EOSCogniton/STUF2019/SU - Suspension/05 - Essais/Excels essais Optimus/Temoins et tests triangles/Photos/54356044_1194590287362701_8250491047285620736_n.jpg

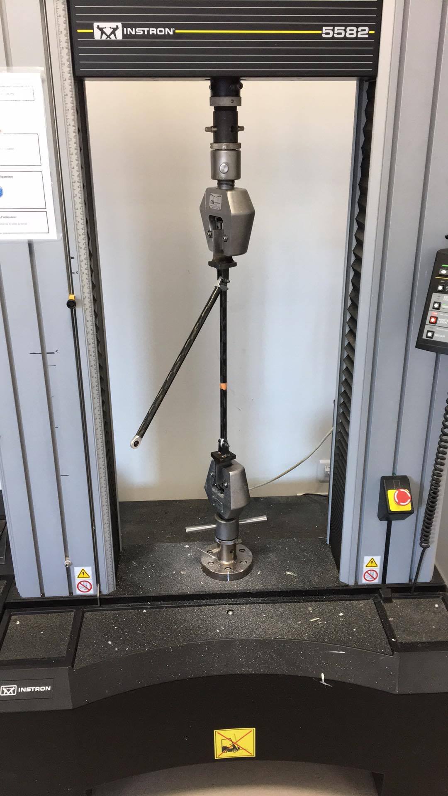
SU - Suspension/05 - Essais/Excels essais Optimus/Temoins et tests triangles/Photos/54356044_1194590287362701_8250491047285620736_n.jpg
