EOSCogniton/STUF2019/SU - Suspension/05 - Essais/Excels essais Optimus/Temoins et tests triangles/Photos/54388198_367390647322238_1608821511299268608_n.jpg

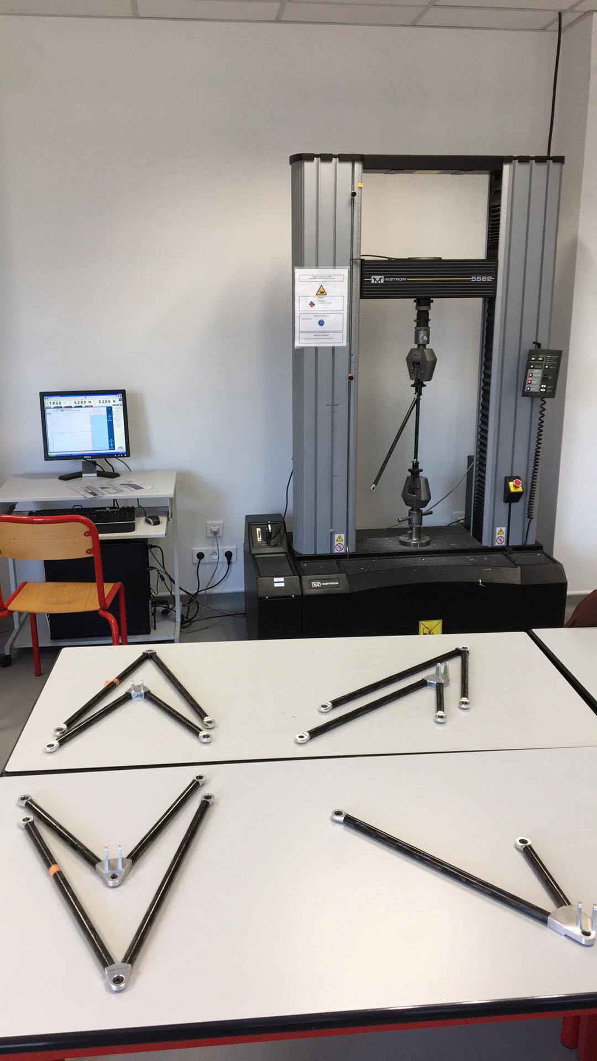
SU - Suspension/05 - Essais/Excels essais Optimus/Temoins et tests triangles/Photos/54388198_367390647322238_1608821511299268608_n.jpg
