EOSCogniton/STUF2019/WT - Wheels, Wheel Bearing & Tires/WT_A0300 (Rear Hub)/ZZ_doc/readMe.txt

	BEARING PRELOAD 
	- preload on the rear hub (x configuration)
	- does preload depens on the load ?

	SOURCES (skf.com)
	- https://www.skf.com/group/products/bearings-units-housings/super-precision-bearings/angular-contact-ball-bearings/bearing-preload/index.html
	- technical doc in this folder: bearing-preload_skf.pdf

	SOURCES (shaeffler.com)
	- on the bearing  specsheet there is a preload value in N --> how to calculate the preload in Nm ??
	- technical doc in this forlde: bearing-preload_fag.pdf (search for keyword: axial preload)
	-
