EOSCogniton/STUF2019/WT - Wheels, Wheel Bearing & Tires/WT_A0200 (Front Hub)/Bearings/readMe.txt

data du devis (tableau des chronos Optimus)
https://epsabox.kad-office.com/w/images/9/9f/19D49_DKS_Bearing.pdf

bearing model:  B71910-E-2RSDT-P4S

data retrieved from shaeffler website:
https://medias.schaeffler.com/medias/en!hp.ec.br.pr/B719..-E-2RSD*B71910-E-2RSD-T-P4S
