EOSCogniton/STUF2019/EL - Electrical/Autre/Carte avant/Arduino/Prgm Carte Avant/Arthur/Read Me.txt

A= Carte Avant

R= Recieve
T= Transmit
L= Led
G= Gear
B= Button
