EOSCogniton/STUF2019/DS_Design Report/Design_Meeting_2.pptx

## DESIGN EVENT

FSN & FS ATA

## Rules & Deadlines

- FSG Rules 2019
- FSN : May 31 2019 & FS ATA : June 6 2019
- White FS June 7 & 8 (Static Events → June 7)
- Design Spec Sheets (DSS)
- Design Report (DR) : 8 pages (5 text + 3 views)
- Design Supports (DS)

## Design Report (DR)

- Each Department write a short text
- Uniform, standards
- Choose one figure to illustrate

## Design Supports (DS)

- More time but we must be ready for the White FS (June 7)
- One Roll Up for each department
- Aerodynamic studies ?

## Frame

- Frame Evolution (RCS)
- Ergonomic studies (CMI)
- Frame Stiffness (from FEA/Simulation to testing) (RCS)

## Electrical

- Data acquisition (BAT)

## Suspension

- Tires studies (MSO/GTE)

## Engine & Powertrain

- Data acquisitions

## TIPS

- Always ask « Why ? »
- Engineer way means simulations and analysis
- Clean stand

## Thanks you
