EOSCogniton/STUF2019/FR - Frame & Body/FR_A0100 (Frame)/Règlement justification/Question Rule chassis.docx

Question Rule chassis

Chassis en général :

Hello,

I join you the side view of our chassis this year. We filled up last year's SES (this year's isn't available yet) and didn't see any problem. However, could you tell us if there is anything shocking concerning the observance of the rules ?

Thank you for your answer

CLAMENS Robin
EPSA

SES :

Hello,

I have a question concerning the SES (SES2018 version because SES2019 is'nt available yet), especially the Anti-intrusion plate section.
We plan on using a 1.5mm solid steel plate. However, in the SES, what do those lines refer to ?

-Thickness of core (mm)
-Thickness of innerskin (mm)
-Thickness of outer skin (mm)

Thanks for your answer

CLAMENS Robin
EPSA
