EOSCogniton/STUF2019/FR - Frame & Body/FR_A0100 (Frame)/Design report/Design Support/Design_Support_Chassis (1).docx

Design Support documents

Frame

Objectives

The objective of this document is to illustrate the different tools and approaches we used in order to design the frame of OPTIMUS. Our goal was to enhance the position of the driver, as well as the dynamic behavior. All of this while reducing the weight and reduce over-dimensioning, persisting in this department.

Conception steps

To begin with, we set objectives, summated constraints imposed by the rules and located improvements opportunities, in order to structure and define our work. Then, a preconception phase instituted the basics of the development that was brought in detailed conception. This consisted of an iterative process between CAD and simulations and interface management with other systems.

Assumptions

We realised simulations under the following assumptions.

- Elastic behaviour
- Small displacement
- No dynamic phenomenon
- Welding beams infinitely stiff
- Beam model

Important values

| Target | Simulation | Measure
Stiffness (Nm/deg) | 1100-1300 | 1212 | 1169
Weight (with paint and equipment) (kg) | 35-38 | 36 | 37

- Steel: 25CrMo4 (AISI4130)
- Yield strength: 789 MPa

Loads table

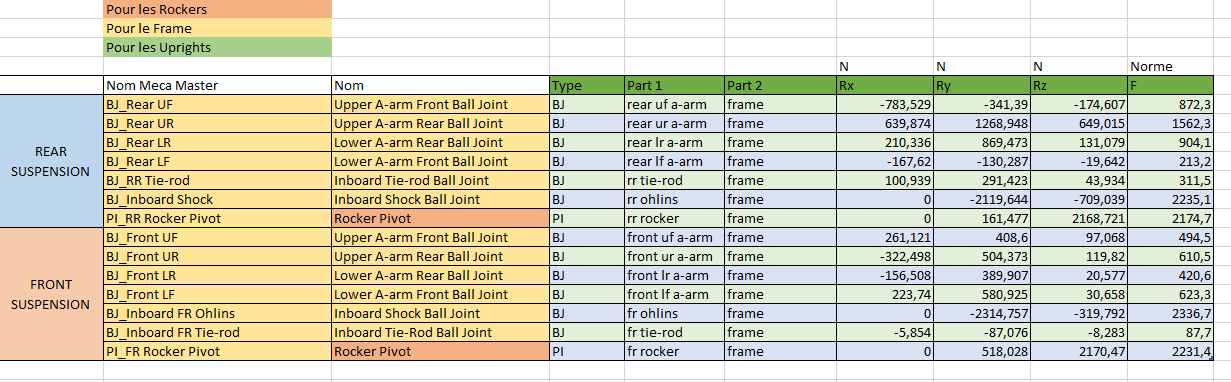
[picture p17: figure]

Example of load table for Bumping 3G

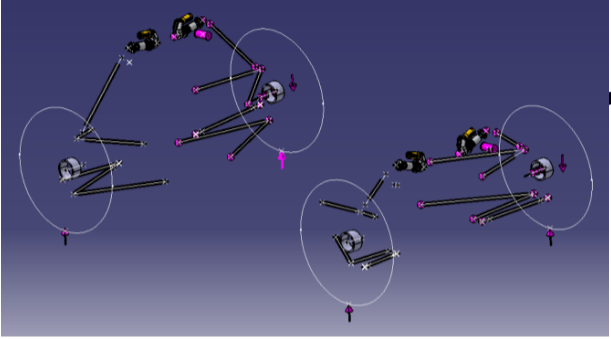
[picture p18: figure]

Mecamaster model of OPTIMUS

Simulation tests results

NB: Except for torsion, all load cases come from MécaMaster

Figure 1: Torsion

Figure 2a: Acceleration 0.77g

Figure 2b: Acceleration 0.77g

Figure 3a: Braking 2g

Figure 3b: Braking 2g

Figure 4a: Bump 3g

Figure 4b: Bump 3g

Figure 5a: Left turn 2g

Figure 5b: Left turn 2g

Figure 6a: Left turn 1g + braking 1g

Figure 6b: Left turn 1g + braking 1g

The following table summarizes the main results of the different simulations

Simulation type | Maximum stress | Location | Maximum displacement
Torsion
Acceleration 0.77g
Braking 2g
Bump 3g
Left turn 2g
Left turn 1g + braking 1g

Stiffness measure experiment

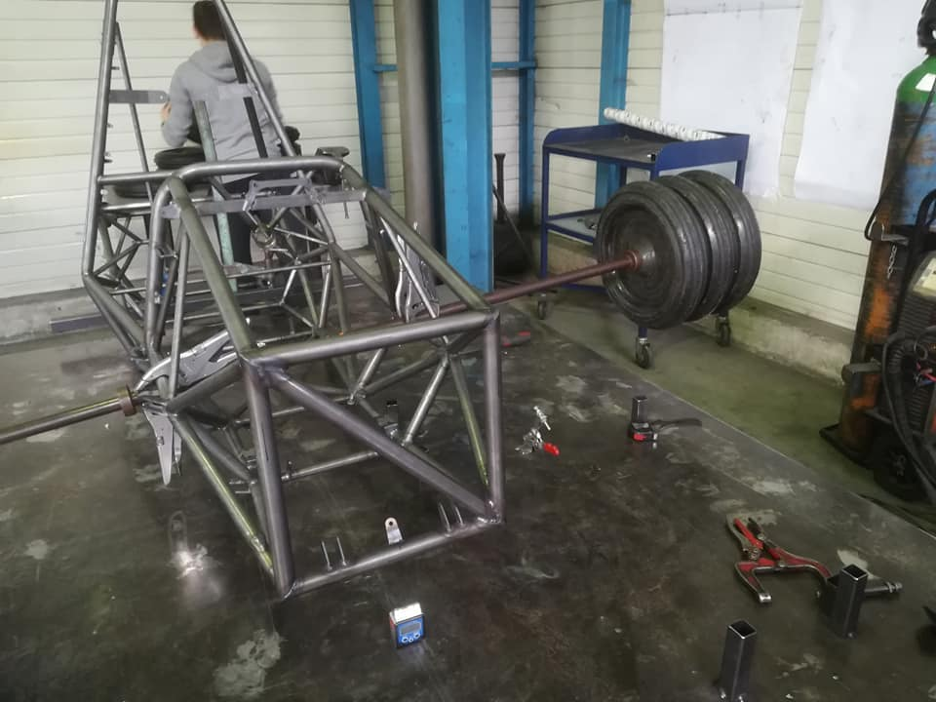
[picture p19: figure]
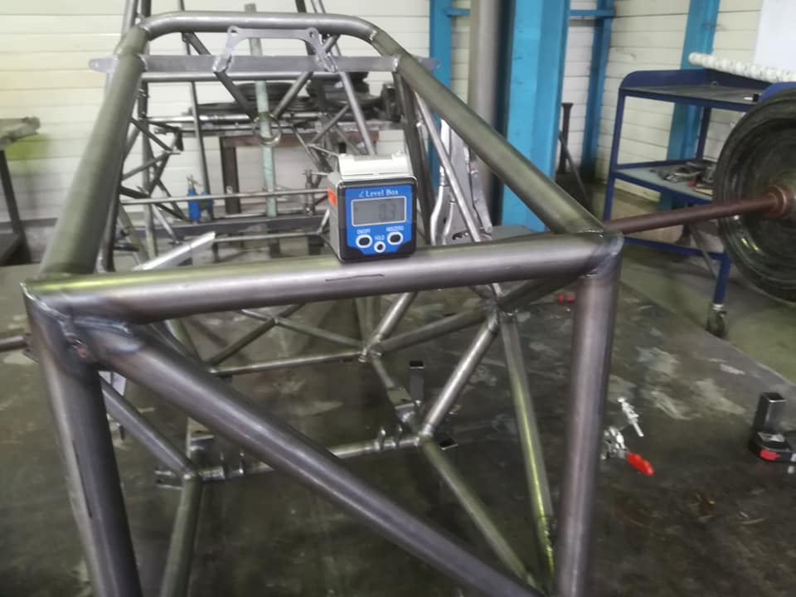
[picture p20: figure]

Figure 7: Stiffness measurement on the frame

Measure performed in two times (distance to longitudinal axis approx. 1m):

- Apply a torque to the front and the cockpit of the frame, blocking the back
- Apply a torque at the back, blocking the front

Stiffness measurements results:

Weights used: 65kg

Angles of torsion measured: 0.7 degrees

Results: 1191Nm/deg

1147Nm/deg

Hence our torsional stiffness of 1169Nm/deg

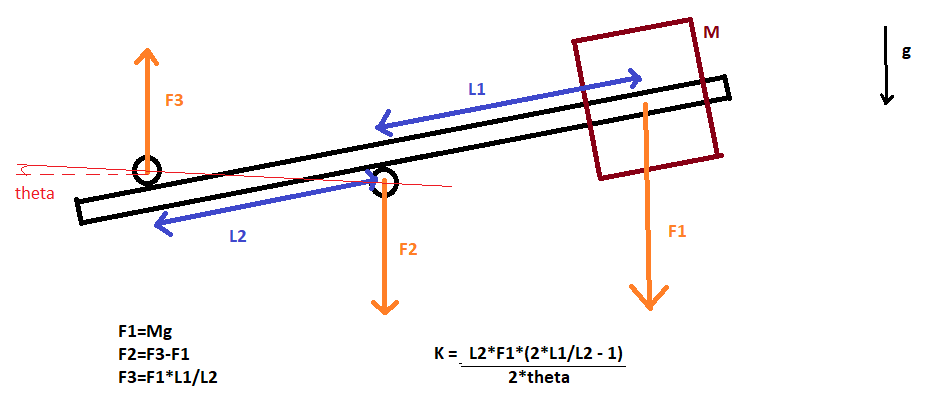
[picture p21: figure]

Stiffness calculations explanation

Equipment positioning

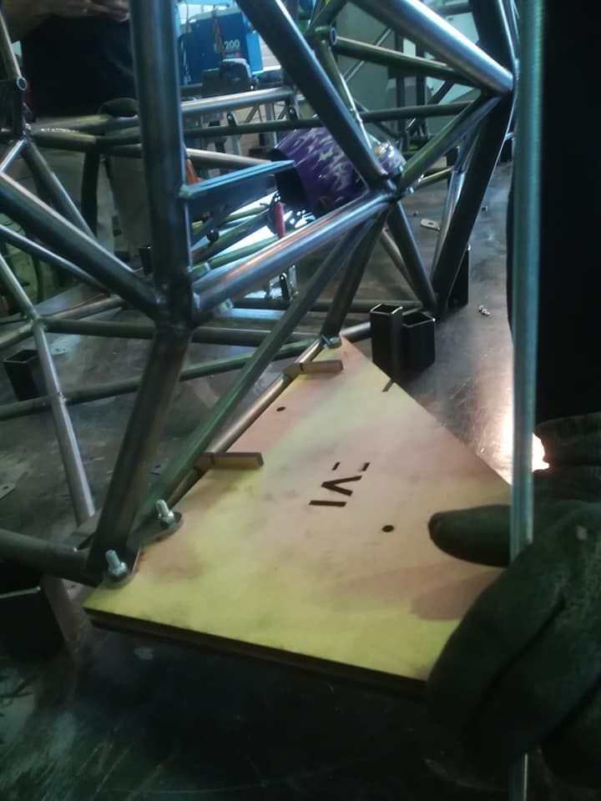
[picture p22: figure]
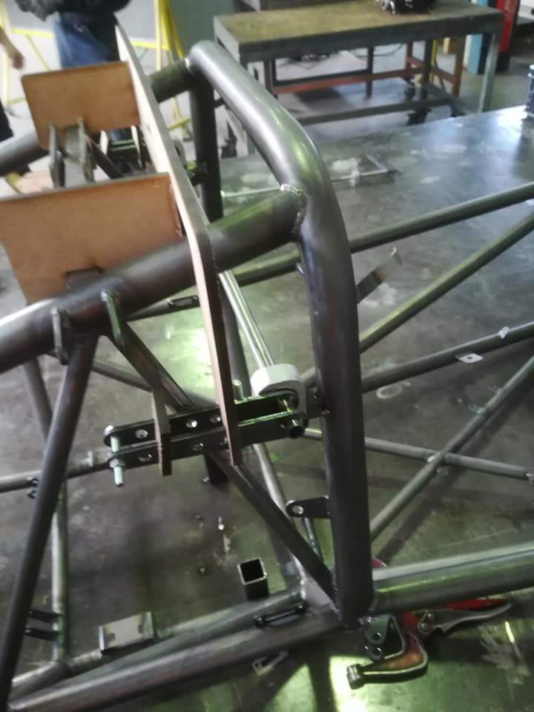
[picture p23: figure]
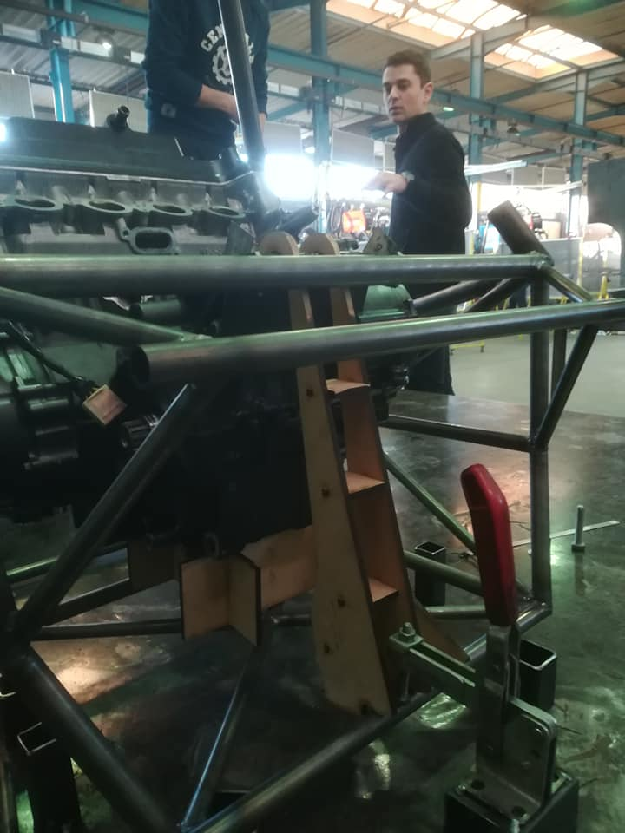
[picture p24: figure]
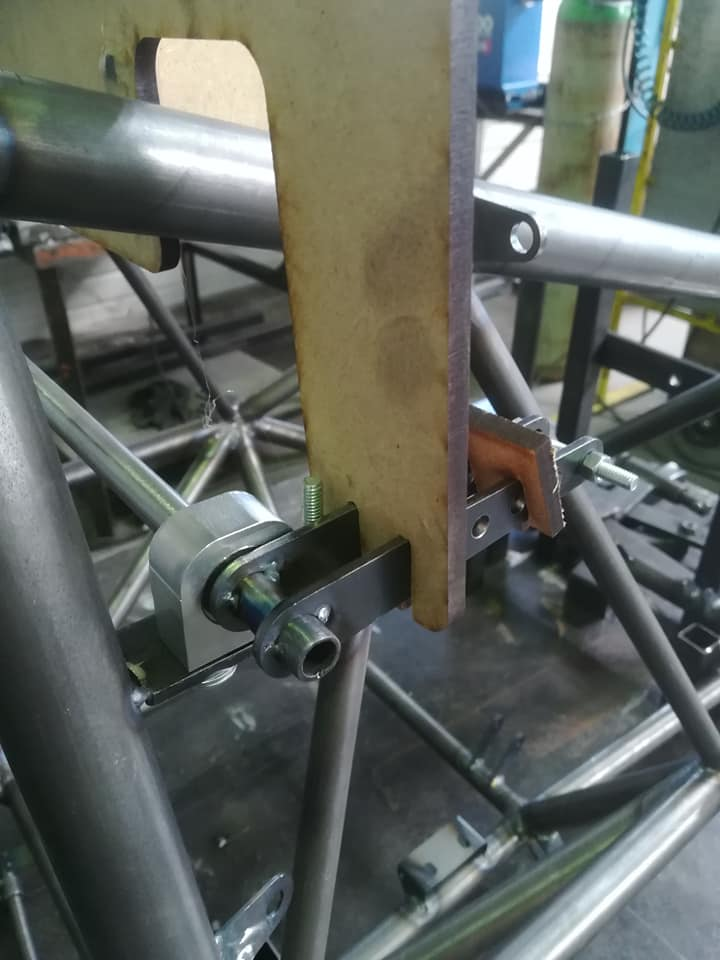
[picture p25: figure]

Figure 8: Use of templates to precisely position equipments during welding

Driver positioning

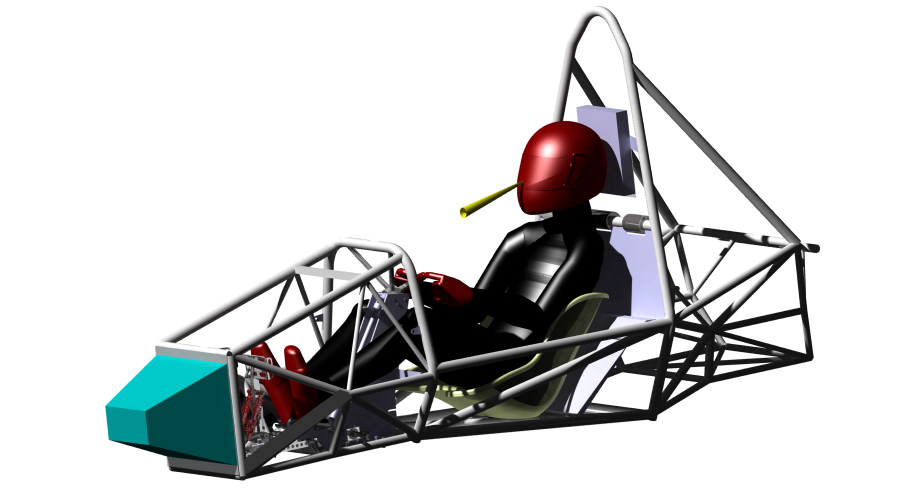
[picture p26: figure]

Figure 10: Human model in CAD model to help designing the chassis

Tensile strength test results

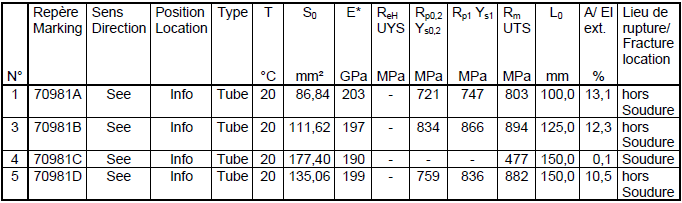
[picture p27: figure]

Mechanical data in welded and non-welded condition

Appendix

Stiffness model (coefficient α)

Frame: three series torsion springs

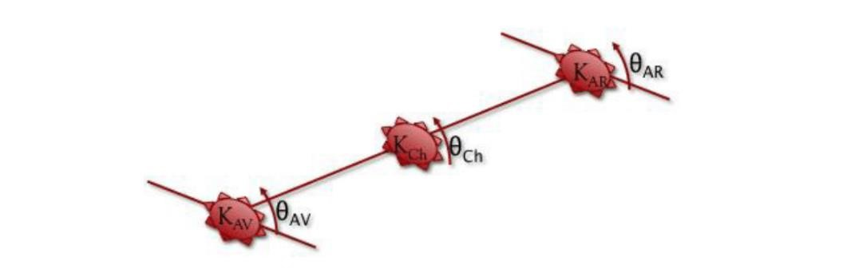
[picture p28: figure]

Figure 9: Definition of the model

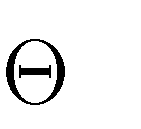
[picture p29: figure]

Where K=stiffness and θ =angle. We also define KT and θT respectively the stiffness and the angle of the car.

In order to simplify the equations, we suppose KAV = KAR; α. KAV = KCh and θAV = θAR. It gives us the following equations:

Finally,

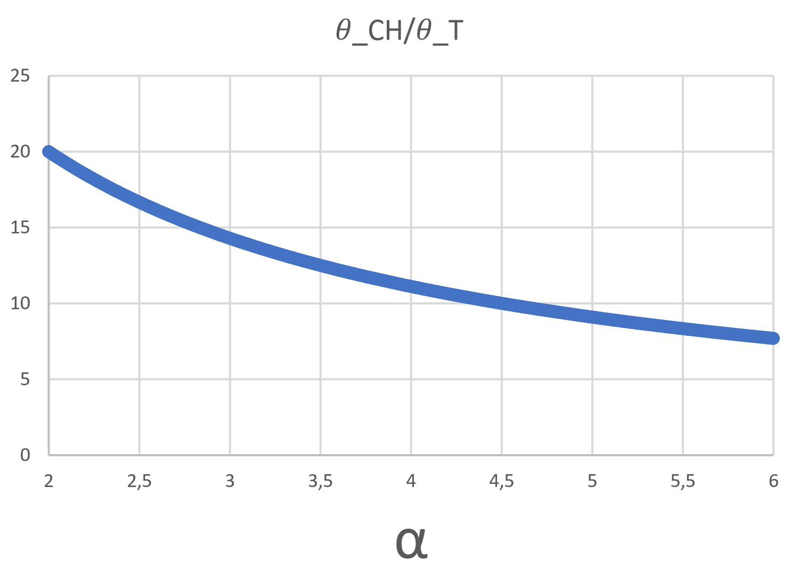
[picture p30: figure]

Coefficient of relative stiffness regarding suspension

If we want to keep θCH/θT between 10% and 15%, we have to take α between 3 and 5.

Fast prototyping

Driver positioning, check for incoherencies in positioning

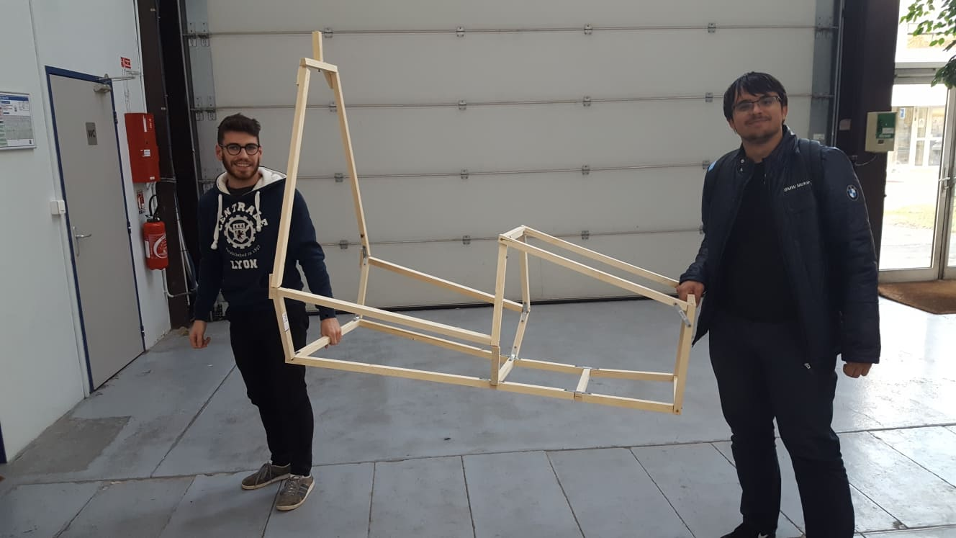
[picture p31: figure]
