EOSCogniton/STUF2019/DS_Design Report/03_Ressources/2015_Design_Dynamix/Document à afficher/Frame_Body_Ergo/ErgonomicStudy.docx

# Ergonomic Study

# Measurements for the cockpit design

Heel length | Steering wheel length | Steering wheel height | Seat-back inclination
940mm | 600mm | 493mm | 52°
