EOSCogniton/STUF2019/DS_Design Report/03_Ressources/2015_Design_Dynamix/Document à afficher/Frame_Body_Ergo/FrameEvolution.docx

# CHASSIS EVOLUTION

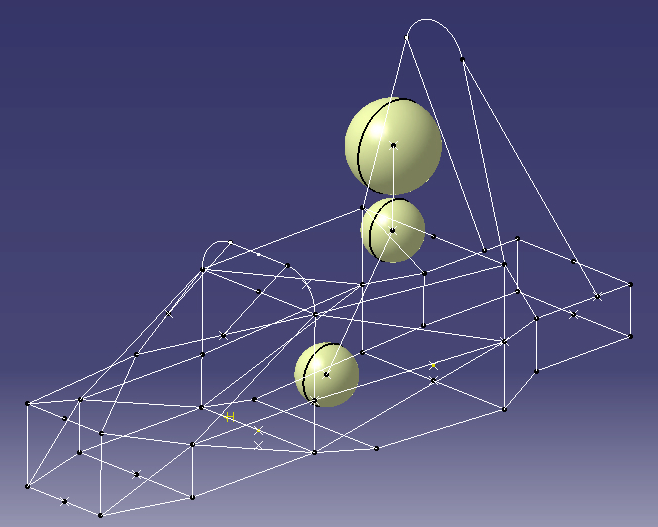
[picture p33: figure]
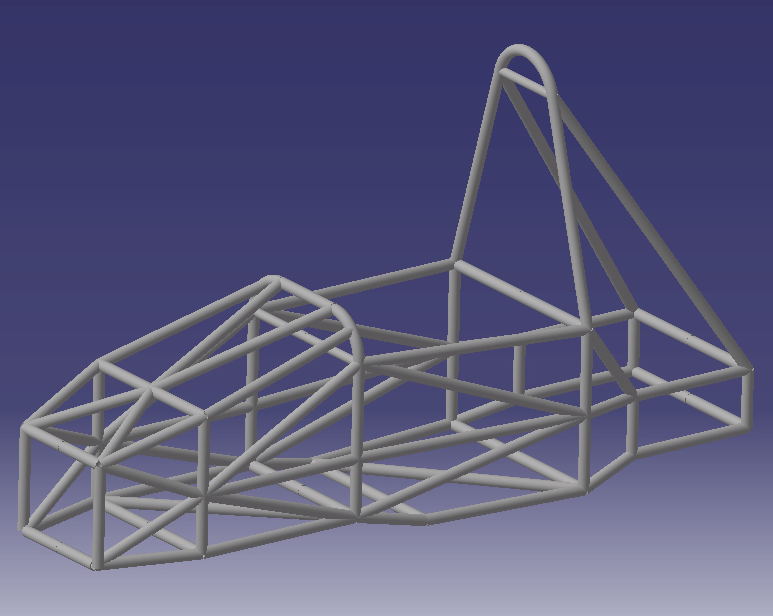
[picture p34: figure]

First wireframe design | First 3D Volume design

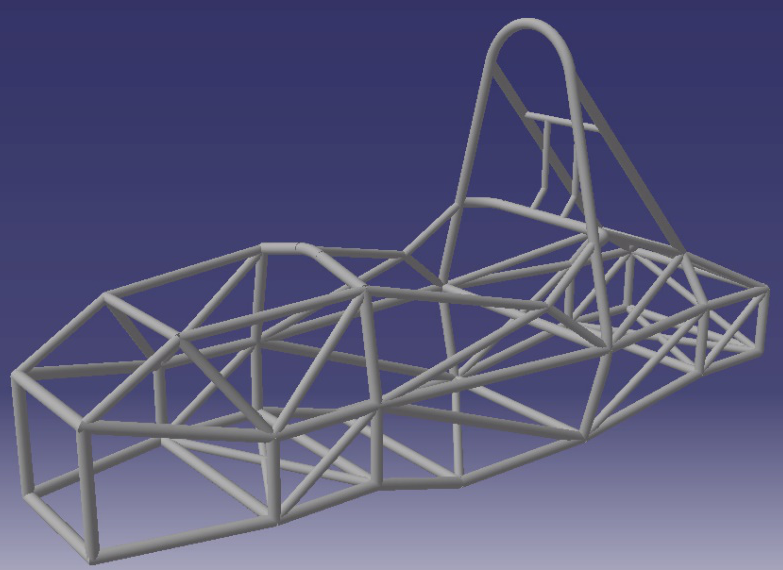
[picture p35: figure]
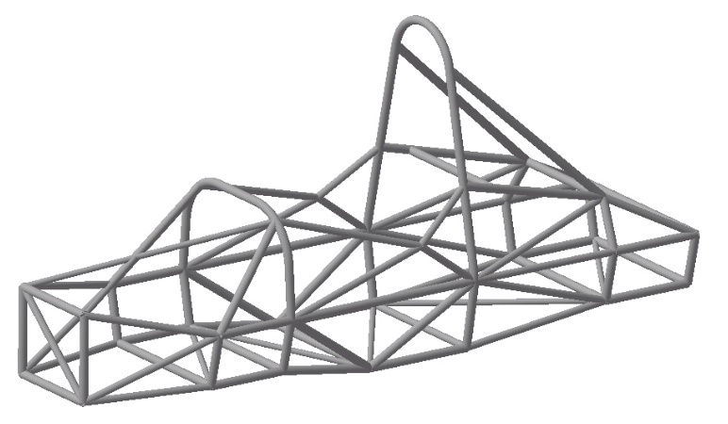
[picture p36: figure]

Intermediate design | Before FEA

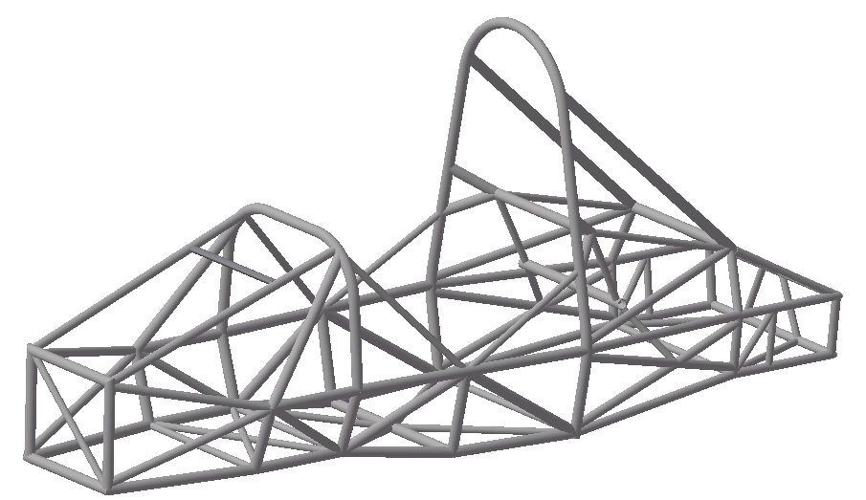
[picture p37: figure]
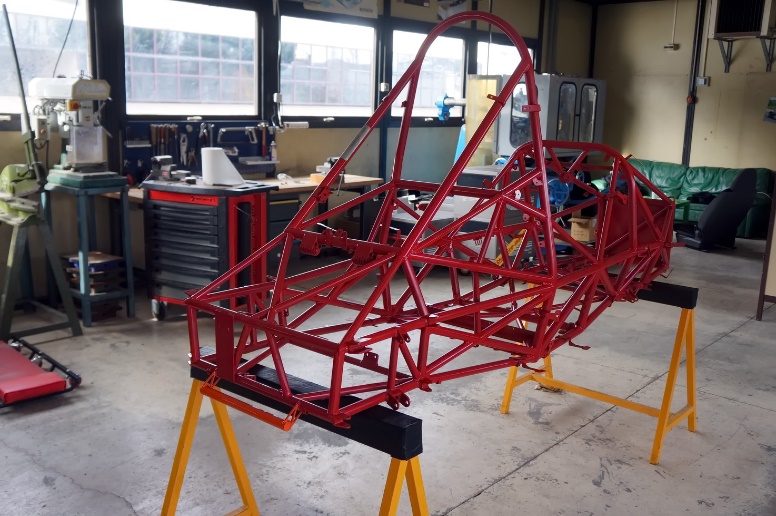
[picture p38: figure]

Final design | Real chassis
