EOSCogniton/STUF2019/DS_Design Report/03_Ressources/2015_Design_Dynamix/Document à afficher/Frame_Body_Ergo/Stiffness.docx

# Stiffness testing

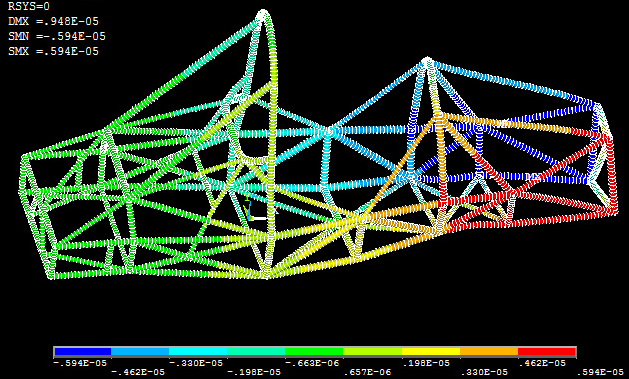
[picture p39: figure]

| FEA 1623 N.m/deg

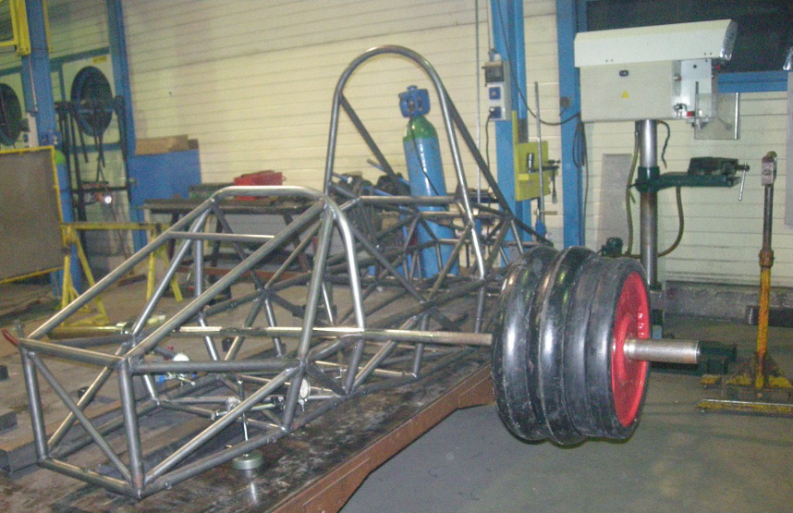
[picture p40: figure]

| Physical Testing 1059N.m/deg

# Measuring protocol

- Chassis fixed at the rear bottom tubes with clamps.
- Front cell rotation about Y-axis allowed.
- 90kg of sport weights at the end of an Olympic bar inserted through the chassis at the suspension attachment point.
- Distortion measured with a needle tip dial indicator at the bottom tubes.
