EOSCogniton/STUF2019/EL - Electrical/Autre/CAN Network/Analog to CAN.pptx

CAN Module
V1.1
13/01/2019
ARZ

5V

10K

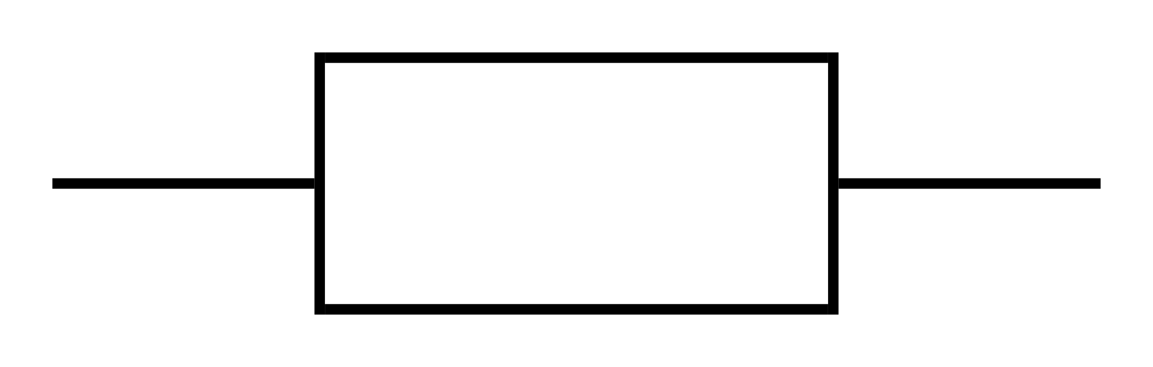
[picture p43: figure]

1 18
2 17
3 16
4 15
5 MCP2515 14
6 13
7 12
8 11
9 10

CS
MISO
MOSI
SCK

27pF

27pF

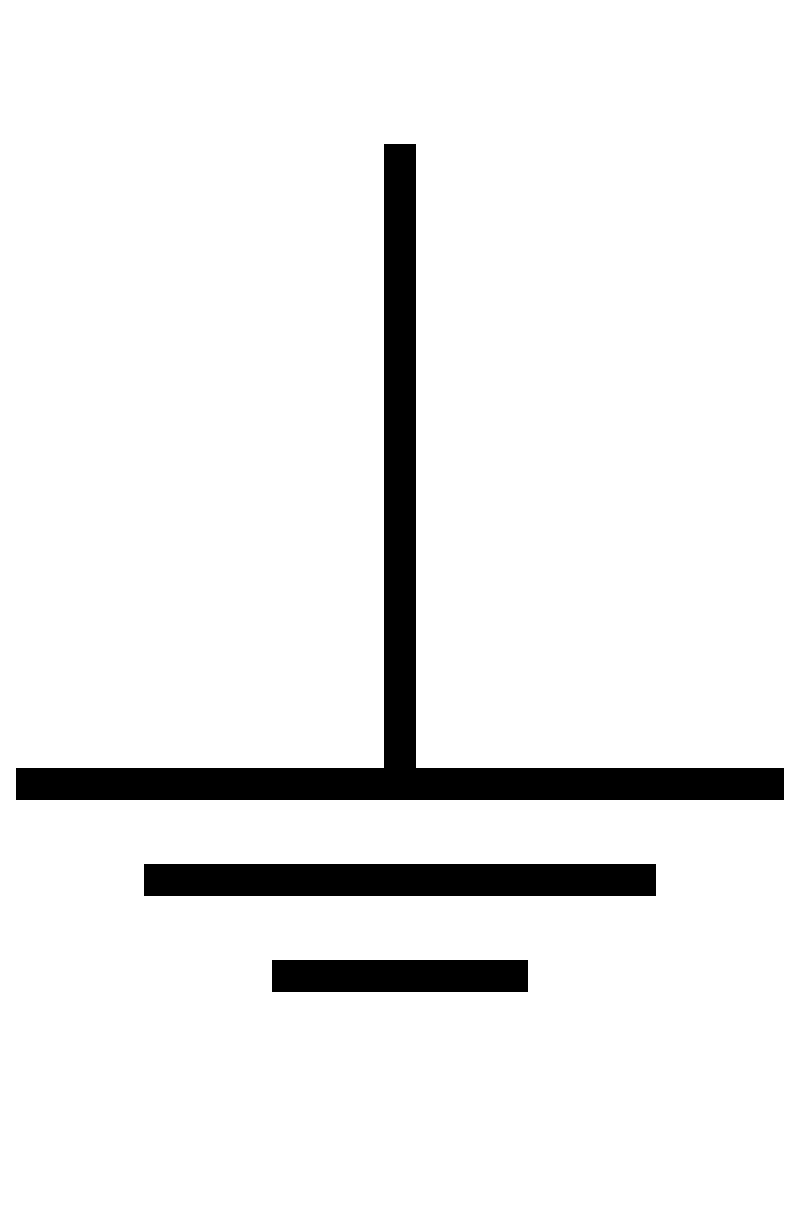
[picture p44: figure]
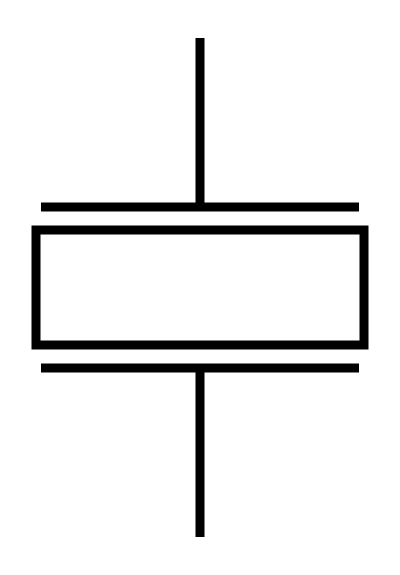
[picture p45: figure]

8MHz

1 8
2 7
3 MCP2551 6
4 5

10K

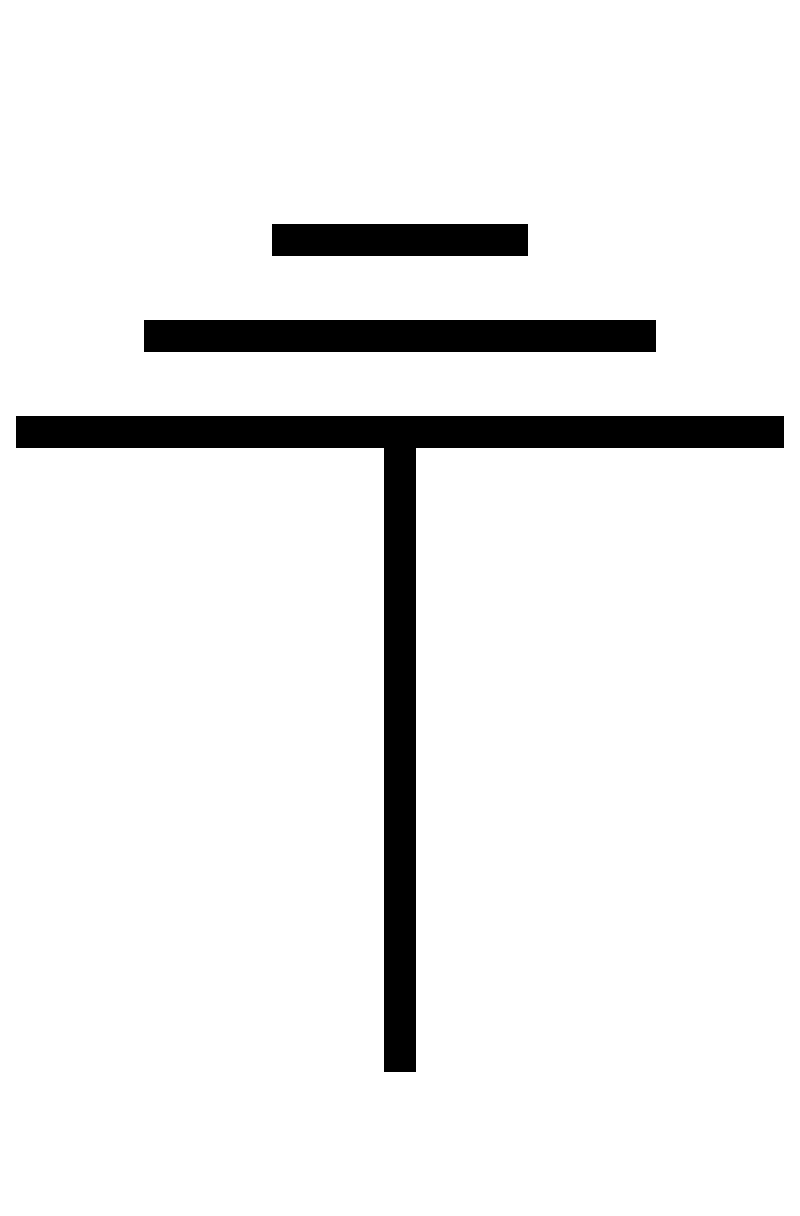
[picture p46: figure]

CAN High
CAN Low

5V

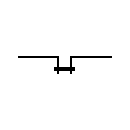
[picture p47: figure]

Jumper de terminaison du CAN

120K

Vers Arduino Nano

## Slide 2

Arduino Nano Module
V1.0
ARZ
