EOSCogniton/STUF2019/FR - Frame & Body/FR_A0500 (Clutch activation system)/Gabarits/Tuto gabarit.pptx

## But final (oui ca se croise…)

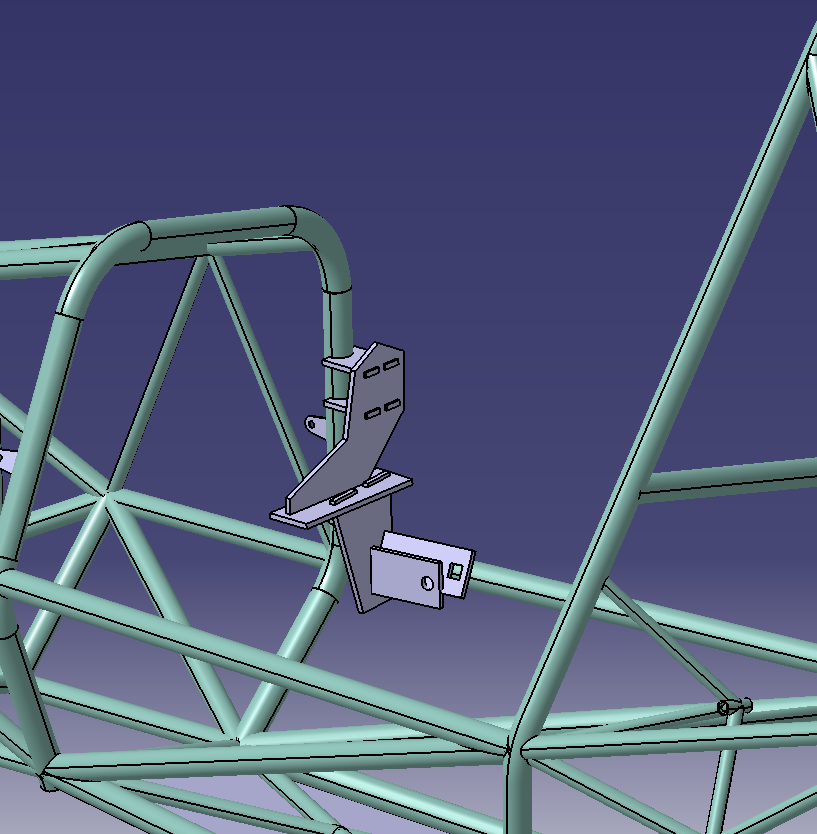
[picture p48: figure]

## Etape 1

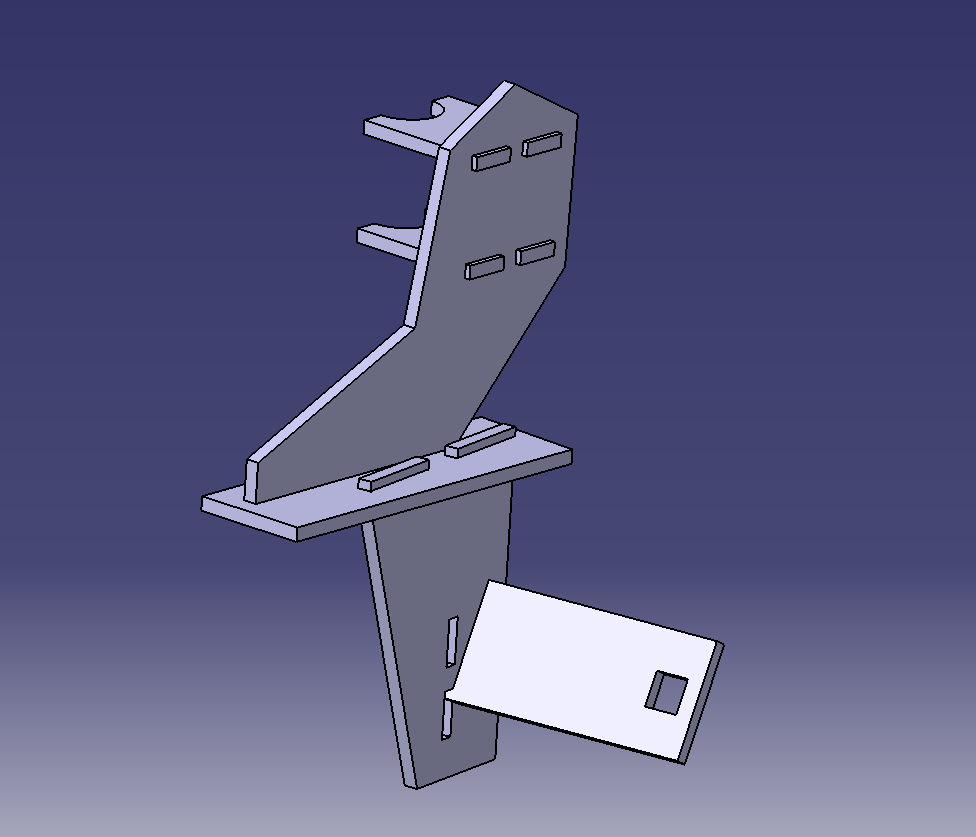
[picture p49: figure]

- En premier, il faudra souder la chape carré. Il faut donc s’assurer que le bon gabarit est placé (et au bon endroit)

## Etape 2

- Plaquer les deux zigouigouis sur le tube droit du front hoop

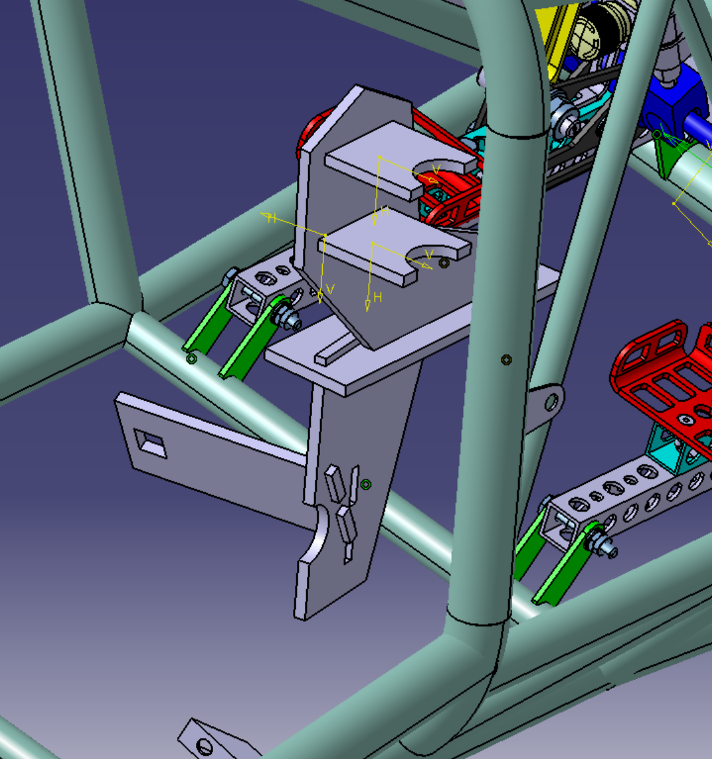
[picture p50: figure]

## Etape 3

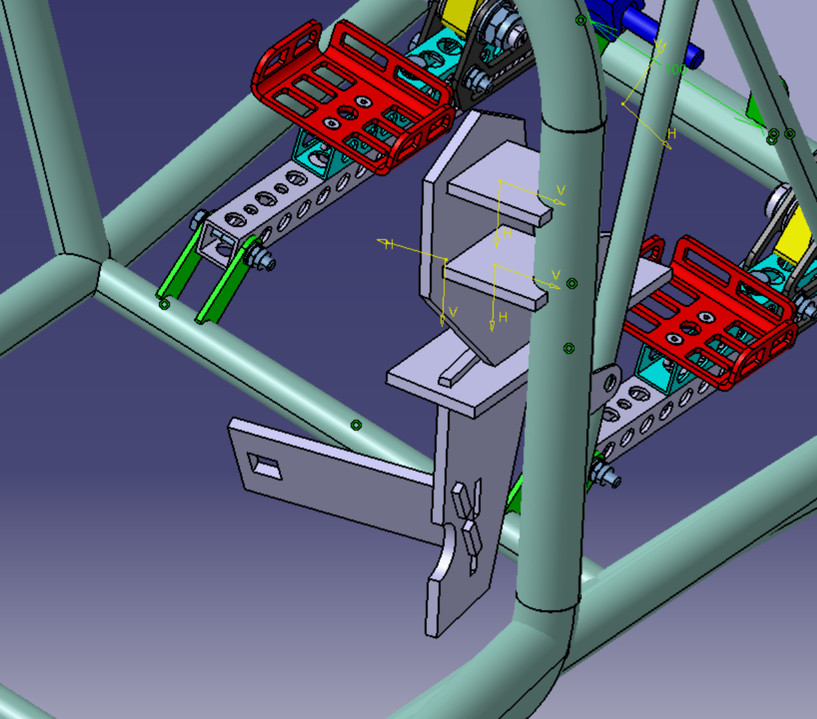
[picture p51: figure]

- Plaquer le zigouigoui du bas contre le tube du côté droit

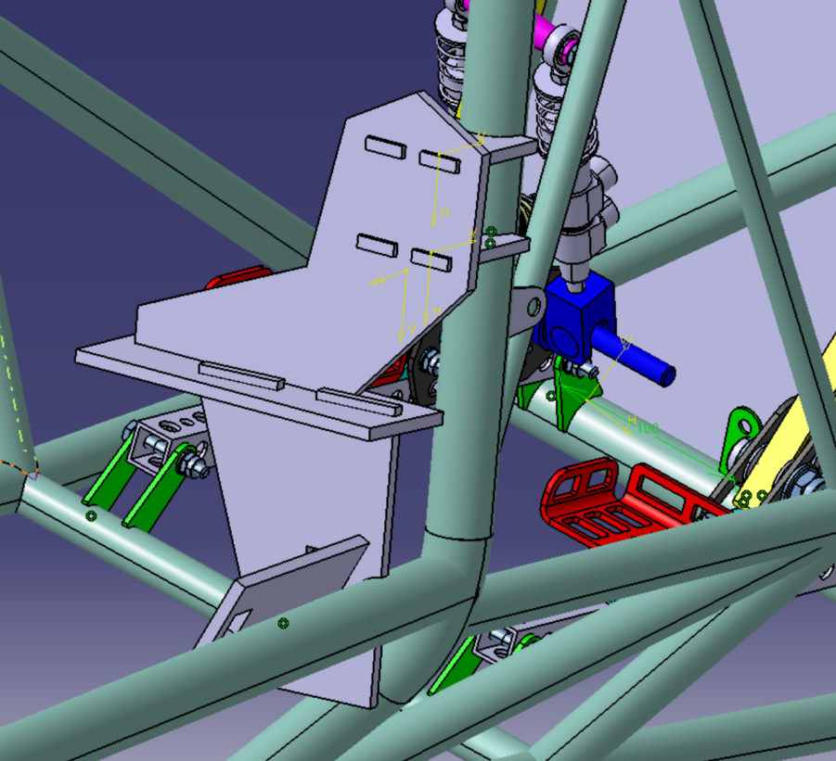
[picture p52: figure]

## Etape 4

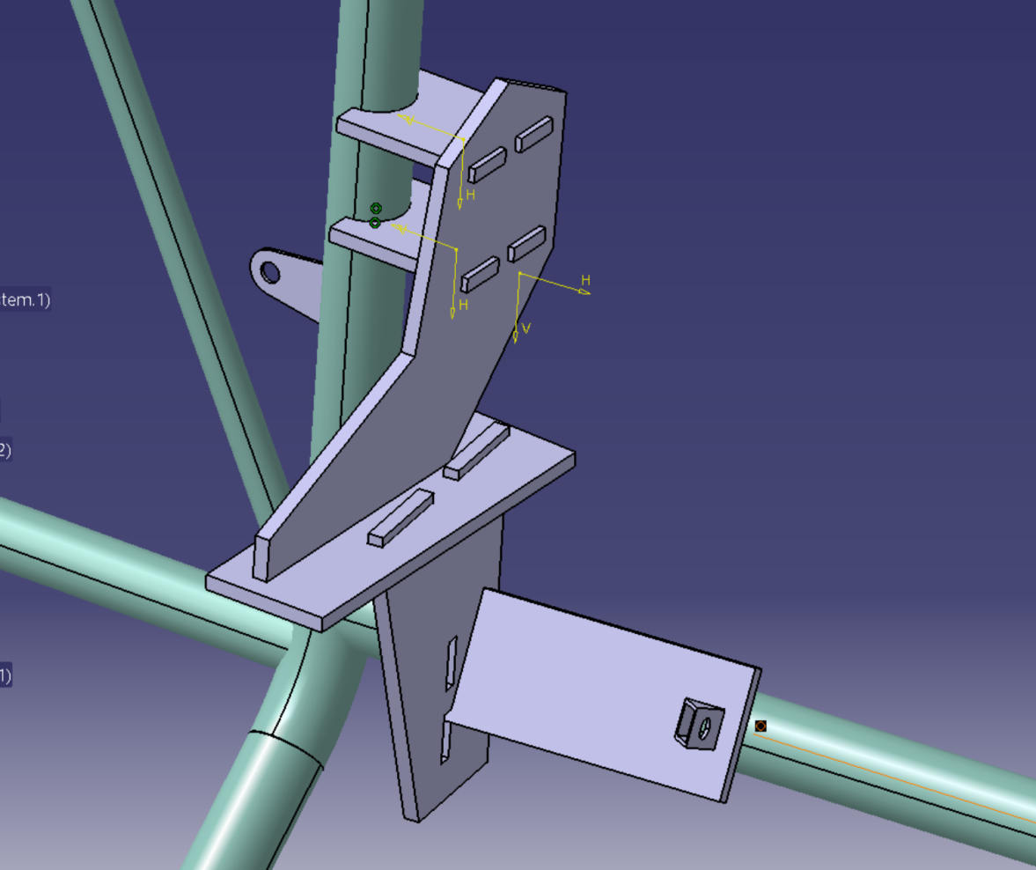
[picture p53: figure]

- Placer la chape carrée dans le trou en la plaquant bien sur le tube, et souder…

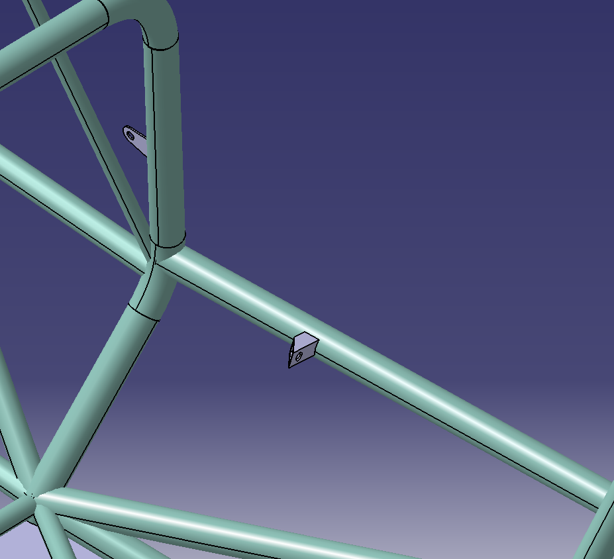
[picture p54: figure]

## Etape 5

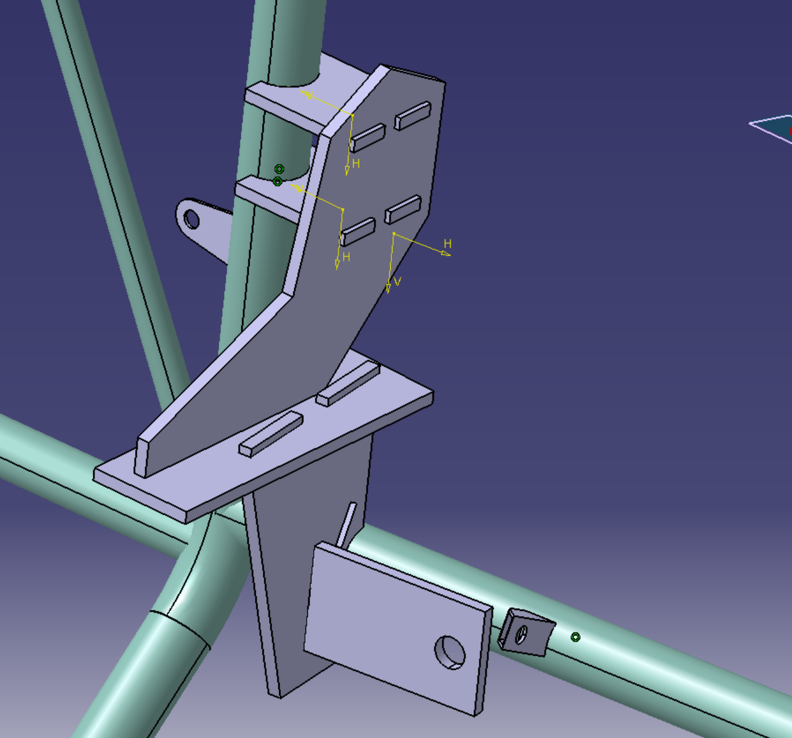
[picture p55: figure]

- Il faut maintenant changer l’embout du gabarit pour mettre celui adapté à la chape ronde, au bon endroit (c’est-à-dire l’autre endroit). Replacer le gabarit, de la même manière que pour l’embout précédent.

## Etape 6

- Placer la chape Ronde dans le trou en la plaquant bien sur le tube, et souder…

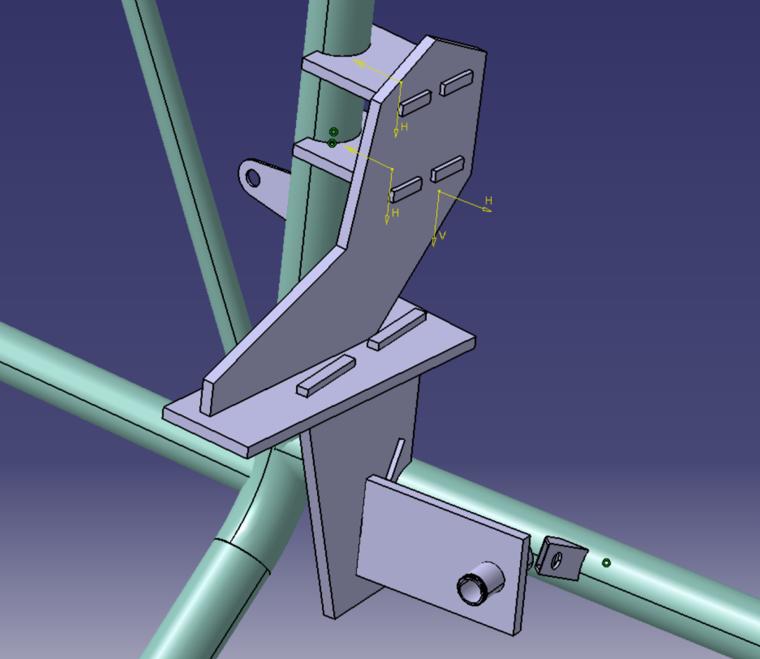
[picture p56: figure]

## Slide 8

FIN
