EOSCogniton/STUF2019/EL - Electrical/Autre/Carte avant/CANDIY shield/Uno et Shield.docx

Arduino Uno 65139 ATMega328 : https://www.conrad.fr/ce/fr/product/191789/Carte-Arduino-UNO-65139-ATMega328?queryFromSuggest=true

Clock Speed 16MHz

Conrad : 32,21€

Arduino Uno Rev 3 : https://fr.rs-online.com/web/p/kits-de-developpement-pour-processeurs-et-microcontroleurs/7154081/

Clock Speed 16MHz

RS Component : 21,63€

Arduino CAN-BUS Shield V2 : https://fr.rs-online.com/web/p/kits-de-developpement-pour-interfaces/1743227/

RS Component : 24,69€
