EOSCogniton/STUF2019/EL - Electrical/Autre/Tableau de bord/Tableau Optimus/listes_commande_v1.docx

# Liste des Composants du Tableau de Bord

Non inclus : les afficheurs 7 segments, les vis, les écrous, les cartes électroniques ainsi que leurs composants

Note : la liste contient le stricte nécessaire, sans prendre en compte les stocks de l’EPSA.

Nom | Nbr | Constructeur | Référence constructeur | Prix TTC (unité) | Marchant | Référence marchant
Ruban RGB neopixel | 1 | ADAFRUIT INDUSTRIES | 1506 | 60€
Interrupteur bistables standard | 4 | Arcolectric | C1700HOAAG | 4.27€ | rs-components | 350-204
Bouton tri stable off-on-on option 1 | 1 | Carling Technologies | 2GG51-73 | 5.64€ | Mouser electronics | 691-2GG5173
Bouton poussoir simple | 1 | TE Connectivity | AV1910000Q04 | 12.90€ | rs-components | 123-6063
Bouton poussoir avec LED bleu | 2 | TE Connectivity | AV1910E712Q04 | 11.69€ | rs-components | 123-6110
Bouton poussoir avec LED rouge | 1 | TE Connectivity | AV1910E312Q04 | 14.05€ | rs-components | 123-6108
Bouton d’arrêt d’urgence | 1 | Apem | A01ES-DM | 9.99€ | mouser | 642-A01ES-DM
Elément de contact APEM A0150B-D | 1 | Apem | A0150B-D | 6.97€ | mouser | 642-A0150B-D
Total | | | | 150.01€
