EOSCogniton/STUF2019/EL - Electrical/Autre/Tableau de bord/Tableau vulcanix/première esquisse dashboard.odt

# Première esquisse du tableau de bord

Problème de sous-pression d’huile

Arrêt

d’urgence

Wet

Dry

On

Off

Traction control

On

Off

Log switch

On

Off

Ventilateur

95 < T

85 < T < 95

T < 85

Température d’eau

Démarrage

Off

On

Contact

X1000 RPM

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
Neutre 1 2 3 4 5

Neutre

Launch control

RaZ motoréducteur

# Légende

: interrupteur bistable : LED bicolore vert si rapport engagé clignote rouge si le rapport doit être passé : bouton poussoir entouré du voyant de contact

; : Bouton poussoir

# Notes

-La LED bleu au-dessus du switch ventilo est allumé lorsque le switch est sur On.

-La LED qui signale un problème d’huile et la LED rouge de température d’eau clignotent.

-Le nombre de LED du compte tour est à vérifier par rapport au nombre de PIN restant sur la carte de commande

-Les boutons sur le volant peuvent aussi se placer juste à côté selon leur importance qui est encore à définir

-Pour utiliser le système de LED bicolore il va falloir relier l’info du shift light à la carte de commande

-Cette esquisse n’est pas à l’échelle, il va falloir vérifier que tous les composant rentre bien

-La forme du support n’est pas définit

## Après revue

-D’après SCU et laurent on à pas besoin des boutons sur le volant

-le volant sera bien plus haut et prendra plus de place

-On monte bien plus haut que 10 000 RPM

### Vue du pilote

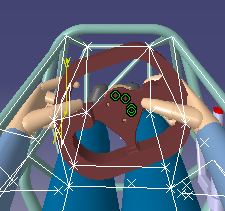
[picture p76: figure]
