EOSCogniton/STUF2019/DS_Design Report/03_Ressources/2015_Design_Dynamix/Design_Support_V2/Ergonomic_study.pdf

# ERGONOMIC STUDY

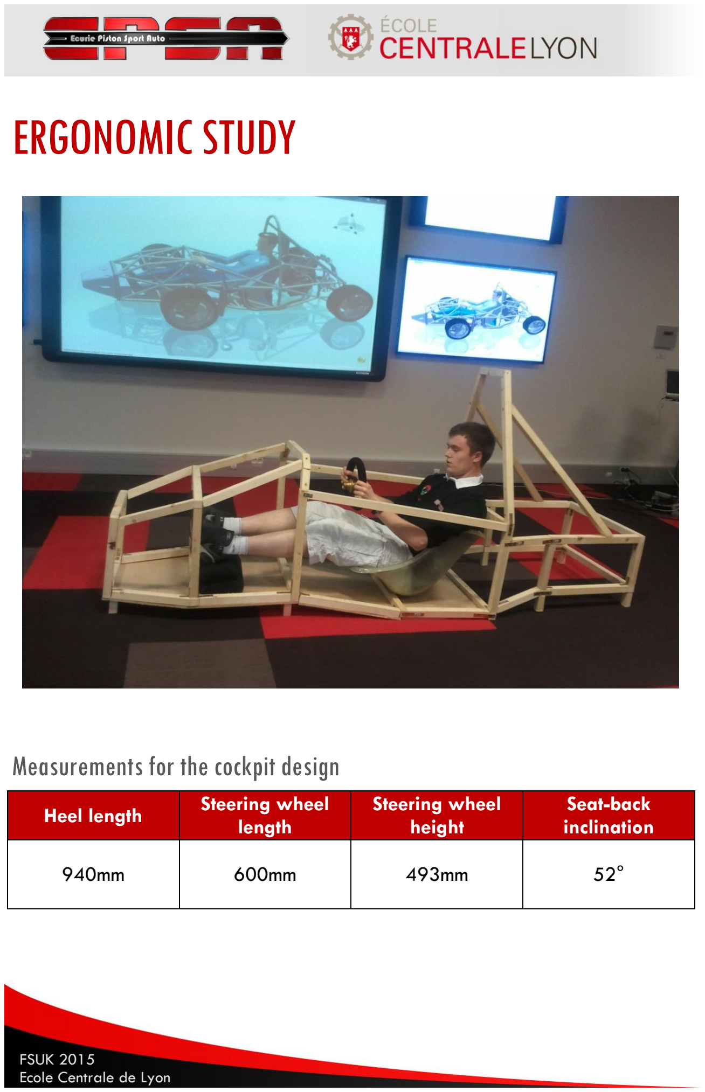
[picture p86: page 1]

FSUK 2015
Ecole Centrale de Lyon

## Measurements for the cockpit design

Heel length | Steering wheel length | Steering wheel height | Seat-back inclination
940mm | 600mm | 493mm | 52°
