EOSCogniton/STUF2019/DS_Design Report/03_Ressources/2015_Design_Dynamix/Design_Support_V2/Frame_design.pdf

# FRAME DESIGN

## Construction choice

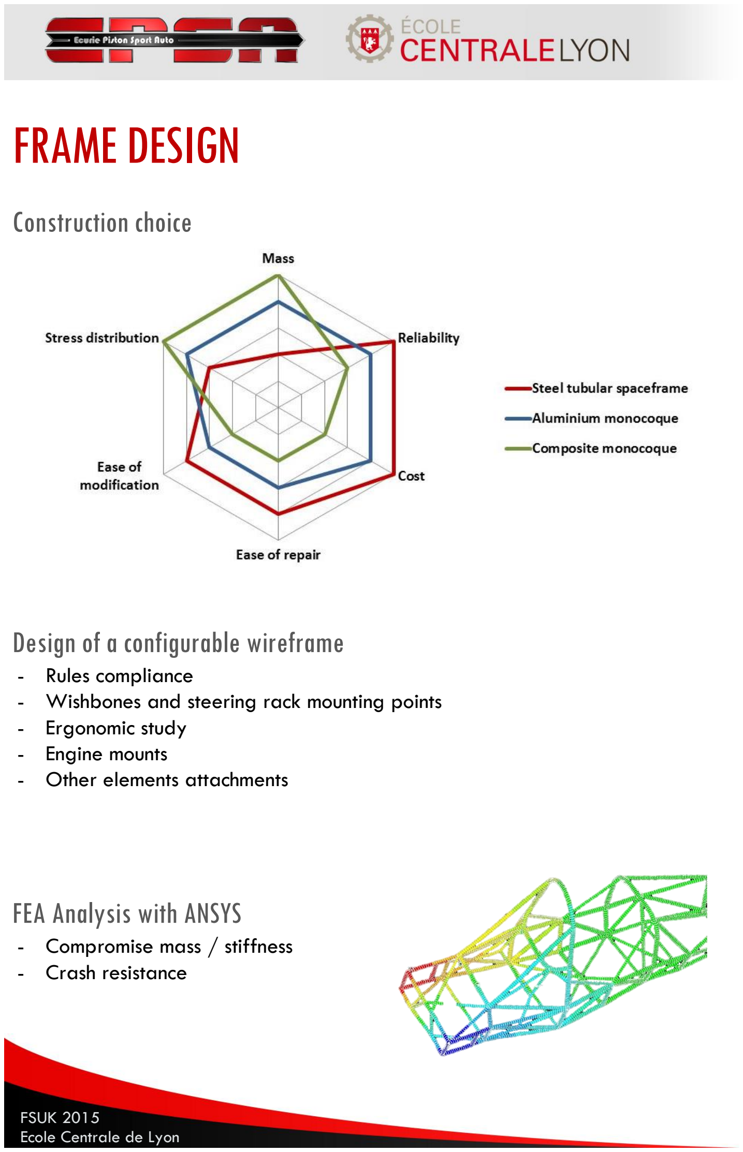
[picture p87: page 1]

FSUK 2015
Ecole Centrale de Lyon

## Design of a configurable wireframe

- Rules compliance
- Wishbones and steering rack mounting points
- Ergonomic study
- Engine mounts
- Other elements attachments

## FEA Analysis with ANSYS

- Compromise mass / stiffness
- Crash resistance
