EOSCogniton/STUF2019/DS_Design Report/03_Ressources/2015_Design_Dynamix/Design_Support_V2/Frame_evolution.pdf

# CHASSIS EVOLUTION

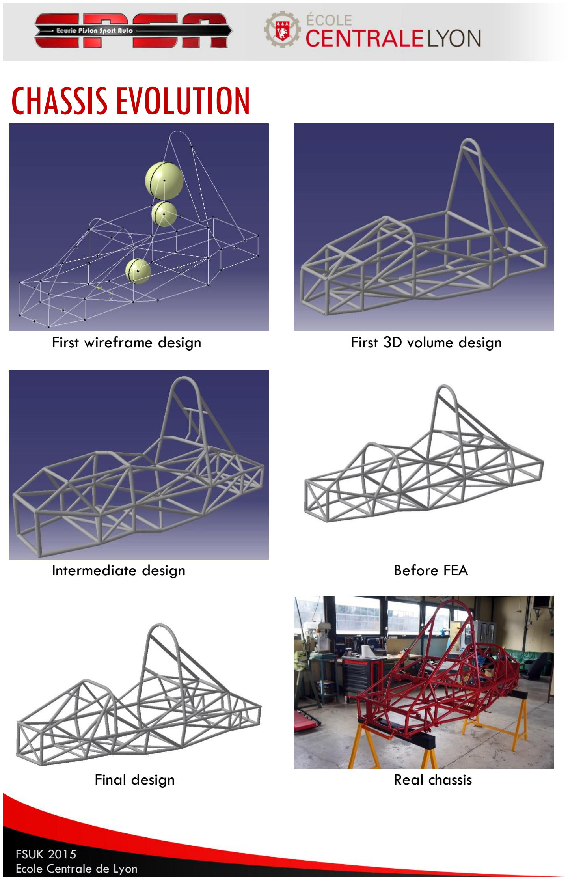
[picture p88: page 1]

FSUK 2015
Ecole Centrale de Lyon
First wireframe design | First 3D volume design
Intermediate design | Before FEA
Final design | Real chassis
