EOSCogniton/STUF2019/DS_Design Report/comparaisons_a-arms.xlsx

Sheet: Bilan
Solutions | Acier | Alu | Alu-carbone
Couts | 600.00 € | 2010.00 € | 3350.00 €
Masse | 5974.515942 | 3069.137601 | 1837.898156
Ratio euros /g % acier |  | 0.49 € | 0.66 €
Ratio euros /g % alu |  |  | 1.09 €

Sheet: Masse
Solution acier |  |  |  | Solution alu |  |  |  | Solution alu-carbone
 | masse (g) | nombre | masse total (g) |  | masse (g) | nombre | masse total (g) | Estimation | masse (g) | nombre | masse total (g)
Inserts chassis | 31 | 16 | 496 | Inserts chassis | 25 | 16 | 400 | Inserts chassis | 18 | 16 | 288
Inserts biellettes | 18 | 16 | 288 | Inserts biellettes | 10 | 16 | 160 | Inserts biellettes | 11 | 16 | 176
Insert PM avant sup | 330 | 2 | 660 | Insert PM avant sup | 60 | 2 | 120 | Insert PM avant sup | 60 | 2 | 120
Insert PM arrière sup | 410 | 2 | 820 | Insert PM arrière sup | 90 | 2 | 180 | Insert PM arrière sup | 90 | 2 | 180
Insert PM avant inf | 170 | 2 | 340 | Insert PM avant inf | 30 | 2 | 60 | Insert PM avant inf | 40 | 2 | 80
Insert PM arrière inf | 150 | 2 | 300 | Insert PM arrière inf | 30 | 2 | 60 | Insert PM arrière inf | 40 | 2 | 80
Tubes | 0.464 | 6620.8 | 3070.515942 | Tubes |  | 6620.8 | 2089.137601 | Tubes |  | 6620.8 | 913.8981555
 |  | TOTAL | 5974.515942 |  |  | TOTAL | 3069.137601 |  |  | TOTAL | 1837.898156
 |  |  |  | Poids / mm tubes alu (g) | 0.3155415661 |  |  | Poids / mm tubes carbones (g) | 0.1380344
 |  |  |  | Diam ext 20 * 2
Solution alu-carbone
Masse réelle | masse (g) | nombre | masse total
Biellettes | 215.766021 | 2 | 431.532042
Triangles avant sup | 218 | 2 | 436
Triangles arrière sup | 185 | 2 | 370
Triangles avant inf | 172 | 2 | 344
Triangles arrière inf | 178 | 2 | 356
(sans rotules/porte rotule) |  | TOTAL | 1937.532042

Sheet: Couts
Solutions | Usinages | Tubes | Soudure | Divers | Total
Acier | 200.00 € | 100.00 € | 300.00 € | 0.00 € | 600.00 €
Alu | 1500.00 € | 110.00 € | 400.00 € | 0.00 € | 2010.00 €
Alu-carbone | 2500.00 € | 800.00 € | 0.00 € | 50.00 € | 3350.00 €
