EOSCogniton/STUF2019/EN - Engine & Powertrain/EN_A0900 (Secondary drivetrain)/EN_A0905 (Jacking Bar)/Classeur1.xlsx

Jacking barre
Diamètre des trous | Masse | diff
5mm | 430 | -3.153153153%
7mm | 409 | -7.882882883%
10mm | 372 | -16.21621622%
masse vulcanix | 444
 |  |  |  | -0.2117117117
nombre de trou : | 8 | 9 | 10 | 11 | 12 | 13 | 14 | 15
longueur totale : | 320 | 320 | 320 | 320 | 320 | 320 | 320 | 320
espacement entre trous : | 32 | 29.09090909 | 26.66666667 | 24.61538462 | 22.85714286 | 21.33333333 | 20 | 18.82352941
Dimensionnement de la vis :
Poids véhicule | 230
Poids pilote | 70 |  | g = | 9.81
Poids total | 300 |  | e = | 1575
Poids (Force) | 2943 |  | l = | 800
theta | 25 |  | f = | 0.28 | coef frottement alu-acier
Poids vu par la jacking bar | 754.0621985
Fn | 2693.07928
