EOSCogniton/STUF2019/EL - Electrical/Autre/Tableau de bord/Tableau vulcanix/Carte avant/electronique_vulcanix-master/README.md

# elctronique_vulcanix
ce dépôt sert à déposer tous les documents concernant l'électronique, le faisceau  électrique et le reste.
