EOSCogniton/STUF2019/DS_Design Report/Design_Report_2019.docx

DESIGN REPORT

SAISON 2019

Ecole Centrale de Lyon – Car 19

Design Report

Instructions :

Les responsables d’une partie du design, vos noms sont ecrit entre parenthese à coté du titre de la partie. Quand vous avez rédigé votre partie surlignée en gris chefs de département quand vous avez relu surlignez le texte en jaune et quand le responsable design a relu (c’est-à-dire moi) je surligne en vert.

Ex :

Etiam diam velit, convallis ut dui et, porttitor consectetur nulla. Quisque ultricies tempus lacus nec ornare. Maecenas dignissim augue a dui consectetur lacinia. Ut ut mi vehicula, aliquet erat at, bibendum magna.

Etiam diam velit, convallis ut dui et, porttitor consectetur nulla. Quisque ultricies tempus lacus nec ornare. Maecenas dignissim augue a dui consectetur lacinia. Ut ut mi vehicula, aliquet erat at, bibendum magna.

Etiam diam velit, convallis ut dui et, porttitor consectetur nulla. Quisque ultricies tempus lacus nec ornare. Maecenas dignissim augue a dui consectetur lacinia. Ut ut mi vehicula, aliquet erat at, bibendum magna.

Design overview (NGO)

Optimus is the name of the 2019 car of our FS team called Ecurie Piston Sport Auto (EPSA) from Ecole Centrale de Lyon (France). We are composed of 4 departments: Vehicle dynamic, Powertrain, Frame & Electrical.

Our design guideline is the following:

1. Losing weight
2. The cornering behaviour have been privileged during conception
3. Adding data acquisition for a more compliant set up
4. All these qualities contained in a reasonable price

The resultant vehicle weight is 204 kg. The car is based on a tubular steel space-frame chassis, powered by a four-cylinder internal combustion engine combined with 13” tyres.

We structured the whole conception of our vehicle using the V-model. Starting from general specification, according to FSG rules and time expectation for dynamic events, each team member developed his own specification for his subsystem. An iteration process has been done, in order to have viable designs that reach the specification. After, the mechanical design of each part was made using Catia. Then, following that phase of conception, the production of the parts started in compliance with the feature we set. Unit validation of each part has been done, to proceed to the integration and validation of the subsystems and finally the car was realised in order to confront its performances to the objectives announced.

Vehicle dynamic & suspensions (PCT)

Tyre choice (GTE & MSO)

Etiam diam velit, convallis ut dui et, porttitor consectetur nulla. Quisque ultricies tempus lacus nec ornare. Maecenas dignissim augue a dui consectetur lacinia. Ut ut mi vehicula, aliquet erat at, bibendum magna. Quisque dapibus fringilla dolor at dignissim. Fusce semper quis arcu eget mattis. Vivamus consequat congue tellus at pharetra. Vivamus tincidunt ultrices dui, eget lobortis quam convallis eget. Fusce aliquet a mi id tincidunt. Aliquam mi nisi, accumsan ac metus nec, tincidunt faucibus massa.

Suspension (PCT)

Etiam diam velit, convallis ut dui et, porttitor consectetur nulla. Quisque ultricies tempus lacus nec ornare. Maecenas dignissim augue a dui consectetur lacinia. Ut ut mi vehicula, aliquet erat at, bibendum magna. Quisque dapibus fringilla dolor at dignissim. Fusce semper quis arcu eget mattis. Vivamus consequat congue tellus at pharetra. Vivamus tincidunt ultrices dui, eget lobortis quam convallis eget. Fusce aliquet a mi id tincidunt. Aliquam mi nisi, accumsan ac metus nec, tincidunt faucibus massa.

Steering system (GTE)

Etiam diam velit, convallis ut dui et, porttitor consectetur nulla. Quisque ultricies tempus lacus nec ornare. Maecenas dignissim augue a dui consectetur lacinia. Ut ut mi vehicula, aliquet erat at, bibendum magna. Quisque dapibus fringilla dolor at dignissim. Fusce semper quis arcu eget mattis. Vivamus consequat congue tellus at pharetra. Vivamus tincidunt ultrices dui, eget lobortis quam convallis eget. Fusce aliquet a mi id tincidunt. Aliquam mi nisi, accumsan ac metus nec, tincidunt faucibus massa.

Frame & body (RCS)

Frame (RCS)

Etiam diam velit, convallis ut dui et, porttitor consectetur nulla. Quisque ultricies tempus lacus nec ornare. Maecenas dignissim augue a dui consectetur lacinia. Ut ut mi vehicula, aliquet erat at, bibendum magna. Quisque dapibus fringilla dolor at dignissim. Fusce semper quis arcu eget mattis. Vivamus consequat congue tellus at pharetra. Vivamus tincidunt ultrices dui, eget lobortis quam convallis eget. Fusce aliquet a mi id tincidunt. Aliquam mi nisi, accumsan ac metus nec, tincidunt faucibus massa. quam convallis eget. Fusce aliquet a mi id tincidunt. Aliquam mi nisi, accumsan ac metus nec, tincidunt faucibus massa. quam convallis eget. Fusce aliquet a mi id tincidunt. Aliquam mi nisi, accumsan ac metus nec, tincidunt faucibus massa. quam convallis eget. Fusce aliquet a mi id tincidunt. Aliquam mi nisi, accumsan ac metus nec, tincidunt faucibus massa. tincidunt. Aliquam mi nisi, accumsan ac metus nec, tincidunt faucibus massa. quam convallis eget. Fusce aliquet a mi id tincidunt.

Body (JKL)

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

Ergonomie (MCI)

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

Engine & powertrain (CEE)

Engine choice (CEE)

Etiam diam velit, convallis ut dui et, porttitor consectetur nulla. Quisque ultricies tempus lacus nec ornare. Maecenas dignissim augue a dui consectetur lacinia. Ut ut mi vehicula, aliquet erat at, bibendum magna. Quisque dapibus fringilla dolor at dignissim. Fusce semper quis arcu eget mattis. Vivamus consequat congue tellus at pharetra. Vivamus tincidunt ultrices dui, eget lobortis quam convallis eget. Fusce aliquet a mi id tincidunt. Aliquam mi nisi, accumsan ac metus nec, tincidunt faucibus massa. quam convallis eget. Fusce aliquet a mi id tincidunt. Aliquam mi nisi, accumsan ac metus nec, tincidunt faucibus massa. quam convallis eget. Fusce aliquet a mi id tincidunt. Aliquam mi nisi, accumsan ac metus nec, tincidunt faucibus massa. quam convallis eget. Fusce aliquet a mi id tincidunt. Aliquam mi nisi, accumsan ac metus nec, tincidunt faucibus massa. tincidunt. Aliquam mi nisi, accumsan ac metus nec, tincidunt faucibus massa. quam convallis eget. Fusce aliquet a mi id tincidunt.

Exhaust & air intake systems (CEE & TLS)

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

Fuel system (BVL)

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

Secondary drivetrain (MPY)

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

Electrical (BAT)

Electronic (BAT)

Etiam diam velit, convallis ut dui et, porttitor consectetur nulla. Quisque ultricies tempus lacus nec ornare. Maecenas dignissim augue a dui consectetur lacinia. Ut ut mi vehicula, aliquet erat at, bibendum magna. Quisque dapibus fringilla dolor at dignissim. Fusce semper quis arcu eget mattis. Vivamus consequat congue tellus at pharetra. Vivamus tincidunt ultrices dui, eget lobortis quam convallis eget. Fusce aliquet a mi id tincidunt. Aliquam mi nisi, accumsan ac metus nec, tincidunt faucibus massa. quam convallis eget. Fusce aliquet a mi id tincidunt. Aliquam mi nisi, accumsan ac metus nec, tincidunt faucibus massa. quam convallis eget. Fusce aliquet a mi id tincidunt. Aliquam mi nisi, accumsan ac metus nec, tincidunt faucibus massa. quam convallis eget. Fusce aliquet a mi id tincidunt. Aliquam mi nisi, accumsan ac metus nec, tincidunt faucibus massa. tincidunt. Aliquam mi nisi, accumsan ac metus nec, tincidunt faucibus massa. quam convallis eget. Fusce aliquet a mi id tincidunt.

Data acquisition (ARZ)

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

Figures…

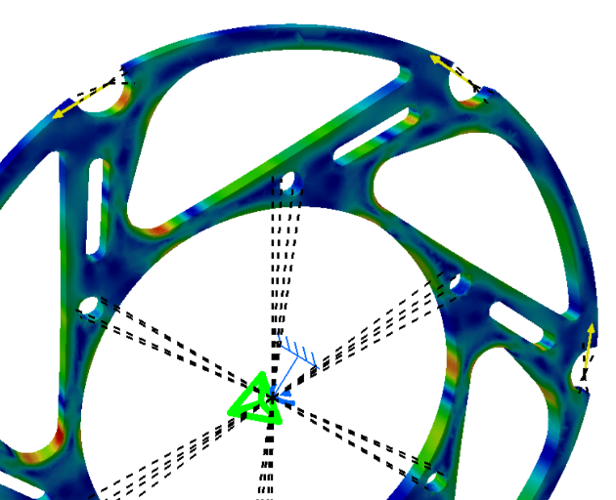
[picture p89: figure]

Fig 1. Legend
