EOSCogniton/STUF2019/DS_Design Report/03_Ressources/2015_Design_Dynamix/Document à afficher/Electrical/Schéma élec.docx

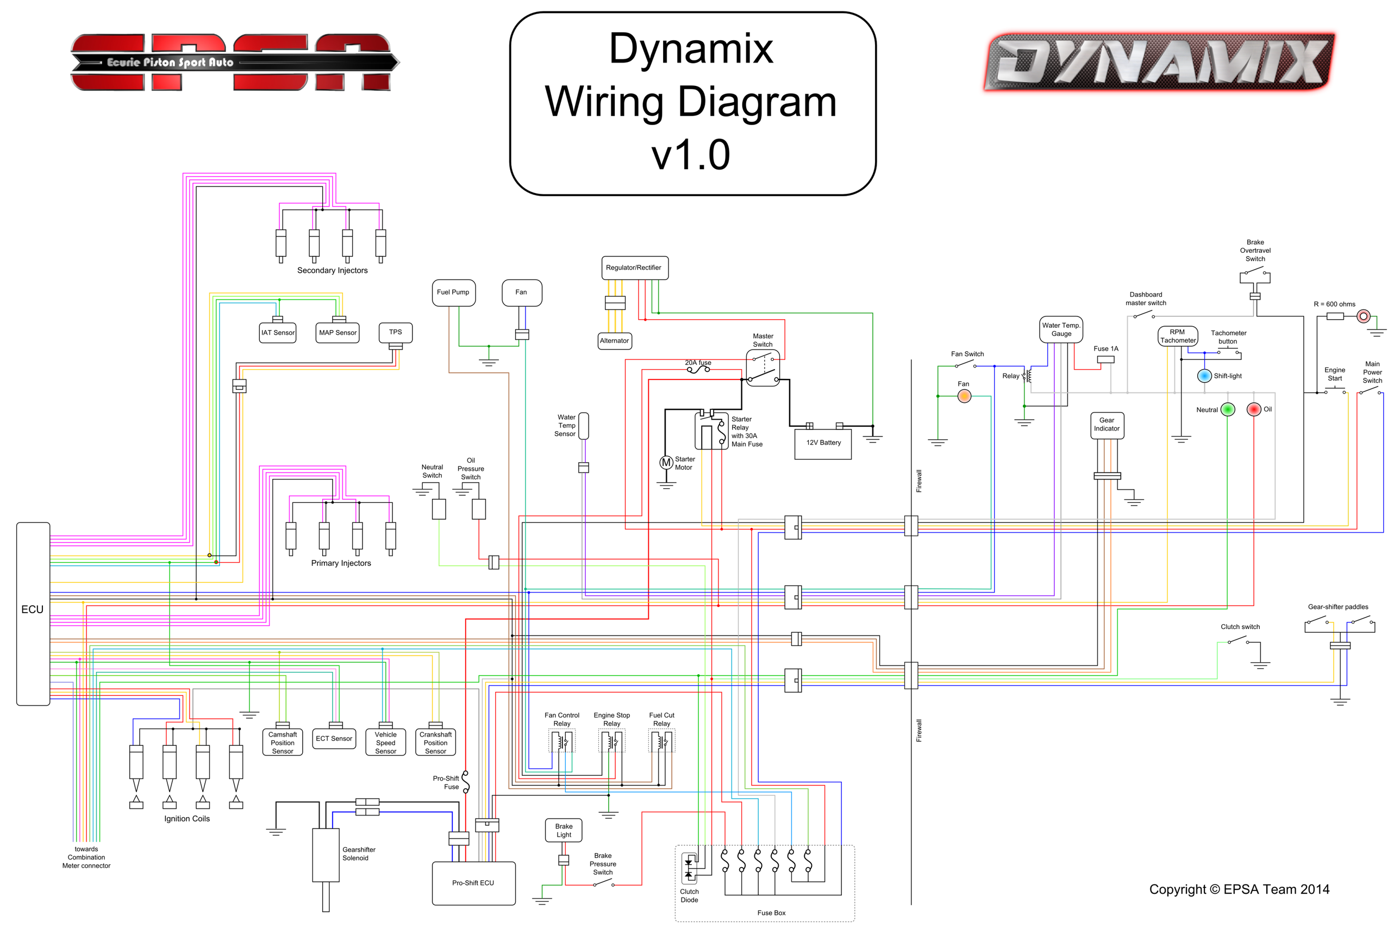
[picture p90: figure]
