EOSCogniton/STUF2019/EN - Engine & Powertrain/EN_A0100 (Engine)/Carter d'huile - fonderie/Cahier des charges carter d'huile.docx

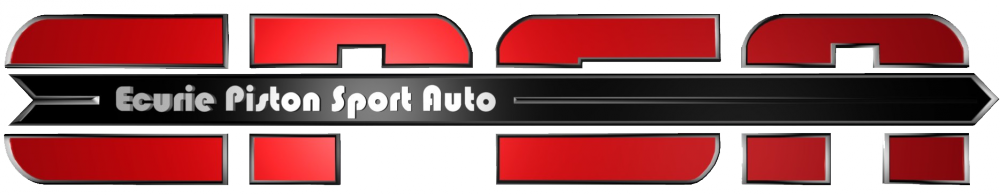
[picture p112: figure]

# Cahier des charges pour la conception d’un carter d’huile

# Contact

Brice Roblot :

06 84 54 58 74

brice.roblot@ecl16.ec-lyon.fr

# Présentation du système

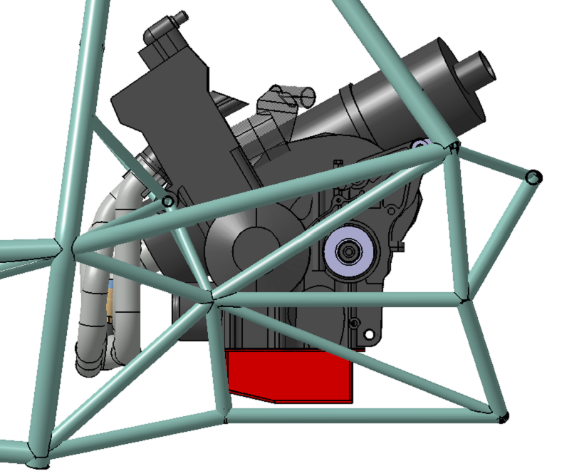
[picture p113: figure]
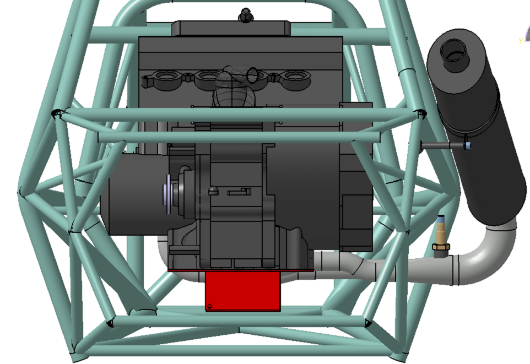
[picture p114: figure]

Le carter d’huile se situe en dessous du moteur, en rouge sur les illustrations ci-dessous :

Figure 2 : vue de coté

Figure 1 : Vue de derrière

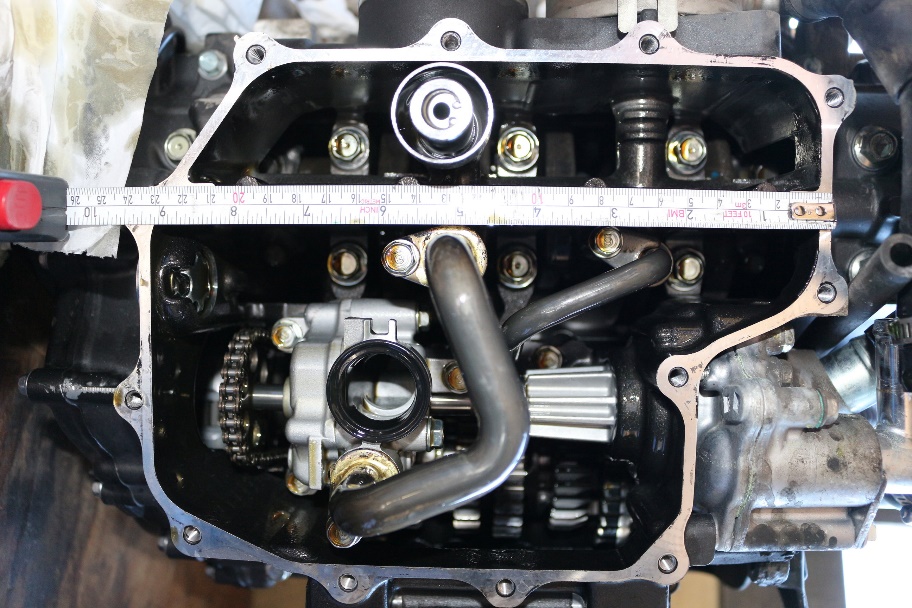
[picture p115: figure]

La zone du moteur au-dessus du carter est :
