EOSCogniton/STUF2019/FR - Frame & Body/FR_A0100 (Frame)/Production/Répartition tâches gueules de loup.docx

Répartition des tubes à effectuer

Tanguy :

Shape_704

Shape_705

Shape_707

Shape_708

Shape_715

Shape_716

Shape_719

Shape_721 ok

Shape_723

Shape_725 ok

Shape_727

Côme :

Shape_728

Shape_731

Shape_734 ok

Shape_737

Shape_739

Shape_740

Shape_741

Shape_742

Shape_743

Shape_744

Shape_745

Shape_746

Shape_747

Camille :

Shape_748

Shape_753

Shape_755

Shape_756

Shape_761

Shape_762

Shape_763

Shape_765

Shape_766

Shape_767

Shape_768

Pierre Guillaume :

Shape_770 ok relimité par rapport à 739-755 dans nœud étoile / relimité 761-762 autre côté

Shape_773

Shape_774

Shape_775

Shape_776 ok relimité par rapport 716+sa symétrie

Shape_779

Shape_780

Shape_781 ok relimité 710/727 bulkhead – 721/725 front hoop

Shape_783

Shape_784 ok

Shape_785 ok

Calixthe :

Shape_786 ok

Shape_787 ok

Shape_788 ok

Shape_789 ok

Shape_790 ok
