EOSCogniton/STUF2019/EL - Electrical/Autre/Tableau de bord/Tableau Optimus/compte rendus.odt

L’organisation des livrables à l’EPSA :

L’EPSA utilise deux nomenclature : une en interne et la seconde pour la compétition.

Première Nomenclature utilisée par Epsabox et PSO :

La Nomenclature est d’abords décomposées systèmes:

SO -Optimus

S1 Motorisation

S2

…

S51 sous système

S534 sous sous système

En allant dans la boite de connaissance du véhicule : Optimus

En ouvrant un département, on trouve les sous systèmes listées avec leur code.

La nomenclature peut aussi partir du niveau le plus bas : en partant d’un systèmes d’ordre z vers y ect

La nomenclature utilisée pour le formula student sert au COST (épreuve traçage historique de l’ensemble des pièces du véhicule). Toutes les pièces doivent être listées, même la plus petite. Le document finale fait environ 600pages, mise en page et fusionné par un responsable : le responsable du COST. Pour garder une certaine homogénéité sur ces 2000 à 2500 pièces : on utilise des noms anglais.

Pour un assemblage : XX AYYYY

XX : code sous-système :

BR : brake system

EN : Engine Drivetrain

FR : Frame Body

EL electrical

MS Misc assembly

ST

SU

WT

A : indique assemblage

YY : le numéros de l’assemblage

YY : numéros de sous assemblage

Pour la pièce : XX YYYY ZZZ VV

ZZZ nom de la pièce numéro

VV : version de la pièce lettre

Version principale version secondaire

Le classeur Google sheets montré donne les informations sur l’ensemble des pièces : leur État : design, masse théorique ect. Il y a beaucoup de points à gagner si le poids réel de la voiture est en accord avec son poids théorique.

Nicolas :

Nicolas présente les outils utilisés comme les sheet google : avantage gratuit.*Peut être assez complet. Un lien à été envoyé par mail : EPSA fin des parrainages : qui donne un lien sur Slack.

Sur l’adresse mail, vous pouvez créer des dossier en glissant déposant pour organiser vos mails. Vous pouvez aussi filtrer vos mails.

Slack est un messenger amélioré : En arrivant sur Slack, vous n’avez pas toutes les chaînes. En cliquant sur le lien chaîne, choisissez les chaîne qui vous concerne : votre département, évents, github, sponsoring.

La méthode : on écrit le titre d’un fil et on répond à notre propre message pour être plus propose.

Facebook : c’est pour du déplacement rapide et du « conchiage ».

Utilisez Slack pour poser des questions (dimensionnement, géométrie ect), trouver certaines informations.

Le deuxième outil utilisé est GitHub. C ‘est un drive avec un système de versionnement et de savoir qui à modifié de quoi.

La structure de base était git, puis il a eu github. Des interfaces se sont rajoutées comme gitkraken.

Pendant le travail sur les pièces, pensez à l’envoyer sur le serveur pour prévoir des perte de PC portable et que pour les personne dont le travail dépend de vos pièce soit à jour.

La branche principale s’appelle MASTER.

Sur votre ordi, vous recopiez le serveur, les modifications sont faites en local. L’utilisateur l’envoie,

Vous pouvez créer votre branche, que d’autre peuvent utiliser, si OK, vous pouvez les fusionner ou sinon la supprimer.

A droite, le logicielle détecte les fichiers modifiés en local par rapport au serveur : en orange modifié, en rouge supprimé. On met d’abord à jour les données en local en faisant un pull. On stage les modifications, on ajoute un commentaire et on le commite. En faisant un push, le serveur se synchronise avec la version locale.

Si on prend la Git de Stuff 2019 vous pouvez voir les actions de chacun et les commentaires.

Nicolas avais fait une erreur en supprimant des fichier. Grace au versionnement, on peut revenir en arrière.

En cas de problème demandez à PACO ou auto-formez vous.

Maxim devait faire la présentation

Je vous présente les ganttes : je vous présente un carnet presque terminé disponible sur Intergène (non disponible encore).

Ces carnets regroupent un certain nombre de règles : comme les pièces catia doivent être contraintes.

Paco : Par exemple, on utilise certaines épaisseurs de plaques d’acier : 1,5 3 5mm

Grace à un acier de meilleur

Avant de dessiner un pièce : vérifiez si elle n’est pas standard.

Le carnet esr écrit par un 3A.

Demandez à Maxim pour les info de standardisation.

Exemple : table de serrage de vis.

Pour une taille de vis, il faut prendre un troue legèrement plus grand. Ect

Le gAntt : c’est un planing : avec les différentes taches.

Elle prenne la forment de Dolist sur EPSABox. L’idée : ne pas rester bloquée : le directeur technique, le parrain, le directeur de département, les académiciens sont là pour ça.

PACO : Vous allez vous réunir par département : et réaliser les Do-list sur EpsaBox.
