EOSCogniton/STUF2019/DS_Design Report/03_Ressources/2015_Design_Dynamix/TOP_Dynamix_v2.pdf

# Le TOP du top

# Dynamix v2.0

Présentation Dynamix v2.0 | 28/01/2015

FS Italy 2014 | Objectifs 2015 | Dynamix v2.0 | Essais | Conclusion

# Sommaire

# - Retour sur la compétition

# - Objectifs pour 2015

# - Améliorations pour Dynamix v2.0

# - Essais à venir

2

# Retour sur la compétition

# Cost event

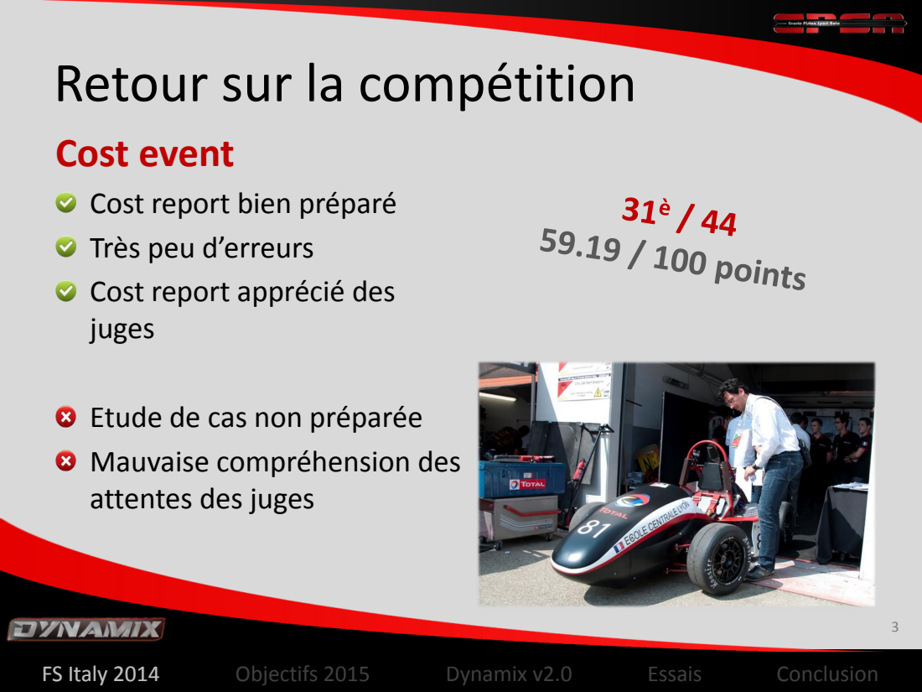
[picture p119: page 3]
FS Italy 2014

Cost report bien préparé
Très peu d’erreurs
Cost report apprécié des
juges

Etude de cas non préparée
Mauvaise compréhension des
attentes des juges

# Retour sur la compétition

# Design event

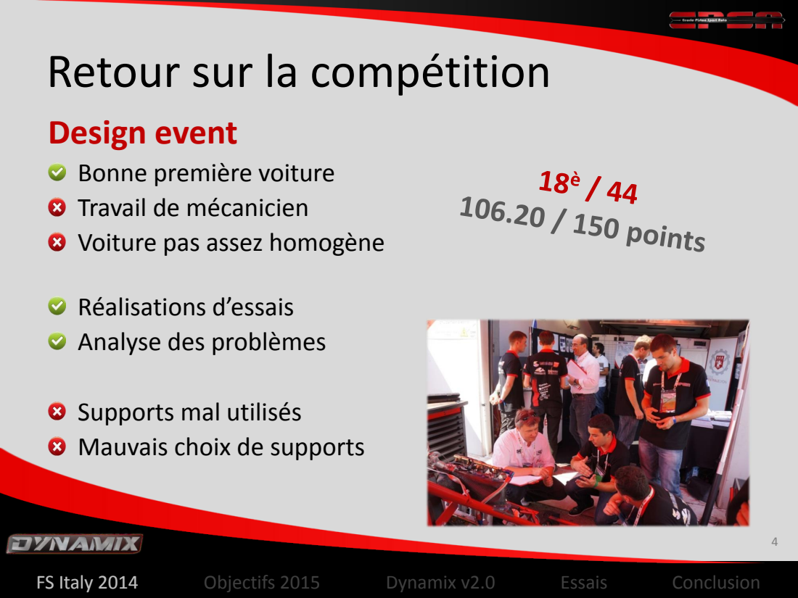
[picture p120: page 4]
FS Italy 2014

Bonne première voiture
Travail de mécanicien
Voiture pas assez homogène

Réalisations d’essais
Analyse des problèmes

Supports mal utilisés
Mauvais choix de supports

# Retour sur la compétition

# Business event

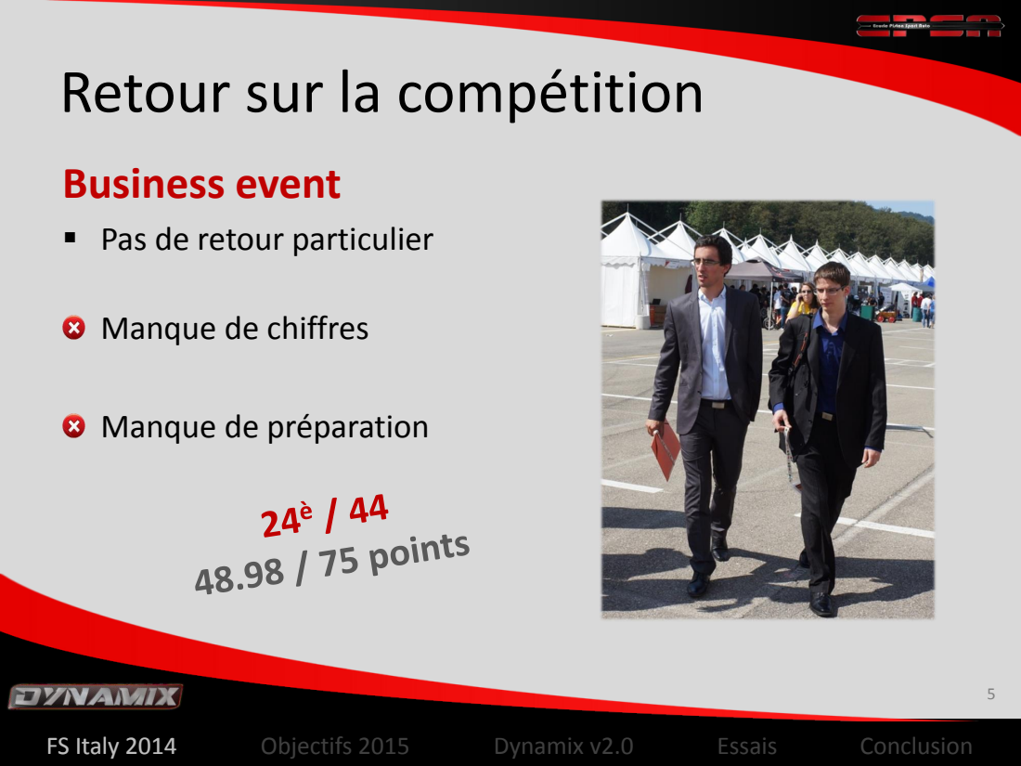
[picture p121: page 5]
FS Italy 2014

▪ Pas de retour particulier

Manque de chiffres

Manque de préparation

# Retour sur la compétition

# Vérifications techniques

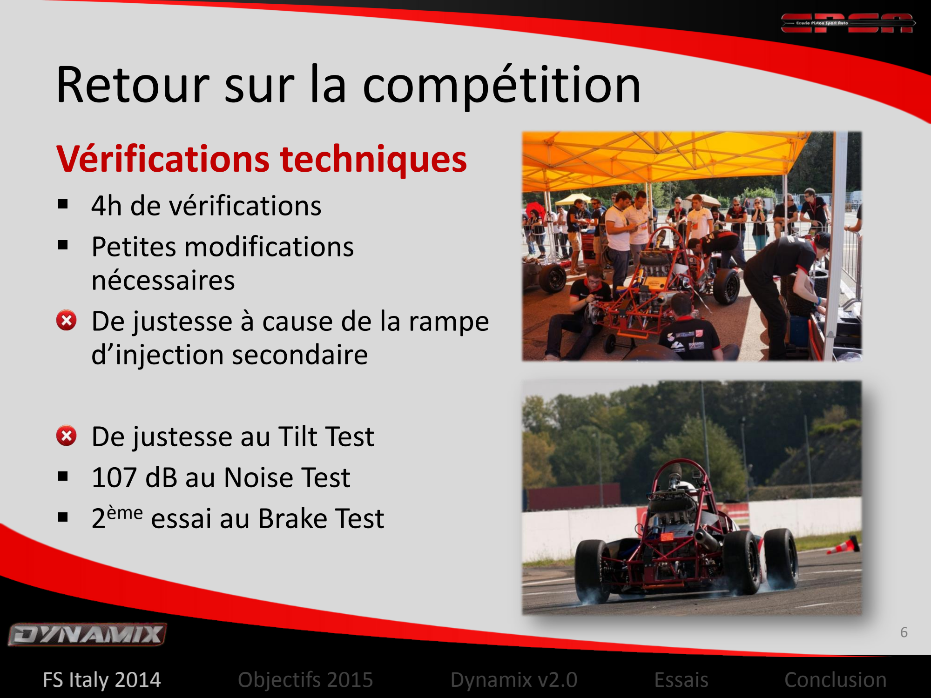
[picture p122: page 6]

## - 4h de vérifications - Petites modifications nécessaires De justesse à cause de la rampe d’injection secondaire

## De justesse au Tilt Test - 107 dB au Noise Test

- 2

## ème essai au Brake Test

6

FS Italy 2014

# Retour sur la compétition

# Practice

## - Casse d’une chape de direction sur le porte-moyeu - Tentative de réparation au poste à souder - Fabrication d’une nouvelle pièce fonctionnelle

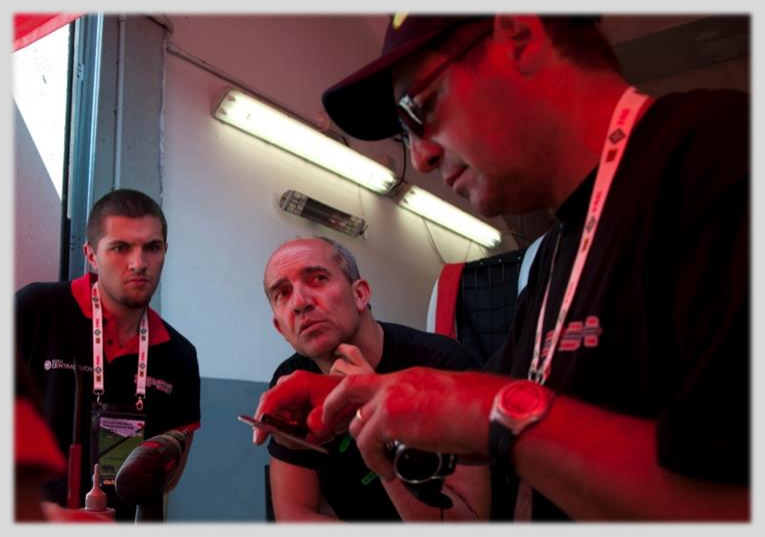
[picture p123: figure]

## - Renfort de la pièce symétrique - Validation par les juges

7

FS Italy 2014

# Retour sur la compétition

# Skid-Pad

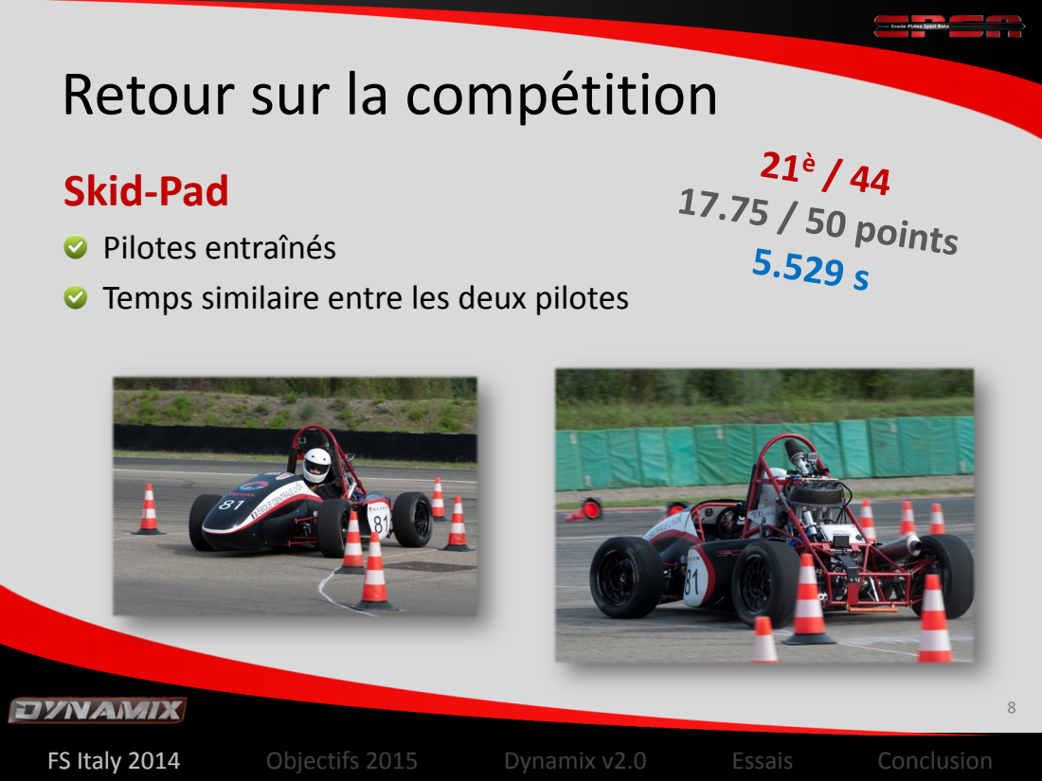
[picture p124: page 8]
FS Italy 2014

Pilotes entraînés
Temps similaire entre les deux pilotes

# Retour sur la compétition

# Accélération

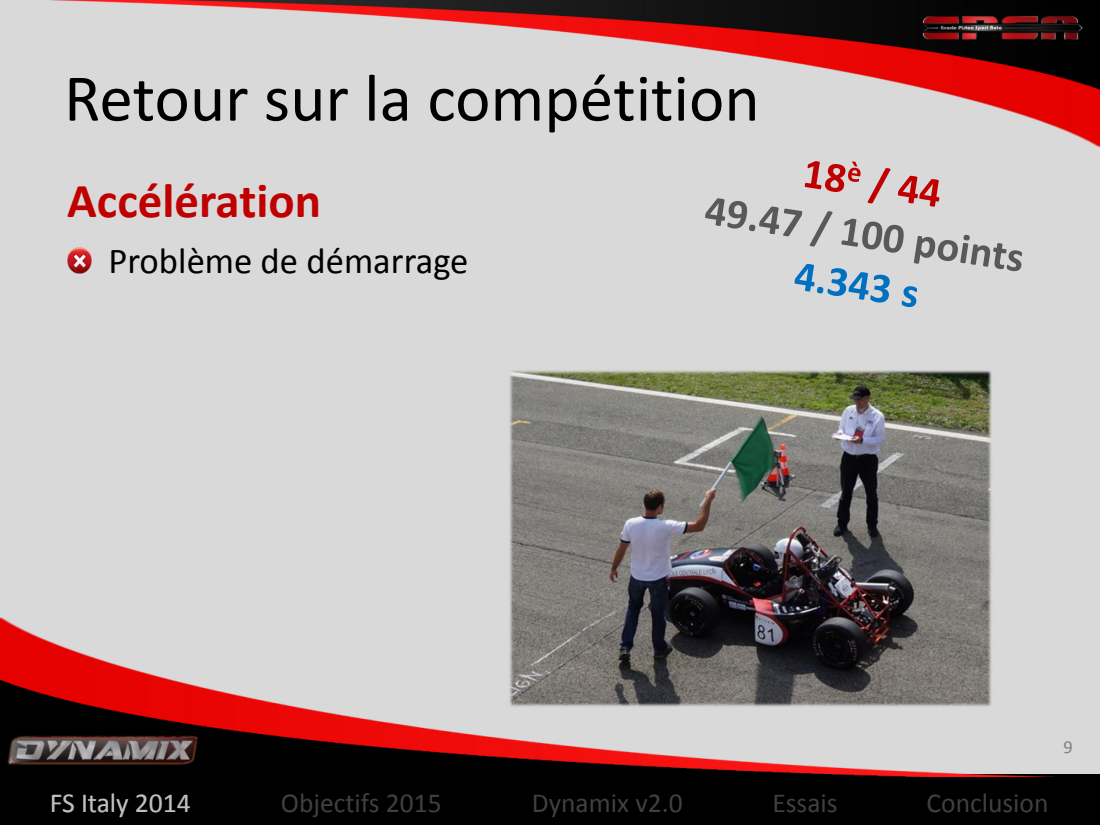
[picture p125: page 9]
FS Italy 2014

Problème de démarrage

# Retour sur la compétition

# Autocross

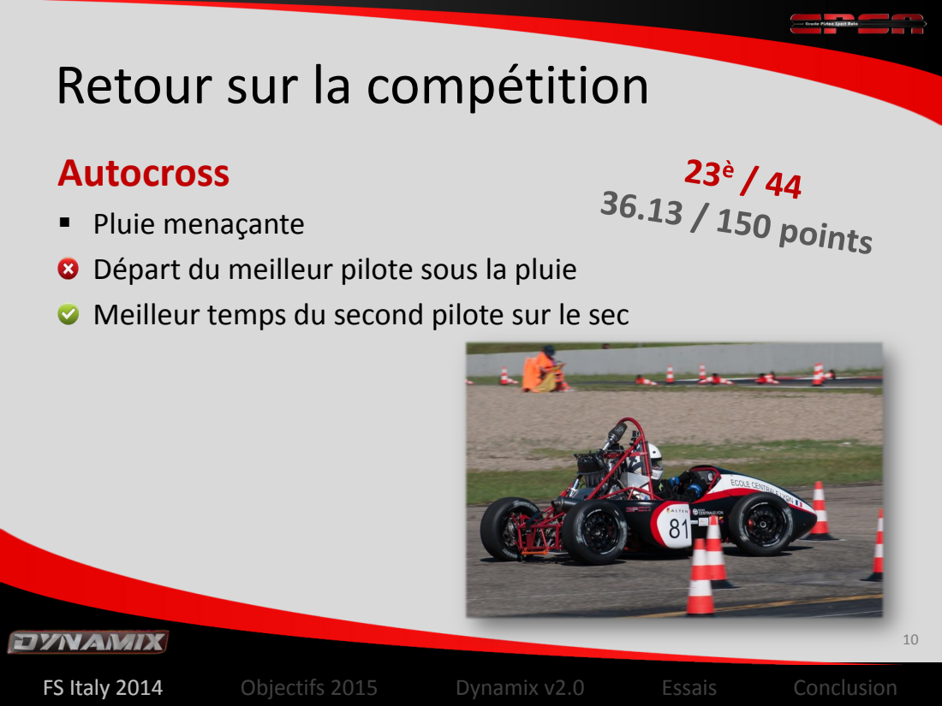
[picture p126: page 10]
FS Italy 2014

▪ Pluie menaçante
Départ du meilleur pilote sous la pluie
Meilleur temps du second pilote sur le sec

# Retour sur la compétition

# Endurance

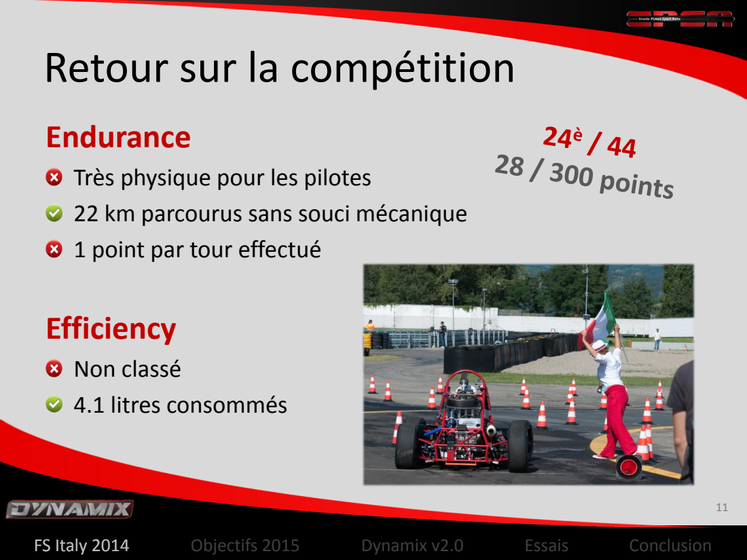
[picture p127: page 11]
Efficiency; Non classé 4.1 litres consommés; FS Italy 2014

Très physique pour les pilotes
22 km parcourus sans souci mécanique
1 point par tour effectué

# Retour sur la compétition

# Classement général :

12

24è / 44

# 345.72 / 1000 points

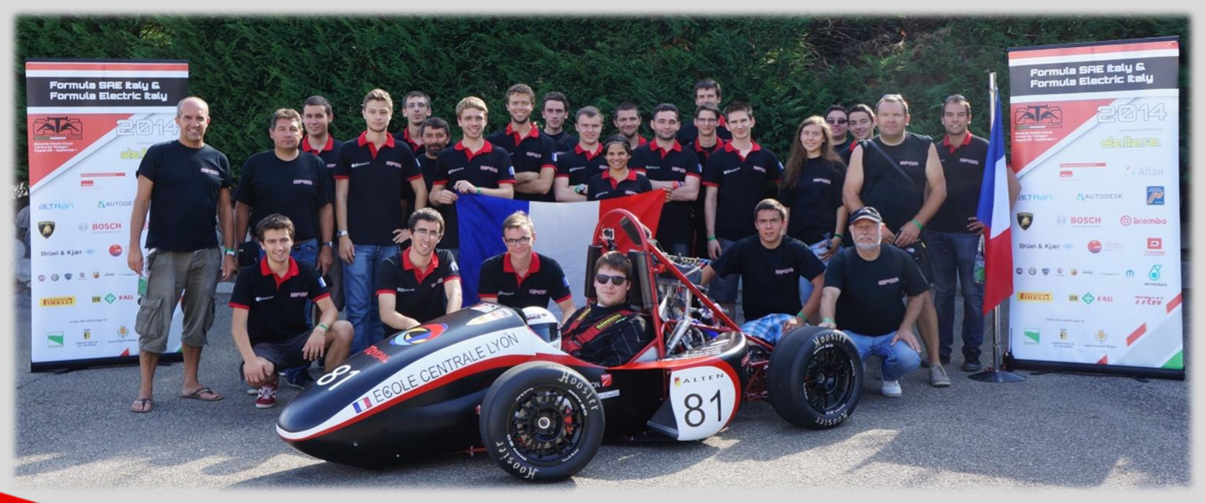
[picture p128: figure]

FS Italy 2014

# Objectifs pour 2015

# FSUK - Silverstone 2015 → 9 au 12 juillet

# (Inscription validée)

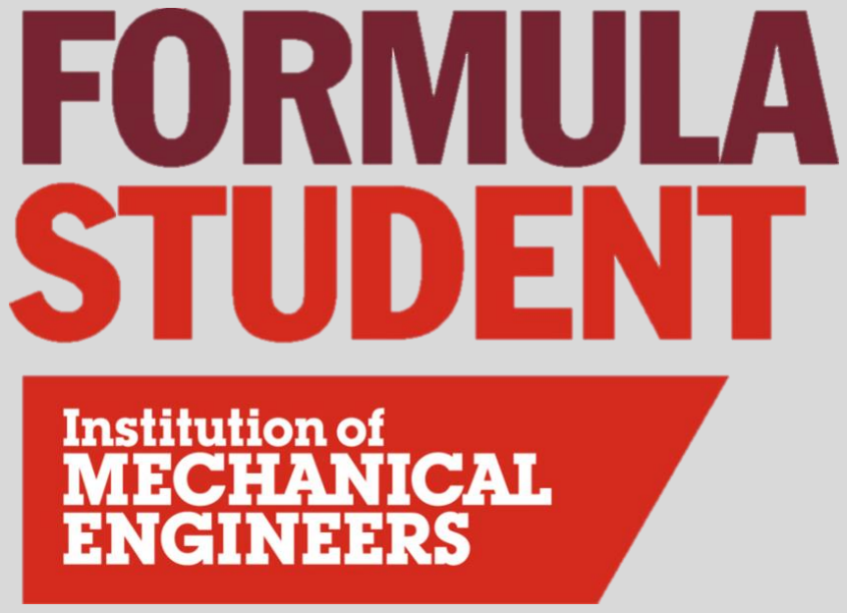
[picture p129: figure]

# Objectif : Best Newcomer (si éligible) Top 20

13

Objectifs 2015

# Objectifs pour 2015

14

Objectifs 2015

Skid-Pad | Accélération | Sprint | Endurance | Efficiency
Top 25 | Top 15 | Top 30 | Top 20 | Top 25
20 / 50 pts | 40 / 75 pts | 40 / 150 pts | 75 / 300 pts | 35 / 100 pts
Cost | Design | Business
Top 25 | Top 50 | Top 40
60 / 100 pts | 80 / 150 pts | 50 / 75 pts

## Général

## Top 20

## 400 / 1000 pts

(5.4 s) | (4.2 s)

# Améliorations

# - Suspensions

# - Direction

## – Chasse et angle de chasse – Cinématique de colonne

# - Embrayage

# - Calculateur DTA

15

Dynamix v2.0

# Les contraintes

# - Aucun changement apporté sur le châssis

# - Limiter les usinages

# - Eviter d’immobiliser la voiture

16

# Suspensions : le problème

## - Plongée importante au freinage

## - Prise de roulis importante

## - Manque de réactivité de la voiture

## - Impossibilité de rabaisser la voiture

## → Raideurs des suspensions trop faibles

17

# Suspensions : l’analyse

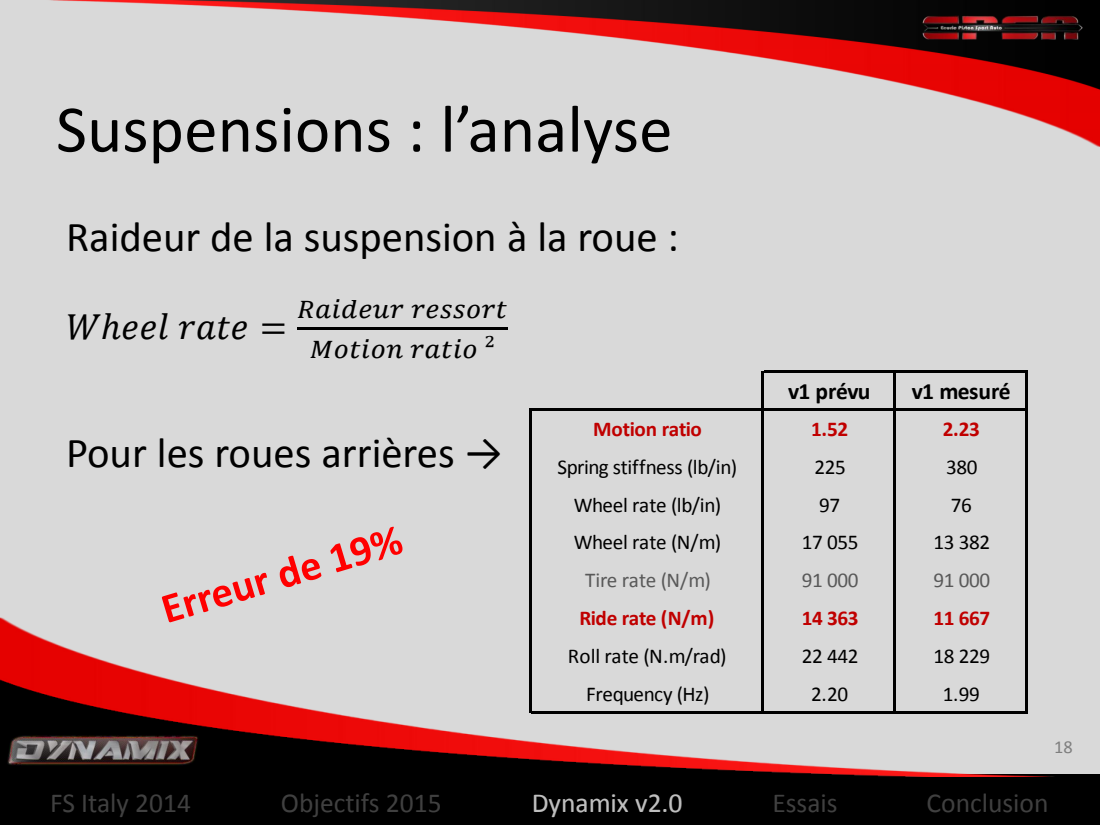
[picture p130: page 18]
Wℎeel rate =; Raideur ressort Motion ratio ²; v1 prévu; v1 mesuré; Motion ratio; Spring stiffness (lb/in); Wheel rate (lb/in); Wheel rate (N/m); Tire rate (N/m); Ride rate (N/m); Roll rate (N.m/rad); Frequency (Hz)

Raideur de la suspension à la roue :

Pour les roues arrières →

# Suspensions : la solution choisie

## - Nouvelle cinématique de suspension

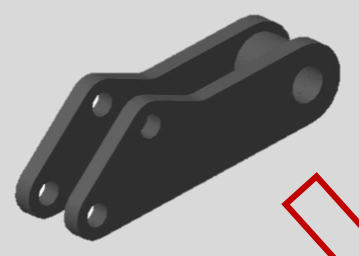
[picture p131: figure]
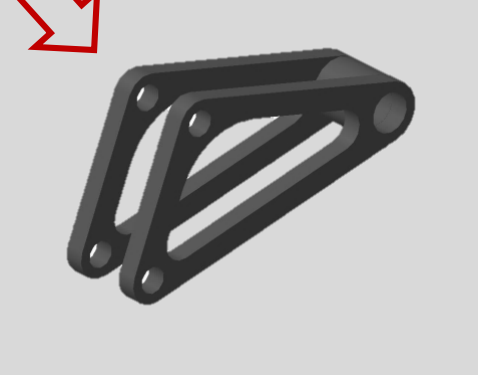
[picture p132: figure]

## - Nouveaux ressorts si besoin

| v1 prévu | v1 mesuré | v2
Motion ratio | 1.52 | 2.23 | 1.90
Spring stiffness (lb/in) | 225 | 380 | 380
Wheel rate (lb/in) | 97 | 76 | 105
Wheel rate (N/m) | 17 055 | 13 382 | 18 434
Tire rate (N/m) | 91 000 | 91 000 | 91 000
Ride rate (N/m) | 14 363 | 11 667 | 15 329
Roll rate (N.m/rad) | 22 442 | 18 229 | 23 952
Frequency (Hz) | 2.20 | 1.99 | 2.28

19

# Suspensions : la solution choisie

# - Trous de réglages sur les basculeurs avant

# - Choix de la raideur déterminée en essai

## – Réactivité – Prise de roulis – Equilibre avant/arrière en stationnaire (skid-pad)

20

# Direction : le problème

# - Direction très dure - Fatigue rapide des pilotes

21

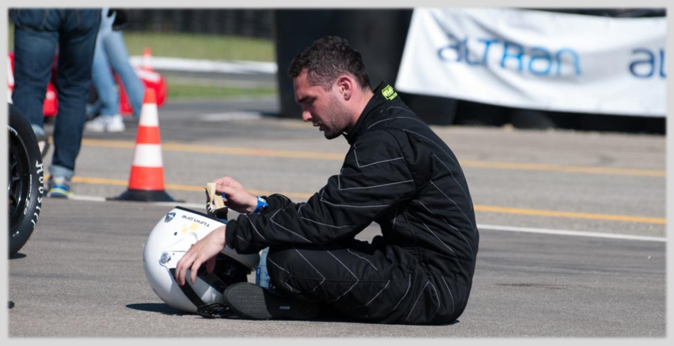
[picture p133: figure]

# Direction : l’analyse

## - Chasse et angle de chasse trop grand → Génération d’un effort important

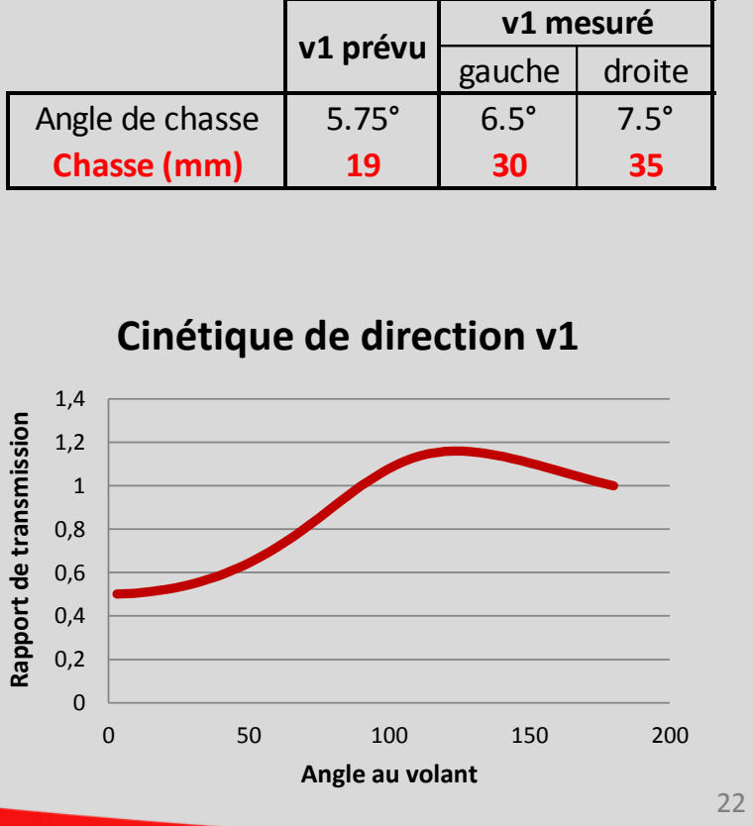
[picture p134: figure]
22 gauche; droite; Angle de chasse; Chasse (mm); v1 mesuré; v1 prévu; Rapport de transmission; Angle au volant; Cinétique de direction v1

## - Cinématique de colonne non homo-cinétique → Amplification de l’effort non constante

# Direction : la solution choisie

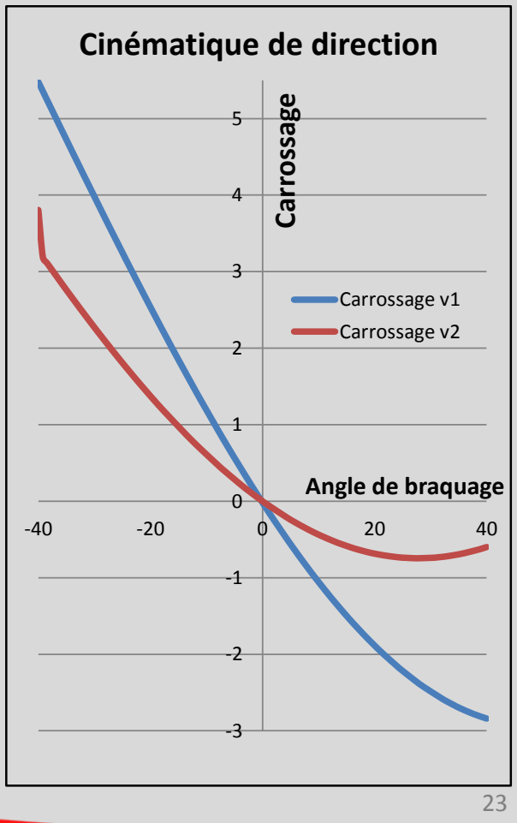
[picture p135: figure]
40 Carrossage; Angle de braquage; Cinématique de direction; Carrossage v1 Carrossage v2

## - Nouveaux triangles inférieurs

v1 prévu | v1 mesuré | v2
gauche | droite
Angle de chasse Chasse (mm) | 5.75° 19 | 6.5° 30 | 7.5° 35 | 3.1° 14

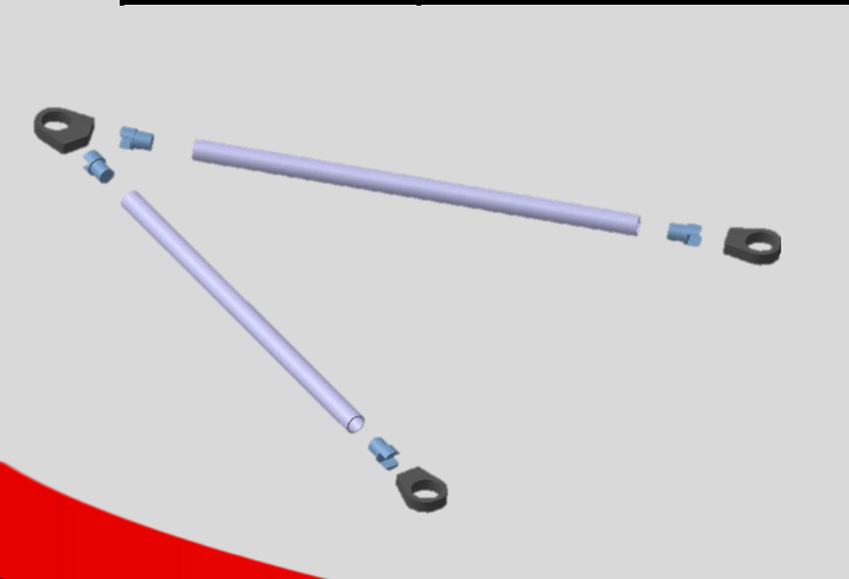
[picture p136: figure]
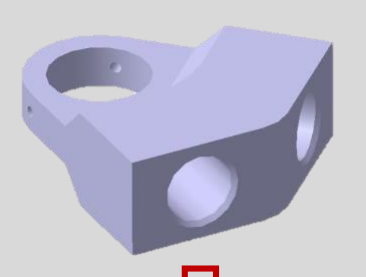
[picture p137: figure]
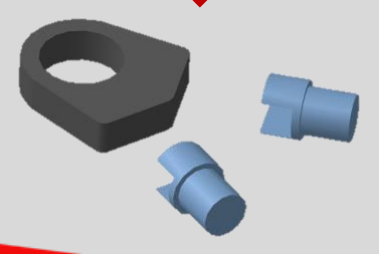
[picture p138: figure]

# Direction : la solution choisie

## - Nouvelle cinématique de colonne de direction

## → Nouveaux cardans plus petits → Cinématique homocinétique

24

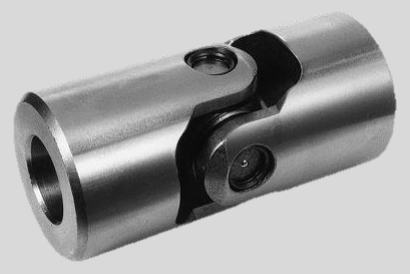
[picture p139: figure]

# Embrayage : le problème

## - Articulations du manche d’embrayage trop faibles

## → Desserrages + ballottement

## - Pas de réglage

## → Moins d’ergonomie

25

# Embrayage : l’analyse

# Vis pointeaux non adaptées à des efforts importants :

## - Appui du genou lors du Skid Pad - Hâte du pilote qui veut débrayer

26

# Embrayage : la solution choisie

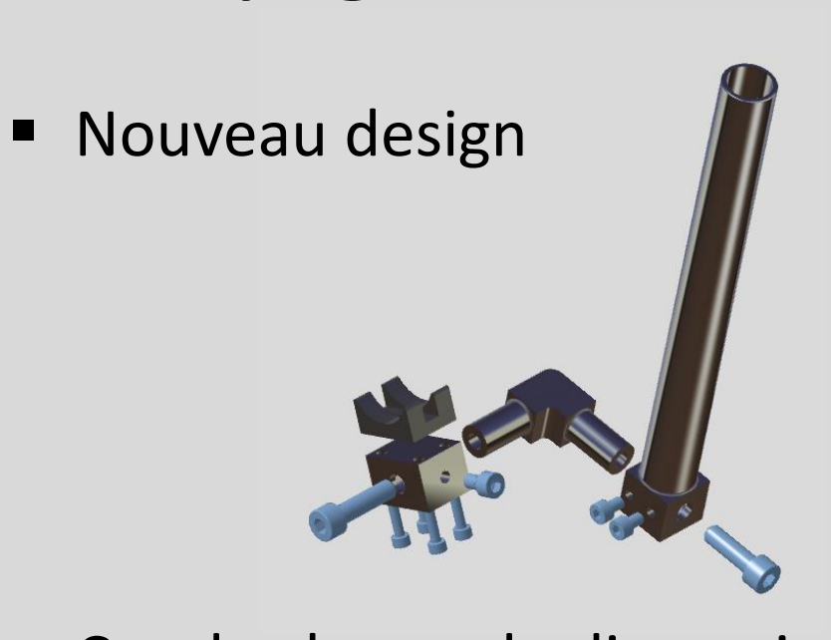
[picture p140: figure]
▪ Nouveau design
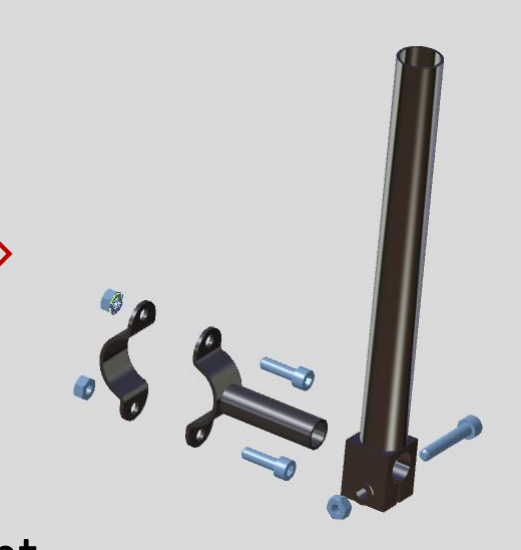
[picture p141: figure]

## - Cas de charge de dimensionnement

- Collier selon x dimensionné pour 250 N
- Collier selon y dimensionné pour 150 N

27

# Embrayage : la solution choisie

## - Démarche de dimensionnement

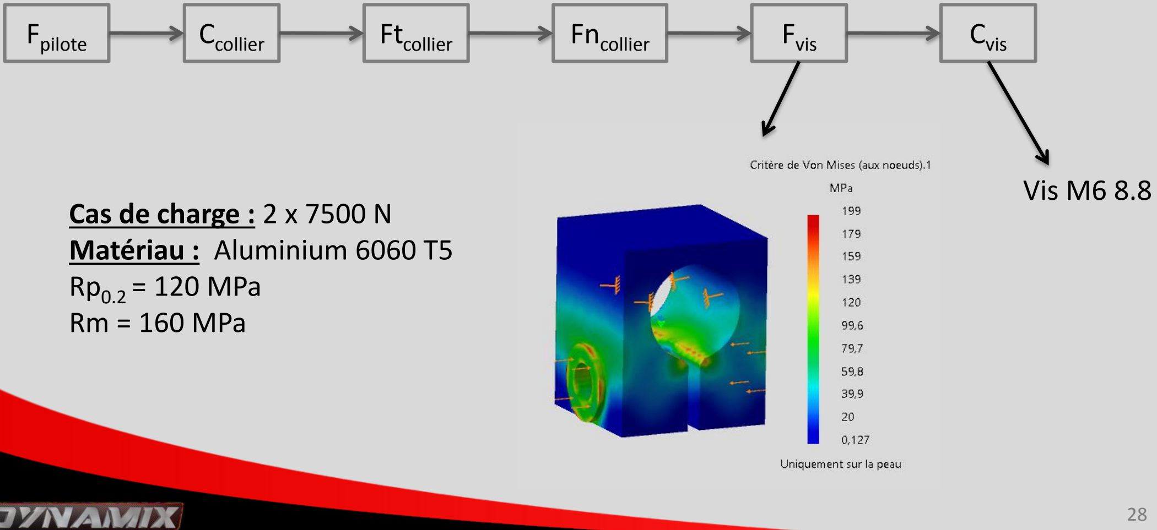
[picture p142: figure]
Fpilote; Ccollier; Ftcollier; Fncollier; Fvis; Cvis; Cas de charge : 2 x 7500 N Matériau : Aluminium 6060 T5 Rp0.2 = 120 MPa Rm = 160 MPa; Vis M6 8.8

# Calculateur DTA : les objectifs

## - Gain de performances : cartographie optimisée

## - Suppression de la seconde rampe d’injection

## - Optimisation du temps de changement de rapport

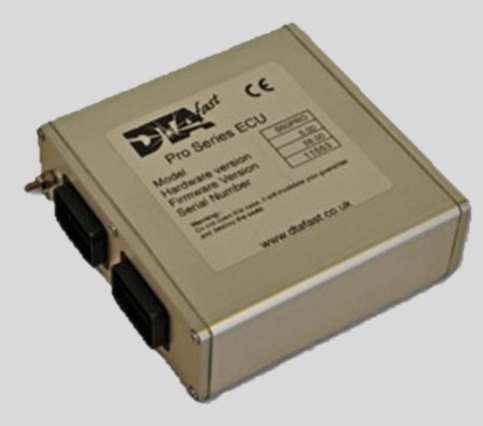
[picture p143: figure]

## - Acquisition de données moteur

29

# Calculateur DTA : état d’avancement

## - Calculateur câblé en parallèle

## - Pas de sonde lambda : travail en boucle ouverte

## - Gestion externe des coupures moteurs

## - Premiers essais avec la map CBR600 FSAE DTA

30

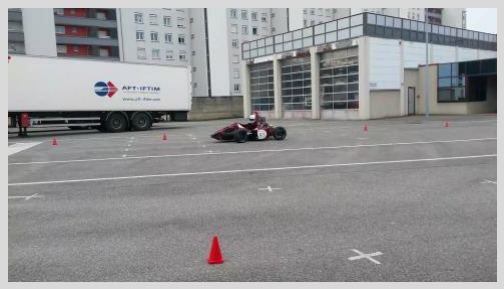
[picture p144: figure]

# Schéma électrique

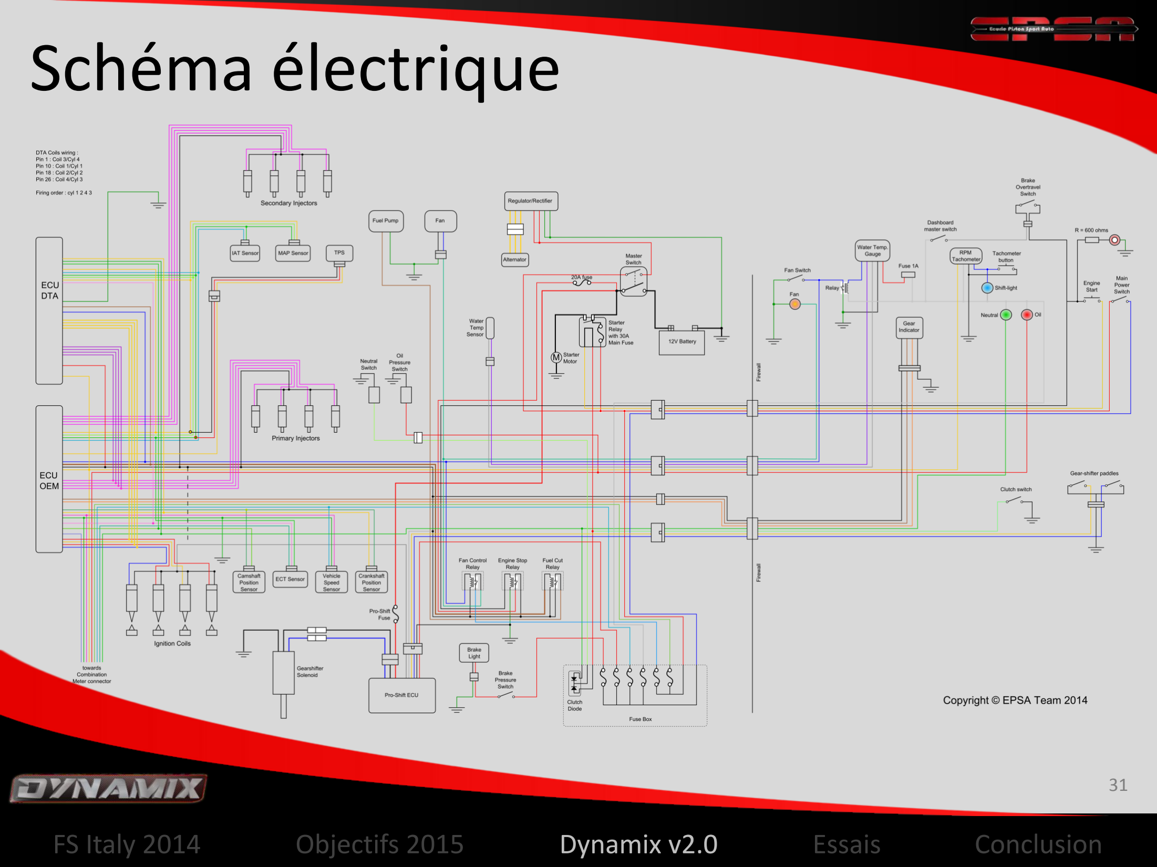
[picture p145: page 31]

31

# Calculateur DTA : travail restant

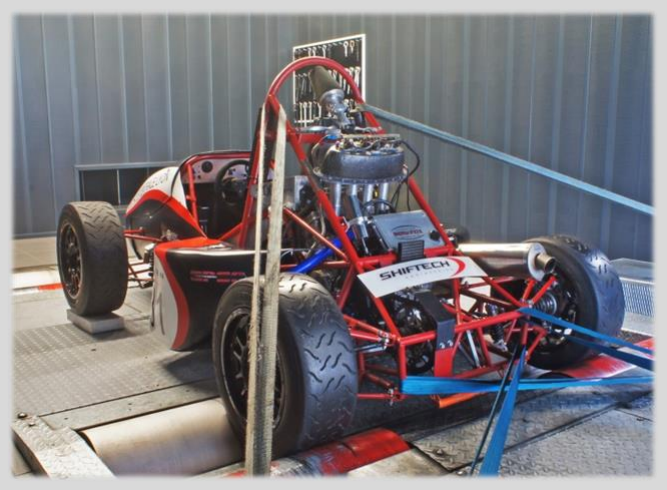
[picture p146: figure]

## - Installation d’une sonde lambda

– Faciliter la mise au point

## - Mise au point sur banc de puissance

## - Gestion des coupures d’allumage

– Coupures moins brutales
– Minimiser le temps de passage

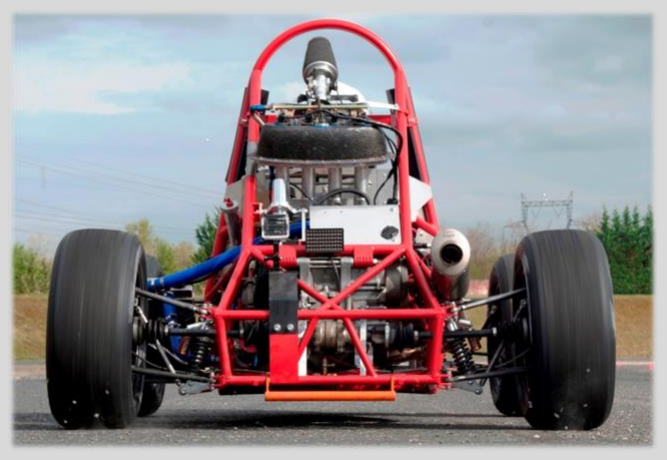
[picture p147: figure]

## - Installation d’un capteur vitesse

– Launch control
– Traction control

32

# Autres modifications

## - Retirer la bande thermique sur l’échappement

## - Protéger la batterie

## - Augmenter la course de pédale de frein

## - Remplacer les chapes de direction

## - Supprimer la rampe d’injection secondaire

## - Passer le kit chaine en 520

33

# Autres modifications

## - Coller et caler du porte-couronne sur le différentiel

## - Changer les disques d’embrayage si nécessaire

## - Changer le ressort d’embrayage

## - Remplacer la plaque pare-chaîne

## - Combler l’espace entre la carrosserie et le fond plat

## - Protéger le réservoir de la chaleur

## - Ajuster le bump-steer

34

# Les essais

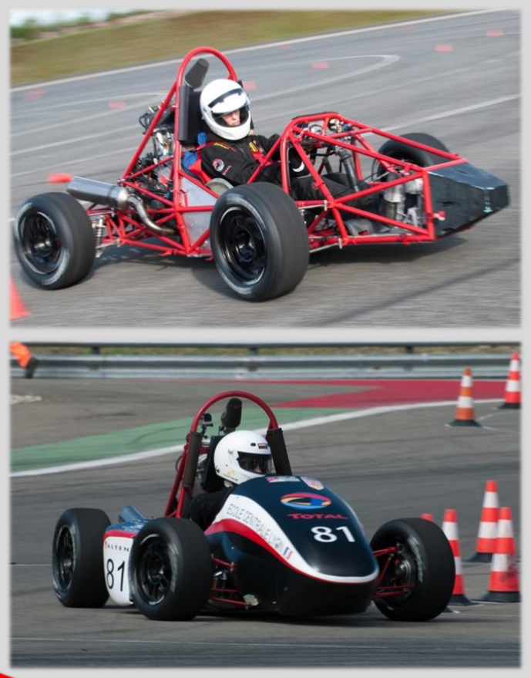
[picture p148: figure]

## - Choix des pilotes

## - Autocross/endurance

– Répartition de freinage
– Suspensions (ressorts)
– Pressions, géométrie et amortissement – Traction control

## - Skid-pad

– Géométrie et pressions

## - Accélération

– Launch control

35

Essais

# Conclusion

36

Conclusion
