EOSCogniton/STUF2019/DS_Design Report/gluing_process_summary.xlsx

Test | Carbon-alu | alu-alu
1 | 22 | 15.79 | 15
2 | 17.8 | 16.11 | 15
3 | 21 | 16.16 | 15
4 | 20.9 | 15.55 | 15
5 | 16.9 | 16.28 | 15
6 | 21.2 | 15.76 | 15
7 | 19.6 | 16.50 | 15
8 | 18.7 | 15.50 | 15
9 | 21.8 | 16.21 | 15
10 | 20.3 | 15.83 | 15
 | Carbon-alu | Alu-alu
Standard deviation | 1.73 | 0.33
Mean | 20.02 | 15.97
Min | 16.9 | 15.50
Max | 22 | 16.50
Confidence interval (99%) | 4.45 | 0.85
Min of confidence interval | 15.57 | 15.12
