EOSCogniton/STUF2019/BR - Brake System/Architecture disques test/Disque_architecture2_parametres.xls

Rayon_exterieur (mm) | Rayon_interieur (mm) | epaisseur (mm) | rayon_trous1 (mm) | distance_trous1_a_l_axe (mm) | nombre_trous | angle_entre_trous (deg) | distance_trous2_a_l_axe (mm) | rayon_trous2 (mm) | `angle_trou2/1` (deg)
95 | 70 | 5 | 2.5 | 77 | 40 | 18 | 88 | 3.5 | 0
