EOSCogniton/STUF2019/BR - Brake System/Architecture disques test/Disque_architecture3_parametres.xls

rayon_int (mm) | rayon_ext (mm) | epaisseur (mm) | nombre_trous | angle_entre_trous (deg) | longueur_rectangle (mm) | largeur_rectangle (mm) | distance_point_interieur (mm) | distance_point_exterieur (mm)
70 | 95 | 5 | 18 | 20 | 20 | 6 | 76 | 85
