EOSCogniton/STUF2019/SU - Suspension/05 - Essais/Excels essais Optimus/collage alu carbone 05_02_19/collage1.is_tens_RawData/Specimen_RawData_1.csv

Temps | Déplacement | Charge
(sec) | (mm) | (N)
0,00000 | 0,01279 | 42,60442
0,02000 | 0,01279 | 42,41308
0,04000 | 0,01315 | 42,68252
0,06000 | 0,01381 | 43,64529
0,08000 | 0,01489 | 46,68908
0,10000 | 0,01638 | 52,07396
0,12000 | 0,01812 | 58,73318
0,14000 | 0,01991 | 66,33854
0,16000 | 0,02182 | 73,84695
0,18000 | 0,02374 | 81,32894
0,20000 | 0,02559 | 89,41145
0,22000 | 0,02756 | 97,23461
0,24000 | 0,02948 | 105,66189
0,26000 | 0,03145 | 113,61573
0,28000 | 0,03336 | 121,79145
0,30000 | 0,03528 | 130,21516
0,32000 | 0,03707 | 137,93336
0,34000 | 0,03892 | 145,65680
0,36000 | 0,04078 | 153,51651
0,38000 | 0,04251 | 161,33265
0,40000 | 0,04436 | 168,67896
0,42000 | 0,04604 | 176,13373
0,44000 | 0,04777 | 182,78648
0,46000 | 0,04957 | 190,00072
0,48000 | 0,05124 | 197,35247
0,50000 | 0,05297 | 204,24118
0,52000 | 0,05477 | 210,43171
0,54000 | 0,05638 | 216,90794
0,56000 | 0,05812 | 222,69115
0,58000 | 0,05985 | 228,53082
0,60000 | 0,06152 | 234,09757
0,62000 | 0,06326 | 239,97426
0,64000 | 0,06493 | 246,15489
0,66000 | 0,06655 | 251,98432
0,68000 | 0,06822 | 257,54650
0,70000 | 0,06989 | 263,06037
0,72000 | 0,07157 | 269,24999
0,74000 | 0,07324 | 275,16715
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
