EOSCogniton/STUF2019/SU - Suspension/05 - Essais/Excels essais Optimus/collage alu carbone 05_02_19/collage10.is_tens_RawData/Specimen_RawData_1.csv

Temps | Déplacement | Charge
(sec) | (mm) | (N)
0,00000 | -0,00717 | 19,68247
0,02000 | -0,00717 | 19,60386
0,04000 | -0,00688 | 19,38537
0,06000 | -0,00646 | 19,13569
0,08000 | -0,00556 | 20,23985
0,10000 | -0,00430 | 21,74727
0,12000 | -0,00281 | 23,89332
0,14000 | -0,00120 | 26,77146
0,16000 | 0,00060 | 29,52988
0,18000 | 0,00233 | 32,28089
0,20000 | 0,00413 | 35,22966
0,22000 | 0,00598 | 37,67348
0,24000 | 0,00783 | 40,30515
0,26000 | 0,00969 | 42,63715
0,28000 | 0,01154 | 45,33454
0,30000 | 0,01327 | 48,39356
0,32000 | 0,01519 | 51,07789
0,34000 | 0,01698 | 54,24175
0,36000 | 0,01871 | 57,06919
0,38000 | 0,02051 | 58,84573
0,40000 | 0,02230 | 61,65705
0,42000 | 0,02404 | 64,64799
0,44000 | 0,02583 | 67,29994
0,46000 | 0,02762 | 69,86333
0,48000 | 0,02936 | 71,85048
0,50000 | 0,03109 | 73,37673
0,52000 | 0,03276 | 74,35982
0,54000 | 0,03438 | 75,29134
0,56000 | 0,03611 | 76,48041
0,58000 | 0,03779 | 77,98087
0,60000 | 0,03946 | 78,73955
0,62000 | 0,04119 | 79,83475
0,64000 | 0,04287 | 80,54502
0,66000 | 0,04448 | 80,86746
0,68000 | 0,04610 | 81,65069
0,70000 | 0,04783 | 84,15048
0,72000 | 0,04951 | 88,72637
0,74000 | 0,05124 | 94,79533
0,76000 | 0,05291 | 101,60885
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
