EOSCogniton/STUF2019/SU - Suspension/05 - Essais/Excels essais Optimus/collage alu carbone 05_02_19/collage2.is_tens_RawData/Specimen_RawData_1.csv

Temps | Déplacement | Charge
(sec) | (mm) | (N)
0,00000 | -0,12640 | 43,49116
0,02000 | -0,12634 | 43,72182
0,04000 | -0,12592 | 43,86879
0,06000 | -0,12508 | 44,43121
0,08000 | -0,12382 | 47,72495
0,10000 | -0,12233 | 53,99386
0,12000 | -0,12072 | 60,61695
0,14000 | -0,11904 | 67,77174
0,16000 | -0,11713 | 75,85587
0,18000 | -0,11515 | 84,82349
0,20000 | -0,11318 | 94,36582
0,22000 | -0,11127 | 104,91140
0,24000 | -0,10935 | 113,91668
0,26000 | -0,10750 | 122,45924
0,28000 | -0,10565 | 131,09948
0,30000 | -0,10379 | 139,45826
0,32000 | -0,10194 | 148,30474
0,34000 | -0,10009 | 157,07834
0,36000 | -0,09841 | 164,75880
0,38000 | -0,09662 | 172,45277
0,40000 | -0,09489 | 180,81286
0,42000 | -0,09315 | 188,43793
0,44000 | -0,09136 | 196,70685
0,46000 | -0,08968 | 204,87818
0,48000 | -0,08795 | 212,35601
0,50000 | -0,08622 | 220,16151
0,52000 | -0,08448 | 228,42770
0,54000 | -0,08281 | 236,44690
0,56000 | -0,08107 | 243,60879
0,58000 | -0,07934 | 251,51283
0,60000 | -0,07773 | 259,65380
0,62000 | -0,07605 | 267,41954
0,64000 | -0,07438 | 275,27206
0,66000 | -0,07270 | 283,60386
0,68000 | -0,07103 | 291,78618
0,70000 | -0,06936 | 299,98762
0,72000 | -0,06774 | 308,12067
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
