EOSCogniton/STUF2019/SU - Suspension/05 - Essais/Excels essais Optimus/collage alu carbone 05_02_19/collage3.is_tens_RawData/Specimen_RawData_1.csv

Temps | Déplacement | Charge
(sec) | (mm) | (N)
0,00000 | 0,01453 | 51,66971
0,02000 | 0,01465 | 51,70690
0,04000 | 0,01519 | 51,61333
0,06000 | 0,01620 | 53,56293
0,08000 | 0,01758 | 58,41163
0,10000 | 0,01907 | 65,44904
0,12000 | 0,02075 | 74,21646
0,14000 | 0,02260 | 82,84981
0,16000 | 0,02451 | 92,30099
0,18000 | 0,02643 | 102,10930
0,20000 | 0,02828 | 112,04740
0,22000 | 0,03013 | 121,87891
0,24000 | 0,03205 | 131,87041
0,26000 | 0,03402 | 141,91333
0,28000 | 0,03587 | 150,55165
0,30000 | 0,03773 | 140,92651
0,32000 | 0,03952 | 106,33526
0,34000 | 0,04131 | 80,61260
0,36000 | 0,04317 | 69,82387
0,38000 | 0,04490 | 78,93133
0,40000 | 0,04676 | 92,98602
0,42000 | 0,04849 | 98,07067
0,44000 | 0,05016 | 109,11715
0,46000 | 0,05184 | 117,02921
0,48000 | 0,05357 | 126,20393
0,50000 | 0,05531 | 136,06836
0,52000 | 0,05704 | 145,21881
0,54000 | 0,05877 | 153,89513
0,56000 | 0,06045 | 163,08750
0,58000 | 0,06212 | 170,97258
0,60000 | 0,06386 | 179,40315
0,62000 | 0,06547 | 188,06555
0,64000 | 0,06720 | 196,53323
0,66000 | 0,06888 | 204,28223
0,68000 | 0,07055 | 212,61300
0,70000 | 0,07217 | 220,46100
0,72000 | 0,07384 | 227,94320
0,74000 | 0,07545 | 235,82294
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
