EOSCogniton/STUF2019/SU - Suspension/05 - Essais/Excels essais Optimus/collage alu carbone 05_02_19/collage4.is_tens_RawData/Specimen_RawData_1.csv

Temps | Déplacement | Charge
(sec) | (mm) | (N)
0,00000 | 0,01632 | 53,86533
0,02000 | 0,01638 | 53,31782
0,04000 | 0,01686 | 53,53980
0,06000 | 0,01782 | 55,51504
0,08000 | 0,01907 | 59,78565
0,10000 | 0,02063 | 66,35866
0,12000 | 0,02224 | 73,69378
0,14000 | 0,02410 | 80,37780
0,16000 | 0,02595 | 87,60730
0,18000 | 0,02780 | 95,65377
0,20000 | 0,02972 | 103,39271
0,22000 | 0,03163 | 110,12711
0,24000 | 0,03348 | 117,06789
0,26000 | 0,03540 | 124,03355
0,28000 | 0,03731 | 131,69026
0,30000 | 0,03910 | 138,70100
0,32000 | 0,04096 | 145,93067
0,34000 | 0,04269 | 152,91155
0,36000 | 0,04448 | 159,75056
0,38000 | 0,04622 | 167,27393
0,40000 | 0,04807 | 174,27396
0,42000 | 0,04980 | 164,46413
0,44000 | 0,05148 | 111,99798
0,46000 | 0,05315 | 84,82033
0,48000 | 0,05489 | 91,74685
0,50000 | 0,05662 | 94,34657
0,52000 | 0,05829 | 99,44361
0,54000 | 0,06003 | 110,79282
0,56000 | 0,06176 | 116,95308
0,58000 | 0,06338 | 122,82380
0,60000 | 0,06505 | 133,25516
0,62000 | 0,06678 | 138,28772
0,64000 | 0,06846 | 143,42200
0,66000 | 0,07013 | 153,40174
0,68000 | 0,07181 | 158,79093
0,70000 | 0,07348 | 164,37961
0,72000 | 0,07510 | 173,29366
0,74000 | 0,07677 | 178,75963
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
