EOSCogniton/STUF2019/SU - Suspension/05 - Essais/Excels essais Optimus/collage alu carbone 05_02_19/collage5.is_tens_RawData/Specimen_RawData_1.csv

Temps | Déplacement | Charge
(sec) | (mm) | (N)
0,00000 | 0,06912 | 22,57089
0,02000 | 0,06906 | 22,31019
0,04000 | 0,06942 | 21,62834
0,06000 | 0,06983 | 21,51854
0,08000 | 0,07067 | 22,48912
0,10000 | 0,07199 | 24,80395
0,12000 | 0,07348 | 27,90793
0,14000 | 0,07516 | 32,01223
0,16000 | 0,07689 | 36,41793
0,18000 | 0,07868 | 40,45934
0,20000 | 0,08048 | 43,78694
0,22000 | 0,08233 | 46,50540
0,24000 | 0,08418 | 49,58399
0,26000 | 0,08604 | 52,90471
0,28000 | 0,08789 | 55,73222
0,30000 | 0,08974 | 57,99810
0,32000 | 0,09154 | 60,29592
0,34000 | 0,09339 | 63,48524
0,36000 | 0,09513 | 65,65641
0,38000 | 0,09692 | 68,36660
0,40000 | 0,09871 | 71,24247
0,42000 | 0,10045 | 74,51745
0,44000 | 0,10212 | 78,10474
0,46000 | 0,10385 | 80,90445
0,48000 | 0,10559 | 83,64232
0,50000 | 0,10732 | 86,62636
0,52000 | 0,10900 | 89,27869
0,54000 | 0,11073 | 92,90508
0,56000 | 0,11234 | 96,90063
0,58000 | 0,11402 | 100,37782
0,60000 | 0,11575 | 103,83513
0,62000 | 0,11749 | 105,93374
0,64000 | 0,11916 | 109,26437
0,66000 | 0,12083 | 113,71812
0,68000 | 0,12251 | 117,63958
0,70000 | 0,12412 | 121,60897
0,72000 | 0,12580 | 124,54547
0,74000 | 0,12747 | 128,16361
0,76000 | 0,12915 | 132,46184
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
