EOSCogniton/STUF2019/SU - Suspension/05 - Essais/Excels essais Optimus/collage alu carbone 05_02_19/collage6.is_tens_RawData/Specimen_RawData_1.csv

Temps | Déplacement | Charge
(sec) | (mm) | (N)
0,00000 | 0,12257 | 22,21945
0,02000 | 0,12251 | 22,23994
0,04000 | 0,12287 | 21,04852
0,06000 | 0,12323 | 20,93147
0,08000 | 0,12400 | 22,20292
0,10000 | 0,12520 | 24,52704
0,12000 | 0,12669 | 27,63483
0,14000 | 0,12831 | 31,50123
0,16000 | 0,13010 | 34,54120
0,18000 | 0,13190 | 38,01996
0,20000 | 0,13375 | 42,77783
0,22000 | 0,13560 | 47,97415
0,24000 | 0,13752 | 52,55836
0,26000 | 0,13937 | 57,64775
0,28000 | 0,14116 | 63,14702
0,30000 | 0,14302 | 68,53358
0,32000 | 0,14487 | 74,03846
0,34000 | 0,14666 | 80,08533
0,36000 | 0,14846 | 85,71649
0,38000 | 0,15019 | 91,29532
0,40000 | 0,15198 | 96,99963
0,42000 | 0,15372 | 103,19491
0,44000 | 0,15545 | 109,01549
0,46000 | 0,15713 | 115,17565
0,48000 | 0,15886 | 120,92980
0,50000 | 0,16053 | 127,00356
0,52000 | 0,16227 | 133,22267
0,54000 | 0,16394 | 139,41412
0,56000 | 0,16568 | 145,20228
0,58000 | 0,16735 | 151,38267
0,60000 | 0,16902 | 157,46878
0,62000 | 0,17070 | 163,24652
0,64000 | 0,17237 | 169,22260
0,66000 | 0,17411 | 175,53197
0,68000 | 0,17584 | 181,68727
0,70000 | 0,17746 | 188,25395
0,72000 | 0,17907 | 194,96232
0,74000 | 0,18068 | 201,01569
0,76000 | 0,18248 | 207,17315
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
