EOSCogniton/STUF2019/DE - Devis/Générale/Devis, Bons C et L EPSA/55692804_1184239155090930_4121867649976107008_n(1).jpg

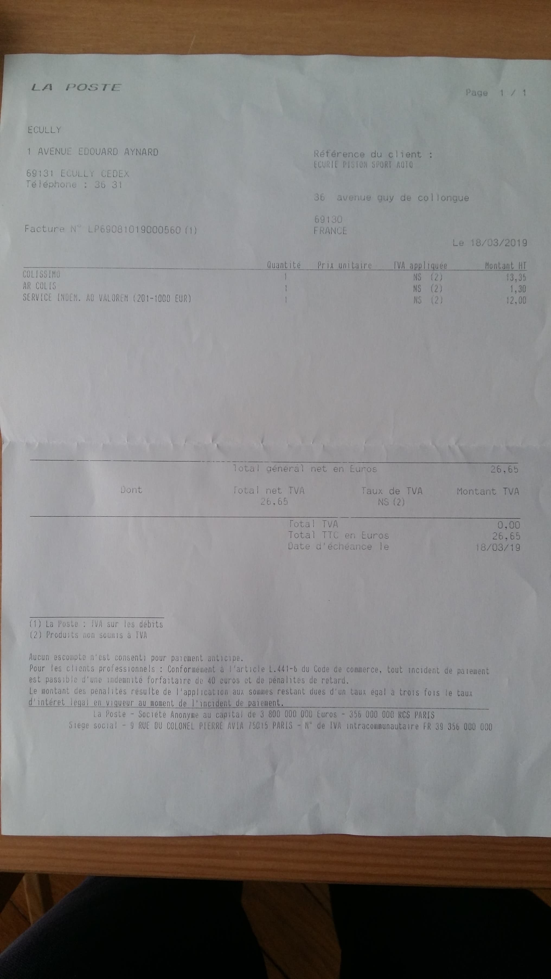
DE - Devis/Générale/Devis, Bons C et L EPSA/55692804_1184239155090930_4121867649976107008_n(1).jpg
