EOSCogniton/STUF2019/DE - Devis/Générale/Devis, Bons C et L EPSA/commande Maxime Ebay.jpg

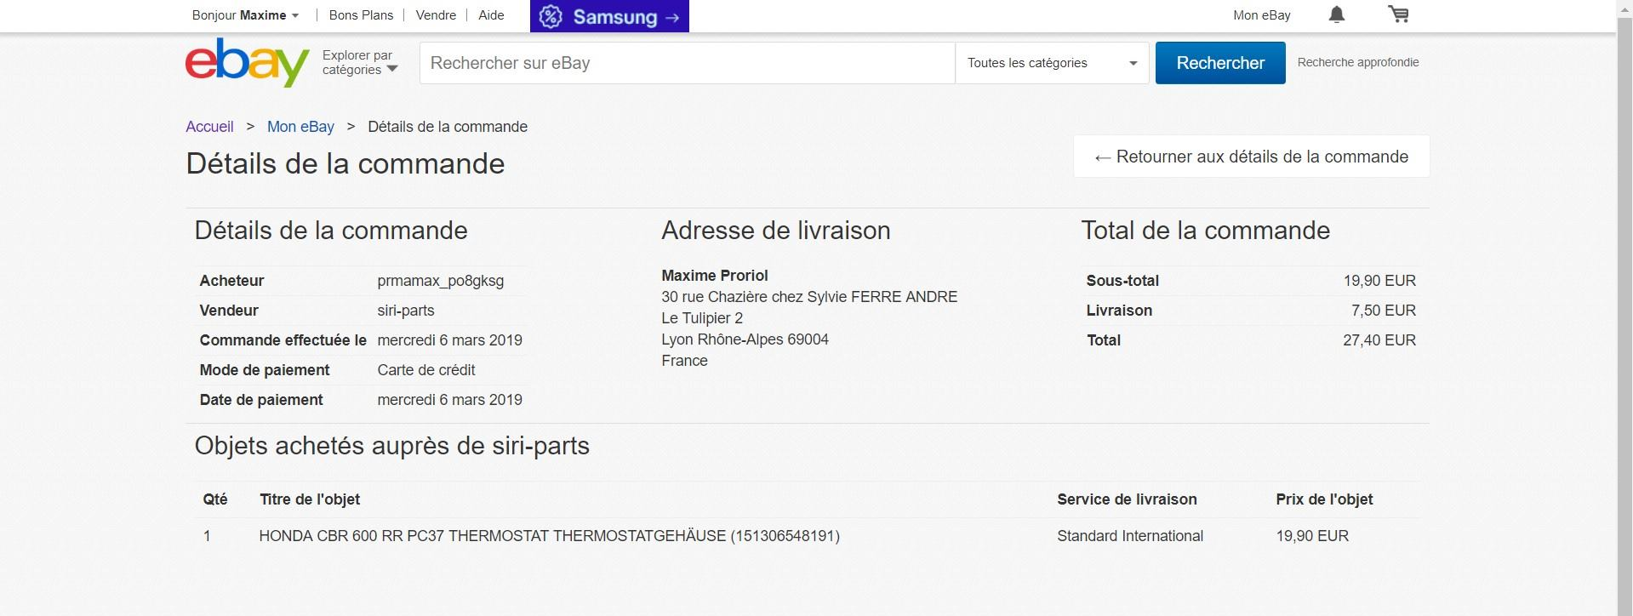
DE - Devis/Générale/Devis, Bons C et L EPSA/commande Maxime Ebay.jpg
