EOSCogniton/STUF2019/DE - Devis/Générale/Devis, Bons C et L EPSA/IMG_20190407_154733.jpg

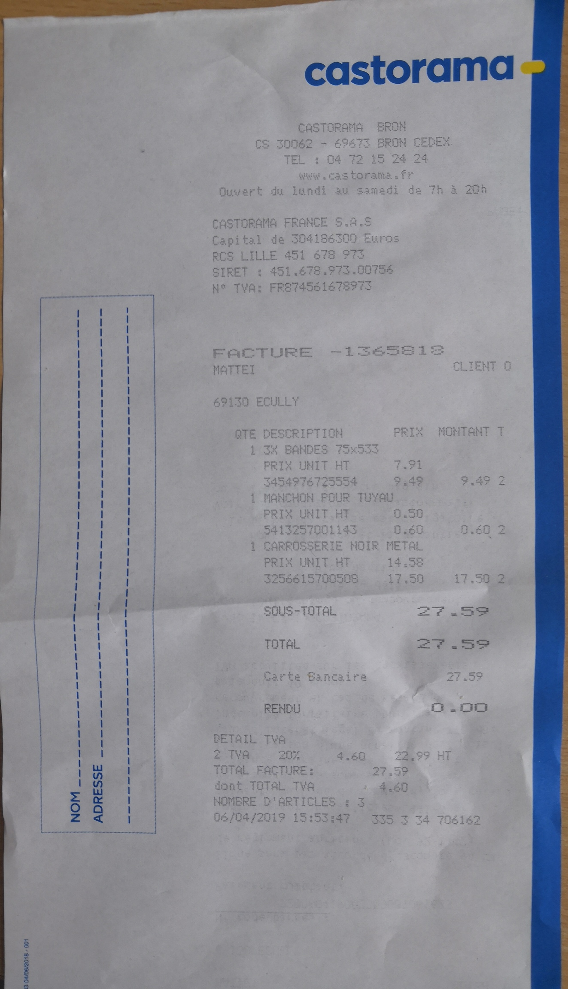
DE - Devis/Générale/Devis, Bons C et L EPSA/IMG_20190407_154733.jpg
