EOSCogniton/STUF2019/DS_Design Report/03_Ressources/2015_Design_Dynamix/Documents disponibles/pedalier_ergonomie.jpg

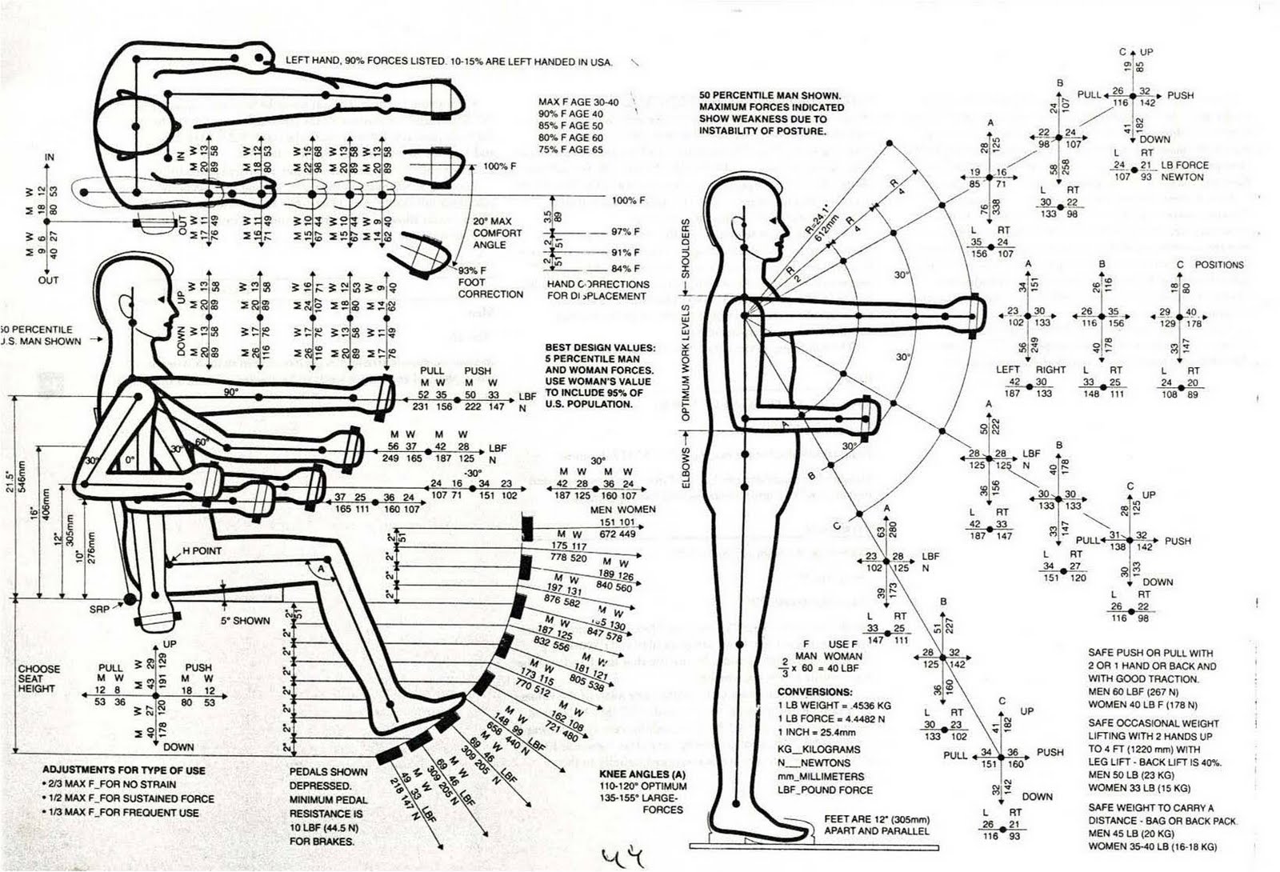
DS_Design Report/03_Ressources/2015_Design_Dynamix/Documents disponibles/pedalier_ergonomie.jpg
