EOSCogniton/STUF2019/DS_Design Report/03_Ressources/2015_Design_Dynamix/Documents disponibles/pedalier_geogebra.jpg

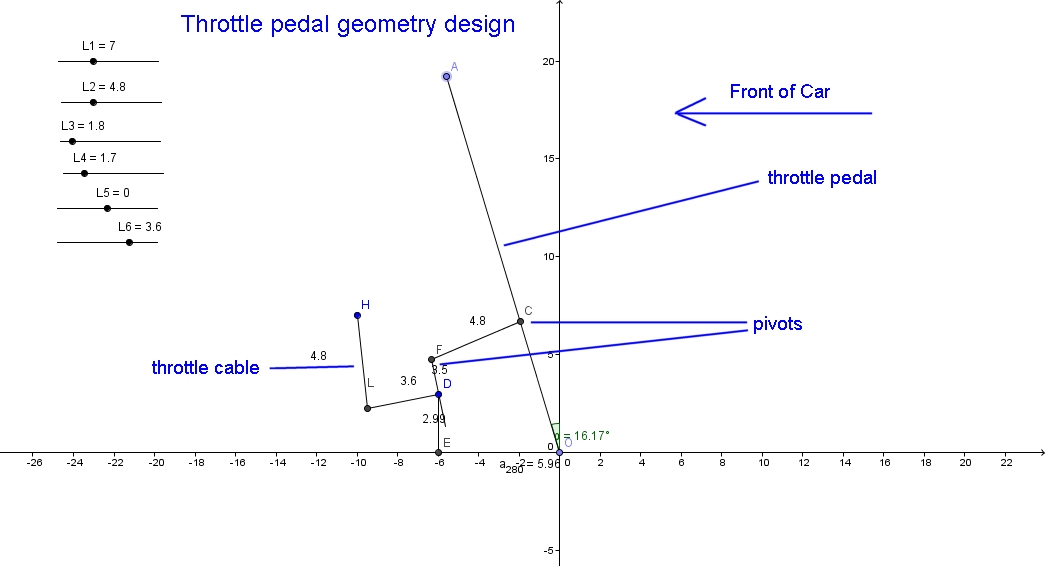
DS_Design Report/03_Ressources/2015_Design_Dynamix/Documents disponibles/pedalier_geogebra.jpg
