EOSCogniton/STUF2019/EL - Electrical/Autre/Carte avant/CANDIY shield/canvas.png

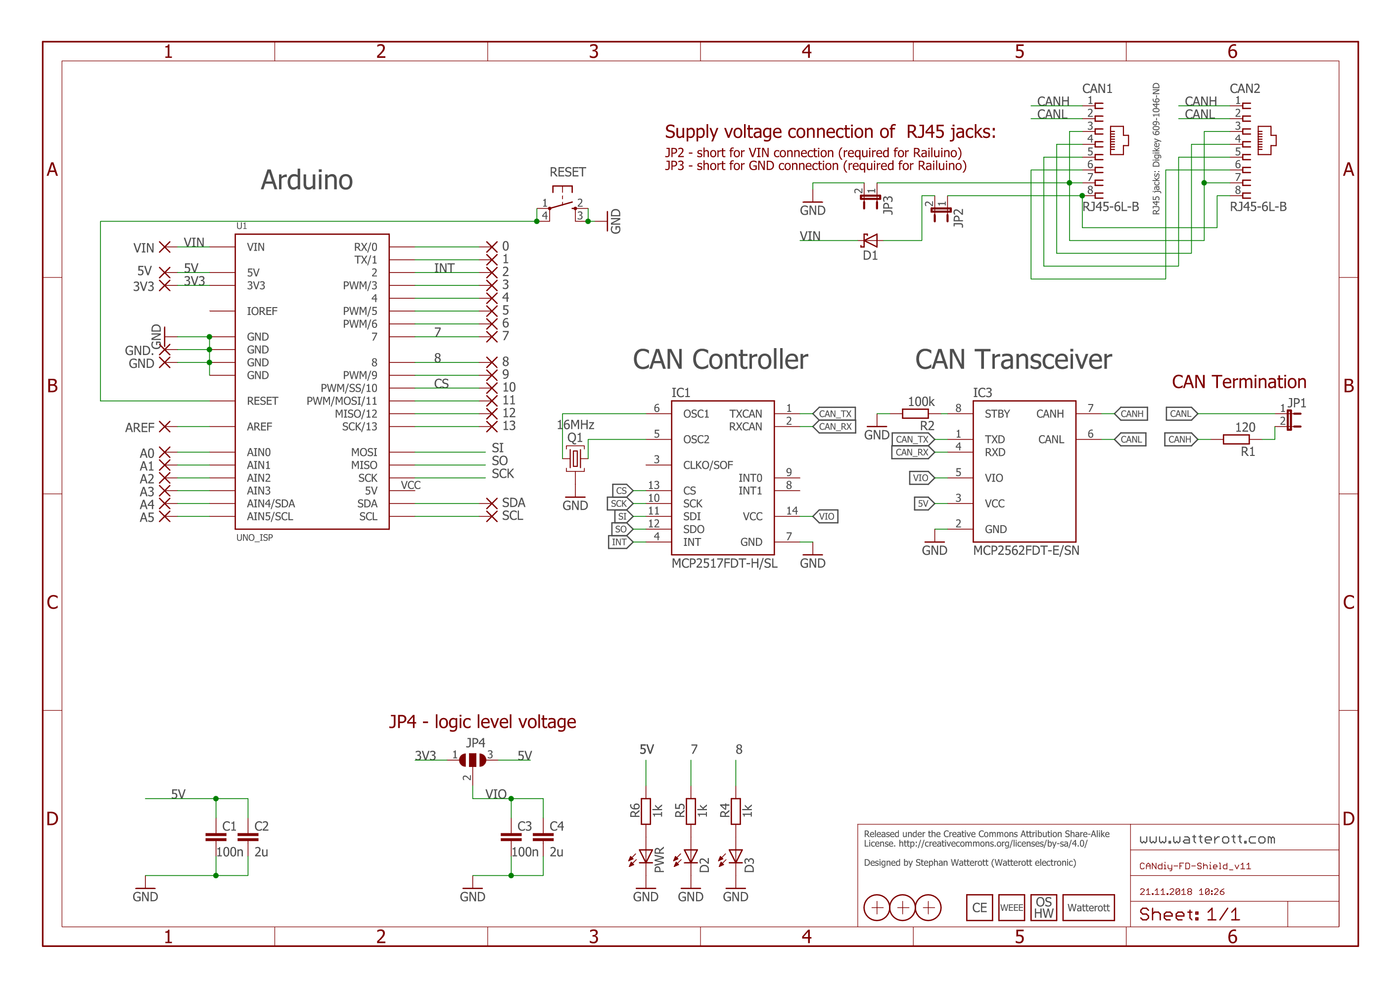
EL - Electrical/Autre/Carte avant/CANDIY shield/canvas.png
