EOSCogniton/STUF2019/EL - Electrical/Autre/Faisceau/Architecture faisceau.png

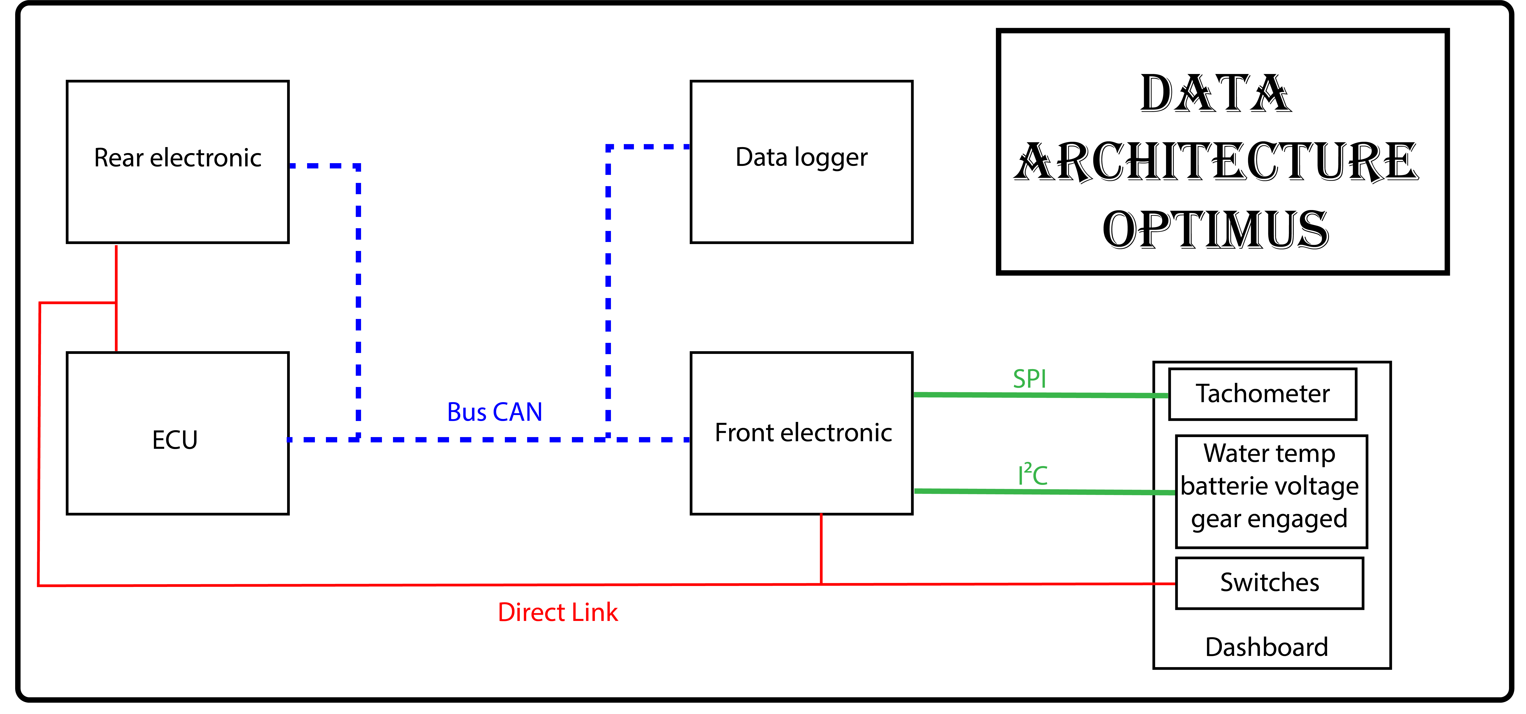
EL - Electrical/Autre/Faisceau/Architecture faisceau.png
