EOSCogniton/STUF2019/EL - Electrical/Autre/Faisceau/Justif_cable.JPG

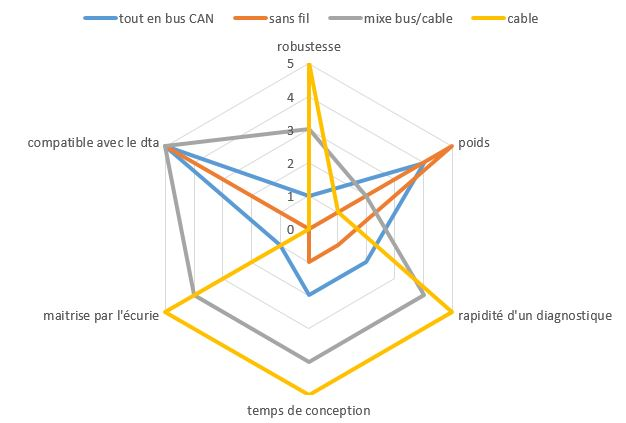
EL - Electrical/Autre/Faisceau/Justif_cable.JPG
