EOSCogniton/STUF2019/EL - Electrical/Autre/Faisceau/Rapid harness/images/8STA0435.JPG

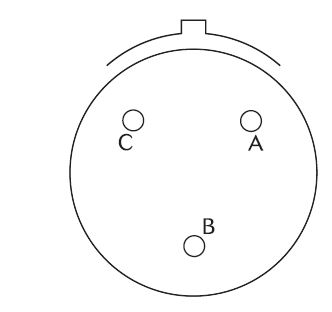
EL - Electrical/Autre/Faisceau/Rapid harness/images/8STA0435.JPG
