EOSCogniton/STUF2019/EL - Electrical/Autre/Faisceau/Rapid harness/images/8STA0635.JPG

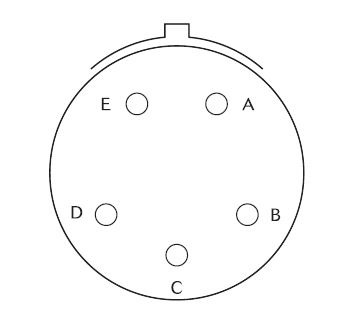
EL - Electrical/Autre/Faisceau/Rapid harness/images/8STA0635.JPG
