EOSCogniton/STUF2019/EL - Electrical/Autre/Faisceau/Rapid harness/images/8STA1497.JPG

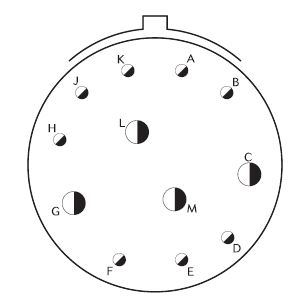
EL - Electrical/Autre/Faisceau/Rapid harness/images/8STA1497.JPG
