EOSCogniton/STUF2019/EL - Electrical/Autre/Faisceau/Rapid harness/images/Connecteur MK3.jpg

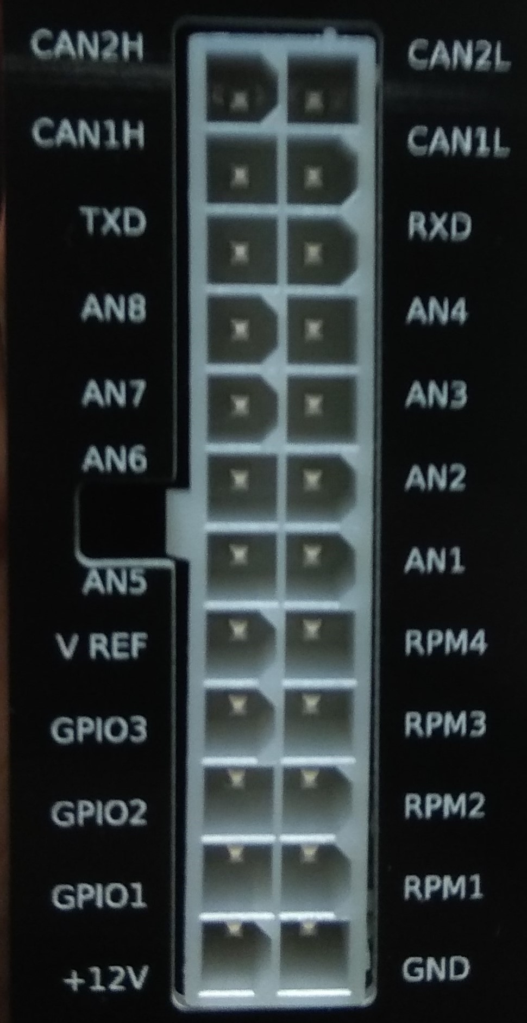
EL - Electrical/Autre/Faisceau/Rapid harness/images/Connecteur MK3.jpg
