EOSCogniton/STUF2019/EL - Electrical/Autre/Faisceau/Top View.png

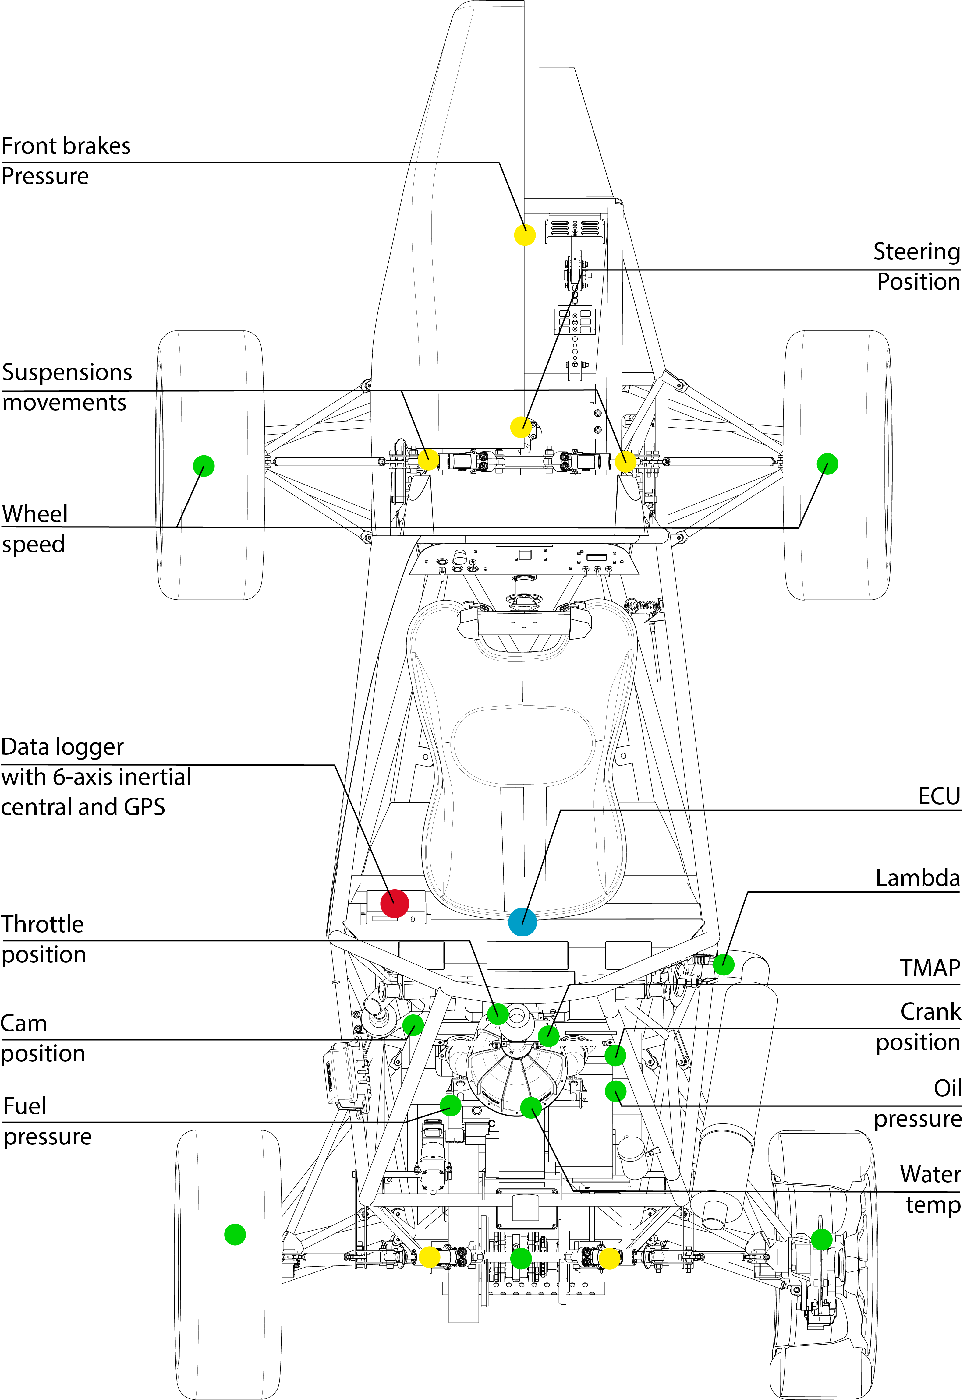
EL - Electrical/Autre/Faisceau/Top View.png
