EOSCogniton/STUF2019/EL - Electrical/Autre/Masterswitch/Annotation 2019-03-13 222522.png

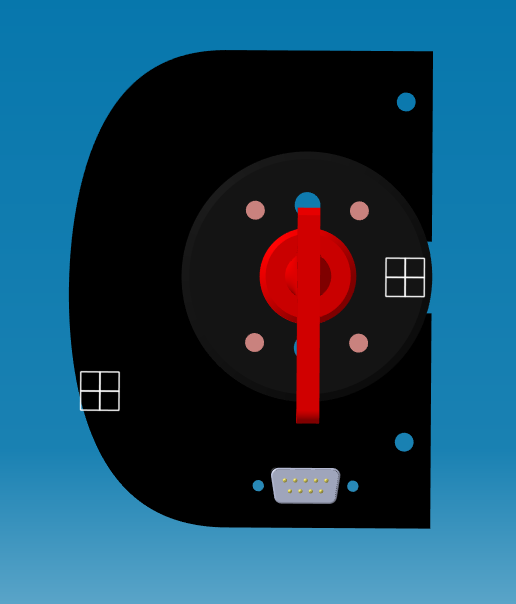
EL - Electrical/Autre/Masterswitch/Annotation 2019-03-13 222522.png
