EOSCogniton/STUF2019/EL - Electrical/Autre/Tableau de bord/Tableau Optimus/graphisme/graphisme.png

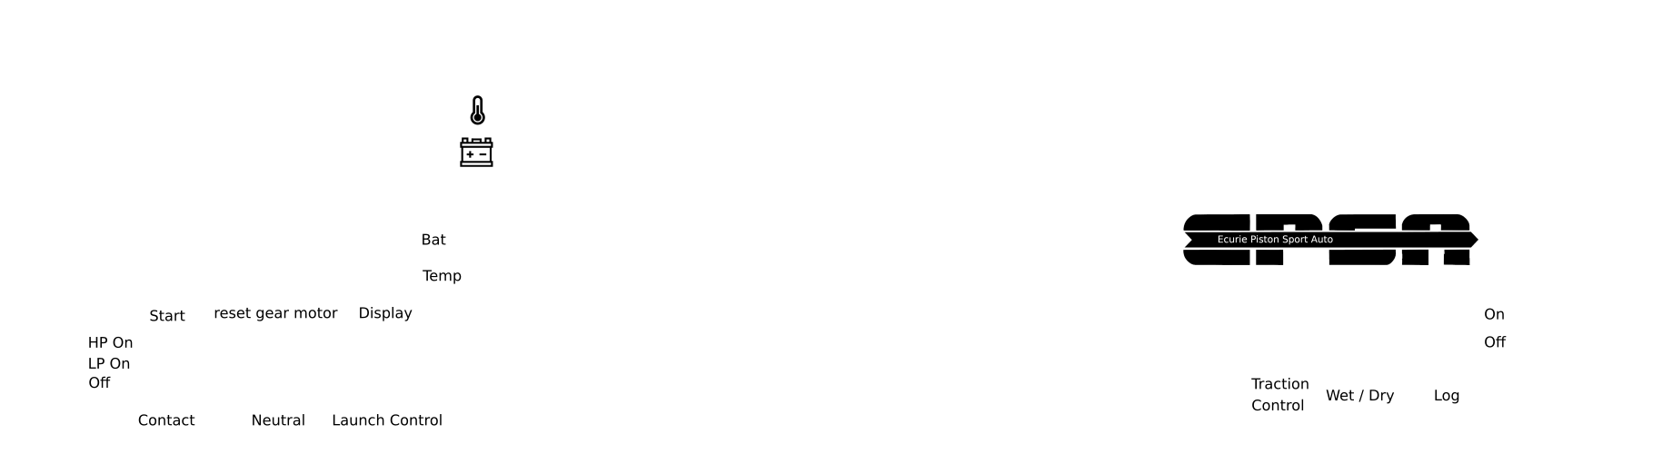
EL - Electrical/Autre/Tableau de bord/Tableau Optimus/graphisme/graphisme.png
