EOSCogniton/STUF2019/EL - Electrical/Autre/Tableau de bord/Tableau Optimus/graphisme/Ressources/battery.png

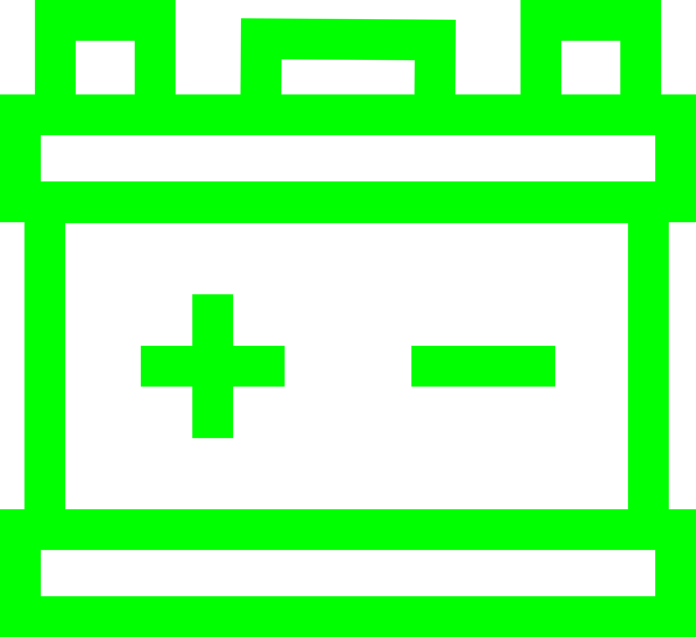
EL - Electrical/Autre/Tableau de bord/Tableau Optimus/graphisme/Ressources/battery.png
