EOSCogniton/STUF2019/EL - Electrical/Autre/Tableau de bord/Tableau Optimus/graphisme/serigraphie seule.png

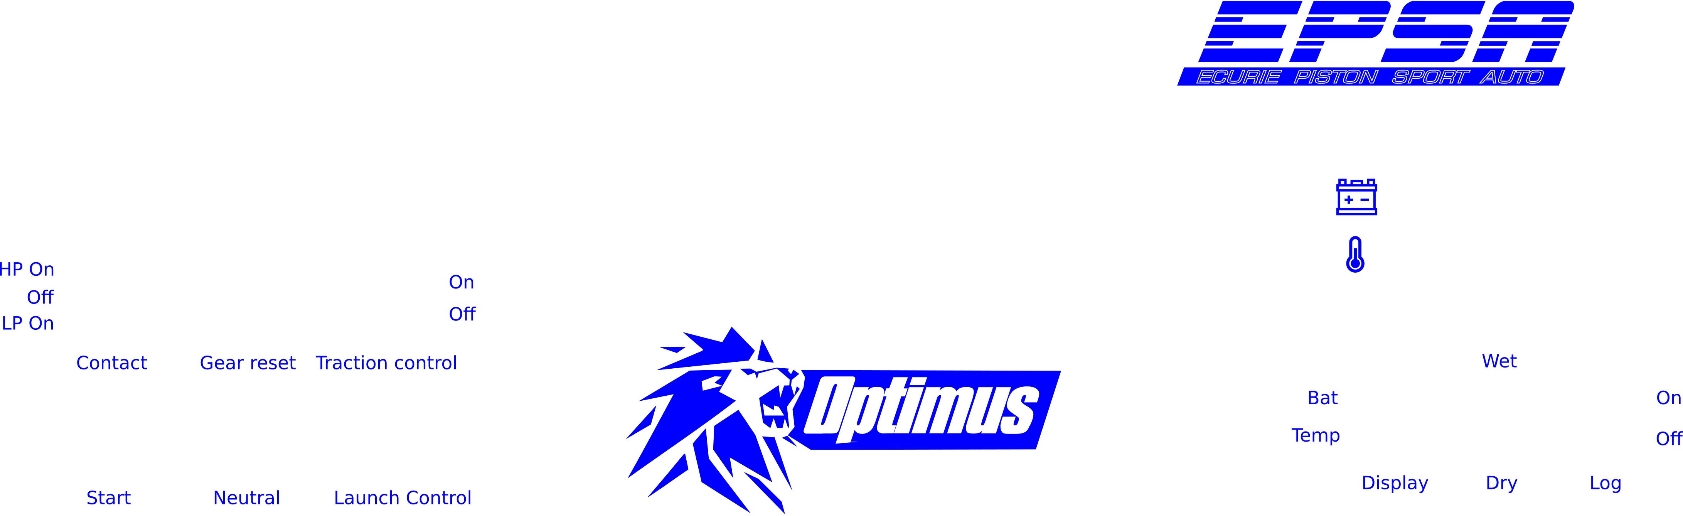
EL - Electrical/Autre/Tableau de bord/Tableau Optimus/graphisme/serigraphie seule.png
