EOSCogniton/STUF2019/EL - Electrical/Autre/Tableau de bord/Tableau Optimus/graphisme/Sérigraphies kiCAD/diapov1.png

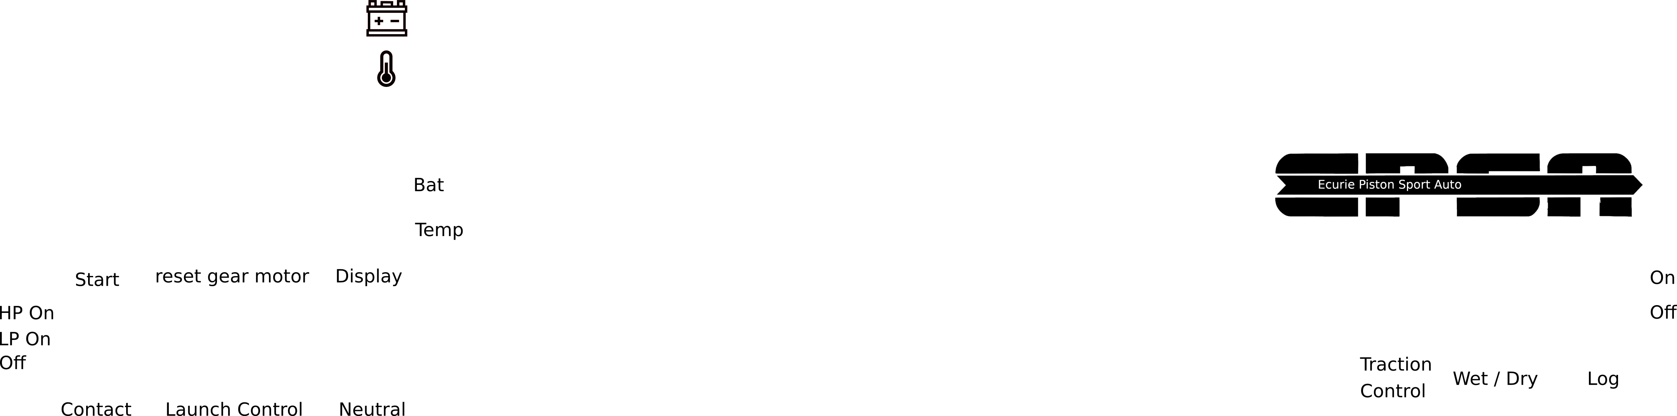
EL - Electrical/Autre/Tableau de bord/Tableau Optimus/graphisme/Sérigraphies kiCAD/diapov1.png
