EOSCogniton/STUF2019/EL - Electrical/Autre/Tableau de bord/Tableau Optimus/graphisme/Sérigraphies kiCAD/imagegraphismeechellecorrigee.png

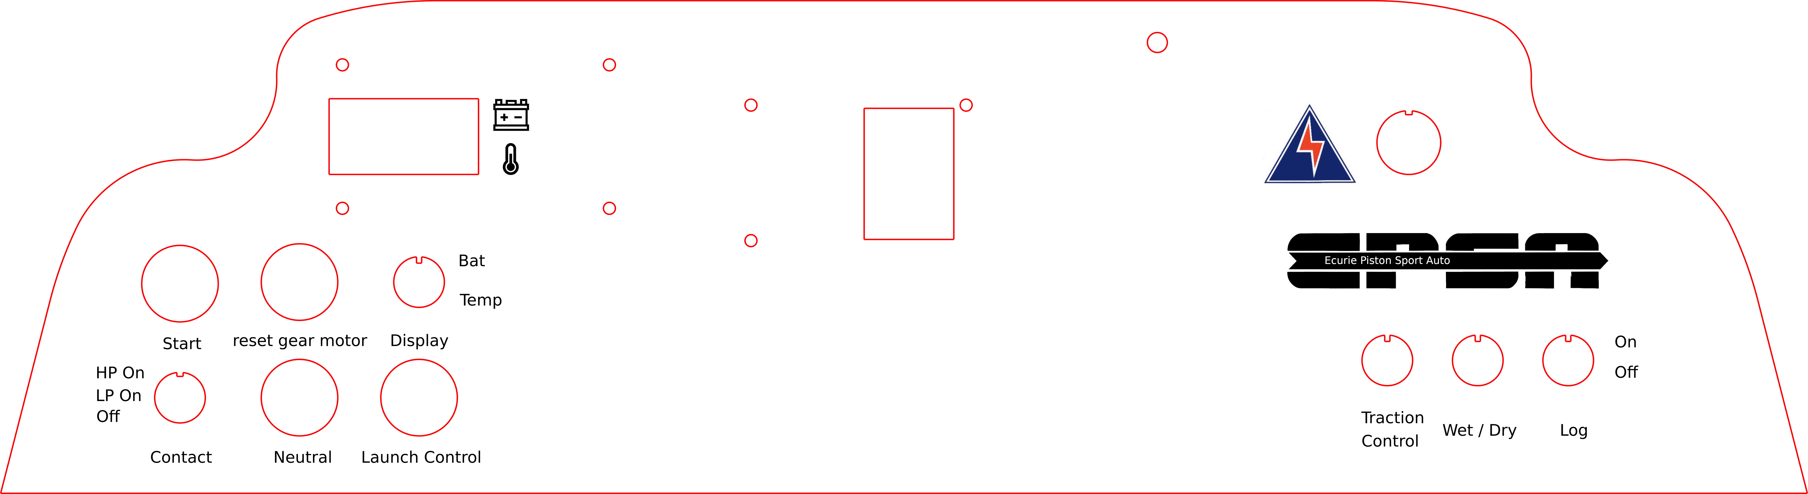
EL - Electrical/Autre/Tableau de bord/Tableau Optimus/graphisme/Sérigraphies kiCAD/imagegraphismeechellecorrigee.png
