EOSCogniton/STUF2019/EL - Electrical/Autre/Tableau de bord/Tableau Optimus/graphisme/Sérigraphies kiCAD/rendu TdB.jpg

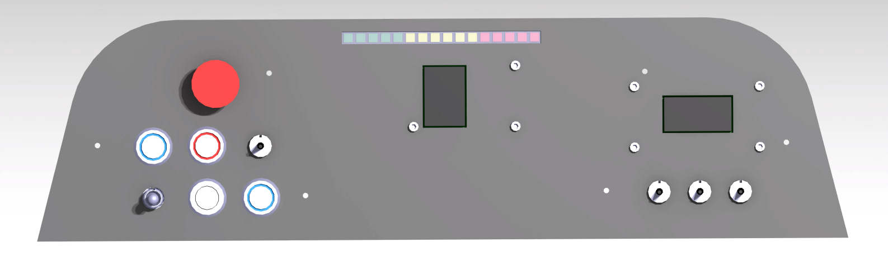
EL - Electrical/Autre/Tableau de bord/Tableau Optimus/graphisme/Sérigraphies kiCAD/rendu TdB.jpg
