EOSCogniton/STUF2019/EL - Electrical/Autre/Tableau de bord/Tableau Optimus/graphisme/Sérigraphies kiCAD/rendutdbv2.jpg

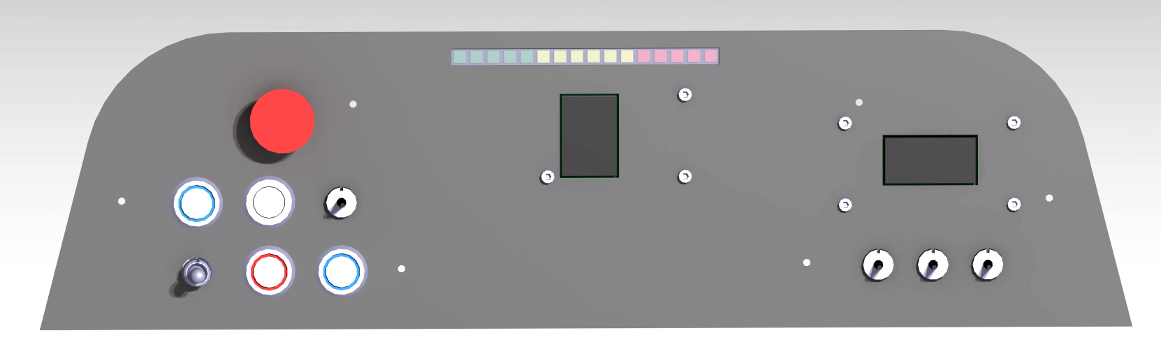
EL - Electrical/Autre/Tableau de bord/Tableau Optimus/graphisme/Sérigraphies kiCAD/rendutdbv2.jpg
