EOSCogniton/STUF2019/EL - Electrical/Autre/Tableau de bord/Tableau Optimus/Rendus TdB/rendu TdBnovembre.jpg

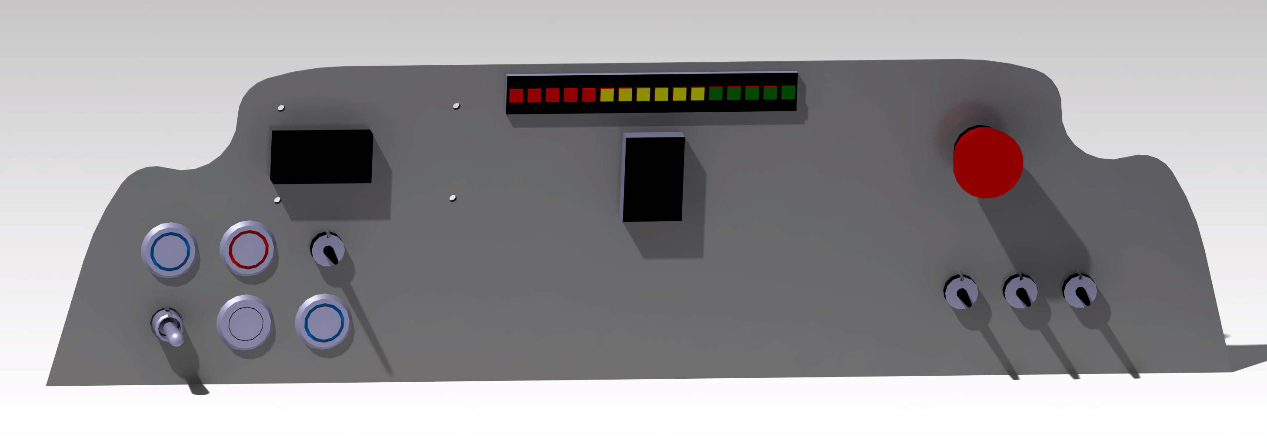
EL - Electrical/Autre/Tableau de bord/Tableau Optimus/Rendus TdB/rendu TdBnovembre.jpg
