EOSCogniton/STUF2019/EL - Electrical/Autre/Tableau de bord/Tableau Optimus/Rendus TdB/Rendu_TdB_arriere_v1.jpg

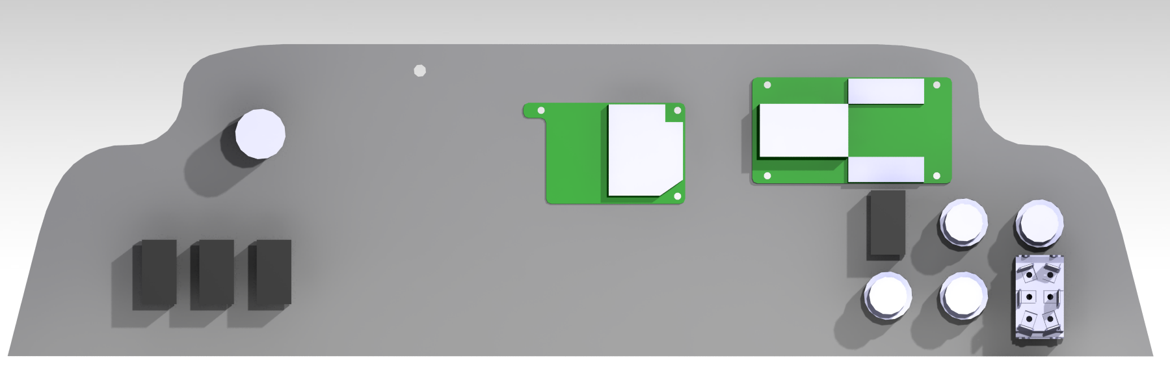
EL - Electrical/Autre/Tableau de bord/Tableau Optimus/Rendus TdB/Rendu_TdB_arriere_v1.jpg
