EOSCogniton/STUF2019/EL - Electrical/Autre/Tableau de bord/Tableau Optimus/Rendus TdB/Rendu_TdB_v5.png

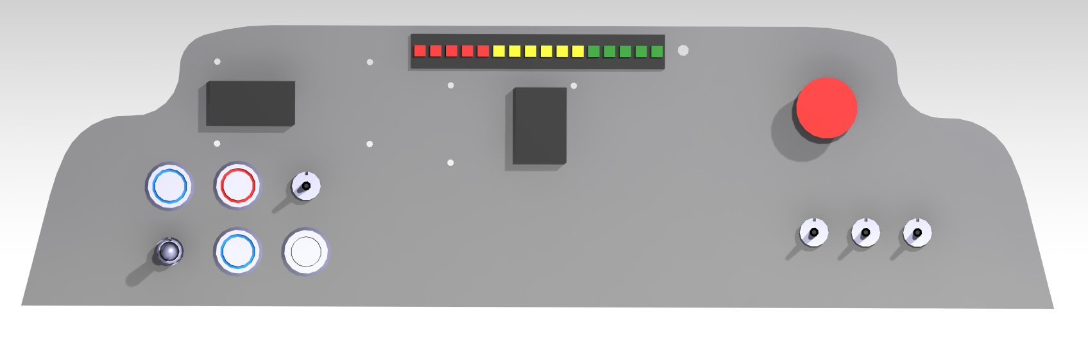
EL - Electrical/Autre/Tableau de bord/Tableau Optimus/Rendus TdB/Rendu_TdB_v5.png
