EOSCogniton/STUF2019/EL - Electrical/Autre/Tableau de bord/Tableau Optimus/Rendus TdB/tdbrendu2v6.jpg

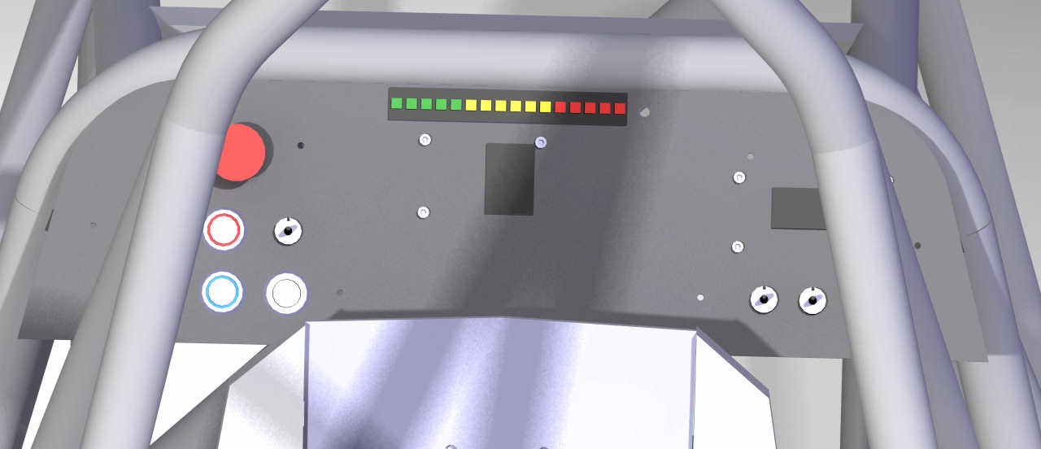
EL - Electrical/Autre/Tableau de bord/Tableau Optimus/Rendus TdB/tdbrendu2v6.jpg
