EOSCogniton/STUF2019/EL - Electrical/Autre/Tableau de bord/Tableau Optimus/Rendus TdB/tdbrendu3v6.jpg

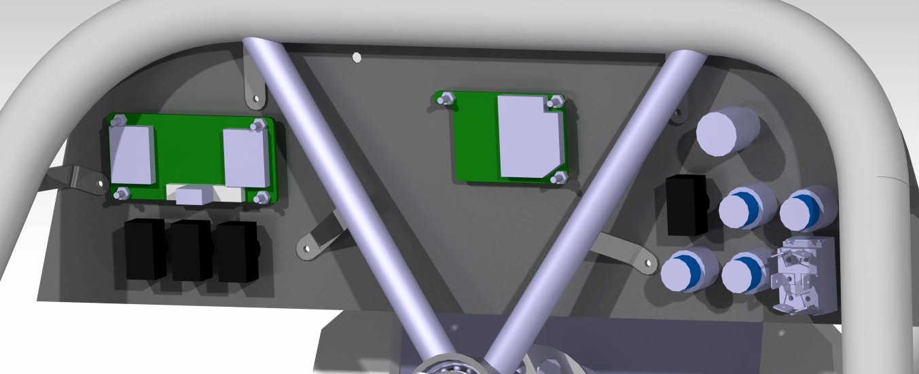
EL - Electrical/Autre/Tableau de bord/Tableau Optimus/Rendus TdB/tdbrendu3v6.jpg
