EOSCogniton/STUF2019/EL - Electrical/Autre/Tableau de bord/Tableau vulcanix/Découpe laser/écriture.jpg

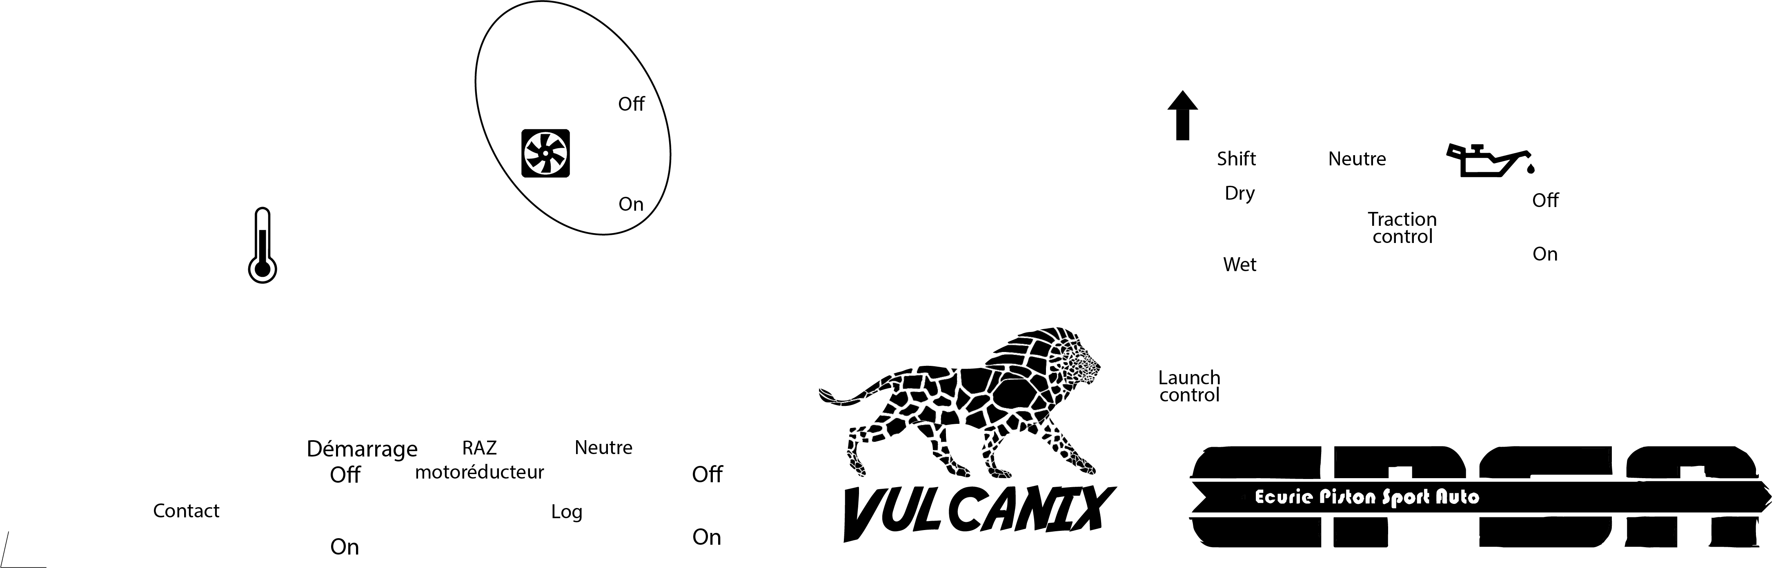
EL - Electrical/Autre/Tableau de bord/Tableau vulcanix/Découpe laser/écriture.jpg
