EOSCogniton/STUF2019/EL - Electrical/Autre/Tableau de bord/Tableau vulcanix/tdb final.PNG

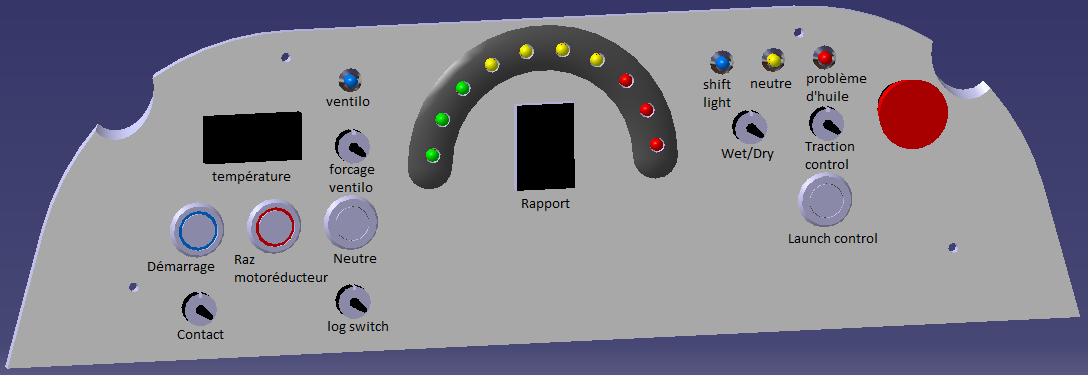
EL - Electrical/Autre/Tableau de bord/Tableau vulcanix/tdb final.PNG
