EOSCogniton/STUF2019/EL - Electrical/Autre/Télémétrie/Justif_logger.JPG

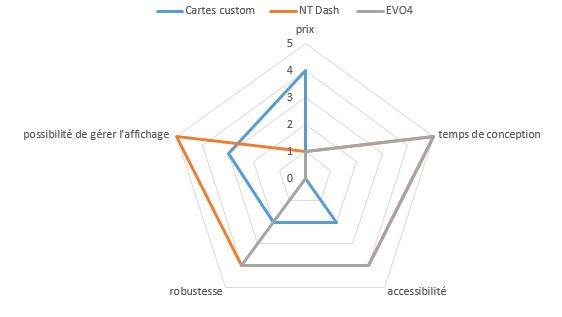
EL - Electrical/Autre/Télémétrie/Justif_logger.JPG
