EOSCogniton/STUF2019/EL - Electrical/Autre/Télémétrie/Justif_trasmission.JPG

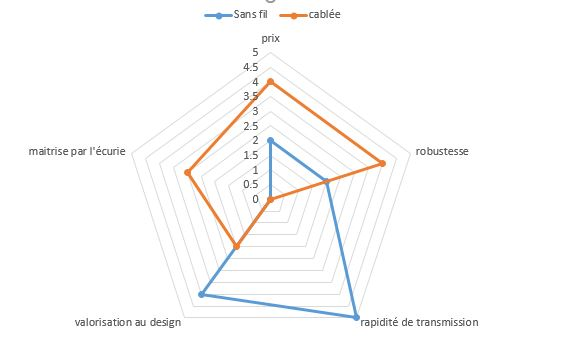
EL - Electrical/Autre/Télémétrie/Justif_trasmission.JPG
