EOSCogniton/STUF2019/EL - Electrical/Catia/Support Tyre Temp/PM Optimus/SU_A1100 (Rear Upright Assy)/FEA/081218 - Right Turn 2G Custom Vulcanix V2 - Displacement.PNG

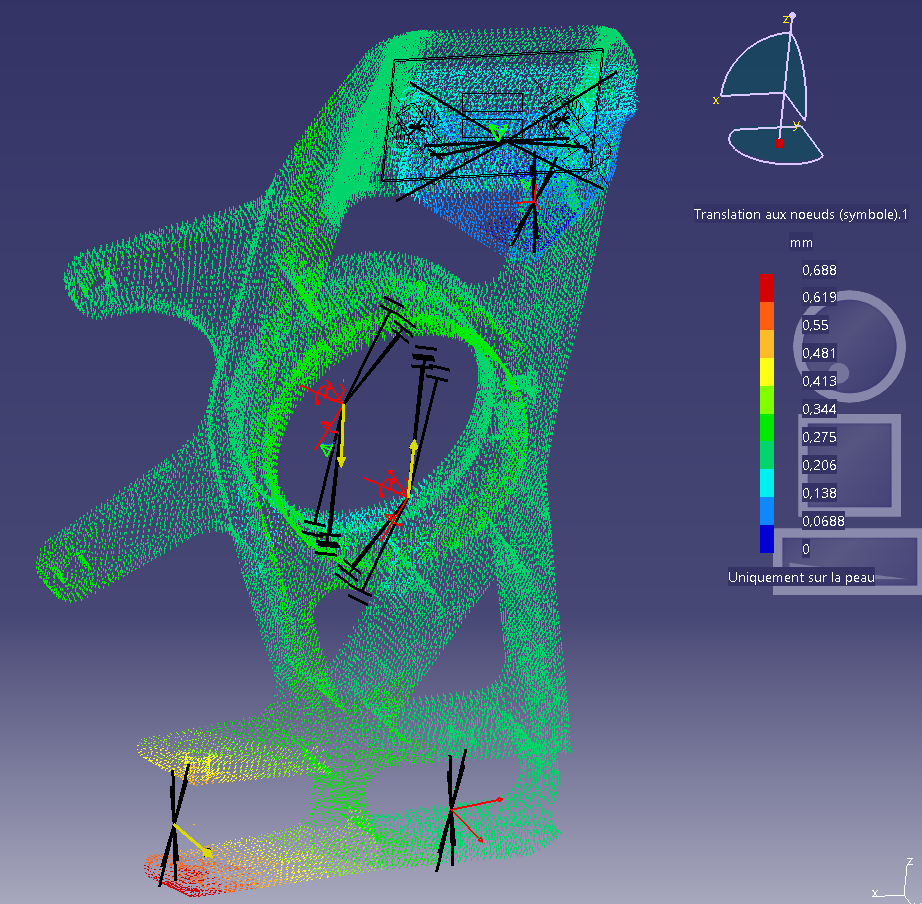
EL - Electrical/Catia/Support Tyre Temp/PM Optimus/SU_A1100 (Rear Upright Assy)/FEA/081218 - Right Turn 2G Custom Vulcanix V2 - Displacement.PNG
