EOSCogniton/STUF2019/EL - Electrical/Catia/Support Tyre Temp/PM Optimus/SU_A1100 (Rear Upright Assy)/FEA/271118 - Right Turn 1G + Brake 1G Vulcanix - Stress.PNG

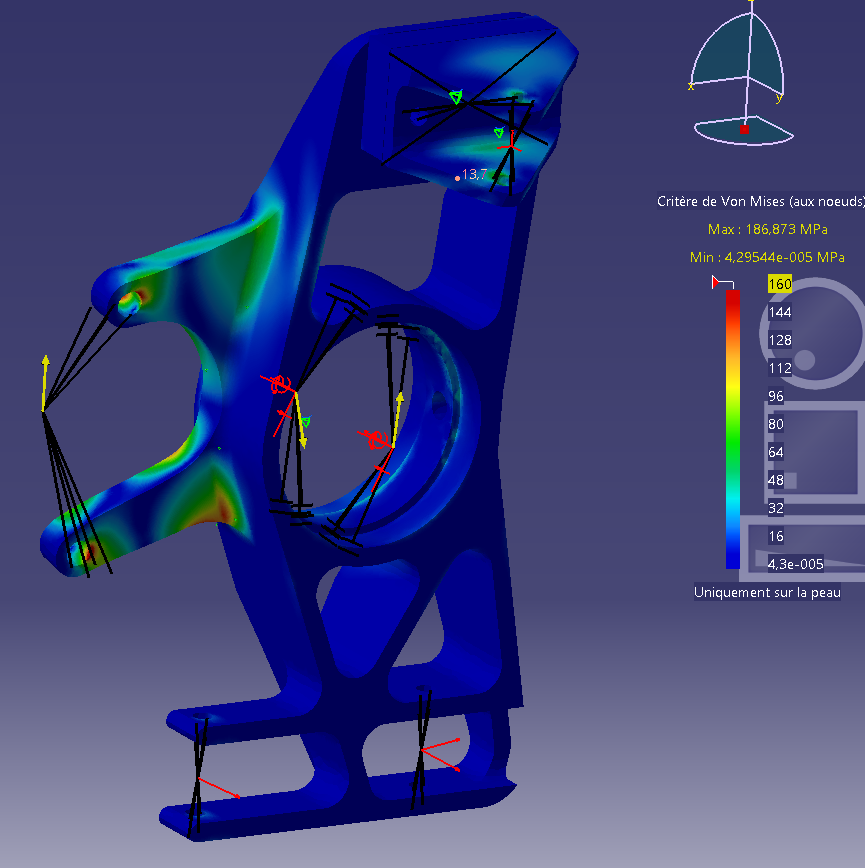
EL - Electrical/Catia/Support Tyre Temp/PM Optimus/SU_A1100 (Rear Upright Assy)/FEA/271118 - Right Turn 1G + Brake 1G Vulcanix - Stress.PNG
