EOSCogniton/STUF2019/EN - Engine & Powertrain/EN_A0100 (Engine)/Carter d'huile - fonderie/Exemple d'une autre équipe/rendu/CBR 600RR top.PNG

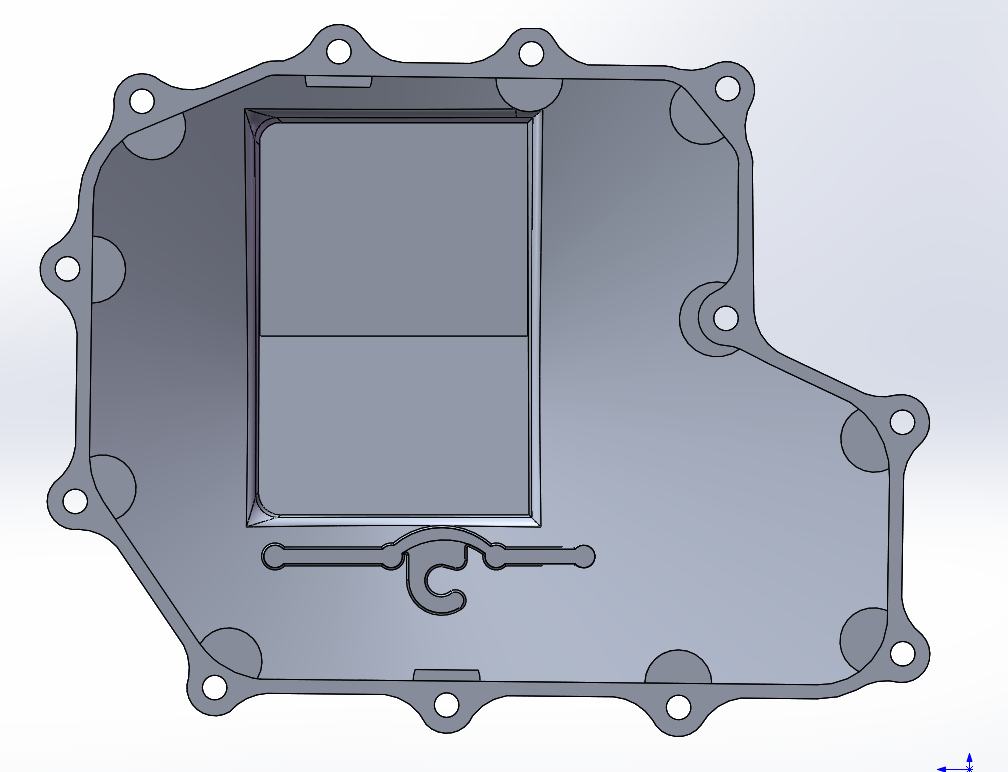
EN - Engine & Powertrain/EN_A0100 (Engine)/Carter d'huile - fonderie/Exemple d'une autre équipe/rendu/CBR 600RR top.PNG
