EOSCogniton/STUF2019/EN - Engine & Powertrain/EN_A0200 (Exhaust system)/Screen pour Bery inox/Vue arriere.PNG

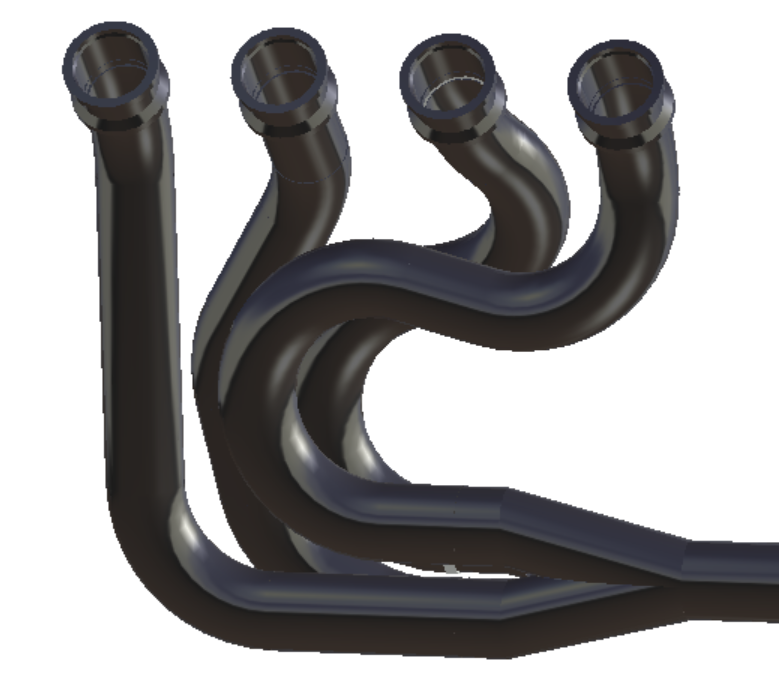
EN - Engine & Powertrain/EN_A0200 (Exhaust system)/Screen pour Bery inox/Vue arriere.PNG
