EOSCogniton/STUF2019/EN - Engine & Powertrain/EN_A0200 (Exhaust system)/Screen pour Bery inox/Vue châssis.PNG

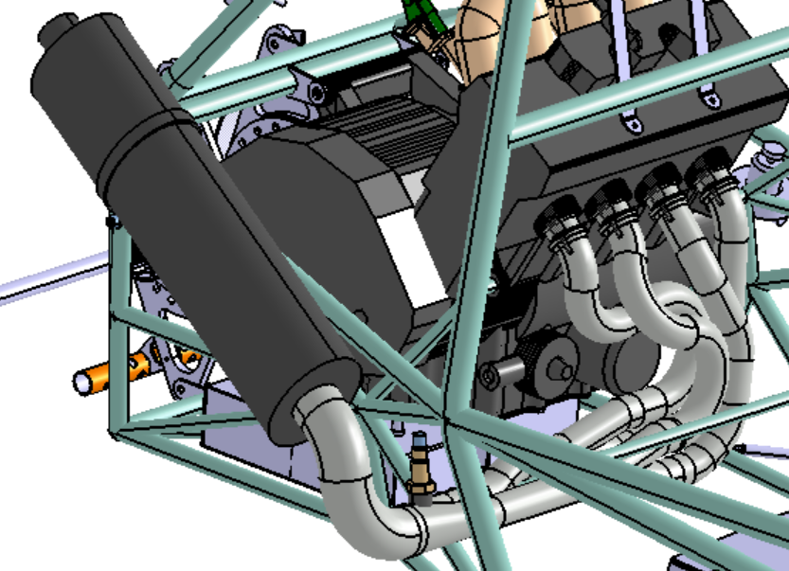
EN - Engine & Powertrain/EN_A0200 (Exhaust system)/Screen pour Bery inox/Vue châssis.PNG
