EOSCogniton/STUF2019/EN - Engine & Powertrain/EN_A0200 (Exhaust system)/Screen pour Bery inox/Vue droite.PNG

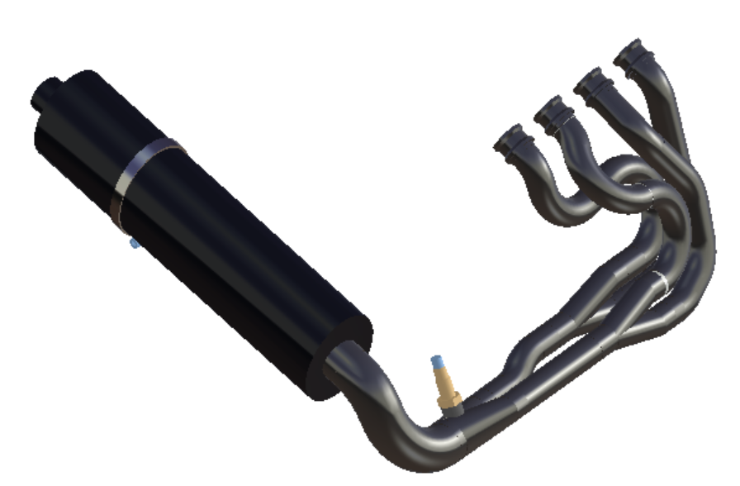
EN - Engine & Powertrain/EN_A0200 (Exhaust system)/Screen pour Bery inox/Vue droite.PNG
