EOSCogniton/STUF2019/FR - Frame & Body/Aero EPSA Invictus/Aile ant/Screens/Vue côté gauche.png

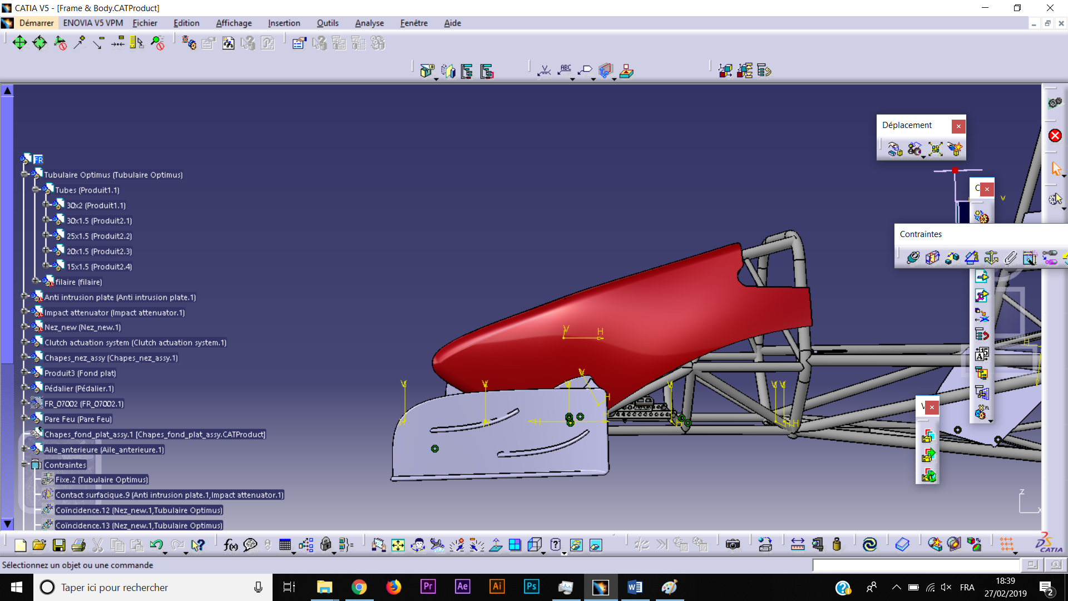
FR - Frame & Body/Aero EPSA Invictus/Aile ant/Screens/Vue côté gauche.png
