EOSCogniton/STUF2019/FR - Frame & Body/Aero EPSA Invictus/Aile ant/Screens/Vue du dessous.png

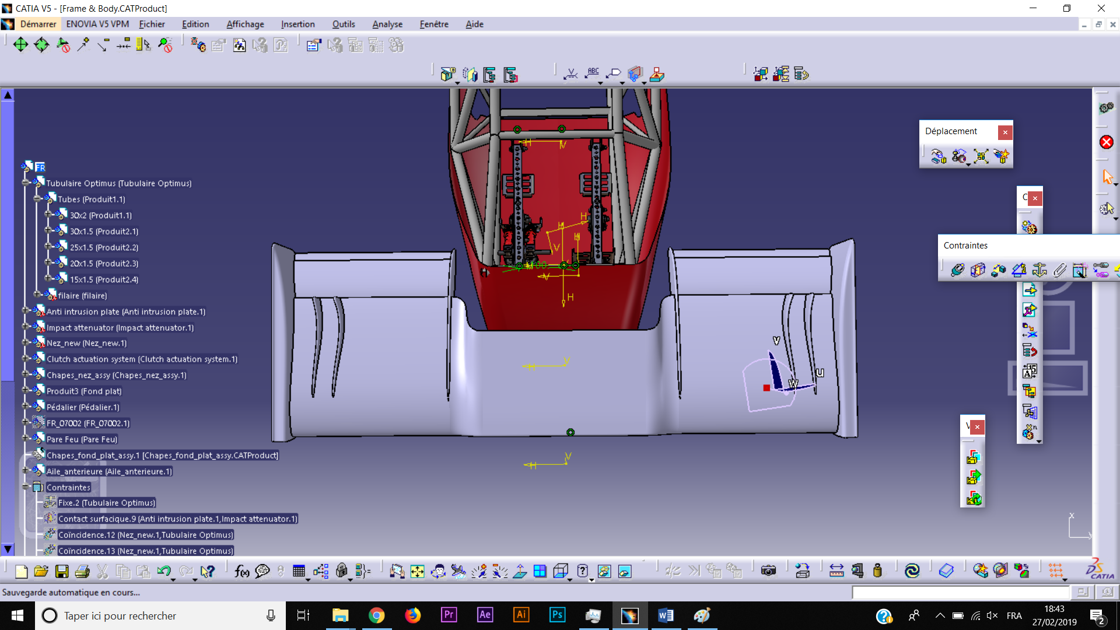
FR - Frame & Body/Aero EPSA Invictus/Aile ant/Screens/Vue du dessous.png
