EOSCogniton/STUF2019/FR - Frame & Body/FR_A0100 (Frame)/Design report/ANALYSES SImulations poutre/Captures v2/Left Turn 2G/Av/Déplacement.PNG

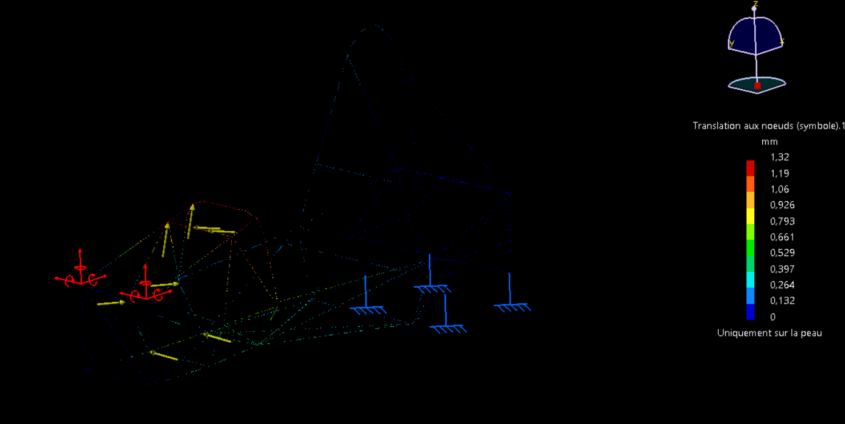
FR - Frame & Body/FR_A0100 (Frame)/Design report/ANALYSES SImulations poutre/Captures v2/Left Turn 2G/Av/Déplacement.PNG
