EOSCogniton/STUF2019/FR - Frame & Body/FR_A0100 (Frame)/Design report/bump 3g.PNG

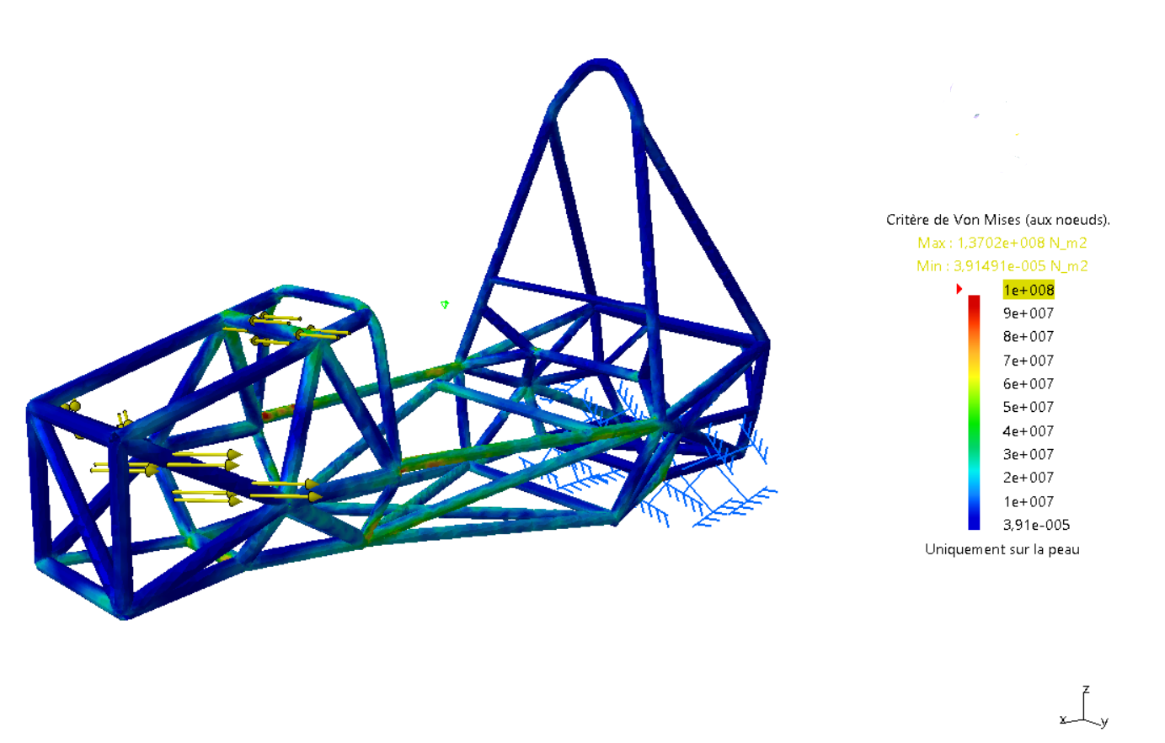
FR - Frame & Body/FR_A0100 (Frame)/Design report/bump 3g.PNG
