EOSCogniton/STUF2019/FR - Frame & Body/FR_A0100 (Frame)/Design report/Design Support/64625881_2750030341734004_1903404496269082624_n.png

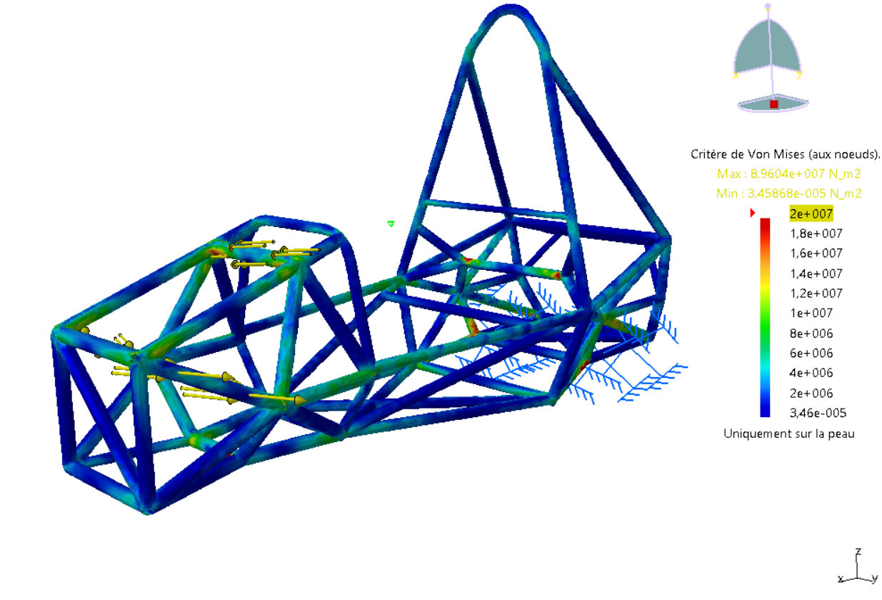
FR - Frame & Body/FR_A0100 (Frame)/Design report/Design Support/64625881_2750030341734004_1903404496269082624_n.png
