EOSCogniton/STUF2019/FR - Frame & Body/FR_A0100 (Frame)/Design report/Design Support/64730380_2345686785757676_6778838031072755712_n.png

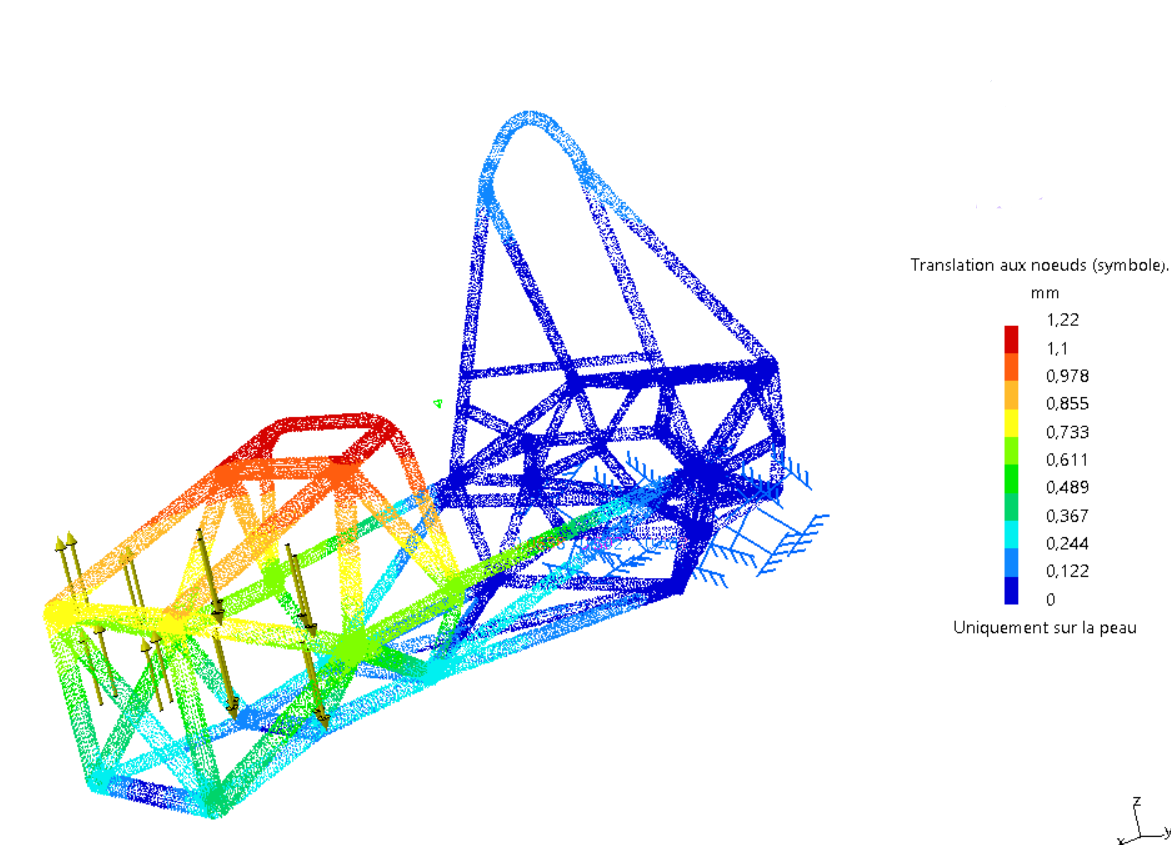
FR - Frame & Body/FR_A0100 (Frame)/Design report/Design Support/64730380_2345686785757676_6778838031072755712_n.png
