EOSCogniton/STUF2019/FR - Frame & Body/FR_A0100 (Frame)/Design report/Design Support/65115408_2469419546443301_8199985139577520128_n.png

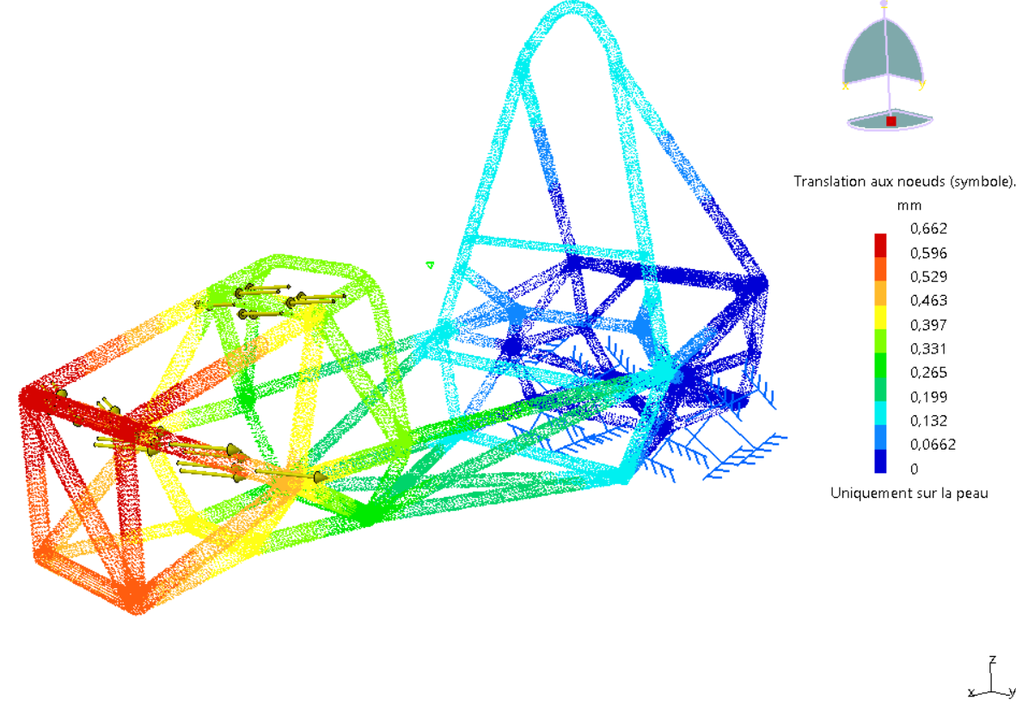
FR - Frame & Body/FR_A0100 (Frame)/Design report/Design Support/65115408_2469419546443301_8199985139577520128_n.png
