EOSCogniton/STUF2019/FR - Frame & Body/FR_A0100 (Frame)/Design report/Design Support/65297783_381968932446005_932886151029587968_n.png

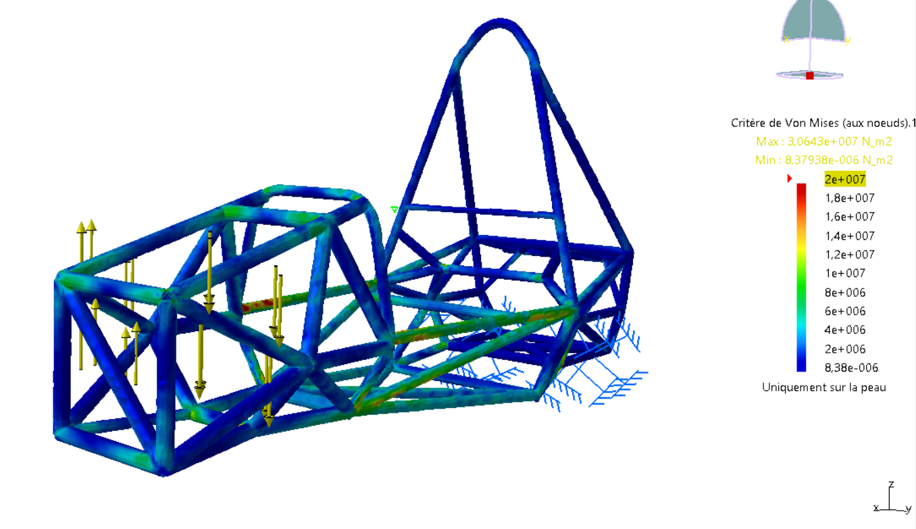
FR - Frame & Body/FR_A0100 (Frame)/Design report/Design Support/65297783_381968932446005_932886151029587968_n.png
