EOSCogniton/STUF2019/FR - Frame & Body/FR_A0100 (Frame)/Design report/Design Support/Carrosserie picture/61942277_2266009073475225_5584283462845595648_n.png

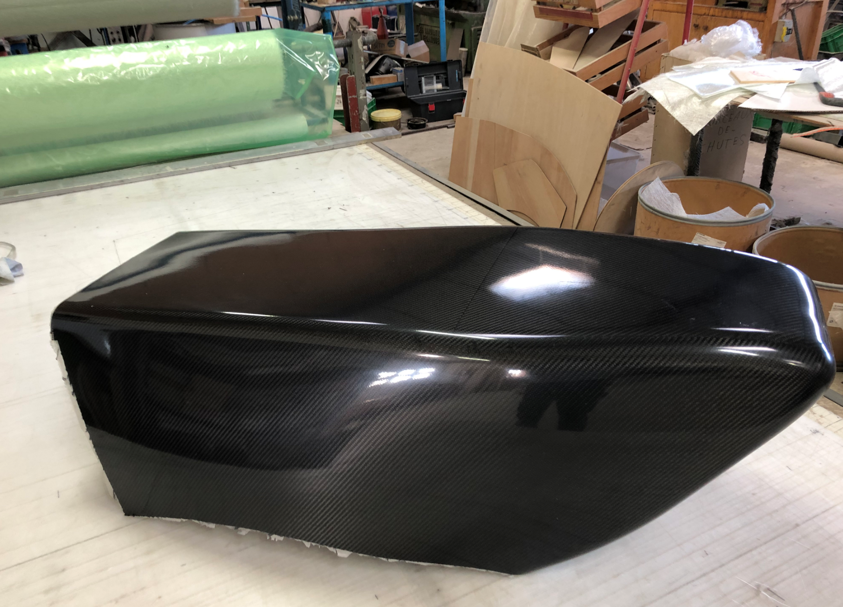
FR - Frame & Body/FR_A0100 (Frame)/Design report/Design Support/Carrosserie picture/61942277_2266009073475225_5584283462845595648_n.png
