EOSCogniton/STUF2019/FR - Frame & Body/FR_A0100 (Frame)/Design report/Design Support/Carrosserie picture/61944732_377977949508533_7568727871661801472_n.jpg

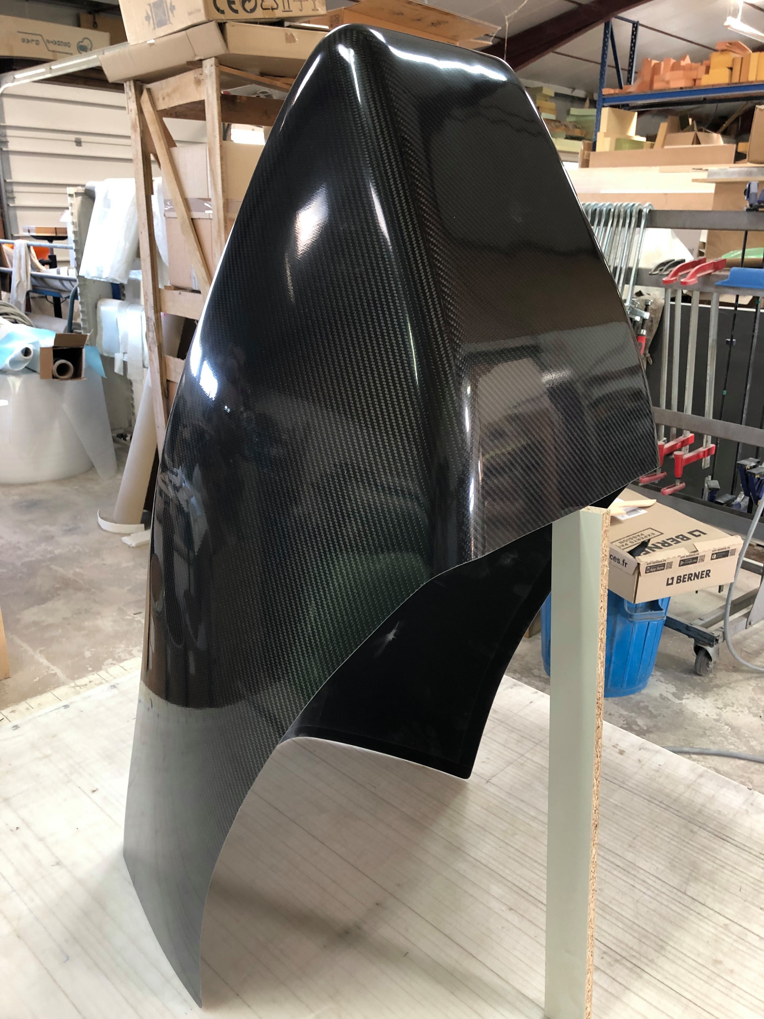
FR - Frame & Body/FR_A0100 (Frame)/Design report/Design Support/Carrosserie picture/61944732_377977949508533_7568727871661801472_n.jpg
