EOSCogniton/STUF2019/FR - Frame & Body/FR_A0100 (Frame)/Design report/Design Support/Carrosserie picture/62072770_1293959100758341_2119509490914033664_n.jpg

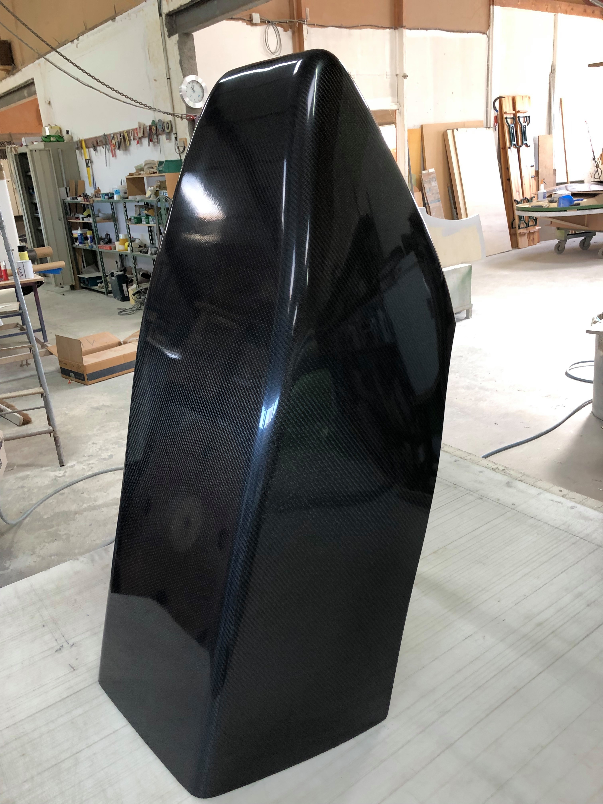
FR - Frame & Body/FR_A0100 (Frame)/Design report/Design Support/Carrosserie picture/62072770_1293959100758341_2119509490914033664_n.jpg
