EOSCogniton/STUF2019/FR - Frame & Body/FR_A0100 (Frame)/Design report/Design Support/Carrosserie picture/62129045_848746212175705_4201320688071475200_n.jpg

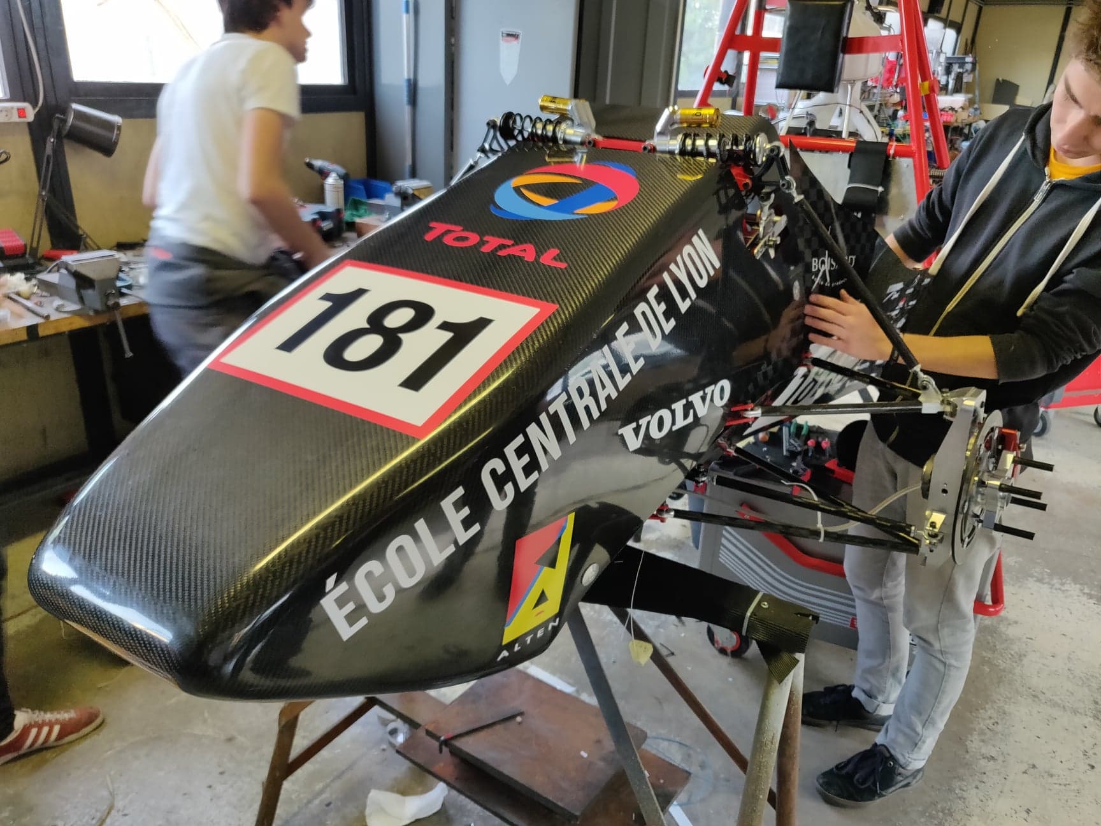
FR - Frame & Body/FR_A0100 (Frame)/Design report/Design Support/Carrosserie picture/62129045_848746212175705_4201320688071475200_n.jpg
