EOSCogniton/STUF2019/FR - Frame & Body/FR_A0100 (Frame)/Design report/Design Support/Carrosserie picture/62200907_339495370072441_9214832422099615744_n.jpg

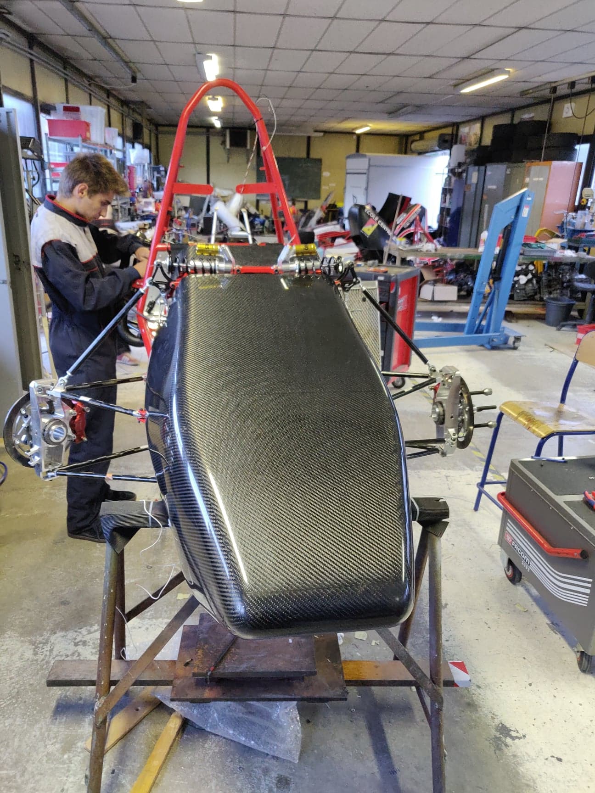
FR - Frame & Body/FR_A0100 (Frame)/Design report/Design Support/Carrosserie picture/62200907_339495370072441_9214832422099615744_n.jpg
