EOSCogniton/STUF2019/FR - Frame & Body/FR_A0100 (Frame)/Design report/Design Support/Mecamaster view zoom.PNG

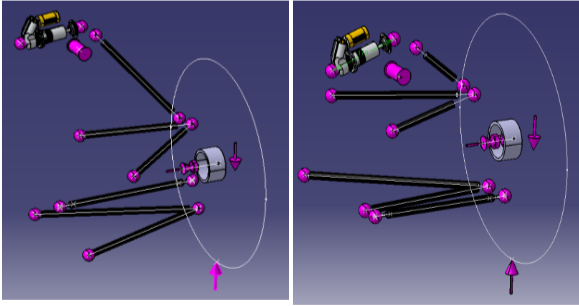
FR - Frame & Body/FR_A0100 (Frame)/Design report/Design Support/Mecamaster view zoom.PNG
