EOSCogniton/STUF2019/FR - Frame & Body/FR_A0100 (Frame)/Design report/Design Support/Simulations/Right Turn 1G + Freinage 1G/Von Mises.PNG

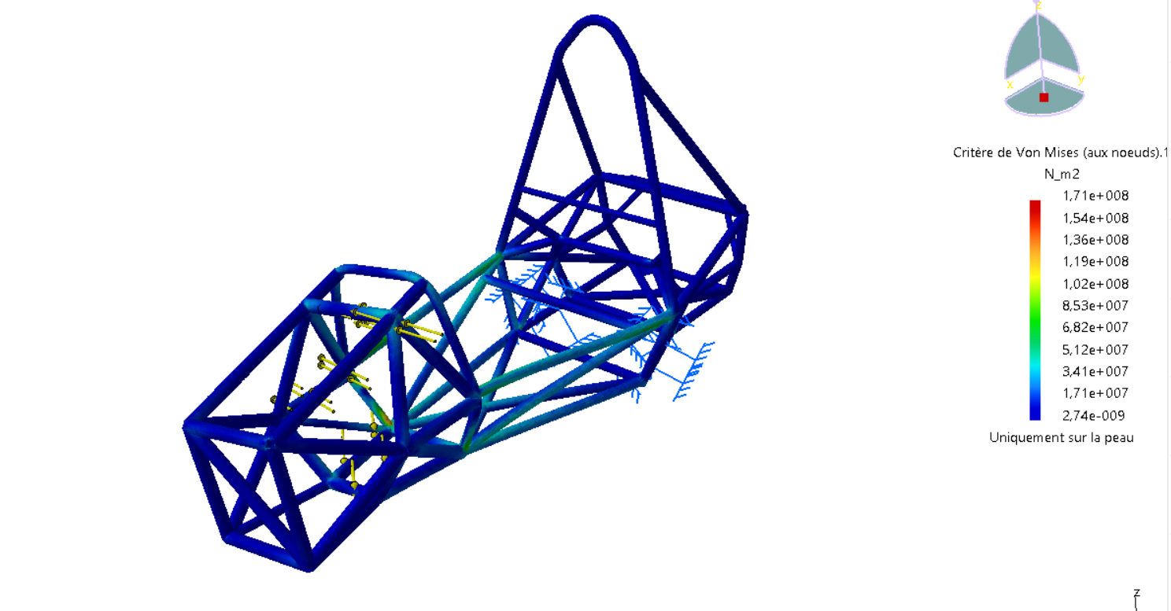
FR - Frame & Body/FR_A0100 (Frame)/Design report/Design Support/Simulations/Right Turn 1G + Freinage 1G/Von Mises.PNG
