EOSCogniton/STUF2019/FR - Frame & Body/FR_A0100 (Frame)/Design report/Design Support/Simulations/Right Turn 2G/Avant/Von Mises.PNG

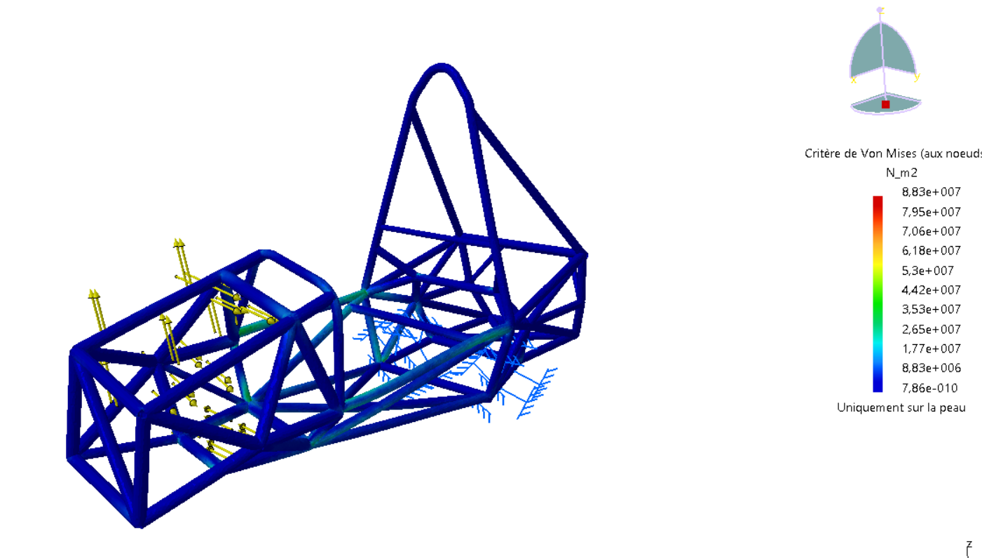
FR - Frame & Body/FR_A0100 (Frame)/Design report/Design Support/Simulations/Right Turn 2G/Avant/Von Mises.PNG
