EOSCogniton/STUF2019/FR - Frame & Body/FR_A0100 (Frame)/Design report/Design Support/Stiffness explanation.jpg

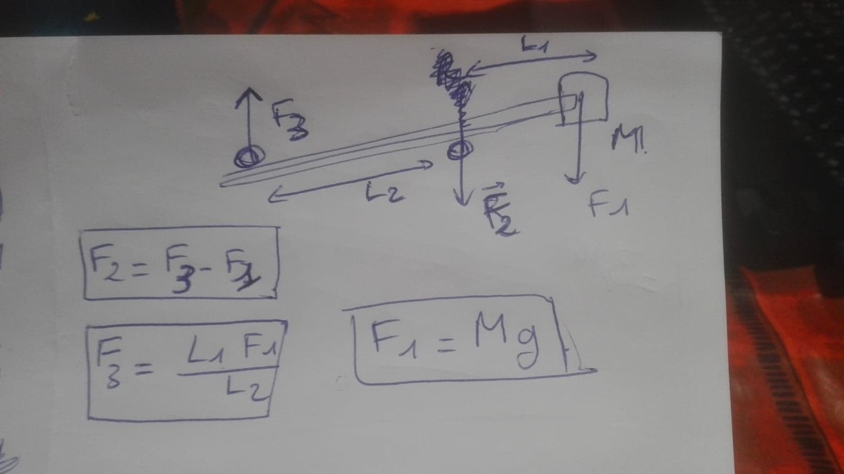
FR - Frame & Body/FR_A0100 (Frame)/Design report/Design Support/Stiffness explanation.jpg
