EOSCogniton/STUF2019/FR - Frame & Body/FR_A0100 (Frame)/Design report/Repère Tubes.png

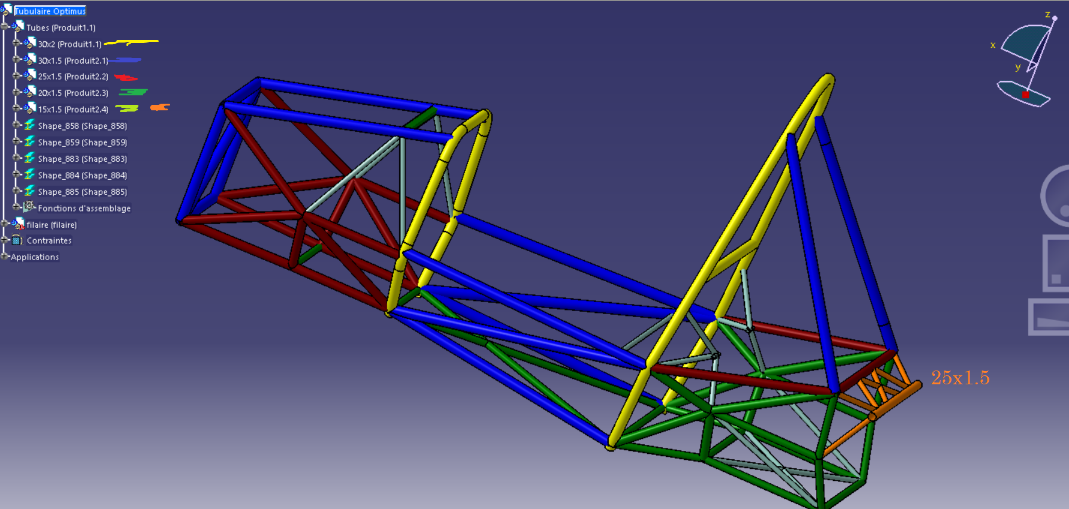
FR - Frame & Body/FR_A0100 (Frame)/Design report/Repère Tubes.png
