EOSCogniton/STUF2019/FR - Frame & Body/FR_A0100 (Frame)/Design report/Simulation_torsion_500kg_vg_v2.PNG

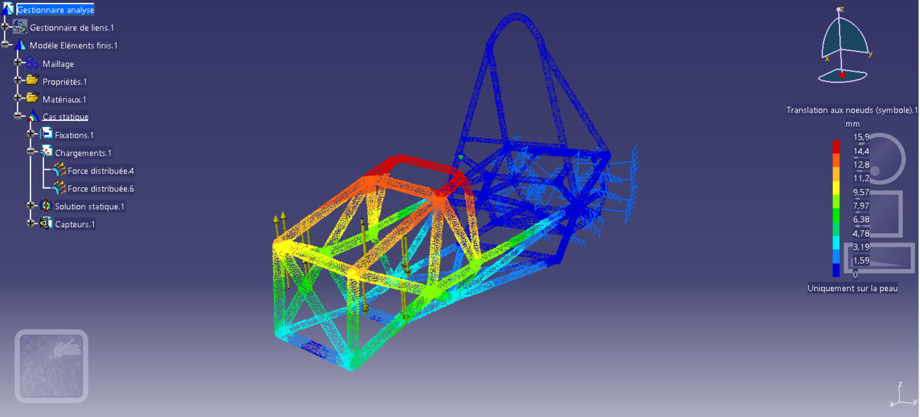
FR - Frame & Body/FR_A0100 (Frame)/Design report/Simulation_torsion_500kg_vg_v2.PNG
