EOSCogniton/STUF2019/FR - Frame & Body/FR_A0100 (Frame)/Règlement justification/answer question rule SES AIP.PNG

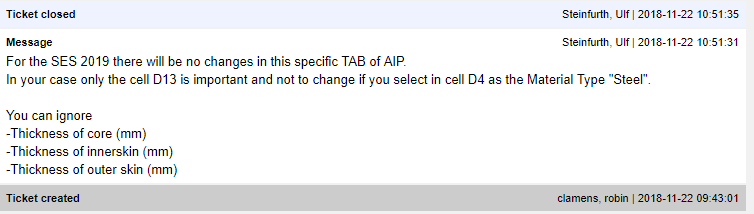
FR - Frame & Body/FR_A0100 (Frame)/Règlement justification/answer question rule SES AIP.PNG
