EOSCogniton/STUF2019/FR - Frame & Body/FR_A0100 (Frame)/Règlement justification/Answer question rule Side impact_1.jpg

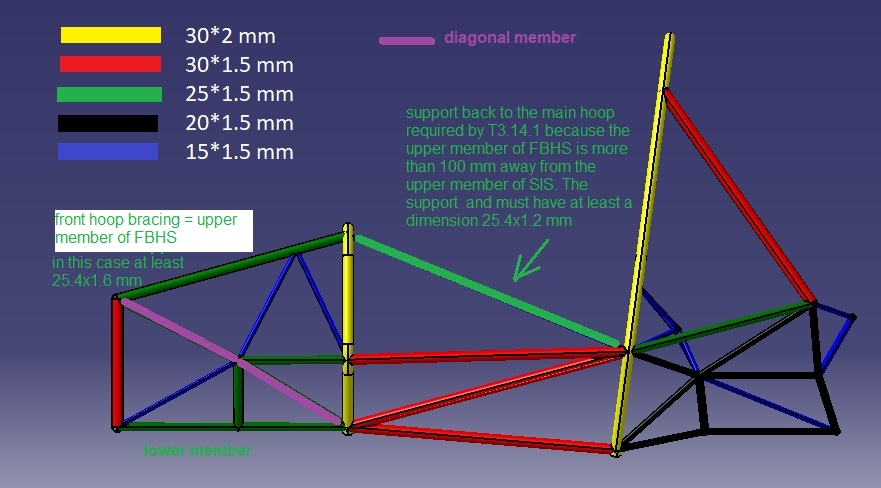
FR - Frame & Body/FR_A0100 (Frame)/Règlement justification/Answer question rule Side impact_1.jpg
