EOSCogniton/STUF2019/FR - Frame & Body/FR_A0100 (Frame)/Règlement justification/chassis pic colour code.png

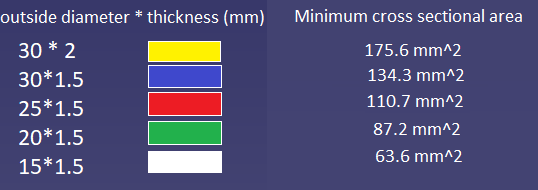
FR - Frame & Body/FR_A0100 (Frame)/Règlement justification/chassis pic colour code.png
