EOSCogniton/STUF2019/FR - Frame & Body/FR_A0100 (Frame)/Règlement justification/Chassis pic side view tube change.png

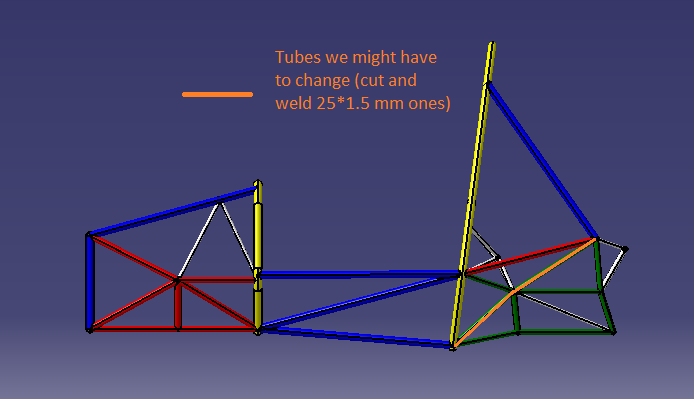
FR - Frame & Body/FR_A0100 (Frame)/Règlement justification/Chassis pic side view tube change.png
