EOSCogniton/STUF2019/FR - Frame & Body/FR_A0100 (Frame)/Règlement justification/chassis sideview + colour code + tube change.png

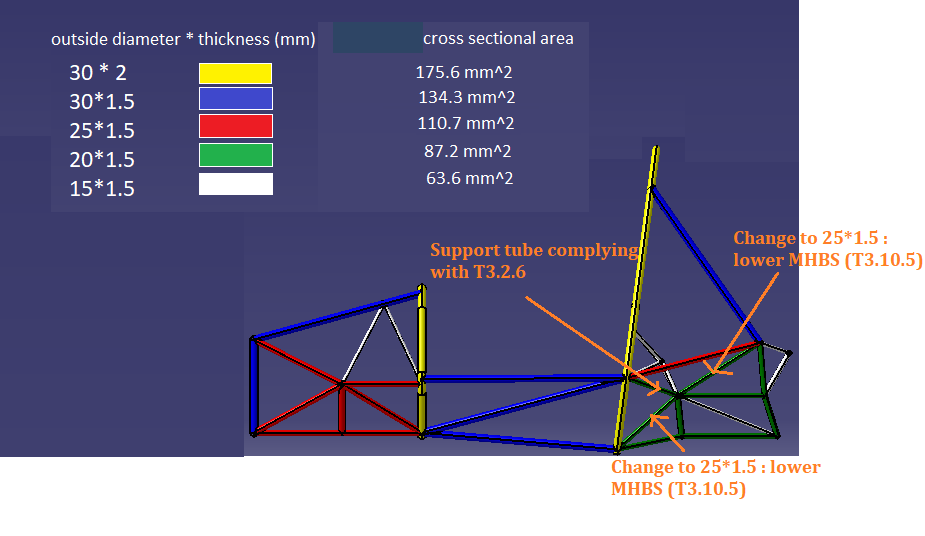
FR - Frame & Body/FR_A0100 (Frame)/Règlement justification/chassis sideview + colour code + tube change.png
