EOSCogniton/STUF2019/FR - Frame & Body/FR_A0100 (Frame)/Règlement justification/reinforcement on side view.png

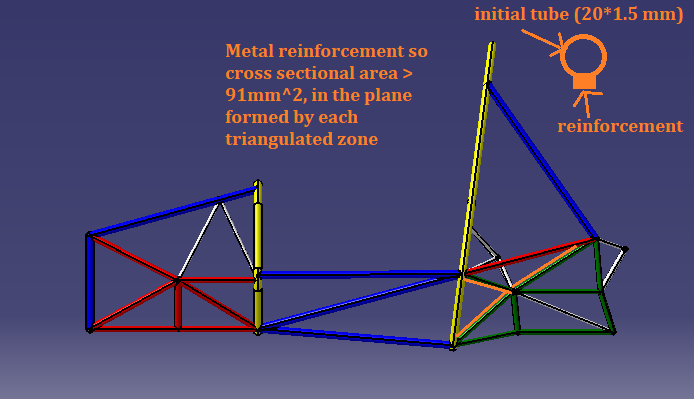
FR - Frame & Body/FR_A0100 (Frame)/Règlement justification/reinforcement on side view.png
