EOSCogniton/STUF2019/FR - Frame & Body/FR_A0100 (Frame)/Règlement justification/Rule question 25cd4s.png

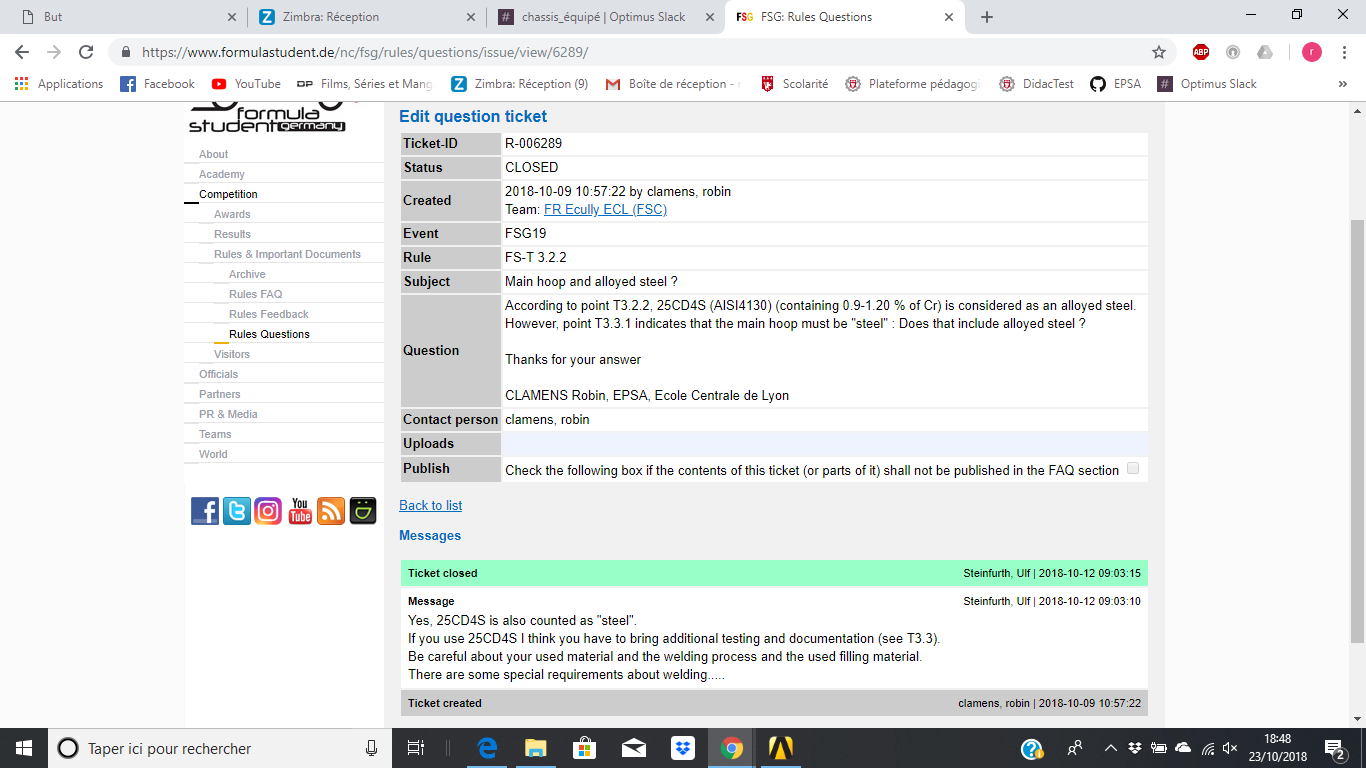
FR - Frame & Body/FR_A0100 (Frame)/Règlement justification/Rule question 25cd4s.png
