EOSCogniton/STUF2019/FR - Frame & Body/FR_A0100 (Frame)/Règlement justification/sideview_chassis_colorcode.png

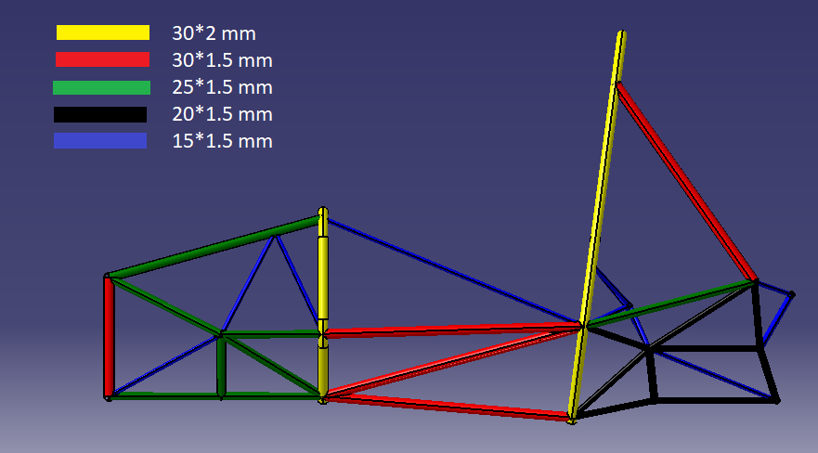
FR - Frame & Body/FR_A0100 (Frame)/Règlement justification/sideview_chassis_colorcode.png
