EOSCogniton/STUF2019/FR - Frame & Body/FR_A0100 (Frame)/SES/A envoyer FSN complement/SES_Correction_EPSA/certificats matière/img008.jpg

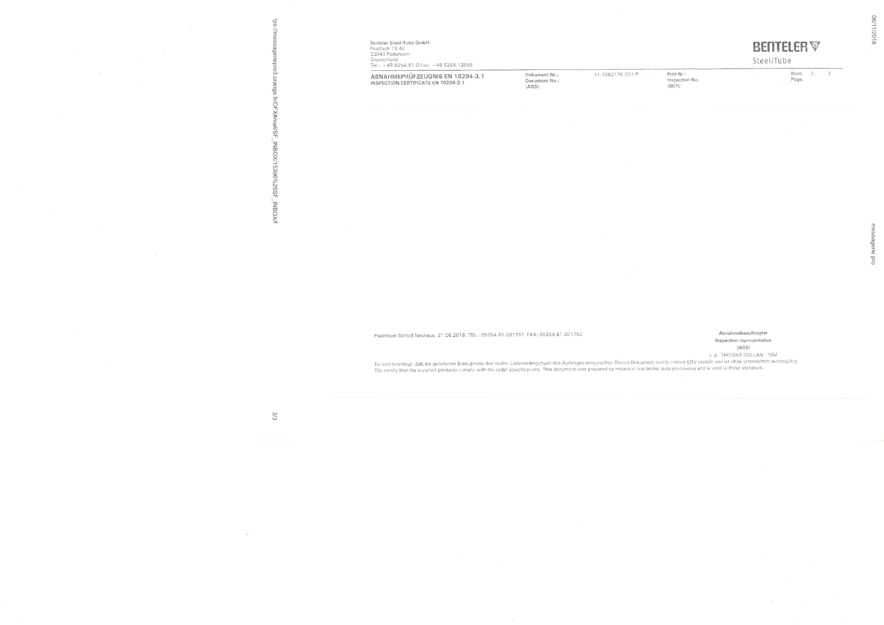
FR - Frame & Body/FR_A0100 (Frame)/SES/A envoyer FSN complement/SES_Correction_EPSA/certificats matière/img008.jpg
