EOSCogniton/STUF2019/FR - Frame & Body/FR_A0100 (Frame)/SES/AI and AIP bis.PNG

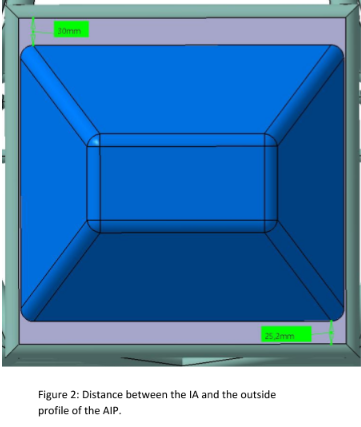
FR - Frame & Body/FR_A0100 (Frame)/SES/AI and AIP bis.PNG
