EOSCogniton/STUF2019/FR - Frame & Body/FR_A0100 (Frame)/SES/AIP.PNG

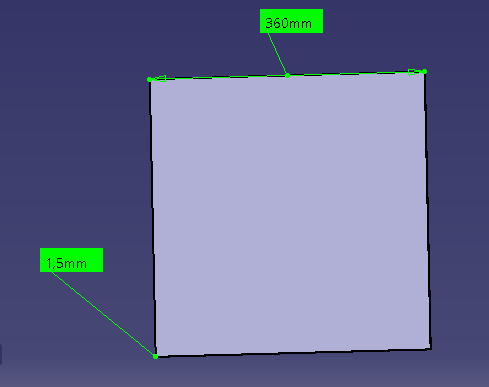
FR - Frame & Body/FR_A0100 (Frame)/SES/AIP.PNG
