EOSCogniton/STUF2019/FR - Frame & Body/FR_A0100 (Frame)/SES/chassis pic dimensions.PNG

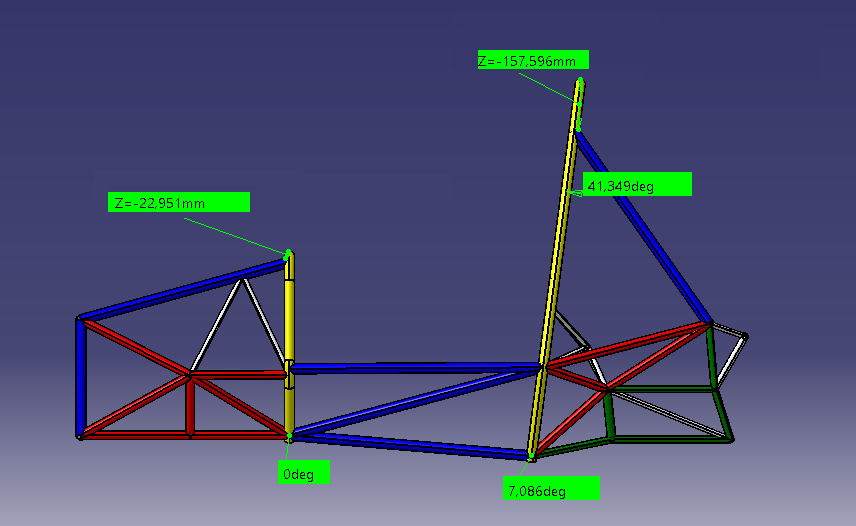
FR - Frame & Body/FR_A0100 (Frame)/SES/chassis pic dimensions.PNG
