EOSCogniton/STUF2019/FR - Frame & Body/FR_A0100 (Frame)/SES/Chassis pic side view.PNG

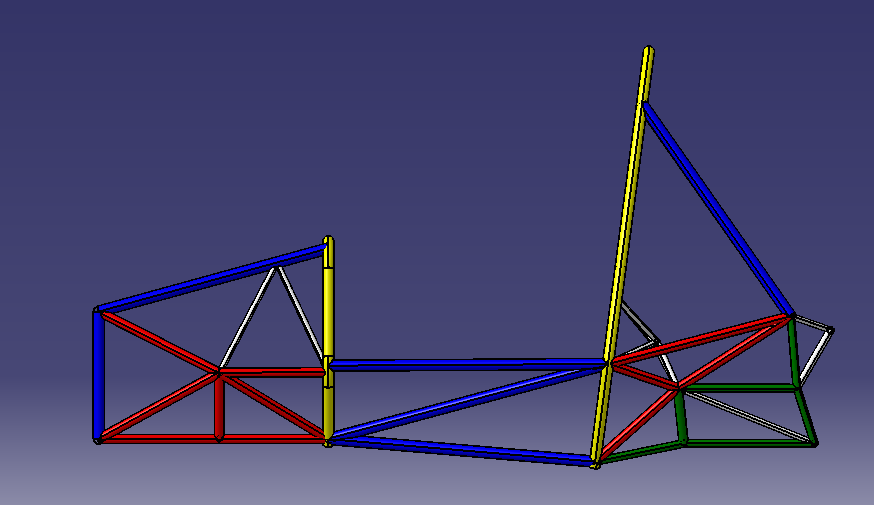
FR - Frame & Body/FR_A0100 (Frame)/SES/Chassis pic side view.PNG
