EOSCogniton/STUF2019/FR - Frame & Body/FR_A0100 (Frame)/SES/FHB.PNG

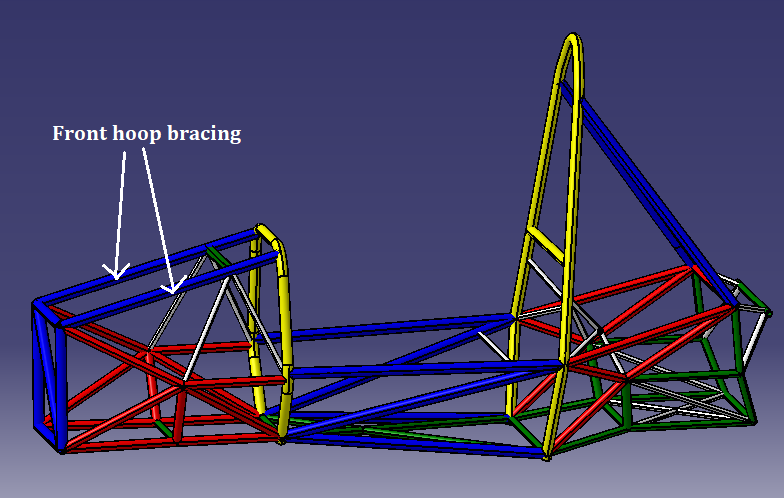
FR - Frame & Body/FR_A0100 (Frame)/SES/FHB.PNG
