EOSCogniton/STUF2019/FR - Frame & Body/FR_A0100 (Frame)/SES/firewall description.png

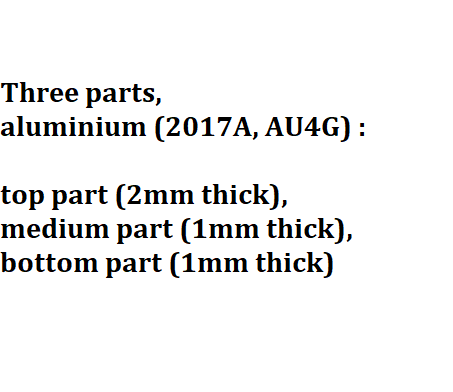
FR - Frame & Body/FR_A0100 (Frame)/SES/firewall description.png
