EOSCogniton/STUF2019/FR - Frame & Body/FR_A0100 (Frame)/SES/Firewall.jpg

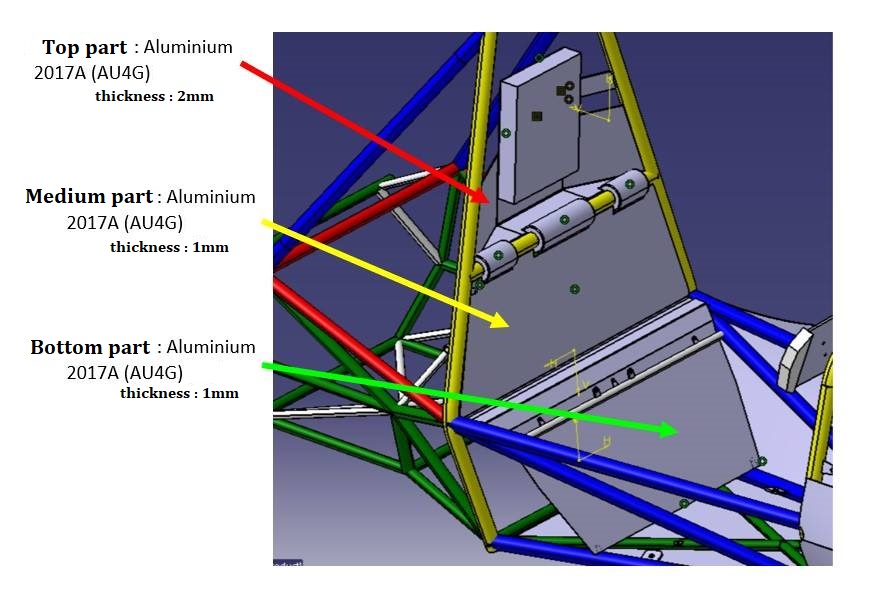
FR - Frame & Body/FR_A0100 (Frame)/SES/Firewall.jpg
