EOSCogniton/STUF2019/FR - Frame & Body/FR_A0100 (Frame)/SES/isometric view fuel tank.PNG

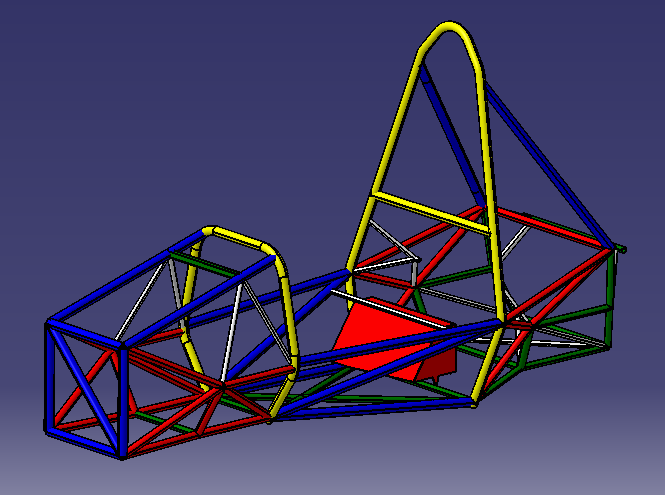
FR - Frame & Body/FR_A0100 (Frame)/SES/isometric view fuel tank.PNG
