EOSCogniton/STUF2019/FR - Frame & Body/FR_A0100 (Frame)/SES/MHBS.PNG

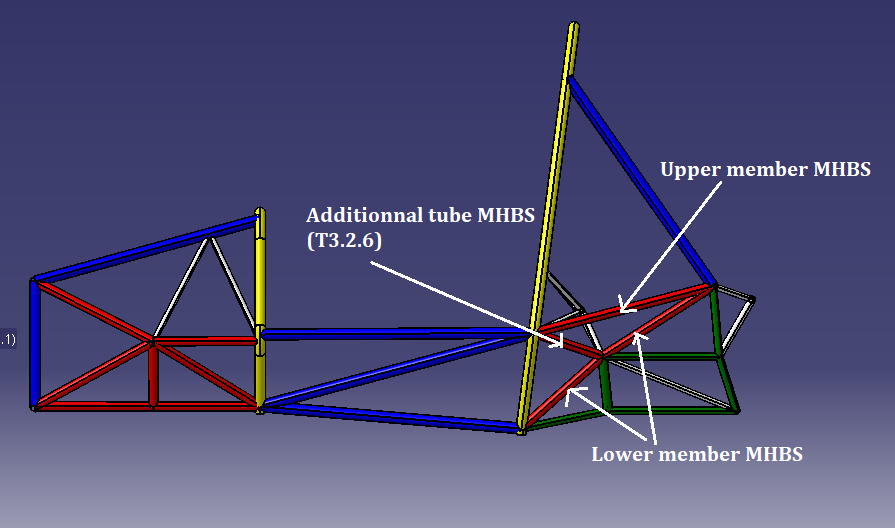
FR - Frame & Body/FR_A0100 (Frame)/SES/MHBS.PNG
