EOSCogniton/STUF2019/FR - Frame & Body/FR_A0100 (Frame)/SES/side view fuel tank.PNG

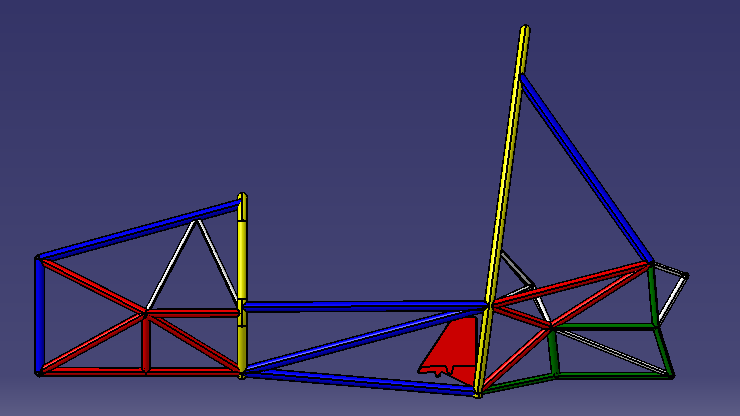
FR - Frame & Body/FR_A0100 (Frame)/SES/side view fuel tank.PNG
