EOSCogniton/STUF2019/FR - Frame & Body/FR_A0100 (Frame)/SES/Vickers hardness.PNG

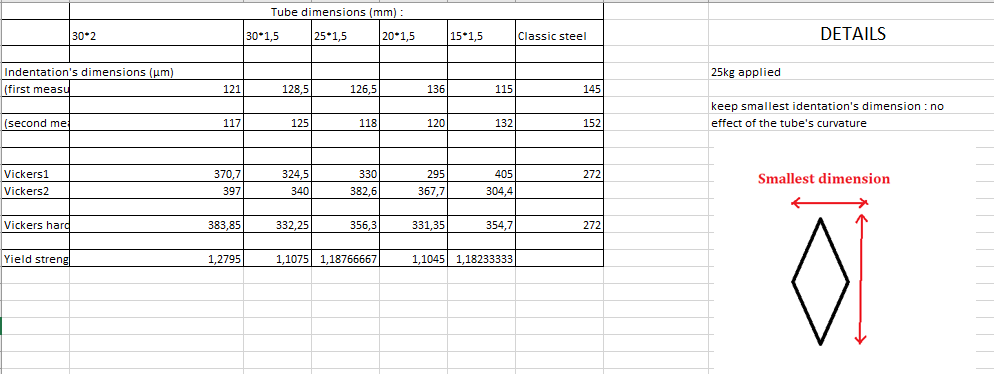
FR - Frame & Body/FR_A0100 (Frame)/SES/Vickers hardness.PNG
