EOSCogniton/STUF2019/FR - Frame & Body/FR_A0300 (Pedal Assy)/Dimensionnement/Images/Branche pedal accélérateur.JPG

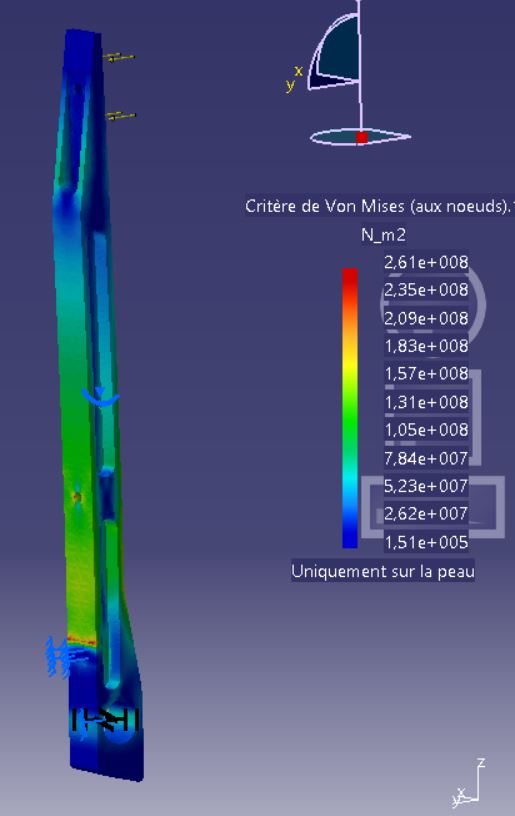
FR - Frame & Body/FR_A0300 (Pedal Assy)/Dimensionnement/Images/Branche pedal accélérateur.JPG
