EOSCogniton/STUF2019/FR - Frame & Body/FR_A0300 (Pedal Assy)/Dimensionnement/Images/branche pedale frein.JPG

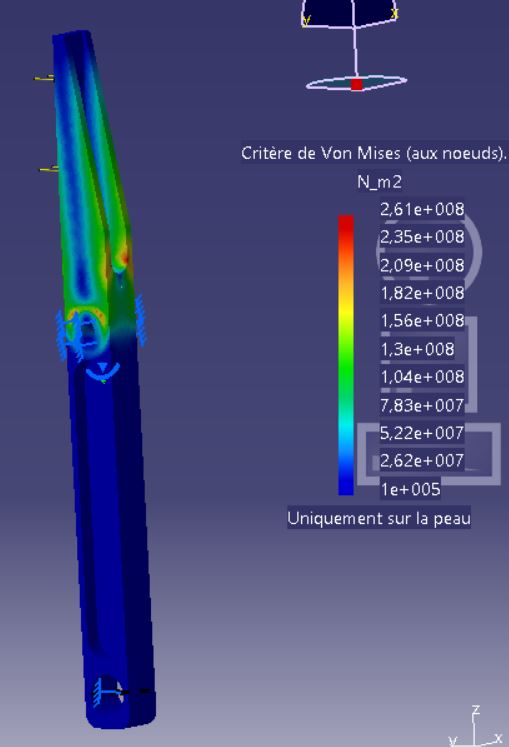
FR - Frame & Body/FR_A0300 (Pedal Assy)/Dimensionnement/Images/branche pedale frein.JPG
