EOSCogniton/STUF2019/FR - Frame & Body/FR_A0300 (Pedal Assy)/Dimensionnement/Images/cale bout de pied effort décentré.JPG

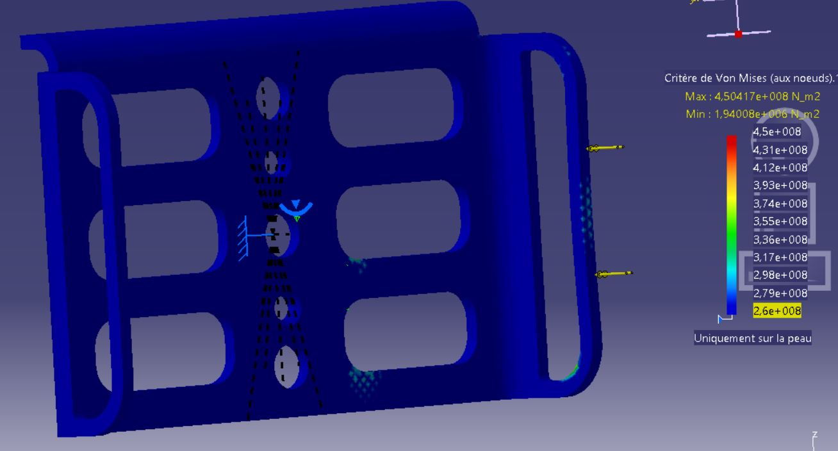
FR - Frame & Body/FR_A0300 (Pedal Assy)/Dimensionnement/Images/cale bout de pied effort décentré.JPG
