EOSCogniton/STUF2019/FR - Frame & Body/FR_A0300 (Pedal Assy)/Dimensionnement/Images/cale bout de pied.JPG

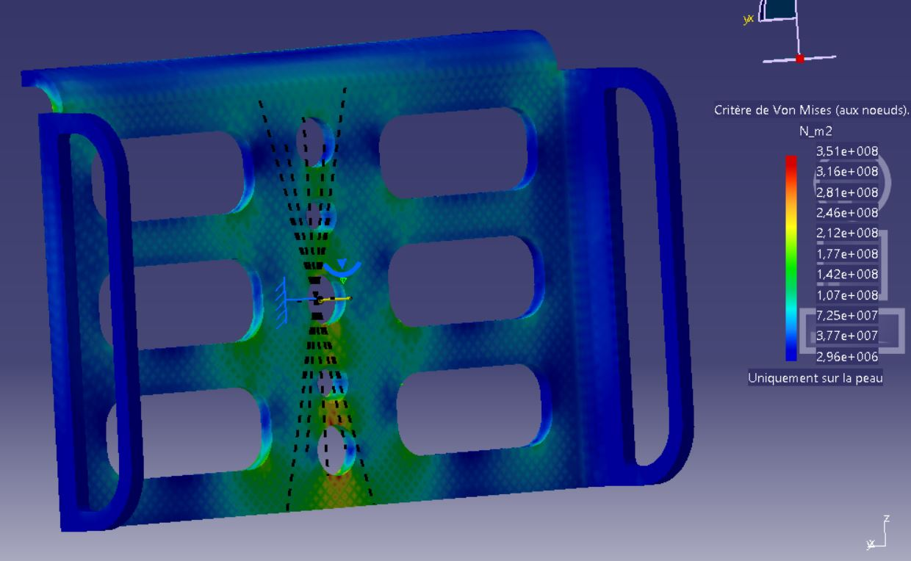
FR - Frame & Body/FR_A0300 (Pedal Assy)/Dimensionnement/Images/cale bout de pied.JPG
