EOSCogniton/STUF2019/FR - Frame & Body/FR_A0300 (Pedal Assy)/Dimensionnement/Images/Chape avant effort latéral.JPG

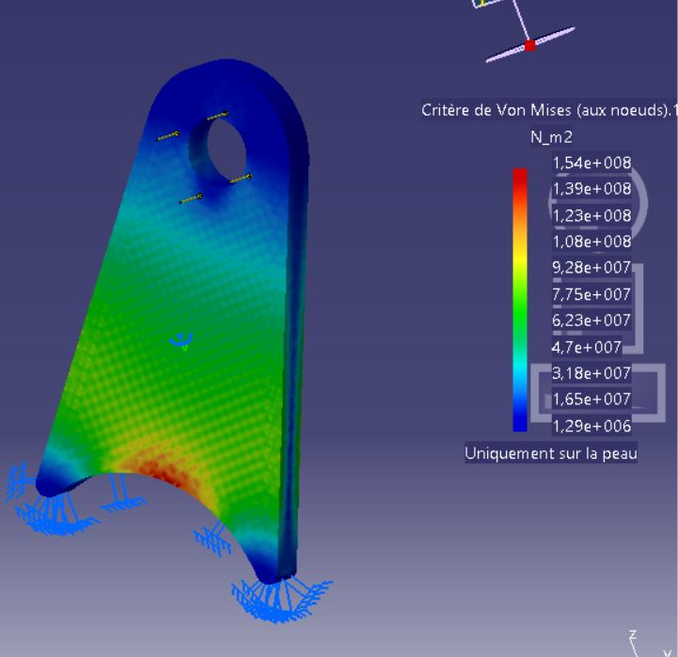
FR - Frame & Body/FR_A0300 (Pedal Assy)/Dimensionnement/Images/Chape avant effort latéral.JPG
