EOSCogniton/STUF2019/FR - Frame & Body/FR_A0300 (Pedal Assy)/Dimensionnement/Images/Entretoise MC extérieur.JPG

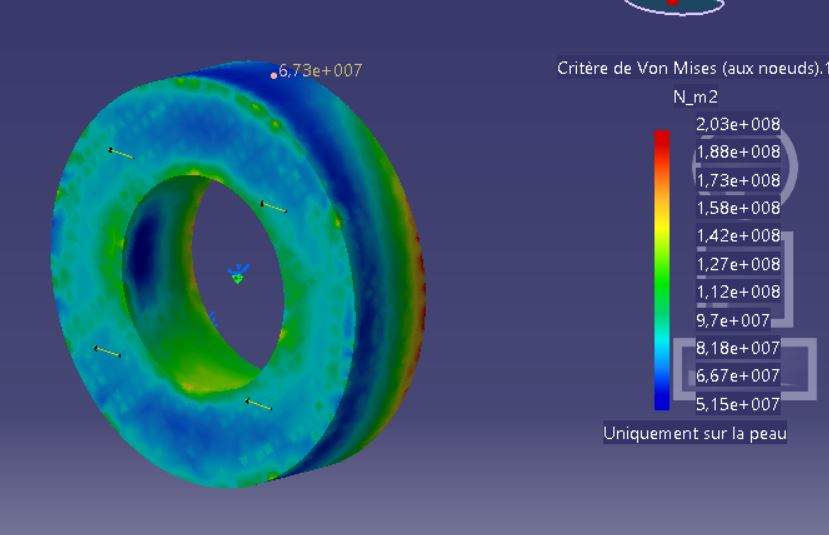
FR - Frame & Body/FR_A0300 (Pedal Assy)/Dimensionnement/Images/Entretoise MC extérieur.JPG
