EOSCogniton/STUF2019/FR - Frame & Body/FR_A0500 (Clutch activation system)/Gabarits/Capture3.PNG

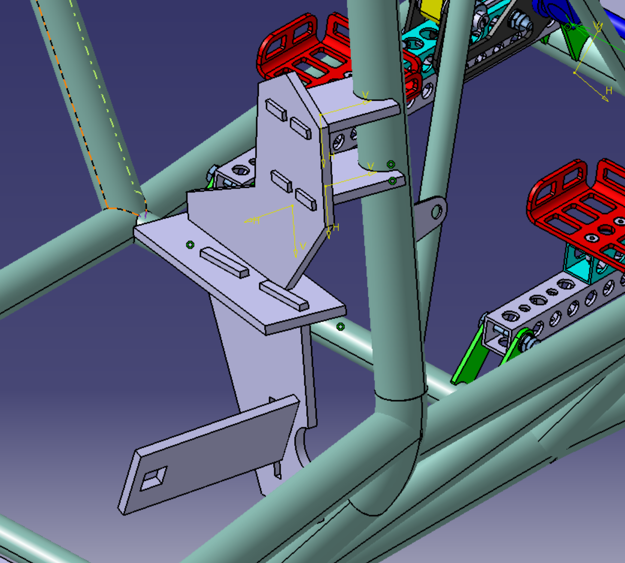
FR - Frame & Body/FR_A0500 (Clutch activation system)/Gabarits/Capture3.PNG
