EOSCogniton/STUF2019/FR - Frame & Body/FR_A0500 (Clutch activation system)/Screen epsabox/fig8.PNG

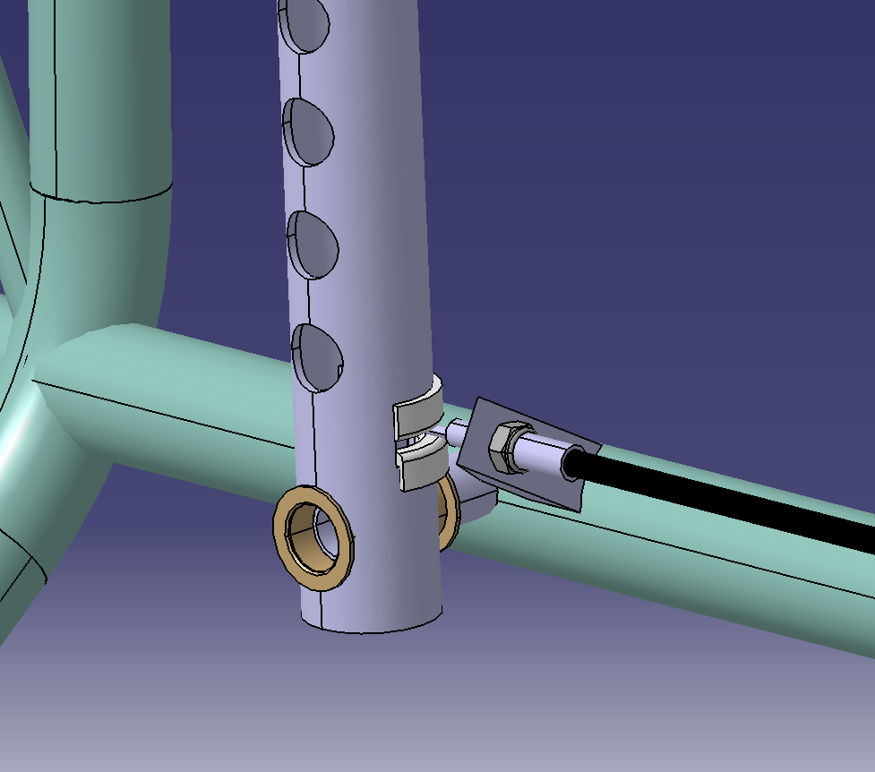
FR - Frame & Body/FR_A0500 (Clutch activation system)/Screen epsabox/fig8.PNG
