EOSCogniton/STUF2019/SU - Suspension/05 - Essais/Excels essais Optimus/collage alu carbone 05_02_19/received_300290354019059.jpeg

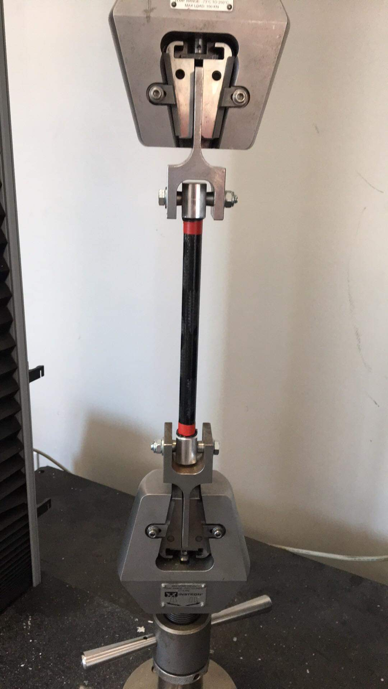
SU - Suspension/05 - Essais/Excels essais Optimus/collage alu carbone 05_02_19/received_300290354019059.jpeg
