EOSCogniton/STUF2019/SU - Suspension/05 - Essais/Excels essais Optimus/Collage_alu_alu_31_01_19/received_213312306213186.jpeg

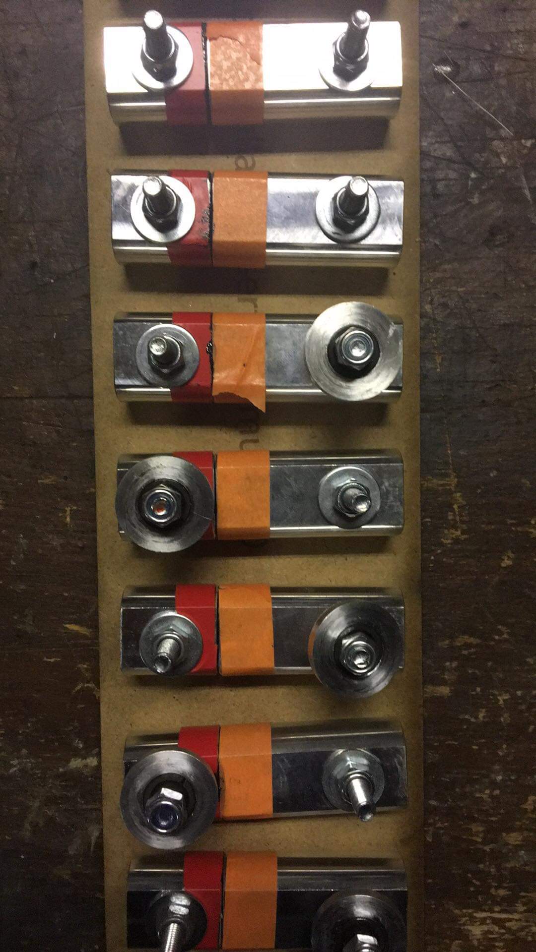
SU - Suspension/05 - Essais/Excels essais Optimus/Collage_alu_alu_31_01_19/received_213312306213186.jpeg
