EOSCogniton/STUF2019/SU - Suspension/SU_A0100 (Upper Front A-Arms)/circlips_gorge.png

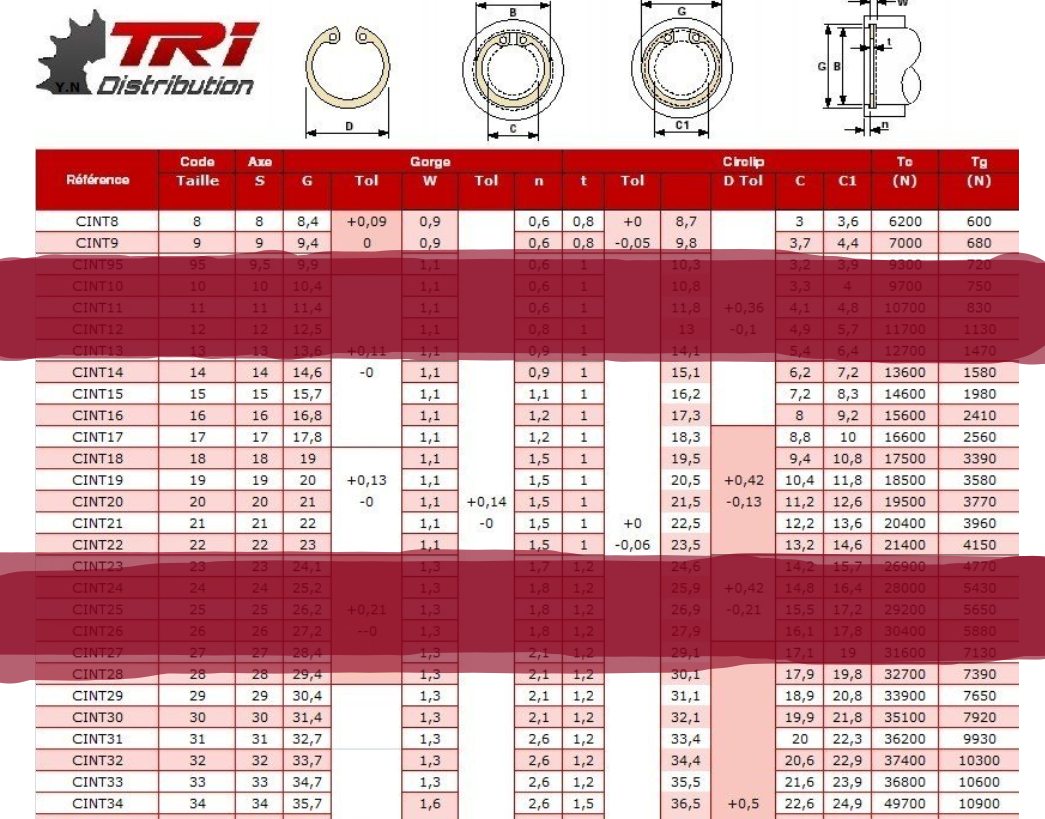
SU - Suspension/SU_A0100 (Upper Front A-Arms)/circlips_gorge.png
