EOSCogniton/STUF2019/SU - Suspension/SU_A0100 (Upper Front A-Arms)/Dimensionnement_triangles/chape/chape_1_contrainte_1.PNG

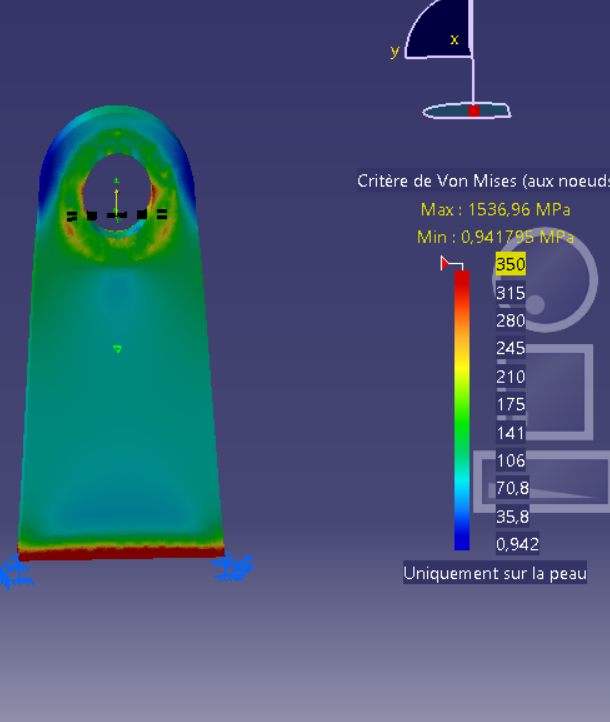
SU - Suspension/SU_A0100 (Upper Front A-Arms)/Dimensionnement_triangles/chape/chape_1_contrainte_1.PNG
