EOSCogniton/STUF2019/SU - Suspension/SU_A0100 (Upper Front A-Arms)/Dimensionnement_triangles/Insert_PM_arriere_bas_gauche/accel_0_77G_Vulcanix_contrainte_1.PNG

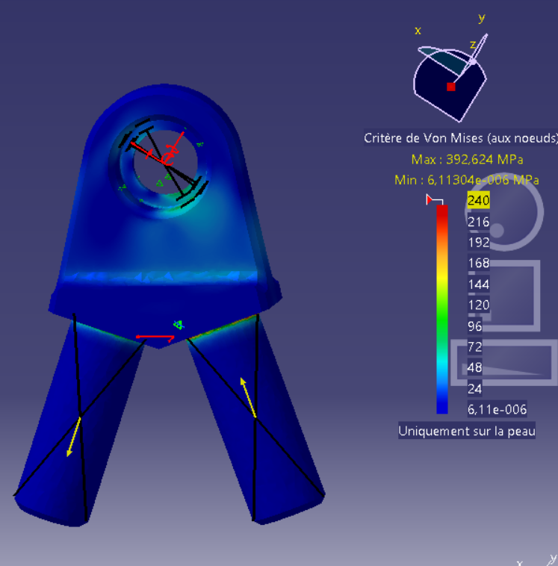
SU - Suspension/SU_A0100 (Upper Front A-Arms)/Dimensionnement_triangles/Insert_PM_arriere_bas_gauche/accel_0_77G_Vulcanix_contrainte_1.PNG
