EOSCogniton/STUF2019/SU - Suspension/SU_A1000 (Front Upright Assy)/DS_wheel&tire.jpg

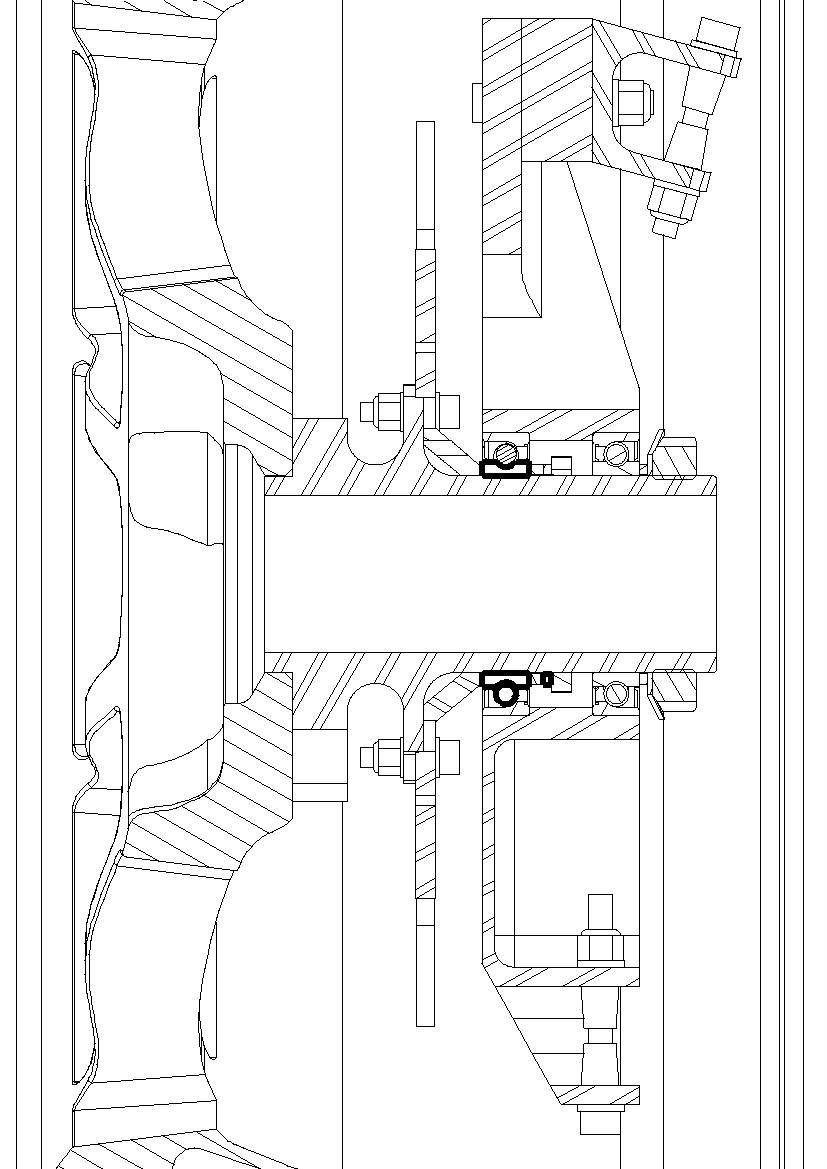
SU - Suspension/SU_A1000 (Front Upright Assy)/DS_wheel&tire.jpg
