EOSCogniton/STUF2019/SU - Suspension/SU_A1000 (Front Upright Assy)/FEA/81118 - Brake 2G Optimus - Stress.PNG

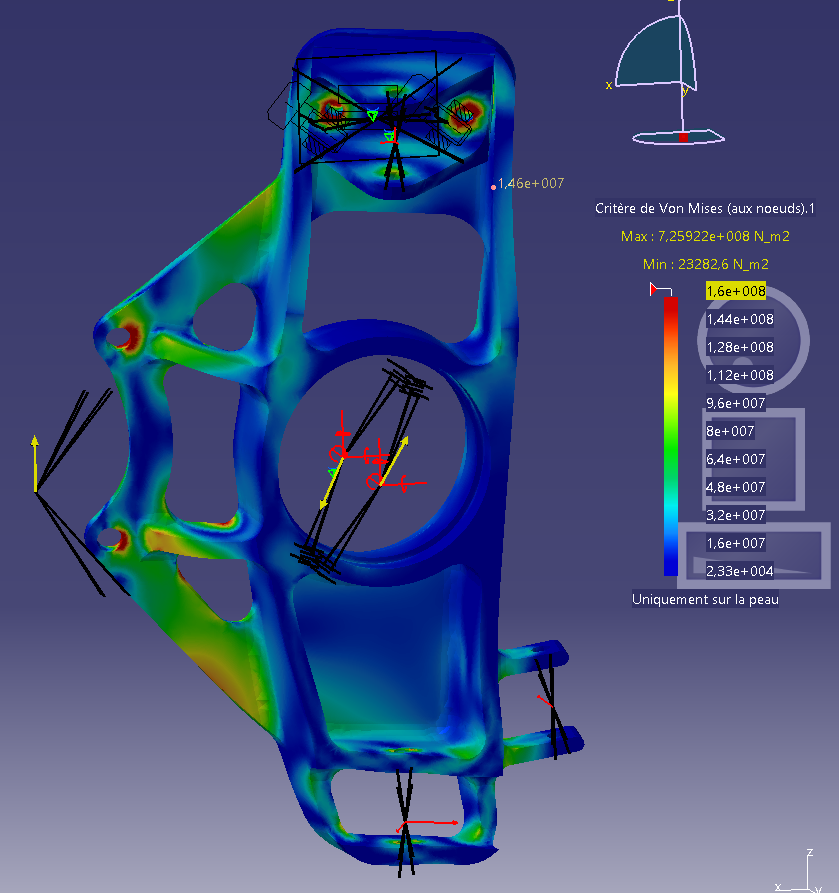
SU - Suspension/SU_A1000 (Front Upright Assy)/FEA/81118 - Brake 2G Optimus - Stress.PNG
