EOSCogniton/STUF2019/SU - Suspension/SU_A1000 (Front Upright Assy)/FEA/91118 - Bump 3G Optimus - Displacement.PNG

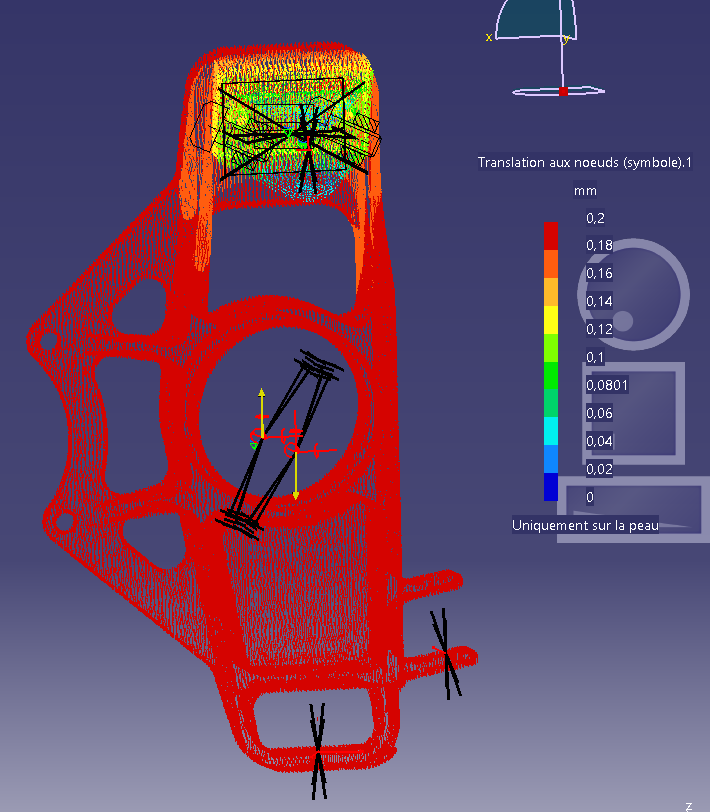
SU - Suspension/SU_A1000 (Front Upright Assy)/FEA/91118 - Bump 3G Optimus - Displacement.PNG
