EOSCogniton/STUF2019/SU - Suspension/SU_A1000 (Front Upright Assy)/FEA/101118 - Brake 2G Optimus - Stress - Hub.PNG

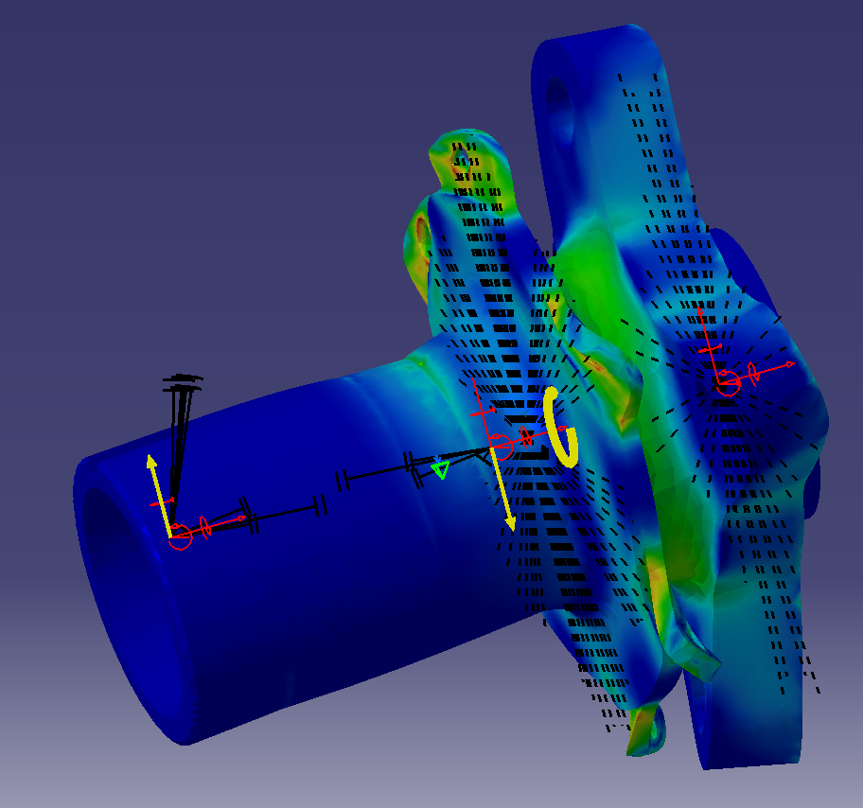
SU - Suspension/SU_A1000 (Front Upright Assy)/FEA/101118 - Brake 2G Optimus - Stress - Hub.PNG
