EOSCogniton/STUF2019/SU - Suspension/SU_A1000 (Front Upright Assy)/FEA/211118 - Left Turn 2G Custom Optimus - Stress.PNG

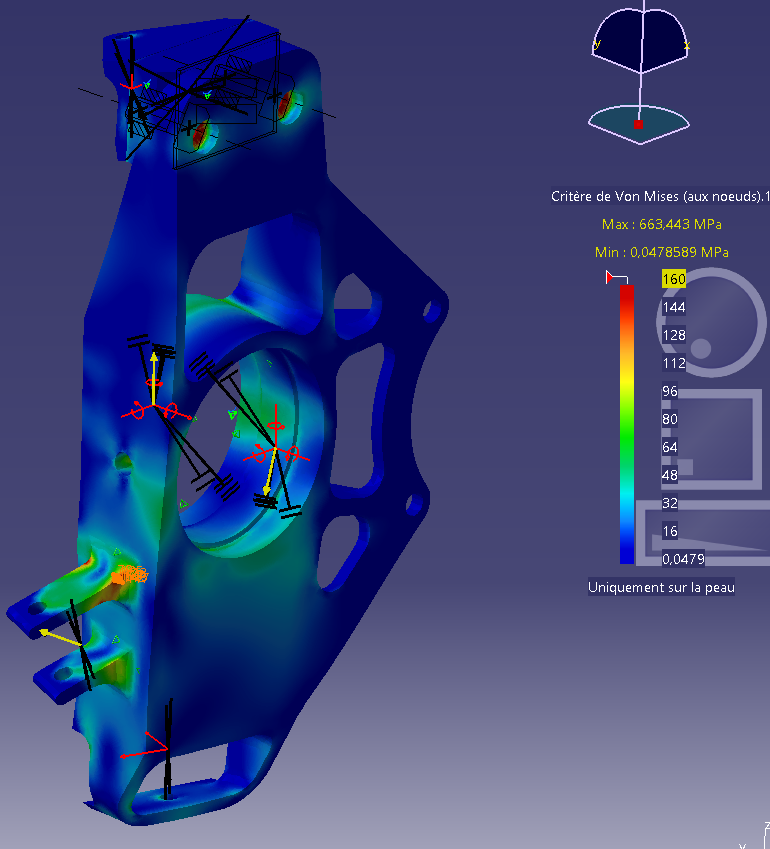
SU - Suspension/SU_A1000 (Front Upright Assy)/FEA/211118 - Left Turn 2G Custom Optimus - Stress.PNG
