EOSCogniton/STUF2019/SU - Suspension/SU_A1000 (Front Upright Assy)/FEA/221118 - Brake 2G Optimus - Stress.PNG

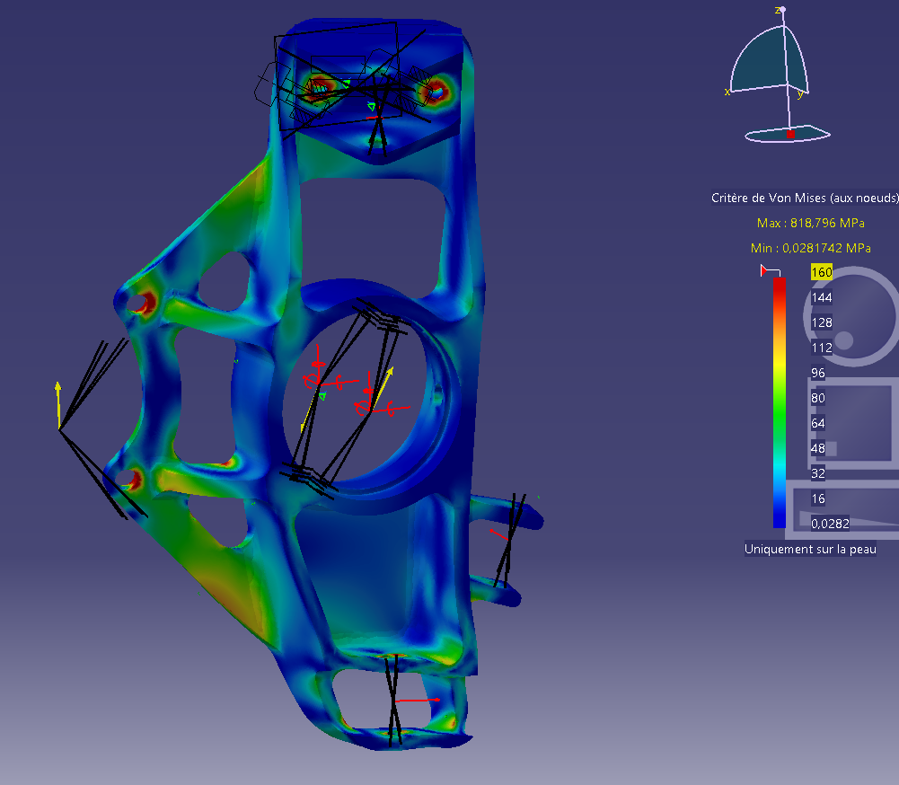
SU - Suspension/SU_A1000 (Front Upright Assy)/FEA/221118 - Brake 2G Optimus - Stress.PNG
