EOSCogniton/STUF2019/SU - Suspension/SU_A1000 (Front Upright Assy)/FEA/231018 - Brake 2G Vulcanix - Displacement- 2 nervures.PNG

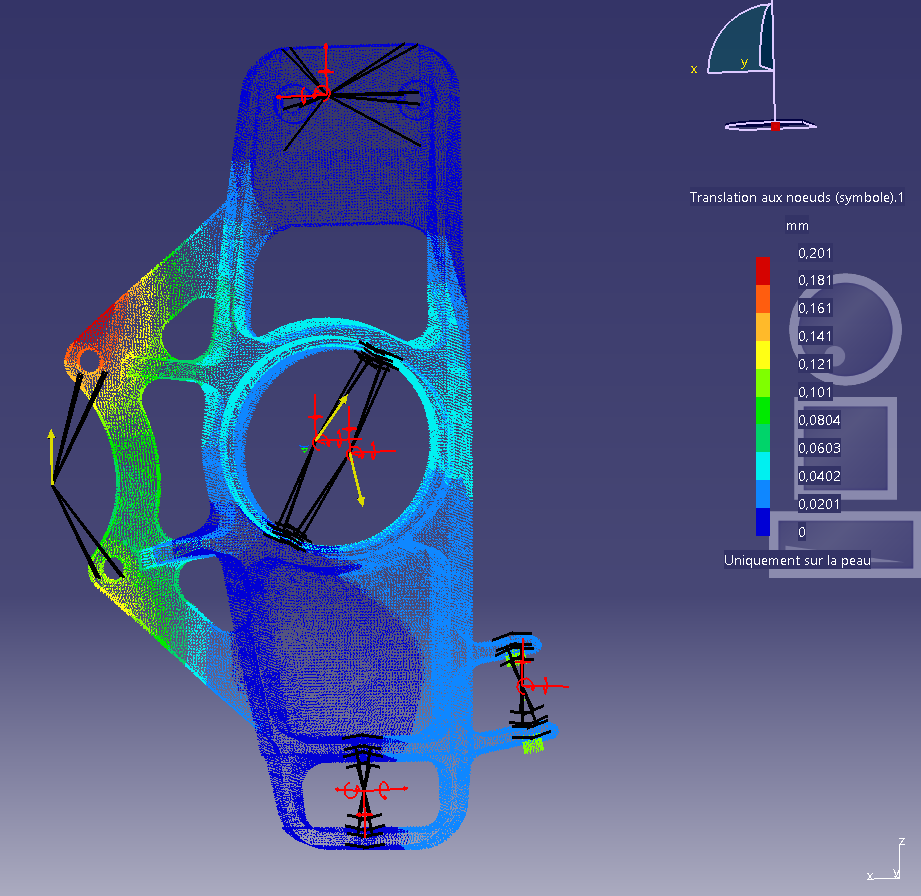
SU - Suspension/SU_A1000 (Front Upright Assy)/FEA/231018 - Brake 2G Vulcanix - Displacement- 2 nervures.PNG
