EOSCogniton/STUF2019/SU - Suspension/SU_A1000 (Front Upright Assy)/MEP/Brut moyeu.PNG

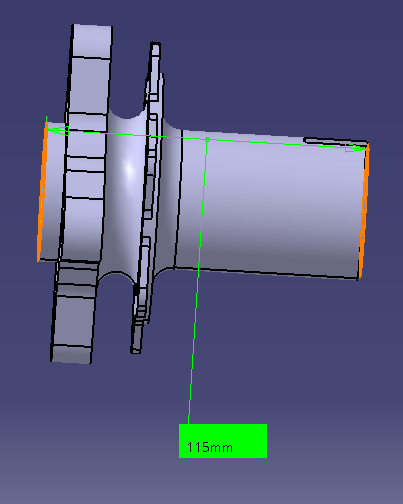
SU - Suspension/SU_A1000 (Front Upright Assy)/MEP/Brut moyeu.PNG
