EOSCogniton/STUF2019/SU - Suspension/SU_A1000 (Front Upright Assy)/MEP/SU_10001 (Front Left Upright).jpg

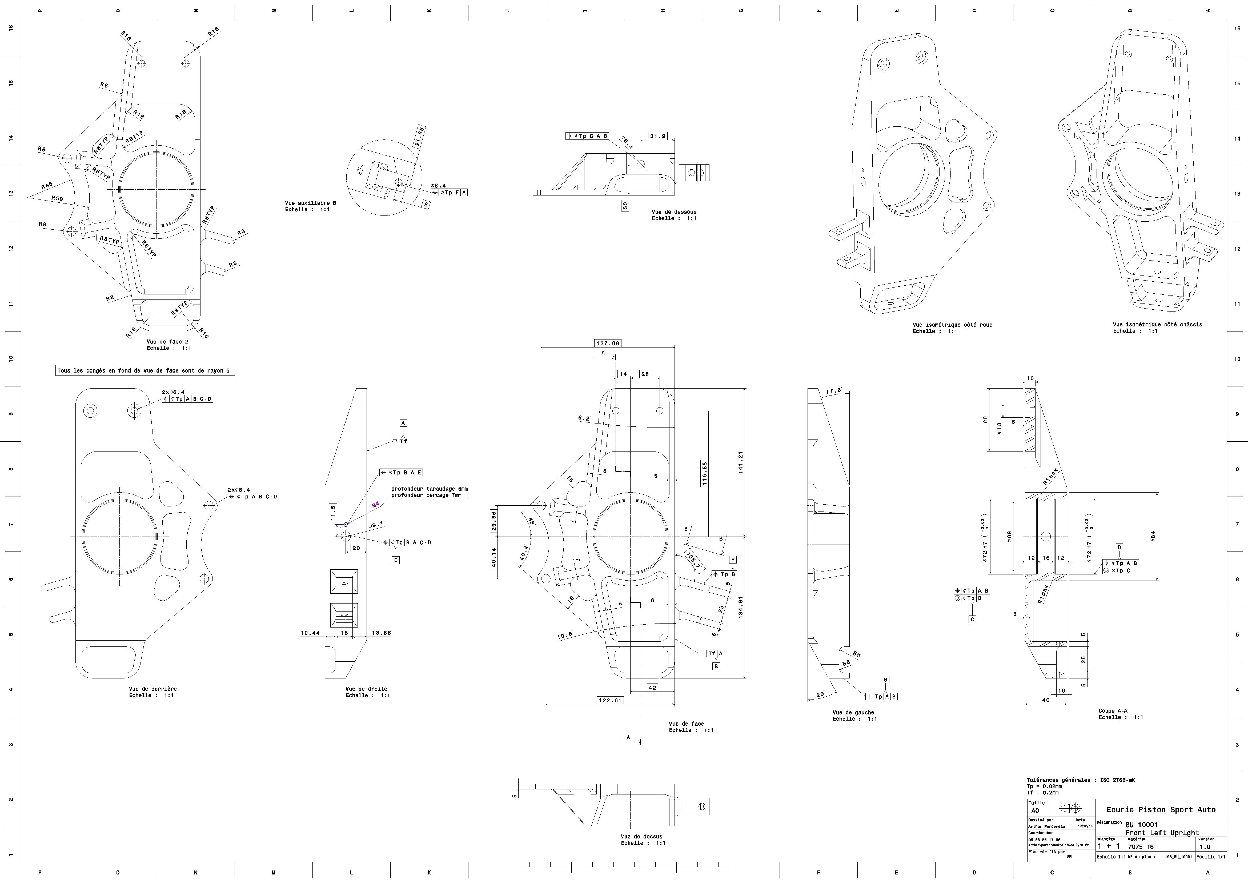
SU - Suspension/SU_A1000 (Front Upright Assy)/MEP/SU_10001 (Front Left Upright).jpg
