EOSCogniton/STUF2019/SU - Suspension/SU_A1100 (Rear Upright Assy)/MEP/SU_11001 (Rear Left Upright).jpg

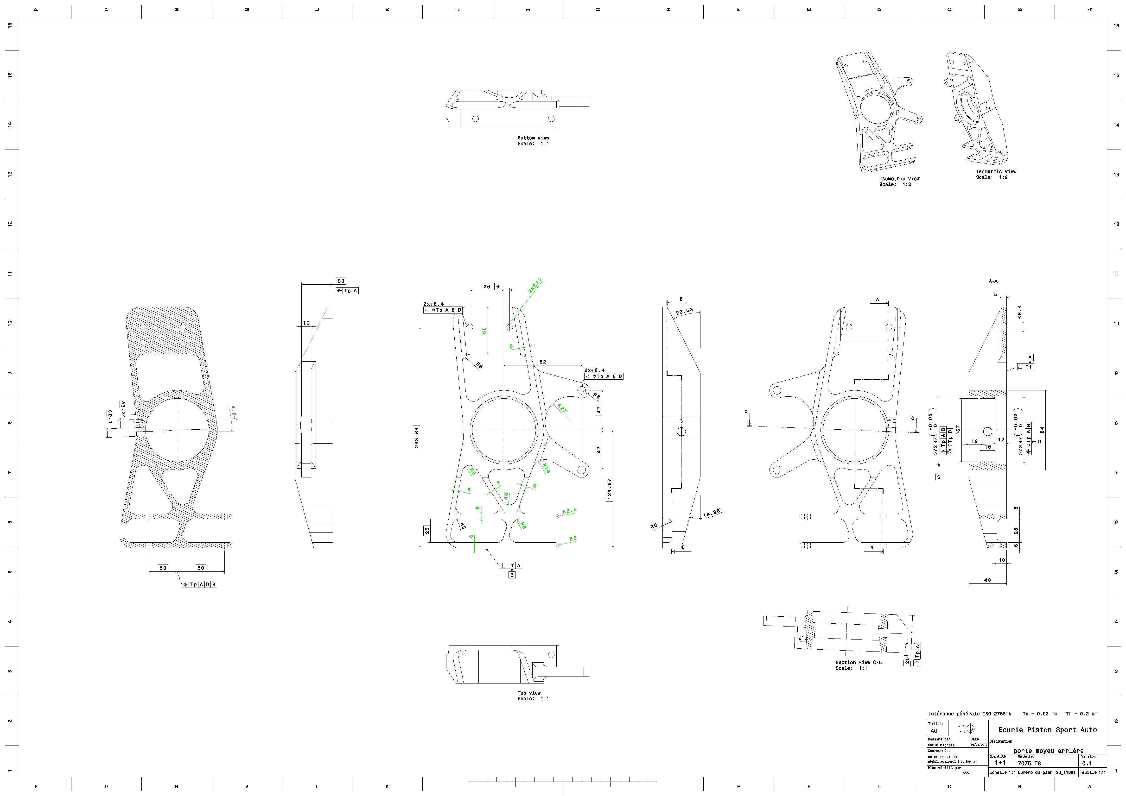
SU - Suspension/SU_A1100 (Rear Upright Assy)/MEP/SU_11001 (Rear Left Upright).jpg
