EOSCogniton/STUF2019/WT - Wheels, Wheel Bearing & Tires/WT_A0200 (Front Hub)/MEP/WT_02001 (Front Hub).jpg

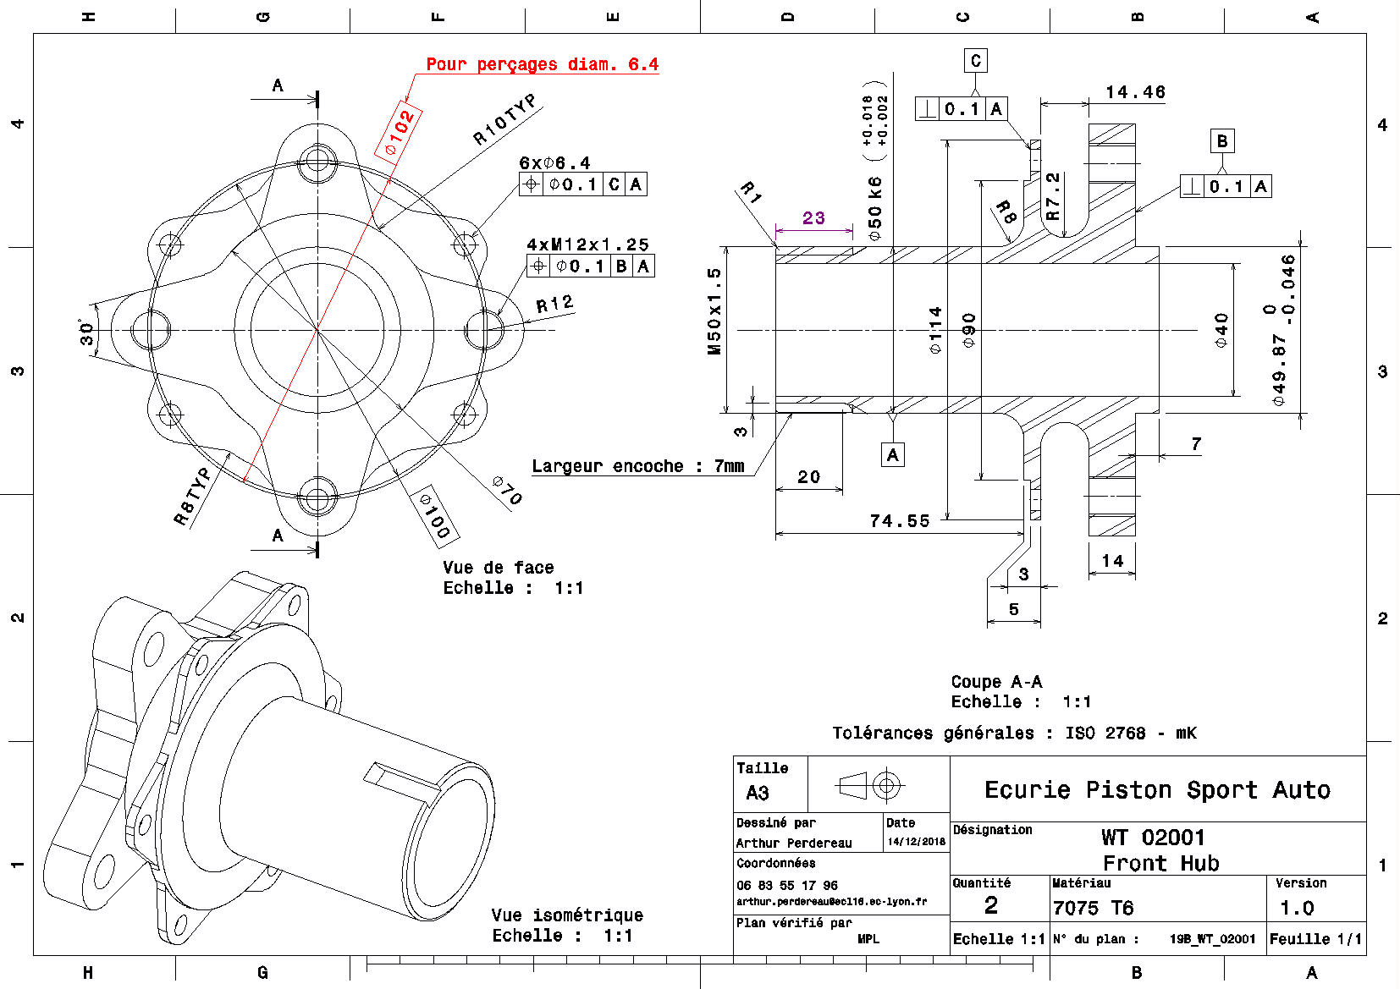
WT - Wheels, Wheel Bearing & Tires/WT_A0200 (Front Hub)/MEP/WT_02001 (Front Hub).jpg
