EOSCogniton/STUF2019/WT - Wheels, Wheel Bearing & Tires/WT_A0200 (Front Hub)/MEP/WT_02006 (Speed Sensor Disc Spacer 3mm).jpg

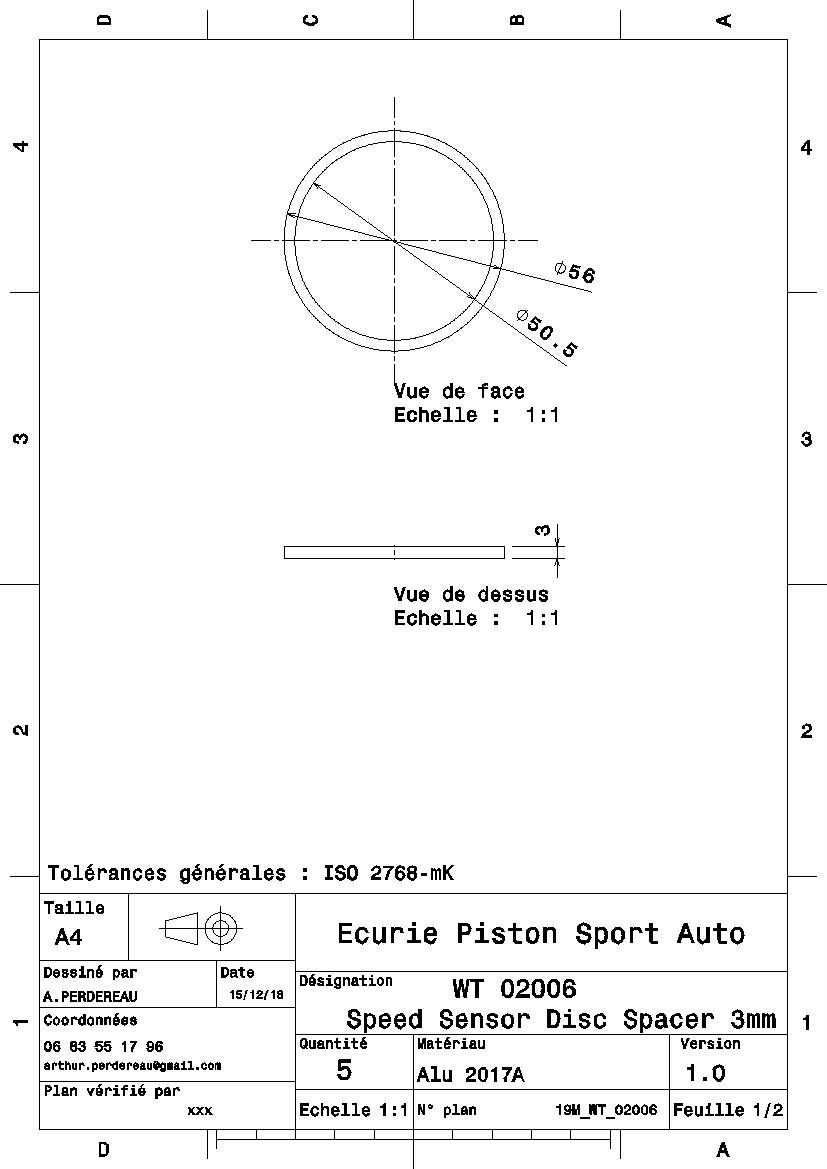
WT - Wheels, Wheel Bearing & Tires/WT_A0200 (Front Hub)/MEP/WT_02006 (Speed Sensor Disc Spacer 3mm).jpg
