EOSCogniton/STUF2019/WT - Wheels, Wheel Bearing & Tires/WT_A0300 (Rear Hub)/D4483.jpg

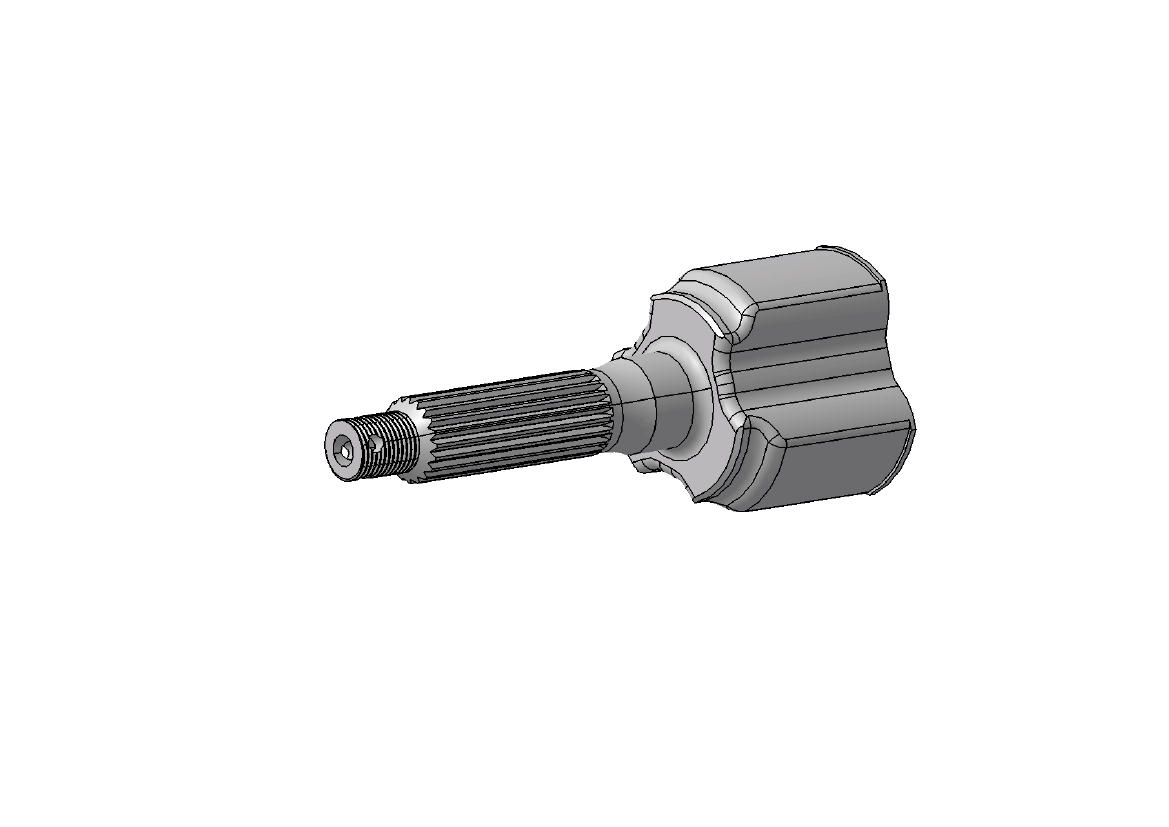
WT - Wheels, Wheel Bearing & Tires/WT_A0300 (Rear Hub)/D4483.jpg
