EOSCogniton/STUF2019/CR - Cost Report/Compléments et réglements/Présentation Cost.pptx

## Présentation Cost

06.03.2019

## Agenda

1. la présentation rapide 3 documents (BOM, DBOM et CBOM)
2. Essayer de nous expliquer comment ça se passe la mise en place des calculs de coûts pour le CBOM
3. la présentation des 3 postes dont tu m'as parlé (a priori directement relié au 3 documents ) et comment se repartit le travail entre les 3 personnes
4. comment les autres membres de l'équipe vont pouvoir nous aider et sur quelles parties
5. comment se passe le fait de remplir tout en ligne et qui est ce que ça concerne
6. des exemples des 3 documents si possible

## Remarques préliminaires

- Couts correspondant à la voiture présentée (pas pour 1000 véhicules)
- DBOM nouveau pour moi (tout était détaillé pour moi)
- Pas d’image directement dans la BOM
- Export du pdf depuis le site

## 1. Présentation des 3 documents

- BOM
  - Liste de l’ensemble des pièces
  - Pas de détail (i.e. pas de subdivision en material, fasteners, tooling, processes)
  - Passe les fasteners dans la BOM ?
- DBOM
  - BOM détaillée → avec subdivisions material, processes, fasteners, tooling
  - Document tel que l’EPSA faisait toujours

## 1. Présentation des 3 documents

- CBOM
  - DBOM mais avec un prix à côté de chaque pièce
  - Pas de tableau pour les prix → doit faire son modèle tout seul

## 2. Calcul des couts

- Développer un modèle de cout → Similaire au chiffrage que fait une entreprise
  - Analyser le process complet (liste des tâches + durée + nombre de personne)
  - Trouver des couts horraires
  - Penser aux couts annexes (nettoyage, chauffage, …)
  - Possibilité de complexifier → Apprentis ou personne expérimentée ?

## 2. Calcul des couts

- Piste pour un début
  - Analyser les process
  - Demander aux partenaires comment ils calculent les devis
  - Trouver des prix à l’heure
  - Faire un excel pour un calcul plus rapide
  - Trouver le prix des matériaux au kg
→ A la fin le prix doit paraitre plausible et le modèle strict et bien fait. Impossible de vérifier à la virgule près ;)

## 3. Présentation des postes

- Responsable des couts
  - Créer les modèles de couts
  - Préparer le real case
- Responsable homogénéité (DBOM)
  - Fait en sorte que le cost est homogène
  - Décide de templates, comment doit être inséré une pièce fraisée, tournée, …
  - Décide des documents additionnels
- Responsable BOM
  - Insert en ligne les pièces
  - (Prépare des documents additionnels)

## 4. Interface avec l’équipe

- Préparer le travail de celui qui entre les pièces (tableaux par ex)
- Préparation des documents additionnels
  - Plans
  - Vues éclatées
  - Photos / screenshot CATIA
- Vérification

## 5. Remplissage en ligne

- Tout le monde peut insérer des pièces
  - Assurer l’homogénéité
- Long, pas de copier-coller !
- Plus de temps → Jusqu’à ~15 jours avant la compétition
- Limite en caractères ?

## 6. Examples

## Real case

- Thèmes proposés
  - Kohle: 2-3 questions, 30s pour réfléchir
  - Discussion plus libre
    - Pour moi juste des questions vagues
    - Préparation d’un exemple de pièce fabriquée de 2-3 façon différente + impact sur les différents points chiffrés

## Documents additionels

- Vues éclatées
- Plans
- Vue des pièces
- Pas trop de documents

## Présentation

- 2 personnes pour présenter les BOM
- Responsable couts pour la CBOM
- 1-2 personnes prêtes à raconter des choses sur la voiture
- Préparer quelque chose pour le Realcase
- Quelqu’un qui cherche dans les documents additionnels

## Conseils

- Soyez rigoureux et minutieux
→ Epreuve pas compliquée et rapportant gros si on se donne les moyens de réussir
