EOSCogniton/STUF2019/CR - Cost Report/Oral/FS_ATA/Prototype_and_mass_production.pptx

## Prototype and mass production

Examples of manufacturing processes for mass production

Different manufacturing processes

Manufacturing processes (for prototyping and mass production):
- Milling
- Turning
- Laser and waterjet cut
- 3D printing
- Weldments
Manufacturing processes (for mass production):
- Stamping
- Foundry
- Broaching
- Injection molding

Exhaust system

Prototype: Complex geometry to realise acoustic waves.

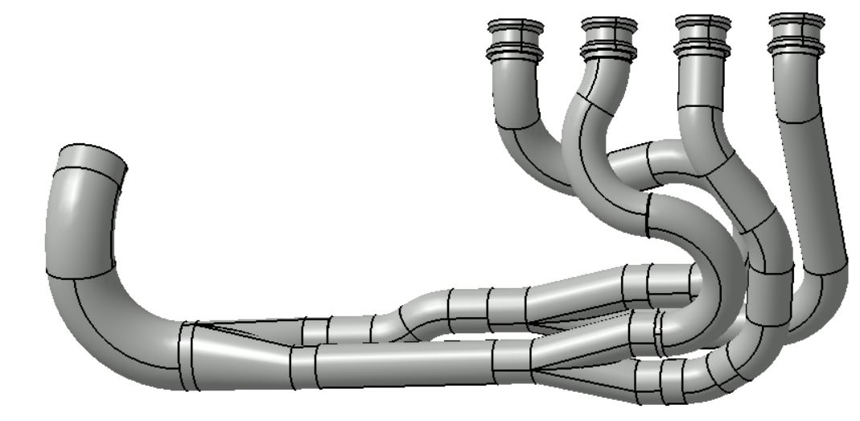
[picture p456: figure]

Intake system

Prototype: 3D printed part + aluminium laser cutted part.

Mass production:
Left: Changement of manufacturing process. Thermoforming from extruded pipes + injection molding.
Right: Injection molding.

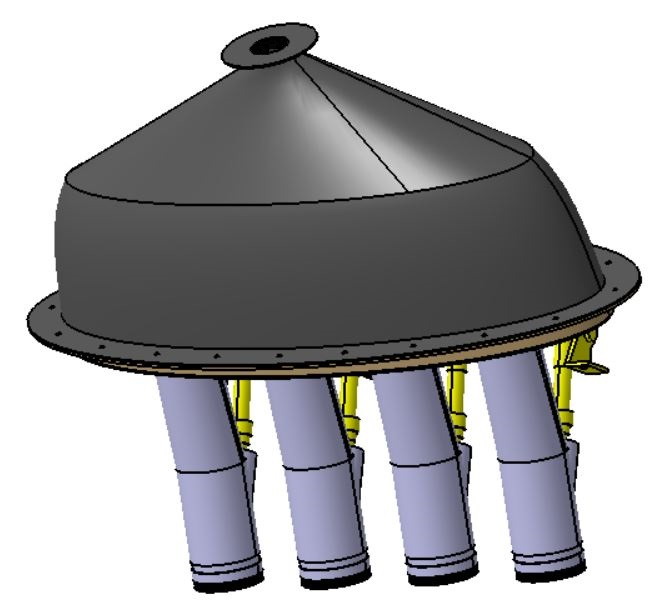
[picture p457: figure]
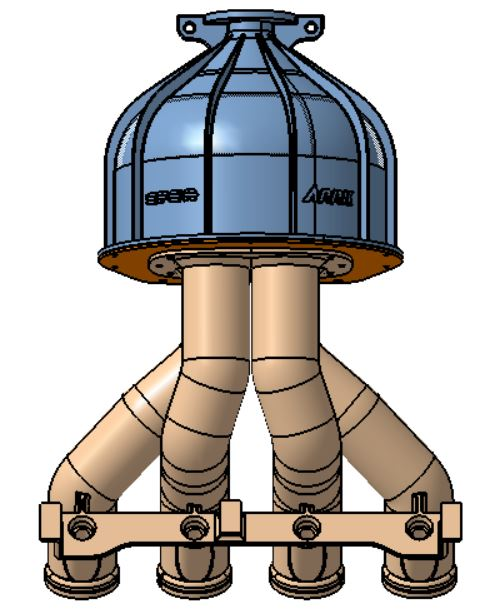
[picture p458: figure]

Mass production: Reduce complexity to reduce cost.

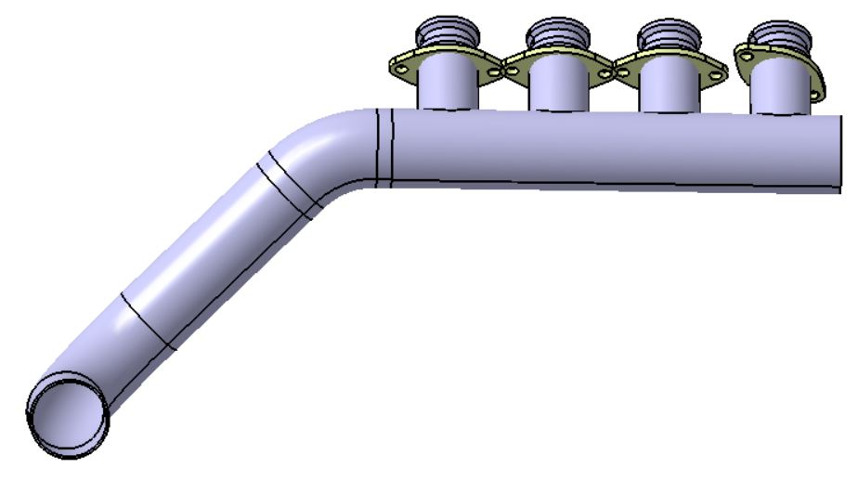
[picture p459: figure]

Oil pan

Example of cost evolution

See below an example of cost evolution versus complexity and size of the series for 3D printing and conventionnal production.

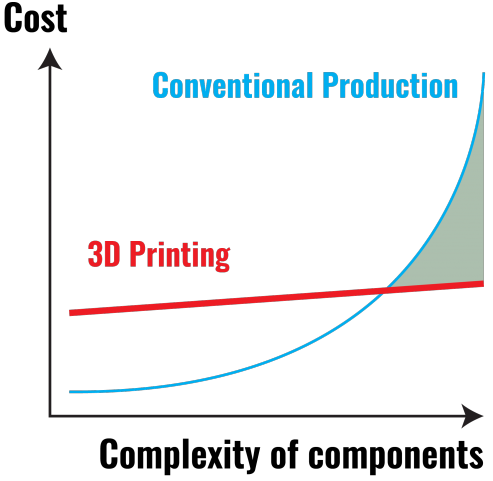
[picture p460: figure]
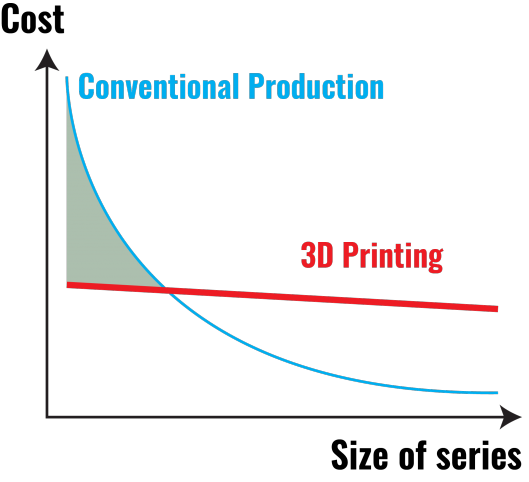
[picture p461: figure]

Prototype: Aluminiun laser and waterjet cutted part + welding.

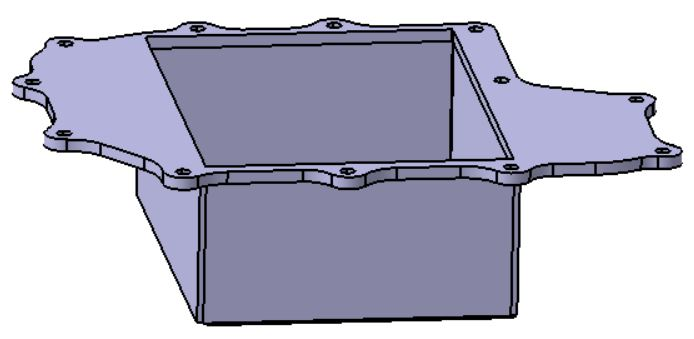
[picture p462: figure]

A-arms

Prototype: CFRP tubes with aluminium machined parts.

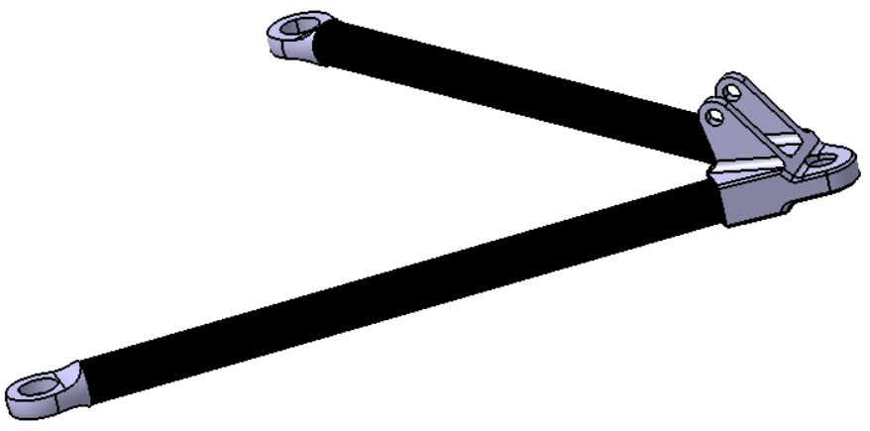
[picture p463: figure]

Mass production: Changement of manufacturing process.
Stamping process.

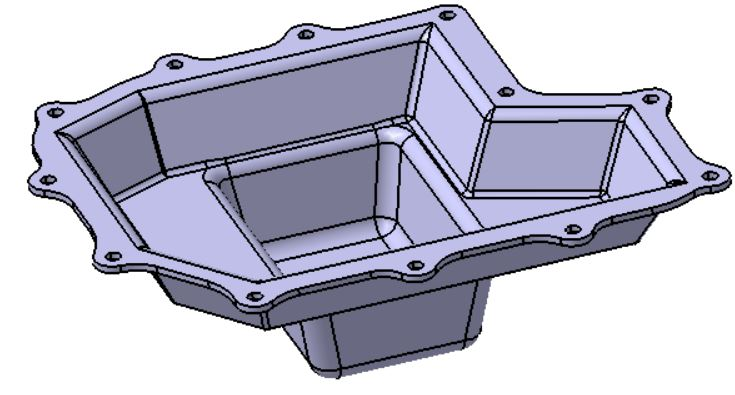
[picture p464: figure]

Prototype: Changement of materials, manufacturing and assembly processes.
Weldments, steel with tubes and laser cutted part.

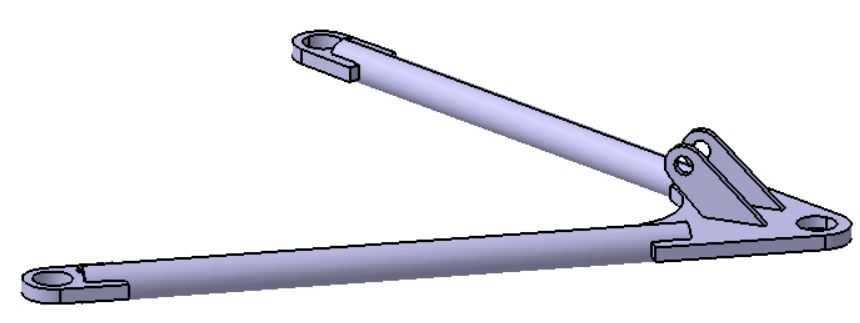
[picture p465: figure]
