EOSCogniton/STUF2019/CR - Cost Report/Oral/FS_ATA/Diagrammes.pptx

Crush
Material/ Thermal recycling:
Raw material or fuel for Cement and Blast furnace
Thermal recycling:
Combustion
Separation
Fiber
Resin
Thermal/Chemical Recyling:
Decomposed oil (fuel)
Material recycling:
CFRP raw material
CFRP waste
Material recycling:
Raw material of CFRP

## Slide 2

Rubber powder
Grinding1
Steel wires
Pyrolise
Magnetic separation
Grinding 2
…
Fiber separation
Material recycling
Material recycling:
Raw material
Material recycling
Fibers
Recycling
Crushing
Retreated tires
Material recycling

## Slide 3
