EOSCogniton/STUF2019/CR - Cost Report/Oral/FS_ATA/Cost_discussion_with_judges.docx

Cost understanding

Support document

I. Differences between prototype and mass production

Different types of manufacturing processes: Machining (Milling, Turning), Laser and waterjet cut, 3D printing, Stamping, Foundry, Forging, Broaching, Weldments, Injection molding, …


Comparison of 3D printing versus conventional production: cost versus complexity


Comparison of 3D printing versus conventional production: cost versus size of series

Pour le support oral :

- Mettre courbes précédentes + liste usinage
- Exemple de pieces réalisés en série ou grosse production
  - Triangles carbones et acier (mécano soudé)
  - Pour admission, truc en injection plastique ? (admission Dynamix ?)
    - Admission Optimus en deformation plastique
    - Admission Dynamix en injection plastique
  - Pour échappement, passage d’un 4 en 2 en 1 à un rateau ?
  - Carter d’huile en punching/stamping
II. Resource and cost planning

Global resource planning

See V cycle drawing.

End of… | Previsionnal date | Real date | Delay (in days)
High level design | 6 sept. 2018 | 13 sept. 2018 | 7 days
Detailed design | 13 nov. 2018 | 20 nov. 2018 | 7 days
Fabrication & unit testing | 15 feb. 2019 | 8 mar. 2019 | 21 days
System testing & integration | 16 mar. 2019 | 5 apr. 2019 | 20 days
Roll out | 10 apr. 2019 | 10 apr. 2019 | 0 days
First testing | 20 apr. 2019 | 27 apr. 2019 | 7 days

Detailed resource planning

Utilisation of Gantts to plan and monitor the work.

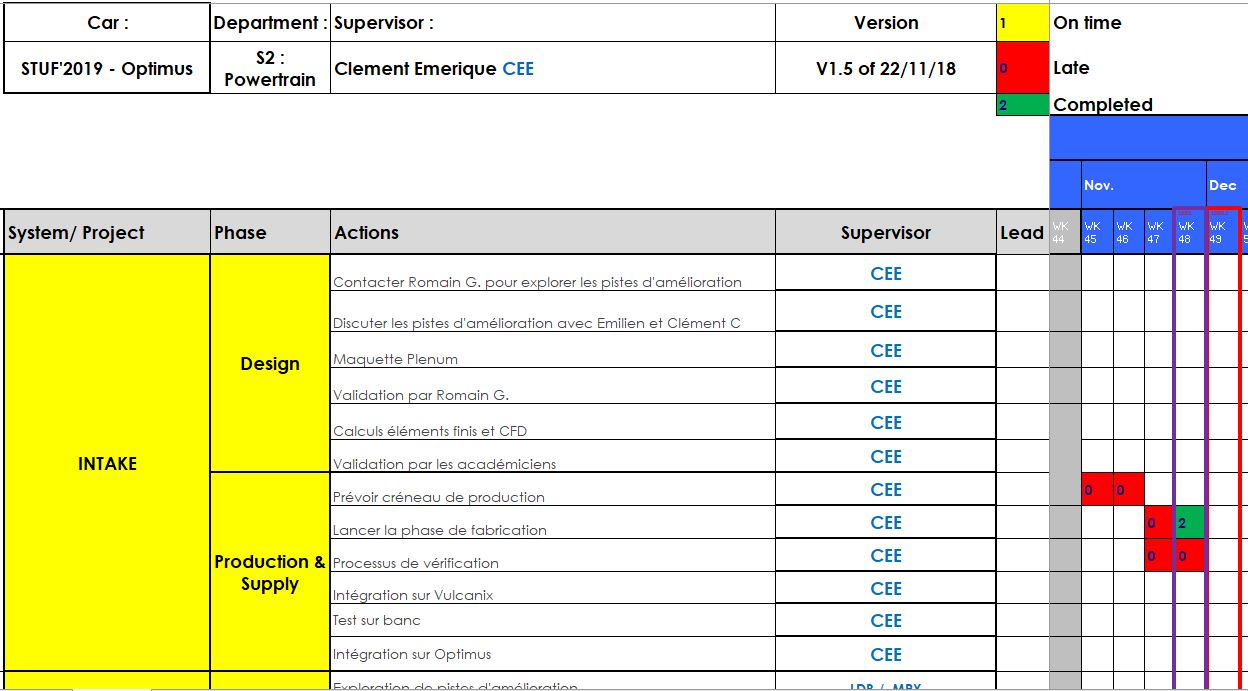
[picture p466: figure]

Example of Gantt layout

Manufacturing planning

- Gantt of the production phase (Manufacturing_Gantt)
- Excel of the repartition of the production between our partners, sponsors and suppliers (Manufacturing_framework)

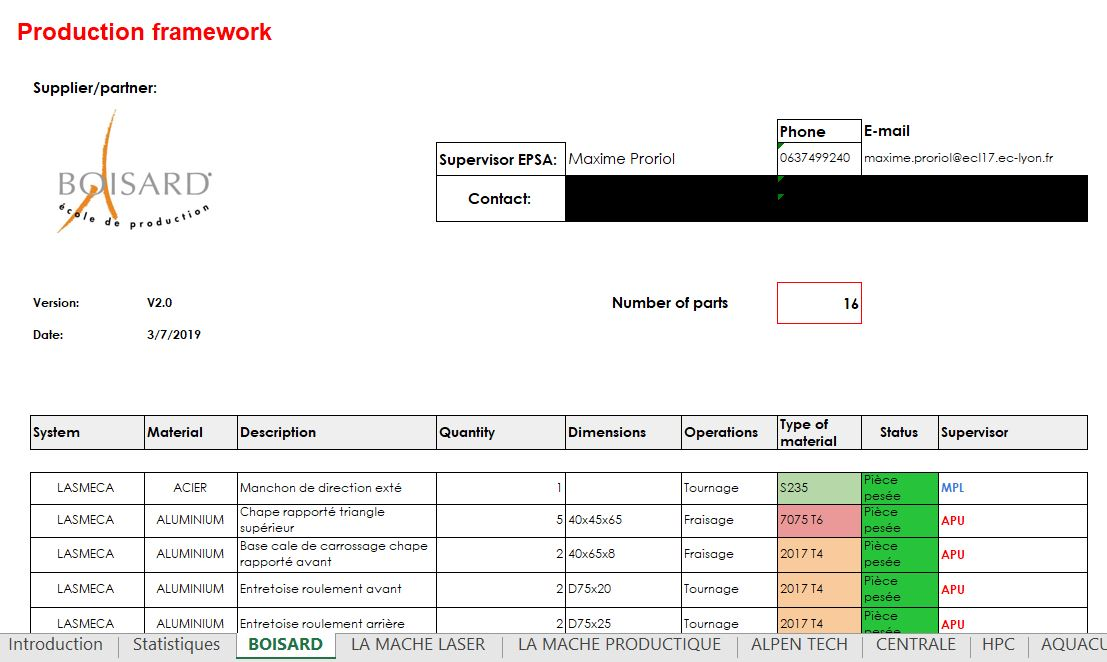
[picture p467: figure]

Production framework layout

Cost planning

See Previsionnal Expenses drawing.

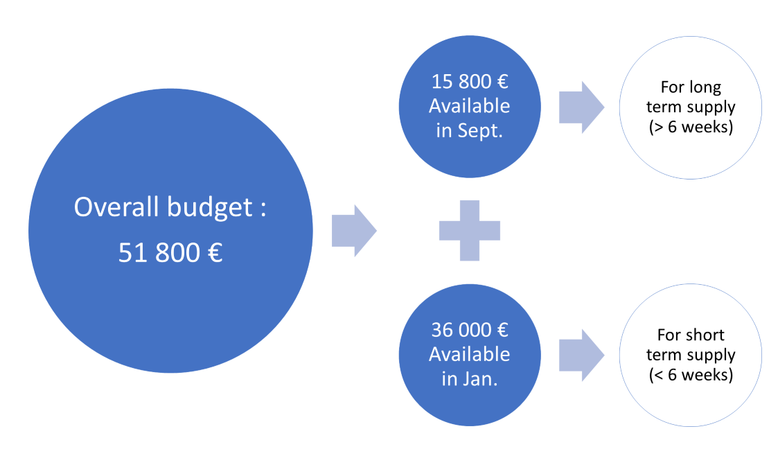
[picture p468: figure]

Example of Gantt layout

System | Previsionnal | Real | Differences (€) | Differences (%)
Suspension | 12 630,00 € | 19 480,00 € | 6 850,00 € | 35%
Powertrain | 14 680,00 € | 14 046,00 € | -634,00 € | -5%
Electrical | 6 810,00 € | 6 893,00 € | 83,00 € | 1%
Frame & body | 880,00 € | 2 005,00 € | 1 125,00 € | 56%
Miscellaneous | 11 400,00 € | 9 994,00 € | -1 406,00 € | -14%
Total | 46 400,00 € | 52 418,00 € | 6 018,00 € | 11%
Budget | 51 800,00 € | 52 600,00 €
Financial provisions | 5 400,00 € | 182,00 €

Summary of previsionnal and real expenses

III. Financial and production risk management

An example of a financial risk

Supply of wheels’ bearings:

- Delay of delivery due to absence of stock
  - Initially planned on March
  - Delivery delayed to the beginning of June
- To respect the roll-out deadline, wheels bearings supplied with the budget
  - Diminution of the financial provision

An example of a production risk

A fire destroyed the workshops of our partner during the manufacturing of the uprights and hubs. The team reacted quickly to move the production to another partner and to the university workshop.

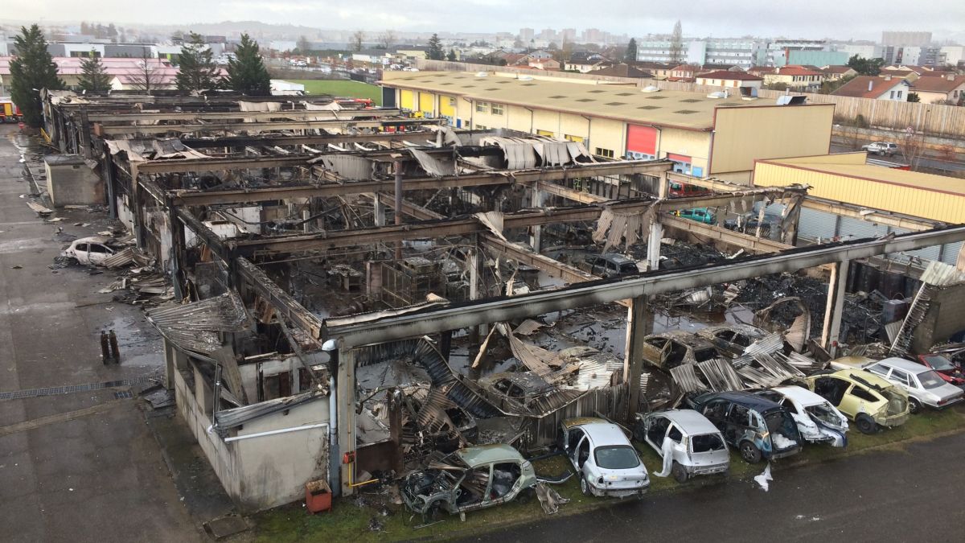
[picture p469: figure]

Fire in the workshops of our partner Boisard

IV. Make or buy decisions

See ratio of price versus weight saved.

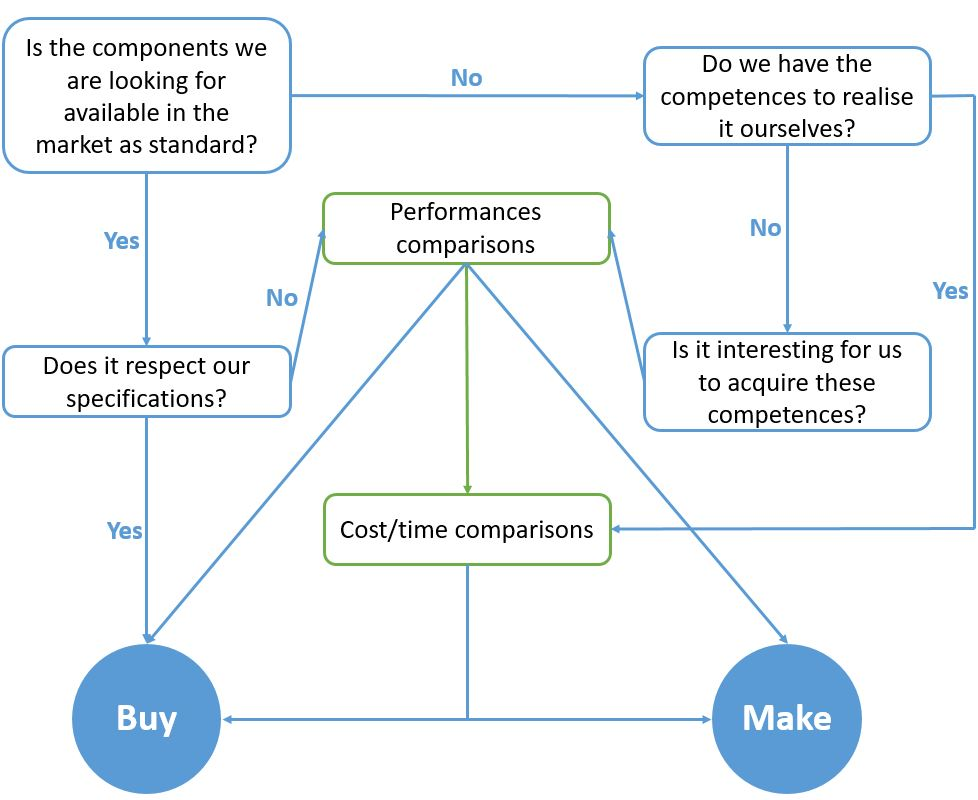
[picture p470: figure]

Diagram to illustrate buy and made decisions

Rajouter Chemins de decisions pour certains composants du véhicule ?

V. Environmental influence of the vehicle production

Emulsion huile de coupe

Recyclage copeaux + parts

Recyclage huiles

Réutilisation composant acheté dans le commerce ou années précédentes

Réflexion autour E95

Réutilisation de motos accidentées

Prise en compte environnement dans perfo (mais poids faible car véhicule compétition)

Supports :

- Recycling of CFRP and other materials, oil s, …
  - Mettre en avant difficulté à recycler CFRP par rapport matériau métallique
- Second life for standard part
- During production (limit raw materials used, oil lubrification, traitement des copeaux, limiter nombre rebuts, favoriser production local, norme iso 14001…)
- Recycling of tires : https://www.youtube.com/watch?v=QLYQssSvnzk
  - https://www.youtube.com/watch?v=UczKhE6Cbhg
- For gasoline : Thinking about E85
VI. Effectiveness of financial planning

Général : Terme de paiement, quand acheter matos, … (cashflow)

Support oral :

- Mettre 2 graphiques résumant budget prévisionnel et reel
- Tableau résumant les différences
- Expliquer les différences
VII. Methods for software development cost calculation

Etudes des besoins -> spécifications des différentes fonctions ->

Couts = programmation mais aussi discussion avec client (inexistant en usinage avec normes mises en plan ou plutôt sur faisabilité), vérifications des codes, mutualisation des fonctions, backend et front end, débeugage (unitaire et global), éventuellement installation

Vente logiciel générique -> Temps de dvlp, volume de vente, ajouts de fonctionnalités, vente en packaging/modules annexes, rajout modules dans le temps -> vient du business plan

Pour support oral :

- Image cycle en V pour info
- Couts indexés sur nombre de fonctions, échelonné selon le niveau de complexité (3 niveaux par exemples)
- Possibilité de rajouter des options supp (front end, installation, maintenance…)
- Prix fixé au début mais qui peut évoluer sous les conditions suivantes :
  - Dépassement temps de réalisation fixé initialement (pénalités si entreprise, sinon payé d’avantage si cause = client (rajouts de fonctions, …))
- Détailler les couts fixes (salaires, ordi, bureaux, R&D, …)
- Exemple fonction Matlab (cahier des charges, déclinaison sous forme de fonctions, pas de front end, …)

Questions récurrentes :

- The part the most expensive on the car and its price?
- How many parts on the car?
- Price of the vehicle?
- If you had money issue, what would you do to resolve it?
- If you wanted to reduce environmental influence of the vehicle, what part would you change?
- Examples of part you would change from prototype to mass production?
