EOSCogniton/STUF2019/CR - Cost Report/Oral/FSN/Affiches.pptx

## TEMPLATE AFFICHE

Police : Raleway

## Workshop organisation

Haas VF-3SSYT
- 3 Axis CNC vertical milling machine
- Power: 22.4kW
- 12 000 rpm inline direct drive
- 1016 x 660 x 718 mm max capacity
- Tool changer capacity: 30+1
- Additional 4th axis
- Probe system for easier tool setup

Manpower
- 4 operator full-time and 1 operator part-time
  - Machine supervision
  - Assemblies (except welding)
  - Maintenance
  - Simple CAM/metrology
- 1 technician
  - Complex CAM/metrology
- 1 welder
- 1 engineer
  - General organisation
  - Sales
  - Complex CAM/metrology
- 1 administrative
  - Sales, supplies, invoices,…

Haas ST-35Y
- CNC lathe with Y axis
- Power: 29,8kW
- 3200 rpm spindle
- 457 x 584 mm max capacity
- 305 mm hydraulic chuck
- 24 station turret with 4000 rpm live tooling
- Probe system for easier tool setup
- Parts catcher

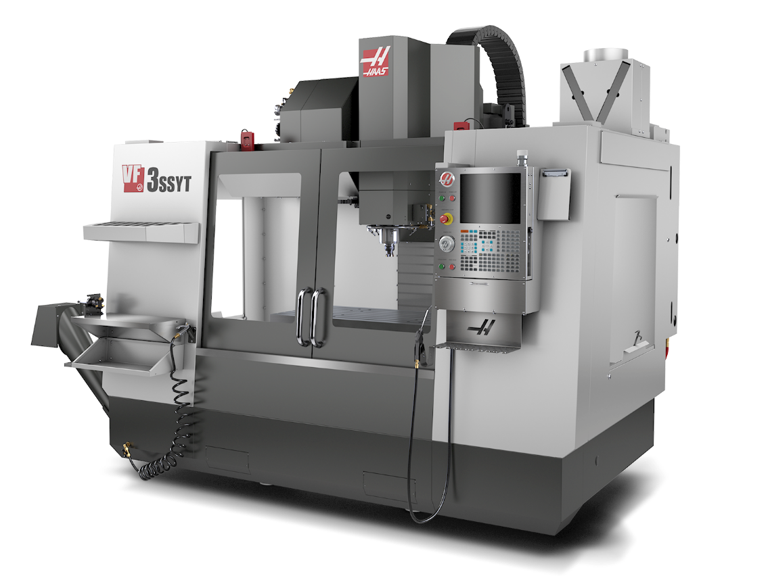
[picture p471: figure]

Office :
- Administrative
- Sales
- Development

Conventional mill and lathe

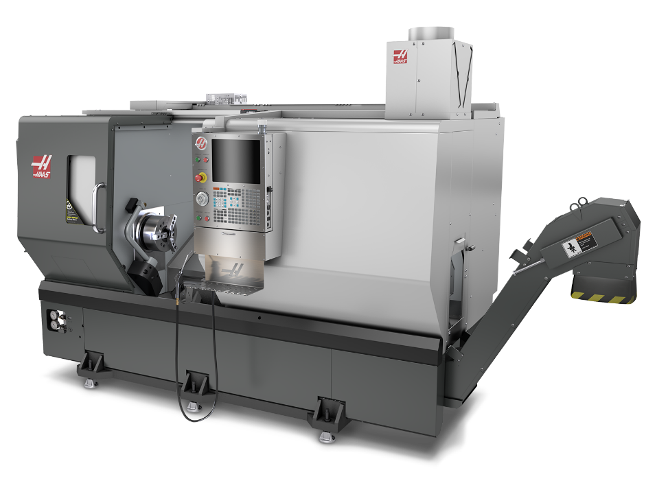
[picture p472: figure]
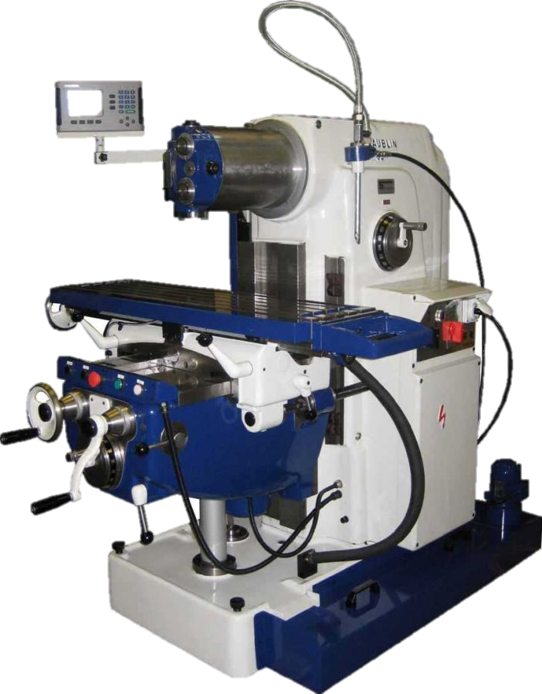
[picture p473: figure]
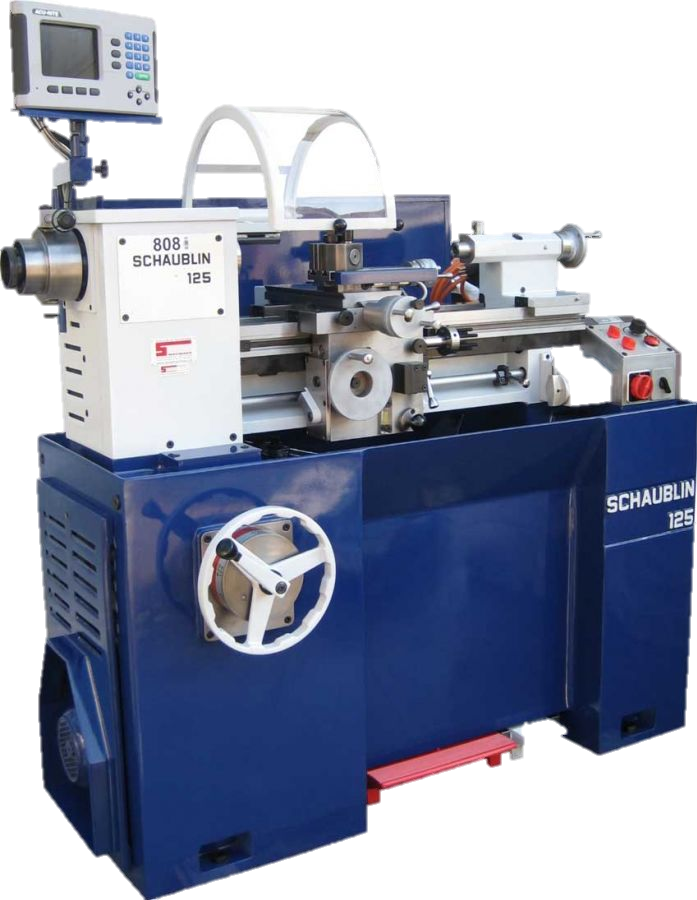
[picture p474: figure]

Storage Area :
- Materials stock
- Consumables
- Parts to assemble
- Tooling
- Critical spare parts
- …

Welding area:
- TIG welder
- Chiller
- Fume extractor
- Welding table
- Clamps/fixtures

Staff room

Metrology lab :
- Reference surfaces
- Profile projector
- Measurement column
- Micrometres

Baileigh FL-510HD-1000
- CNC laser table
- 1000 watt fiber laser
- 1500 x 3000 mm max capacity
- Thickness cutting capacity:
  - Steel: 9.5mm
  - Aluminium: 2.5mm

Assembly area:
- Manual sheet bender
- Hydraulic press
- Drill press
- Belt grinder
- Band saw
- …

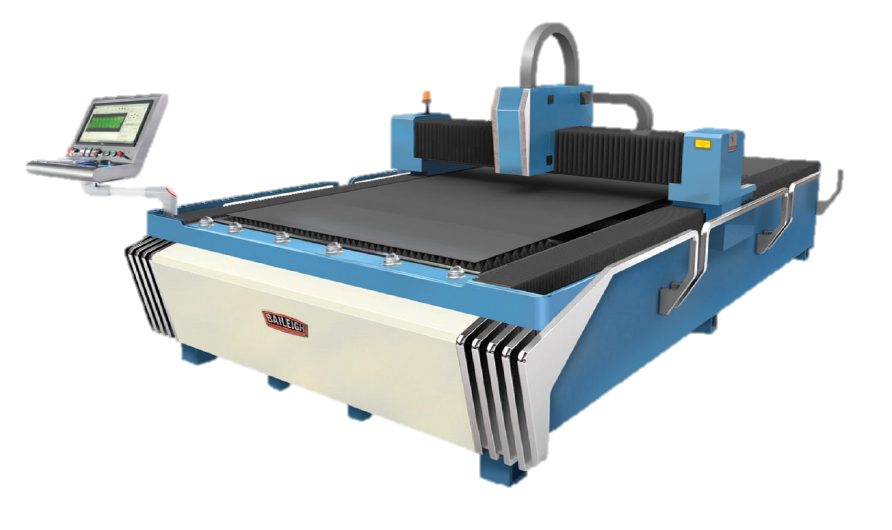
[picture p475: figure]

## Slide 3

15 800 €
Available in Sept. till Dec.
36 000 €
Available in Jan.
Overall budget :
51 800 €

For long term supply (> 6 weeks)

For short term supply (< 6 weeks)

## Slide 4

Buy

Made

## Slide 5
