EOSCogniton/STUF2019/CR - Cost Report/Oral/FS_ATA/Cost_Support_Ressources_Cost_Planning.pdf

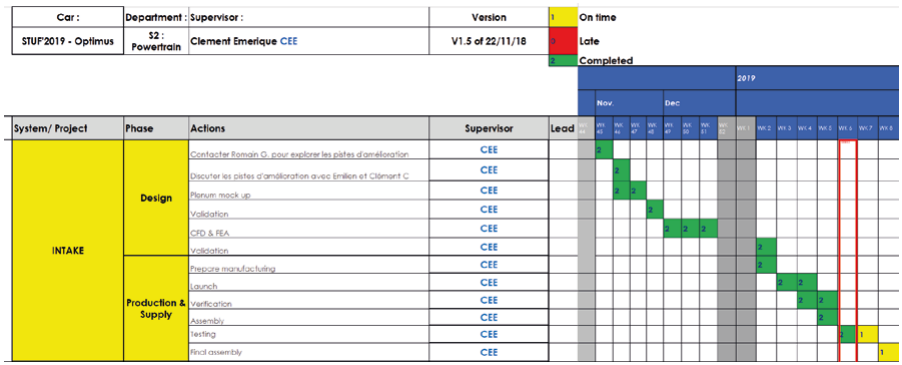
[picture p497: figure]
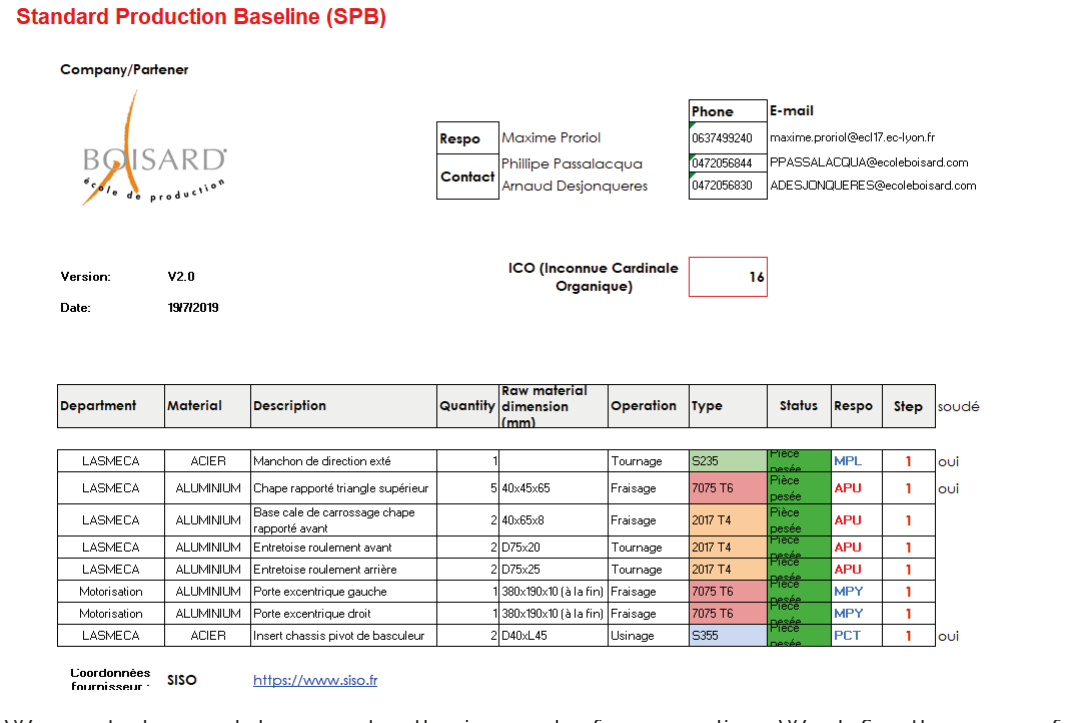
[picture p498: figure]

We created a excel document gathering each of our suppliers. We define the name of the parts, the department related, the dimension of the raw material, the thickness and the time for manufacturing.
It helps us to manage the manufacturing phase and to gather part with the same material and thickness to decrease the manufacturing cost.

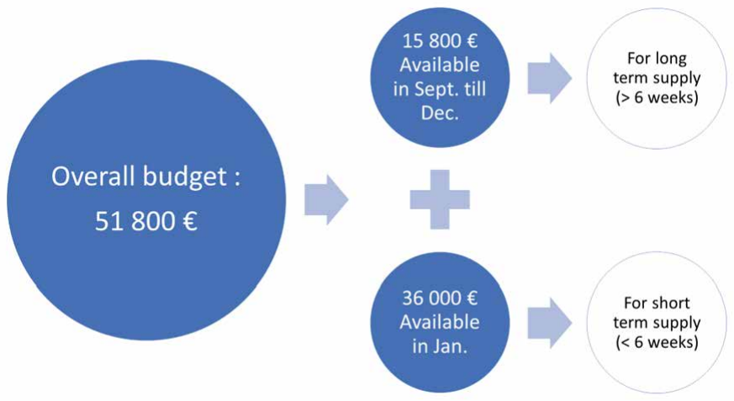
[picture p499: figure]

At the beginning of the project, we define a cost budget for each departement (Suspension, Chassis, Powertrain & Electrical).
Our budget is accessible in two time so we take into account delay and priority for first order choices.
Global planning | Ressources planning

## Cost planning

## Manufacturing planning

We define a global planning for the conception phase. Each tasks is assigned to a ressource from a department and has a due date.

## September 13 2018

# High Level Design

## November 20 2018

# Detailed Design

## March 8 2019

# Fabrication & unit testing

## April 5 2019

# System testing & integration

## April 10 2019

# Roll Out

## April 27 2019

# First vehicle test

## Delay from previsional : 7 days

## 7 days

## 21 days

## 20 days

## 0 days

## 7 days
