EOSCogniton/STUF2019/CR - Cost Report/Oral/6_Effectiveness of financial planning/Budget Optimus 2018_19 - Budget saison 2019 Update.pdf

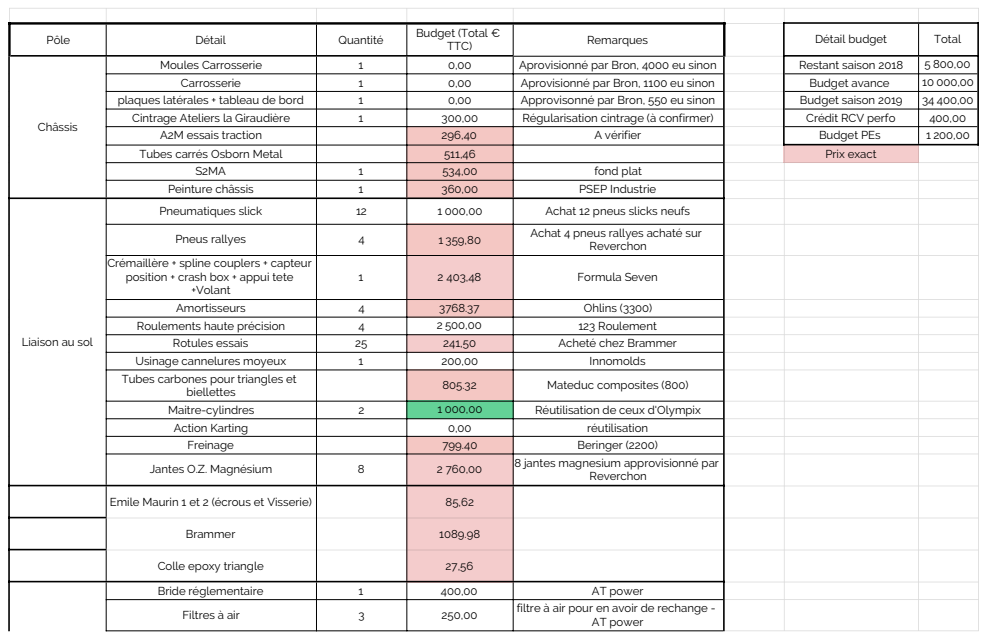
[picture p503: page 1]
Pôle; Détail; Quantité; Budget (Total €; TTC); Remarques; Détail budget; Total; Châssis; Moules Carrosserie; Aprovisionné par Bron, 4000 eu sinon; Restant saison 2018; Carrosserie; Aprovisionné par Bron, 1100 eu sinon; Budget avance; plaques latérales + tableau de bord; Approvisonné par Bron, 550 eu sinon; Budget saison 2019; Cintrage Ateliers la Giraudière; Régularisation cintrage (à confirmer); Crédit RCV perfo; A2M essais traction; A vérifier; Budget PEs; Tubes carrés Osborn Metal; Prix exact

S2MA | 1 | 534,00 | fond plat
Peinture châssis | 1 | 360,00 | PSEP Industrie
Pneumatiques slick | 12 | 1 000,00 | Achat 12 pneus slicks neufs
Pneus rallyes | 4 | 1 359,80 | Achat 4 pneus rallyes achaté sur Reverchon

Crémaillère + spline couplers + capteur position + crash box + appui tete +Volant | 1 | 2 403,48 | Formula Seven

Amortisseurs | 4 | 3768.37 | Ohlins (3300)
Roulements haute précision | 4 | 2 500,00 | 123 Roulement
Rotules essais | 25 | 241,50 | Acheté chez Brammer
Usinage cannelures moyeux | 1 | 200,00 | Innomolds
Tubes carbones pour triangles et biellettes | | 805.32 | Mateduc composites (800)

Liaison au sol

Maitre-cylindres | 2 | 1 000,00 | Réutilisation de ceux d'Olympix
Action Karting | | 0,00 | réutilisation
Freinage | | 799.40 | Beringer (2200)
Jantes O.Z. Magnésium | 8 | 2 760,00 | 8 jantes magnesium approvisionné par Reverchon

Emile Maurin 1 et 2 (écrous et Visserie) Brammer Colle epoxy triangle | | 85,62 1089.98 27,56

Bride réglementaire | 1 | 400,00 | AT power
Filtres à air | 3 | 250,00 | filtre à air pour en avoir de rechange -AT power

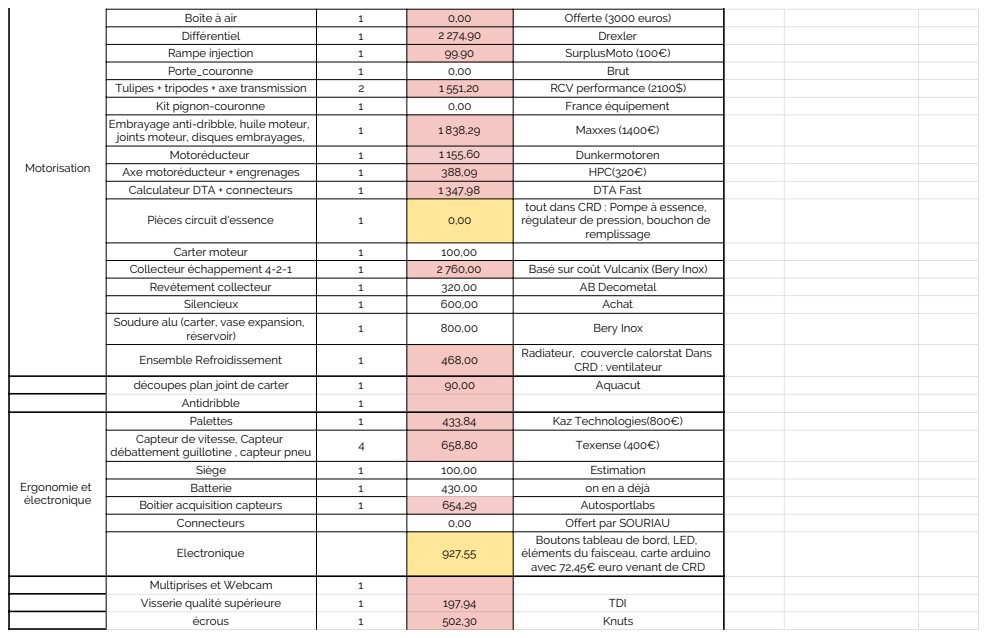
[picture p504: page 2]
Motorisation; Multiprises et Webcam; Visserie qualité supérieure; TDI; écrous; Knuts

Boîte à air | 1 | 0,00 | Offerte (3000 euros)
Différentiel | 1 | 2 274,90 | Drexler
Rampe injection | 1 | 99.90 | SurplusMoto (100€)
Porte_couronne | 1 | 0,00 | Brut

Tulipes + tripodes + axe transmission | 2 | 1 551,20 | RCV performance (2100$)

Kit pignon-couronne | 1 | 0,00 | France équipement

Embrayage anti-dribble, huile moteur, joints moteur, disques embrayages, | 1 | 1 838,29 | Maxxes (1400€)

Motoréducteur | 1 | 1 155,60 | Dunkermotoren

Axe motoréducteur + engrenages | 1 | 388,09 | HPC(320€)
Calculateur DTA + connecteurs | 1 | 1 347,98 | DTA Fast
Pièces circuit d'essence | 1 | 0,00 | tout dans CRD : Pompe à essence, régulateur de pression, bouchon de remplissage

Carter moteur | 1 | 100,00

Collecteur échappement 4-2-1 | 1 | 2 760,00 | Basé sur coût Vulcanix (Bery Inox)
Revétement collecteur | 1 | 320,00 | AB Decometal
Silencieux | 1 | 600,00 | Achat

Soudure alu (carter, vase expansion, réservoir) | 1 | 800,00 | Bery Inox

Ensemble Refroidissement | 1 | 468,00 | Radiateur, couvercle calorstat Dans CRD : ventilateur

découpes plan joint de carter Antidribble | 1 1 | 90,00 | Aquacut

Ergonomie et électronique | Palettes | 1 | 433,84 | Kaz Technologies(800€)

Capteur de vitesse, Capteur débattement guillotine , capteur pneu | 4 | 658,80 | Texense (400€)

Siège | 1 | 100,00 | Estimation

Batterie | 1 | 430,00 654,29 | on en a déjà
Boitier acquisition capteurs | 1 | | Autosportlabs
Connecteurs | | 0,00 | Offert par SOURIAU
Electronique | | 927,55 | Boutons tableau de bord, LED, éléments du faisceau, carte arduino avec 72,45€ euro venant de CRD

Pompe à essence, pièces circuit essence, bouchons de remplissage, régulateur pression, bouchon radiateurs, ventilateur, Coupes circuits, plaque carbon, cables, cosse, écrou de roue, harnais, prise demarrage ect | 1 | 1 694,05 | Commande Reverchon Divers: CRD
Divers | Manyspace | | 700,00
| Communication | | 1 000,00 | Vêtements, supports de présentation
| Camping FS | | 2 600,00 | A payer en mars, 2 compétitions
| Inscription compétition | | 3 200,00 | 2 compétitions
| Nourriture FS | | 1 000,00 | Carrefour, paiement à terme
| Soudures diverses la Giraudière | | 0,00 | A voir
| Commandes supplémentaires Boisard | | 0,00 | Usinage chez Alpentech diminue dépenses boisard
Prévisions pour impondérables | Moteur | | 2 700,00 | Budget de Bron si jamais rachat 3ème moteur
| Consommables | | 1 500,00
| Reverchon | | 1 260,00
| Total | | 38 359,17 €
| Budget | | 51 800,00 €
| Economies sur fonds propres | | 13 440,83 €
