EOSCogniton/STUF2019/SU - Suspension/BOM_suspension.xls

mercoledì 9 gennaio 2019 15.35.42
Bill of Material: SU
Quantity | Part Number | Type | Nomenclature | Revision
1 | Tubulaire Optimus | Assembly
1 | Suspension_Wireframe | Assembly
1 | Front Left Wheel | Assembly
1 | Front lower A-Arms | Assembly
1 | Front upper A-Arms | Assembly
1 | Lower Rear A-Arms | Assembly
1 | SU_A1100 (Rear Left Wheel Assy) | Assembly
1 | SA 6 E-SA 6 E | Part
1 | SU_A1400 | Assembly
1 | SU_A1500 | Assembly
1 | Chapes_assy | Assembly
1 | Symmetry of Front lower A-Arms | Assembly
1 | Symmetry of Lower Rear A-Arms | Assembly
1 | upper_rear_bearing_support | Assembly
1 | Symmetry of upper_rear_bearing_support | Assembly
1 | Insert SA 6E | Assembly
1 | Symmetry of Front upper A-Arms | Assembly
1 | Symmetry of Front Left Wheel | Assembly
2 | SU_A0600 | Assembly
2 | SU_A0800 | Assembly
2 | Vis pour ohlins | Assembly
2 | Symmetry of Vis pour ohlins | Assembly
1 | Symmetry of SU_A1100 (Rear Left Wheel Assy) | Assembly
1 | Rear ARB Rod | Assembly
1 | Symmetry of SU_A1500 | Assembly
1 | Symmetry of Rear ARB Rod | Assembly
1 | SU_1400_005 (biellette) | Assembly
1 | Symmetry of SU_A1400_1 | Assembly
1 | Symmetry of SU_1400_005 (biellette) | Assembly
Bill of Material: Tubulaire Optimus
Quantity | Part Number | Type | Nomenclature | Revision
1 | Tubes | Assembly
1 | filaire | Part
Bill of Material: Tubes
Quantity | Part Number | Type | Nomenclature | Revision
1 | 30x2 | Assembly
1 | 30x1.5 | Assembly
1 | 25x1.5 | Assembly
1 | 20x1.5 | Assembly
1 | 15x1.5 | Assembly
Bill of Material: 30x2
Quantity | Part Number | Type | Nomenclature | Revision
1 | Shape_642 | STRMember
1 | Shape_645 | STRMember
1 | Shape_646 | STRMember
1 | Shape_647 | STRMember
1 | Shape_648 | STRMember
1 | Shape_649 | STRMember
1 | Shape_650 | STRMember
1 | Shape_651 | STRMember
1 | Shape_652 | STRMember
1 | Shape_653 | STRMember
1 | Shape_662 | STRMember
1 | Shape_669 | STRMember
1 | Shape_670 | STRMember
1 | Shape_671 | STRMember
1 | Shape_672 | STRMember
Bill of Material: 30x1.5
Quantity | Part Number | Type | Nomenclature | Revision
1 | Shape_429 | STRMember
1 | Shape_430 | STRMember
1 | Shape_431 | STRMember
1 | Shape_432 | STRMember
1 | Shape_433 | STRMember
1 | Shape_437 | STRMember
1 | Shape_440 | STRMember
1 | Shape_439 | STRMember
1 | Shape_441 | STRMember
1 | Shape_438 | STRMember
1 | Shape_436 | STRMember
1 | Shape_562 | STRMember
1 | Shape_678 | STRMember
1 | Shape_679 | STRMember
1 | Shape_818 | STRMember
1 | Shape_819 | STRMember
1 | Shape_820 | STRMember
Bill of Material: 25x1.5
Quantity | Part Number | Type | Nomenclature | Revision
1 | Shape_469 | STRMember
1 | Shape_471 | STRMember
1 | Shape_472 | STRMember
1 | Shape_473 | STRMember
1 | Shape_475 | STRMember
1 | Shape_477 | STRMember
1 | Shape_478 | STRMember
1 | Shape_479 | STRMember
1 | Shape_480 | STRMember
1 | Shape_488 | STRMember
1 | Shape_582 | STRMember
1 | Shape_583 | STRMember
1 | Shape_614 | STRMember
1 | Shape_664 | STRMember
1 | Shape_665 | STRMember
1 | Shape_585 | STRMember
1 | Shape_584 | STRMember
Bill of Material: 20x1.5
Quantity | Part Number | Type | Nomenclature | Revision
1 | Shape_463 | STRMember
1 | Shape_464 | STRMember
1 | Shape_465 | STRMember
1 | Shape_467 | STRMember
1 | Shape_468 | STRMember
1 | Shape_558 | STRMember
1 | Shape_559 | STRMember
1 | Shape_576 | STRMember
1 | Shape_591 | STRMember
1 | Shape_592 | STRMember
1 | Shape_593 | STRMember
1 | Shape_594 | STRMember
1 | Shape_603 | STRMember
1 | Shape_604 | STRMember
1 | Shape_605 | STRMember
1 | Shape_606 | STRMember
1 | Shape_607 | STRMember
1 | Shape_608 | STRMember
1 | Shape_609 | STRMember
1 | Shape_610 | STRMember
1 | Shape_623 | STRMember
1 | Shape_624 | STRMember
1 | Shape_625 | STRMember
1 | Shape_630 | STRMember
1 | Shape_632 | STRMember
1 | Shape_633 | STRMember
1 | Shape_639 | STRMember
1 | Shape_640 | STRMember
Bill of Material: 15x1.5
Quantity | Part Number | Type | Nomenclature | Revision
1 | Shape_445 | STRMember
1 | Shape_448 | STRMember
1 | Shape_449 | STRMember
1 | Shape_452 | STRMember
1 | Shape_453 | STRMember
1 | Shape_454 | STRMember
1 | Shape_455 | STRMember
1 | Shape_456 | STRMember
1 | Shape_457 | STRMember
1 | Shape_459 | STRMember
1 | Shape_460 | STRMember
1 | Shape_461 | STRMember
1 | Shape_573 | STRMember
1 | Shape_574 | STRMember
1 | Shape_586 | STRMember
1 | Shape_587 | STRMember
1 | Shape_588 | STRMember
1 | Shape_589 | STRMember
1 | Shape_600 | STRMember
1 | Shape_601 | STRMember
1 | Shape_634 | STRMember
1 | Shape_635 | STRMember
1 | Shape_636 | STRMember
Bill of Material: Suspension_Wireframe
Quantity | Part Number | Type | Nomenclature | Revision
1 | Suspension_Frame_points | Part
1 | Wireframe_Front_Upright | Part
1 | Wireframe_Rear_Upright | Part
1 | Wireframe_Front_Wheel | Part
1 | Wireframe_Rear_Wheel | Part
1 | Front_Upper_A_Arm | Assembly
1 | Front Lower A Arm | Assembly
1 | Rear Lower A Arm | Assembly
1 | Rear Upper A Arm | Assembly
4 | Piston | Part | TTX20 - Base Assembly - 200 - Extended | ANY
4 | Corps | Part | TTX20 - Base Assembly - 200 - Extended | ANY
2 | Front_Push_Rod | Part
2 | Front Rocker | Assembly
2 | Rear_Rockers | Assembly
2 | Rear_Push_Rod | Part
2 | Steering_Link_Assy | Assembly
2 | Toe_link_Assy | Assembly
1 | Steering_box | Part | Scatola MY2013 REV80 L450 | TUTTO
1 | Steering_spline | Part | Scatola MY2013 REV80 L450 | TUTTO
1 | Steering_column | Part
1 | Steering_Shaft_pivot | Part
1 | Steering_Wheel | Part
1 | Left_Front_lower_A-Arm | Assembly
1 | Left_Front_Upper_A-Arm | Assembly
1 | Left_Wireframe_Front_Wheel | Part
1 | Left_Wireframe_Front_Upright | Part
1 | Left_Rear_lower_A-Arm | Assembly
1 | Left_Rear_Upper_A-Arm | Assembly
1 | Left_Wireframe_Rear_Wheel | Part
1 | Left_Wireframe_Rear_Upright | Part
2 | Steering_Rack | Part
1 | MECAmaster - [Suspension_Wireframe] | Assembly
Bill of Material: Front_Upper_A_Arm
Quantity | Part Number | Type | Nomenclature | Revision
1 | Wireframe_Front_Upper_Arm | Part
1 | Front_Upper_A_Arm_Rear_Rod | Part
1 | Front_Upper_A_Arm_Front_Rod | Part
2 | GE_8C | Assembly
Bill of Material: GE_8C
Quantity | Part Number | Type | Nomenclature | Revision
1 | Insert Frame Side | Part
1 | GE 6 E-GE 6 E | Assembly
Bill of Material: GE 6 E-GE 6 E
Quantity | Part Number | Type | Nomenclature | Revision
1 | GE 6 E_dummy-GE 6 E_dummy | Part
1 | GE 6 E_or-GE 6 E_or | Part
1 | GE 6 E_ir-GE 6 E_ir | Part
Bill of Material: Front Lower A Arm
Quantity | Part Number | Type | Nomenclature | Revision
1 | Front_Lower_A_Arm_Rear_Rod | Part
1 | Front_Lower_A_Arm_Front_Rod | Part
1 | Wireframe_Front_Lower_Arm | Part
2 | GE_8C | Assembly
Bill of Material: Rear Lower A Arm
Quantity | Part Number | Type | Nomenclature | Revision
1 | Rear_Lower_A_Arm_Rear_Rod | Part
1 | Rear_Lower_A_Arm_Front_Rod | Part
1 | Wireframe_Rear_Lower_Arm | Part
2 | GE_8C | Assembly
Bill of Material: Rear Upper A Arm
Quantity | Part Number | Type | Nomenclature | Revision
1 | Rear_Upper_A_Arm_Front_Rod | Part
1 | Rear_Upper_A_Arm_Rear_Rod | Part
1 | Wireframe_Rear_Upper_Arm | Part
2 | GE_8C | Assembly
Bill of Material: Front Rocker
Quantity | Part Number | Type | Nomenclature | Revision
2 | Front_Rocker | Part
Bill of Material: Rear_Rockers
Quantity | Part Number | Type | Nomenclature | Revision
2 | Rear_Rocker | Part
Bill of Material: Steering_Link_Assy
Quantity | Part Number | Type | Nomenclature | Revision
1 | Steering_Link | Part
2 | Insert_tie_rod_SA-8E | Assembly
Bill of Material: Insert_tie_rod_SA-8E
Quantity | Part Number | Type | Nomenclature | Revision
1 | SU_0900_002 | Part
1 | SA 6 E-SA 6 E.1 | Part
1 | emile_maurin_125016 | Part
Bill of Material: Toe_link_Assy
Quantity | Part Number | Type | Nomenclature | Revision
1 | Toe_Link | Part
2 | Insert_tie_rod_SA-8E | Assembly
Bill of Material: Left_Front_lower_A-Arm
Quantity | Part Number | Type | Nomenclature | Revision
1 | Front_Lower_A_Arm_Rear_Rod | Part
1 | Front_Lower_A_Arm_Front_Rod | Part
1 | Left_Wireframe_Front_Lower_Arm | Part
2 | GE_8C | Assembly
Bill of Material: Left_Front_Upper_A-Arm
Quantity | Part Number | Type | Nomenclature | Revision
1 | Left_Wireframe_Front_Upper_Arm | Part
1 | Front_Upper_A_Arm_Front_Rod | Part
1 | Front_Upper_A_Arm_Rear_Rod | Part
2 | GE_8C | Assembly
Bill of Material: Left_Rear_lower_A-Arm
Quantity | Part Number | Type | Nomenclature | Revision
1 | Left_Wireframe_Rear_Lower_Arm | Part
1 | Rear_Lower_A_Arm_Rear_Rod | Part
1 | Rear_Lower_A_Arm_Front_Rod | Part
2 | GE_8C | Assembly
Bill of Material: Left_Rear_Upper_A-Arm
Quantity | Part Number | Type | Nomenclature | Revision
1 | Rear_Upper_A_Arm_Rear_Rod | Part
1 | Left_Wireframe_Rear_Upper_Arm | Part
1 | Rear_Upper_A_Arm_Front_Rod | Part
2 | GE_8C | Assembly
Bill of Material: MECAmaster - [Suspension_Wireframe]
Quantity | Part Number | Type | Nomenclature | Revision
1 | Calage-Poids | Assembly
1 | Rear suspension | Assembly
1 | Front suspension | Assembly
Bill of Material: Calage-Poids
Quantity | Part Number | Type | Nomenclature | Revision
1 | FO_Poids | Part
Bill of Material: Rear suspension
Quantity | Part Number | Type | Nomenclature | Revision
1 | BJ_Rear UF | Assembly
1 | BJ_Rear UR | Assembly
1 | BJ_Rear LR | Assembly
1 | BJ_Rear LF | Assembly
1 | BJ_Rear UF Outboard | Assembly
1 | BJ_RearUR Outboard | Assembly
1 | BJ_Rear LR Outboard | Assembly
1 | BJ_Rear LF Outboard Spherical | Assembly
1 | BJ_RR Tie-rod | Assembly
1 | BJ_RR Outboard Tie-rod | Assembly
1 | BJ_Lower Push-rod | Assembly
1 | BJ_Upper Push-rod | Assembly
1 | BJ_Outboard Shock Spherical | Assembly
1 | BJ_Inboard Shock | Assembly
1 | PI_RR Rocker Pivot | Assembly
1 | PO-Z_RR Brake Force | Part
1 | SS-XZ_RR Outter Bearing | Part
1 | SS-XZ_RR Inner Bearing | Part
1 | PO-Y_RR Inner Bearing | Part
1 | PO-Z_Fz-RR | Part
1 | PO-Z_Fz-RL | Part
Bill of Material: BJ_Rear UF
Quantity | Part Number | Type | Nomenclature | Revision
1 | Produit15 | Part
Bill of Material: BJ_Rear UR
Quantity | Part Number | Type | Nomenclature | Revision
1 | Produit14 | Part
Bill of Material: BJ_Rear LR
Quantity | Part Number | Type | Nomenclature | Revision
1 | Produit13 | Part
Bill of Material: BJ_Rear LF
Quantity | Part Number | Type | Nomenclature | Revision
1 | Produit12 | Part
Bill of Material: BJ_Rear UF Outboard
Quantity | Part Number | Type | Nomenclature | Revision
1 | Produit11 | Part
Bill of Material: BJ_RearUR Outboard
Quantity | Part Number | Type | Nomenclature | Revision
1 | Produit10 | Part
Bill of Material: BJ_Rear LR Outboard
Quantity | Part Number | Type | Nomenclature | Revision
1 | Produit9 | Part
Bill of Material: BJ_Rear LF Outboard Spherical
Quantity | Part Number | Type | Nomenclature | Revision
1 | Produit8 | Part
Bill of Material: BJ_RR Tie-rod
Quantity | Part Number | Type | Nomenclature | Revision
1 | Produit2 | Part
Bill of Material: BJ_RR Outboard Tie-rod
Quantity | Part Number | Type | Nomenclature | Revision
1 | Produit1 | Part
Bill of Material: BJ_Lower Push-rod
Quantity | Part Number | Type | Nomenclature | Revision
1 | Produit3 | Part
Bill of Material: BJ_Upper Push-rod
Quantity | Part Number | Type | Nomenclature | Revision
1 | Produit4 | Part
Bill of Material: BJ_Outboard Shock Spherical
Quantity | Part Number | Type | Nomenclature | Revision
1 | Produit5 | Part
Bill of Material: BJ_Inboard Shock
Quantity | Part Number | Type | Nomenclature | Revision
1 | Produit6 | Part
Bill of Material: PI_RR Rocker Pivot
Quantity | Part Number | Type | Nomenclature | Revision
1 | Produit7 | Part
Bill of Material: Front suspension
Quantity | Part Number | Type | Nomenclature | Revision
1 | BJ_Front UF | Part
1 | BJ_Front UR | Part
1 | BJ_Front LR | Part
1 | BJ_Front LF | Part
1 | BJ_Front LF Outboard | Part
1 | BJ_Front LR Outboard | Part
1 | BJ_Front UR Outboard | Part
1 | BJ_Front UF Outboard | Part
1 | BJ_FR Pull-Rod | Part
1 | BJ_FR Inboard Pull Rod | Part
1 | BJ_Outboard FR Ohlins | Part
1 | BJ_Inboard FR Ohlins | Part
1 | BJ_Outboard FR Tie-rod | Part
1 | BJ_Inboard FR Tie-rod | Part
1 | SS-XZ_FR Inner bearing | Part
1 | SS-XZ_FR Outer bearing | Part
1 | PO-Y_FR Wheel Axial Force | Part
1 | PO-Z_FR Brake Force | Part
1 | PI_FR Rocker Pivot | Part
1 | PO-Z_Fz-FL | Part
1 | PO-Z_Fz-FR | Part
Bill of Material: Front Left Wheel
Quantity | Part Number | Type | Nomenclature | Revision
1 | Front Upright Working Assy | Assembly
1 | WT_A0100 (Wheel Assy) | Assembly
1 | WT_0200_001 (Front Hub) | Part
1 | BR_0100_001_MM (Brake Caliper) | Part
1 | BR_0200_001 (Break Disc) | Part
1 | SU_10002 (Upper Arm Bracket) | Part
1 | SU_10003 (Upper Arm Wedge) | Part
2 | S71910 ACD/P4A-S71910 ACD/P4A | Assembly
1 | WT_02003 (Front Bearing Washer) | Part
1 | MB 10-MB 10 | Part
1 | KM 10-KM 10 | Part
2 | M8x20 | Assembly
1 | LaVisserie | Assembly
2 | WT_02004 (Speed Sensor Disc Spacer) | Part
1 | Entretoises | Assembly
1 | roue dente capteur vitesse | Part
1 | Speed Sensor | Part
1 | WT_02006 (Speed Sensor Disc Spacer 3mm) | Part
1 | Brake Bell | Part
2 | Speed_sensor_washer | Part
Bill of Material: Front Upright Working Assy
Quantity | Part Number | Type | Nomenclature | Revision
1 | Left_Wireframe_Front_Upright | Part
1 | SU_1000_001 (Front Left Upright) | Part
Bill of Material: WT_A0100 (Wheel Assy)
Quantity | Part Number | Type | Nomenclature | Revision
1 | WT_0100_001 (Oz Magnesium Rim) | Part
1 | WT_0100_002 (Tire Hoosier 13) | Part
Bill of Material: S71910 ACD/P4A-S71910 ACD/P4A
Quantity | Part Number | Type | Nomenclature | Revision
1 | S71910 ACD/P4A_PART1-S71910 ACD/P4A_PART1 | Part
1 | S71910 ACD/P4A_PART2-S71910 ACD/P4A_PART2 | Part
25 | S71910 ACD/P4A_PART3-S71910 ACD/P4A_PART3 | Part
Bill of Material: M8x20
Quantity | Part Number | Type | Nomenclature | Revision
1 | rondelle_M8.1 | Part | _HPC - SHW-8/B
1 | ISO 4762 SCREW M8x20 STEEL HEXAGON SOCKET HEAD CAP.2 | Part
Bill of Material: LaVisserie
Quantity | Part Number | Type | Nomenclature | Revision
1 | setVis2 | Assembly
1 | setVis3 | Assembly
1 | setVis4 | Assembly
1 | setVis | Assembly
1 | setVis1 | Assembly
1 | setVis5 | Assembly
1 | setVis6 | Assembly
1 | setVis7 | Assembly
1 | setVis8 | Assembly
1 | setVis9 | Assembly
1 | setVis10 | Assembly
Bill of Material: setVis2
Quantity | Part Number | Type | Nomenclature | Revision
1 | 6x50CHC | Part
1 | ecrou_M6_NS | Part
2 | rondelle_M6 | Part
Bill of Material: setVis3
Quantity | Part Number | Type | Nomenclature | Revision
1 | 6x50CHC | Part
1 | ecrou_M6_NS | Part
2 | rondelle_M6 | Part
Bill of Material: setVis4
Quantity | Part Number | Type | Nomenclature | Revision
1 | 6x55CHC | Part
1 | ecrou_M6_NS | Part
2 | rondelle_M6 | Part
Bill of Material: setVis
Quantity | Part Number | Type | Nomenclature | Revision
1 | 6x40CHC | Part
1 | ecrou_M6_NS | Part
2 | rondelle_M6 | Part
Bill of Material: setVis1
Quantity | Part Number | Type | Nomenclature | Revision
1 | 6x40CHC | Part
1 | ecrou_M6_NS | Part
2 | rondelle_M6 | Part
Bill of Material: setVis5
Quantity | Part Number | Type | Nomenclature | Revision
1 | 5x20CHC | Part
1 | ecrou_M5_NS | Part
2 | rondelle_M5 | Part
Bill of Material: setVis6
Quantity | Part Number | Type | Nomenclature | Revision
1 | 5x20CHC | Part
1 | ecrou_M5_NS | Part
2 | rondelle_M5 | Part
Bill of Material: setVis7
Quantity | Part Number | Type | Nomenclature | Revision
1 | 5x20CHC | Part
1 | ecrou_M5_NS | Part
2 | rondelle_M5 | Part
Bill of Material: setVis8
Quantity | Part Number | Type | Nomenclature | Revision
1 | 5x20CHC | Part
1 | ecrou_M5_NS | Part
2 | rondelle_M5 | Part
Bill of Material: setVis9
Quantity | Part Number | Type | Nomenclature | Revision
1 | 5x20CHC | Part
1 | ecrou_M5_NS | Part
2 | rondelle_M5 | Part
Bill of Material: setVis10
Quantity | Part Number | Type | Nomenclature | Revision
1 | 5x20CHC | Part
1 | ecrou_M5_NS | Part
2 | rondelle_M5 | Part
Bill of Material: Entretoises
Quantity | Part Number | Type | Nomenclature | Revision
6 | entretoise_upper_front_bearing_support.1 | Part
Bill of Material: Front lower A-Arms
Quantity | Part Number | Type | Nomenclature | Revision
1 | Wireframe_Front_Lower_Arm | Part
1 | SU_02001 | Part
1 | GE 6 E-GE 6 E | Assembly
Bill of Material: Front upper A-Arms
Quantity | Part Number | Type | Nomenclature | Revision
1 | Wireframe_Front_Upper_Arm | Part
1 | Upper front bearing support | Part
1 | GE 6 E-GE 6 E | Assembly
2 | SU_0100_006 | Part
Bill of Material: Lower Rear A-Arms
Quantity | Part Number | Type | Nomenclature | Revision
1 | Wireframe_Rear_Lower_Arm | Part
1 | Lower rear bearing support | Part
1 | GE 6 E-GE 6 E | Assembly
Bill of Material: SU_A1100 (Rear Left Wheel Assy)
Quantity | Part Number | Type | Nomenclature | Revision
1 | Rear Upright | Assembly
1 | 2D1 ass | Part
1 | WT_A0100 (Wheel Assy) | Assembly
2 | S71910 ACD/P4A-S71910 ACD/P4A | Assembly
1 | WT_03001 (Rear Hub) | Part
1 | Tripod housing spacer | Part
1 | 4483 Polaris (20T) | Part | 4483 Polaris (20T) | ANY
1 | SU_11003 (Rear Upper Arm Wedge) | Part
1 | SU_10002 (Upper Arm Bracket) | Part
1 | LaVisserie | Assembly
1 | 4484 VW (22T) | Part | 4484 VW (22T) | ANY
1 | Tulipe | Part
1 | nut_iso_10512-m20x1_5-10 | Part | nut_iso_10512-m20x1_5-10
1 | Entretoises | Assembly
1 | 193 | Part
1 | Speed Sensor | Part
1 | roue dente capteur vitesse | Part
1 | WT_02006 (Speed Sensor Disc Spacer 3mm) | Part
1 | WT_02004 (Speed Sensor Disc Spacer) | Part
1 | Brake Bell.2 | Part
1 | WT_03003 (Rear Bearing Washer) | Part
2 | Speed_sensor_washer | Part
Bill of Material: Rear Upright
Quantity | Part Number | Type | Nomenclature | Revision
1 | Left_Wireframe_Rear_Upright | Part
1 | SU_11001 (Rear Left Upright) | Part
Bill of Material: LaVisserie
Quantity | Part Number | Type | Nomenclature | Revision
1 | setVis2 | Assembly
1 | setVis3 | Assembly
1 | setVis4 | Assembly
1 | setVis | Assembly
1 | setVis1 | Assembly
1 | setVis6 | Assembly
1 | setVis7 | Assembly
1 | setVis8 | Assembly
1 | setVis9 | Assembly
1 | setVis5 | Assembly
1 | setVis10 | Assembly
Bill of Material: setVis2
Quantity | Part Number | Type | Nomenclature | Revision
1 | 6x40CHC | Part
1 | ecrou_M6_NS | Part
2 | rondelle_M6 | Part
Bill of Material: setVis3
Quantity | Part Number | Type | Nomenclature | Revision
1 | 6x40CHC | Part
1 | ecrou_M6_NS | Part
2 | rondelle_M6 | Part
Bill of Material: setVis4
Quantity | Part Number | Type | Nomenclature | Revision
1 | 6x50CHC | Part
1 | ecrou_M6_NS | Part
2 | rondelle_M6 | Part
Bill of Material: setVis
Quantity | Part Number | Type | Nomenclature | Revision
1 | 6x55CHC | Part
1 | ecrou_M6_NS | Part
2 | rondelle_M6 | Part
Bill of Material: setVis1
Quantity | Part Number | Type | Nomenclature | Revision
1 | 6x55CHC | Part
1 | ecrou_M6_NS | Part
2 | rondelle_M6 | Part
Bill of Material: setVis6
Quantity | Part Number | Type | Nomenclature | Revision
1 | 8x25CHC | Part
1 | ecrou_M8_NS | Part
2 | rondelle_M8 | Part
Bill of Material: setVis7
Quantity | Part Number | Type | Nomenclature | Revision
1 | 8x25CHC | Part
1 | ecrou_M8_NS | Part
2 | rondelle_M8 | Part
Bill of Material: setVis8
Quantity | Part Number | Type | Nomenclature | Revision
1 | 8x25CHC | Part
1 | ecrou_M8_NS | Part
2 | rondelle_M8 | Part
Bill of Material: setVis9
Quantity | Part Number | Type | Nomenclature | Revision
1 | 8x25CHC | Part
1 | ecrou_M8_NS | Part
2 | rondelle_M8 | Part
Bill of Material: setVis5
Quantity | Part Number | Type | Nomenclature | Revision
1 | 8x35CHC | Part
1 | ecrou_M8_NS | Part
2 | rondelle_M8 | Part
Bill of Material: setVis10
Quantity | Part Number | Type | Nomenclature | Revision
1 | 8x35CHC | Part
1 | ecrou_M8_NS | Part
2 | rondelle_M8 | Part
Bill of Material: Entretoises
Quantity | Part Number | Type | Nomenclature | Revision
6 | entretoise_upper_front_bearing_support.1 | Part
Bill of Material: SU_A1400
Quantity | Part Number | Type | Nomenclature | Revision
1 | SU_1400_002 (Chape droite) | Part
1 | ARB_pivot_3 | Part
1 | FRONT_ARB_BARRE | Part
2 | end_plate | Part
1 | GE 12 C-GE 12 C | Assembly
Bill of Material: GE 12 C-GE 12 C
Quantity | Part Number | Type | Nomenclature | Revision
1 | GE 12 C_dummy-GE 12 C_dummy | Part
1 | GE 12 C_or-GE 12 C_or | Part
1 | GE 12 C_ir-GE 12 C_ir | Part
Bill of Material: SU_A1500
Quantity | Part Number | Type | Nomenclature | Revision
1 | chape rear ARB | Part
1 | ARB_pivot_3 | Part
1 | Rear_ARB_Barre | Part
2 | REAR_ARB_couteau | Part
1 | GE 12 C-GE 12 C | Assembly
Bill of Material: Chapes_assy
Quantity | Part Number | Type | Nomenclature | Revision
1 | bracket_triangle_arriere_bas_bras_avant_1 | Part
1 | bracket_triangle_arriere_bas_bras_avant_2 | Part
1 | bracket_triangle_arriere_haut_bras_avant_1 | Part
1 | bracket_triangle_arriere_haut_bras_avant_2 | Part
1 | bracket_triangle_avant_bas_bras_avant_1 | Part
1 | bracket_triangle_avant_bas_bras_avant_2 | Part
1 | bracket_triangle_avant_haut_bras_avant_1 | Part
1 | bracket_triangle_avant_haut_bras_avant_2 | Part
1 | bracket_triangle_avant_haut_bras_arriere_1 | Part
1 | bracket_triangle_avant_haut_bras_arriere_2 | Part
1 | bracket_triangle_arriere_haut_bras_arriere_1 | Part
1 | bracket_triangle_arriere_haut_bras_arriere_2 | Part
1 | bracket_triangle_arriere_bas_bras_arriere_2 | Part
1 | bracket_triangle_avant_bas_bras_arriere_1 | Part
1 | bracket_triangle_avant_bas_bras_arriere_2 | Part
1 | bracket_triangle_arriere_bas_bras_arriere_1 | Part
1 | Entretoises | Assembly
1 | Ecroues | Assembly
1 | Vis | Assembly
1 | Symmetry of Vis | Assembly
1 | Symmetry of Ecroues | Assembly
1 | Symmetry of Entretoises | Assembly
1 | Symmetry of bracket_triangle_arriere_bas_bras_avant_1 | Part
1 | Symmetry of bracket_triangle_arriere_bas_bras_avant_2 | Part
1 | Symmetry of bracket_triangle_arriere_haut_bras_avant_1 | Part
1 | Symmetry of bracket_triangle_arriere_haut_bras_avant_2 | Part
1 | Symmetry of bracket_triangle_avant_bas_bras_avant_1 | Part
1 | Symmetry of bracket_triangle_avant_bas_bras_avant_2 | Part
1 | Symmetry of bracket_triangle_avant_haut_bras_avant_1 | Part
1 | Symmetry of bracket_triangle_avant_haut_bras_avant_2 | Part
1 | Symmetry of bracket_triangle_avant_haut_bras_arriere_1 | Part
1 | Symmetry of bracket_triangle_avant_haut_bras_arriere_2 | Part
1 | Symmetry of bracket_triangle_arriere_haut_bras_arriere_1 | Part
1 | Symmetry of bracket_triangle_arriere_haut_bras_arriere_2 | Part
1 | Symmetry of bracket_triangle_arriere_bas_bras_arriere_2 | Part
1 | Symmetry of bracket_triangle_avant_bas_bras_arriere_1 | Part
1 | Symmetry of bracket_triangle_avant_bas_bras_arriere_2 | Part
1 | Symmetry of bracket_triangle_arriere_bas_bras_arriere_1 | Part
1 | chape_rear_susp | Part
1 | bracket_front_rocker_avant | Part
1 | bracket_front_rocker_arrière | Part
1 | Symmetry of bracket_front_rocker_arrière | Part
1 | Symmetry of bracket_front_rocker_avant | Part
1 | Symmetry of chape_rear_susp | Part
2 | Front_suspension_bracket | Part
1 | Chape_rear_olhins | Part
1 | Symmetry of Chape_rear_olhins | Part
1 | Symmetry of Chape_rear_olhins_1 | Part
Bill of Material: Entretoises
Quantity | Part Number | Type | Nomenclature | Revision
18 | entretoise_upper_front_bearing_support | Part
Bill of Material: Ecroues
Quantity | Part Number | Type | Nomenclature | Revision
9 | ecrou_knuts | Part
Bill of Material: Vis
Quantity | Part Number | Type | Nomenclature | Revision
9 | 6x35CHC | Part
Bill of Material: Symmetry of Vis
Quantity | Part Number | Type | Nomenclature | Revision
9 | Symmetry of 6x35CHC | Part
Bill of Material: Symmetry of Ecroues
Quantity | Part Number | Type | Nomenclature | Revision
9 | Symmetry of ecrou_knuts | Part
Bill of Material: Symmetry of Entretoises
Quantity | Part Number | Type | Nomenclature | Revision
18 | Symmetry of entretoise_upper_front_bearing_support | Part
Bill of Material: Symmetry of Front lower A-Arms
Quantity | Part Number | Type | Nomenclature | Revision
1 | Symmetry of Wireframe_Front_Lower_Arm | Part
1 | Symmetry of SU_02001 | Part
1 | Symmetry of GE 6 E-GE 6 E | Assembly
Bill of Material: Symmetry of GE 6 E-GE 6 E
Quantity | Part Number | Type | Nomenclature | Revision
1 | Symmetry of GE 6 E_dummy-GE 6 E_dummy | Part
1 | Symmetry of GE 6 E_or-GE 6 E_or | Part
1 | Symmetry of GE 6 E_ir-GE 6 E_ir | Part
Bill of Material: Symmetry of Lower Rear A-Arms
Quantity | Part Number | Type | Nomenclature | Revision
1 | Symmetry of Wireframe_Rear_Lower_Arm | Part
1 | Symmetry of Lower rear bearing support | Part
1 | Symmetry of GE 6 E-GE 6 E_2 | Assembly
Bill of Material: Symmetry of GE 6 E-GE 6 E_2
Quantity | Part Number | Type | Nomenclature | Revision
1 | Symmetry of GE 6 E_dummy-GE 6 E_dummy_2 | Part
1 | Symmetry of GE 6 E_or-GE 6 E_or_2 | Part
1 | Symmetry of GE 6 E_ir-GE 6 E_ir_2 | Part
Bill of Material: upper_rear_bearing_support
Quantity | Part Number | Type | Nomenclature | Revision
1 | Wireframe_Rear_Upper_Arm | Part
1 | Upper rear bearing support | Part
1 | GE 6 E-GE 6 E | Assembly
2 | SU_0100_006 | Part
Bill of Material: Symmetry of upper_rear_bearing_support
Quantity | Part Number | Type | Nomenclature | Revision
1 | Symmetry of Wireframe_Rear_Upper_Arm | Part
1 | Symmetry of Upper rear bearing support | Part
1 | Symmetry of GE 6 E-GE 6 E_3 | Assembly
2 | Symmetry of SU_0100_006_1 | Part
Bill of Material: Symmetry of GE 6 E-GE 6 E_3
Quantity | Part Number | Type | Nomenclature | Revision
1 | Symmetry of GE 6 E_dummy-GE 6 E_dummy_3 | Part
1 | Symmetry of GE 6 E_or-GE 6 E_or_3 | Part
1 | Symmetry of GE 6 E_ir-GE 6 E_ir_3 | Part
Bill of Material: Insert SA 6E
Quantity | Part Number | Type | Nomenclature | Revision
8 | Insert_tie_rod_SA-8E | Assembly
Bill of Material: Symmetry of Front upper A-Arms
Quantity | Part Number | Type | Nomenclature | Revision
1 | Symmetry of Wireframe_Front_Upper_Arm | Part
1 | Symmetry of Upper front bearing support | Part
1 | Symmetry of GE 6 E-GE 6 E_3 | Assembly
2 | Symmetry of SU_0100_006_1 | Part
Bill of Material: Symmetry of Front Left Wheel
Quantity | Part Number | Type | Nomenclature | Revision
1 | Symmetry of Front Upright Working Assy | Assembly
1 | Symmetry of WT_A0100 (Wheel Assy)_1 | Assembly
1 | Symmetry of WT_0200_001 (Front Hub) | Part
1 | Symmetry of BR_0100_001_MM (Brake Caliper) | Part
1 | Symmetry of BR_0200_001 (Break Disc) | Part
1 | Symmetry of Brake Bell | Part
1 | Symmetry of SU_10002 (Front Upper Arm Bracket)_1 | Part
1 | Symmetry of SU_10003 (Upper Arm Wedge) | Part
2 | Symmetry of S71910 ACD/P4A-S71910 ACD/P4A_1 | Assembly
1 | Symmetry of WT_02003 (Front Bearing Washer) | Part
1 | Symmetry of MB 10-MB 10 | Part
1 | Symmetry of KM 10-KM 10 | Part
2 | Symmetry of M8x20 | Assembly
1 | Symmetry of LaVisserie | Assembly
1 | Symmetry of WT_02004 (Speed Sensor Spacer) | Part
1 | Symmetry of WT_02005 (Speed Sensor Disc) | Part
1 | Symmetry of Front Speed Sensor Bracket | Part
1 | Symmetry of Entretoises | Assembly
Bill of Material: Symmetry of Front Upright Working Assy
Quantity | Part Number | Type | Nomenclature | Revision
1 | Symmetry of Left_Wireframe_Front_Upright | Part
1 | Symmetry of SU_1000_001 (Front Left Upright) | Part
Bill of Material: Symmetry of WT_A0100 (Wheel Assy)_1
Quantity | Part Number | Type | Nomenclature | Revision
1 | Symmetry of WT_0100_001 (Oz Magnesium Rim)_1 | Part
1 | Symmetry of WT_0100_002 (Tire Hoosier 13)_1 | Part
Bill of Material: Symmetry of S71910 ACD/P4A-S71910 ACD/P4A_1
Quantity | Part Number | Type | Nomenclature | Revision
1 | Symmetry of S71910 ACD/P4A_PART1-S71910 ACD/P4A_PART1_1 | Part
1 | Symmetry of S71910 ACD/P4A_PART2-S71910 ACD/P4A_PART2_1 | Part
25 | Symmetry of S71910 ACD/P4A_PART3-S71910 ACD/P4A_PART3_1 | Part
Bill of Material: Symmetry of M8x20
Quantity | Part Number | Type | Nomenclature | Revision
1 | Symmetry of rondelle_M8.1 | Part
1 | Symmetry of ISO 4762 SCREW M8x20 STEEL HEXAGON SOCKET HEAD CAP | Part
Bill of Material: Symmetry of LaVisserie
Quantity | Part Number | Type | Nomenclature | Revision
1 | Symmetry of setVis2 | Assembly
1 | Symmetry of setVis3 | Assembly
1 | Symmetry of setVis4 | Assembly
1 | Symmetry of setVis | Assembly
1 | Symmetry of setVis1 | Assembly
Bill of Material: Symmetry of setVis2
Quantity | Part Number | Type | Nomenclature | Revision
1 | Symmetry of 6x50CHC_1 | Part
1 | Symmetry of ecrou_M6_NS_1 | Part
2 | Symmetry of rondelle_M6_1 | Part
Bill of Material: Symmetry of setVis3
Quantity | Part Number | Type | Nomenclature | Revision
1 | Symmetry of 6x50CHC_1 | Part
1 | Symmetry of ecrou_M6_NS_1 | Part
2 | Symmetry of rondelle_M6_1 | Part
Bill of Material: Symmetry of setVis4
Quantity | Part Number | Type | Nomenclature | Revision
1 | Symmetry of 6x55CHC | Part
1 | Symmetry of ecrou_M6_NS_1 | Part
2 | Symmetry of rondelle_M6_1 | Part
Bill of Material: Symmetry of setVis
Quantity | Part Number | Type | Nomenclature | Revision
1 | Symmetry of 6x40CHC_1 | Part
1 | Symmetry of ecrou_M6_NS_1 | Part
2 | Symmetry of rondelle_M6_1 | Part
Bill of Material: Symmetry of setVis1
Quantity | Part Number | Type | Nomenclature | Revision
1 | Symmetry of 6x40CHC_1 | Part
1 | Symmetry of ecrou_M6_NS_1 | Part
2 | Symmetry of rondelle_M6_1 | Part
Bill of Material: Symmetry of Entretoises
Quantity | Part Number | Type | Nomenclature | Revision
6 | Symmetry of entretoise_upper_front_bearing_support.1 | Part
Bill of Material: SU_A0600
Quantity | Part Number | Type | Nomenclature | Revision
2 | Front_Rocker.1 | Part
1 | Vis pivot basculeur | Assembly
2 | Vis pour basculeur rod | Assembly
1 | Vis pour ohlins | Assembly
Bill of Material: Vis pivot basculeur
Quantity | Part Number | Type | Nomenclature | Revision
1 | vis_epaulee_6mm | Part
2 | PCMF 060808 E | Part
1 | Entretoise pivot basculeur | Part
1 | 90576A104 | Part | 90576A104 | ANY
Bill of Material: Vis pour basculeur rod
Quantity | Part Number | Type | Nomenclature | Revision
1 | 6x45CHC | Part
2 | rondelle_M6 | Part
1 | ecrou_M6_NS | Part
2 | Entretoise basculeur Rod | Part
Bill of Material: Vis pour ohlins
Quantity | Part Number | Type | Nomenclature | Revision
1 | 8x45CHC | Part
1 | ecrou_M8_NS | Part
2 | Entretoise_basculeur | Part
2 | rondelle_M8 | Part
Bill of Material: SU_A0800
Quantity | Part Number | Type | Nomenclature | Revision
2 | Rear_Rocker.1 | Part
1 | Vis pour ohlins | Assembly
2 | Vis pour basculeur rod | Assembly
1 | Vis pivot basculeur | Assembly
Bill of Material: Symmetry of Vis pour ohlins
Quantity | Part Number | Type | Nomenclature | Revision
1 | Symmetry of 8x45CHC | Part
1 | Symmetry of ecrou_M8_NS_1 | Part
2 | Symmetry of Entretoise_basculeur | Part
2 | Symmetry of rondelle_M8_1 | Part
Bill of Material: Symmetry of SU_A1100 (Rear Left Wheel Assy)
Quantity | Part Number | Type | Nomenclature | Revision
1 | Symmetry of Rear Upright | Assembly
1 | Symmetry of 2D1 ass | Part
1 | Symmetry of WT_A0100 (Wheel Assy) | Assembly
2 | Symmetry of S71910 ACD/P4A-S71910 ACD/P4A | Assembly
1 | Symmetry of WT_03001 (Rear Hub) | Part
1 | Symmetry of Tripod housing spacer | Part
1 | Symmetry of 4483 Polaris (20T) | Part
1 | Symmetry of SU_11003 (Rear Upper Arm Wedge) | Part
1 | Symmetry of SU_10002 (Front Upper Arm Bracket) | Part
1 | Symmetry of LaVisserie | Assembly
1 | Symmetry of 4484 VW (22T) | Part
1 | Symmetry of Tulipe | Part
1 | Symmetry of nut_iso_10512-m20x1_5-10 | Part
1 | Symmetry of Entretoises | Assembly
1 | Symmetry of 193 | Part
1 | Symmetry of Speed Sensor | Part
1 | Symmetry of ISO 8675 NUT M10x1 STEEL GRADE C HEXAGON THIN METRIC FINE | Part
1 | Symmetry of roue dente capteur vitesse | Part
1 | Symmetry of WT_02006 (Speed Sensor Spacer 3mm) | Part
1 | Symmetry of WT_02004 (Speed Sensor Spacer)_1 | Part
1 | Symmetry of Brake Bell.2 | Part
1 | Symmetry of WT_03003 (Rear Bearing Washer) | Part
Bill of Material: Symmetry of Rear Upright
Quantity | Part Number | Type | Nomenclature | Revision
1 | Symmetry of Left_Wireframe_Rear_Upright | Part
1 | Symmetry of SU_11001 (Rear Left Upright) | Part
Bill of Material: Symmetry of WT_A0100 (Wheel Assy)
Quantity | Part Number | Type | Nomenclature | Revision
1 | Symmetry of WT_0100_001 (Oz Magnesium Rim) | Part
1 | Symmetry of WT_0100_002 (Tire Hoosier 13) | Part
Bill of Material: Symmetry of S71910 ACD/P4A-S71910 ACD/P4A
Quantity | Part Number | Type | Nomenclature | Revision
1 | Symmetry of S71910 ACD/P4A_PART1-S71910 ACD/P4A_PART1 | Part
1 | Symmetry of S71910 ACD/P4A_PART2-S71910 ACD/P4A_PART2 | Part
25 | Symmetry of S71910 ACD/P4A_PART3-S71910 ACD/P4A_PART3 | Part
Bill of Material: Symmetry of LaVisserie
Quantity | Part Number | Type | Nomenclature | Revision
1 | Symmetry of setVis2 | Assembly
1 | Symmetry of setVis3 | Assembly
1 | Symmetry of setVis4 | Assembly
1 | Symmetry of setVis | Assembly
1 | Symmetry of setVis1 | Assembly
1 | Symmetry of setVis6 | Assembly
1 | Symmetry of setVis7 | Assembly
1 | Symmetry of setVis8 | Assembly
1 | Symmetry of setVis9 | Assembly
1 | Symmetry of setVis5 | Assembly
1 | Symmetry of setVis10 | Assembly
Bill of Material: Symmetry of setVis2
Quantity | Part Number | Type | Nomenclature | Revision
1 | Symmetry of 6x40CHC | Part
1 | Symmetry of ecrou_M6_NS | Part
2 | Symmetry of rondelle_M6 | Part
Bill of Material: Symmetry of setVis3
Quantity | Part Number | Type | Nomenclature | Revision
1 | Symmetry of 6x40CHC | Part
1 | Symmetry of ecrou_M6_NS | Part
2 | Symmetry of rondelle_M6 | Part
Bill of Material: Symmetry of setVis4
Quantity | Part Number | Type | Nomenclature | Revision
1 | Symmetry of 6x50CHC | Part
1 | Symmetry of ecrou_M6_NS | Part
2 | Symmetry of rondelle_M6 | Part
Bill of Material: Symmetry of setVis
Quantity | Part Number | Type | Nomenclature | Revision
1 | Symmetry of 6x55CHC_1 | Part
1 | Symmetry of ecrou_M6_NS | Part
2 | Symmetry of rondelle_M6 | Part
Bill of Material: Symmetry of setVis1
Quantity | Part Number | Type | Nomenclature | Revision
1 | Symmetry of 6x55CHC_1 | Part
1 | Symmetry of ecrou_M6_NS | Part
2 | Symmetry of rondelle_M6 | Part
Bill of Material: Symmetry of setVis6
Quantity | Part Number | Type | Nomenclature | Revision
1 | Symmetry of 8x25CHC | Part
1 | Symmetry of ecrou_M8_NS_1 | Part
2 | Symmetry of rondelle_M8_1 | Part
Bill of Material: Symmetry of setVis7
Quantity | Part Number | Type | Nomenclature | Revision
1 | Symmetry of 8x25CHC | Part
1 | Symmetry of ecrou_M8_NS_1 | Part
2 | Symmetry of rondelle_M8_1 | Part
Bill of Material: Symmetry of setVis8
Quantity | Part Number | Type | Nomenclature | Revision
1 | Symmetry of 8x25CHC | Part
1 | Symmetry of ecrou_M8_NS_1 | Part
2 | Symmetry of rondelle_M8_1 | Part
Bill of Material: Symmetry of setVis9
Quantity | Part Number | Type | Nomenclature | Revision
1 | Symmetry of 8x25CHC | Part
1 | Symmetry of ecrou_M8_NS_1 | Part
2 | Symmetry of rondelle_M8_1 | Part
Bill of Material: Symmetry of setVis5
Quantity | Part Number | Type | Nomenclature | Revision
1 | Symmetry of 8x35CHC | Part
1 | Symmetry of ecrou_M8_NS_1 | Part
2 | Symmetry of rondelle_M8_1 | Part
Bill of Material: Symmetry of setVis10
Quantity | Part Number | Type | Nomenclature | Revision
1 | Symmetry of 8x35CHC | Part
1 | Symmetry of ecrou_M8_NS_1 | Part
2 | Symmetry of rondelle_M8_1 | Part
Bill of Material: Symmetry of Entretoises
Quantity | Part Number | Type | Nomenclature | Revision
6 | Symmetry of entretoise_upper_front_bearing_support.1_1 | Part
Bill of Material: Rear ARB Rod
Quantity | Part Number | Type | Nomenclature | Revision
1 | SU_1500_006 | Part
2 | SA 6 E-SA 6 E.1 | Part
2 | emile_maurin_125016 | Part
1 | Vis pour couteaux ARB | Assembly
Bill of Material: Vis pour couteaux ARB
Quantity | Part Number | Type | Nomenclature | Revision
1 | 6x35CHC | Part
2 | rondelle_M6 | Part
2 | entretoise_16mm | Part
1 | ecrou_M6_NS | Part
Bill of Material: Symmetry of SU_A1500
Quantity | Part Number | Type | Nomenclature | Revision
1 | Symmetry of chape rear ARB | Part
2 | Symmetry of REAR_ARB_couteau | Part
Bill of Material: Symmetry of Rear ARB Rod
Quantity | Part Number | Type | Nomenclature | Revision
1 | Symmetry of SU_1500_006 | Part
2 | Symmetry of SA 6 E-SA 6 E.1 | Part
2 | Symmetry of emile_maurin_125016 | Part
1 | Symmetry of Vis pour couteaux ARB | Assembly
Bill of Material: Symmetry of Vis pour couteaux ARB
Quantity | Part Number | Type | Nomenclature | Revision
1 | Symmetry of 6x35CHC_1 | Part
2 | Symmetry of rondelle_M6 | Part
2 | Symmetry of entretoise_16mm | Part
1 | Symmetry of ecrou_M6_NS | Part
Bill of Material: SU_1400_005 (biellette)
Quantity | Part Number | Type | Nomenclature | Revision
1 | ecrou_M6 | Part
1 | SA 6 E-SA 6 E.1 | Part
1 | SI 6 E-SI 6 E | Part
1 | Vis pour couteaux ARB | Assembly
Bill of Material: Symmetry of SU_A1400_1
Quantity | Part Number | Type | Nomenclature | Revision
1 | Symmetry of SU_1400_002 (Chape droite)_1 | Part
1 | Symmetry of ARB_pivot_3 | Part
1 | Symmetry of FRONT_ARB_BARRE | Part
2 | Symmetry of end_plate_1 | Part
1 | Symmetry of GE 12 C-GE 12 C | Assembly
Bill of Material: Symmetry of GE 12 C-GE 12 C
Quantity | Part Number | Type | Nomenclature | Revision
1 | Symmetry of GE 12 C_dummy-GE 12 C_dummy | Part
1 | Symmetry of GE 12 C_or-GE 12 C_or | Part
1 | Symmetry of GE 12 C_ir-GE 12 C_ir | Part
Bill of Material: Symmetry of SU_1400_005 (biellette)
Quantity | Part Number | Type | Nomenclature | Revision
1 | Symmetry of ecrou_M6 | Part
1 | Symmetry of SA 6 E-SA 6 E.1 | Part
1 | Symmetry of SI 6 E-SI 6 E | Part
1 | Symmetry of Vis pour couteaux ARB | Assembly
Recapitulation of: SU
Different parts: 412
Total parts: 1154
Quantity | Part Number
1 | Shape_642
1 | Shape_645
1 | Shape_646
1 | Shape_647
1 | Shape_648
1 | Shape_649
1 | Shape_650
1 | Shape_651
1 | Shape_652
1 | Shape_653
1 | Shape_662
1 | Shape_669
1 | Shape_670
1 | Shape_671
1 | Shape_672
1 | Shape_429
1 | Shape_430
1 | Shape_431
1 | Shape_432
1 | Shape_433
1 | Shape_437
1 | Shape_440
1 | Shape_439
1 | Shape_441
1 | Shape_438
1 | Shape_436
1 | Shape_562
1 | Shape_678
1 | Shape_679
1 | Shape_818
1 | Shape_819
1 | Shape_820
1 | Shape_469
1 | Shape_471
1 | Shape_472
1 | Shape_473
1 | Shape_475
1 | Shape_477
1 | Shape_478
1 | Shape_479
1 | Shape_480
1 | Shape_488
1 | Shape_582
1 | Shape_583
1 | Shape_614
1 | Shape_664
1 | Shape_665
1 | Shape_585
1 | Shape_584
1 | Shape_463
1 | Shape_464
1 | Shape_465
1 | Shape_467
1 | Shape_468
1 | Shape_558
1 | Shape_559
1 | Shape_576
1 | Shape_591
1 | Shape_592
1 | Shape_593
1 | Shape_594
1 | Shape_603
1 | Shape_604
1 | Shape_605
1 | Shape_606
1 | Shape_607
1 | Shape_608
1 | Shape_609
1 | Shape_610
1 | Shape_623
1 | Shape_624
1 | Shape_625
1 | Shape_630
1 | Shape_632
1 | Shape_633
1 | Shape_639
1 | Shape_640
1 | Shape_445
1 | Shape_448
1 | Shape_449
1 | Shape_452
1 | Shape_453
1 | Shape_454
1 | Shape_455
1 | Shape_456
1 | Shape_457
1 | Shape_459
1 | Shape_460
1 | Shape_461
1 | Shape_573
1 | Shape_574
1 | Shape_586
1 | Shape_587
1 | Shape_588
1 | Shape_589
1 | Shape_600
1 | Shape_601
1 | Shape_634
1 | Shape_635
1 | Shape_636
1 | filaire
1 | Suspension_Frame_points
1 | Wireframe_Front_Upright
1 | Wireframe_Rear_Upright
1 | Wireframe_Front_Wheel
1 | Wireframe_Rear_Wheel
2 | Wireframe_Front_Upper_Arm
2 | Front_Upper_A_Arm_Rear_Rod
2 | Front_Upper_A_Arm_Front_Rod
16 | Insert Frame Side
20 | GE 6 E_dummy-GE 6 E_dummy
20 | GE 6 E_or-GE 6 E_or
20 | GE 6 E_ir-GE 6 E_ir
2 | Front_Lower_A_Arm_Rear_Rod
2 | Front_Lower_A_Arm_Front_Rod
2 | Wireframe_Front_Lower_Arm
2 | Rear_Lower_A_Arm_Rear_Rod
2 | Rear_Lower_A_Arm_Front_Rod
2 | Wireframe_Rear_Lower_Arm
2 | Rear_Upper_A_Arm_Front_Rod
2 | Rear_Upper_A_Arm_Rear_Rod
2 | Wireframe_Rear_Upper_Arm
4 | Piston
4 | Corps
2 | Front_Push_Rod
4 | Front_Rocker
4 | Rear_Rocker
2 | Rear_Push_Rod
2 | Steering_Link
16 | SU_0900_002
19 | SA 6 E-SA 6 E.1
18 | emile_maurin_125016
2 | Toe_Link
1 | Steering_box
1 | Steering_spline
1 | Steering_column
1 | Steering_Shaft_pivot
1 | Steering_Wheel
1 | Left_Wireframe_Front_Lower_Arm
1 | Left_Wireframe_Front_Upper_Arm
1 | Left_Wireframe_Front_Wheel
2 | Left_Wireframe_Front_Upright
1 | Left_Wireframe_Rear_Lower_Arm
1 | Left_Wireframe_Rear_Upper_Arm
1 | Left_Wireframe_Rear_Wheel
2 | Left_Wireframe_Rear_Upright
2 | Steering_Rack
1 | FO_Poids
1 | Produit15
1 | Produit14
1 | Produit13
1 | Produit12
1 | Produit11
1 | Produit10
1 | Produit9
1 | Produit8
1 | Produit2
1 | Produit1
1 | Produit3
1 | Produit4
1 | Produit5
1 | Produit6
1 | Produit7
1 | PO-Z_RR Brake Force
1 | SS-XZ_RR Outter Bearing
1 | SS-XZ_RR Inner Bearing
1 | PO-Y_RR Inner Bearing
1 | PO-Z_Fz-RR
1 | PO-Z_Fz-RL
1 | BJ_Front UF
1 | BJ_Front UR
1 | BJ_Front LR
1 | BJ_Front LF
1 | BJ_Front LF Outboard
1 | BJ_Front LR Outboard
1 | BJ_Front UR Outboard
1 | BJ_Front UF Outboard
1 | BJ_FR Pull-Rod
1 | BJ_FR Inboard Pull Rod
1 | BJ_Outboard FR Ohlins
1 | BJ_Inboard FR Ohlins
1 | BJ_Outboard FR Tie-rod
1 | BJ_Inboard FR Tie-rod
1 | SS-XZ_FR Inner bearing
1 | SS-XZ_FR Outer bearing
1 | PO-Y_FR Wheel Axial Force
1 | PO-Z_FR Brake Force
1 | PI_FR Rocker Pivot
1 | PO-Z_Fz-FL
1 | PO-Z_Fz-FR
1 | SU_1000_001 (Front Left Upright)
2 | WT_0100_001 (Oz Magnesium Rim)
2 | WT_0100_002 (Tire Hoosier 13)
1 | WT_0200_001 (Front Hub)
1 | BR_0100_001_MM (Brake Caliper)
1 | BR_0200_001 (Break Disc)
2 | SU_10002 (Upper Arm Bracket)
1 | SU_10003 (Upper Arm Wedge)
4 | S71910 ACD/P4A_PART1-S71910 ACD/P4A_PART1
4 | S71910 ACD/P4A_PART2-S71910 ACD/P4A_PART2
100 | S71910 ACD/P4A_PART3-S71910 ACD/P4A_PART3
1 | WT_02003 (Front Bearing Washer)
1 | MB 10-MB 10
1 | KM 10-KM 10
2 | rondelle_M8.1
2 | ISO 4762 SCREW M8x20 STEEL HEXAGON SOCKET HEAD CAP.2
3 | 6x50CHC
20 | ecrou_M6_NS
40 | rondelle_M6
3 | 6x55CHC
4 | 6x40CHC
6 | 5x20CHC
6 | ecrou_M5_NS
12 | rondelle_M5
3 | WT_02004 (Speed Sensor Disc Spacer)
12 | entretoise_upper_front_bearing_support.1
2 | roue dente capteur vitesse
2 | Speed Sensor
2 | WT_02006 (Speed Sensor Disc Spacer 3mm)
1 | Brake Bell
4 | Speed_sensor_washer
1 | SU_02001
1 | Upper front bearing support
4 | SU_0100_006
1 | Lower rear bearing support
1 | SU_11001 (Rear Left Upright)
1 | 2D1 ass
1 | WT_03001 (Rear Hub)
1 | Tripod housing spacer
1 | 4483 Polaris (20T)
1 | SU_11003 (Rear Upper Arm Wedge)
4 | 8x25CHC
12 | ecrou_M8_NS
24 | rondelle_M8
2 | 8x35CHC
1 | 4484 VW (22T)
1 | Tulipe
1 | nut_iso_10512-m20x1_5-10
1 | 193
1 | Brake Bell.2
1 | WT_03003 (Rear Bearing Washer)
1 | SA 6 E-SA 6 E
1 | SU_1400_002 (Chape droite)
2 | ARB_pivot_3
1 | FRONT_ARB_BARRE
2 | end_plate
2 | GE 12 C_dummy-GE 12 C_dummy
2 | GE 12 C_or-GE 12 C_or
2 | GE 12 C_ir-GE 12 C_ir
1 | chape rear ARB
1 | Rear_ARB_Barre
2 | REAR_ARB_couteau
1 | bracket_triangle_arriere_bas_bras_avant_1
1 | bracket_triangle_arriere_bas_bras_avant_2
1 | bracket_triangle_arriere_haut_bras_avant_1
1 | bracket_triangle_arriere_haut_bras_avant_2
1 | bracket_triangle_avant_bas_bras_avant_1
1 | bracket_triangle_avant_bas_bras_avant_2
1 | bracket_triangle_avant_haut_bras_avant_1
1 | bracket_triangle_avant_haut_bras_avant_2
1 | bracket_triangle_avant_haut_bras_arriere_1
1 | bracket_triangle_avant_haut_bras_arriere_2
1 | bracket_triangle_arriere_haut_bras_arriere_1
1 | bracket_triangle_arriere_haut_bras_arriere_2
1 | bracket_triangle_arriere_bas_bras_arriere_2
1 | bracket_triangle_avant_bas_bras_arriere_1
1 | bracket_triangle_avant_bas_bras_arriere_2
1 | bracket_triangle_arriere_bas_bras_arriere_1
18 | entretoise_upper_front_bearing_support
9 | ecrou_knuts
11 | 6x35CHC
9 | Symmetry of 6x35CHC
9 | Symmetry of ecrou_knuts
18 | Symmetry of entretoise_upper_front_bearing_support
1 | Symmetry of bracket_triangle_arriere_bas_bras_avant_1
1 | Symmetry of bracket_triangle_arriere_bas_bras_avant_2
1 | Symmetry of bracket_triangle_arriere_haut_bras_avant_1
1 | Symmetry of bracket_triangle_arriere_haut_bras_avant_2
1 | Symmetry of bracket_triangle_avant_bas_bras_avant_1
1 | Symmetry of bracket_triangle_avant_bas_bras_avant_2
1 | Symmetry of bracket_triangle_avant_haut_bras_avant_1
1 | Symmetry of bracket_triangle_avant_haut_bras_avant_2
1 | Symmetry of bracket_triangle_avant_haut_bras_arriere_1
1 | Symmetry of bracket_triangle_avant_haut_bras_arriere_2
1 | Symmetry of bracket_triangle_arriere_haut_bras_arriere_1
1 | Symmetry of bracket_triangle_arriere_haut_bras_arriere_2
1 | Symmetry of bracket_triangle_arriere_bas_bras_arriere_2
1 | Symmetry of bracket_triangle_avant_bas_bras_arriere_1
1 | Symmetry of bracket_triangle_avant_bas_bras_arriere_2
1 | Symmetry of bracket_triangle_arriere_bas_bras_arriere_1
1 | chape_rear_susp
1 | bracket_front_rocker_avant
1 | bracket_front_rocker_arrière
1 | Symmetry of bracket_front_rocker_arrière
1 | Symmetry of bracket_front_rocker_avant
1 | Symmetry of chape_rear_susp
2 | Front_suspension_bracket
1 | Chape_rear_olhins
1 | Symmetry of Chape_rear_olhins
1 | Symmetry of Chape_rear_olhins_1
1 | Symmetry of Wireframe_Front_Lower_Arm
1 | Symmetry of SU_02001
1 | Symmetry of GE 6 E_dummy-GE 6 E_dummy
1 | Symmetry of GE 6 E_or-GE 6 E_or
1 | Symmetry of GE 6 E_ir-GE 6 E_ir
1 | Symmetry of Wireframe_Rear_Lower_Arm
1 | Symmetry of Lower rear bearing support
1 | Symmetry of GE 6 E_dummy-GE 6 E_dummy_2
1 | Symmetry of GE 6 E_or-GE 6 E_or_2
1 | Symmetry of GE 6 E_ir-GE 6 E_ir_2
1 | Upper rear bearing support
1 | Symmetry of Wireframe_Rear_Upper_Arm
1 | Symmetry of Upper rear bearing support
2 | Symmetry of GE 6 E_dummy-GE 6 E_dummy_3
2 | Symmetry of GE 6 E_or-GE 6 E_or_3
2 | Symmetry of GE 6 E_ir-GE 6 E_ir_3
4 | Symmetry of SU_0100_006_1
1 | Symmetry of Wireframe_Front_Upper_Arm
1 | Symmetry of Upper front bearing support
1 | Symmetry of Left_Wireframe_Front_Upright
1 | Symmetry of SU_1000_001 (Front Left Upright)
1 | Symmetry of WT_0100_001 (Oz Magnesium Rim)_1
1 | Symmetry of WT_0100_002 (Tire Hoosier 13)_1
1 | Symmetry of WT_0200_001 (Front Hub)
1 | Symmetry of BR_0100_001_MM (Brake Caliper)
1 | Symmetry of BR_0200_001 (Break Disc)
1 | Symmetry of Brake Bell
1 | Symmetry of SU_10002 (Front Upper Arm Bracket)_1
1 | Symmetry of SU_10003 (Upper Arm Wedge)
2 | Symmetry of S71910 ACD/P4A_PART1-S71910 ACD/P4A_PART1_1
2 | Symmetry of S71910 ACD/P4A_PART2-S71910 ACD/P4A_PART2_1
50 | Symmetry of S71910 ACD/P4A_PART3-S71910 ACD/P4A_PART3_1
1 | Symmetry of WT_02003 (Front Bearing Washer)
1 | Symmetry of MB 10-MB 10
1 | Symmetry of KM 10-KM 10
2 | Symmetry of rondelle_M8.1
2 | Symmetry of ISO 4762 SCREW M8x20 STEEL HEXAGON SOCKET HEAD CAP
2 | Symmetry of 6x50CHC_1
5 | Symmetry of ecrou_M6_NS_1
10 | Symmetry of rondelle_M6_1
1 | Symmetry of 6x55CHC
2 | Symmetry of 6x40CHC_1
1 | Symmetry of WT_02004 (Speed Sensor Spacer)
1 | Symmetry of WT_02005 (Speed Sensor Disc)
1 | Symmetry of Front Speed Sensor Bracket
6 | Symmetry of entretoise_upper_front_bearing_support.1
4 | Front_Rocker.1
4 | vis_epaulee_6mm
8 | PCMF 060808 E
4 | Entretoise pivot basculeur
4 | 90576A104
8 | 6x45CHC
16 | Entretoise basculeur Rod
6 | 8x45CHC
12 | Entretoise_basculeur
4 | Rear_Rocker.1
2 | Symmetry of 8x45CHC
8 | Symmetry of ecrou_M8_NS_1
4 | Symmetry of Entretoise_basculeur
16 | Symmetry of rondelle_M8_1
1 | Symmetry of Left_Wireframe_Rear_Upright
1 | Symmetry of SU_11001 (Rear Left Upright)
1 | Symmetry of 2D1 ass
1 | Symmetry of WT_0100_001 (Oz Magnesium Rim)
1 | Symmetry of WT_0100_002 (Tire Hoosier 13)
2 | Symmetry of S71910 ACD/P4A_PART1-S71910 ACD/P4A_PART1
2 | Symmetry of S71910 ACD/P4A_PART2-S71910 ACD/P4A_PART2
50 | Symmetry of S71910 ACD/P4A_PART3-S71910 ACD/P4A_PART3
1 | Symmetry of WT_03001 (Rear Hub)
1 | Symmetry of Tripod housing spacer
1 | Symmetry of 4483 Polaris (20T)
1 | Symmetry of SU_11003 (Rear Upper Arm Wedge)
1 | Symmetry of SU_10002 (Front Upper Arm Bracket)
2 | Symmetry of 6x40CHC
7 | Symmetry of ecrou_M6_NS
14 | Symmetry of rondelle_M6
1 | Symmetry of 6x50CHC
2 | Symmetry of 6x55CHC_1
4 | Symmetry of 8x25CHC
2 | Symmetry of 8x35CHC
1 | Symmetry of 4484 VW (22T)
1 | Symmetry of Tulipe
1 | Symmetry of nut_iso_10512-m20x1_5-10
6 | Symmetry of entretoise_upper_front_bearing_support.1_1
1 | Symmetry of 193
1 | Symmetry of Speed Sensor
1 | Symmetry of ISO 8675 NUT M10x1 STEEL GRADE C HEXAGON THIN METRIC FINE
1 | Symmetry of roue dente capteur vitesse
1 | Symmetry of WT_02006 (Speed Sensor Spacer 3mm)
1 | Symmetry of WT_02004 (Speed Sensor Spacer)_1
1 | Symmetry of Brake Bell.2
1 | Symmetry of WT_03003 (Rear Bearing Washer)
1 | SU_1500_006
4 | entretoise_16mm
1 | Symmetry of chape rear ARB
2 | Symmetry of REAR_ARB_couteau
1 | Symmetry of SU_1500_006
3 | Symmetry of SA 6 E-SA 6 E.1
2 | Symmetry of emile_maurin_125016
2 | Symmetry of 6x35CHC_1
4 | Symmetry of entretoise_16mm
1 | ecrou_M6
1 | SI 6 E-SI 6 E
1 | Symmetry of SU_1400_002 (Chape droite)_1
1 | Symmetry of ARB_pivot_3
1 | Symmetry of FRONT_ARB_BARRE
2 | Symmetry of end_plate_1
1 | Symmetry of GE 12 C_dummy-GE 12 C_dummy
1 | Symmetry of GE 12 C_or-GE 12 C_or
1 | Symmetry of GE 12 C_ir-GE 12 C_ir
1 | Symmetry of ecrou_M6
1 | Symmetry of SI 6 E-SI 6 E
