EOSCogniton/STUF2019/CR - Cost Report/CBOM/Cost_v1.5.xlsx

Sheet: Summary
General Data |  |  |  | Overheads cost |  |  |  |  | Manufacturing cost
Category | Description | Value | Explanation | Category | Description | Cost | Depreciation time (year) | Cost/year | OP |  | Description | Variable | Way of costing | Cost | Depreciation time (year) | Cost/year
Manpower | Operator | 21376.00 € | Cost per year | Metrology | Micrometres | 2320.00 € | 10 | 232.00 € | Milling |  | 3 Axis CNC Mill Direct | No |  | 108020.00 € | 10 | 10802.00 €
 | Technician | 39809.00 € |  |  | Inside micrometers | 1838.40 € | 10 | 183.84 € | Power consumption (kW) | 22.4 | Milling tool holders | No |  | 4000.00 € | 5 | 800.00 €
 | Engineer | 69843.00 € |  |  | Indicators | 1272.00 € | 10 | 127.20 € | OPE | 80% | Fixtures | No |  | 2500.00 € | 5 | 500.00 €
 | Sales/administrative | 39809.00 € |  |  | Profile projector | 48334.81 € | 10 | 4833.48 € | OPM per job (Cleaning in min) | 5 | Maintenance | No | 5 % of initial cost /year | 5401.00 € | 1 | 5401.00 €
Time | Hours/week | 35 |  |  | Reference Block | 3209.60 € | 10 | 320.96 € | Removal rate (for Aluminium) (min/mm^3) | 0.0001 | Electricity | Yes | Cost/hour | 1.40 €
 | Week/year | 45.6 |  |  | Depth gauges | 492.90 € | 10 | 49.29 € | Programming time and supply order / mm^3 (50% of machining time) | 5e-05 | Cutting tools | Yes | €/hour | 20.00 €
 | Base OPE | 80% | Because prototyping company so not running all time, 6 percent used for maintenance and cleaning of shop floor |  | Measurement column | 5390.00 € | 10 | 539.00 € | Measuring and deflash time / mm^3 (40% of machining time) | 4e-05 | Cutting fluid | Yes | Refilling/year (1time) | 88.03 € | 1 | 88.03 €
 | People efficiency | 95% | People not working all time, need to pay them during this time | Real Estate | Electricity subscription | 2874.82 € | 1 | 2874.82 € | Setup time (fixture and tools) (min) | 20
Energies | Electricity Subscription | 2874.82 € |  |  | Electricity consumption for office and small components (avg 16kW) | 1999.47 € | 1 | 1999.47 € | Turning |  | CNC lathe with Y Axis | No |  | 133720.00 € | 10 | 13372.00 €
 | Electricity Rate /kWh | 0.08 € |  |  | Water (60m^3) | 132.96 € | 1 | 132.96 € | Power consumption (kW) | 29.8 | Turning tool holders | No |  | 19200.00 € | 10 | 1920.00 €
 | Water rate/m3 | 2.22 € |  | Manwork | Administrative/sales people | 39809.00 € | 1 | 39809.00 € | OPE | 80% | Turning insert holders | No |  | 4800.00 € | 5 | 960.00 €
Others | Euro --> Dollar Rate | 1.12964 |  |  | 40% engineer | 27937.20 € | 1 | 27937.20 € | OPM per job (Cleaning in min) | 5 | Maintenance | No | 5 % of initial cost /year | 6686.00 € | 1 | 6686.00 €
 | TVA | 20% |  |  | 5% of manwork OPE on shopfloor | 11403.29 € | 1 | 11403.29 € | Removal rate (for Aluminium) (min/mm^3) | 0.0001 | Electricity | Yes | Cost/hour | 1.87 €
 |  |  |  |  | Maintenance manwork | 13837.05 € | 1 | 13837.05 € | Programming time and supply order/ mm^3 (50% of machining time) | 5e-05 | Cutting tools | Yes | Cost/hour | 10.00 €
 |  |  |  | IT | Computers | 6843.36 € | 3 | 2281.12 € | Measuring and deflash time / mm^3 (40% of machining time) | 4e-05 | Cutting fluid | Yes | Refilling/year (1time) | 88.03 € | 1 | 88.03 €
 |  |  |  |  | Printer | 192.96 € | 3 | 64.32 € | Setup time (fixture and tools) (min) | 15
 |  |  |  |  | Printer consumable (4000 A4pages B&W, 1600 A4pages Colors) | 277.54 € | 1 | 277.54 € | Laser Cutting |  | 2D Laser cut | No |  | 185010.27 € | 10 | 18501.03 €
 |  |  |  |  | Office Pack (3 license) | 316.80 € | 1 | 316.80 € | Power consumption (kW) | 7.5 | Maintenance | No | 5 % of initial cost /year | 9250.51 € | 1 | 9250.51 €
 |  |  |  |  | Dedicated Software (Fusion 360) - 2 license | 796.80 € | 1 | 796.80 € | OPE | 70% | Electricity | Yes | Cost/hour | 0.47 €
 |  |  |  |  | Internet/phone access | 1224.00 € | 1 | 1224.00 € | OPM per job (Cleaning in min) | 5 | Assist Gas O2 or air | Yes | Cost/hour | 5.07 €
 |  |  |  |  | Phone/mobile phone | 381.00 € | 3 | 127.00 € | Removal rate (for steel) (min/mm) | 0.00046
 |  |  |  | Office | Office furniture | 200.00 € | 1 | 200.00 € | Programation time (min) | 1.5
 |  |  |  |  | Worktable & office storage | 10550.00 € | 10 | 1055.00 € | Measuring time (min) | 1
 |  |  |  | Manufacturing | Band Saw/Drill Press/Sheet metal bender/Hydraulic press/belt and disc grinder/Vise | 19442.43 € | 10 | 1944.24 € | Setup time (min) | 8
 |  |  |  |  | Lifting equipment | 3259.00 € | 10 | 325.90 € | Welding |  | TIG Welder & Chiller | No |  | 5308.60 € | 10 | 530.86 €
 |  |  |  |  | Forklift | 1031.54 € | 10 | 103.15 € |  |  | Fume extractor | No |  | 3859.60 € | 10 | 385.96 €
 |  |  |  |  | Roller Cabinet (3 V3 and 3+ V5) | 8137.45 € | 10 | 813.75 € | OPE | 80% | Welding Helmet | No |  | 146.00 € | 5 | 29.20 €
 |  |  |  |  | Other specific tools (scribing tool, eletrical pliers, simple measuring tools, …) | 4068.73 € | 10 | 406.87 € | Welding speed (min/m) | 140.4308321 | Specific PPE | No |  | 196.00 € | 2 | 98.00 €
 |  |  |  |  | Power tools | 4000.00 € | 5 | 800.00 € |  |  | Specific workstation and tooling | No |  | 8579.00 € | 10 | 857.90 €
 |  |  |  |  | Consumables (saw blades, drill bits, taps, abrasives, …) | 3000.00 € | 1 | 3000.00 € |  |  | Maintenance | No | 3% of initial cost/year | 275.05 € | 1 | 275.05 €
 |  |  |  |  | Locker | 2302.57 € | 10 | 230.26 € |  |  | Electricity | Yes | cost/hour | 0.10 €
 |  |  |  |  | Workstations | 7066.95 € | 10 | 706.69 € |  |  | Filler (aluminium) | Yes | €/length | 0.09 €
 |  |  |  |  | Storage equipment (Shelves, drawer, tool cart, boxes, …) | 7110.13 € | 10 | 711.01 € |  |  | Filler (Inox) |  |  | 0.05 €
 |  |  |  |  | Air compressor | 12999.00 € | 10 | 1299.90 € |  |  | Gaz | Yes | €/length | 14.35 €
 |  |  |  |  | Electricity for air compressor (15kW) | 1874.50 € | 1 | 1874.50 € | Conventionnal machining |  | Conventionnal milling machine | No |  | 15000.00 € | 10 | 1500.00 €
 |  |  |  |  | Industrial Hoovers | 2150.00 € | 10 | 215.00 € | Power consumption (kW) | 6 | Conventionnal turning machine | No |  | 10000.00 € | 10 | 1000.00 €
 |  |  |  |  |  |  |  |  | OPE | 44% | Tool holders and fixtures | No |  | 7625.00 € | 5 | 1525.00 €
 |  |  |  | Overhead Summary |  |  |  |  | OPM per job (Cleaning in min) | 5 | Maintenance | No | 3 % of initial cost /year | 750.00 € | 1 | 750.00 €
 |  |  |  | Fixed Cost | Sum of fixed cost/year (+5% extra equipment integrated) |  |  | 129206.10 € | Removal rate (for aluminium) (include measuring) (min/mm^3) | 0.0003 | Electricity | Yes | Cost/hour | 0.38 €
 |  |  |  |  | Fixed cost/hour to charge on operation (machine/station/programing/metrology) |  |  | 11.85 € | Setup time (fixture and tools) (min) | 10 | Cutting tools | Yes | Cost/hour | 10.00 €
 |  |  |  | Manpower cost | Operator cost/hour |  |  | 12.72 €
 |  |  |  |  | Technician cost/hour |  |  | 23.70 € | Manufacturing Summary
 |  |  |  |  | Welder cost/hour |  |  | 29.86 € | Milling |  | Yearly fixed cost of machine |  |  |  | 17591.03 €
 |  |  |  |  | Engineer cost/hour |  |  | 41.57 € | For aluminium as standard |  | Fixed cost of machine / hour |  |  |  | 25.63 €
 |  |  |  |  |  |  |  |  | Price for cutting Steel | 250% | Cost of machine/hour running |  |  |  | 47.03 €
 |  |  |  |  |  |  |  |  | Price for cutting Delrin | 50%
 |  |  |  |  |  |  |  |  |  |  | Cost of machining part (€/mm^3) |  |  |  | 9.959568097e-05
 |  |  |  |  |  |  |  |  |  |  | Manpower part of machining cost |  |  |  | 21.29243859%
 |  |  |  |  |  |  |  |  |  |  | Cost of programing part Operator (€/mm^3) |  |  |  | 2.048070021e-05
 |  |  |  |  |  |  |  |  |  |  | Cost of programing part Technician(€/mm^3) |  |  |  | 2.962405339e-05
 |  |  |  |  |  |  |  |  |  |  | Cost of programing part Engineer (€/mm^3) |  |  |  | 4.452187085e-05
 |  |  |  |  |  |  |  |  |  |  | Cost of measuring part Operator (€/mm^3) |  |  |  | 1.638456017e-05
 |  |  |  |  |  |  |  |  |  |  | Cost of measuring part Technician(€/mm^3) |  |  |  | 2.369924271e-05
 |  |  |  |  |  |  |  |  |  |  | Cost of measuring part Engineer (€/mm^3) |  |  |  | 3.561749668e-05
 |  |  |  |  |  |  |  |  |  |  | Cost of Setup + cleaning |  |  |  | 15.98 €
 |  |  |  |  |  |  |  |  | Turning |  | Yearly fixed cost of machine |  |  |  | 23026.03 €
 |  |  |  |  |  |  |  |  | For aluminium as standard |  | Fixed cost of machine / hour |  |  |  | 29.89 €
 |  |  |  |  |  |  |  |  | Price for cutting Steel | 250% | Cost of machine/hour running |  |  |  | 41.75 €
 |  |  |  |  |  |  |  |  | Price for cutting Delrin | 50%
 |  |  |  |  |  |  |  |  |  |  | Cost of machining part (€/mm^3) |  |  |  | 9.079613362e-05
 |  |  |  |  |  |  |  |  |  |  | Manpower part of machining cost |  |  |  | 23.35600467%
 |  |  |  |  |  |  |  |  |  |  | Cost of programing part Operator (€/mm^3) |  |  |  | 2.048070021e-05
 |  |  |  |  |  |  |  |  |  |  | Cost of programing part Technician(€/mm^3) |  |  |  | 2.962405339e-05
 |  |  |  |  |  |  |  |  |  |  | Cost of programing part Engineer (€/mm^3) |  |  |  | 4.452187085e-05
 |  |  |  |  |  |  |  |  |  |  | Cost of measuring part Operator (€/mm^3) |  |  |  | 1.638456017e-05
 |  |  |  |  |  |  |  |  |  |  | Cost of measuring part Technician(€/mm^3) |  |  |  | 2.369924271e-05
 |  |  |  |  |  |  |  |  |  |  | Cost of measuring part Engineer (€/mm^3) |  |  |  | 3.561749668e-05
 |  |  |  |  |  |  |  |  |  |  | Cost of Setup + cleaning |  |  |  | 14.20 €
 |  |  |  |  |  |  |  |  | Laser cutting |  | Yearly fixed cost of machine |  |  |  | 27751.54 €
 |  |  |  |  |  |  |  |  | For steel as standard |  | Fixed cost of machine / hour |  |  |  | 36.69 €
 |  |  |  |  |  |  |  |  | Price for cutting aluminium | 71.73913043% | Cost of machine/hour running |  |  |  | 42.24 €
 |  |  |  |  |  |  |  |  |  |  | Cost of machining part (€/mm) |  |  |  | 0.0003628281908
 |  |  |  |  |  |  |  |  |  |  | Manpower part of machining cost |  |  |  | 26.88578474%
 |  |  |  |  |  |  |  |  |  |  | Cost of programing part Operator (€) |  |  |  | 0.61 €
 |  |  |  |  |  |  |  |  |  |  | Cost of programing part Technician(€) |  |  |  | 0.89 €
 |  |  |  |  |  |  |  |  |  |  | Cost of measuring part Operator (€) |  |  |  | 0.41 €
 |  |  |  |  |  |  |  |  |  |  | Cost of measuring part Technician(€) |  |  |  | 0.59 €
 |  |  |  |  |  |  |  |  |  |  | Cost of Setup + cleaning |  |  |  | 10.71 €
 |  |  |  |  |  |  |  |  | Welding |  | Yearly fixed cost of machine |  |  |  | 2176.97 €
 |  |  |  |  |  |  |  |  |  |  | Fixed cost of machine / hour |  |  |  | 13.56 €
 |  |  |  |  |  |  |  |  |  |  | Cost of machine/hour running |  |  |  | 13.66 €
 |  |  |  |  |  |  |  |  |  |  | Cost of aluminium welding part (€/m) |  |  |  | 116.28 €
 |  |  |  |  |  |  |  |  |  |  | Cost of steel welding part (€/m) |  |  |  | 116.25 €
 |  |  |  |  |  |  |  |  | Conventionnal machining |  | Yearly fixed cost of machine |  |  |  | 4775.00 €
 |  |  |  |  |  |  |  |  |  |  | Fixed cost of machine / hour |  |  |  | 18.65 €
 |  |  |  |  |  |  |  |  |  |  | Cost of machine/hour running |  |  |  | 29.03 €
 |  |  |  |  |  |  |  |  |  |  | Cost of machining part (€/mm^3) |  |  |  | 0.0002087617494
 |  |  |  |  |  |  |  |  |  |  | Cost of Setup + cleaning |  |  |  | 7.84 €

Sheet: Manpower & time
Source | Description | Source
 | Automotive wage table | https://www.gestionnaire-paie.com/convention-collective-automobile-salaires-minima/
 | Wage cost calculation for salary | https://travail-emploi.gouv.fr/emploi/accompagnement-des-tpe-pme/tpe-pme/article/le-simulateur-du-cout-d-embauche
 | Working time | https://www.juristique.org/social/duree-du-travail
Manpower cost | Manpower | Gross wage/month | Yearly wage cost for the company | Yearly wage cost for the company (95%) | Shopfloor allocation | Fixed cost (5% of the time) | Variable cost for 1 op (€/hour)
 | Operator - Grade 4 | 1592.00 € | 21376.00 € | 20307.20 € | 4.5 | 4809.60 € | 12.72 €
 | Technician - Grade 25 | 2438.00 € | 39809.00 € | 37818.55 € | 1 | 1990.45 € | 23.70 €
 | Welder - Grade II C | 3077.00 € | 50159.00 € | 47651.05 € | 1 | 2507.95 € | 29.86 €
 | Engineer - Grade IV A | 4104.00 € | 69843.00 € | 66350.85 € | 0.6 | 2095.29 € | 41.57 €
 |  |  |  | Sum | 6.1 | 11403.29 €
Data for working time | Description | Value
 | Days/year | 365
 | Days of weekend | 104
 | Bank holliday | 8
 | Payed holliday (5 week) | 25
 | Theoretical worked days | 228
 | Theoretical worked week | 45.6
 | Manwork availability (95%) /year (hrs) | 1516.2
Workforce allocation |  | CNC mill | CNC lathe | Laser Cutting (Operator needed for 0.5*time running ) | Assembly | Conventionnal machining | Welding/Assembly | CNC programmation | Metrology | Maintenance | Total
 | Operator - Grade 4 | 0.85 | 0.85 | 0.3 | 0.85 | 0.47 |  | 0.65 | 0.41 | 0.12 | 4.5
 | Technician - Grade 25 |  |  |  |  |  |  | 0.5 | 0.5 |  | 1
 | Welder + Grade II C |  |  |  |  |  | 0.85 |  | 0.05 | 0.1 | 1
 | Engineer - Grade IV A |  |  |  |  |  |  | 0.35 | 0.15 | 0.1 | 0.6
 | Sum of allocated op (hrs) | 1288.77 | 1288.77 | 454.86 | 1288.77 | 712.614 | 1288.77 | 2274.3 | 1682.982 | 485.184 | 10765.02
 | Required regarding OPE on workstations (hrs) | 1276.8 | 1276.8 | 1117.2 | 1276.8 | 702.24 | 1276.8 | 2282.28 | 1691.76 | 478.8 | 10709.16
 |  |  | Req manpower for laser 'special) | 446.88
Other | Maintenance manwork cost | 13837.05 €

Sheet: Energies
Electricity
Sources | https://www.kelwatt.fr/guide/prix-electricite-entreprise
 | https://www.fournisseurs-electricite.com/edf/pro/tarifs-reglementes/jaune#decomposition-facture
 | https://www.fournisseurs-electricite.com/guides/compteur/puissance/estimation
Subscription (€/kVA) (excl tax) | 38.64
Power needed (kVA) | 74.4
Subscription (€) (excl tax) | 2874.816
Price/kWh (excl tax) | 0.0783
Water
 | incl tax | excl tax | Source
Water (€/m3) | 2.77 € | 2.22 € | http://www.eau-direct.fr/gestion/prix.html

Sheet: Metrology
Description | Spec | Price ($) (incl tax) | Price (€) (incl tax) | Price (€) (excl tax) | Source
moveable head Indicator | 0.001mm |  | 149 € | 119.20 € | https://shop.mitutoyo.fr/web/mitutoyo/fr_FR/mitutoyo/1305010043843/Comparateur%20%C3%A0%20palpeur%20orientable%2C%20mod%C3%A8le%20horizontal/$catalogue/mituto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
Base + movable head indicator | 0.01 |  | 129 € | 103.20 € | https://shop.mitutoyo.fr/web/mitutoyo/fr_FR/mitutoyo/1305198758390/Comparateur%20%C3%A0%20palpeur%20orientable%2C%20mod%C3%A8le%20horizontal/$catalogue/mituto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
Indicator | 0.01 |  | 60 € | 48.00 € | https://shop.mitutoyo.fr/web/mitutoyo/fr_FR/mitutoyo/1300888710750/Comparateur%20m%C3%A9canique%2C%20dos%20plat/$catalogue/mitutoyoData/PR/2044SB/index.xhtml
pneumatic base |  |  | 392 € | 313.60 € | https://shop.mitutoyo.fr/web/mitutoyo/fr_FR/mitutoyo/01.05.0331/Base%20pneumatique/index.xhtml
Magnetic stand multiple joint |  |  | 167 € | 133.60 € | https://shop.mitutoyo.fr/web/mitutoyo/fr_FR/mitutoyo/01.05.03/Support%20articul%C3%A9%20magn%C3%A9ti/$catalogue/mitutoyoData/PR/7019B/index.xhtml
Magnetic stand basic |  |  | 94 € | 75.20 € | https://shop.mitutoyo.fr/web/mitutoyo/fr_FR/mitutoyo/01.05.033/Base%20magn%C3%A9tique%20avec%20r%C3%A9glage%20fin/$catalogue/mitutoyoData/PR/7011SN/index.xhtml
V Block |  |  | 282 € | 225.60 € | https://shop.mitutoyo.fr/web/mitutoyo/fr_FR/mitutoyo/01.05.077/Paire%20de%20v%C3%A9s/$catalogue/mitutoyoData/PR/911-111/index.xhtml
Granit surface plate |  |  | 408 € | 326.40 €
Gauge block set |  |  | 3322 € | 2657.60 € | https://shop.mitutoyo.fr/web/mitutoyo/fr_FR/mitutoyo/01.07.01/Jeu%20de%20cales%20-%20m%C3%A9trique%20-%20Cert.%20Insp.%20-%20ISO/$catalogue/mitutoyoData/PR/51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
External Micrometer | 0-100 0.001 |  | 1390 € | 1112.00 € | https://shop.mitutoyo.fr/web/mitutoyo/fr_FR/mitutoyo/01.02.01.0/Microm%C3%A8tre%20DIGIMATIC%20IP65%20en%20jeu%200-100%20mm/$catalogue/mitutoyoData/PR/293-963/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
 | 150-300 0.01 |  | 1202 € | 961.60 € | https://shop.mitutoyo.fr/web/mitutoyo/fr_FR/mitutoyo/01.02.01.032/Microm.%20d%27ext%C3%A9rieur%20col%20de%20cygne%20en%20jeu/$catalogue/mitutoyoData/PR/103-91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
 | 100-125 0.01 |  | 146 € | 116.80 € | https://shop.mitutoyo.fr/web/mitutoyo/fr_FR/mitutoyo/01.02.01.031/Microm.%20d%27ext%C3%A9rieur%20col%20de%20cygne/$catalogue/mitutoyoData/PR/103-141-10/index.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
 | 125-150 0.01 |  | 162 € | 129.60 € | https://shop.mitutoyo.fr/web/mitutoyo/fr_FR/mitutoyo/01.02.01.031/Microm.%20d%27ext%C3%A9rieur%20col%20de%20cygne/$catalogue/mitutoyoData/PR/103-142-10/index.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
Inside micrometer | 20-50 0.005 |  | 1623 € | 1298.40 € | https://shop.mitutoyo.fr/web/mitutoyo/fr_FR/mitutoyo/1355993040307/Microm%C3%A8tre%20d%27int%C3%A9rieur%20Holtest%20en%20jeu%2020-50%20mm/$catalogue/mitutoyoD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
 | 12-20 0.005 |  | 675 € | 540.00 € | https://shop.mitutoyo.fr/web/mitutoyo/fr_FR/mitutoyo/1355993040307/Microm%C3%A8tre%20d%27int%C3%A9rieur%20Holtest%20en%20jeu/$catalogue/mitutoyoData/PR/368-99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
Electronic depth gauge | 0-200 0.01 | $348.00 | 308.06 € | 246.45 € | http://www.starrett.com/metrology/product-detail/3753A-8~200
Profil projector | 510x342 mm |  |  | 48334.81 € | https://www.orexad.com/fr/projecteur-de-profil-pj-h30/p-G1213001821
Measurement column | 600mm |  |  | 5390.00 € | https://www.orexad.com/fr/colonne-de-mesure-817clm-cap-600-770-pupitre-2d/p-G1197000019

Sheet: IT
Categories | Description | Comment on price | incl tax | excl tax | Source
Softwares | Fusion 360 | /Year/user | 498.00 € | 398.40 € | https://www.autodesk.fr/products/fusion-360/subscribe?plc=F360&term=1-YEAR&support=ADVANCED&quantity=1
 | Office 365 business | /month/user |  | 8.80 € | https://products.office.com/fr-fr/compare-all-microsoft-office-products?tab=2
Printing | Printer A3/A4/… Scan/Fax/Copy |  | 241.20 € | 192.96 € | https://store.hp.com/FranceStore/Merch/Product.aspx?id=G5J38A&opt=A80&sel=PRN
 | Black cartridge 2000 pages |  | 50.00 € | 40.00 € | https://store.hp.com/FranceStore/Merch/Product.aspx?id=L0S70AE&opt=&mastersku=L0S70AE&masteropt=&sel=SUP
 | 4 pack cartridge 1600 pages |  | 137.99 € | 110.39 € | https://store.hp.com/FranceStore/Merch/Product.aspx?id=3HZ52AE&opt=&mastersku=3HZ52AE&masteropt=&sel=SUP
 | A4 *2500 |  |  | 23.60 € | https://www.officedepot.fr/a/pb/Papier-Office-Depot-A4-80-g-m2-Blanc-Business-2500-Feuilles/pr=&id=1456200/
 | A3*2500 |  |  | 39.95 € | https://www.officedepot.fr/a/pb/Papier-Office-Depot-A3-80-g-m2-Blanc-Everyday-2500-Feuilles/pr=&id=3057842/
Computer | Laptop |  | 2097.60 € | 1678.08 € | https://store.hp.com/FranceStore/Merch/Product.aspx?id=2ZC41ET&opt=ABF&mastersku=2ZC41ET&masteropt=ABF&sel=NTB
 | CAD PC |  | 2150.10 € | 1720.08 € | https://store.hp.com/FranceStore/Merch/Product.aspx?id=6QN64ET&opt=ABF&sel=DTP
 | Office computer |  | 620.40 € | 496.32 € | https://store.hp.com/FranceStore/Merch/Product.aspx?id=4CZ83ET&opt=ABF&mastersku=4CZ83ET&masteropt=ABF&sel=DTP
Accessories | Screen 24" |  | 183.60 € | 146.88 € | https://store.hp.com/FranceStore/Merch/Product.aspx?id=3ML21AT&opt=ABB&mastersku=3ML21AT&masteropt=ABB&sel=MTO
 | Laptop backpack |  | 54.00 € | 43.20 € | https://store.hp.com/FranceStore/Merch/Product.aspx?id=1KM17AA&opt=&mastersku=1KM17AA&masteropt=&sel=DEF
 | Keyboard and mouse |  | 40.80 € | 32.64 € | https://store.hp.com/FranceStore/Merch/Product.aspx?id=T6T83AA&opt=ABF&mastersku=T6T83AA&masteropt=ABF&sel=ACC
 | Docking station |  | 217.20 € | 173.76 € | https://store.hp.com/FranceStore/Merch/Product.aspx?id=1MK33AA&opt=ABB&mastersku=1MK33AA&masteropt=ABB&sel=ACC
Internet access | Internet/phone access 2 standard line, one mobile | /month |  | 102.00 € | Orange Document
Phones | Mobile phone for shop floor |  |  | 96.00 € | https://www.telecomsupplier.fr/avaya-3730-dect-combine.html
 | 4 phones |  |  | 285.00 € | https://www.telecomsupplier.fr/avaya-1608-i-ip-telephone-paquet-de-4.html

Sheet: Office
Description | Comment on price | Incl tax | Excl tax | Link
Angle worktable |  |  | 619.00 € | https://www.francebureau.com/media/catalogue-mobilier/bureau-modulaire-kibo.pdf
Drawer |  |  | 248.00 € | https://www.francebureau.com/media/catalogue-mobilier/bureau-modulaire-kibo.pdf
Shelves without door |  |  | 320.00 € | https://www.francebureau.com/media/catalogue-mobilier/bureau-modulaire-kibo.pdf
Shelves with door |  |  | 515.00 € | https://www.francebureau.com/media/catalogue-mobilier/bureau-modulaire-kibo.pdf
Direction worktable |  |  | 1125.00 € | https://www.francebureau.com/media/catalogue-mobilier/bureau-direction-etretat.pdf
Meeting table |  |  | 1851.00 € | https://www.francebureau.com/media/catalogue-mobilier/table-reunion-modulable-arc-reunion.pdf
Chair |  |  | 417.00 € | https://www.francebureau.com/alto-16.html

Sheet: Manufacturing
Category | Description | Spec info | Price ($) (incl tax) | Price ($) (excl tax) | Price (€) (incl tax) | Price (€) (excl tax) | Source
Machinery equipment | Sheet metal bender |  |  | $1295.00 |  | 1146.38 € | https://www.baileigh.com/sheet-metal-brake-hb-4816e
 | Stock Band saw |  |  | $13995.00 |  | 12388.90 € | https://www.baileigh.com/semi-auto-band-saw-bs-330sa
 | Manual Hydraulic press |  |  | $395.00 |  | 349.67 € | https://www.baileigh.com/hydraulic-shop-press-hsp-10h
 | Drill Press |  |  | $3795.00 |  | 3359.48 € | https://www.baileigh.com/variable-speed-drill-press-dp-1200vs
 | Drill press vise |  |  |  |  | 119.00 € | https://www.manutan.fr/fr/maf/etau-de-perceuse-rohm-machoire-largeur-100-mm-ouverture-95-mm
 | Disc and belt grinder |  |  |  |  | 379.00 € | https://www.manutan.fr/fr/maf/ponceuse-combinee-disque-bande-jsg-233-promac-230-v
 | Vise |  |  |  |  | 425.00 € | https://www.manutan.fr/fr/maf/etau-magnat
Tool cabinet | Roller cabinet + standard tooling | Tooling kit V3 |  |  |  | 1079.10 € | https://www.promeca.com/composition-v5-servante-chrono-6m3-facom-chrono-v5pb-promotion
 | Roller cabinet + standard tooling | Tooling kit V5 |  |  | 2041.73 € | 1633.38 € | https://www.master-outillage.com/facom/13765-servante-rouge-7-tiroirs-composition-d-outillage-v8-facom-jetv8m3-3148519073409.html
Air compressor | Air compressor | 10 bar 153000 l/h |  |  |  | 12999.00 € | https://www.orexad.com/fr/compresseur-a-vis-lubrifie-serie-l/p-G3697000582
Organising | Shelves | 5 |  |  |  | 69.40 € | https://www.orexad.com/fr/fond-tole-rayonnage-a-tablettes-tolees-g-robust/p-G1408010697
 | Stock Shelves | 1 |  |  |  | 1433.25 € | https://www.orexad.com/fr/rayonnage-mi-lourd-double-face-horizontale-g-lever/r-PR_G1408014469?
 | Small boxes cart | 1 |  |  |  | 1866.02 € | https://www.orexad.com/fr/desserte-de-transport/p-G1359000463
 | Tool holder cart | 1 |  |  |  | 859.65 € | https://www.orexad.com/fr/systemes-cn/p-G1359000803
 | Closed drawer | 3 |  |  |  | 699.07 € | https://www.orexad.com/fr/armoire-a-portes-battantes/p-G1359000412
 | Storage boxes | 30 |  |  |  | 16.90 € | https://www.orexad.com/fr/bac-rako/p-G1383000092
 | Standard workstation with drawer |  |  |  |  | 1001.67 € | https://www.orexad.com/fr/etabli-standard/p-G1359000849
 | Standard workstation |  |  |  |  | 352.31 € | https://www.orexad.com/fr/etabli-standard/p-G1359000830
 | Locker | 6persons |  |  |  | 2302.57 € | https://www.orexad.com/fr/vestiaire-ventile-sur-socle/r-PR_1012867?
Handling | Crane | 1600kg 4m height, 4m width |  |  |  | 3259.00 € | https://www.manutan.fr/fr/maf/pack-portique-d-atelier-chariot-palan-force-1600-kg
 | Forklift |  |  |  |  | 1031.54 € | https://www.orexad.com/fr/transpalette-galvanise-2-5t/p-G3019000006
Cleaning | Industrial hoover |  |  |  |  | 1075.00 € | https://www.manutan.fr/fr/maf/aspirateur-eau-et-poussieres-nt-70-2-me-tc-karcher

Sheet: CNC mill
https://www.haascnc.com/shop/category/pricelist.html
VF-3SSYT | 108020.00 € | https://www.haascnc.com/machines/vertical-mills/vf-series/models/medium/vf-3ssyt.html
12000 rpm
travel | x | 1016
 | y | 660
 | z | 635
22.4kW
122Nm @ 2000rpm
électrobroche
table | x | 1372
 | y | 610
Max cutting speed | 21.2m/min
poussée max sur axes | 13723N
Outils | 30+1
Lubrification | 208L
Air | 113L/min @ 6.9 bar
Electricity | 3phase 440 VAC 35-70A
Tool Holder | https://www.hoffmann-group.com/FR/fr/hof/Accessoires-machines/Porte-outils/c/30 | 80€ HT env
 | Price HT | Qté | Source
VF-3SSYT | 108020.00 € | 1 | Quote
Tool Holder | 100.00 € | 40 | https://www.hoffmann-group.com/FR/fr/hof/Accessoires-machines/Porte-outils/c/30
Milling vise | 2500.00 € | 1 | https://www.hoffmann-group.com/FR/fr/hof/Accessoires-machines/Etaux/Etau-haute-pression-CN---NC8/p/360405-125L
Coolant | https://www.otelo.fr/catalogue/fluides-huiles-coupe-solubles.html
 | Dilution | Qté (L) | Prix | Produit pur pour réservoir fraiseuse
Rocol Ultra cut 250+ | 4% | 5 | 79.52 € | 8.32 | 132.32 €
https://www.otelo.fr/catalogue/huile-coupe/rocol-0003050209-skg.html |  | 20 | 236.84 € |  | 98.53 €
 |  | 200 | 2116.00 € |  | 88.03 €

Sheet: CNC lathe
https://www.haascnc.com/shop/category/pricelist.html
HAAS ST35-Y | 133720.00 € | https://www.haascnc.com/machines/lathes/st/models/y-axis/st-35y.html
Cooling tank capacity (L) | 208
 | HT | Source
Tool Holder | 600.00 € | Haas
Driven tool holder | 2000.00 € | Haas
Turning insert holders | 160.00 € | Hoffman
Coolant | https://www.otelo.fr/catalogue/fluides-huiles-coupe-solubles.html
 | Dilution | Qté (L) | Prix | Produit pur pour réservoir fraiseuse
Rocol Ultra cut 250+ | 4% | 5 | 79.52 € | 8.32 | 132.32 €
https://www.otelo.fr/catalogue/huile-coupe/rocol-0003050209-skg.html |  | 20 | 236.84 € |  | 98.53 €
 |  | 200 | 2116.00 € |  | 88.03 €
 | 113L/min @ 6.9bar

Sheet: Laser cutter
https://www.bosslaser.com/metal-cutting-product/
Laser cutter |  | Spec info | Price $ TTC | Price $ HT | Price TTC | Price HT
Baileigh | 150cmx300cmx8mm max | 1000W for aluminium |  | 208995 |  | 185010.27 € | https://www.baileigh.com/cnc-laser-table-fl-510hd-500 |  |  |  | m^3/h | Bar | m^3/s | N/mm²
Assist gas O2 | 10.6m^3 @ 200bar | 4.5hours of cutting |  |  | 126.82 | 101.46 € | https://www.cedeo.fr/p/outillage-et-equipements/oxygene-grande-bouteille-10-6m3-ref-g110-i1001l50r2a001-A1204487 |  |  | Oxygen 45CFM@90PSI | 76.5 | 6.2 | 0.02125 | 0.62
 |  |  |  |  |  |  |  |  |  | Bottle |  |  | 10.6 | 20
 |  |  |  |  |  |  |  |  |  |  |  |  | 341.9354839 | 0.62
 |  |  |  |  |  |  |  |  |  |  |  |  | 4.469744887
 | Thickness | in/min | Thickness (mm) | mm/min
Mild Steel | 20ga | 780 | 0.81 | 19812 | 5.047445992e-05
 | 14ga | 230 | 1.63 | 5842 | 0.0001711742554
 | 11ga | 125 | 2.31 | 3175 | 0.0003149606299 |  |  | Medium removal rate steel | Medium removal rate aluminium
 | 8ga | 86 | 3.26 | 2184.4 | 0.0004577916133 |  |  | 0.00046 | 0.00033
 | 6ga | 74 | 4.12 | 1879.6 | 0.0005320280911 |  |  | Multiplicator for al cutting | 71.73913043%
 | 3ga | 59 | 5.82 | 1498.6 | 0.0006672894702
 | 1/4" | 50 | 6.35 | 1270 | 0.0007874015748
 | 5/16" | 30 | 7.938 | 762 | 0.001312335958
 | 3/8" | 23 | 9.525 | 584.2 | 0.001711742554
Stainless | 20ga | 780 | 0.81 | 19812 | 5.047445992e-05
 | 14ga | 216 | 1.63 | 5486.4 | 0.0001822688831
 | 11ga | 74 | 2.31 | 1879.6 | 0.0005320280911
 | 8ga | 47 | 3.26 | 1193.8 | 0.0008376612498
 | 6ga | 24 | 4.12 | 609.6 | 0.001640419948
Aluminium | 20ga | 300 | 0.81 | 7620 | 0.0001312335958
 | 14ga | 120 | 1.63 | 3048 | 0.0003280839895
 | 11ga | 28 | 2.31 | 711.2 | 0.001406074241

Sheet: Welding
Description | Spec info | Price $ TTC | Price $ HT | Price TTC | Price HT | Source
Tig Welder AC/DC |  |  |  |  | 4386.00 € | https://www.promeca.com/poste-a-souder-tig220-ac-dc-ta34-ref-eau-esab-caddy-tig2200iac-dc
Tig Chiller |  |  |  |  | 922.60 € | https://www.orexad.com/fr/refroidisseurs-cool-arc/p-G1189001474
Fume extractor |  |  |  |  | 3859.60 € | https://www.orexad.com/fr/mobiflex-200-m-systeme-d-aspiration-des-fumees/p-G1189001541
Adjustable height Welding table + clamping devices , squares |  |  |  |  | 8579.00 € | https://www.siegmund.com/fr/1-Tables-de-soudure/98-Professional-Extreme/2400x1200x200/Panorama,101.php
Welding helmet |  |  |  |  | 146.00 € | https://www.promeca.com/cagoule-speedglas-100v-noir-751120
Clothes/gloves |  |  |  |  | 50.00 € | https://www.promeca.com/soudage-et-accessoires/equipements-du-soudeur/vetements-specifiques-du-soudeur
Metal rod |  |  |  |  |  | https://www.promeca.com/soudage-et-accessoires/consommables-de-soudage/metaux-d-apport-soudage-tig
Neutral gas : Argon, quality 2.2 |  | Source
Price for one bottle | 200.00 € | Bery Inox
Consumption (unity = bottles, for 1 year) | 18 | Bery Inox
Consumption for exhaust system (unity = bottles) | 0.39
Lenght of welding for exhaust system (m) | 5.5
Price (€/m) | 14.35 €
Metal rod : Ø 0,8 mm TIG inox |  | Source
Price (€/kg, HT) | 12.8 | Bery Inox
Consumption for exhaust system (m) | 11 | Bery Inox
Weight by welding rod (g/m) | 3.920707632
Price of consumption (€/m, HT) | 0.05 €
Metal rod : Ø 2 mm TIG aluminium |  | Source
Price (€/kg, HT) | 10.05 | https://www.promeca.com/soudage-et-accessoires/consommables-de-soudage/metaux-d-apport-soudage-tig/kg-de-metal-d-apport-aluminium-o-2-0-x-1000-mm
Consumption (m of metal rod / m of welding) | 2 | Bery Inox
Weight by welding rod (g/m) | 8.482300165
Price of consumption (€/m, HT) | 0.09 €
Welding (set up, Tack welding, welding and verification) |  | Source
Time (min/m) | 140.4308321 | Bery Inox
Cost of operator (€/min) | 0.39 €
Cost of operator (€/m) | 55.46 €

Sheet: Conventionnal machinning
Description | Price Exc VAT | Source
Convetionnal mill and basic tooling | 15000.00 € | https://www.machineseeker.fr/mss/schaublin+13
Conventionnal Lathe and basic tooling | 10000.00 € | https://www.surplex.com/fr/vente/c/tours-paralleles-4340.html

Sheet: Material
http://www.blockenstock.fr/epaisseur-32mm-et-plus-c102x2963106 |  |  |  |  |  |  |  |  |  |  |  |  |  |  |  |  | https://lemetal.fr/148-tole-plane-aluminium
Alu 7075 T6 |  |  |  |  |  | Alu 7075 |  |  |  |  | 2017A |  |  |  |  |  | 5754
Epaisseur (mm) | largeur (mm) | longueur (mm) | Prix | Prix volumique (€/mm^3) |  | Diamètre (mm) | Longueur | Prix | Prix volumique (€/mm^3) |  | Epaisseur (mm) | largeur (mm) | longueur (mm) | Prix | Prix volumique (€/mm^3) |  | Epaisseur (mm) | largeur (mm) | Hauteur (mm) | Prix | Prix volumique (€/mm^3)
10 | 100 | 500 | 19.79 € | 3.958e-05 |  | 10 | 500 | 5.14 € | 3.27222563e-05 |  | 40 | 40 | 80 | 5.20 € | 4.0625e-05 |  | 6 | 1000 | 1000 | 285.88 € | 4.764666667e-05
10 | 150 | 500 | 31.49 € | 4.198666667e-05 |  | 20 | 990 | 17.13 € | 1.376931402e-05 |  | 40 | 40 | 160 | 9.18 € | 3.5859375e-05 |  | 8 | 1000 | 1000 | 379.84 € | 4.748e-05
10 | 300 | 500 | 57.83 € | 3.855333333e-05 |  | 25 | 990 | 26.99 € | 1.388474154e-05 |  | 40 | 40 | 500 | 25.09 € | 3.13625e-05 |  | 10 | 1000 | 1000 | 473.80 € | 4.738e-05
10 | 500 | 500 | 96.39 € | 3.8556e-05 |  | 30 | 990 | 34.28 € | 1.224653524e-05 |  | 50 | 50 | 500 | 41.62 € | 3.3296e-05 |  |  |  |  | Moyenne | 4.750222222e-05
32 | 32 | 550 | 23.26 € | 4.129971591e-05 |  | 40 | 160 | 10.92 € | 1.357790608e-05 |  | 50 | 50 | 100 | 9.18 € | 3.672e-05
32 | 50 | 360 | 20.56 € | 3.569444444e-05 |  | 40 | 500 | 25.70 € | 1.022570509e-05 |  | 60 | 60 | 500 | 57.83 € | 3.212777778e-05
32 | 50 | 550 | 31.82 € | 3.615909091e-05 |  | 40 | 800 | 43.70 € | 1.086729846e-05 |  | 60 | 60 | 995 | 119.95 € | 3.348687884e-05
32 | 60 | 265 | 15.91 € | 3.126965409e-05 |  | 50 | 150 | 14.69 € | 1.246925927e-05 |  |  |  |  | Moyenne | 3.478250452e-05
40 | 120 | 120 | 21.85 € | 3.793402778e-05 |  |  |  | Moyenne | 1.4970377e-05
50 | 100 | 100 | 17.99 € | 3.598e-05
50 | 100 | 300 | 53.98 € | 3.598666667e-05
50 | 100 | 500 | 83.54 € | 3.3416e-05 |  |  |  |  |  |  | 2017A | Rond plein |  |  |  |  | 2017A | Rond plein | https://www.acier-detail-decoupe.fr/45-aluminium#/alliage-2017a
 |  |  | Moyenne | 3.720129998e-05 |  |  |  |  |  |  |  | diamètre (mm) | longueur (mm) | Prix | Prix volumique (€/mm^3) |  | diam ext (mm) | diamètre int (mm) | Prix (/m) TTC | Prix volumique (€/mm^3) TTC
 |  |  |  |  |  |  |  |  |  |  |  | 5 | 500 | 1.61 € | 0.0001639932534 |  | 40 | 30 | 39.02 € | 7.097401005e-05
 |  |  |  |  |  |  |  |  |  |  |  | 10 | 500 | 4.50 € | 0.000114591559 |  | 50 | 30 | 72.24 € | 5.748676544e-05
Alu 7075 T651 | Rond plein |  |  |  |  |  |  |  |  |  |  | 15 | 500 | 4.80 € | 5.432488724e-05 |  | 50 | 40 | 37.70 € | 5.333458982e-05
 | diamètre (mm) | longueur (mm) | Prix | Prix volumique (€/mm^3) |  |  |  |  |  |  |  | 18 | 500 | 6.36 € | 4.998644139e-05 |  | 60 | 50 | 41.96 € | 4.856830118e-05
 | 10 | 500 | 5.14 € | 0.0001308890252 |  |  |  |  |  |  |  | 22 | 500 | 8.40 € | 4.419509164e-05 |  | 100 | 60 | 330.00 € | 6.565141403e-05
 | 20 | 500 | 8.35 € | 5.315775099e-05 |  |  |  |  |  |  |  |  |  | Moyenne | 8.541824653e-05 |  |  |  | Moyenne | 5.92030161e-05
 | 20 | 990 | 17.13 € | 5.507725606e-05 |  |  |  |  |  |  |  |  |  |  |  |  | 6060 | http://www.blockenstock.fr/tube-6060-t6-c102x2607947
 | 25 | 500 | 13.11 € | 5.341494538e-05 |  |  |  |  |  |  |  |  |  |  |  |  | 12 | 11 | 3.86 € | 0.0002136828106
 | 25 | 990 | 26.99 € | 5.553896616e-05 |  |  |  |  |  |  |  |  |  |  |  |  | 50 | 46 | 22.52 € | 7.467019413e-05
 | 30 | 500 | 16.06 € | 4.544050464e-05
 | 35 | 500 | 16.06 € | 3.338486055e-05
 |  |  | Moyenne | 6.0986187e-05
https://www.metalaladecoupe.com/francais/barres_rondes_5_50.asp?tbout=acier |  |  |  |  |  | https://rhmetal.fr/87-rond-acier-noir-s235 |  |  |  |  |  | https://www.acier-detail-decoupe.fr/27-rond#/alliage-25cd4
Acier S325JR | Rond plein |  |  |  |  | Acier S325JR | Rond plein |  |  |  |  | Acier 25CD4 | Rond plein
 | diamètre (mm) | longueur (mm) | Prix | Prix volumique (€/mm^3) |  |  | diamètre (mm) | longueur (mm) | Prix | Prix volumique (€/mm^3) |  |  | diamètre (mm) | longueur (mm) | Prix | Prix volumique (€/mm^3) (TTC)
 | 10 | 1000 | 20.50 € | 0.0002610141067 |  |  | 10 | 300 | 9.41 € | 0.0003993728039 |  |  | 16 | 1000 | 5.89 € | 2.929445671e-05
 | 16 | 1000 | 44.50 € | 0.0002213248427 |  |  | 16 | 300 | 15.77 € | 0.0002614451513 |  |  | 20 | 1000 | 9.23 € | 2.938000249e-05
 | 20 | 1000 | 66.75 € | 0.000212471849 |  |  | 20 | 300 | 23.40 € | 0.0002482817112 |  |  | 25 | 1000 | 14.44 € | 2.941692644e-05
 | 40 | 1000 | 251.50 € | 0.0002001373409 |  |  | 40 | 300 | 81.70 € | 0.0002167159808 |  |  | 40 | 1000 | 34.87 € | 2.774866433e-05
 | 50 | 1000 | 390.00 € | 0.000198625369 |  |  |  |  | Moyenne | 0.0002814539118 |  |  | 60 | 1000 | 83.14 € | 2.940475993e-05
 | 60 | 1000 | 560.00 € | 0.0001980594847 |  |  |  |  |  |  |  |  | 80 | 1000 | 139.55 € | 2.776259039e-05
 | 80 | 1000 | 992.50 € | 0.0001974516013 |  |  |  |  |  |  |  |  |  |  | Moyenne | 2.883456672e-05
 |  |  | Moyenne | 0.0002127263706
https://www.metalaladecoupe.com/francais/toles.asp?tbout=acier
Acier S235 | Plaque
Epaisseur (mm) | largeur (mm) | longueur (mm) | Prix | Prix volumique (€/mm^3)
1.5 | 1000 | 1000 | 34.50 € | 2.3e-05
Retours La Mache usinage |  |  |  |  |  | Retours La Mache laser toles
Type | Prix | Volume (mm^3) | Prix volumique (€/mm^3) HT |  |  | Type | Prix (/kg) | Densité (kg/mm^3) | Prix volumique (€/mm^3)
Brut 2017A | 86.40 € | 4530000 | 1.907284768e-05 |  |  | S235 | 1.10 € | 7.77e-06 | 8.547e-06
Rond plein 2017A | 60.00 € | 3769911.184 | 1.591549431e-05 |  |  | S355 | 2.50 € | 7.77e-06 | 1.9425e-05
Rond plein S355J2 | 28.32 € | 2886338.25 | 9.811739839e-06 |  |  | S700 | 2.50 € | 7.77e-06 | 1.9425e-05
Brut S235 | 35.40 € | 3600000 | 9.833333333e-06 |  |  | AU4G A4 | 18.00 € | 2.7e-06 | 4.86e-05
Brut S235 | 81.60 € | 8400000 | 9.714285714e-06
Brut Alu 7075T6 | 8.00 € | 90000 | 8.888888889e-05
Brut Alu 7075T6 | 50.00 € | 1995000 | 2.506265664e-05
Brut Alu 7075T6 | 46.20 € | 2080000 | 2.221153846e-05
Rond plein Alu 7075T6 | 28.00 € | 1367142.583 | 2.048067286e-05
Rond plein Alu 7075T6 | 35.70 € | 1499874.873 | 2.380198552e-05
Rond plein Alu 7075T6 | 13.00 € | 628318.5307 | 2.06901426e-05
 |  | Moyenne 2017A | 1.7494171e-05
 |  | Moyenne | 2.244939922e-05
Plastic Delrin
Epaisseur (mm) | largeur (mm) | longueur (mm) | Prix (€/m^2) | Prix | Prix volumique (€/mm^3) | Source
80 | 1000 | 2000 | 1284 | 2568.00 € | 1.605e-05 | https://plastique-en-ligne.com/Plaques/POM-C
50 | 1000 | 2000 | 990 | 1980.00 € | 1.98e-05
30 | 1000 | 2000 | 594 | 1188.00 € | 1.98e-05
40 | 1000 | 2000 | 792 | 1584.00 € | 1.98e-05
