EOSCogniton/STUF2019/CR - Cost Report/CBOM/Materials_cost.xlsx

Sheet: Fluid
Fluid | Price (TTC, by Unity) | Unity | Quantity (unity) | Price (HT) | Source
Fluid, chain oil | 0.20 € | by utilisation |  | 0.00 € | Maxxess (1 bottle = 40 utilisation)
Fluid, demineralized water | 0.33 € | L |  | 0.00 €
Fluid, limited slip differential oil 75W140 | 24.65 € | L |  | 0.00 € | Maxxess
Fluid, engine oil 10W40 | 16.56 € | L |  | 0.00 € | Maxxess
Fluide, gasoline 98RON | 1.65 € | L |  | 0.00 €
Glue, High temperature resistance | 7.75 € | for fuel tank | None | 7.75 € | RS components
Paint | 0.0009 € | cm² |  | 0.00 € | PSEP industrie
Threadlock, medium | 0.48 € | by utilisation |  | 0.00 € | RS components
Tripod grease | 139.09 € | kg |  | 0.00 € | Reverchon

Sheet: Hoses materials
Type | Size | Unity | Price (HT, by unity) | Quantity (unity) | Price (HT) | Source
Hose, FEP | Φ ext. 8 mm | m | 9.09 € |  | 0.00 € | Reverchon
Hose, rubber, flexible | Φ ext. 6 mm | m | 0.50 € |  | 0.00 € | Reverchon
Hose, rubber, reinforced | Φ int. 35 mm | m | 23.33 € |  | 0.00 € | Reverchon
Hose, Silicone | Φ ext. 6 mm | m | 9.00 € |  | 0.00 € | Reverchon
Hose, Silicone | Φ ext. 25 mm | m | 15.00 € |  | 0.00 € | Reverchon
Hose, Silicone, 45° | Φ ext. 25 mm | for 1 | 8.25 € |  | 0.00 € | Reverchon
Hose, Silicone, 135° | Φ ext. 25 mm | for 1 | 7.50 € |  | 0.00 € | Reverchon
Hose, Stainless | Φ ext. 12 mm | m | 12.00 € |  | 0.00 € | Reverchon
Hose, Stainless | Φ ext. 26 mm | m | 21.00 € |  | 0.00 € | Reverchon
Hose, Stainless Steel Braided Outer, L.P | Dash 6 | m | 30.30 € |  | 0.00 € | Reverchon

Sheet: Miscellaneous
Type | Unity | Price (HT, by unity) | Quantity (unity) | Price (€, HT)
Engine Sealant Paste | mL | 0.09 € |  | 0.00 €
Fiberglass Insulation | for fuel tank | 12.29 | None | 12.29 €
Sealing paper | m^2 | 70.63 € |  | 0.00 €
Seal, O-ring, Elastomer, 25mm | by O-ring | 0.56 € |  | 0.00 €
Seal, O-ring, Copper | by O-ring | 1.48 € |  | 0.00 €

Sheet: Raw materials
Material | Price (HT, €/mm^3) | Length (mm) | Width (mm) | Thickness (mm) | Price (€, HT)
Aluminium, 2017A | 1.7494171e-05 |  |  |  | 0.00 €
Aluminium, 7075 T6 | 2.244939922e-05 |  |  |  | 0.00 €
Plastic, Delrin | 1.65e-05 |  |  |  | 0.00 €
Steel, 25CD4 | 1.486213893e-05 |  |  |  | 0.00 €

Sheet: Sheet materials
Material | Thickness (mm) | Price (HT, €/m^2) | Surface (m^2) | Price (€, HT)
Aluminium, 2017A | 1.5 | 72.90 € |  | 0.00 €
Aluminium, 2017A | 2 | 97.20 € |  | 0.00 €
Aluminium, 2017A | 2.5 | 121.50 € |  | 0.00 €
Steel, S235 | 1.5 | 12.8205 |  | 0.00 €
Steel, S355 | 3 | 58.275 |  | 0.00 €
Steel, S700 | 4 | 77.7 |  | 0.00 €

Sheet: Tubing
Type | Size | Price (HT, by m) | Quantity (m) | Price (€, HT)
Tubing, Aluminum, 2017A | Φ 6 * 5 mm | 1.85 € |  | 0.00 €
Tubing, Aluminum, 2017A | Φ 10 * 9 mm | 3.19 € |  | 0.00 €
Tubing, Aluminum, 2017A | Φ 12 * 11 mm | 3.86 € |  | 0.00 €
Tubing, Aluminum, 2017A | Φ 38 * 35 mm | 26.25 € |  | 0.00 €

Sheet: Plumbing
Type | Size | Reference price | Unity | Price (HT, by unity) | Quantity (unity) | Price (HT) | Reference
Stainless tube, straight | Φ34 x 1,5 | 6.50 € | m | 6.50 € | 0.15 | 0.97 € | Bery inox
Stainless tube, straight | Φ42,4 x 1,5 | 10.00 € | m | 10.00 € |  | 0.00 € | Bery inox
Stainless tube, straight | Φ53 x 1,5 | 13.00 € | m | 13.00 € |  | 0.00 € | Bery inox
Stainless tube, straight | Φ53 x 1,5 | 13.00 € | m | 13.00 € |  | 0.00 € | Bery inox
Stainless tube, round, 55mm radius | Φ34 x 1,5 | 6.80 € | ° (degrees) | 0.08 € |  | 0.00 € | Bery inox
Stainless tube, round, 55mm radius | Φ53 x 1,5 | 9.00 € | ° (degrees) | 0.10 € |  | 0.00 € | Bery inox
Stainless tube, round, 55mm radius | Φ48 x 1,3 | 16.00 € | ° (degrees) | 0.18 € |  | 0.00 € | Bery inox
Stainless tube, round, 48mm radius | Φ42,4 x 1,6 | 17.00 € | ° (degrees) | 0.19 € |  | 0.00 € | Bery inox
Stainless tube, round, 93mm radius | Φ42,4 x 1,6 | 9.00 € | ° (degrees) | 0.10 € |  | 0.00 € | Bery inox
Stainless tube, round, 75mm radius | Φ51 x 1,2 | 9.00 € | ° (degrees) | 0.10 € |  | 0.00 € | Bery inox

Sheet: Temporary
http://www.blockenstock.fr/epaisseur-32mm-et-plus-c102x2963106 |  |  |  |  |  |  |  |  |  |  |  |  |  |  |  |  | https://lemetal.fr/148-tole-plane-aluminium
Alu 7075 T6 |  |  |  |  |  | Alu 7075 |  |  |  |  | 2017A |  |  |  |  |  | 5754
Epaisseur (mm) | largeur (mm) | longueur (mm) | Prix | Prix volumique (€/mm^3) |  | Diamètre (mm) | Longueur | Prix | Prix volumique (€/mm^3) |  | Epaisseur (mm) | largeur (mm) | longueur (mm) | Prix | Prix volumique (€/mm^3) |  | Epaisseur (mm) | largeur (mm) | Hauteur (mm) | Prix | Prix volumique (€/mm^3)
10 | 100 | 500 | 19.79 € | 3.958e-05 |  | 10 | 500 | 5.14 € | 3.27222563e-05 |  | 40 | 40 | 80 | 5.20 € | 4.0625e-05 |  | 6 | 1000 | 1000 | 285.88 € | 4.764666667e-05
10 | 150 | 500 | 31.49 € | 4.198666667e-05 |  | 20 | 990 | 17.13 € | 1.376931402e-05 |  | 40 | 40 | 160 | 9.18 € | 3.5859375e-05 |  | 8 | 1000 | 1000 | 379.84 € | 4.748e-05
10 | 300 | 500 | 57.83 € | 3.855333333e-05 |  | 25 | 990 | 26.99 € | 1.388474154e-05 |  | 40 | 40 | 500 | 25.09 € | 3.13625e-05 |  | 10 | 1000 | 1000 | 473.80 € | 4.738e-05
10 | 500 | 500 | 96.39 € | 3.8556e-05 |  | 30 | 990 | 34.28 € | 1.224653524e-05 |  | 50 | 50 | 500 | 41.62 € | 3.3296e-05 |  |  |  |  | Moyenne | 4.750222222e-05
32 | 32 | 550 | 23.26 € | 4.129971591e-05 |  | 40 | 160 | 10.92 € | 1.357790608e-05 |  | 50 | 50 | 100 | 9.18 € | 3.672e-05
32 | 50 | 360 | 20.56 € | 3.569444444e-05 |  | 40 | 500 | 25.70 € | 1.022570509e-05 |  | 60 | 60 | 500 | 57.83 € | 3.212777778e-05
32 | 50 | 550 | 31.82 € | 3.615909091e-05 |  | 40 | 800 | 43.70 € | 1.086729846e-05 |  | 60 | 60 | 995 | 119.95 € | 3.348687884e-05
32 | 60 | 265 | 15.91 € | 3.126965409e-05 |  | 50 | 150 | 14.69 € | 1.246925927e-05 |  |  |  |  | Moyenne | 3.478250452e-05
40 | 120 | 120 | 21.85 € | 3.793402778e-05 |  |  |  | Moyenne | 1.4970377e-05
50 | 100 | 100 | 17.99 € | 3.598e-05
50 | 100 | 300 | 53.98 € | 3.598666667e-05
50 | 100 | 500 | 83.54 € | 3.3416e-05 |  |  |  |  |  |  | 2017A | Rond plein |  |  |  |  | 2017A | Rond plein | https://www.acier-detail-decoupe.fr/45-aluminium#/alliage-2017a
 |  |  | Moyenne | 3.720129998e-05 |  |  |  |  |  |  |  | diamètre (mm) | longueur (mm) | Prix | Prix volumique (€/mm^3) |  | diam ext (mm) | diamètre int (mm) | Prix (/m) TTC | Prix volumique (€/mm^3) TTC
 |  |  |  |  |  |  |  |  |  |  |  | 5 | 500 | 1.61 € | 0.0001639932534 |  | 40 | 30 | 39.02 € | 7.097401005e-05
 |  |  |  |  |  |  |  |  |  |  |  | 10 | 500 | 4.50 € | 0.000114591559 |  | 50 | 30 | 72.24 € | 5.748676544e-05
Alu 7075 T651 | Rond plein |  |  |  |  |  |  |  |  |  |  | 15 | 500 | 4.80 € | 5.432488724e-05 |  | 50 | 40 | 37.70 € | 5.333458982e-05
 | diamètre (mm) | longueur (mm) | Prix | Prix volumique (€/mm^3) |  |  |  |  |  |  |  | 18 | 500 | 6.36 € | 4.998644139e-05 |  | 60 | 50 | 41.96 € | 4.856830118e-05
 | 10 | 500 | 5.14 € | 0.0001308890252 |  |  |  |  |  |  |  | 22 | 500 | 8.40 € | 4.419509164e-05 |  | 100 | 60 | 330.00 € | 6.565141403e-05
 | 20 | 500 | 8.35 € | 5.315775099e-05 |  |  |  |  |  |  |  |  |  | Moyenne | 8.541824653e-05 |  |  |  | Moyenne | 5.92030161e-05
 | 20 | 990 | 17.13 € | 5.507725606e-05 |  |  |  |  |  |  |  |  |  |  |  |  | 6060 | http://www.blockenstock.fr/tube-6060-t6-c102x2607947
 | 25 | 500 | 13.11 € | 5.341494538e-05 |  |  |  |  |  |  |  |  |  |  |  |  | 12 | 11 | 3.86 € | 0.0002136828106
 | 25 | 990 | 26.99 € | 5.553896616e-05 |  |  |  |  |  |  |  |  |  |  |  |  | 50 | 46 | 22.52 € | 7.467019413e-05
 | 30 | 500 | 16.06 € | 4.544050464e-05
 | 35 | 500 | 16.06 € | 3.338486055e-05
 |  |  | Moyenne | 6.0986187e-05
https://www.metalaladecoupe.com/francais/barres_rondes_5_50.asp?tbout=acier |  |  |  |  |  | https://rhmetal.fr/87-rond-acier-noir-s235 |  |  |  |  |  | https://www.acier-detail-decoupe.fr/27-rond#/alliage-25cd4
Acier S325JR | Rond plein |  |  |  |  | Acier S325JR | Rond plein |  |  |  |  | Acier 25CD4 | Rond plein
 | diamètre (mm) | longueur (mm) | Prix | Prix volumique (€/mm^3) |  |  | diamètre (mm) | longueur (mm) | Prix | Prix volumique (€/mm^3) |  |  | diamètre (mm) | longueur (mm) | Prix | Prix volumique (€/mm^3) (TTC)
 | 10 | 1000 | 20.50 € | 0.0002610141067 |  |  | 10 | 300 | 9.41 € | 0.0003993728039 |  |  | 16 | 1000 | 5.89 € | 2.929445671e-05
 | 16 | 1000 | 44.50 € | 0.0002213248427 |  |  | 16 | 300 | 15.77 € | 0.0002614451513 |  |  | 20 | 1000 | 9.23 € | 2.938000249e-05
 | 20 | 1000 | 66.75 € | 0.000212471849 |  |  | 20 | 300 | 23.40 € | 0.0002482817112 |  |  | 25 | 1000 | 14.44 € | 2.941692644e-05
 | 40 | 1000 | 251.50 € | 0.0002001373409 |  |  | 40 | 300 | 81.70 € | 0.0002167159808 |  |  | 40 | 1000 | 34.87 € | 2.774866433e-05
 | 50 | 1000 | 390.00 € | 0.000198625369 |  |  |  |  | Moyenne | 0.0002814539118 |  |  | 60 | 1000 | 83.14 € | 2.940475993e-05
 | 60 | 1000 | 560.00 € | 0.0001980594847 |  |  |  |  |  |  |  |  | 80 | 1000 | 139.55 € | 2.776259039e-05
 | 80 | 1000 | 992.50 € | 0.0001974516013 |  |  |  |  |  |  |  |  |  |  | Moyenne | 2.883456672e-05
 |  |  | Moyenne | 0.0002127263706
https://www.metalaladecoupe.com/francais/toles.asp?tbout=acier
Acier S235 | Plaque
Epaisseur (mm) | largeur (mm) | longueur (mm) | Prix | Prix volumique (€/mm^3)
1.5 | 1000 | 1000 | 34.50 € | 2.3e-05
Retours La Mache usinage |  |  |  |  |  | Retours La Mache laser toles
Type | Prix | Volume (mm^3) | Prix volumique (€/mm^3) HT |  |  | Type | Prix (/kg) | Densité (kg/mm^3) | Prix volumique (€/mm^3)
Brut 2017A | 86.40 € | 4530000 | 1.907284768e-05 |  |  | S235 | 1.10 € | 7.77e-06 | 8.547e-06
Rond plein 2017A | 60.00 € | 3769911.184 | 1.591549431e-05 |  |  | S355 | 2.50 € | 7.77e-06 | 1.9425e-05
Rond plein S355J2 | 28.32 € | 2886338.25 | 9.811739839e-06 |  |  | S700 | 2.50 € | 7.77e-06 | 1.9425e-05
Brut S235 | 35.40 € | 3600000 | 9.833333333e-06 |  |  | AU4G A4 | 18.00 € | 2.7e-06 | 4.86e-05
Brut S235 | 81.60 € | 8400000 | 9.714285714e-06
Brut Alu 7075T6 | 8.00 € | 90000 | 8.888888889e-05
Brut Alu 7075T6 | 50.00 € | 1995000 | 2.506265664e-05
Brut Alu 7075T6 | 46.20 € | 2080000 | 2.221153846e-05
Rond plein Alu 7075T6 | 28.00 € | 1367142.583 | 2.048067286e-05
Rond plein Alu 7075T6 | 35.70 € | 1499874.873 | 2.380198552e-05
Rond plein Alu 7075T6 | 13.00 € | 628318.5307 | 2.06901426e-05
 |  | Moyenne 2017A | 1.7494171e-05
 |  | Moyenne | 2.244939922e-05
Plastic Delrin
Epaisseur (mm) | largeur (mm) | longueur (mm) | Prix (€/m^2) | Prix | Prix volumique (€/mm^3) | Source
80 | 1000 | 2000 | 1284 | 2568.00 € | 1.605e-05 | https://plastique-en-ligne.com/Plaques/POM-C
50 | 1000 | 2000 | 990 | 1980.00 € | 1.98e-05
30 | 1000 | 2000 | 594 | 1188.00 € | 1.98e-05
40 | 1000 | 2000 | 792 | 1584.00 € | 1.98e-05
