EOSCogniton/STUF2019/CR - Cost Report/CBOM/Fastener_cost.xlsx

Sheet: Bolts
Type | Grade | Size | Lenght | Price (TTC, for 100) | Number (to calculate) | Price (HT)
Socket Head Cap Screw | 12.9 | M6 | 16 | 4.31 € |  | 0.00 €
Socket Head Cap Screw | 12.9 | M6 | 20 | 4.46 € |  | 0.00 €
Socket Head Cap Screw | 12.9 | M6 | 25 | 4.60 € |  | 0.00 €
Socket Head Cap Screw | 12.9 | M6 | 30 | 5.16 € |  | 0.00 €
Socket Head Cap Screw | 12.9 | M6 | 35 | 5.41 € |  | 0.00 €
Socket Head Cap Screw | 12.9 | M6 | 40 | 5.79 € |  | 0.00 €
Socket Head Cap Screw | 12.9 | M6 | 45 | 6.58 € |  | 0.00 €
Socket Head Cap Screw | 12.9 | M6 | 50 | 7.35 € |  | 0.00 €
Socket Head Cap Screw | 12.9 | M6 | 55 | 7.76 € |  | 0.00 €
Hexagonal Head | 12.9 | M6 | 80 | 6.54 € |  | 0.00 €
Socket Head Cap Screw | 12.9 | M8 | 10 | 10.54 € |  | 0.00 €
Socket Head Cap Screw | 12.9 | M8 | 40 | 11.17 € |  | 0.00 €
Socket Head Cap Screw | 12.9 | M8 | 45 | 11.79 € |  | 0.00 €
Socket Head Cap Screw | 8.8 | M12 | 200 | 80.00 € |  | 0.00 €
Socket Head Cap Screw | 8.8 | M12 | 180 | 70.00 € |  | 0.00 €
Socket Head Cap Screw | 8.8 | M10 | 30 | 10.65 € |  | 0.00 €
Socket Head Cap Screw | 8.8 | M10 | 35 | 12.50 € |  | 0.00 €
Socket Head Cap Screw | 8.8 | M6 | 25 | 3.71 € |  | 0.00 €
Hexagonal Head | 8.8 | M4 | 20 | 2.06 € |  | 0.00 €
Hexagonal Head | 8.8 | M5 | 20 | 2.41 € |  | 0.00 €
Hexagonal Head | 8.8 | M8 | 30 | 6.21 € |  | 0.00 €
Socket Head Cap Screw | 8.8 | M6 | 20 | 2.65 € |  | 0.00 €
Socket Head Cap Screw | 8.8 | M6 | 25 | 3.00 € |  | 0.00 €
Socket Head Cap Screw | 8.8 | M6 | 30 | 3.20 € |  | 0.00 €
Socket Head Cap Screw | 8.8 | M6 | 40 | 4.66 € |  | 0.00 €
Socket Head Cap Screw | 8.8 | M6 | 50 | 5.07 € |  | 0.00 €
Hexagonal Head | 8.8 | M6 | 20 | 2.25 € |  | 0.00 €
Hexagonal Head | 8.8 | M6 | 30 | 2.45 € |  | 0.00 €
Hexagonal Head | 8.8 | M6 | 40 | 2.82 € |  | 0.00 €
Hexagonal Head | 8.8 | M6 | 50 | 3.01 € |  | 0.00 €
Hexagonal Head | 8.8 | M6 | 60 | 3.21 € |  | 0.00 €
Hexagonal Head | 8.8 | M8 | 20 | 3.50 € |  | 0.00 €
Hexagonal Head | 8.8 | M8 | 30 | 5.08 € |  | 0.00 €
Hexagonal Head | 8.8 | M8 | 40 | 5.40 € |  | 0.00 €
Hexagonal Head | 8.8 | M8 | 50 | 5.55 € |  | 0.00 €
Hexagonal Head | 8.8 | M8 | 60 | 6.10 € |  | 0.00 €
Socket Head Cap Screw | 8.8 | M8 | 20 | 5.07 € |  | 0.00 €
Socket Head Cap Screw | 8.8 | M8 | 25 | 6.55 € |  | 0.00 €
Socket Head Cap Screw | 8.8 | M8 | 30 | 5.42 € |  | 0.00 €
Socket Head Cap Screw | 8.8 | M8 | 40 | 5.75 € |  | 0.00 €
Socket Head Cap Screw | 8.8 | M8 | 50 | 6.02 € |  | 0.00 €
Socket Head Cap Screw | 8.8 | M8 | 60 | 7.05 € |  | 0.00 €

Sheet: Nuts
Type | Grade | Size | Price (TTC, for 1 knut/ 100 nylstop) | Quantity | Price (HT) | Source
Self-locking nut, nylon | 8.8 | M3 | 3.67 € |  | 0.00 € | TDI
Self-locking nut, nylon | 8.8 | M4 | 3.42 € |  | 0.00 € | TDI
Self-locking nut, nylon | 8.8 | M6 | 2.69 € |  | 0.00 € | TDI
Self-locking nut, nylon | 8.8 | M8 | 3.70 € |  | 0.00 € | TDI
Self-locking nut, nylon | 8.8 | M10 | 6.68 € |  | 0.00 € | TDI
K-nuts, metallic self-locking nut | K-nuts | M6 | 0.54 € |  | 0.00 € | K-nut
K-nuts, metallic self-locking nut | K-nuts | M8 | 0.79 € |  | 0.00 € | K-nut
K-nuts, metallic self-locking nut | K-nuts | M10 | 1.33 € |  | 0.00 € | K-nut
K-nuts, metallic self-locking nut | K-nuts | M12 | 3.28 € |  | 0.00 € | K-nut
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
