EOSCogniton/STUF2019/CR - Cost Report/CBOM/Processes_cost.xlsx

Sheet: Assembly
Type | Description | Time | Unity | By who ? | Price (€/unity) | Quantity (by unity) | Price (€) | Manpower
Assemble by hand | Assembly of one y of exhaust system or muffler | 6 min |  | Operator |  |  | 2.45 € | Operator cost/hour | 24.47 €
Assemble by hand | Assembled together with bolts |  | nbr of bolts | Operator | 0.10 € |  | 0.00 € | Technician cost/hour | 35.41 €
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
