EOSCogniton/STUF2019/EN - Engine & Powertrain/EN_A0500 (Fuel tank assembly)/mise en plan/19M_EN_0500_001(main1)/19M_EN_0500_001 (main1).igs

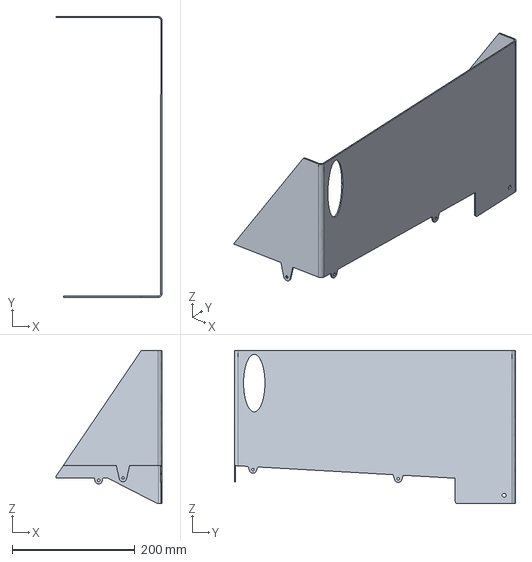
[picture p515: CAD file, 2019-03-13]
EN - Engine & Powertrain/EN_A0500 (Fuel tank assembly)/mise en plan/19M_EN_0500_001(main1)/19M_EN_0500_001 (main1).igs
173.0 x 458.6 x 250.5 mm
