EOSCogniton/STUF2019/EN - Engine & Powertrain/EN_A0500 (Fuel tank assembly)/mise en plan/19M_EN_0500_001(main2)/19M_EN_0500_001(main2).igs

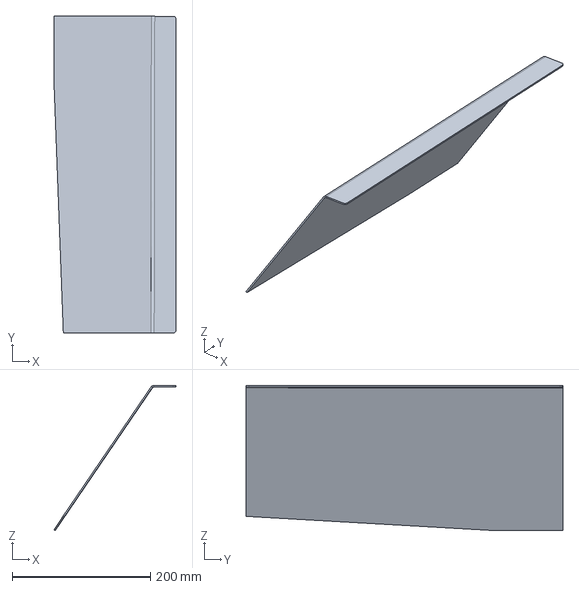
[picture p516: CAD file, 2019-03-13]
EN - Engine & Powertrain/EN_A0500 (Fuel tank assembly)/mise en plan/19M_EN_0500_001(main2)/19M_EN_0500_001(main2).igs
176.5 x 458.8 x 210.2 mm
