EOSCogniton/STUF2019/AA - Mise en plan/La Mache Laser/Aluminium/Aluminium 2017A (AU4G)/Aluminium 2mm 2017A/IGS aluminium 2mm 2017A/19M_EN_0500_001 (main2) 2.0.igs

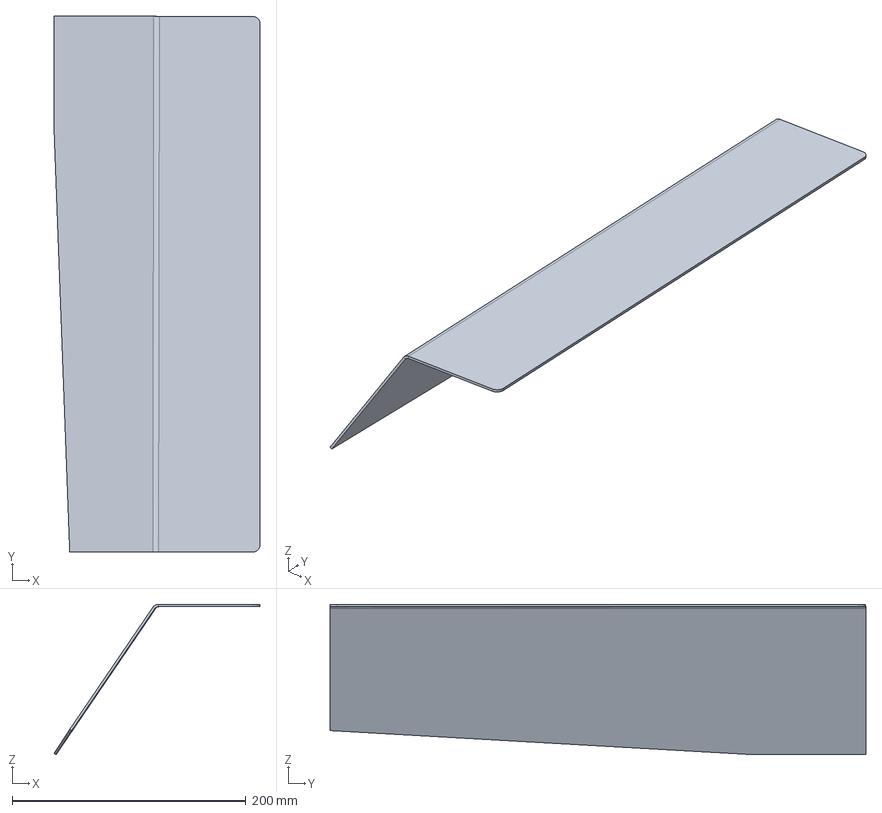
[picture p517: CAD file, 2019-03-19]
AA - Mise en plan/La Mache Laser/Aluminium/Aluminium 2017A (AU4G)/Aluminium 2mm 2017A/IGS aluminium 2mm 2017A/19M_EN_0500_001 (main2) 2.0.igs
176.3 x 458.7 x 128.7 mm
