EOSCogniton/STUF2019/FR - Frame & Body/FR_A0100 (Frame)/Production/Cintrage hoops/Main_hoop.stp

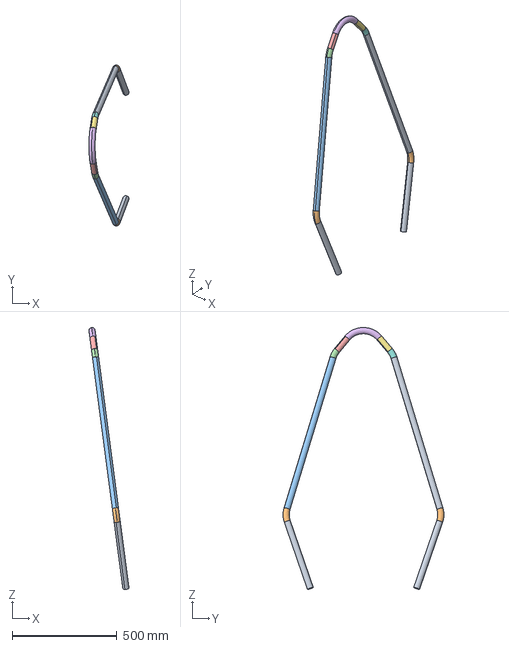
[picture p518: CAD file, 2018-12-05]
FR - Frame & Body/FR_A0100 (Frame)/Production/Cintrage hoops/Main_hoop.stp
192.0 x 770.0 x 1253.4 mm
