EOSCogniton/STUF2019/PRELIMINARY MODEL/Modèle pour impression 3D/Vulcanix 3D v2 total.stl

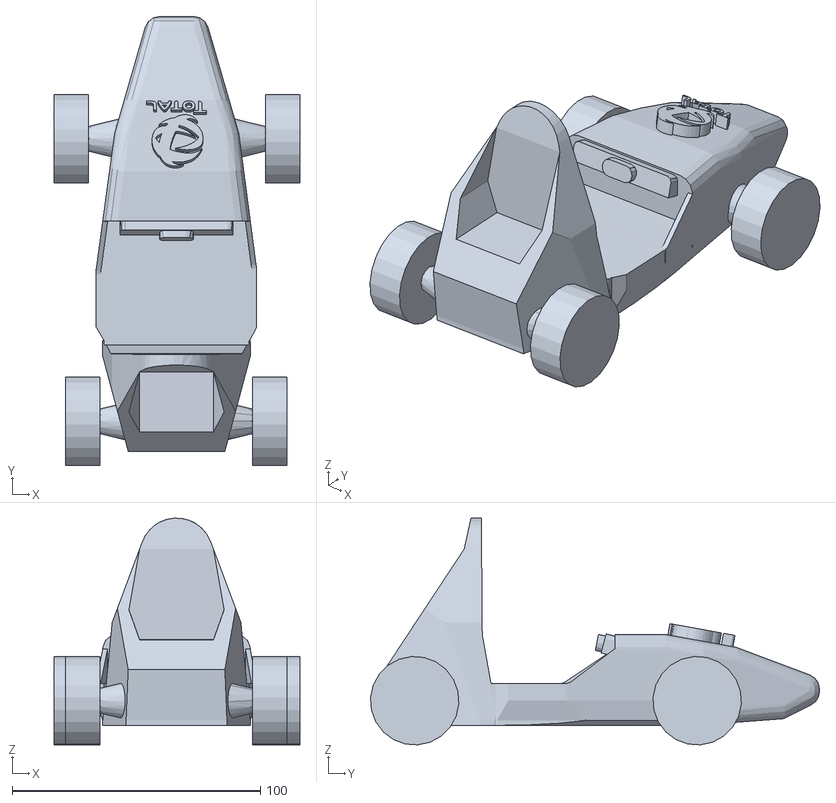
[picture p519: CAD file, 2019-02-13]
PRELIMINARY MODEL/Modèle pour impression 3D/Vulcanix 3D v2 total.stl
99.0 x 180.7 x 91.3
