EOSCogniton/STUF2019/PRELIMINARY MODEL/Modèle pour impression 3D/Total.dxf

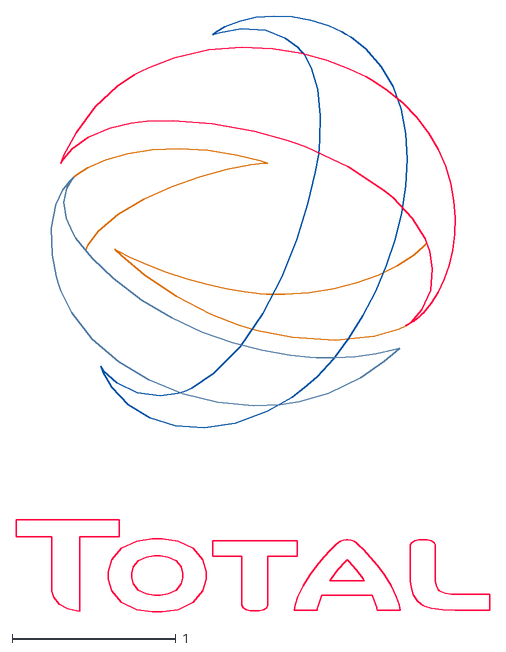
[picture p520: CAD file, 2019-02-13]
PRELIMINARY MODEL/Modèle pour impression 3D/Total.dxf
2.89 x 3.64
