EOSCogniton/STUF2019/AA - Mise en plan/Boisard/Plans essais Boisard/MEP essais collage rotules/PieceBlocMaintienVisRotule.igs

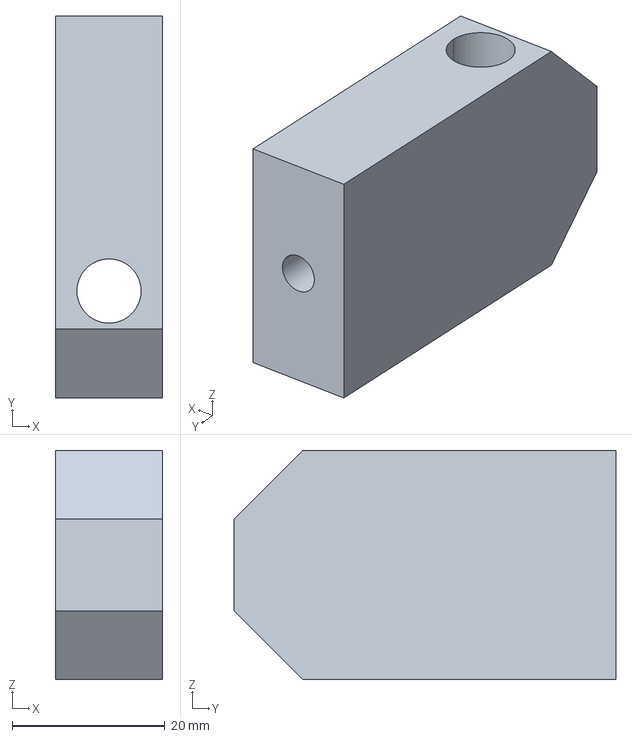
[picture p521: CAD file, 2018-11-07]
AA - Mise en plan/Boisard/Plans essais Boisard/MEP essais collage rotules/PieceBlocMaintienVisRotule.igs
14.0 x 50.0 x 30.0 mm
