EOSCogniton/STUF2019/AA - Mise en plan/Boisard/Plans essais Boisard/MEP essais collage rotules/PieceBlocMaintienPlaque.igs

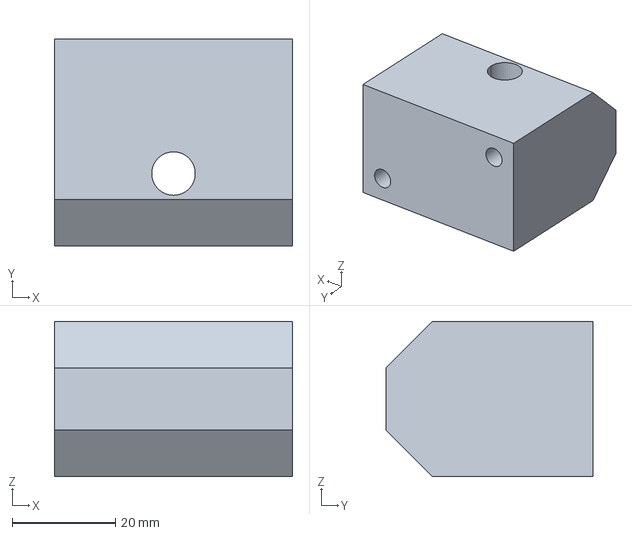
[picture p522: CAD file, 2018-11-07]
AA - Mise en plan/Boisard/Plans essais Boisard/MEP essais collage rotules/PieceBlocMaintienPlaque.igs
46.0 x 40.0 x 30.0 mm
