EOSCogniton/STUF2019/AA - Mise en plan/AA - PLANS A VERIFIER/La Mache Laser/Aluminium/2mm/EN_0300_002 (Fond plat admission)/EN_0300_002_AA_Fond_plat.igs

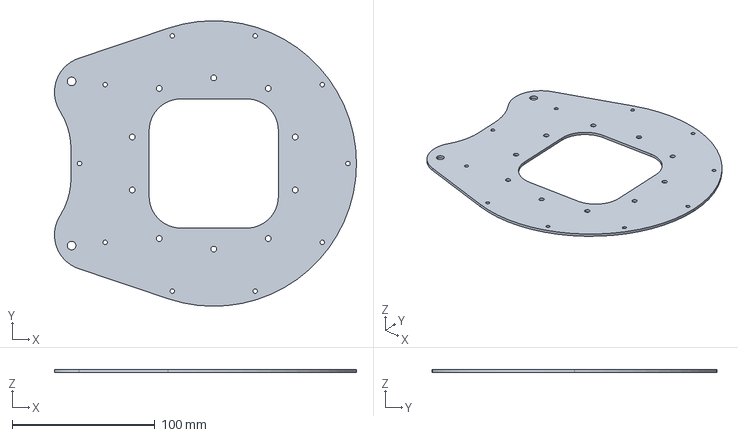
[picture p523: CAD file, 2018-12-19]
AA - Mise en plan/AA - PLANS A VERIFIER/La Mache Laser/Aluminium/2mm/EN_0300_002 (Fond plat admission)/EN_0300_002_AA_Fond_plat.igs
211.6 x 200.0 x 2.00 mm
