EOSCogniton/STUF2019/AA - Mise en plan/AA - PLANS VERIFIES/La Mache Laser/Acier/3mm S355/19M_FR_0300_006_BA (Support lateral pedale de frein)/19M_FR_0300_006_BA (Support lateral pedale de frein).igs

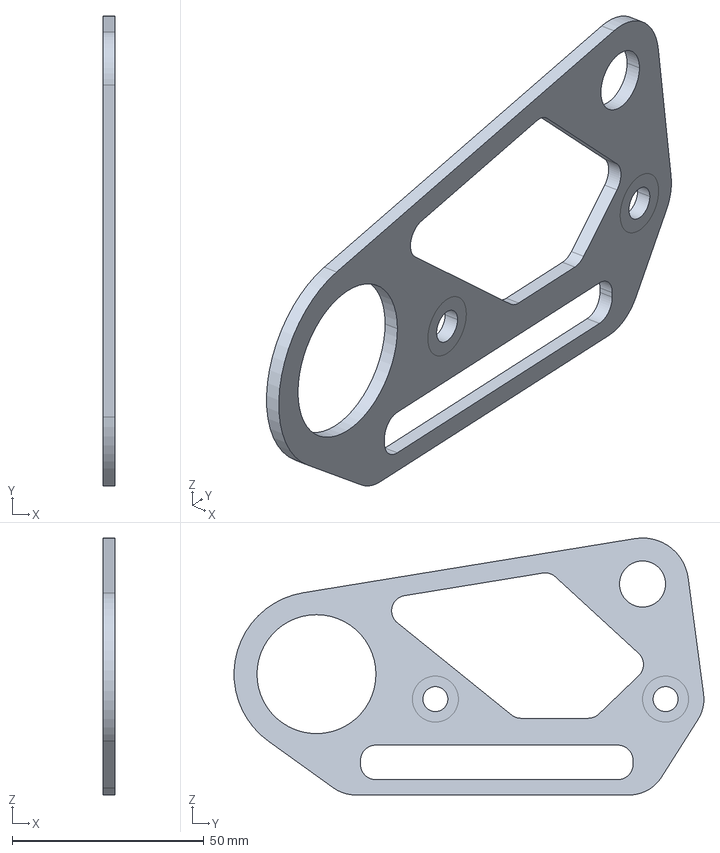
[picture p524: CAD file, 2018-12-09]
AA - Mise en plan/AA - PLANS VERIFIES/La Mache Laser/Acier/3mm S355/19M_FR_0300_006_BA (Support lateral pedale de frein)/19M_FR_0300_006_BA (Support lateral pedale de frein).igs
3.00 x 122.5 x 67.0 mm
