EOSCogniton/STUF2019/AA - Mise en plan/AlpenTech/STEP/Insert biellette.stp

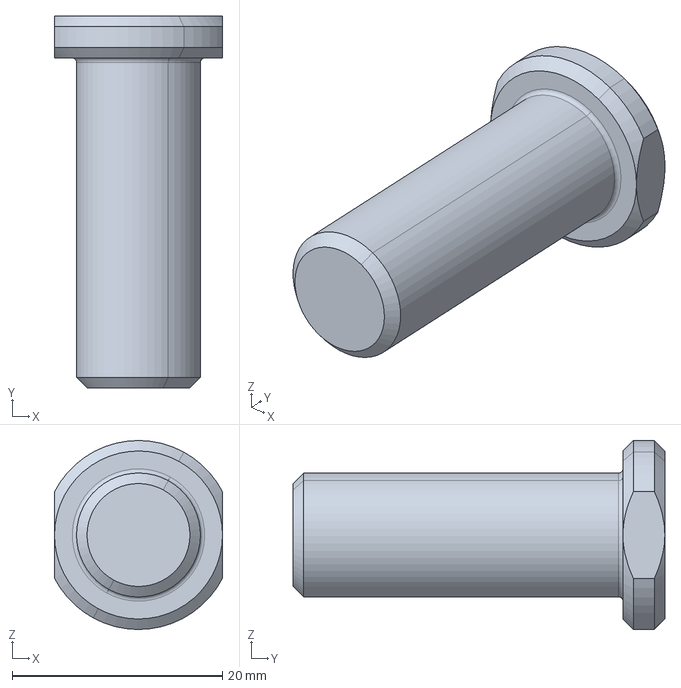
[picture p525: CAD file, 2019-01-15]
AA - Mise en plan/AlpenTech/STEP/Insert biellette.stp
16.0 x 35.4 x 18.0 mm
