EOSCogniton/STUF2019/AA - Mise en plan/Aquacut/19M_EN_0101_003 (Joint)/19M_EN_0101_003 (Joint).igs

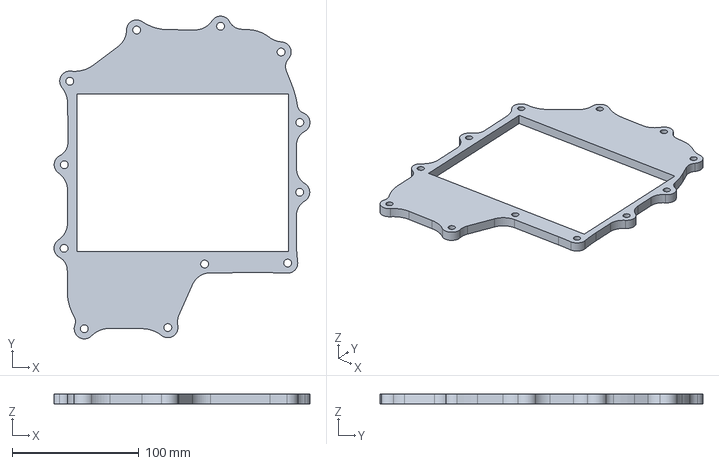
[picture p526: CAD file, 2019-01-21]
AA - Mise en plan/Aquacut/19M_EN_0101_003 (Joint)/19M_EN_0101_003 (Joint).igs
202.3 x 255.1 x 8.00 mm
