EOSCogniton/STUF2019/AA - Mise en plan/ARRK/EN_0300_001_AA_Plenum.stp

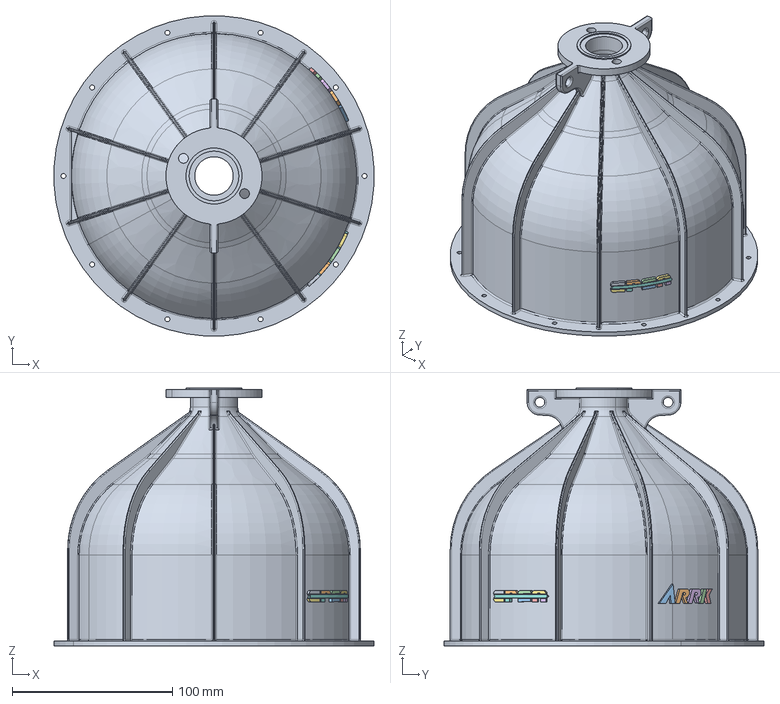
[picture p527: CAD file, 2019-01-08]
AA - Mise en plan/ARRK/EN_0300_001_AA_Plenum.stp
199.7 x 199.7 x 160.8 mm
