EOSCogniton/STUF2019/AA - Mise en plan/Boisard/Boisard_Fait/Acier S235JR/19B_EN_0200_001 (Exhaust tip)/19B_EN_0200_001 (Exhaust tip).igs

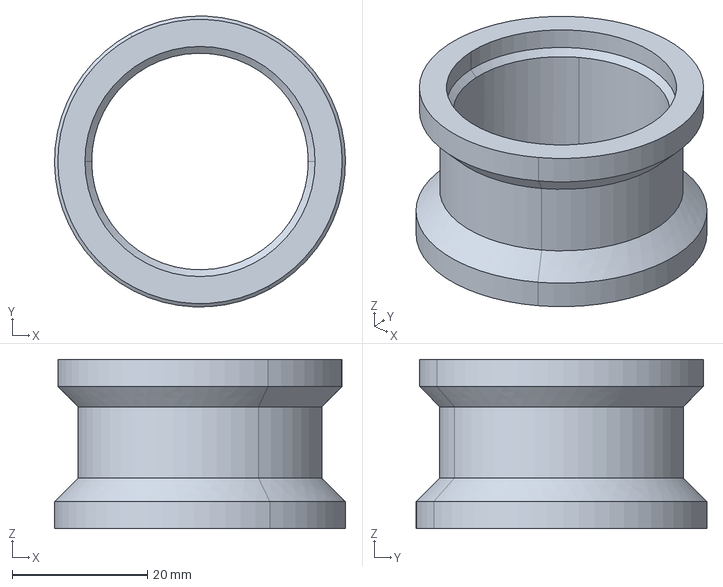
[picture p528: CAD file, 2019-01-24]
AA - Mise en plan/Boisard/Boisard_Fait/Acier S235JR/19B_EN_0200_001 (Exhaust tip)/19B_EN_0200_001 (Exhaust tip).igs
43.0 x 43.0 x 25.0 mm
