EOSCogniton/STUF2019/AA - Mise en plan/Boisard/Boisard_Fait/Acier S355JR/19B_SU_0700_003 (Chape arrière Ohlins)/19B_SU_0700_003 (Chape arrière Ohlins).igs

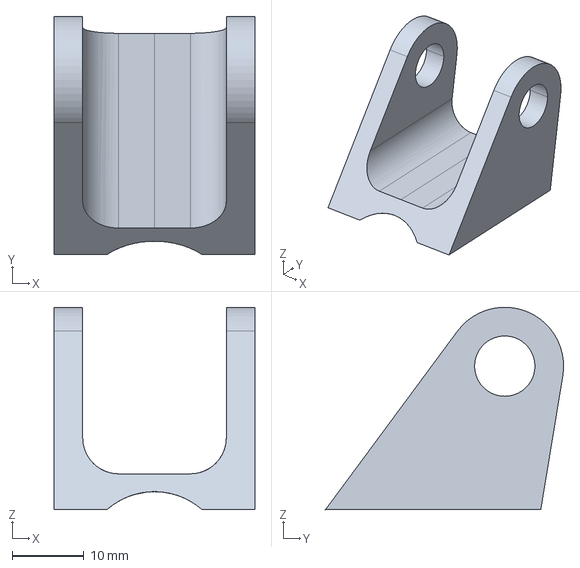
[picture p529: CAD file, 2018-12-24]
AA - Mise en plan/Boisard/Boisard_Fait/Acier S355JR/19B_SU_0700_003 (Chape arrière Ohlins)/19B_SU_0700_003 (Chape arrière Ohlins).igs
28.0 x 33.2 x 28.2 mm
