EOSCogniton/STUF2019/AA - Mise en plan/Boisard/Boisard_Fait/Acier S355JR/19B_SU_0800_004 (Chape pivot basculeur arrière)/19B_SU_0800_004 (Chape pivot basculeur arrière).igs

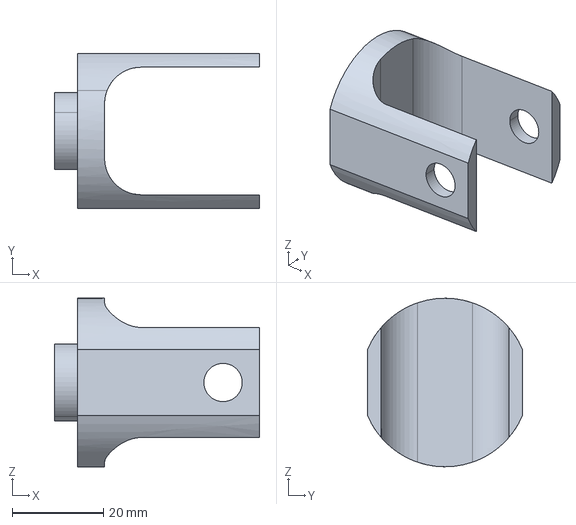
[picture p530: CAD file, 2018-12-11]
AA - Mise en plan/Boisard/Boisard_Fait/Acier S355JR/19B_SU_0800_004 (Chape pivot basculeur arrière)/19B_SU_0800_004 (Chape pivot basculeur arrière).igs
45.0 x 34.0 x 37.0 mm
