EOSCogniton/STUF2019/AA - Mise en plan/Boisard/Boisard_Fait/Aluminium 2017 T4/19B_SU_10005 (Front Upper Arm Wedge Base)/19B_SU_10005 (Front Upper Arm Wedge base).igs

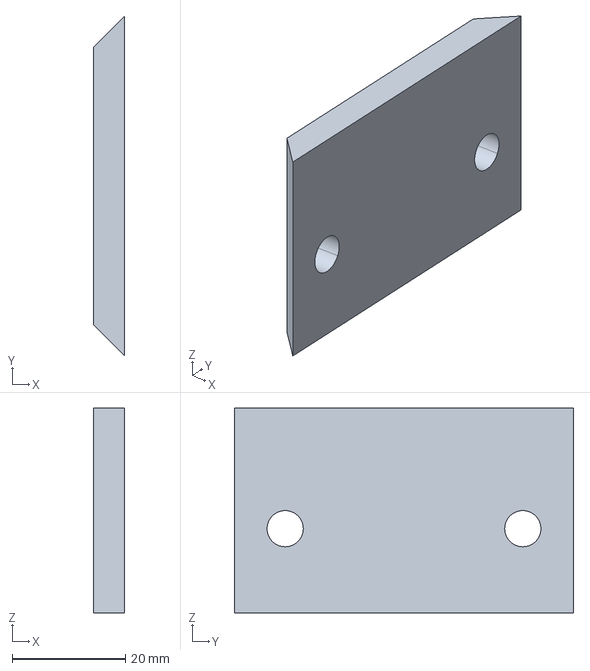
[picture p531: CAD file, 2018-12-11]
AA - Mise en plan/Boisard/Boisard_Fait/Aluminium 2017 T4/19B_SU_10005 (Front Upper Arm Wedge Base)/19B_SU_10005 (Front Upper Arm Wedge base).igs
5.50 x 60.0 x 36.2 mm
