EOSCogniton/STUF2019/AA - Mise en plan/Boisard/Boisard_Fait/Aluminium 7075 T6/19B_EN_0901_004 (Porte exc L)/19B_EN_0901_004 (Porte exc L).igs

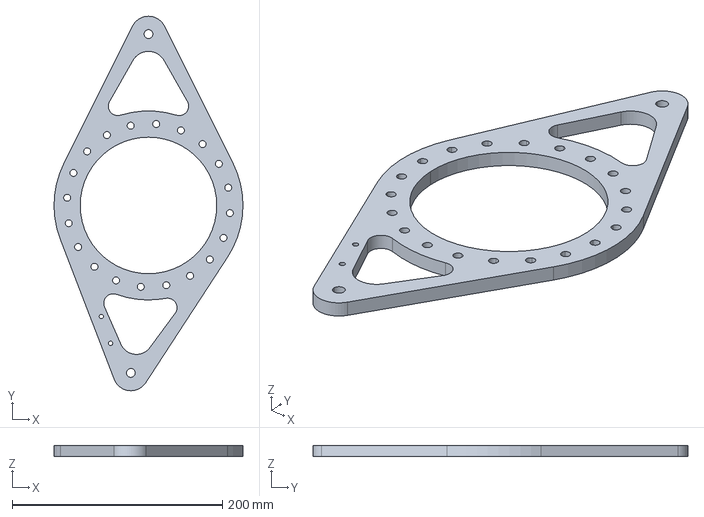
[picture p532: CAD file, 2018-12-21]
AA - Mise en plan/Boisard/Boisard_Fait/Aluminium 7075 T6/19B_EN_0901_004 (Porte exc L)/19B_EN_0901_004 (Porte exc L).igs
180.0 x 356.7 x 10.0 mm
