EOSCogniton/STUF2019/AA - Mise en plan/Boisard/Boisard_Fait/Aluminium 7075 T6/19B_EN_0901_005 (Porte exc R)/19B_EN_0901_005 (Porte exc R).igs

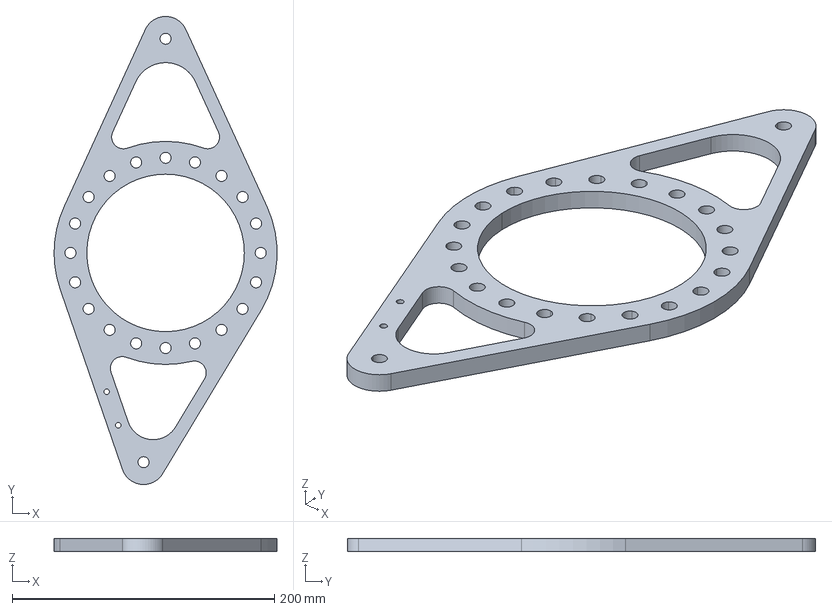
[picture p533: CAD file, 2018-12-21]
AA - Mise en plan/Boisard/Boisard_Fait/Aluminium 7075 T6/19B_EN_0901_005 (Porte exc R)/19B_EN_0901_005 (Porte exc R).igs
169.9 x 356.7 x 10.0 mm
