EOSCogniton/STUF2019/AA - Mise en plan/Boisard/Boisard_Fait/Aluminium 7075 T6/19B_SU_10002 (Upper Arm Bracket)/19B_SU_10002 (Upper Arm Bracket).igs

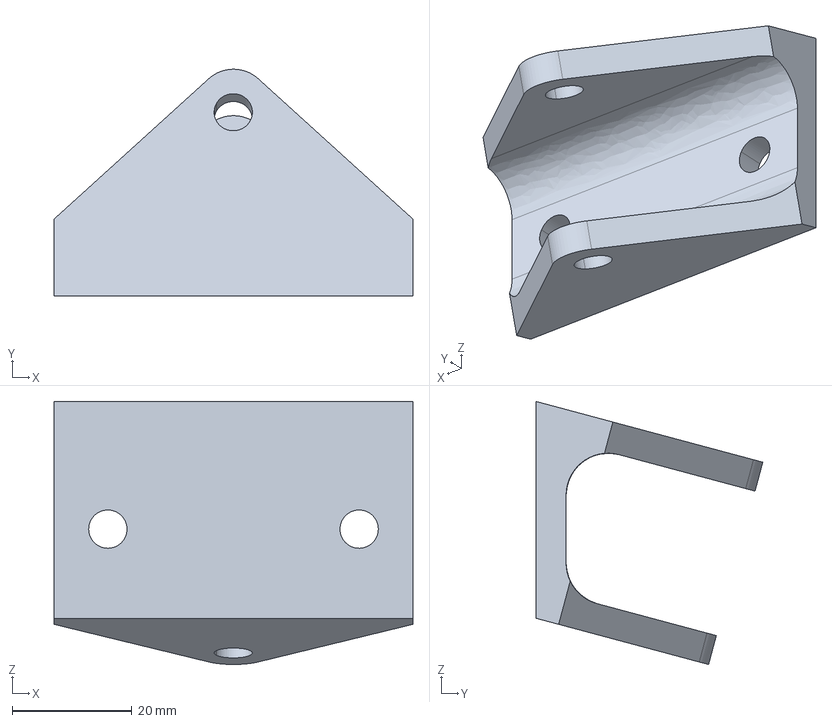
[picture p534: CAD file, 2018-12-11]
AA - Mise en plan/Boisard/Boisard_Fait/Aluminium 7075 T6/19B_SU_10002 (Upper Arm Bracket)/19B_SU_10002 (Upper Arm Bracket).igs
60.0 x 37.9 x 44.0 mm
