EOSCogniton/STUF2019/AA - Mise en plan/Boisard/Boisard_Reste _A_Faire/Aluminium 7075 T6/19B_SU_10001 (Front Left Upright)/19B_SU_10001 (Front Left Upright).igs

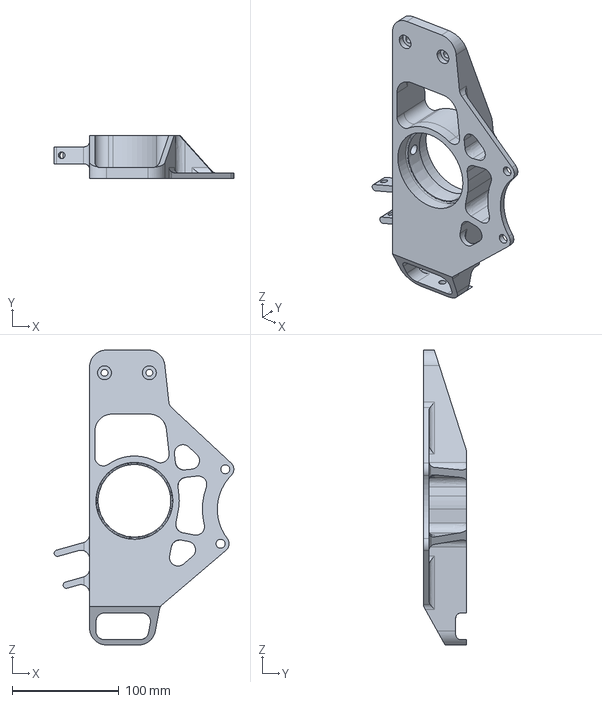
[picture p535: CAD file, 2018-12-16]
AA - Mise en plan/Boisard/Boisard_Reste _A_Faire/Aluminium 7075 T6/19B_SU_10001 (Front Left Upright)/19B_SU_10001 (Front Left Upright).igs
168.2 x 40.0 x 276.1 mm
