EOSCogniton/STUF2019/AA - Mise en plan/Boisard/Boisard_Reste _A_Faire/Aluminium 7075 T6/19B_SU_11001 (Rear Left Upright)/19B_SU_11001 (Rear Left Upright).igs

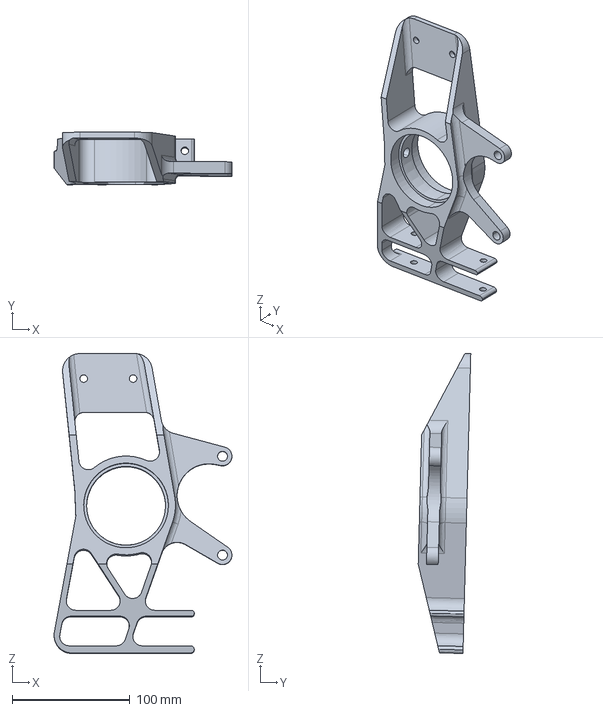
[picture p536: CAD file, 2019-01-08]
AA - Mise en plan/Boisard/Boisard_Reste _A_Faire/Aluminium 7075 T6/19B_SU_11001 (Rear Left Upright)/19B_SU_11001 (Rear Left Upright).igs
151.2 x 44.7 x 255.0 mm
