EOSCogniton/STUF2019/AA - Mise en plan/Boisard/Boisard_Reste _A_Faire/Aluminium 7075 T6/19B_WT_02001 (Front Hub)/19B_WT_02001 (Front Hub).igs

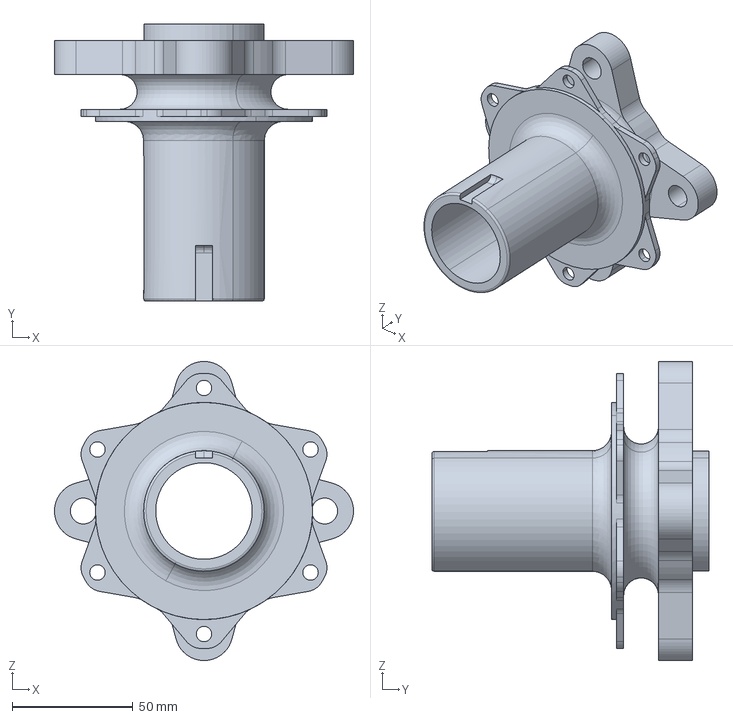
[picture p537: CAD file, 2019-01-29]
AA - Mise en plan/Boisard/Boisard_Reste _A_Faire/Aluminium 7075 T6/19B_WT_02001 (Front Hub)/19B_WT_02001 (Front Hub).igs
124.0 x 115.0 x 124.0 mm
