EOSCogniton/STUF2019/AA - Mise en plan/Boisard/Boisard_Reste _A_Faire/Aluminium 7075 T6/19B_WT_03001 (Rear Hub)/19B_WT_03001 (Rear Hub).igs

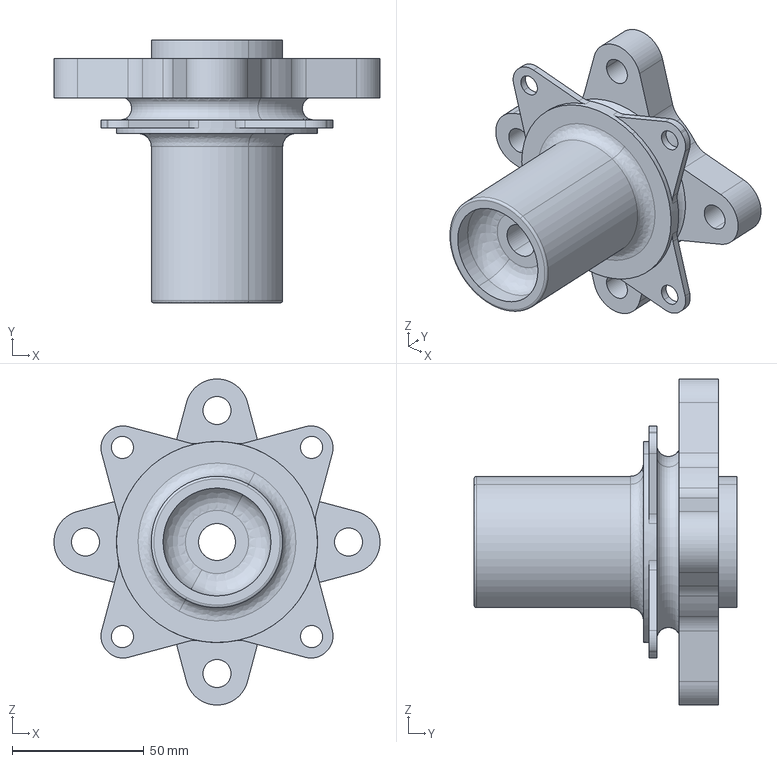
[picture p538: CAD file, 2019-01-08]
AA - Mise en plan/Boisard/Boisard_Reste _A_Faire/Aluminium 7075 T6/19B_WT_03001 (Rear Hub)/19B_WT_03001 (Rear Hub).igs
124.0 x 100.0 x 124.0 mm
