EOSCogniton/STUF2019/AA - Mise en plan/Boisard/Plans essais Boisard/MEP essai frette/ESSAI_FRETTE (Frette frein avant aluminium).igs

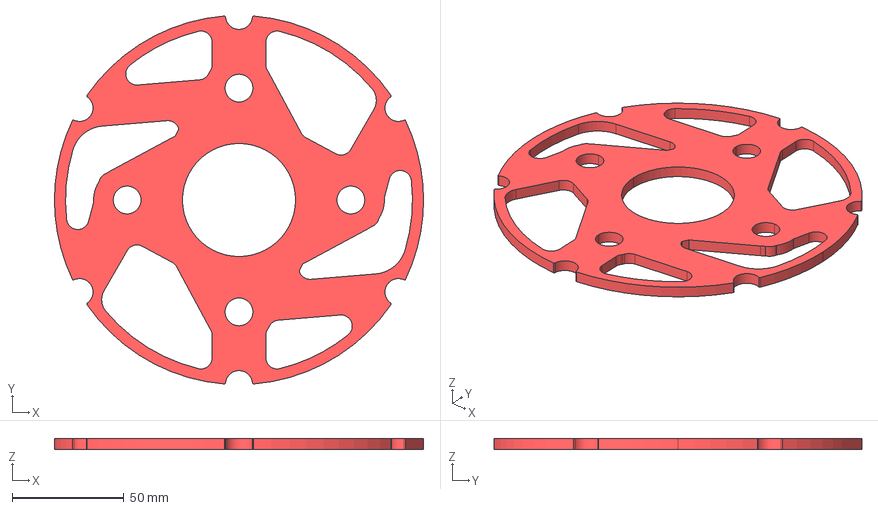
[picture p539: CAD file, 2018-11-07]
AA - Mise en plan/Boisard/Plans essais Boisard/MEP essai frette/ESSAI_FRETTE (Frette frein avant aluminium).igs
164.9 x 164.4 x 5.00 mm
