EOSCogniton/STUF2019/AA - Mise en plan/Boisard/Plans essais Boisard/MEP essais collage rotules/entretoise_presse_bague_ext_M6.igs

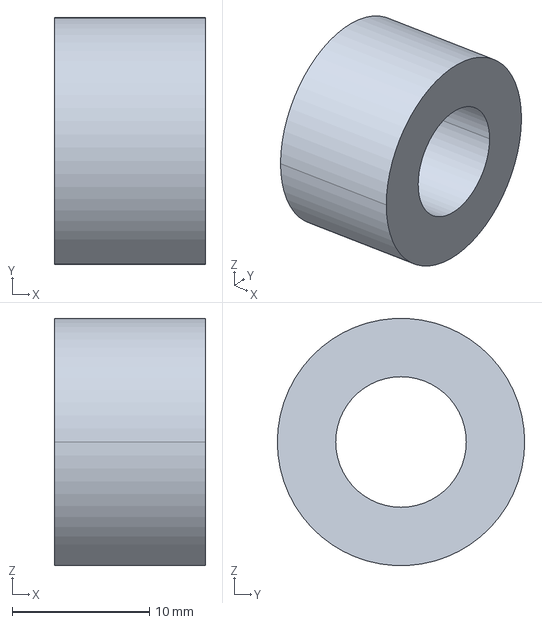
[picture p540: CAD file, 2018-11-07]
AA - Mise en plan/Boisard/Plans essais Boisard/MEP essais collage rotules/entretoise_presse_bague_ext_M6.igs
11.0 x 18.0 x 18.0 mm
