EOSCogniton/STUF2019/AA - Mise en plan/Boisard/Plans essais Boisard/MEP essais traction/19B_TRACTION_02 (insert alu manchon).igs

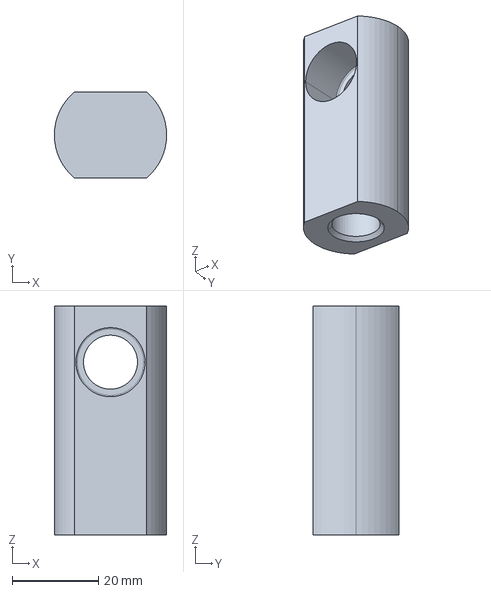
[picture p541: CAD file, 2018-11-07]
AA - Mise en plan/Boisard/Plans essais Boisard/MEP essais traction/19B_TRACTION_02 (insert alu manchon).igs
26.0 x 20.0 x 53.0 mm
