EOSCogniton/STUF2019/AA - Mise en plan/Centrale/19B_ST_0600_001 (Pivot de direction)/19B_ST_0600_001 (Pivot de direction).igs

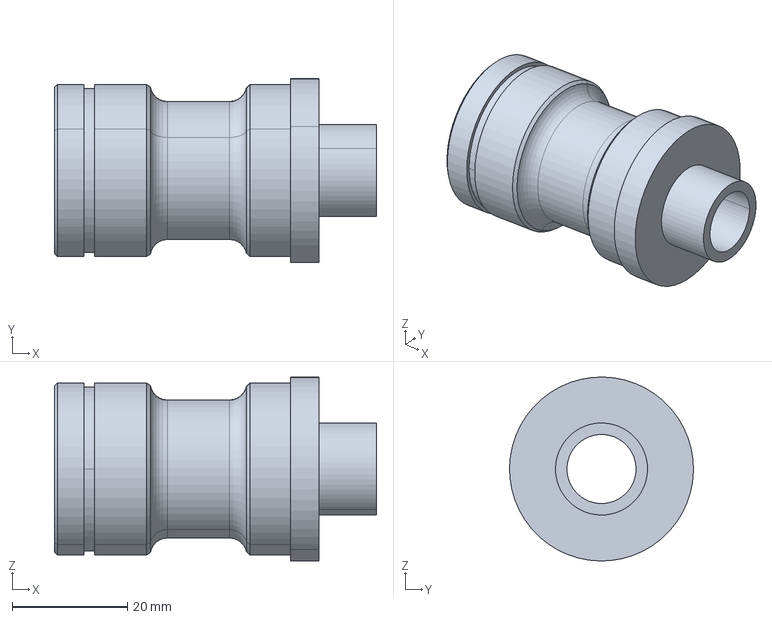
[picture p542: CAD file, 2018-12-09]
AA - Mise en plan/Centrale/19B_ST_0600_001 (Pivot de direction)/19B_ST_0600_001 (Pivot de direction).igs
56.0 x 32.0 x 32.0 mm
