EOSCogniton/STUF2019/AA - Mise en plan/Centrale/19B_ST_0600_002 (Manchon de direction)/19B_ST_0600_002 (Manchon de direction).igs

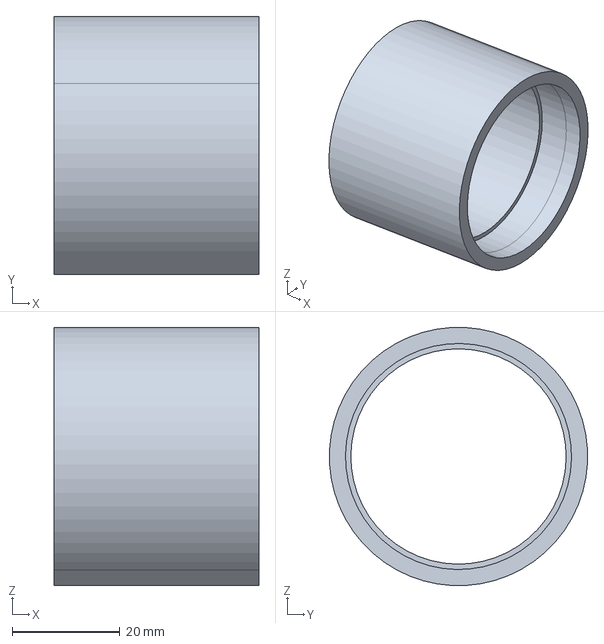
[picture p543: CAD file, 2018-12-09]
AA - Mise en plan/Centrale/19B_ST_0600_002 (Manchon de direction)/19B_ST_0600_002 (Manchon de direction).igs
38.0 x 47.9 x 47.9 mm
