EOSCogniton/STUF2019/AA - Mise en plan/Centrale/19B_SU_01006 (Cylindres triangles diam 11.8)/19B_SU_01006 (Cylindres triangles diam 11.8).igs

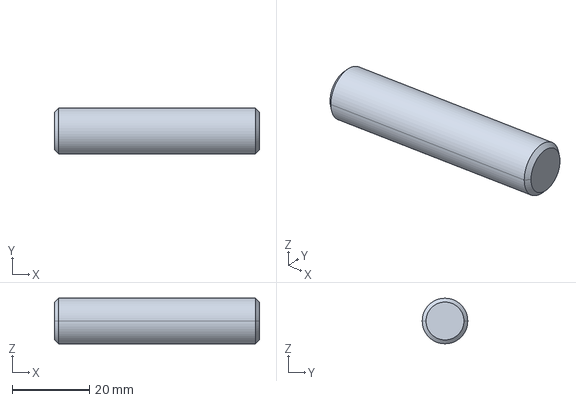
[picture p544: CAD file, 2019-02-13]
AA - Mise en plan/Centrale/19B_SU_01006 (Cylindres triangles diam 11.8)/19B_SU_01006 (Cylindres triangles diam 11.8).igs
53.0 x 11.8 x 11.8 mm
