EOSCogniton/STUF2019/AA - Mise en plan/Centrale/19B_SU_1400_002 (Pivot BAR droit)/19B_SU_1400_002 (Pivot BAR droit).igs

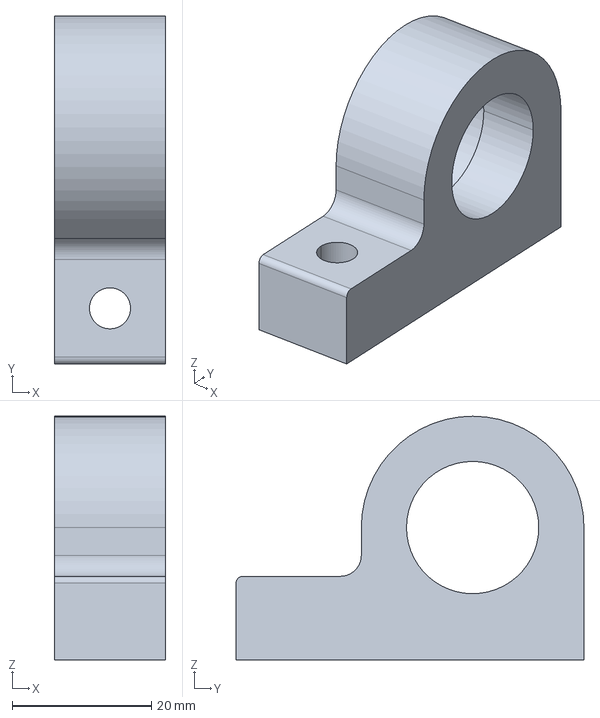
[picture p545: CAD file, 2018-12-18]
AA - Mise en plan/Centrale/19B_SU_1400_002 (Pivot BAR droit)/19B_SU_1400_002 (Pivot BAR droit).igs
16.0 x 50.0 x 35.0 mm
