EOSCogniton/STUF2019/AA - Mise en plan/Centrale/19B_WT_03004 (Tripod Housing Spacer)/19B_WT_03004 (Tripod Housing Spacer).igs

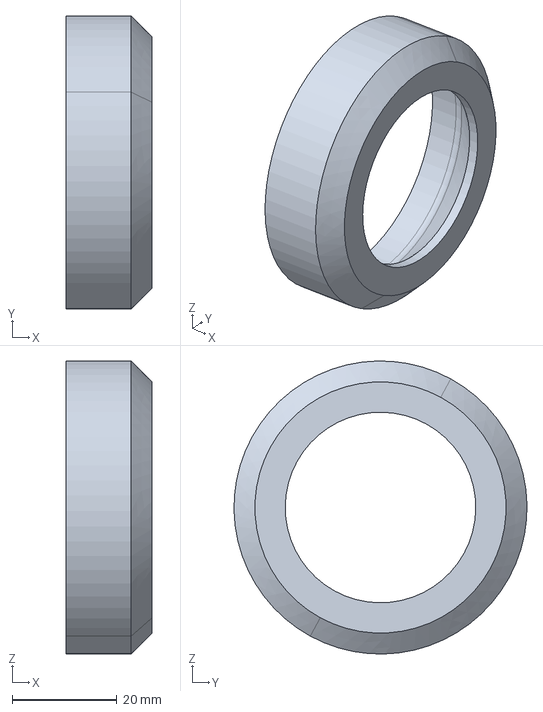
[picture p546: CAD file, 2018-12-16]
AA - Mise en plan/Centrale/19B_WT_03004 (Tripod Housing Spacer)/19B_WT_03004 (Tripod Housing Spacer).igs
16.5 x 56.0 x 56.0 mm
