EOSCogniton/STUF2019/AA - Mise en plan/Centrale/19C_EN_0100_005 (Adaptateur huile)/19C_EN_0100_005 (Adaptateur huile).igs

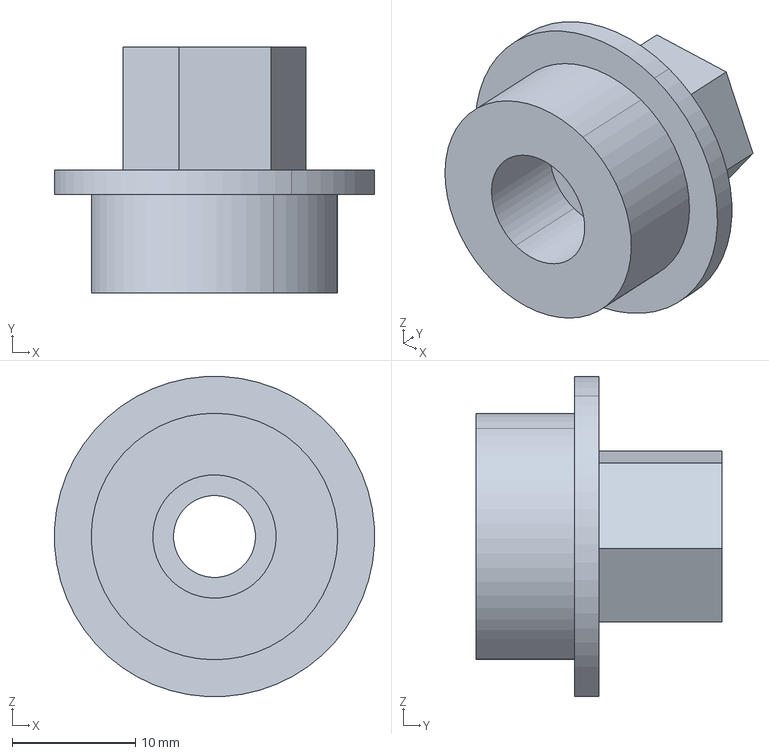
[picture p547: CAD file, 2019-01-29]
AA - Mise en plan/Centrale/19C_EN_0100_005 (Adaptateur huile)/19C_EN_0100_005 (Adaptateur huile).igs
26.0 x 20.0 x 26.0 mm
