EOSCogniton/STUF2019/AA - Mise en plan/La Mache Laser/Acier/Acier 1,5mm S235/IGS acier 1,5mm S235/19M_MS_0100_004 (Chapes firewall).igs

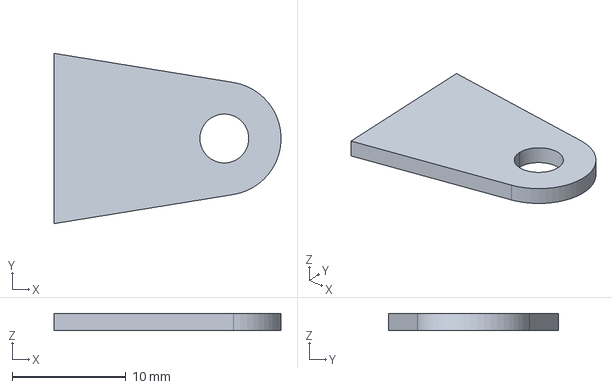
[picture p548: CAD file, 2019-02-14]
AA - Mise en plan/La Mache Laser/Acier/Acier 1,5mm S235/IGS acier 1,5mm S235/19M_MS_0100_004 (Chapes firewall).igs
20.0 x 15.0 x 1.50 mm
