EOSCogniton/STUF2019/AA - Mise en plan/La Mache Laser/Acier/Acier 2mm S235/19M_EN_0902_003 (Chainshield).igs

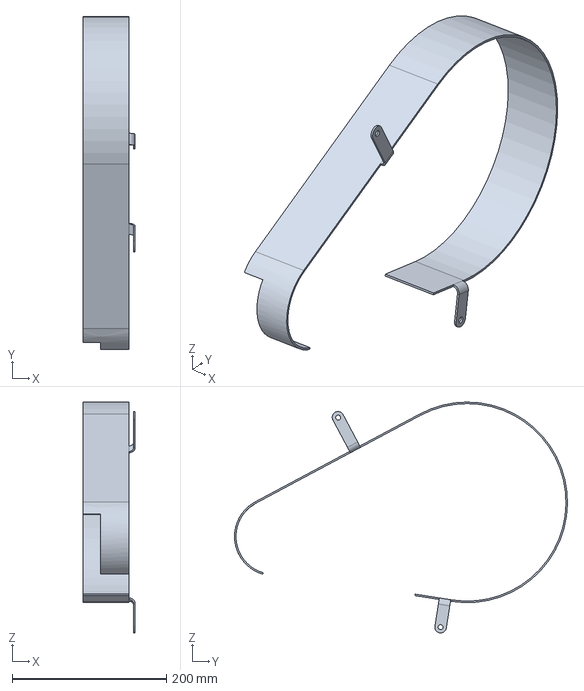
[picture p549: CAD file, 2018-12-18]
AA - Mise en plan/La Mache Laser/Acier/Acier 2mm S235/19M_EN_0902_003 (Chainshield).igs
68.0 x 431.7 x 299.3 mm
