EOSCogniton/STUF2019/AA - Mise en plan/La Mache Laser/Acier/Acier 3mm S355/IGS acier 3mm S355/V2_19M_EN_0901_012 (Chape PE 2).igs

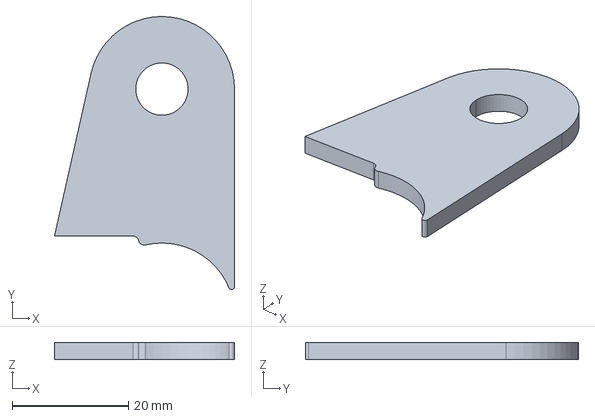
[picture p550: CAD file, 2019-04-30]
AA - Mise en plan/La Mache Laser/Acier/Acier 3mm S355/IGS acier 3mm S355/V2_19M_EN_0901_012 (Chape PE 2).igs
31.0 x 47.0 x 3.00 mm
