EOSCogniton/STUF2019/AA - Mise en plan/La Mache Laser/Acier/Acier 4mm S700/IGS acier 4mm S700/19M_SU_1400_006 (Chape ARB FL).igs

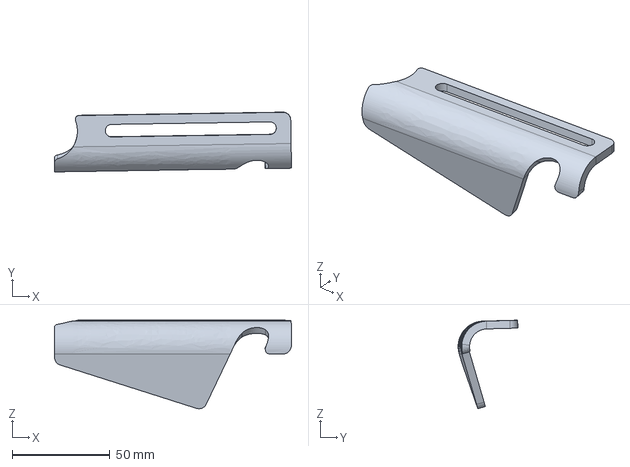
[picture p551: CAD file, 2018-12-16]
AA - Mise en plan/La Mache Laser/Acier/Acier 4mm S700/IGS acier 4mm S700/19M_SU_1400_006 (Chape ARB FL).igs
121.1 x 30.5 x 45.2 mm
