EOSCogniton/STUF2019/AA - Mise en plan/La Mache Laser/Acier/Acier 5mm S235/19M_WT_0200_005 (Front Speed Sensor Disc).igs

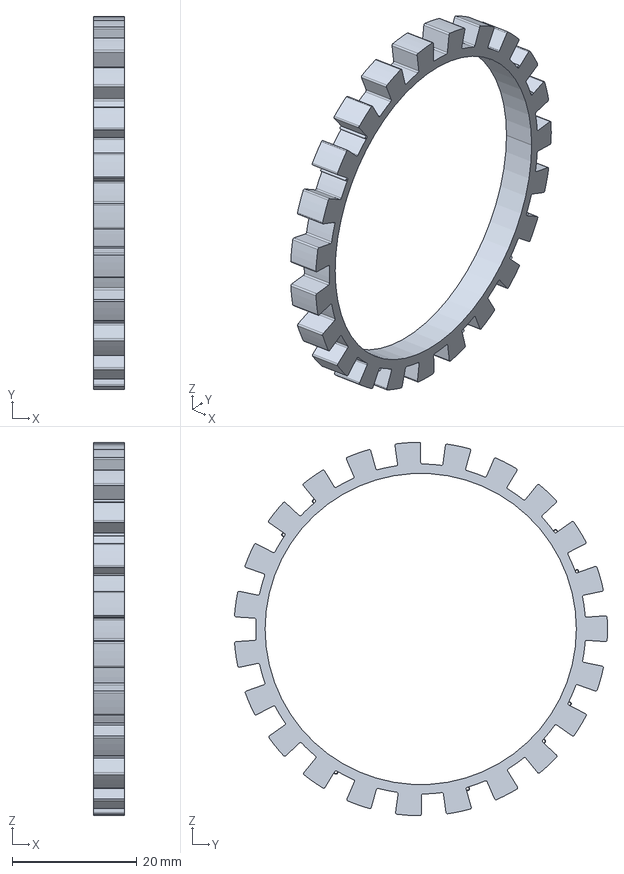
[picture p552: CAD file, 2018-12-15]
AA - Mise en plan/La Mache Laser/Acier/Acier 5mm S235/19M_WT_0200_005 (Front Speed Sensor Disc).igs
5.00 x 59.9 x 60.0 mm
