EOSCogniton/STUF2019/AA - Mise en plan/La Mache Laser/Aluminium/Aluminium 2017 T4/Aluminium 1mm 2017 T4/19M_SU_0100_003 (Upper Arm Wedge Shim 1mm).igs

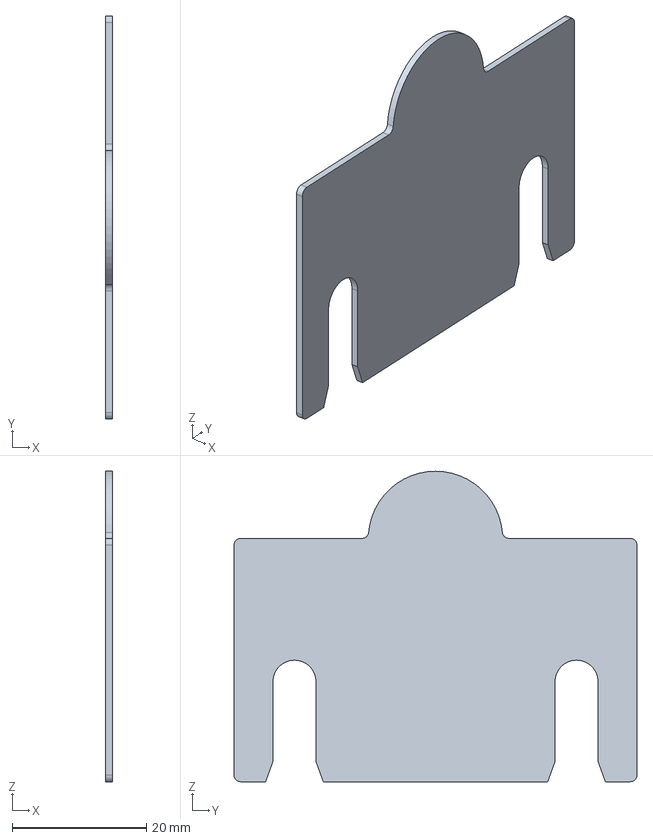
[picture p553: CAD file, 2018-12-11]
AA - Mise en plan/La Mache Laser/Aluminium/Aluminium 2017 T4/Aluminium 1mm 2017 T4/19M_SU_0100_003 (Upper Arm Wedge Shim 1mm).igs
1.00 x 60.0 x 46.2 mm
