EOSCogniton/STUF2019/AA - Mise en plan/La Mache Laser/Aluminium/Aluminium 2017 T4/Aluminium 2.5mm 2017 T4/IGS aluminium 2017 T4 2.5mm/19M_FR_0300_004 (Cale talon).igs

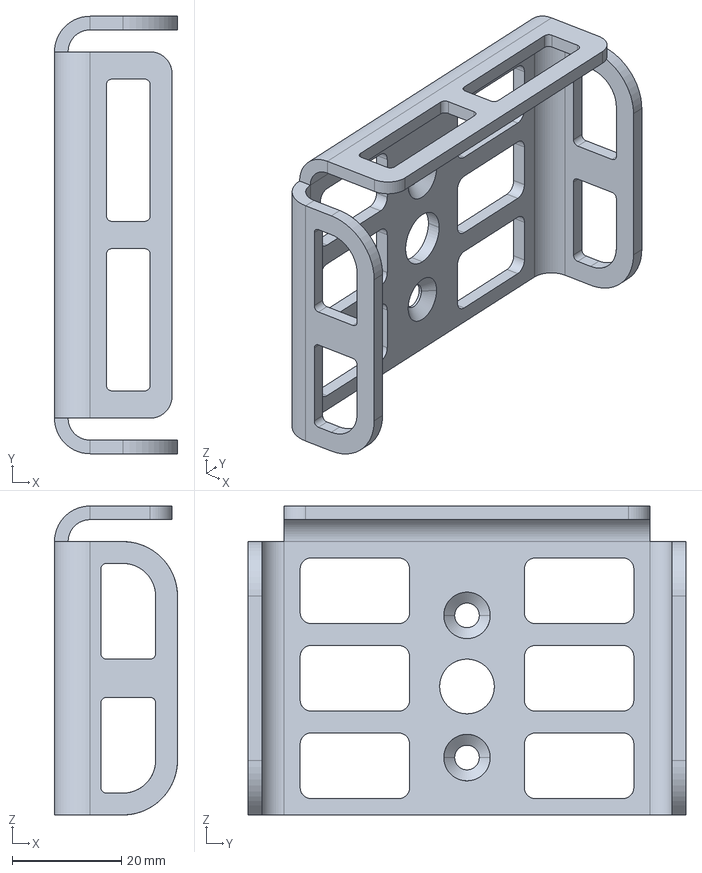
[picture p554: CAD file, 2019-02-24]
AA - Mise en plan/La Mache Laser/Aluminium/Aluminium 2017 T4/Aluminium 2.5mm 2017 T4/IGS aluminium 2017 T4 2.5mm/19M_FR_0300_004 (Cale talon).igs
22.5 x 80.0 x 56.5 mm
