EOSCogniton/STUF2019/AA - Mise en plan/La Mache Laser/Aluminium/Aluminium 2017 T4/Aluminium 2mm 2017 T4/19M_SU_0100_003_2mm (Upper Arm Wedge Shim 2mm).igs

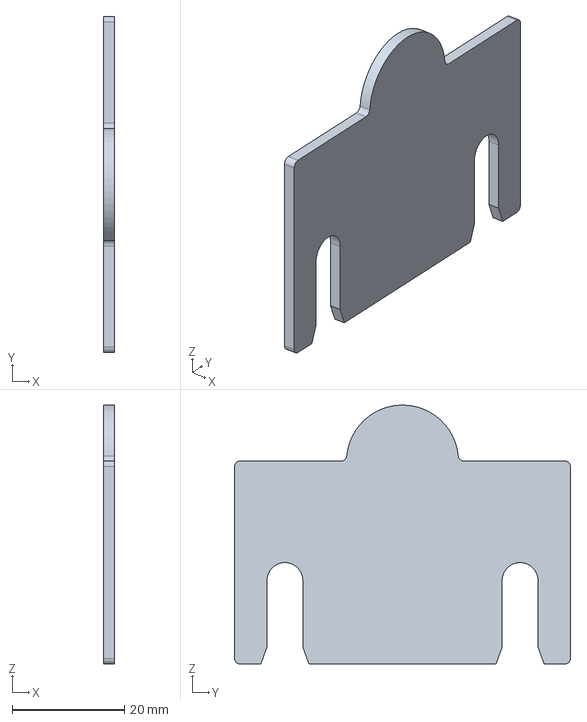
[picture p555: CAD file, 2018-12-11]
AA - Mise en plan/La Mache Laser/Aluminium/Aluminium 2017 T4/Aluminium 2mm 2017 T4/19M_SU_0100_003_2mm (Upper Arm Wedge Shim 2mm).igs
2.00 x 60.0 x 46.2 mm
