EOSCogniton/STUF2019/AA - Mise en plan/La Mache Laser/Aluminium/Aluminium 2017A (AU4G)/Aluminium 1mm 2017A/IGS aluminium 1mm 2017A/19M_MS_0100_005 (Ailettes).igs

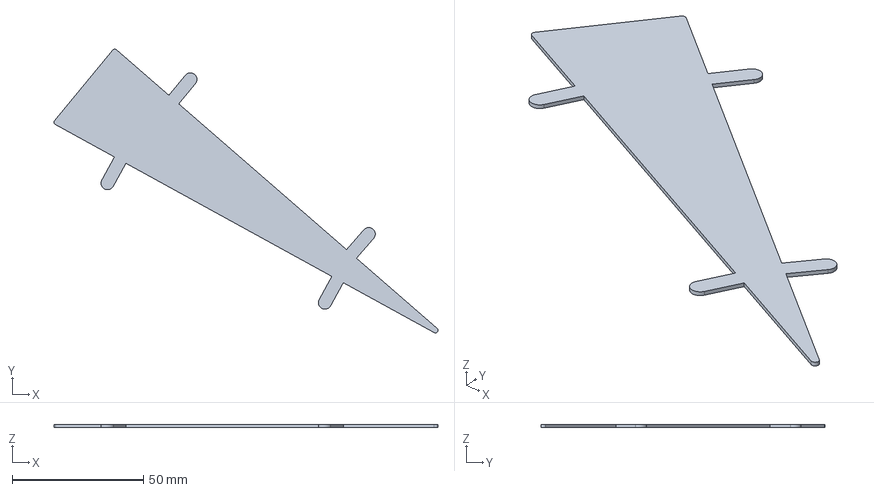
[picture p556: CAD file, 2019-03-19]
AA - Mise en plan/La Mache Laser/Aluminium/Aluminium 2017A (AU4G)/Aluminium 1mm 2017A/IGS aluminium 1mm 2017A/19M_MS_0100_005 (Ailettes).igs
146.1 x 108.0 x 1.00 mm
