EOSCogniton/STUF2019/AA - Mise en plan/La Mache Laser/Aluminium/Aluminium 2017A (AU4G)/Aluminium 2.5mm 2017A/IGS aluminium 2.5mm 2017A/19M_EN_0400_002 (Arret guillotine gauche).igs

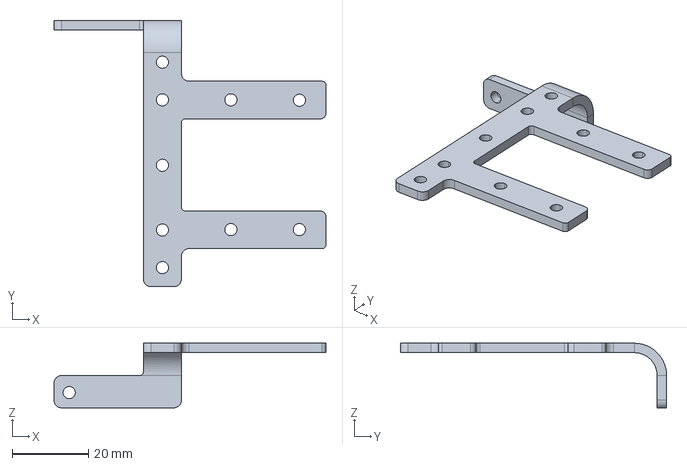
[picture p557: CAD file, 2019-02-24]
AA - Mise en plan/La Mache Laser/Aluminium/Aluminium 2017A (AU4G)/Aluminium 2.5mm 2017A/IGS aluminium 2.5mm 2017A/19M_EN_0400_002 (Arret guillotine gauche).igs
71.5 x 70.0 x 17.0 mm
