EOSCogniton/STUF2019/AA - Mise en plan/La Mache Laser/Aluminium/Aluminium 5754/Aluminium 2,5mm 5754/IGS aluminium 2,5mm 5754/19M_EN_0101_002_(Plaque).igs

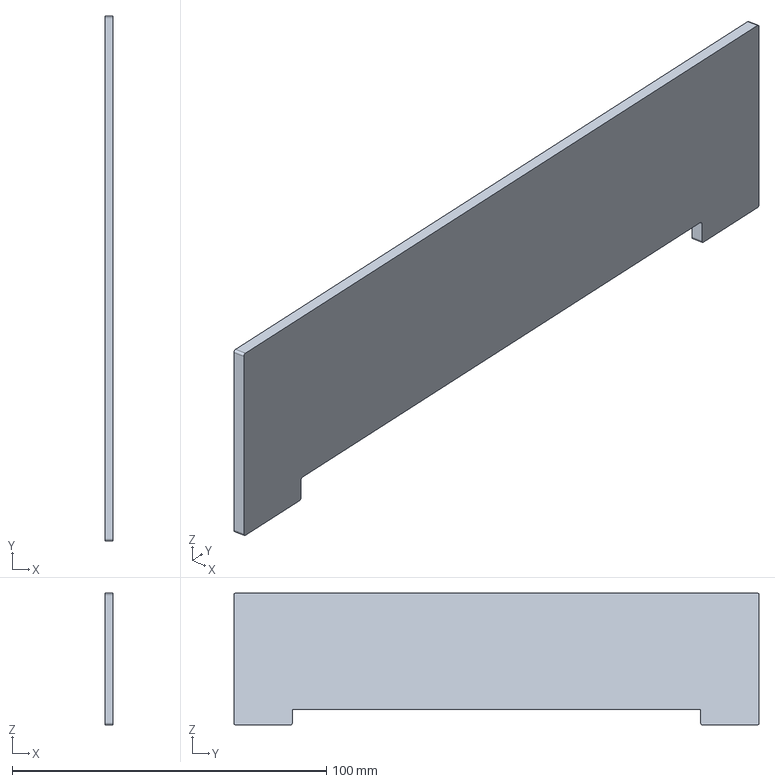
[picture p558: CAD file, 2018-12-15]
AA - Mise en plan/La Mache Laser/Aluminium/Aluminium 5754/Aluminium 2,5mm 5754/IGS aluminium 2,5mm 5754/19M_EN_0101_002_(Plaque).igs
2.50 x 167.1 x 42.0 mm
