EOSCogniton/STUF2019/AA - Mise en plan/La Mache Laser/Chainshield/chainshieldv2_plie.igs

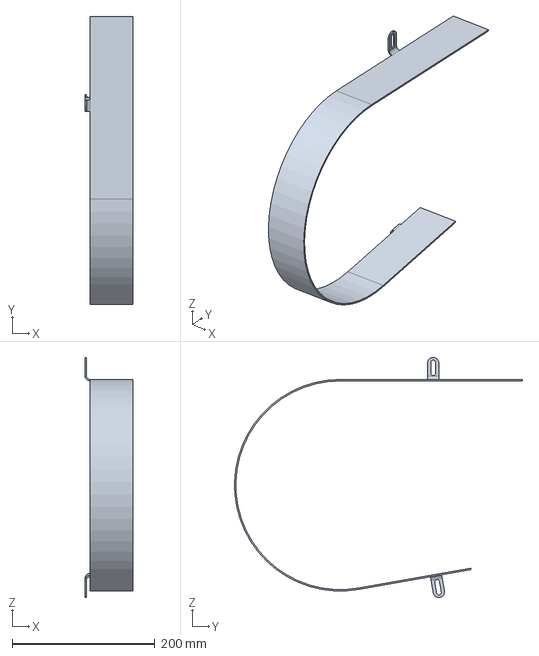
[picture p559: CAD file, 2019-06-16]
AA - Mise en plan/La Mache Laser/Chainshield/chainshieldv2_plie.igs
67.0 x 402.9 x 335.9 mm
