EOSCogniton/STUF2019/AA - Mise en plan/La Mache Productique/Acier 35NCD16/IGS acier 35NCD16/19M_FR_0300_018_BA (Entretoise interieure pedale de frein).igs

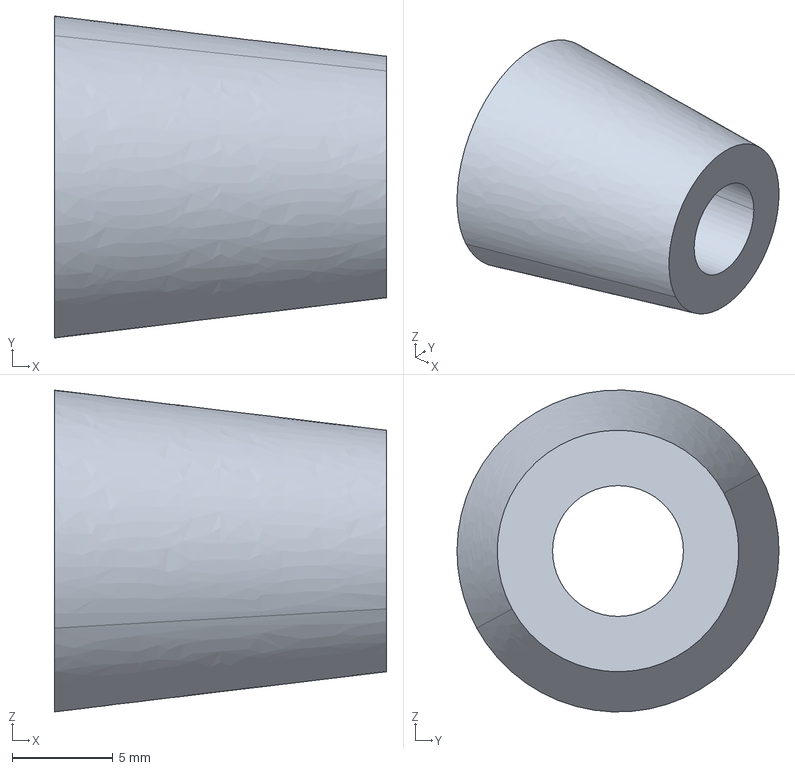
[picture p560: CAD file, 2018-12-11]
AA - Mise en plan/La Mache Productique/Acier 35NCD16/IGS acier 35NCD16/19M_FR_0300_018_BA (Entretoise interieure pedale de frein).igs
16.5 x 16.0 x 16.0 mm
