EOSCogniton/STUF2019/AA - Mise en plan/La Mache Productique/Acier S355JR/IGS acier S355JR/19M_FR_0100_003 (Sleeve Joint).igs

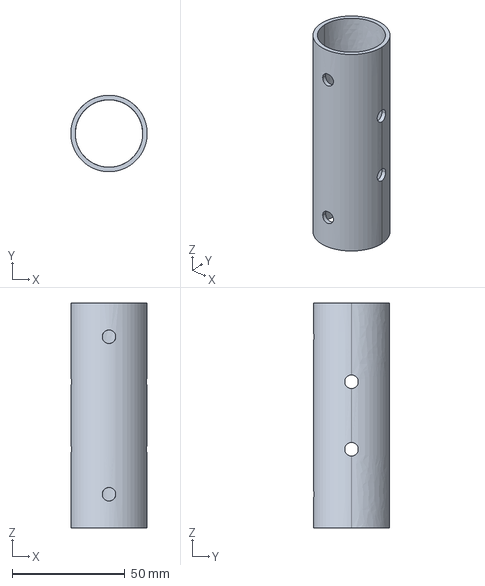
[picture p561: CAD file, 2018-12-11]
AA - Mise en plan/La Mache Productique/Acier S355JR/IGS acier S355JR/19M_FR_0100_003 (Sleeve Joint).igs
34.0 x 34.0 x 100.0 mm
