EOSCogniton/STUF2019/AA - Mise en plan/La Mache Productique/Aluminium 2017A T4/IGS 2017A T43/19M_FR_0300_001_BA (Pedale F).igs

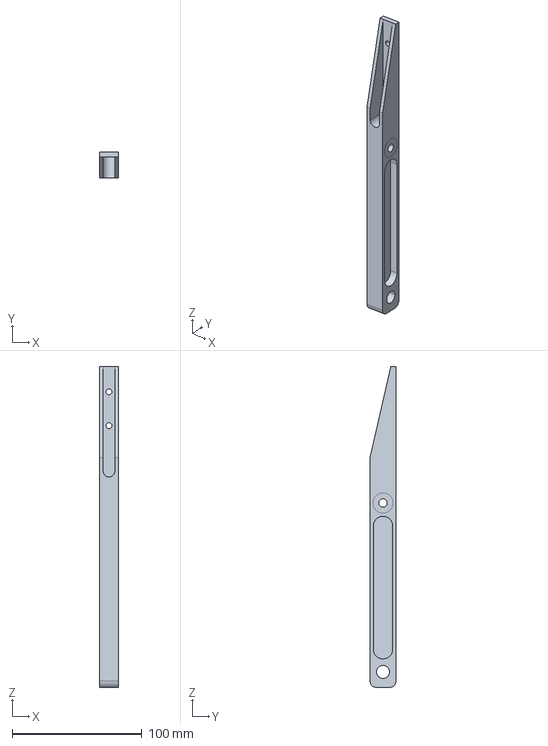
[picture p562: CAD file, 2019-01-08]
AA - Mise en plan/La Mache Productique/Aluminium 2017A T4/IGS 2017A T43/19M_FR_0300_001_BA (Pedale F).igs
15.0 x 20.0 x 247.0 mm
