EOSCogniton/STUF2019/AA - Mise en plan/La Mache Productique/Aluminium 2017A/IGS 2017A/19M_ST_0400_002 (Entretoise QR).igs

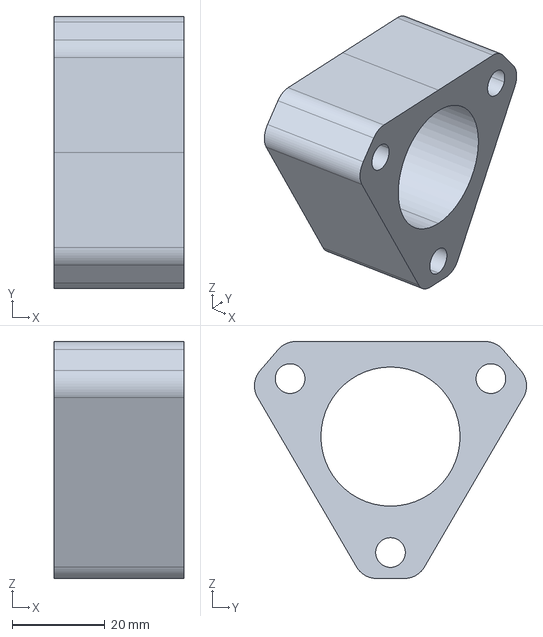
[picture p563: CAD file, 2019-01-13]
AA - Mise en plan/La Mache Productique/Aluminium 2017A/IGS 2017A/19M_ST_0400_002 (Entretoise QR).igs
28.0 x 58.7 x 51.1 mm
