EOSCogniton/STUF2019/AA - Mise en plan/La Mache Productique/Aluminium 7075 T6/19_SU_1500_006 (Biellette ARB).igs

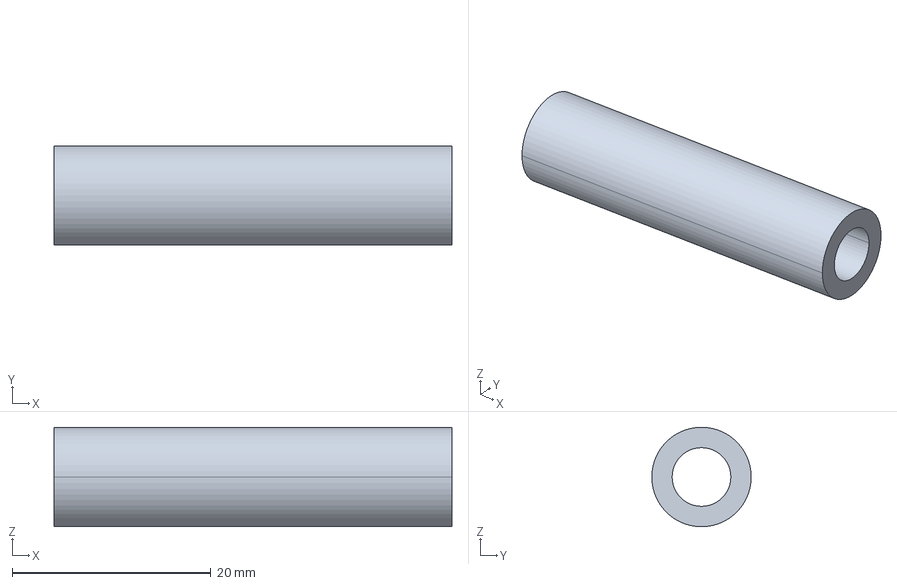
[picture p564: CAD file, 2018-12-14]
AA - Mise en plan/La Mache Productique/Aluminium 7075 T6/19_SU_1500_006 (Biellette ARB).igs
40.0 x 10.0 x 10.0 mm
