EOSCogniton/STUF2019/AA - Mise en plan/La Mache Productique/Delrin/IGS Delrin/19M_EN_0901_004 (Exc gauche).igs

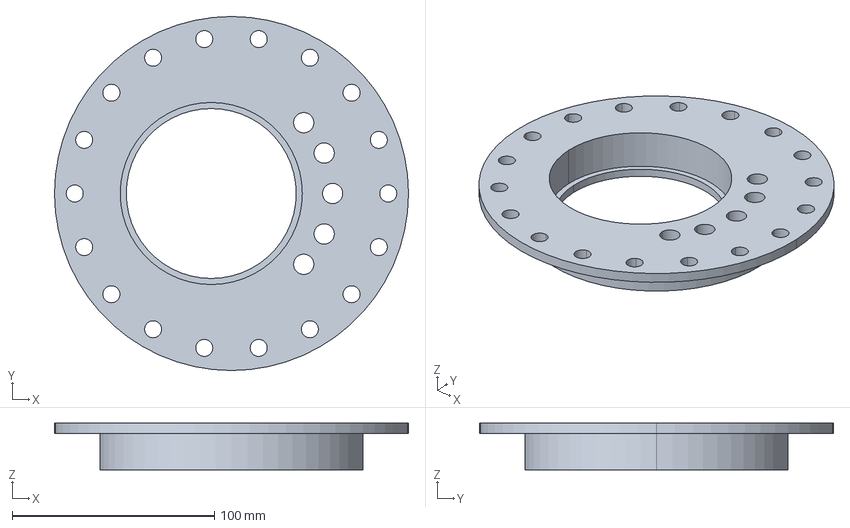
[picture p565: CAD file, 2018-12-18]
AA - Mise en plan/La Mache Productique/Delrin/IGS Delrin/19M_EN_0901_004 (Exc gauche).igs
175.0 x 175.0 x 23.0 mm
