EOSCogniton/STUF2019/BR - Brake System/D5284.STEP

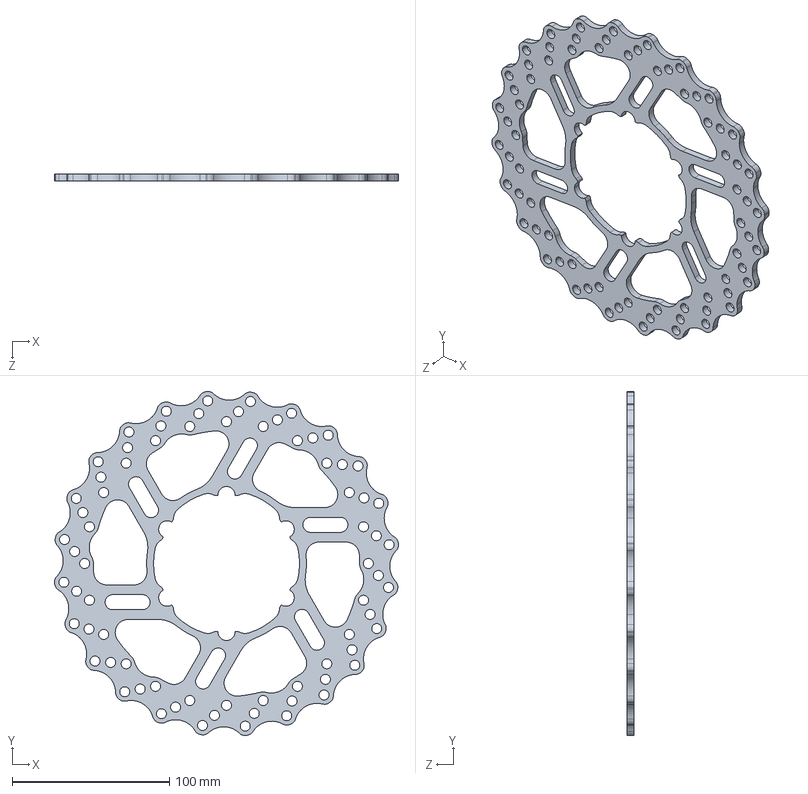
[picture p566: CAD file, 2018-11-07]
BR - Brake System/D5284.STEP
218.7 x 218.7 x 4.57 mm
