EOSCogniton/STUF2019/EL - Electrical/Autre/Tableau de bord/Tableau Optimus/graphisme/serigraphie11R12.dxf

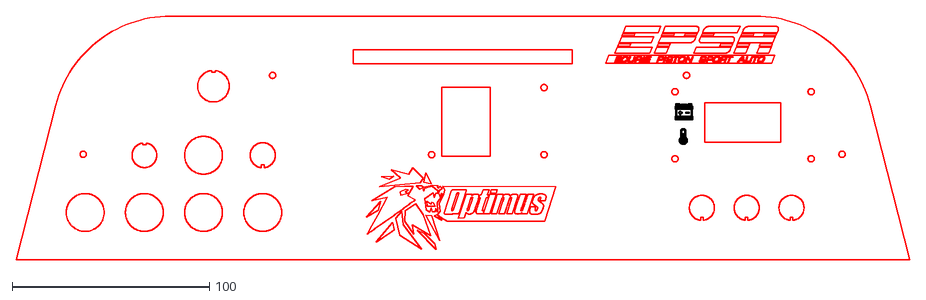
[picture p567: CAD file, 2019-05-06]
EL - Electrical/Autre/Tableau de bord/Tableau Optimus/graphisme/serigraphie11R12.dxf
452.7 x 123.4
