EOSCogniton/STUF2019/EL - Electrical/Autre/Tableau de bord/Tableau Optimus/graphisme/Sérigraphies kiCAD/graphisme.dxf

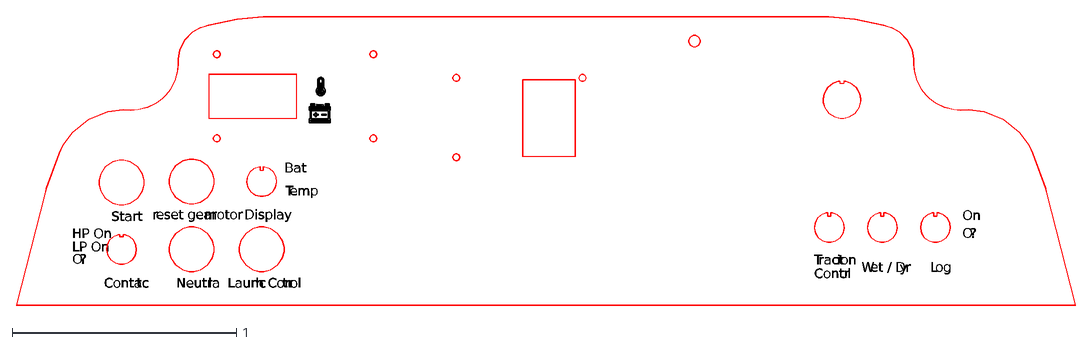
[picture p568: CAD file, 2018-11-11]
EL - Electrical/Autre/Tableau de bord/Tableau Optimus/graphisme/Sérigraphies kiCAD/graphisme.dxf
Contac
t
Start
r
eset gear
motor
Display
Neutra
l
Launc
h Con
tr
ol
T
ract
ion
Contr
W
et / Dr
y
L
og
LP On
HP On
O
Bat
emp
On
