EOSCogniton/STUF2019/EL - Electrical/Autre/Tableau de bord/Tableau vulcanix/Découpe laser/dxfR12.dxf

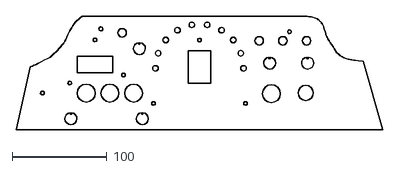
[picture p569: CAD file, 2018-09-20]
EL - Electrical/Autre/Tableau de bord/Tableau vulcanix/Découpe laser/dxfR12.dxf
386.7 x 119.6
