EOSCogniton/STUF2019/EL - Electrical/Catia/EL_A0100 (Rear firewall instruments)/EL_0100_003_AA.STEP

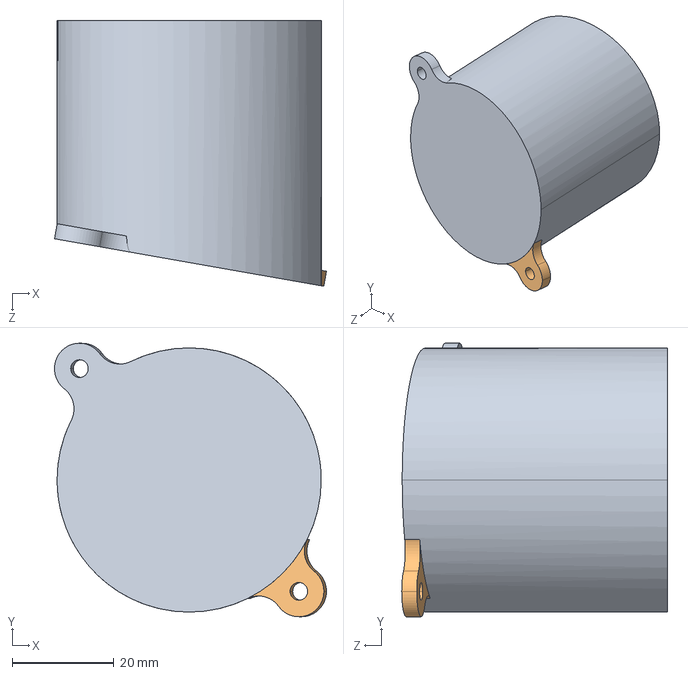
[picture p570: CAD file, 2018-11-09]
EL - Electrical/Catia/EL_A0100 (Rear firewall instruments)/EL_0100_003_AA.STEP
53.5 x 53.8 x 52.3 mm
