EOSCogniton/STUF2019/EL - Electrical/Catia/Support Tyre Temp/PM Optimus/SU_A1100 (Rear Upright Assy)/D4484.STEP

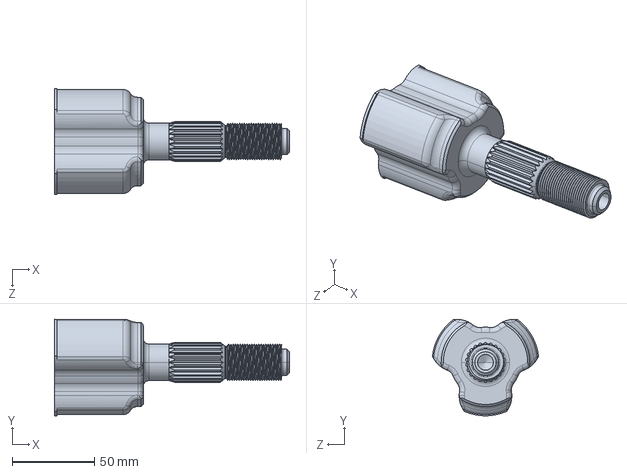
[picture p571: CAD file, 2019-03-19]
EL - Electrical/Catia/Support Tyre Temp/PM Optimus/SU_A1100 (Rear Upright Assy)/D4484.STEP
142.9 x 58.7 x 64.6 mm
