EOSCogniton/STUF2019/EN - Engine & Powertrain/EN_A0100 (Engine)/Carter d'huile - fonderie/EN_0101_007 (Etanchity plate).stp

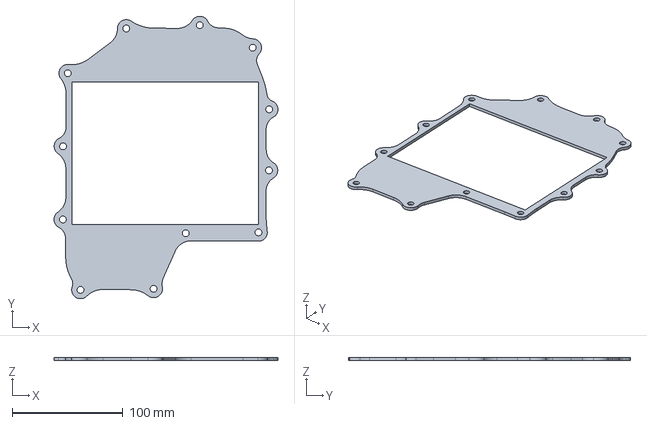
[picture p572: CAD file, 2019-01-21]
EN - Engine & Powertrain/EN_A0100 (Engine)/Carter d'huile - fonderie/EN_0101_007 (Etanchity plate).stp
202.3 x 255.1 x 3.00 mm
