EOSCogniton/STUF2019/EN - Engine & Powertrain/EN_A0100 (Engine)/Carter d'huile - fonderie/Exemple d'une autre équipe/Modified Oil Pan.STEP

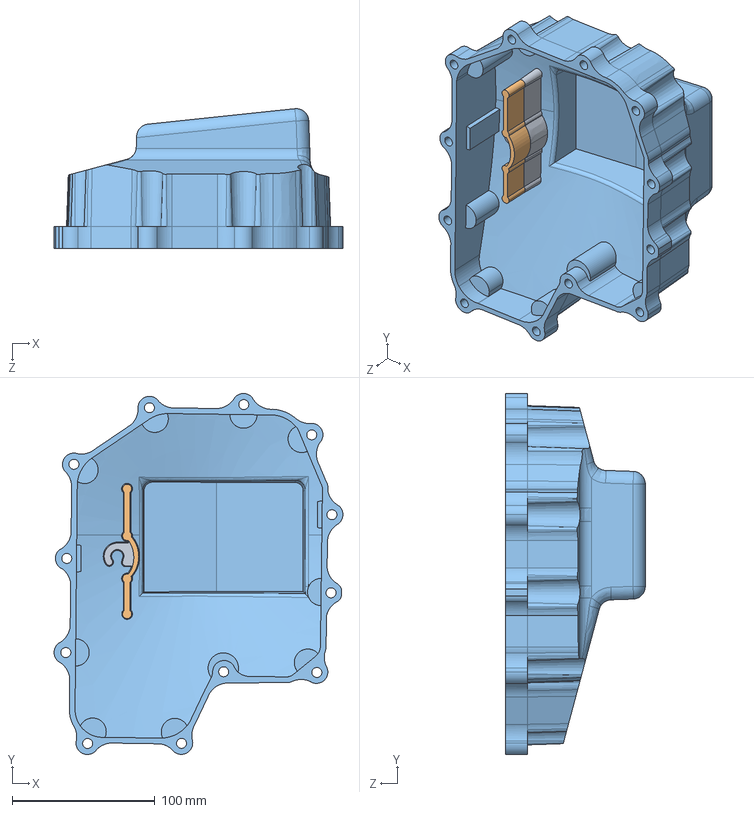
[picture p573: CAD file, 2019-01-21]
EN - Engine & Powertrain/EN_A0100 (Engine)/Carter d'huile - fonderie/Exemple d'une autre équipe/Modified Oil Pan.STEP
202.4 x 253.0 x 97.9 mm
