EOSCogniton/STUF2019/EN - Engine & Powertrain/EN_A0200 (Exhaust system)/mise en plan/18M_EN_0200_009.igs

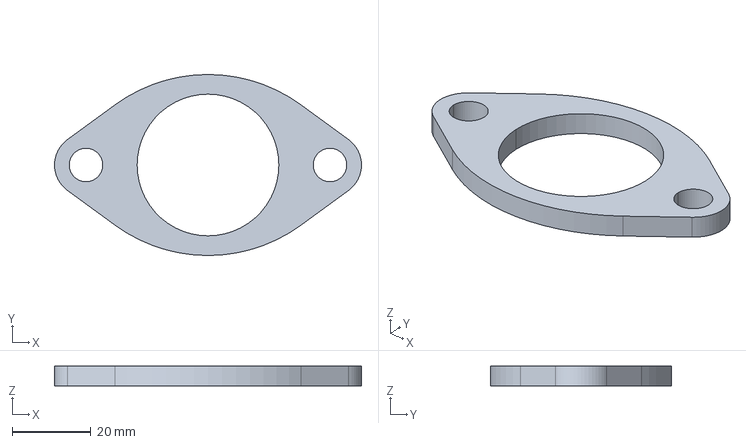
[picture p574: CAD file, 2018-10-09]
EN - Engine & Powertrain/EN_A0200 (Exhaust system)/mise en plan/18M_EN_0200_009.igs
78.0 x 46.0 x 5.00 mm
