EOSCogniton/STUF2019/EN - Engine & Powertrain/EN_A0400 (Throttle body)/Fablab/guillotine_v2.stl

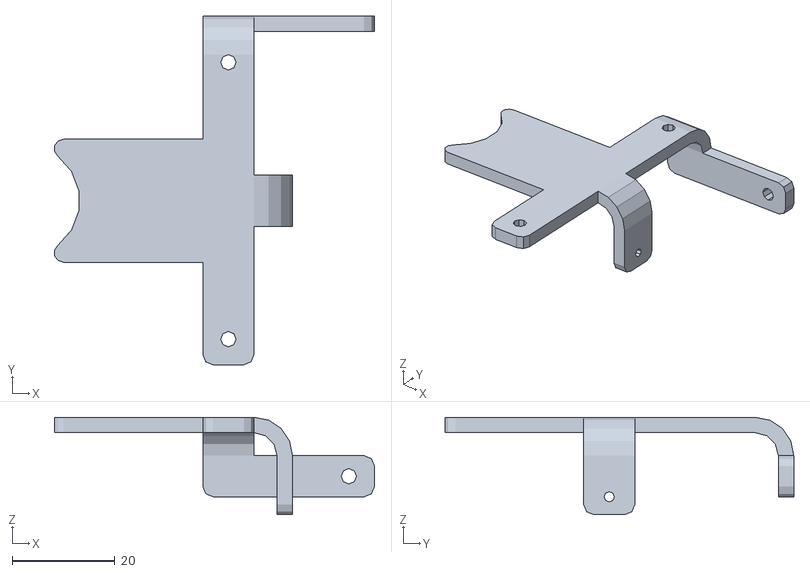
[picture p575: CAD file, 2018-11-28]
EN - Engine & Powertrain/EN_A0400 (Throttle body)/Fablab/guillotine_v2.stl
62.4 x 68.0 x 19.0
