EOSCogniton/STUF2019/EN - Engine & Powertrain/EN_A0400 (Throttle body)/MEP/19M_EN_0400_004 (Partie mobile guillotine).igs

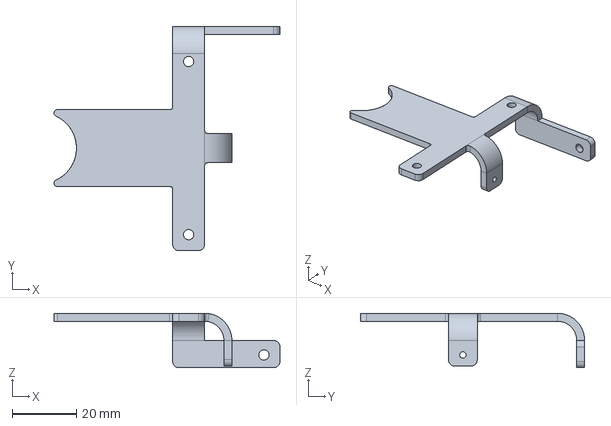
[picture p576: CAD file, 2019-07-31]
EN - Engine & Powertrain/EN_A0400 (Throttle body)/MEP/19M_EN_0400_004 (Partie mobile guillotine).igs
70.5 x 70.0 x 17.0 mm
