EOSCogniton/STUF2019/EN - Engine & Powertrain/EN_A0500 (Fuel tank assembly)/mise en plan/19M_EN_0500_0015(GABARIT)/Gabarit1.igs

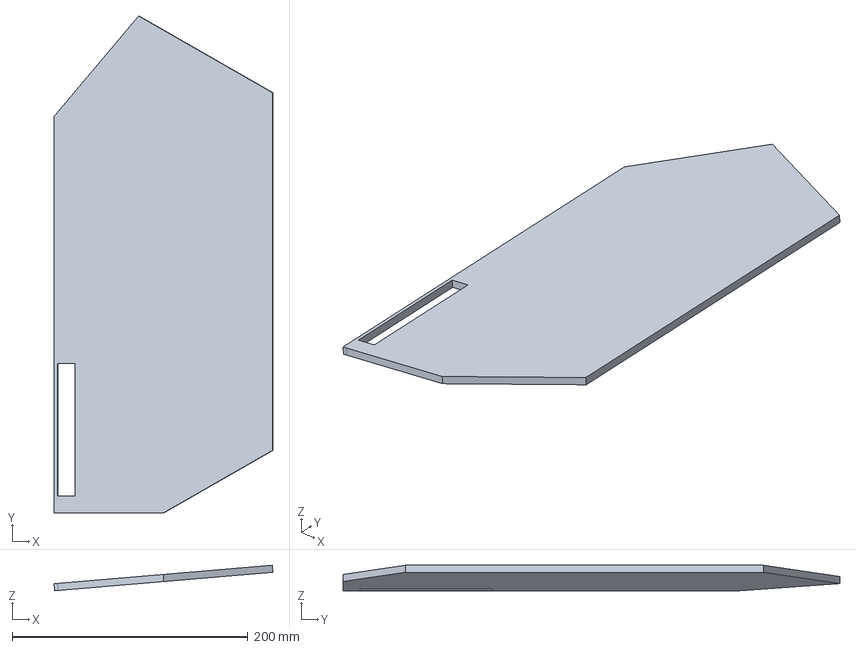
[picture p577: CAD file, 2019-01-31]
EN - Engine & Powertrain/EN_A0500 (Fuel tank assembly)/mise en plan/19M_EN_0500_0015(GABARIT)/Gabarit1.igs
185.6 x 421.2 x 21.6 mm
