EOSCogniton/STUF2019/EN - Engine & Powertrain/EN_A0500 (Fuel tank assembly)/mise en plan/19M_EN_0500_006(Chape avant gauche final)/19M_EN_0500_006 (Chape avant gauche final).igs

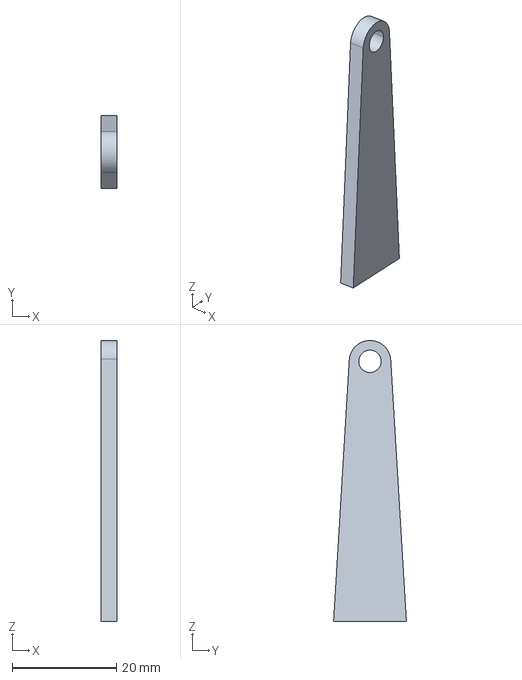
[picture p578: CAD file, 2019-01-30]
EN - Engine & Powertrain/EN_A0500 (Fuel tank assembly)/mise en plan/19M_EN_0500_006(Chape avant gauche final)/19M_EN_0500_006 (Chape avant gauche final).igs
3.00 x 14.0 x 54.0 mm
