EOSCogniton/STUF2019/EN - Engine & Powertrain/EN_A0500 (Fuel tank assembly)/mise en plan/19M_EN_0500_008(Chape reservoir fixation)/19M_EN_0500_008 (Chape reservoir fixation).igs

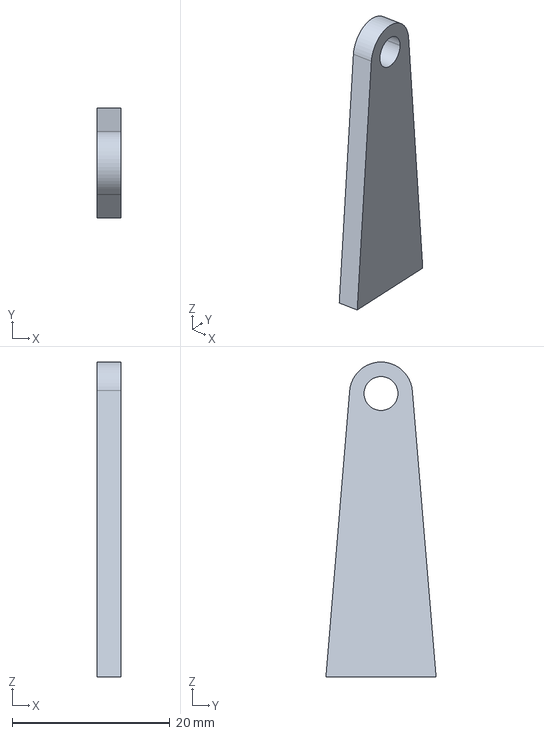
[picture p579: CAD file, 2019-01-30]
EN - Engine & Powertrain/EN_A0500 (Fuel tank assembly)/mise en plan/19M_EN_0500_008(Chape reservoir fixation)/19M_EN_0500_008 (Chape reservoir fixation).igs
3.00 x 14.0 x 40.0 mm
