EOSCogniton/STUF2019/EN - Engine & Powertrain/EN_A0900 (Secondary drivetrain)/EN_A0904 (Drive shaft right)/D5159.STEP

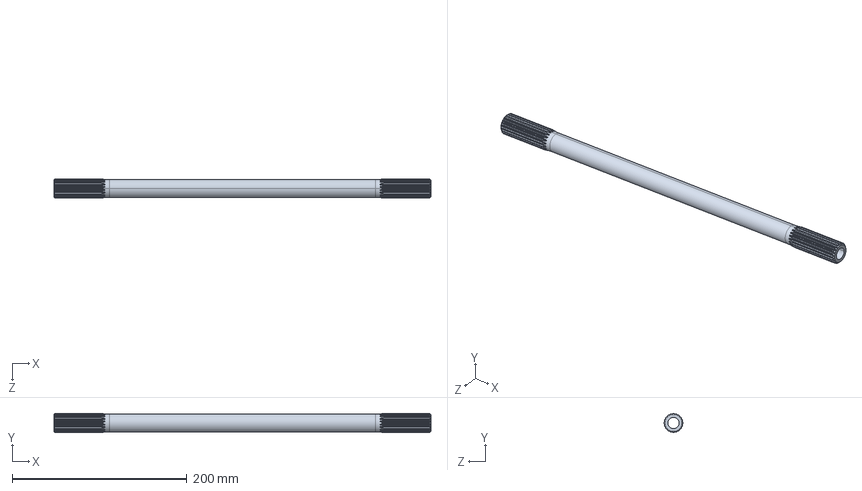
[picture p580: CAD file, 2019-03-19]
EN - Engine & Powertrain/EN_A0900 (Secondary drivetrain)/EN_A0904 (Drive shaft right)/D5159.STEP
431.8 x 22.1 x 22.1 mm
