EOSCogniton/STUF2019/FR - Frame & Body/FR_A0100 (Frame)/Crise chassis 2/renforts bottom.igs

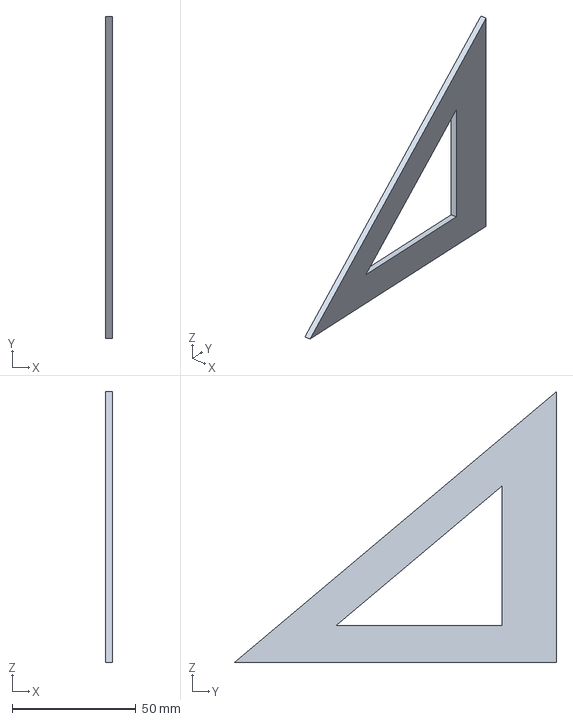
[picture p581: CAD file, 2019-05-07]
FR - Frame & Body/FR_A0100 (Frame)/Crise chassis 2/renforts bottom.igs
3.00 x 130.0 x 109.3 mm
