EOSCogniton/STUF2019/FR - Frame & Body/FR_A0100 (Frame)/pour découverte ansys/tubulaireOptimusTest_V1.3.igs

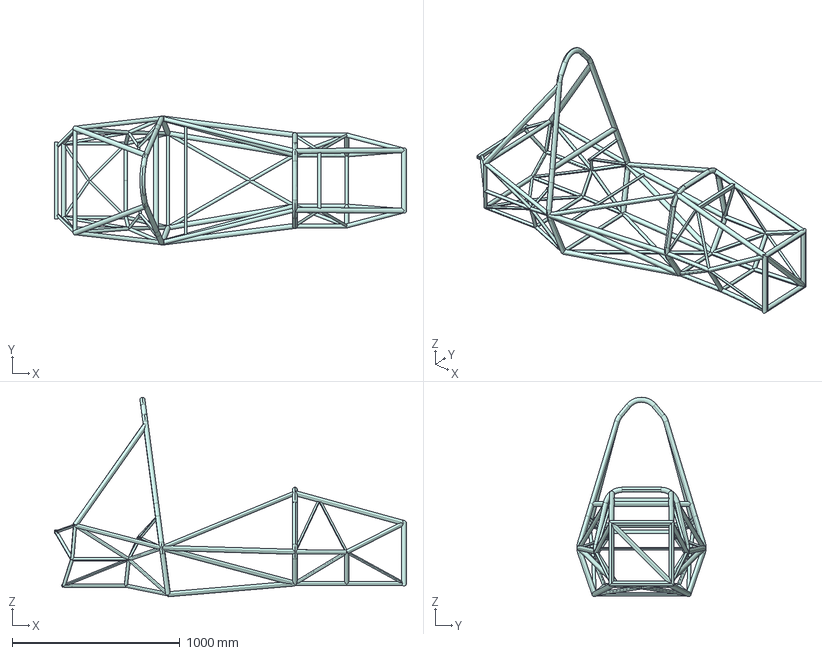
[picture p582: CAD file, 2018-11-15]
FR - Frame & Body/FR_A0100 (Frame)/pour découverte ansys/tubulaireOptimusTest_V1.3.igs
2096.2 x 770.0 x 1188.2 mm
