EOSCogniton/STUF2019/FR - Frame & Body/FR_A0100 (Frame)/Production/Cintrage hoops/Front_hoop.stp

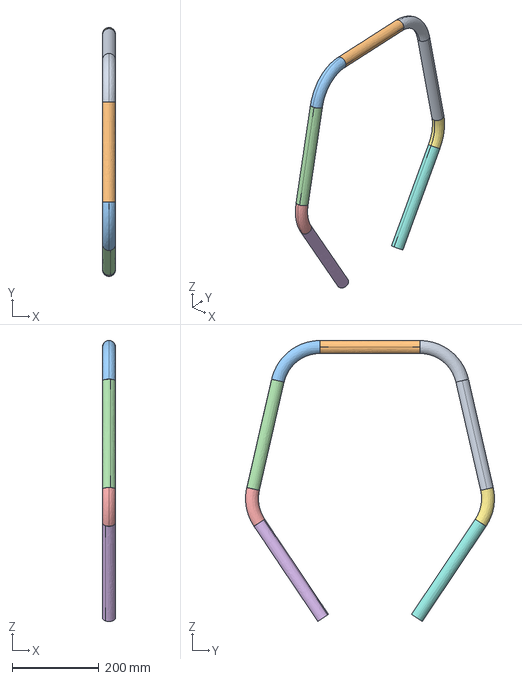
[picture p583: CAD file, 2018-12-05]
FR - Frame & Body/FR_A0100 (Frame)/Production/Cintrage hoops/Front_hoop.stp
30.0 x 574.5 x 648.4 mm
