EOSCogniton/STUF2019/FR - Frame & Body/FR_A0100 (Frame)/Production/Crise MHBS/final/Shape_849_1.stp

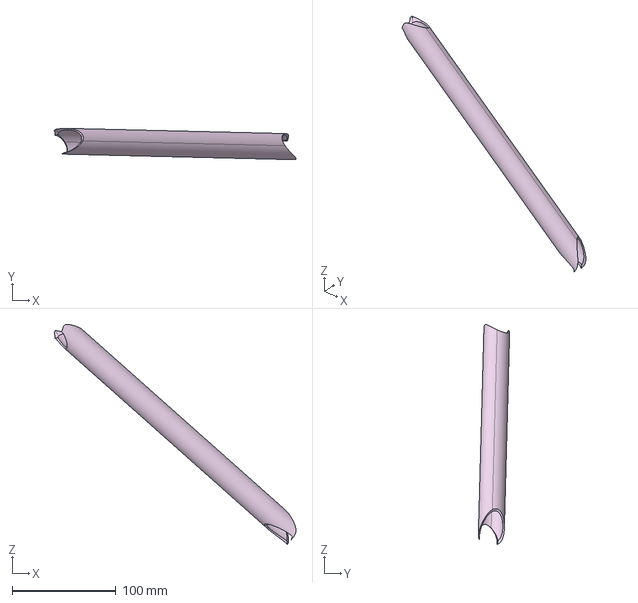
[picture p584: CAD file, 2019-03-04]
FR - Frame & Body/FR_A0100 (Frame)/Production/Crise MHBS/final/Shape_849_1.stp
233.6 x 30.3 x 212.6 mm
