EOSCogniton/STUF2019/FR - Frame & Body/FR_A0100 (Frame)/Production/Crise MHBS/Shape_756.stp

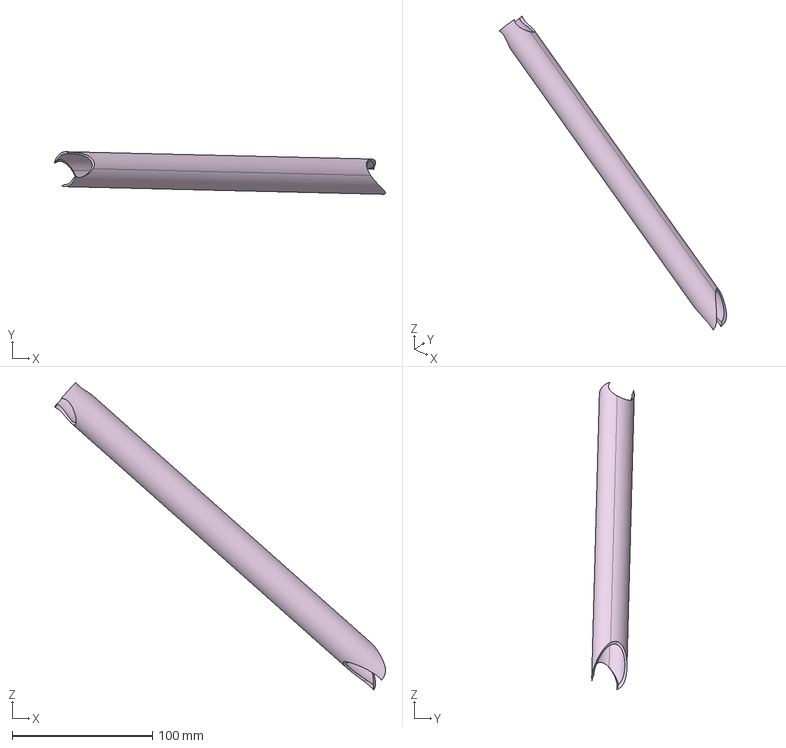
[picture p585: CAD file, 2019-02-27]
FR - Frame & Body/FR_A0100 (Frame)/Production/Crise MHBS/Shape_756.stp
236.3 x 30.4 x 219.6 mm
