EOSCogniton/STUF2019/FR - Frame & Body/FR_A0100 (Frame)/Production/Tubes step réparés/52.stp

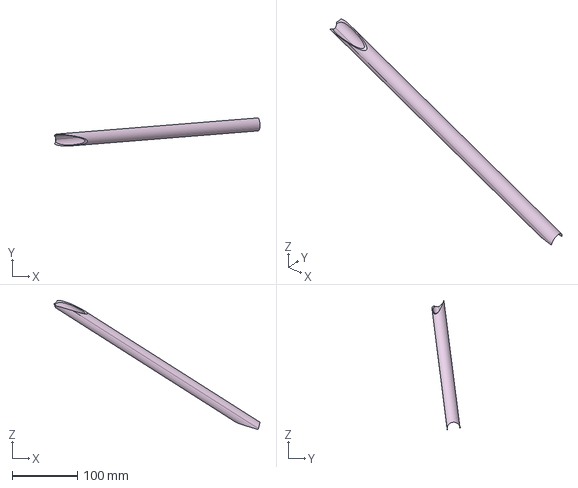
[picture p586: CAD file, 2019-01-08]
FR - Frame & Body/FR_A0100 (Frame)/Production/Tubes step réparés/52.stp
316.8 x 43.2 x 198.4 mm
