EOSCogniton/STUF2019/FR - Frame & Body/FR_A0300 (Pedal Assy)/Manchon taraudé/STEP-2.03/hpc_MHX6-15_SS_B.stp

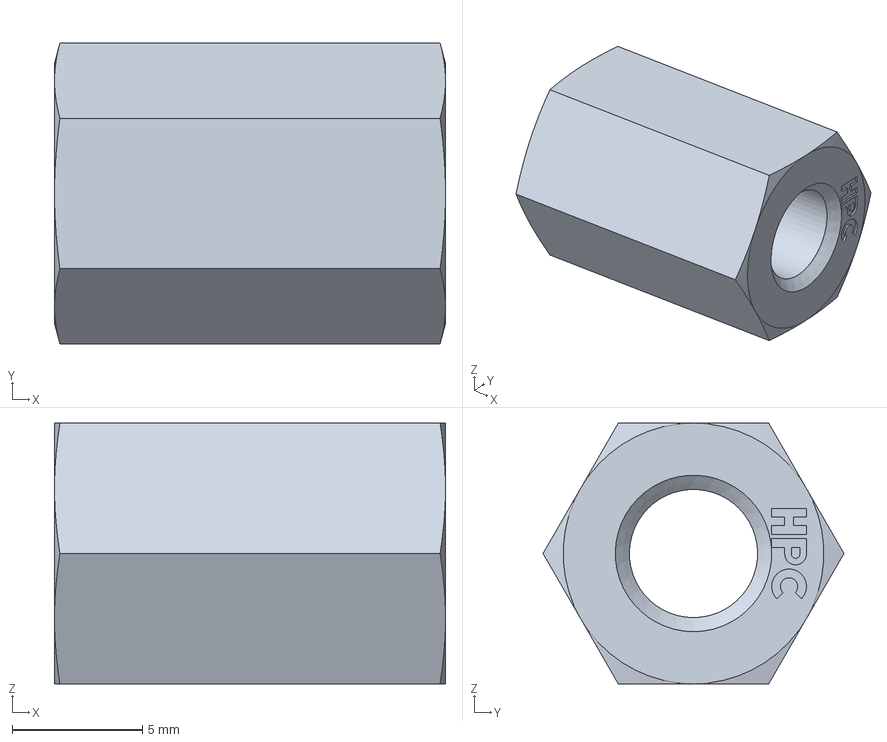
[picture p588: CAD file, 2018-11-08]
FR - Frame & Body/FR_A0300 (Pedal Assy)/Manchon taraudé/STEP-2.03/hpc_MHX6-15_SS_B.stp
15.0 x 11.5 x 10.0 mm
