EOSCogniton/STUF2019/FR - Frame & Body/FR_A0300 (Pedal Assy)/Mise en plan/2018/1 Usinage/FR_0300_001_BA.igs

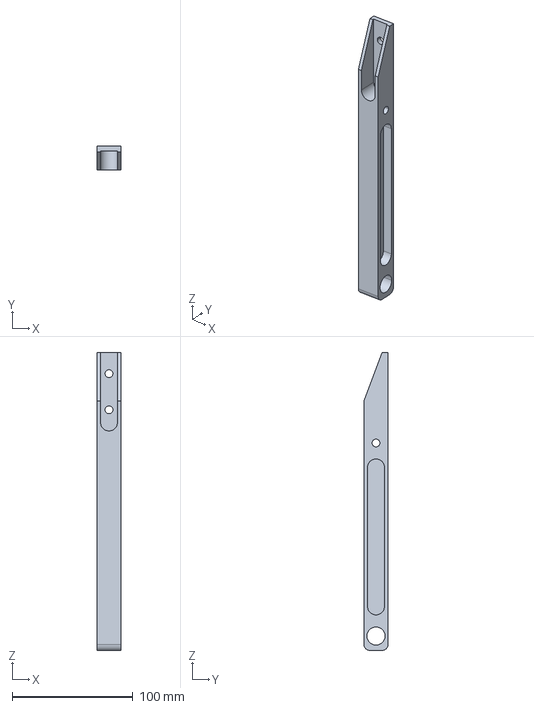
[picture p589: CAD file, 2018-09-20]
FR - Frame & Body/FR_A0300 (Pedal Assy)/Mise en plan/2018/1 Usinage/FR_0300_001_BA.igs
20.0 x 20.0 x 247.0 mm
