EOSCogniton/STUF2019/FR - Frame & Body/FR_A0300 (Pedal Assy)/Mise en plan/2018/2 Decoupe laser et pliage/FR_0300_003_BA.igs

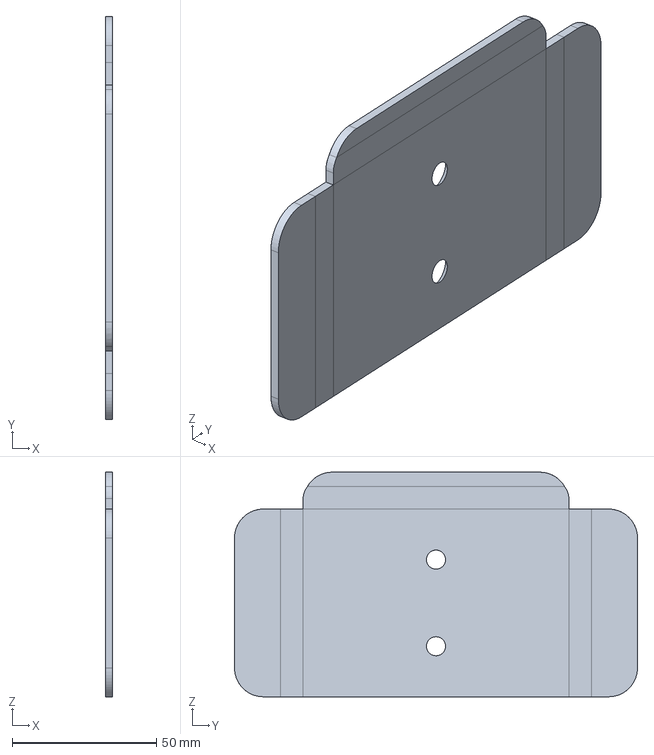
[picture p590: CAD file, 2018-09-20]
FR - Frame & Body/FR_A0300 (Pedal Assy)/Mise en plan/2018/2 Decoupe laser et pliage/FR_0300_003_BA.igs
2.50 x 139.5 x 77.8 mm
