EOSCogniton/STUF2019/FR - Frame & Body/FR_A0300 (Pedal Assy)/Vis à tête fraisée/STEP-2.03/HPC - FHC3-8_SS_B.stp

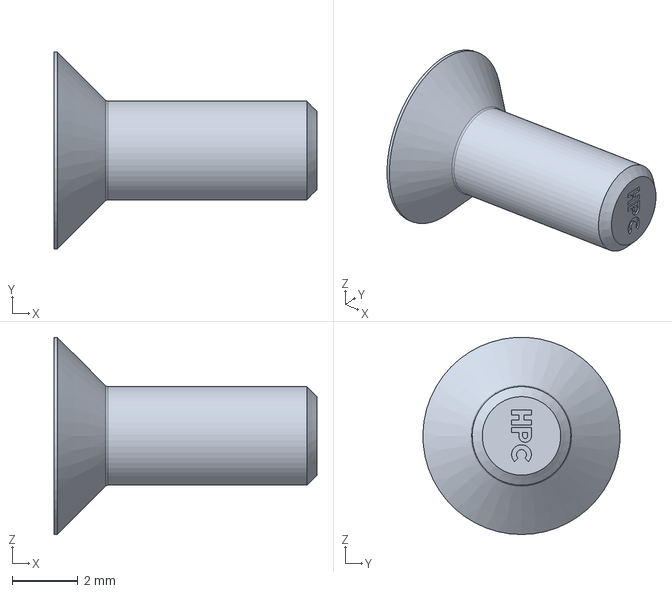
[picture p591: CAD file, 2018-11-08]
FR - Frame & Body/FR_A0300 (Pedal Assy)/Vis à tête fraisée/STEP-2.03/HPC - FHC3-8_SS_B.stp
8.00 x 6.00 x 5.99 mm
