EOSCogniton/STUF2019/FR - Frame & Body/FR_A0500 (Clutch activation system)/Impression 3D FR_0500_006 (Cable protector)/FR_0500_006_DB.stl

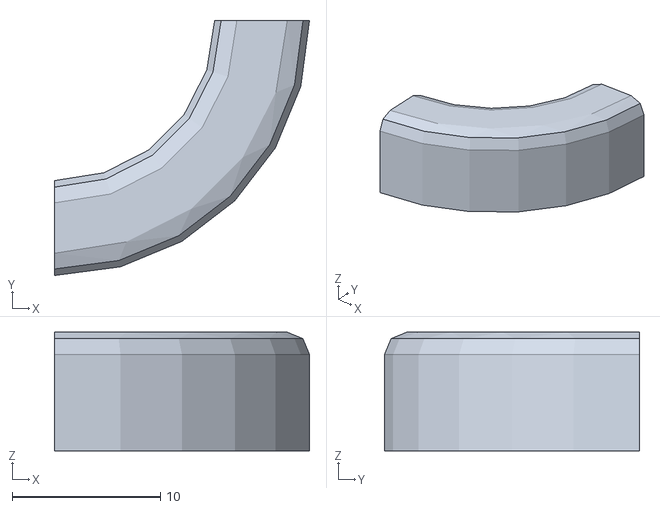
[picture p592: CAD file, 2019-04-02]
FR - Frame & Body/FR_A0500 (Clutch activation system)/Impression 3D FR_0500_006 (Cable protector)/FR_0500_006_DB.stl
17.2 x 17.2 x 8.00
