EOSCogniton/STUF2019/MS - Miscelleanous, Finish and Assembly/MS-A0300 (Head restraint)/Appuie_tete_v2_ABR.igs

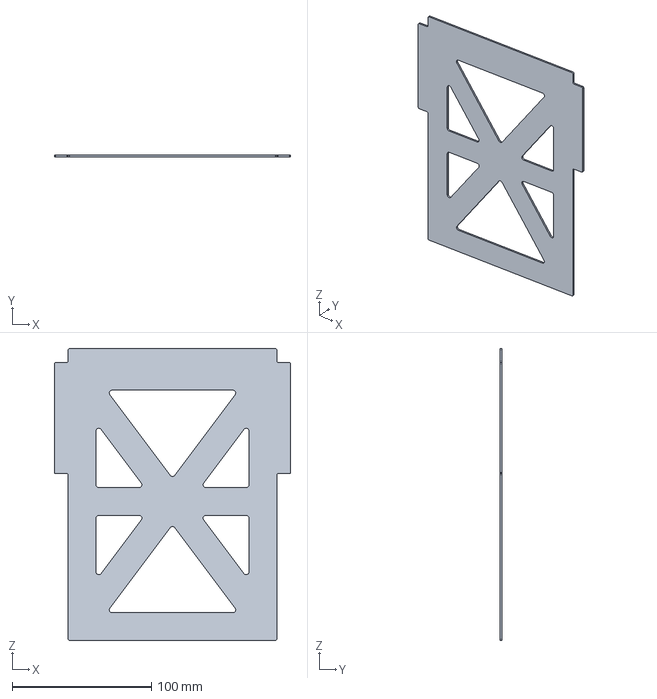
[picture p593: CAD file, 2019-06-27]
MS - Miscelleanous, Finish and Assembly/MS-A0300 (Head restraint)/Appuie_tete_v2_ABR.igs
170.0 x 1.50 x 210.0 mm
