EOSCogniton/STUF2019/ST - Steering/ST_A0400 (Steering wheel assembly)/MODEL_MSV1_STEP/Model MSV1.STEP

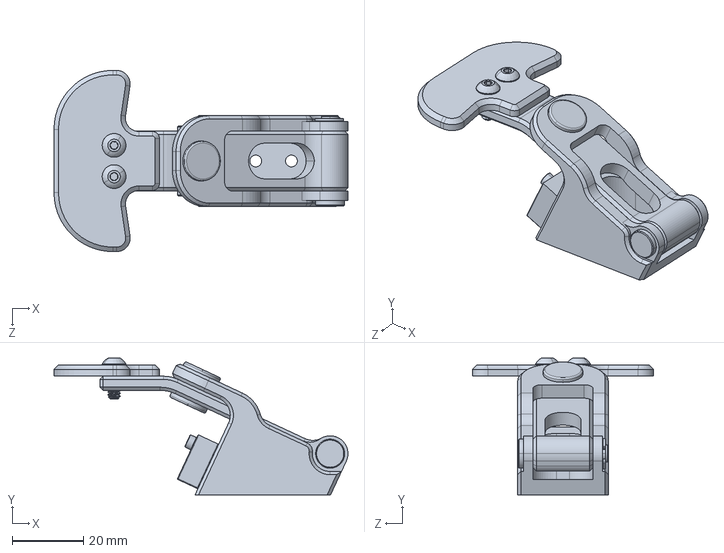
[picture p594: CAD file, 2018-12-16]
ST - Steering/ST_A0400 (Steering wheel assembly)/MODEL_MSV1_STEP/Model MSV1.STEP
82.4 x 38.3 x 50.8 mm
