EOSCogniton/STUF2019/SU - Suspension/12 - Chapes/Rectif chapes ap modif chassis/19M_4MM_STD_1.igs

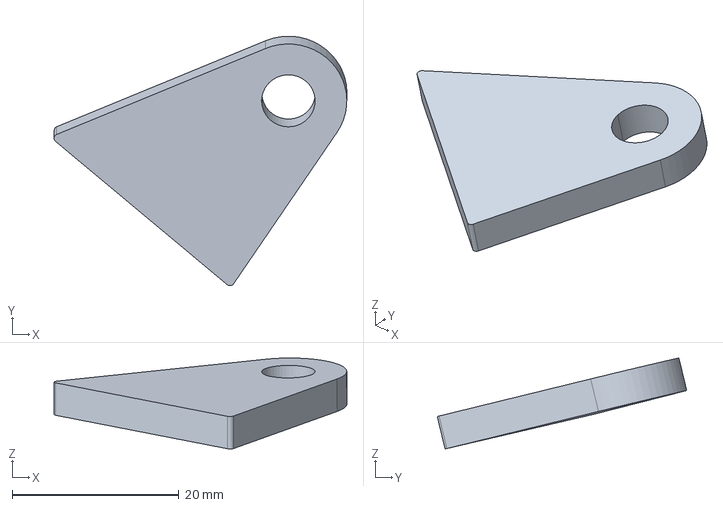
[picture p595: CAD file, 2019-01-21]
SU - Suspension/12 - Chapes/Rectif chapes ap modif chassis/19M_4MM_STD_1.igs
35.1 x 29.9 x 10.9 mm
