EOSCogniton/STUF2019/SU - Suspension/SU_A0600 (Front Bell Crank Assy)/basculeur avant.igs

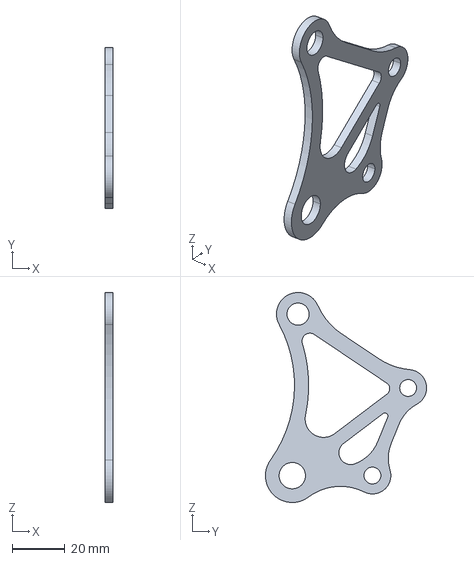
[picture p596: CAD file, 2019-04-07]
SU - Suspension/SU_A0600 (Front Bell Crank Assy)/basculeur avant.igs
3.00 x 61.2 x 79.7 mm
