EOSCogniton/STUF2019/SU - Suspension/SU_A1000 (Front Upright Assy)/MEP/CORR-01 (Entretoise Direction).igs

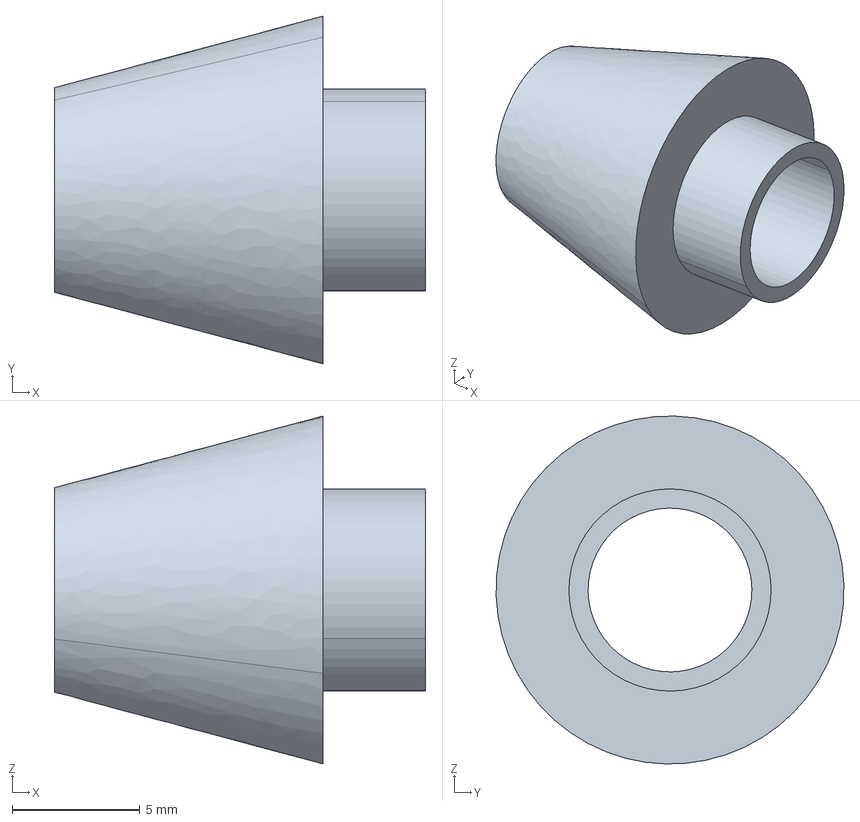
[picture p597: CAD file, 2019-04-02]
SU - Suspension/SU_A1000 (Front Upright Assy)/MEP/CORR-01 (Entretoise Direction).igs
14.5 x 13.6 x 13.6 mm
