EOSCogniton/STUF2019/visserie/M12/rondelle_M12.stp

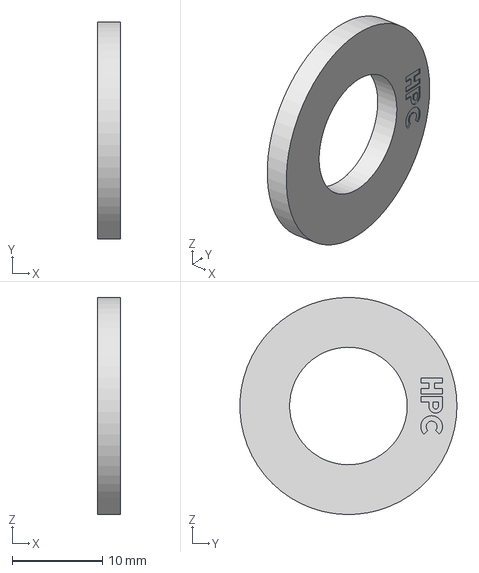
[picture p598: CAD file, 2018-05-30]
visserie/M12/rondelle_M12.stp
2.50 x 24.0 x 24.0 mm
