EOSCogniton/STUF2019/visserie/M4/HPC_HPCCHC412B/HPC_-_CHC4-12_B_2_14.stp

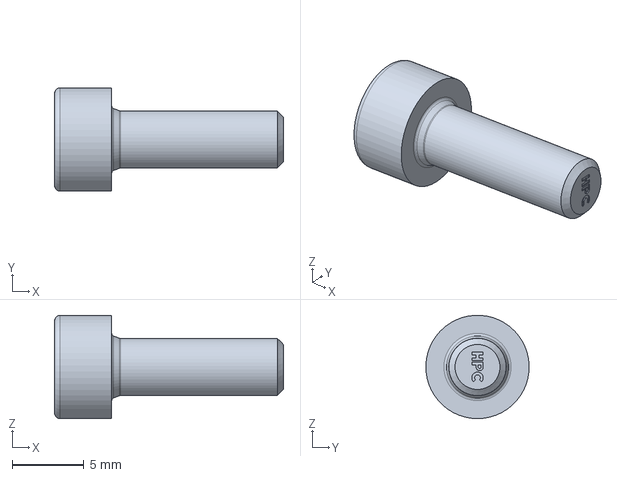
[picture p599: CAD file, 2018-05-30]
visserie/M4/HPC_HPCCHC412B/HPC_-_CHC4-12_B_2_14.stp
16.0 x 7.22 x 7.21 mm
