EOSCogniton/STUF2019/visserie/M6/Epaulé/31-520-6-40.stp

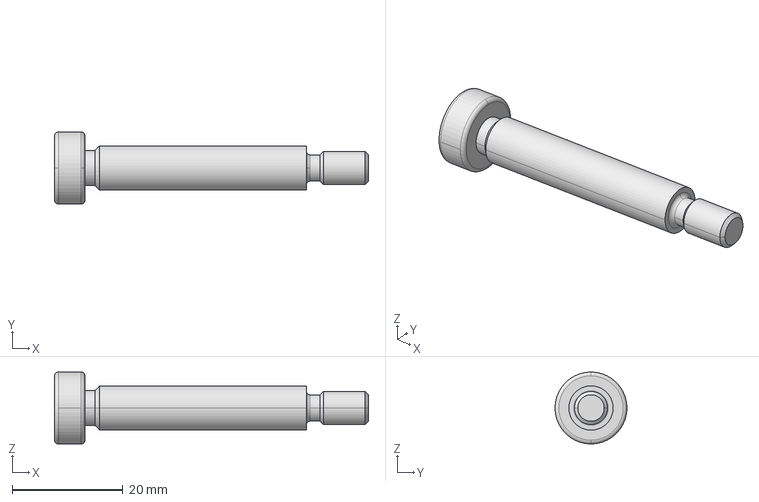
[picture p600: CAD file, 2018-05-30]
visserie/M6/Epaulé/31-520-6-40.stp
56.8 x 13.0 x 13.0 mm
