EOSCogniton/STUF2019/visserie/M6/vis_chc_M6_30.stp

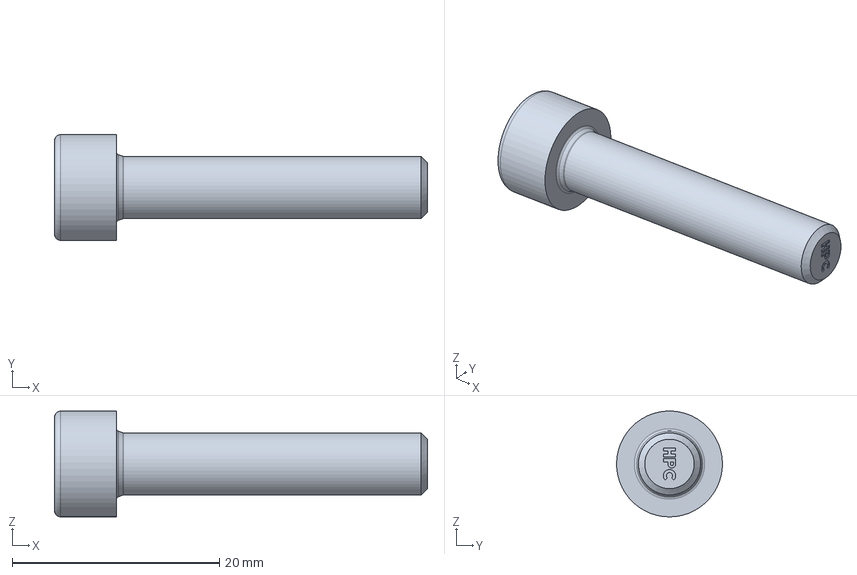
[picture p601: CAD file, 2018-05-30]
visserie/M6/vis_chc_M6_30.stp
36.0 x 10.2 x 10.2 mm
