EOSCogniton/STUF2019/visserie/M8/ecrou_M8_nilstop.stp

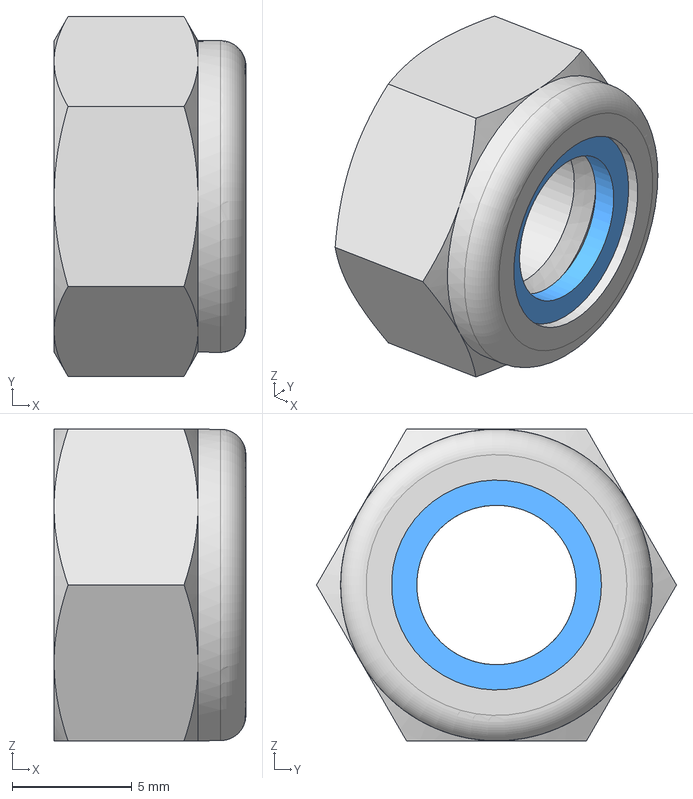
[picture p602: CAD file, 2018-05-30]
visserie/M8/ecrou_M8_nilstop.stp
8.00 x 15.0 x 13.0 mm
