EOSCogniton/STUF2019/visserie/M8/nouveau dossier/HPC_HPCFHC816SSB/HPC_-_FHC8-16_SS_B_2_14.stp

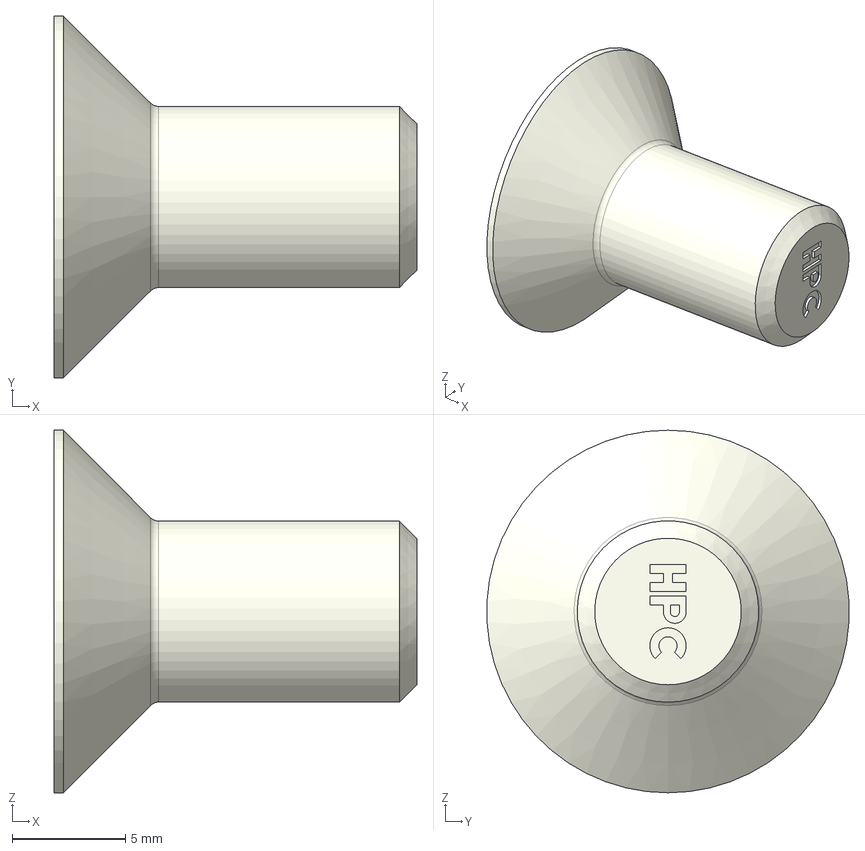
[picture p603: CAD file, 2018-05-30]
visserie/M8/nouveau dossier/HPC_HPCFHC816SSB/HPC_-_FHC8-16_SS_B_2_14.stp
16.0 x 16.0 x 16.0 mm
