EOSCogniton/STUF2019/AA - Mise en plan/AlpenTech/STEP/Insert roue avant superieur.stp

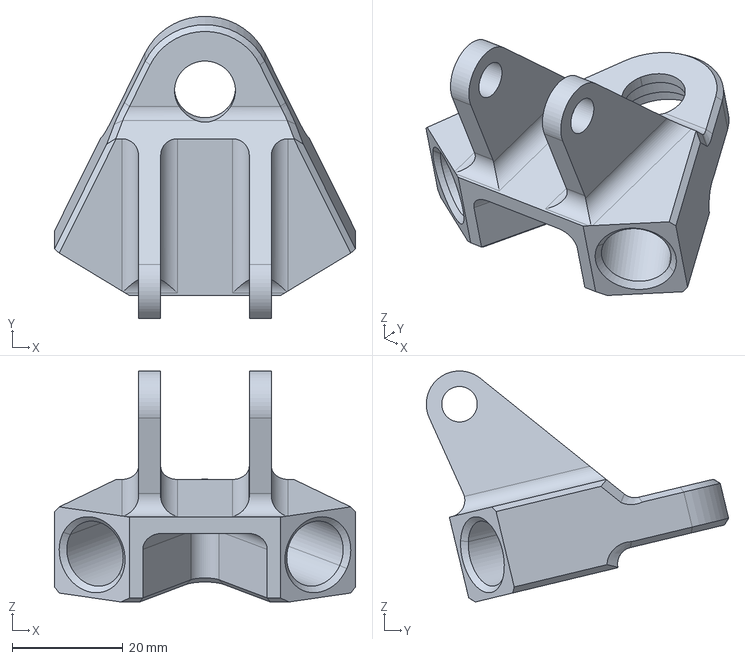
[picture p604: CAD file, 2019-01-15]
AA - Mise en plan/AlpenTech/STEP/Insert roue avant superieur.stp
54.4 x 54.6 x 41.7 mm
