EOSCogniton/STUF2019/AA - Mise en plan/ARRK/EN_0400_010_AA_bride.stp

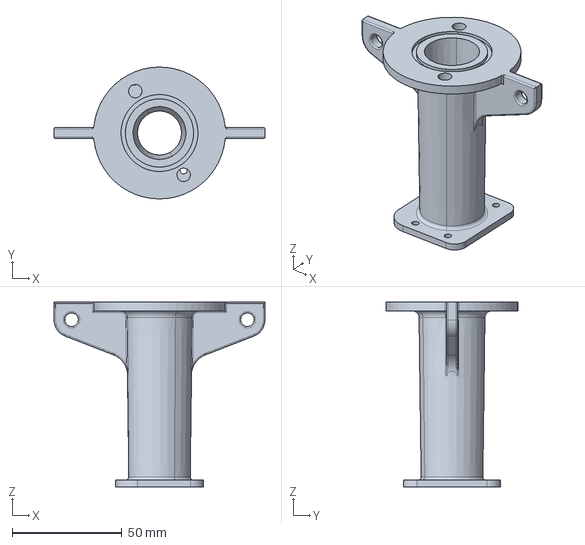
[picture p605: CAD file, 2018-12-18]
AA - Mise en plan/ARRK/EN_0400_010_AA_bride.stp
96.0 x 60.0 x 84.0 mm
