EOSCogniton/STUF2019/AA - Mise en plan/Boisard/Plans essais Boisard/MEP essais collage rotules/EntretoiseRotule.igs

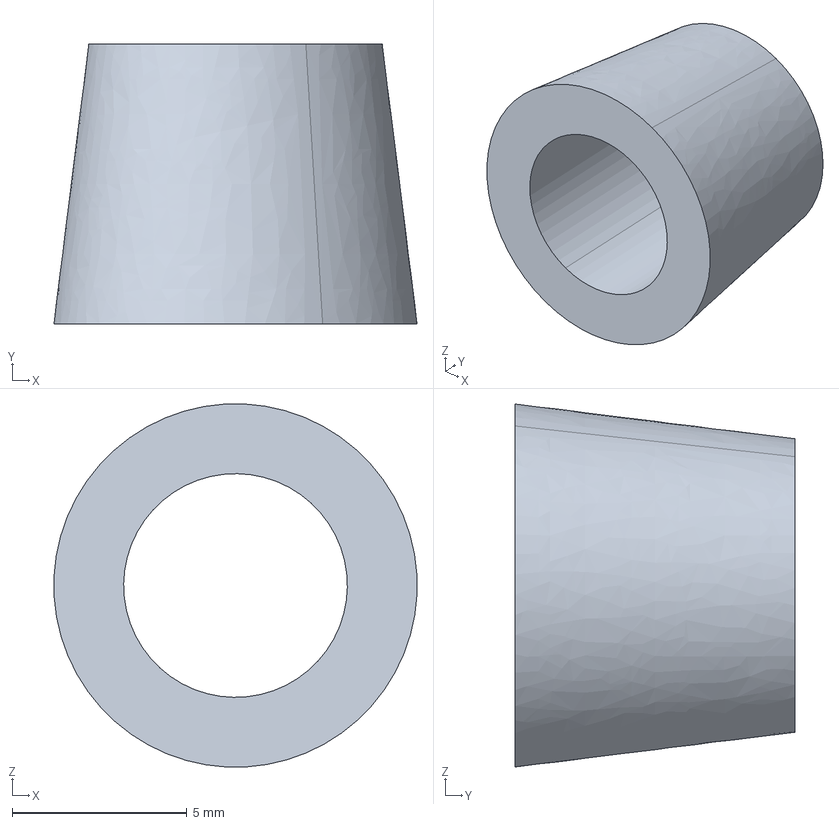
[picture p606: CAD file, 2018-11-07]
AA - Mise en plan/Boisard/Plans essais Boisard/MEP essais collage rotules/EntretoiseRotule.igs
10.4 x 8.00 x 10.4 mm
