EOSCogniton/STUF2019/AA - Mise en plan/Boisard/Plans essais Boisard/MEP essais traction/19B_TRACTION_04 (insert alu type 2).igs

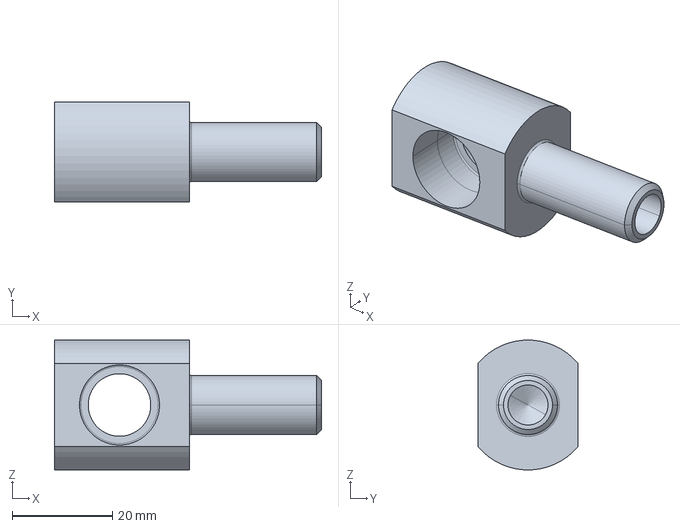
[picture p607: CAD file, 2018-11-07]
AA - Mise en plan/Boisard/Plans essais Boisard/MEP essais traction/19B_TRACTION_04 (insert alu type 2).igs
53.4 x 20.0 x 26.0 mm
