EOSCogniton/STUF2019/AA - Mise en plan/La Mache Laser/Acier/Acier 1,5mm S235/IGS acier 1,5mm S235/19M_FR_0400_002 (Chape Fond Plat).igs

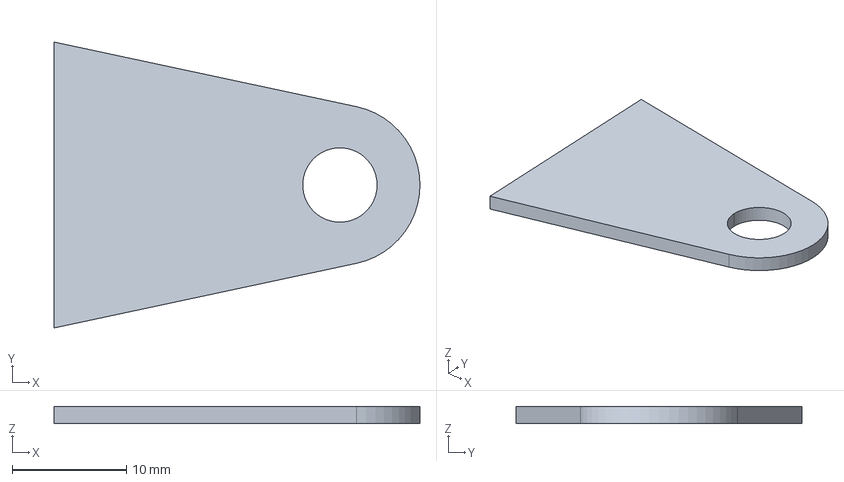
[picture p608: CAD file, 2019-02-05]
AA - Mise en plan/La Mache Laser/Acier/Acier 1,5mm S235/IGS acier 1,5mm S235/19M_FR_0400_002 (Chape Fond Plat).igs
32.0 x 25.0 x 1.50 mm
