EOSCogniton/STUF2019/AA - Mise en plan/La Mache Laser/Aluminium/Aluminium 2017 T4/Aluminium 2.5mm 2017 T4/IGS aluminium 2017 T4 2.5mm/19M_FR_0300_009 (Support bouton arret urgence).igs

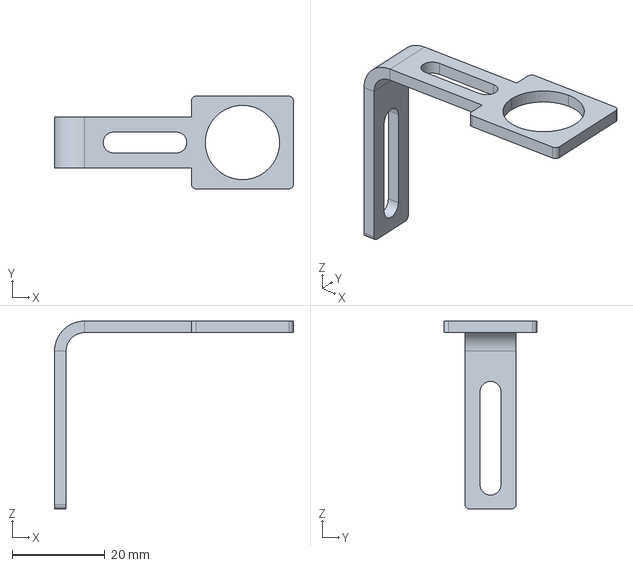
[picture p610: CAD file, 2019-02-24]
AA - Mise en plan/La Mache Laser/Aluminium/Aluminium 2017 T4/Aluminium 2.5mm 2017 T4/IGS aluminium 2017 T4 2.5mm/19M_FR_0300_009 (Support bouton arret urgence).igs
51.5 x 20.0 x 40.5 mm
