EOSCogniton/STUF2019/AA - Mise en plan/La Mache Laser/Aluminium/Aluminium 2017A (AU4G)/Aluminium 1mm 2017A/IGS aluminium 1mm 2017A/19M_MS_0100_001 (PF-Bas) 2.0.igs

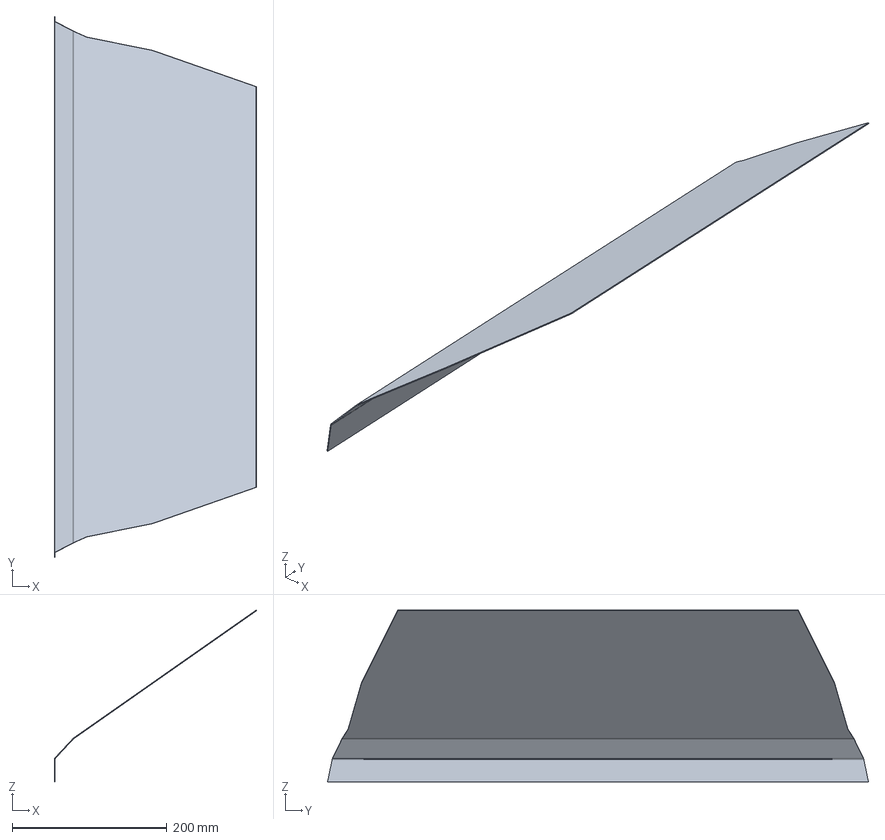
[picture p611: CAD file, 2019-02-24]
AA - Mise en plan/La Mache Laser/Aluminium/Aluminium 2017A (AU4G)/Aluminium 1mm 2017A/IGS aluminium 1mm 2017A/19M_MS_0100_001 (PF-Bas) 2.0.igs
261.4 x 699.0 x 222.1 mm
