EOSCogniton/STUF2019/AA - Mise en plan/La Mache Laser/Aluminium/Aluminium 2017A (AU4G)/Aluminium 2.5mm 2017A/IGS aluminium 2.5mm 2017A/19M_EN_0400_003 (Arret guillotine droit).igs

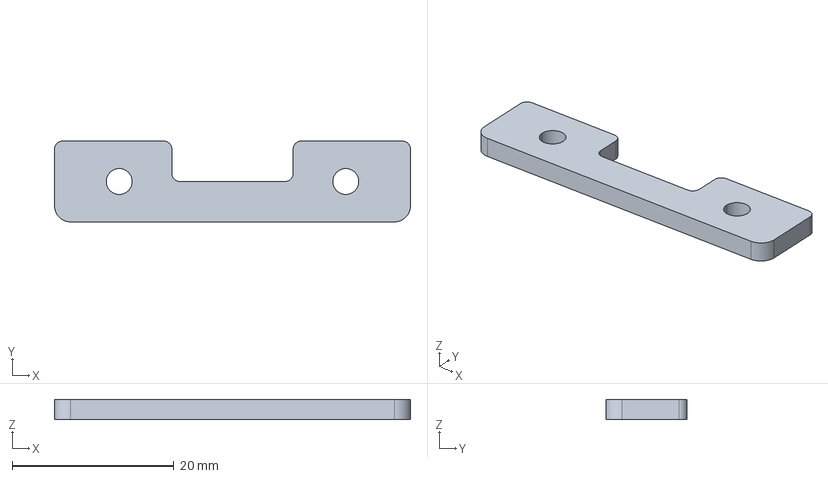
[picture p612: CAD file, 2019-02-24]
AA - Mise en plan/La Mache Laser/Aluminium/Aluminium 2017A (AU4G)/Aluminium 2.5mm 2017A/IGS aluminium 2.5mm 2017A/19M_EN_0400_003 (Arret guillotine droit).igs
44.0 x 10.0 x 2.50 mm
