EOSCogniton/STUF2019/AA - Mise en plan/La Mache Laser/Aluminium/Aluminium 5754/Aluminium 2,5mm 5754/IGS aluminium 2,5mm 5754/19M_EN_0101_001 (Carter d'huile).igs

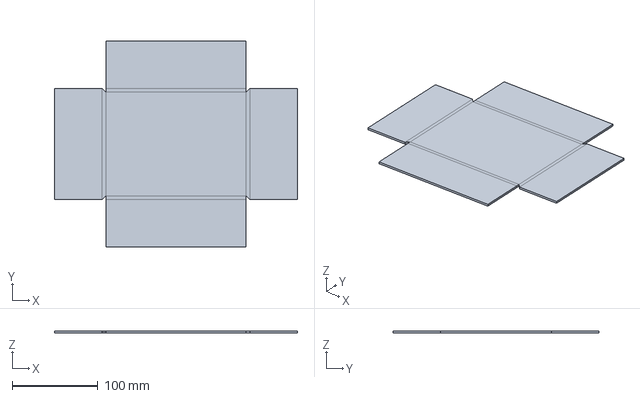
[picture p613: CAD file, 2018-12-15]
AA - Mise en plan/La Mache Laser/Aluminium/Aluminium 5754/Aluminium 2,5mm 5754/IGS aluminium 2,5mm 5754/19M_EN_0101_001 (Carter d'huile).igs
282.7 x 240.1 x 2.50 mm
