EOSCogniton/STUF2019/AA - Mise en plan/La Mache Laser/Chainshield/chainshieldv2.igs

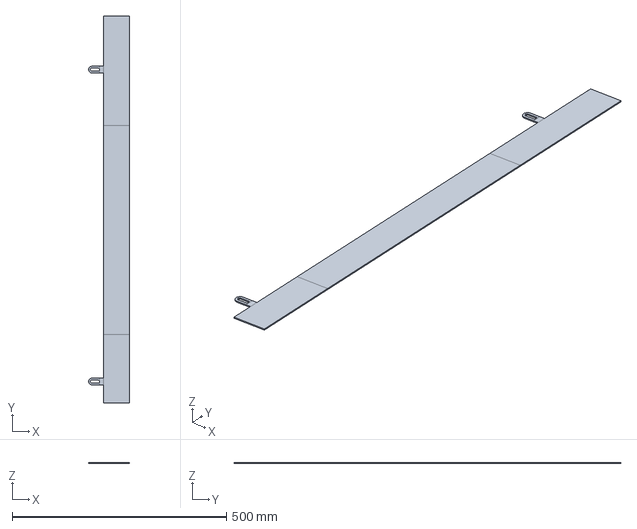
[picture p614: CAD file, 2019-06-16]
AA - Mise en plan/La Mache Laser/Chainshield/chainshieldv2.igs
95.0 x 902.5 x 2.00 mm
