EOSCogniton/STUF2019/AA - Mise en plan/La Mache Productique/Acier 35NCD16/IGS acier 35NCD16/19M_FR_0300_027_BA (Entretoise exterieure pedale de frein).igs

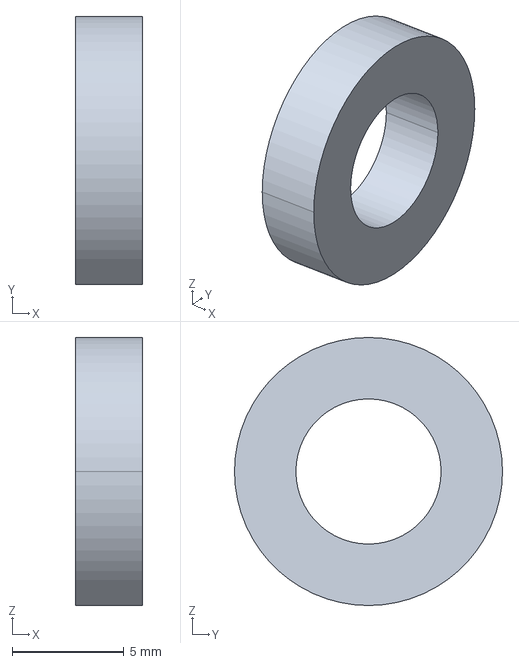
[picture p615: CAD file, 2018-12-11]
AA - Mise en plan/La Mache Productique/Acier 35NCD16/IGS acier 35NCD16/19M_FR_0300_027_BA (Entretoise exterieure pedale de frein).igs
3.00 x 12.0 x 12.0 mm
