EOSCogniton/STUF2019/AA - Mise en plan/La Mache Productique/Acier S355JR/IGS acier S355JR/19M_FR_0500_003 (Tube Fixation).igs

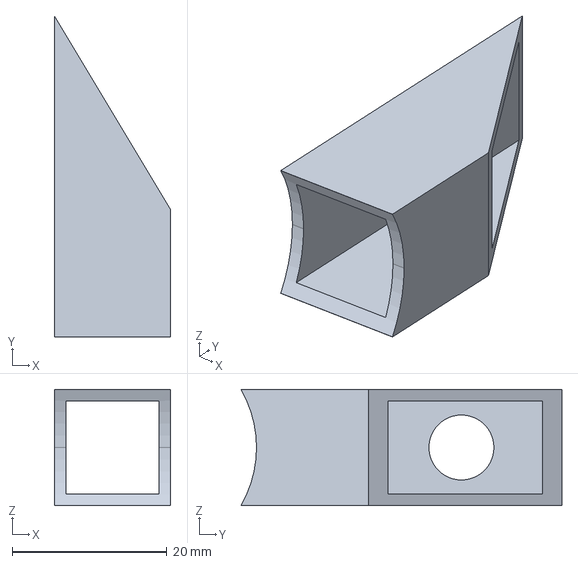
[picture p616: CAD file, 2018-12-10]
AA - Mise en plan/La Mache Productique/Acier S355JR/IGS acier S355JR/19M_FR_0500_003 (Tube Fixation).igs
15.0 x 41.5 x 15.0 mm
