EOSCogniton/STUF2019/AA - Mise en plan/La Mache Productique/Aluminium 2017A T4/IGS 2017A T43/19M_FR_0300_002_BA (Pedale A).igs

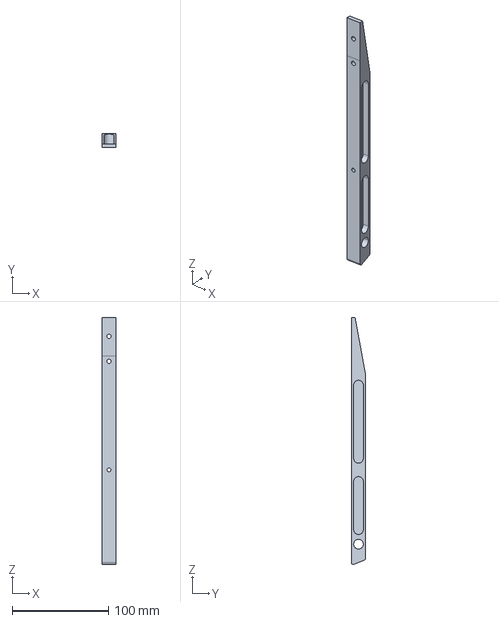
[picture p617: CAD file, 2019-01-08]
AA - Mise en plan/La Mache Productique/Aluminium 2017A T4/IGS 2017A T43/19M_FR_0300_002_BA (Pedale A).igs
15.0 x 15.0 x 256.0 mm
