EOSCogniton/STUF2019/AA - Mise en plan/La Mache Productique/Aluminium 2017A/IGS 2017A/19M_ST_0100_003 (Half moon).igs

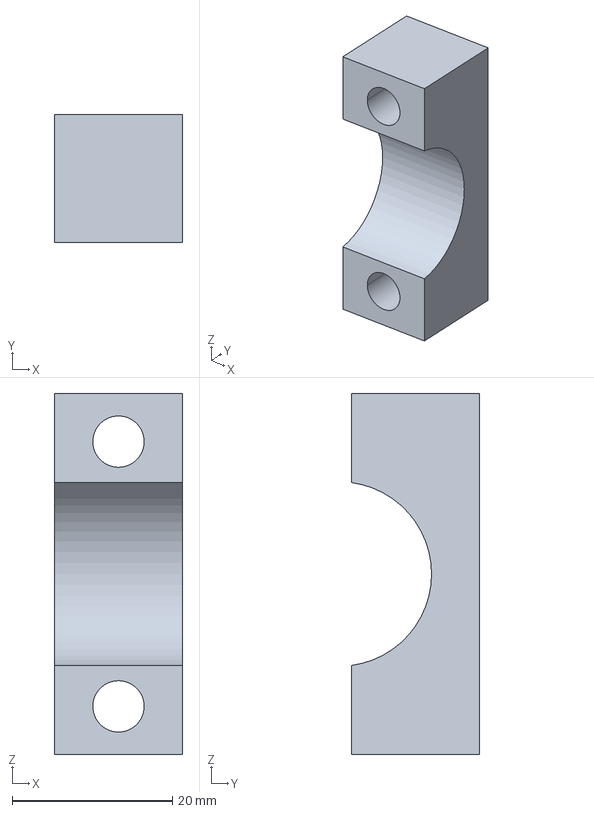
[picture p618: CAD file, 2018-12-17]
AA - Mise en plan/La Mache Productique/Aluminium 2017A/IGS 2017A/19M_ST_0100_003 (Half moon).igs
16.0 x 16.0 x 45.0 mm
