EOSCogniton/STUF2019/AA - Mise en plan/La Mache Productique/Delrin/IGS Delrin/19M_EN_0901_005 (Exc droit).igs

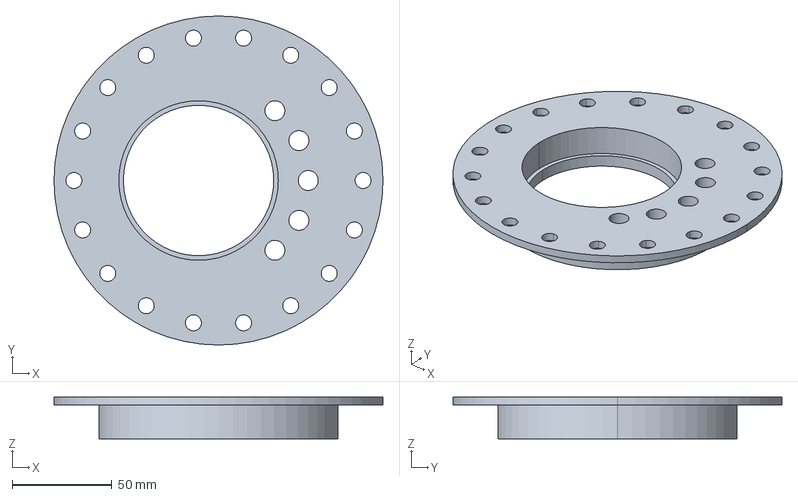
[picture p619: CAD file, 2018-12-18]
AA - Mise en plan/La Mache Productique/Delrin/IGS Delrin/19M_EN_0901_005 (Exc droit).igs
165.0 x 165.0 x 21.0 mm
