EOSCogniton/STUF2019/EL - Electrical/Autre/Tableau de bord/Tableau Optimus/graphisme/Sérigraphies kiCAD/graphisme echelle corrige.dxf

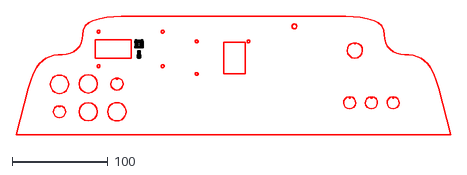
[picture p621: CAD file, 2018-11-11]
EL - Electrical/Autre/Tableau de bord/Tableau Optimus/graphisme/Sérigraphies kiCAD/graphisme echelle corrige.dxf
452.6 x 123.4
