EOSCogniton/STUF2019/EL - Electrical/Autre/Tableau de bord/Tableau vulcanix/Découpe laser/dxf2004.dxf

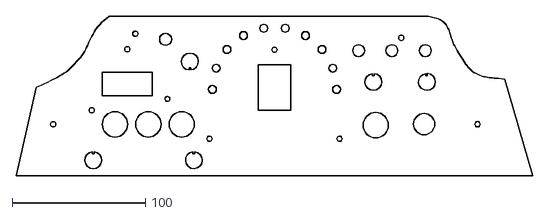
[picture p622: CAD file, 2018-09-20]
EL - Electrical/Autre/Tableau de bord/Tableau vulcanix/Découpe laser/dxf2004.dxf
386.7 x 119.6
