EOSCogniton/STUF2019/EN - Engine & Powertrain/EN_A0400 (Throttle body)/Fablab/EN_0400_001_AA_bas_guillotine.stl

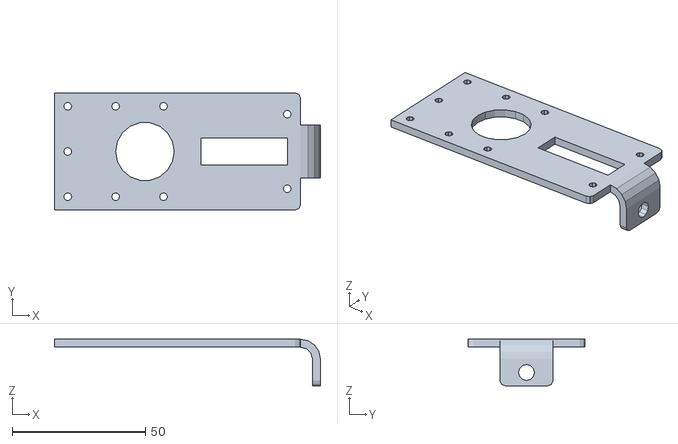
[picture p623: CAD file, 2018-11-12]
EN - Engine & Powertrain/EN_A0400 (Throttle body)/Fablab/EN_0400_001_AA_bas_guillotine.stl
100.0 x 44.0 x 17.5
