EOSCogniton/STUF2019/EN - Engine & Powertrain/EN_A0500 (Fuel tank assembly)/mise en plan/19M_EN_0500_0015(GABARIT)/gabarit4.igs

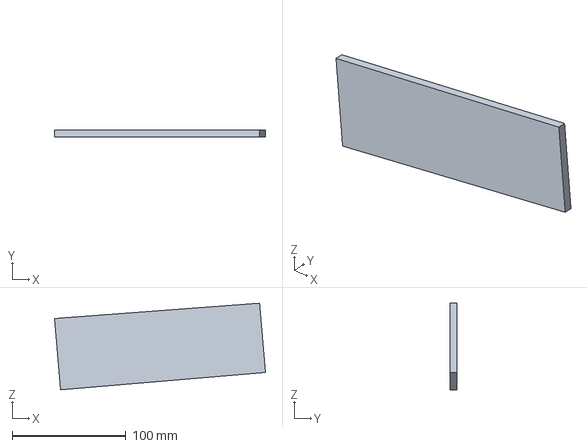
[picture p624: CAD file, 2019-01-31]
EN - Engine & Powertrain/EN_A0500 (Fuel tank assembly)/mise en plan/19M_EN_0500_0015(GABARIT)/gabarit4.igs
185.2 x 6.00 x 76.0 mm
