EOSCogniton/STUF2019/FR - Frame & Body/FR_A0100 (Frame)/Crise chassis 2/Shape_640.stp

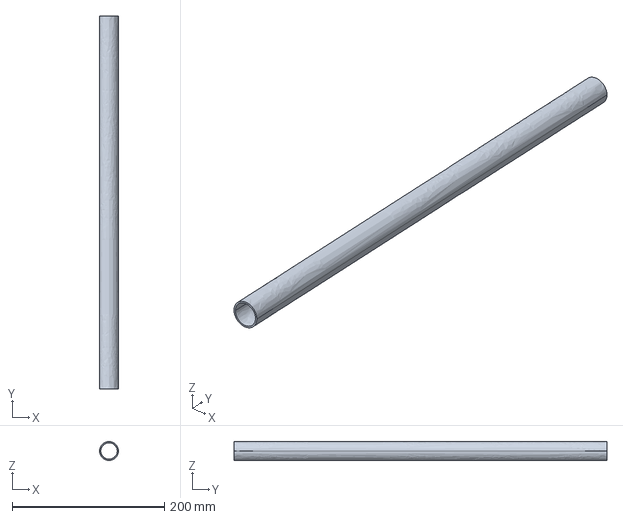
[picture p625: CAD file, 2019-05-06]
FR - Frame & Body/FR_A0100 (Frame)/Crise chassis 2/Shape_640.stp
25.0 x 490.4 x 25.0 mm
