EOSCogniton/STUF2019/FR - Frame & Body/FR_A0100 (Frame)/pour découverte ansys/tube suspensions.igs

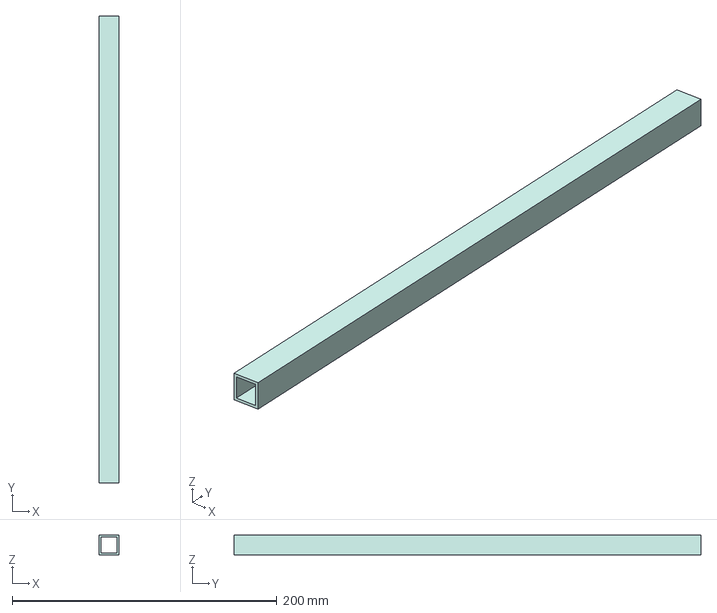
[picture p626: CAD file, 2018-11-12]
FR - Frame & Body/FR_A0100 (Frame)/pour découverte ansys/tube suspensions.igs
15.0 x 352.7 x 15.0 mm
