EOSCogniton/STUF2019/FR - Frame & Body/FR_A0100 (Frame)/Production/Crise MHBS/Symmetry of Shape_740.stp

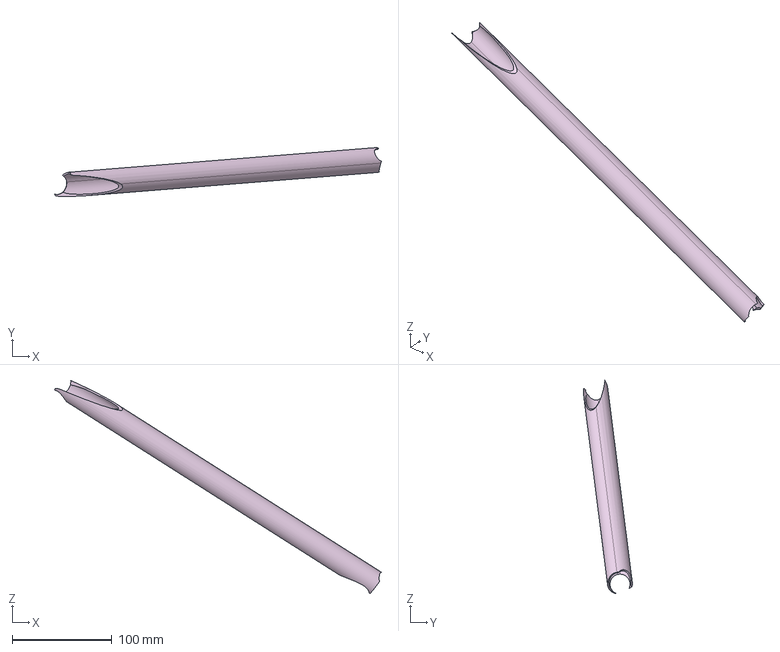
[picture p627: CAD file, 2019-02-27]
FR - Frame & Body/FR_A0100 (Frame)/Production/Crise MHBS/Symmetry of Shape_740.stp
328.1 x 49.0 x 213.8 mm
