EOSCogniton/STUF2019/FR - Frame & Body/FR_A0100 (Frame)/Production/Tubes step réparés/12.stp

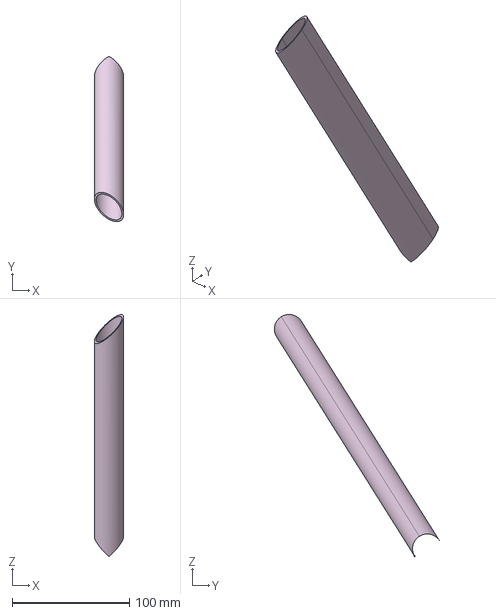
[picture p628: CAD file, 2019-01-08]
FR - Frame & Body/FR_A0100 (Frame)/Production/Tubes step réparés/12.stp
25.0 x 140.7 x 206.1 mm
