EOSCogniton/STUF2019/FR - Frame & Body/FR_A0100 (Frame)/Production/Tubes step/401.stp

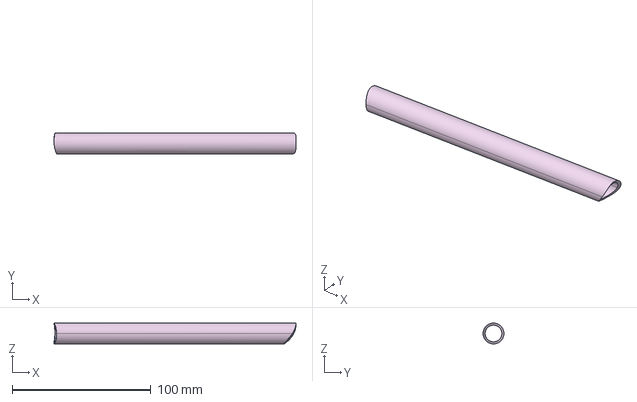
[picture p629: CAD file, 2019-01-08]
FR - Frame & Body/FR_A0100 (Frame)/Production/Tubes step/401.stp
174.2 x 15.0 x 15.0 mm
