EOSCogniton/STUF2019/FR - Frame & Body/FR_A0300 (Pedal Assy)/Maitre cylindre beringer/MC12.7_LIBRE_STP.stp

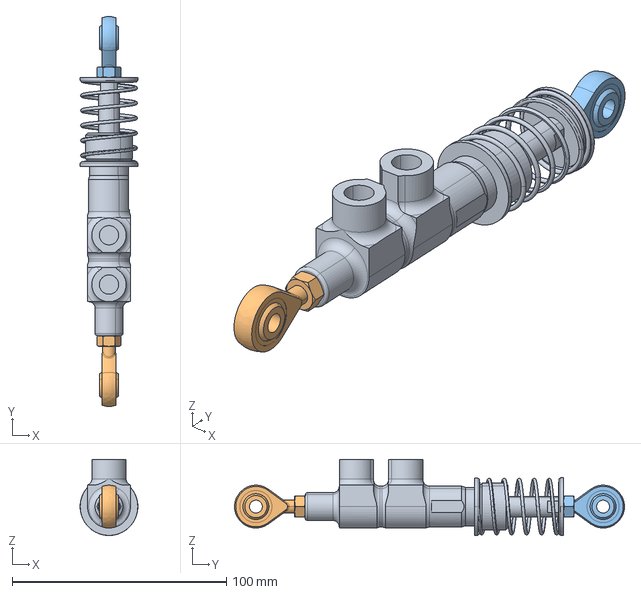
[picture p630: CAD file, 2018-11-07]
FR - Frame & Body/FR_A0300 (Pedal Assy)/Maitre cylindre beringer/MC12.7_LIBRE_STP.stp
27.0 x 182.0 x 35.5 mm
