EOSCogniton/STUF2019/FR - Frame & Body/FR_A0300 (Pedal Assy)/Mise en plan/2018/1 Usinage/FR_0300_000_BA.igs

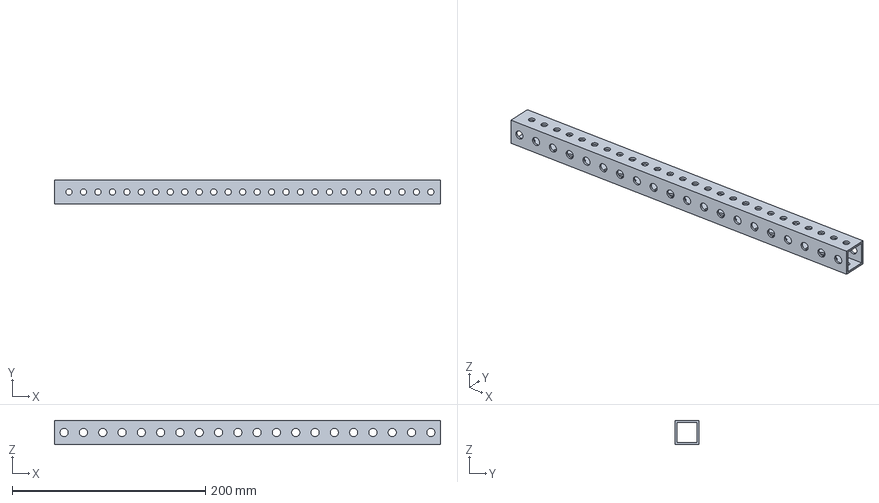
[picture p631: CAD file, 2018-09-20]
FR - Frame & Body/FR_A0300 (Pedal Assy)/Mise en plan/2018/1 Usinage/FR_0300_000_BA.igs
400.0 x 25.0 x 25.0 mm
