EOSCogniton/STUF2019/FR - Frame & Body/FR_A0300 (Pedal Assy)/Mise en plan/2018/2 Decoupe laser et pliage/FR_0300_009_BA.igs

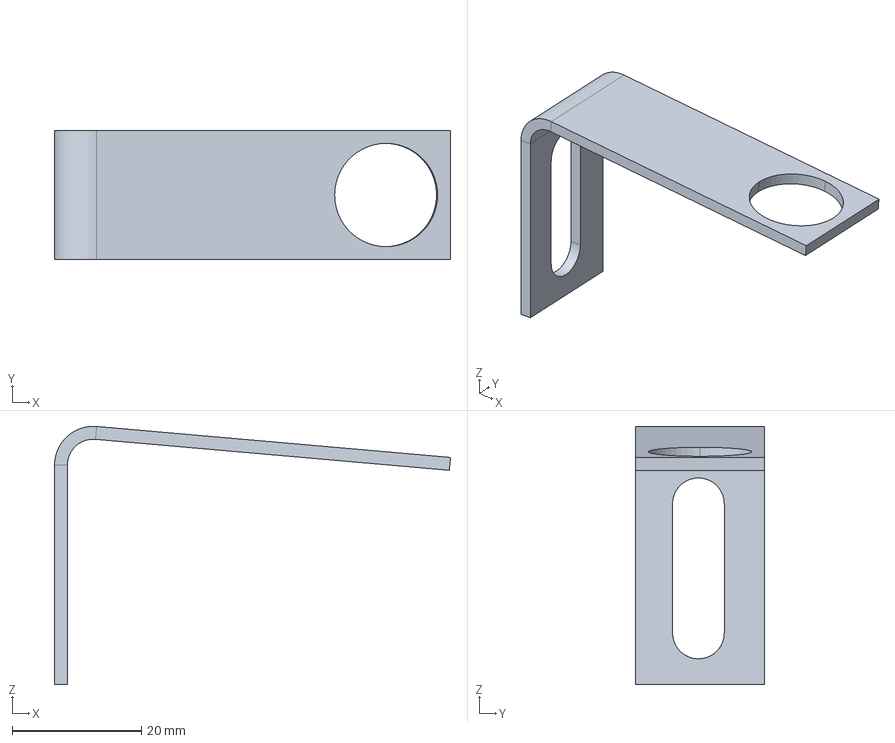
[picture p632: CAD file, 2018-09-20]
FR - Frame & Body/FR_A0300 (Pedal Assy)/Mise en plan/2018/2 Decoupe laser et pliage/FR_0300_009_BA.igs
61.3 x 20.0 x 40.0 mm
