EOSCogniton/STUF2019/SU - Suspension/12 - Chapes/Rectif chapes ap modif chassis/19M_4MM_STD_3.igs

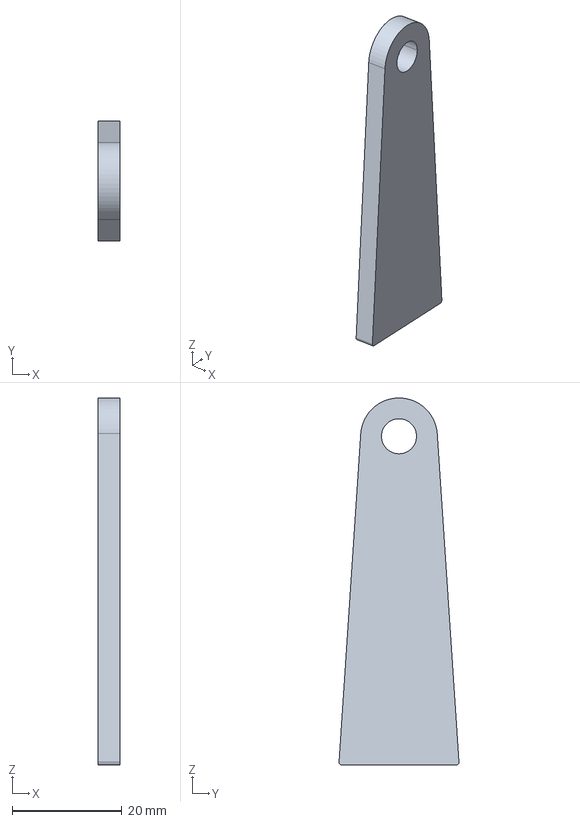
[picture p633: CAD file, 2019-01-21]
SU - Suspension/12 - Chapes/Rectif chapes ap modif chassis/19M_4MM_STD_3.igs
4.00 x 21.9 x 67.0 mm
