EOSCogniton/STUF2019/visserie/M12/vis_M12_80.stp

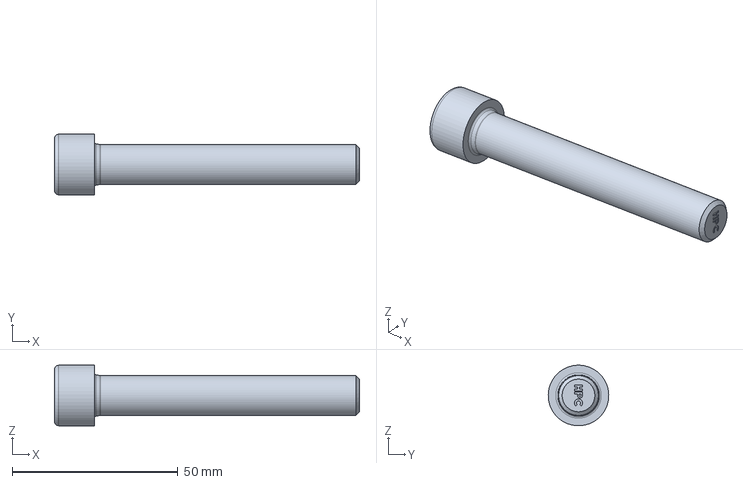
[picture p634: CAD file, 2018-05-30]
visserie/M12/vis_M12_80.stp
92.0 x 18.3 x 18.3 mm
