EOSCogniton/STUF2019/visserie/M6/vis_chc_M6_20.stp

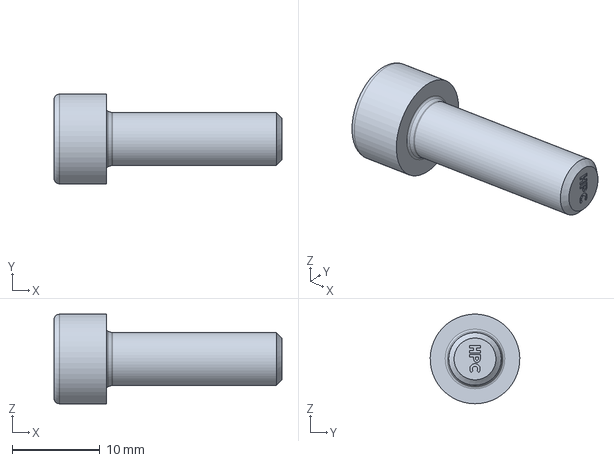
[picture p635: CAD file, 2018-05-30]
visserie/M6/vis_chc_M6_20.stp
26.0 x 10.2 x 10.2 mm
