EOSCogniton/STUF2019/visserie/M8/rondelle_M8.stp

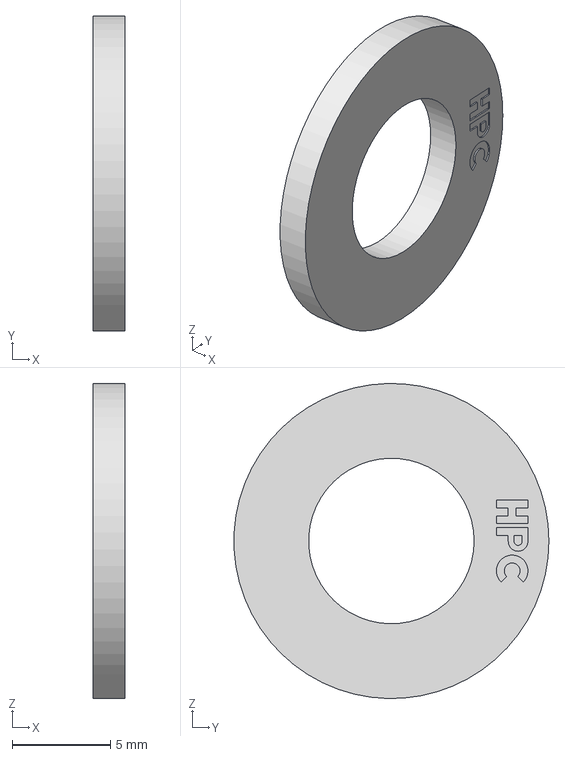
[picture p636: CAD file, 2018-05-30]
visserie/M8/rondelle_M8.stp
1.60 x 16.0 x 16.0 mm
