EOSCogniton/STUF2019/AA - Mise en plan/AlpenTech/STEP/Insert roue arriere inferieur.stp

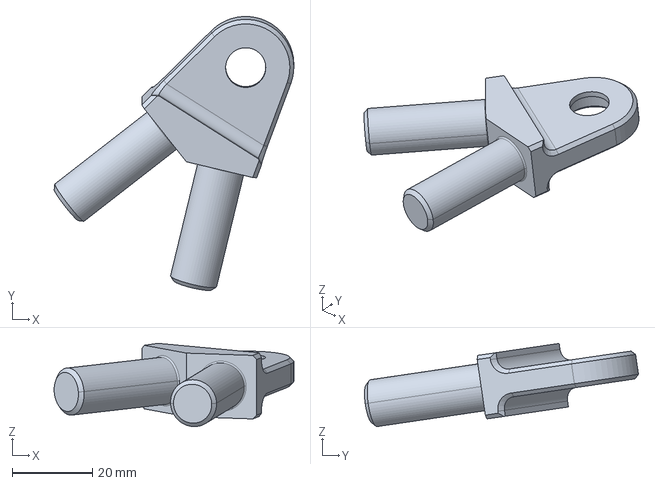
[picture p637: CAD file, 2019-01-15]
AA - Mise en plan/AlpenTech/STEP/Insert roue arriere inferieur.stp
59.7 x 68.3 x 20.7 mm
