EOSCogniton/STUF2019/AA - Mise en plan/ARRK/EN_0400_007_AA_convergeant.stp

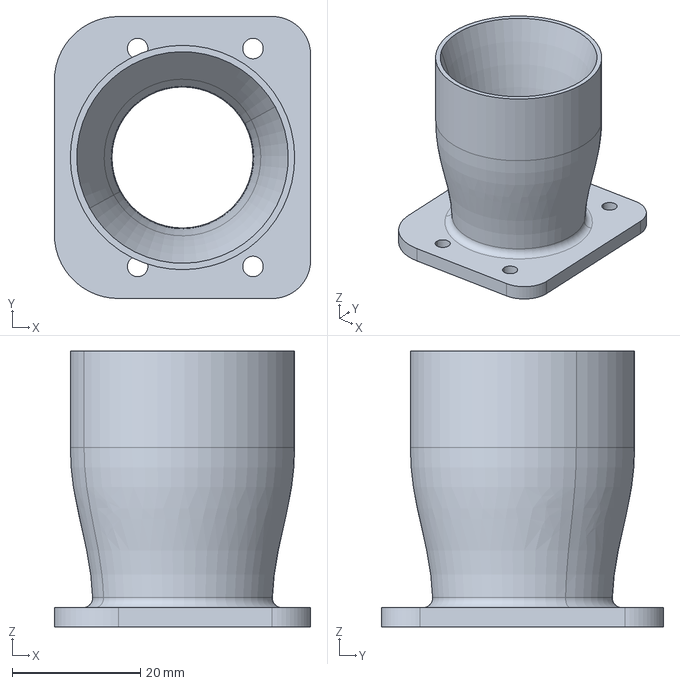
[picture p638: CAD file, 2018-12-18]
AA - Mise en plan/ARRK/EN_0400_007_AA_convergeant.stp
40.0 x 44.0 x 43.0 mm
