EOSCogniton/STUF2019/AA - Mise en plan/Boisard/Plans essais Boisard/MEP essais collage rotules/TrouRotule.igs

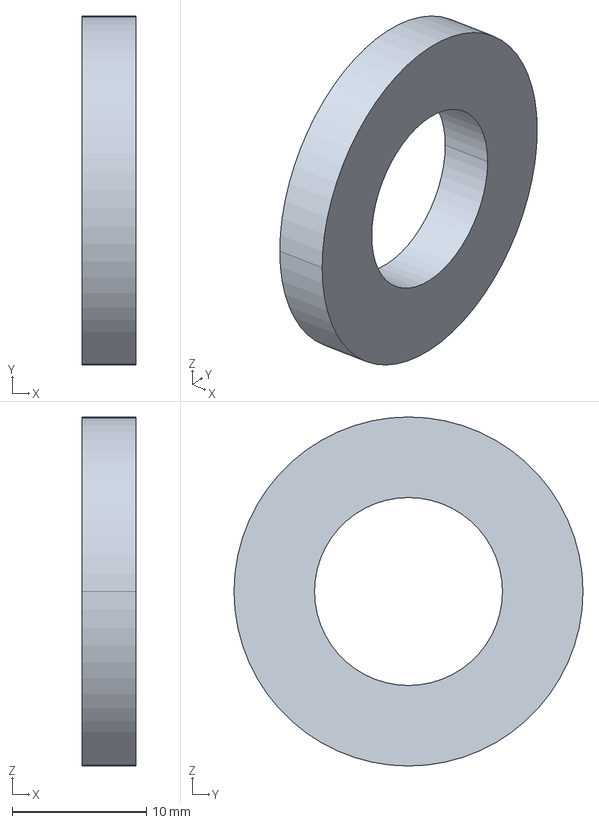
[picture p639: CAD file, 2018-11-07]
AA - Mise en plan/Boisard/Plans essais Boisard/MEP essais collage rotules/TrouRotule.igs
4.00 x 26.0 x 26.0 mm
