EOSCogniton/STUF2019/AA - Mise en plan/Boisard/Plans essais Boisard/MEP essais traction/19B_TRACTION_03 (entretoise).igs

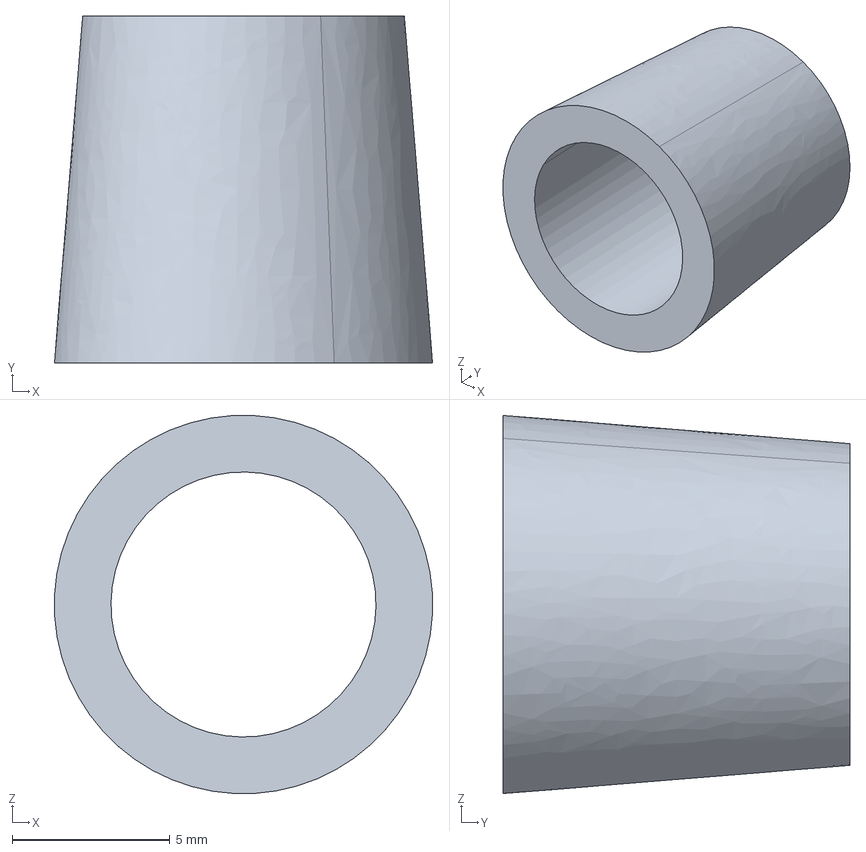
[picture p640: CAD file, 2018-11-07]
AA - Mise en plan/Boisard/Plans essais Boisard/MEP essais traction/19B_TRACTION_03 (entretoise).igs
12.0 x 11.0 x 12.0 mm
