EOSCogniton/STUF2019/AA - Mise en plan/La Mache Laser/Acier/Acier 1,5mm S235/IGS acier 1,5mm S235/19M_EL_A0300_004 (Chape batterie 1).igs

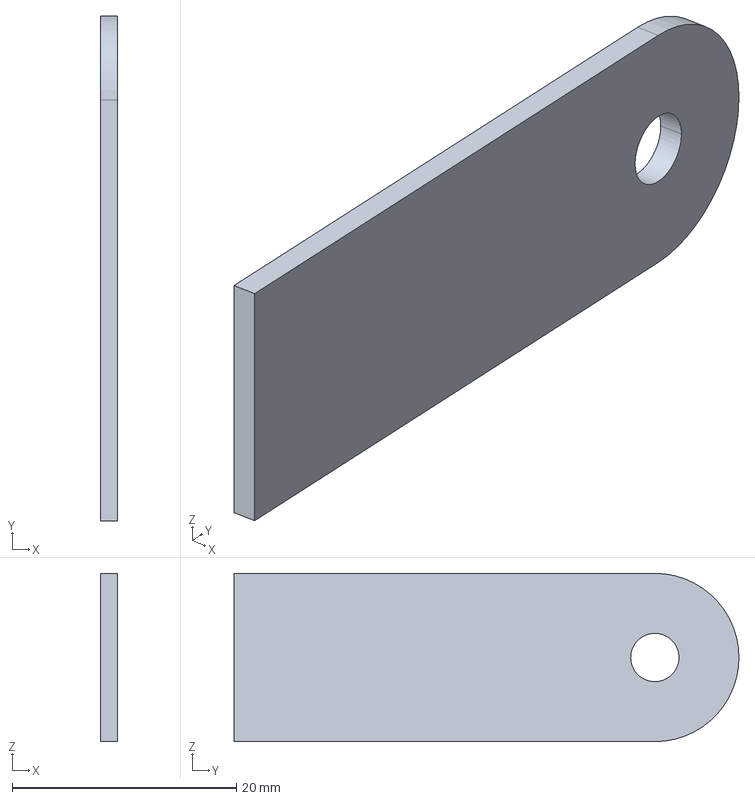
[picture p641: CAD file, 2018-12-17]
AA - Mise en plan/La Mache Laser/Acier/Acier 1,5mm S235/IGS acier 1,5mm S235/19M_EL_A0300_004 (Chape batterie 1).igs
1.50 x 45.0 x 15.0 mm
