EOSCogniton/STUF2019/AA - Mise en plan/La Mache Laser/Acier/Acier 3mm S355/IGS acier 3mm S355/19M_FR_0900_001 (Chape Appui-Tete).igs

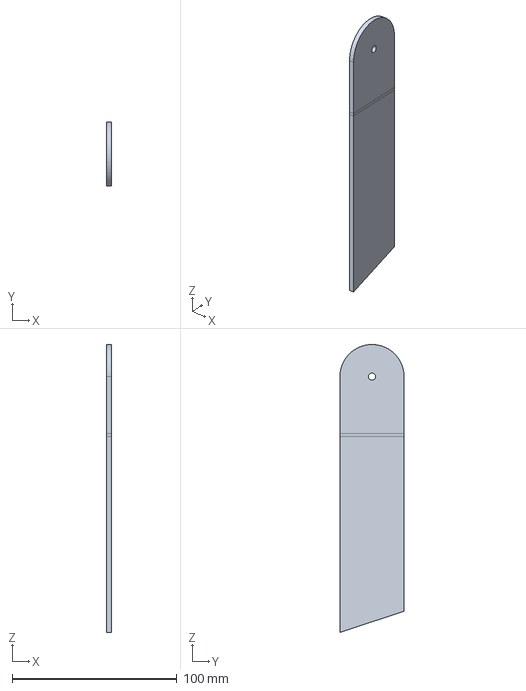
[picture p642: CAD file, 2019-02-05]
AA - Mise en plan/La Mache Laser/Acier/Acier 3mm S355/IGS acier 3mm S355/19M_FR_0900_001 (Chape Appui-Tete).igs
3.00 x 39.0 x 175.0 mm
