EOSCogniton/STUF2019/AA - Mise en plan/La Mache Laser/Acier/Acier 4mm S700/IGS acier 4mm S700/19M_SU_0200_008.igs

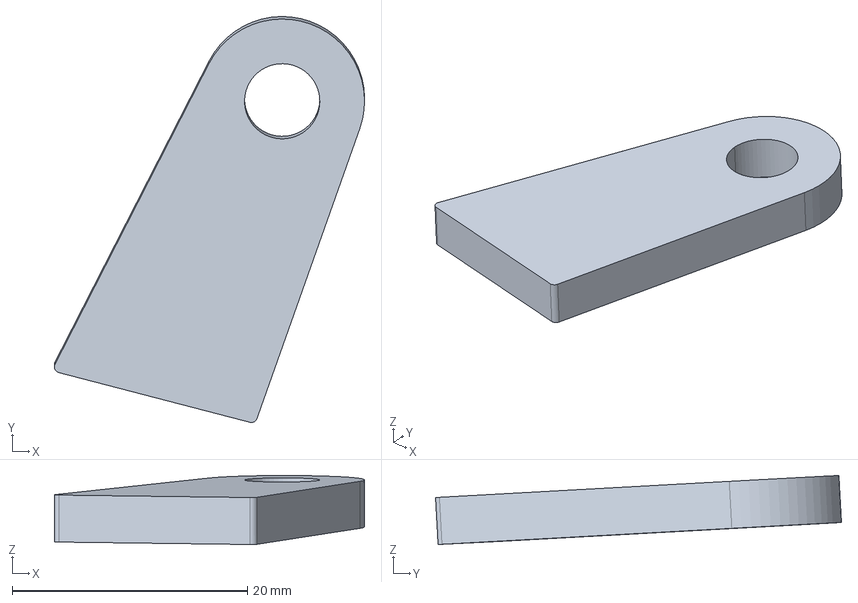
[picture p643: CAD file, 2018-12-10]
AA - Mise en plan/La Mache Laser/Acier/Acier 4mm S700/IGS acier 4mm S700/19M_SU_0200_008.igs
26.4 x 34.5 x 5.87 mm
