EOSCogniton/STUF2019/AA - Mise en plan/La Mache Laser/Aluminium/Aluminium 2017 T4/Aluminium 2.5mm 2017 T4/IGS aluminium 2017 T4 2.5mm/19M_FR_0300_003 (Cale bout de pied).igs

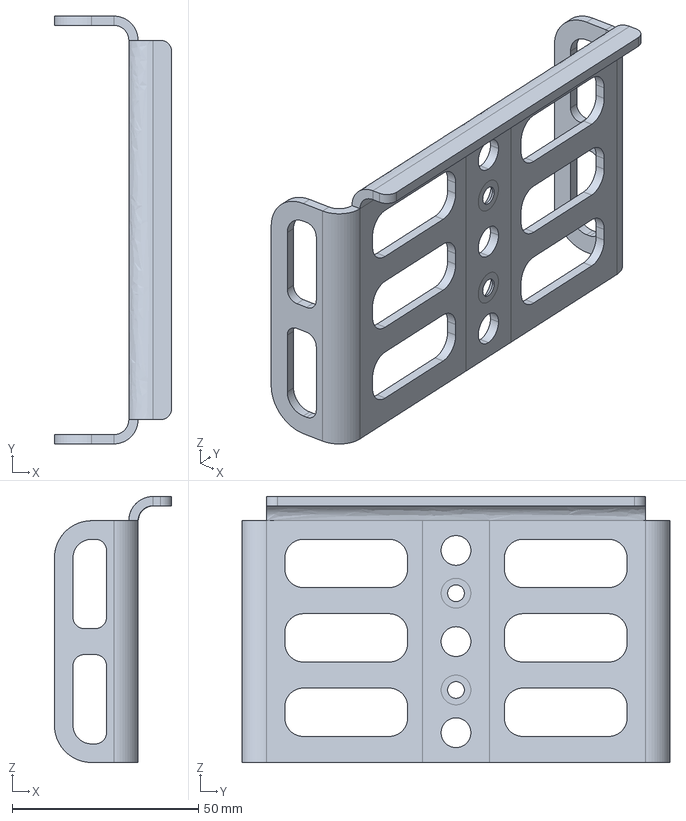
[picture p644: CAD file, 2019-02-24]
AA - Mise en plan/La Mache Laser/Aluminium/Aluminium 2017 T4/Aluminium 2.5mm 2017 T4/IGS aluminium 2017 T4 2.5mm/19M_FR_0300_003 (Cale bout de pied).igs
31.5 x 115.0 x 71.5 mm
