EOSCogniton/STUF2019/AA - Mise en plan/La Mache Laser/Aluminium/Aluminium 2017A (AU4G)/Aluminium 1mm 2017A/IGS aluminium 1mm 2017A/19M_MS_0100_002 (PF-Milieu) 2.0.igs

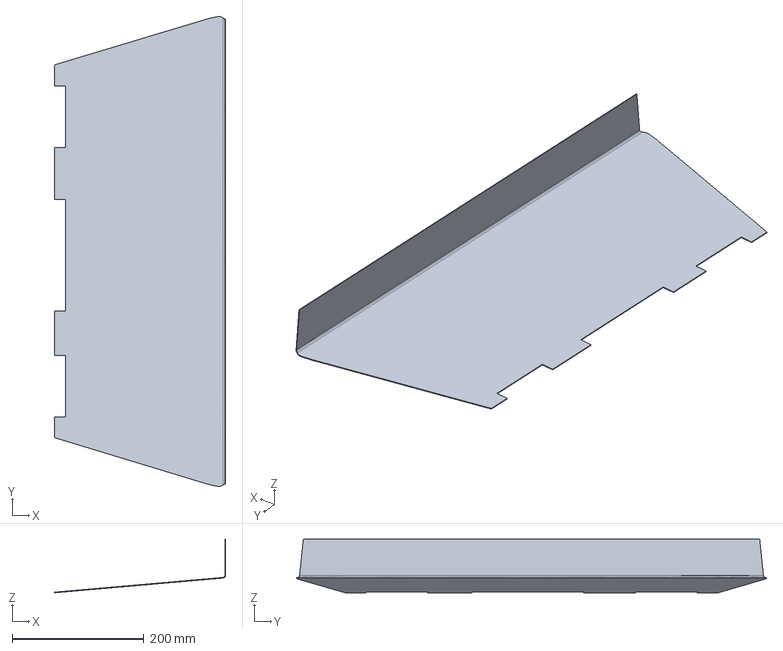
[picture p645: CAD file, 2019-02-24]
AA - Mise en plan/La Mache Laser/Aluminium/Aluminium 2017A (AU4G)/Aluminium 1mm 2017A/IGS aluminium 1mm 2017A/19M_MS_0100_002 (PF-Milieu) 2.0.igs
259.3 x 712.9 x 81.3 mm
