EOSCogniton/STUF2019/AA - Mise en plan/La Mache Laser/Aluminium/Aluminium 2017A (AU4G)/Aluminium 2mm 2017A/IGS aluminium 2mm 2017A/19M_MS_0100_003 (PF-Haute) 2.0.igs

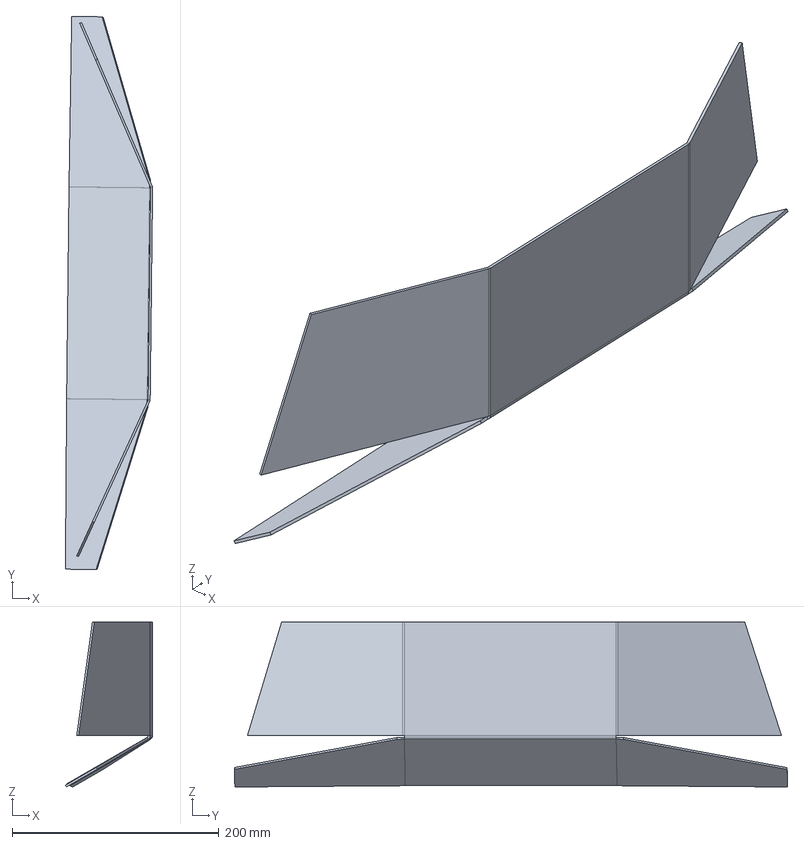
[picture p646: CAD file, 2019-03-19]
AA - Mise en plan/La Mache Laser/Aluminium/Aluminium 2017A (AU4G)/Aluminium 2mm 2017A/IGS aluminium 2mm 2017A/19M_MS_0100_003 (PF-Haute) 2.0.igs
84.4 x 535.4 x 159.7 mm
