EOSCogniton/STUF2019/AA - Mise en plan/La Mache Productique/Acier 35NCD16/IGS acier 35NCD16/19M_SU_1200_004 (Entretoise M6 20 mm).igs

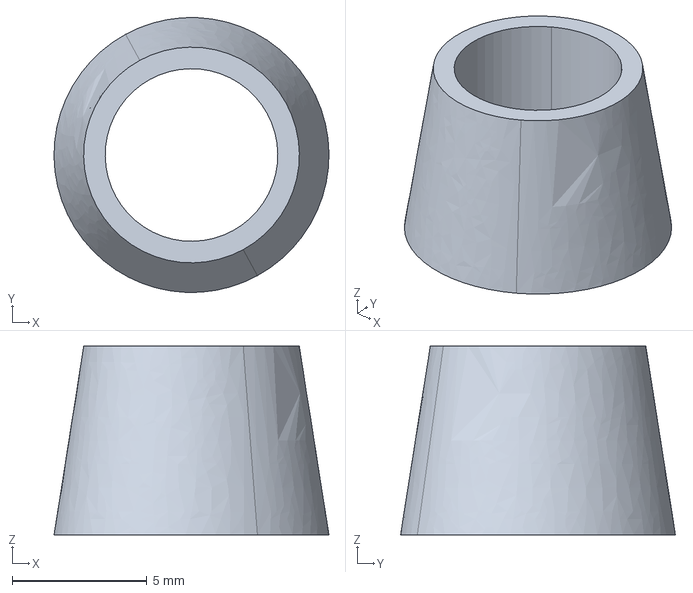
[picture p647: CAD file, 2018-12-10]
AA - Mise en plan/La Mache Productique/Acier 35NCD16/IGS acier 35NCD16/19M_SU_1200_004 (Entretoise M6 20 mm).igs
10.2 x 10.2 x 7.00 mm
