EOSCogniton/STUF2019/AA - Mise en plan/La Mache Productique/Acier S355JR/IGS acier S355JR/19M_FR_0500_001 (Axe levier).igs

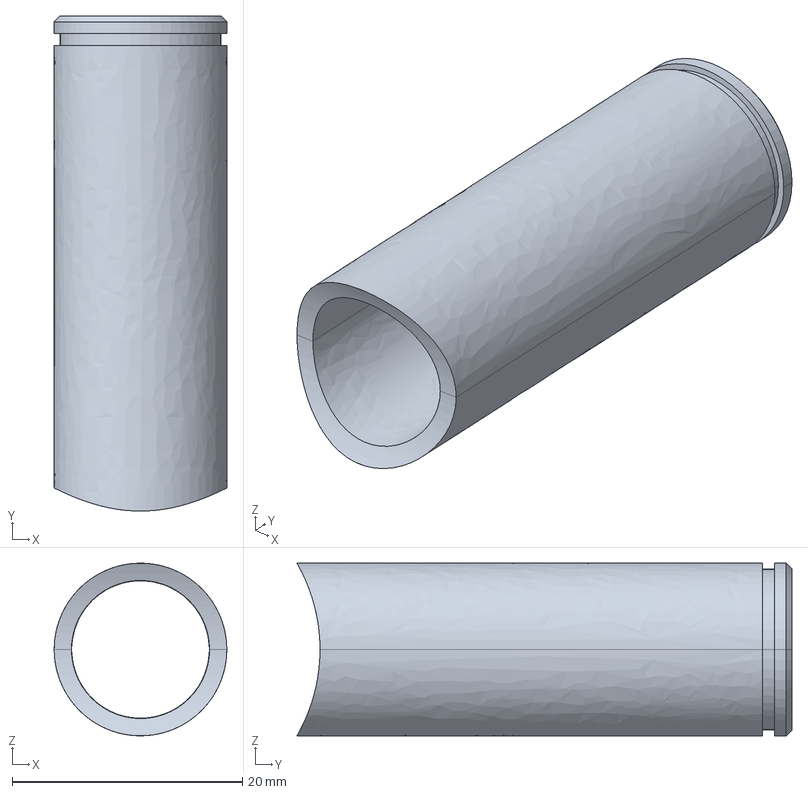
[picture p648: CAD file, 2018-12-10]
AA - Mise en plan/La Mache Productique/Acier S355JR/IGS acier S355JR/19M_FR_0500_001 (Axe levier).igs
15.0 x 43.0 x 15.0 mm
