EOSCogniton/STUF2019/EL - Electrical/Autre/Tableau de bord/Tableau Optimus/graphisme/serigraphie10.dxf

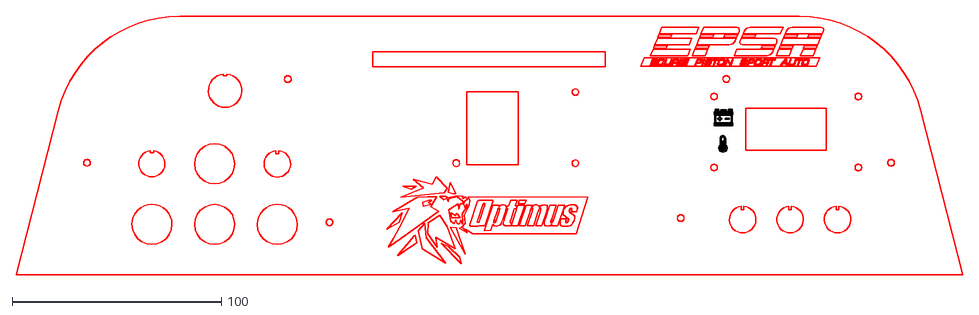
[picture p649: CAD file, 2019-03-31]
EL - Electrical/Autre/Tableau de bord/Tableau Optimus/graphisme/serigraphie10.dxf
452.7 x 123.4
