EOSCogniton/STUF2019/(list of files, cad)

Other CAD files:
AA - Mise en plan/Centrale/19B_SU_1400_007 (Pivot BAR gauche)/19B_SU_1400_007 (Pivot BAR gauche).igs
EL - Electrical/Autre/BSPD/Pspice/test1.stl
EL - Electrical/Catia/Support Tyre Temp/PM Optimus/SU_A1100 (Rear Upright Assy)/MEP/SU_11001 (Rear Left Upright).igs
FR - Frame & Body/FR_A0100 (Frame)/Production/Tubes step/51.stp
FR - Frame & Body/FR_A0300 (Pedal Assy)/Manchon taraudé/STEP-2.14/hpc_MHX6-15_SS_B.stp
FR - Frame & Body/FR_A0300 (Pedal Assy)/Vis à tête fraisée/STEP-2.14/HPC - FHC3-8_SS_B.stp
FR - Frame & Body/FR_A0300 (Pedal Assy)/Vis à tête fraisée/STEP-2.14/STEP-2.14/HPC - FHC3-8_SS_B.stp
SU - Suspension/SU_A1100 (Rear Upright Assy)/MEP/SU_11001R (Rear Right Upright).igs
WT - Wheels, Wheel Bearing & Tires/WT_A0300 (Rear Hub)/MEP/WT_03001 (Rear Hub).igs
AA - Mise en plan/La Mache Laser/Acier/Acier 4mm S700/IGS acier 4mm S700/19M_SU_1400_002 (Chape ARB FR).igs
FR - Frame & Body/FR_A0100 (Frame)/Production/Crise MHBS/final/Symmetry of Shape_849_4.stp
SU - Suspension/SU_A1000 (Front Upright Assy)/MEP/SU_10001R (Front Right Upright).igs
AA - Mise en plan/ARRK/EN_0300_001_AA (Plenum).stl
AA - Mise en plan/ARRK/EN_0300_003_BB (Tubulures).stl
AA - Mise en plan/ARRK/EN_0300_003_BB_Tubulures.stp
AA - Mise en plan/ARRK/EN_0400_007_AA (Convergeant).stl
AA - Mise en plan/ARRK/EN_0400_010_AA (Bride).stl
AA - Mise en plan/AlpenTech/STEP/Insert roue arriere superieur.stp
AA - Mise en plan/AlpenTech/STEP/Insert roue avant inferieur.stp
AA - Mise en plan/AlpenTech/STEP/Insert_chassis.stp
AA - Mise en plan/AlpenTech/insert_biellette.igs
AA - Mise en plan/Aquacut/19M_EN_0101_003 (Joint)/19M_EN_0101_003 (Joint).CATPart
AA - Mise en plan/Aquacut/19M_EN_0101_003 (Joint)/19M_EN_0101_003 (Joint).dxf
AA - Mise en plan/Boisard/Boisard_Fait/Aluminium 2017 T4/19B_WT_02003 (Front Bearing Washer)/19B_WT_02003 (Front Bearing Washer).igs
AA - Mise en plan/Boisard/Boisard_Fait/Aluminium 2017 T4/19B_WT_03003 (Rear Bearing Washer)/19B_WT_03003 (Rear Bearing Washer).igs
AA - Mise en plan/Boisard/Plans essais Boisard/MEP essai frette/WT_0200_007 (Front Brake Hub).CATPart
AA - Mise en plan/Boisard/Plans essais Boisard/MEP essais collage rotules/EntretoiseVis.igs
AA - Mise en plan/Boisard/Plans essais Boisard/MEP essais collage rotules/PlaqueBlocageRotule.igs
AA - Mise en plan/Boisard/Plans essais Boisard/MEP essais traction/19B_TRACTION_01 (insert alu).igs
AA - Mise en plan/Centrale/Calibre_bride/Calibre_bride.CATPart
AA - Mise en plan/Centrale/Reprises d'usinage/Joint_cardan_mep.CATProduct
AA - Mise en plan/La Mache Laser/Acier/Acier 1,5mm S235/IGS acier 1,5mm S235/19M_EL_0100_003 (Chapes break light).igs
AA - Mise en plan/La Mache Laser/Acier/Acier 1,5mm S235/IGS acier 1,5mm S235/19M_EL_0300_004 (Chapes batterie).igs
AA - Mise en plan/La Mache Laser/Acier/Acier 1,5mm S235/IGS acier 1,5mm S235/19M_EL_0500_004 (Chapes Master Switch).igs
AA - Mise en plan/La Mache Laser/Acier/Acier 1,5mm S235/IGS acier 1,5mm S235/19M_EL_0700_002(chapes powerbox).igs
AA - Mise en plan/La Mache Laser/Acier/Acier 1,5mm S235/IGS acier 1,5mm S235/19M_EL_0700_003(chape1 tdb).igs
AA - Mise en plan/La Mache Laser/Acier/Acier 1,5mm S235/IGS acier 1,5mm S235/19M_EL_0700_004(chape2 tdb).igs
AA - Mise en plan/La Mache Laser/Acier/Acier 1,5mm S235/IGS acier 1,5mm S235/19M_EL_0700_005(chape3 tdb).igs
AA - Mise en plan/La Mache Laser/Acier/Acier 1,5mm S235/IGS acier 1,5mm S235/19M_EL_0700_006(chape4 tdb).igs
AA - Mise en plan/La Mache Laser/Acier/Acier 1,5mm S235/IGS acier 1,5mm S235/19M_EL_0700_007(chape5 tdb).igs
AA - Mise en plan/La Mache Laser/Acier/Acier 1,5mm S235/IGS acier 1,5mm S235/19M_EL_0700_008(chape6 tdb).igs
AA - Mise en plan/La Mache Laser/Acier/Acier 1,5mm S235/IGS acier 1,5mm S235/19M_EL_0700_009(chape Anderson ou Booster).igs
AA - Mise en plan/La Mache Laser/Acier/Acier 1,5mm S235/IGS acier 1,5mm S235/19M_EL_0700_010 (Chape de masse).igs
AA - Mise en plan/La Mache Laser/Acier/Acier 1,5mm S235/IGS acier 1,5mm S235/19M_EL_0700_011 (Chape crash sensor).igs
AA - Mise en plan/La Mache Laser/Acier/Acier 1,5mm S235/IGS acier 1,5mm S235/19M_EL_A0300_005 (Chapes batterie 2).igs
AA - Mise en plan/La Mache Laser/Acier/Acier 1,5mm S235/IGS acier 1,5mm S235/19M_EN_0300_011 (Chape fixation admission au chassis).igs
AA - Mise en plan/La Mache Laser/Acier/Acier 1,5mm S235/IGS acier 1,5mm S235/19M_EN_0400_001 (Plaque inferieure guillotine).igs
AA - Mise en plan/La Mache Laser/Acier/Acier 1,5mm S235/IGS acier 1,5mm S235/19M_EN_0400_005 (Plaque superieure guillotine).igs
AA - Mise en plan/La Mache Laser/Acier/Acier 1,5mm S235/IGS acier 1,5mm S235/19M_EN_0800_003 (Chape fixation vase d'expansion).igs
AA - Mise en plan/La Mache Laser/Acier/Acier 1,5mm S235/IGS acier 1,5mm S235/19M_FR_0100_002 (Plaque anti intrusion).igs
AA - Mise en plan/La Mache Laser/Acier/Acier 1,5mm S235/IGS acier 1,5mm S235/19M_FR_0300_019 (Chape repartition).igs
AA - Mise en plan/La Mache Laser/Acier/Acier 1,5mm S235/IGS acier 1,5mm S235/19M_FR_0300_029 (Bocal frein).igs
AA - Mise en plan/La Mache Laser/Acier/Acier 1,5mm S235/IGS acier 1,5mm S235/19M_FR_07001_01_BA (Chapes carrosserie).igs
AA - Mise en plan/La Mache Laser/Acier/Acier 1,5mm S235/IGS acier 1,5mm S235/19M_ST_0100_002 (Chapes crémaillère).igs
AA - Mise en plan/La Mache Laser/Acier/Acier 3mm S355/19M_EN_0400_004 (Partie mobile guillotine).igs
AA - Mise en plan/La Mache Laser/Acier/Acier 3mm S355/IGS acier 3mm S355/19M_EL_0700_001 (Chapes bouton d'arret d'urgence).igs
AA - Mise en plan/La Mache Laser/Acier/Acier 3mm S355/IGS acier 3mm S355/19M_EL_0700_009 (Chape Anderson).igs
AA - Mise en plan/La Mache Laser/Acier/Acier 3mm S355/IGS acier 3mm S355/19M_EN_0500_006 (Chape res FL).igs
AA - Mise en plan/La Mache Laser/Acier/Acier 3mm S355/IGS acier 3mm S355/19M_EN_0500_008 (Chape res FR).igs
AA - Mise en plan/La Mache Laser/Acier/Acier 3mm S355/IGS acier 3mm S355/19M_EN_0500_013 (chape tube remplissage).igs
AA - Mise en plan/La Mache Laser/Acier/Acier 3mm S355/IGS acier 3mm S355/19M_EN_0600_004 (Chape pompe chassis).igs
AA - Mise en plan/La Mache Laser/Acier/Acier 3mm S355/IGS acier 3mm S355/19M_EN_0600_006 (Chape fixation régulateur de pression).igs
AA - Mise en plan/La Mache Laser/Acier/Acier 3mm S355/IGS acier 3mm S355/19M_EN_0800_004 (Chape haut rad).igs
AA - Mise en plan/La Mache Laser/Acier/Acier 3mm S355/IGS acier 3mm S355/19M_EN_0800_005 (chape arriere rad).igs
AA - Mise en plan/La Mache Laser/Acier/Acier 3mm S355/IGS acier 3mm S355/19M_EN_0800_007 (Chape avant rad).igs
AA - Mise en plan/La Mache Laser/Acier/Acier 3mm S355/IGS acier 3mm S355/19M_EN_0901_010 (Chape PE).igs
AA - Mise en plan/La Mache Laser/Acier/Acier 3mm S355/IGS acier 3mm S355/19M_EN_0901_011 (Chapes PE bas).igs
AA - Mise en plan/La Mache Laser/Acier/Acier 3mm S355/IGS acier 3mm S355/19M_EN_0901_012 (chape PE 2).igs
AA - Mise en plan/La Mache Laser/Acier/Acier 3mm S355/IGS acier 3mm S355/19M_EN_0902_004 (Chape chainshield top).igs
AA - Mise en plan/La Mache Laser/Acier/Acier 3mm S355/IGS acier 3mm S355/19M_EN_0902_005 (Chape chainshield bas).igs
AA - Mise en plan/La Mache Laser/Acier/Acier 3mm S355/IGS acier 3mm S355/19M_EN_0905_001 (Chape jacking bar).igs
AA - Mise en plan/La Mache Laser/Acier/Acier 3mm S355/IGS acier 3mm S355/19M_EN_1200_018 (Chape fixation shifter au chassis).igs
AA - Mise en plan/La Mache Laser/Acier/Acier 3mm S355/IGS acier 3mm S355/19M_FR_0300_006_BA(Support lateral pedale de frein).igs
AA - Mise en plan/La Mache Laser/Acier/Acier 3mm S355/IGS acier 3mm S355/19M_FR_0300_010_BA (Support lateral gauche accelerateur).igs
AA - Mise en plan/La Mache Laser/Acier/Acier 3mm S355/IGS acier 3mm S355/19M_FR_0300_024_BA (Chape avant pédalier).igs
AA - Mise en plan/La Mache Laser/Acier/Acier 3mm S355/IGS acier 3mm S355/19M_FR_0300_025_BA (Chape arriere pédalier).igs
AA - Mise en plan/La Mache Laser/Acier/Acier 3mm S355/IGS acier 3mm S355/19M_FR_0300_028_BA (Support lateral droit accelerateur).igs
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
