EOSCogniton/STUF2019/FR - Frame & Body/FR_A0100 (Frame)/Production/Liste des fichiers STEP à réparer.docx

Liste des fichiers STEP à réparer :

( STUF2019 / Frame&Body / Frame / Production / Tubes STEPS )

- 3 RCS : ok
- 4 RCS : ok
- 11 (CMI : 3 faces, 2 se sont jointes, pas les autres, autres probs réparés)
- 12 RCS : ok
- 17 (CMI : ok 1 face, mais à checker car SpaceClaim ne dit que ce n’est pas qu’une seule face quand je demande de fusionner, et bug ensuite / tous les autres icônes vérifiés) RCS : ok
- 18 (CMI : idem que 17) RCS : ok
- 25 (CMI : idem que 3) RCS : ok
- 26 (CMI : idem que 3) RCS : ok
- 29 (CMI : idem que 17) RCS : ok
- 30 (CMI : idem que 17) RCS : ok
- 35 (CMI : idem que 17) RCS : ok
- 36 (CMI : idem que 17) RCS : ok
- 42 (CMI : idem que 17 RCS : ok
- 43 (CMI : idem que 11) RCS ok
- 44 BRT : ok
- 49 RCS ok
- 50 BRT : ok
- 51 : RCS : ok
- 52 : RCS : ok
- 53 RCS ok
- 54 RCS ok
- 55 RCS ok
- 56 RCS ok
- 61 BRT : ok
- 62 BRT : ok
- 115 RCS ok
