EOSCogniton/STUF2019/DS_Design Report/03_Ressources/2015_Design_Dynamix/Design_Support_V2/Frame_Manufacturing_Process.pdf

# FRAME MANUFACTURING PROCESS

Laser cutting of the tubes | Bending of the roll hoops

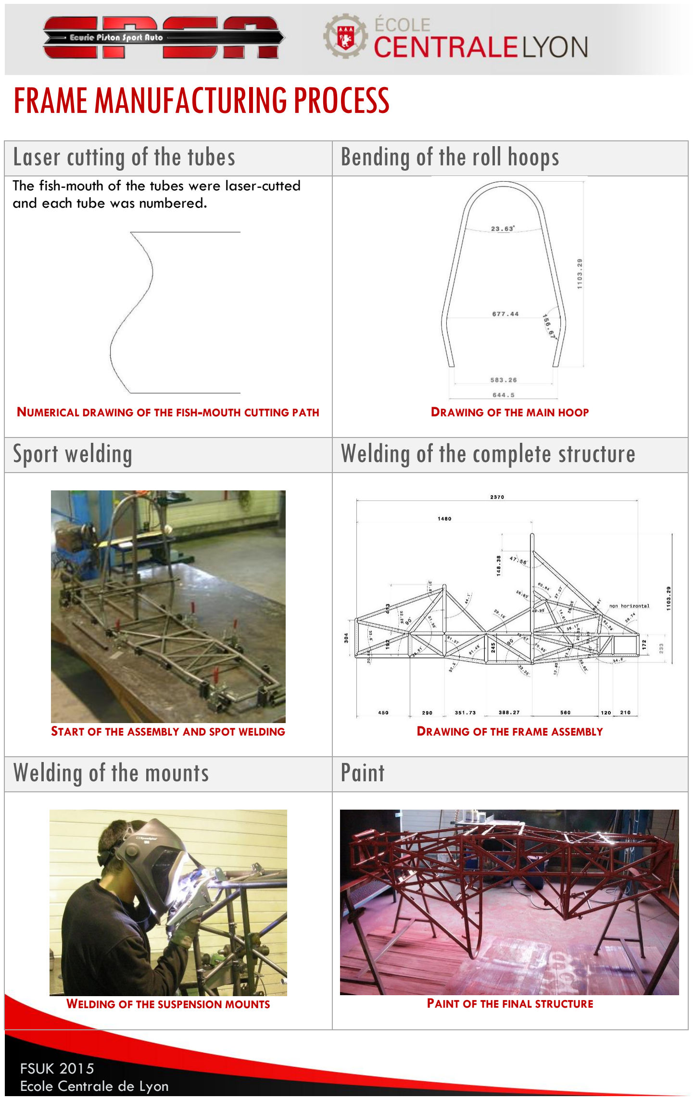
[picture p691: page 1]

## FSUK 2015 Ecole Centrale de Lyon

The fish-mouth of the tubes were laser-cutted and each tube was numbered. NUMERICAL DRAWING OF THE FISH-MOUTH CUTTING PATH | DRAWING OF THE MAIN HOOP
Sport welding | Welding of the complete structure
START OF THE ASSEMBLY AND SPOT WELDING | DRAWING OF THE FRAME ASSEMBLY
Welding of the mounts | Paint
WELDING OF THE SUSPENSION MOUNTS | PAINT OF THE FINAL STRUCTURE
