EOSCogniton/STUF2019/CR - Cost Report/BOM/HowTo_MacroCost.docx

Utilisation de la macor du cost report

1) Importer le fichier CVS qui est téléchargeable sur le site du FSG :
  a. Cliquer sur Données dans le ruban en haut puis cliquer A partir d’un fichier texte/CSV

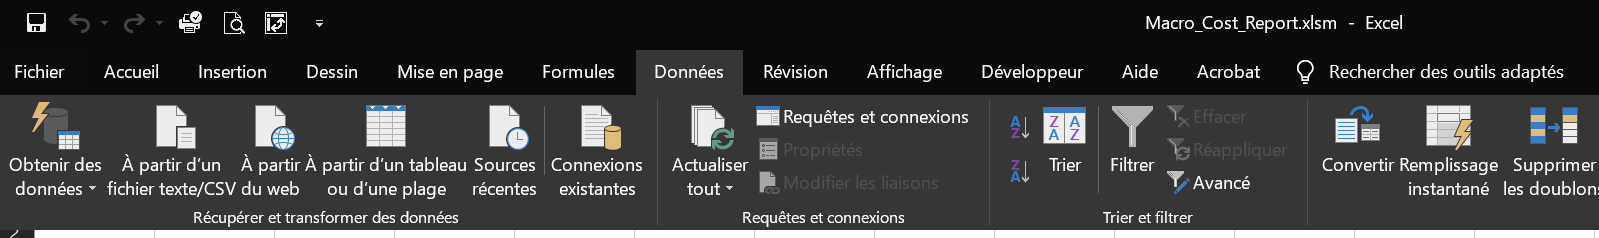
[picture p692: figure]

Sélectionner le fichier cvs à importer puis la fenetre suivante apparait cliquer sur Charger

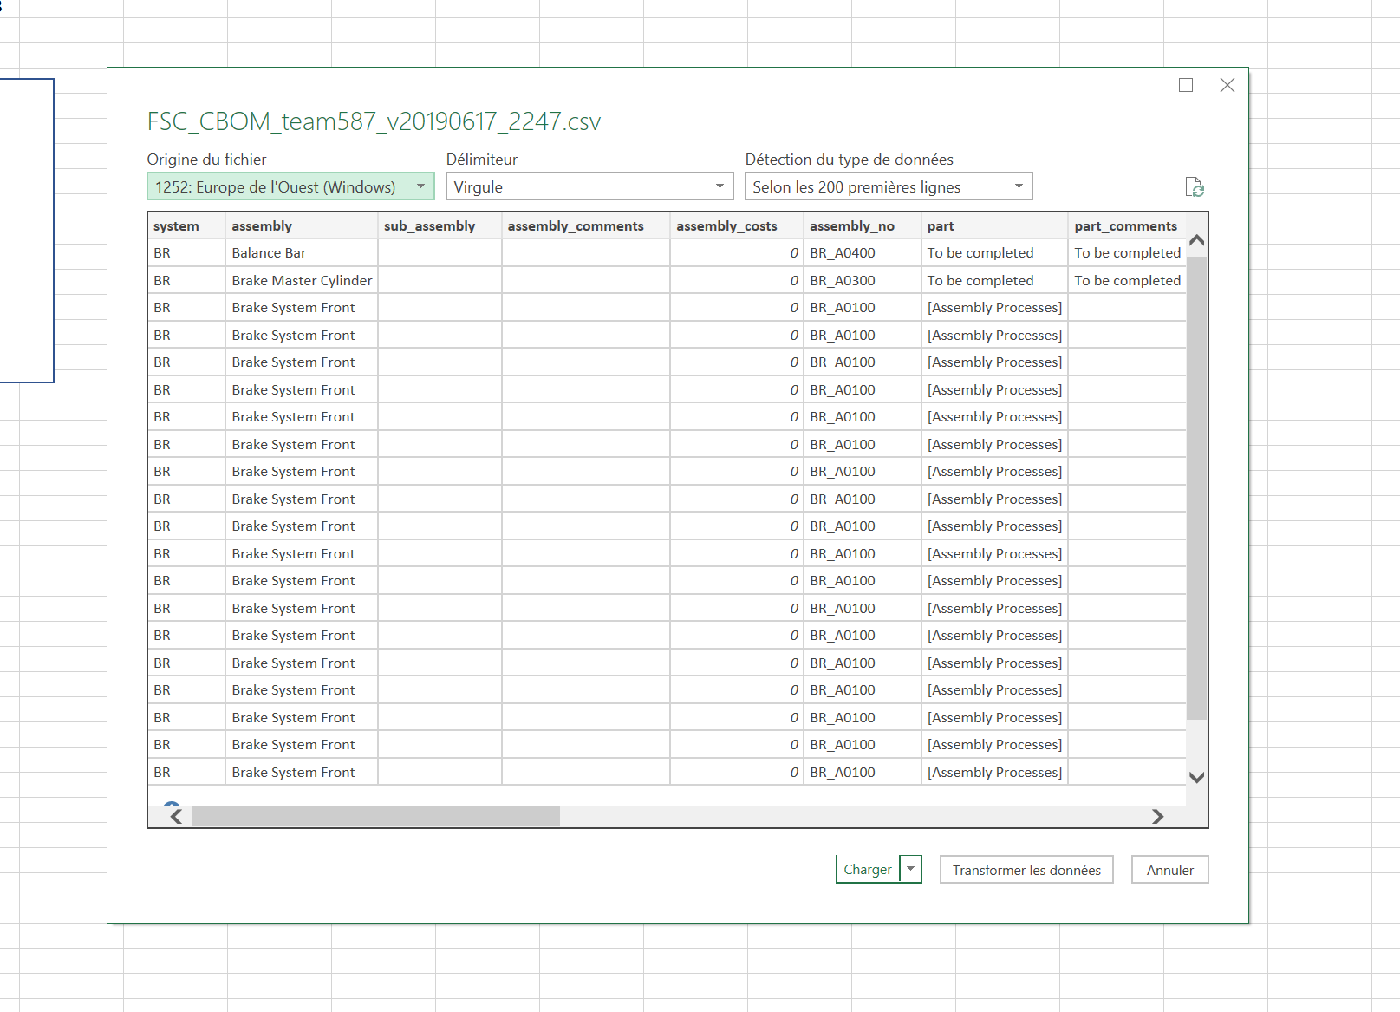
[picture p693: figure]

2) Trier la colonne « part_no » (colonne M)
  a. Utilisez les fonctions des tableaux sous Excel : cliquer sur la fleche à droite du texte « part_no » puis cliquer sur Trier de A à Z

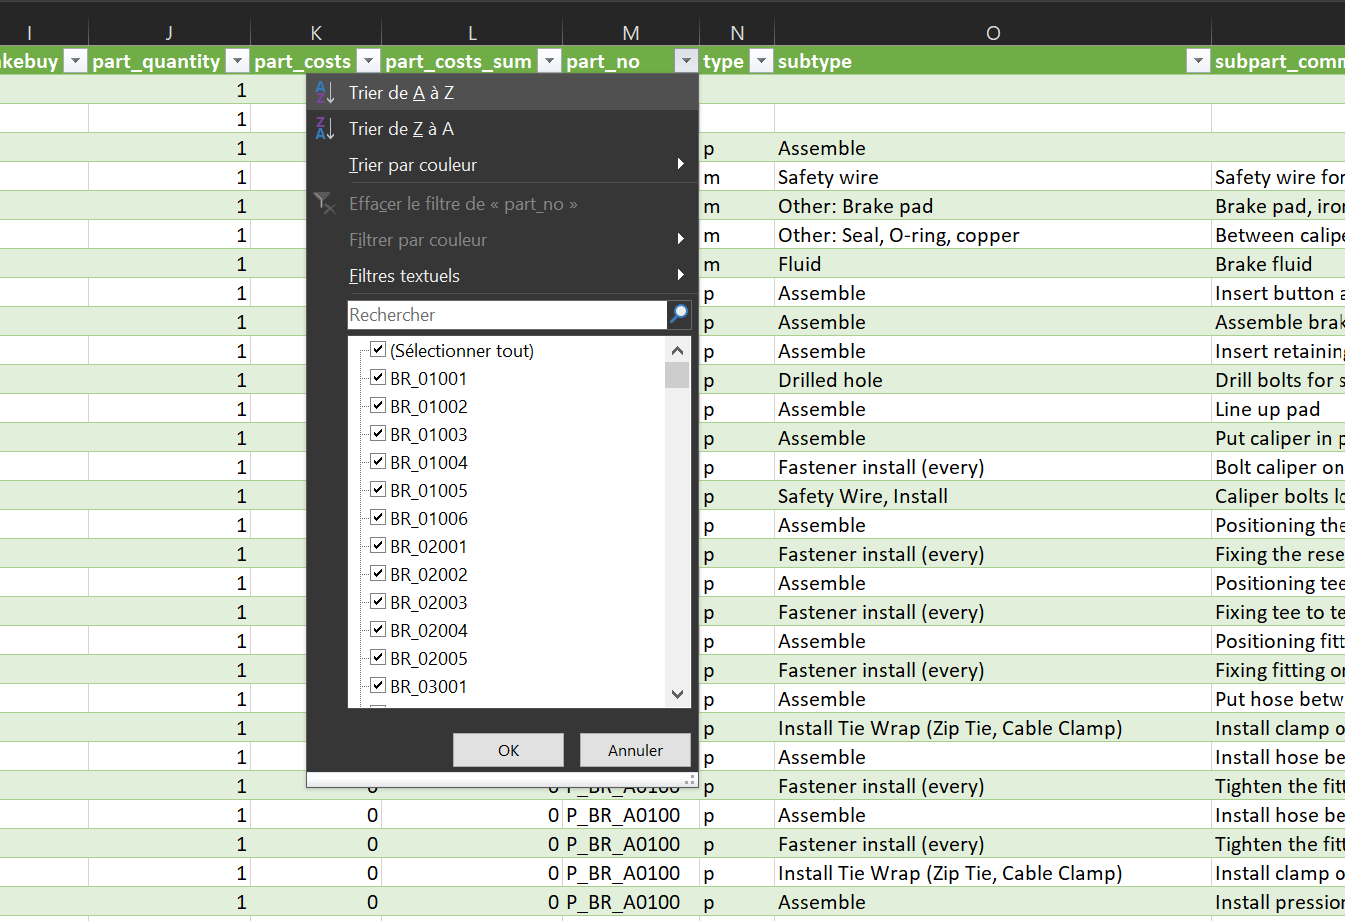
[picture p694: figure]

3) Cliquer sur l’onglet developpeur dans le ruban en haut et ouvrer le code vba, mettez vous dans le module 1 et lancer CATMain()
4) Mettez vous dans le module 2 et lancer la macro Assemblage_Final()
5) Enfin pour ajouter les photos lancer la macro Ajouter_images() dans le module 1
