EOSCogniton/STUF2019/SU - Suspension/SU_A1000 (Front Upright Assy)/gamme_montage/PROM roue equipee AV.pdf

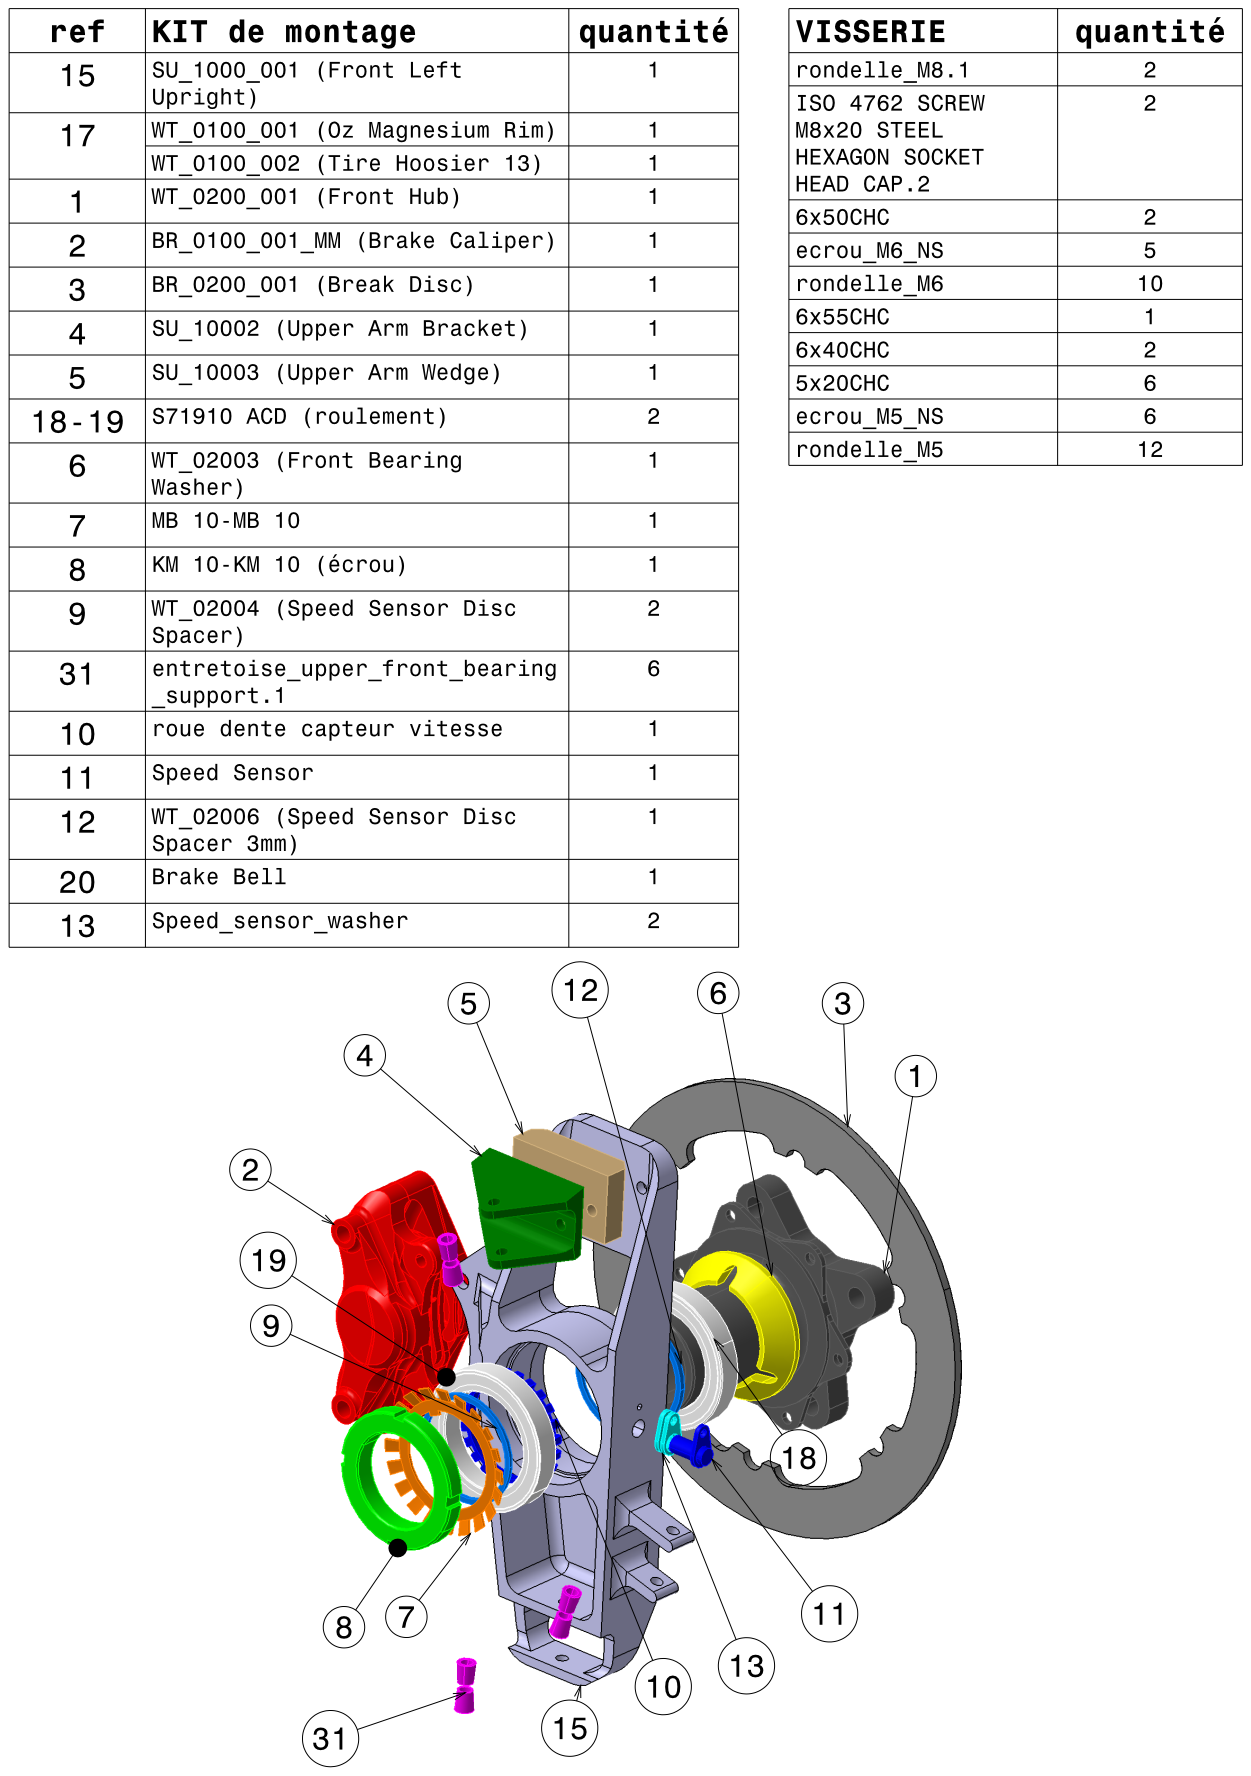
[picture p695: page 1]

Monter la frette du frein 20 sur le moyeu 1 en utilisant les six visses ( avec rondelles et écrous) 28,29,30 . Utiliser une clef dynamométrique en suivant le protocole Facom. Attention au sens de la frette. Positionner les pions et les joints.

Emmancher l'entretoise de roulement 6 sur le moyeu
1. Emmancher le roulement à contact oblique 22 au maillet ou à la presse en s’appuyant sur la bague intérieure. Sens de montage du roulement 18: la flèche doit pointer vers l’épaulement du moyeu 1 et la partie la plus épaisse de la bague supérieure du roulement devra être en contact avec le porte-moyeu 15. Emmancher dans l’ordre indiqué les deux entretoises 12, 9 et la piste denté 10 pour le capteur de vitesse. On peut utiliser de la Loctite 638 pour garantir un montage définitif et diminuer la prise de jeu

On monte l'ensemble moyeu-roulement sur le porte moyeu 15 en collant la bague extérieure du roulement 18 avec de la Loctite 638.

Le deuxième roulement 19 est monté sur le porte moyeu 15 au maillet ou à la presse en collant les bagues intérieures à la Loctite 638.

Insérer la troisième entretoise capteru 9 sur le moyeu
1. Puis placer la rondelle-frein 7 avant l'écrou de serrage 8, avec les dents inclinées du côté de l'extrémité du moyeu (vers l’intérieur du véhicule). L'écrou 8 est bloqué en repliant quatre dents de la rondelle-frein 7 dans les encoches. Pression de serrage à préciser.

Monter la chape supérieure 4 avec une cale de carrossage 5 de 10mm avant à l’aide de deux visses 27 hexa M8x70.

Pour monter le porte moyeu ainsi équipé aux triangles de la suspension utiliser les six entretoises 31 et les serrer en utilisant les trois visses 23

Positionner le disque 3 sur la frette de disque 20. L'étrier doit être placé pour que les arrivés du liquide de frein soient vers le châssis. La vis de purge doit être vers le haut. Approcher l'étrier 2 du disque 3 en faisant attention à vérifier son alignement. Pour ce faire placer (si nécessaire) des rondelles de calages entre le porte moyeu 15 et l’étrier 2. Vérifier l'alignement en faisant tourner le disque de frein 3. Serrer l'étrier par les deux vis 22 avec une clef dynamométrique en suivante le protocole Facom.

Une fois tout aligné, ajouter du lockwire e serrer définitivement avec le même couple de serrage.

Fixer le capteur de vitesse 11 sur le côté du porte moyeu 15 en utilisant les entretoises 13 pour bien régler la distance entre le capteur 11 et la piste en acier 10 (voir étape 2 )

Il faut que le système de freinage soit installé avant de fixer les roues sur les moyeux.

Enfiler la jante 17 sur les goujons jusqu'au contact avec le moyeu 2. Puis serrer les quatre écrous de roue au couple de 46 N.m en utilisant une clef dynamométrique.
