EOSCogniton/STUF2019/SU - Suspension/SU_A1100 (Rear Upright Assy)/gamme_montage/PROM roue equipee AR.pdf

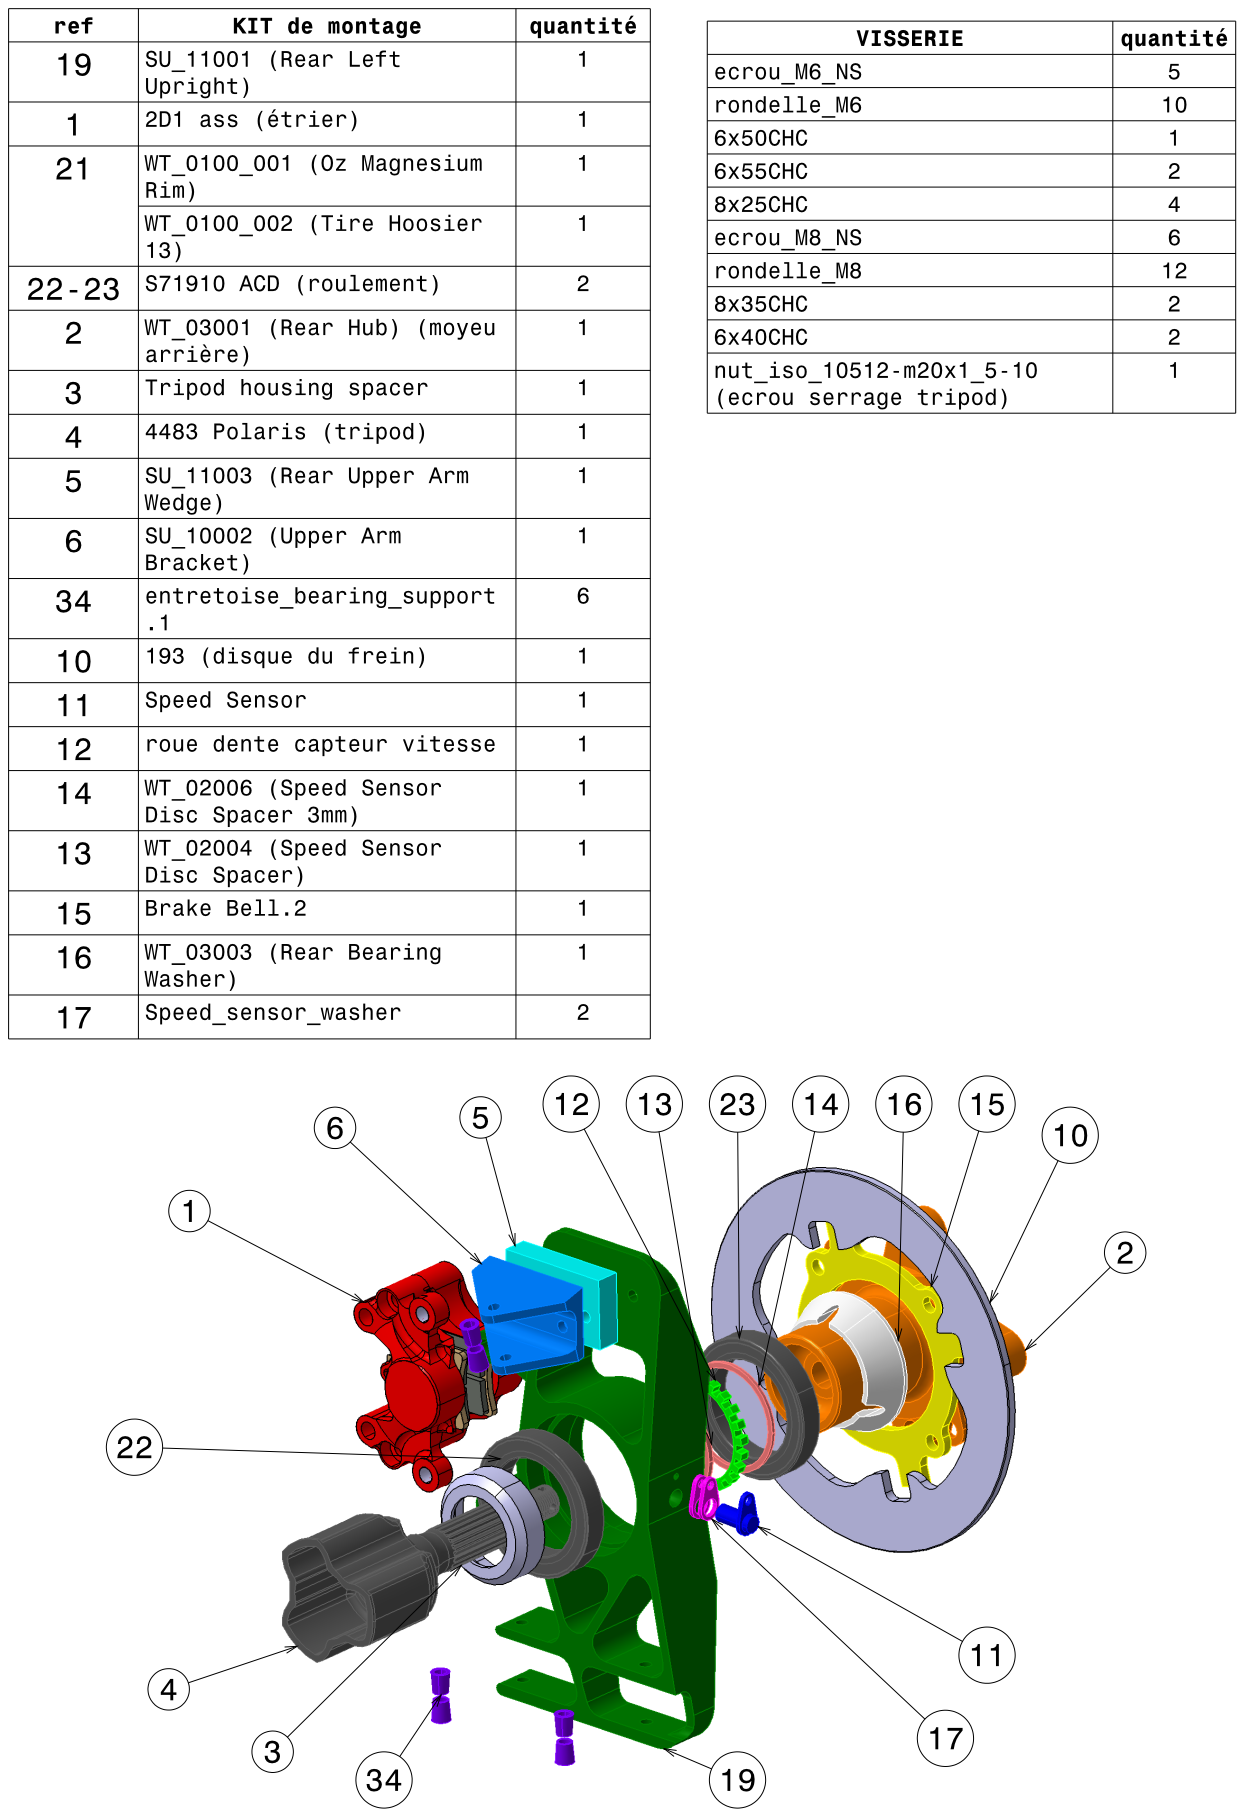
[picture p696: page 1]

Enfiler la frette de frein 15 sur le moyeu 2 et les serrer en utilisant les quatre visses avec rondelle (30, 31, 32)

Nettoyer la surface fonctionnelle du moyeu 2 , des entretoises 16,12,13,14 et du roulement 22. Emmancher l'entretoise de roulement 16 sur le moyeu 2.
Emmancher le roulement à contact oblique 22 (dans le bon sens). Emmancher dans l’ordre indiqué les deux entretoises 13, 14 et la piste denté 12 pour le capteur de vitesse

Nettoyer la surface fonctionnelle du porte moyeu 19 et du roulement 23. Faire rentrer le moyeu ainsi équipé dans le porte moyeu 19. Emmancher le second roulement 23 sur le moyeu 2 et le porte moyeu 19.

Emmancher l'entretoise 3 sur le moyeu 2 aprés le roulement 23. Bloquer la translation du moyeu par l'emmanchement du tripod housing 4 et le serrage de écrou.

Préparer 2 vis M6 HC, leurs rondelles et écrous associées (26, 27). Les positionner dans les perçage prévus à cet effet. Puis insérer l'équivalent de 15mm de cales de carrossages 5 pour être à la position statique théorique voulue. Insérer la chape 6 de fixation du triangle supérieur. Serrer l'ensemble avec une clef dynamométrique en suivant le protocole Facom

Mettre le disque 10 sur la frette du frein 15. Approcher l'étrier 1 du disque 10 en faisant attention à vérifier son alignement. Pour ce faire placer (si nécessaire) des rondelles de calages entre le porte moyeu 19 et l’étrier 1.Vérifier l'alignement en faisant tourner le disque de frein 10. Serrer l'étrier par les deux vis 33 avec une clef dynamométrique en suivante le protocole Facom.

Une fois tout aligné, ajouter du lockwire e serrer définitivement avec le même couple de serrage.

Fixer le capteur de vitesse 11 sur le côté du porte moyeu 19 en utilisant les entretoises 17 pour bien régler la distance entre le capteur 11 et la piste en acier 12 (voir étape 2 )

Pour monter le porte moyeu ainsi équipé aux triangles de la suspension utiliser les six entretoises 34 et les serrer en utilisant les trois visses (28, 29)

Enfin enfiler la jante 21 sur les goujons jusqu'au contact avec le moyeu 2. Puis serrer les quatre écrous de roue au couple de 46 N.m en utilisant une clef dynamométrique.
