EOSCogniton/STUF2019/MS - Miscelleanous, Finish and Assembly/Chappe paramètrique/parametrage chappe V2.xls

longueur (mm) | 100
demi_largeur (mm) | 20
epaisseur (mm) | 5
rayon_fixation (mm) | 60
position_trou (mm) | 40
diametre_trou (mm) | 6
