EOSCogniton/STUF2019/CR - Cost Report/Oral/2_Resource and cost planning/Manufacturing/Manufacturing_Gantt.xlsm

Sheet: Planning_ExpoBibli
Planning Prévisionnel
Projet : FabricationSTUF'2019
Date de début :
Jour J :
Date de fin :
Version : 1.0 du 10/12/18
Tâche à accomplir | Responsables | Etat | Décembre |  |  |  |  |  |  |  |  |  |  |  |  |  |  |  |  |  |  |  |  |  |  |  |  |  |  |  |  |  |  | Janvier
 |  |  | 1 | 2 | 3 | 4 | 5 | 6 | 7 | 8 | 9 | 10 | 11 | 12 | 13 | 14 | 15 | 16 | 17 | 18 | 19 | 20 | 21 | 22 | 23 | 24 | 25 | 26 | 27 | 28 | 29 | 30 | 31 | 1 | 2 | 3 | 4 | 5 | 6 | 7 | 8 | 9 | 10 | 11 | 12 | 13 | 14 | 15 | 16 | 17 | 18 | 19 | 20 | 21 | 22 | 23 | 24 | 25 | 26
Suivi du projet
Déterminer la date et le lieu | PTN | Terminée
Etablir la liste des besoins | PTN | En cours
Etablir et suivre le budget prévisionnel | PTN | A faire
Faire le bilan de l'évènement | PTN | A faire
Communication
Définir la stratégie de communication | PTN | En cours
Réaliser les invitations | PTN | A faire
Envoyer les invitations | PTN | Terminée
Rédiger le communiqué de presse | PTN | A faire
Envoyer le communiqué de presse | PTN | A faire
Relancer les journalistes | PTN | A faire
Logistique
Elaborer un plan de salle | PTN | A faire
Réserver le matériel nécessaire | PTN | A faire
Aménager la salle | PTN | A faire
Ranger la salle | PTN | A faire
Ranger la salle | PTN | En cours
 | Liste des etats possible | A faire
 |  | En cours
 |  | Bloquée
 |  | Terminée
 |  | En retard

Sheet: Planning_Prod
Planning Prévisionnel
Projet : Fabrication STUF'2019
Date de début : 01 Décembre 2018
Jour J :
Date de fin : 17 Mars 2019
Version : 1.4 du 14/01/19
Tâche à accomplir | Respo | Etat | Décembre |  |  |  |  |  |  |  |  |  |  |  |  |  |  |  |  |  |  |  |  |  |  |  |  |  |  |  |  |  |  | Janvier
 |  |  | 1 | 2 | 3 | 4 | 5 | 6 | 7 | 8 | 9 | 10 | 11 | 12 | 13 | 14 | 15 | 16 | 17 | 18 | 19 | 20 | 21 | 22 | 23 | 24 | 25 | 26 | 27 | 28 | 29 | 30 | 31 | 1 | 2 | 3 | 4 | 5 | 6 | 7 | 8 | 9 | 10 | 11 | 12 | 13 | 14 | 15 | 16 | 17 | 18 | 19 | 20 | 21 | 22 | 23 | 24 | 25 | 26
La Mache Laser |  |  |  |  |  |  |  |  |  |  |  |  |  |  |  |  |  |  |  |  |  |  |  | VACANCES DE NOEL
Préparer les igs et MEP de la 1er vague (1,5 mm) | CEE | Terminée
Production de la 1er vague | CEE | Terminée
Préparer les igs et MEP de la 2er vague (Chapes LAS) | CEE | Terminée
Production de la 2er vague | CEE | A faire
Préparer les igs et MEP de la 3e vague (S355) | CEE | Terminée
Production de la 3e vague | CEE | A faire
Préparer les igs et MEP de la 4e vague (2017A) | CEE | A faire
Production de la 4e vague | CEE | A faire
Boisard
Commander les brutes alu 7075 T6 | MPL | Terminée
Envoyer les premieres pièces | MPL | Terminée
Production pièces soudés sur le châssis (direction & moteur) | MPL | En cours
Reception des brutes | MPL | Terminée
Envoyer des pièces aluminium 7075 T6 | MPL | Terminée
Production du PE | MPL | A faire
Production du Moyeu | MPL | A faire
Production du Porte Moyeu | MPL | A faire
La Mache Productique
Préparer les igs et MEP de la 1er vague (entretoises) | CEE | Terminée
Production de la 1er vague | CEE | A faire
Préparer les igs et MEP de la 2er vague | CEE | A faire
Production de la 2er vague | CEE | A faire
Alpentech
Faire les mises en plan | ABR | Terminée
Contacter AlpenTech | ABR | Terminée
Commander les brutes | ABR | En cours
Production | ABR | A faire
La Gir
Contacter Flash Cintrage | RCS | Terminée
Préparer fichiers pour Flash Cintrage | RCS | Terminée
Amener les tubes chez Flash Cintrage | RCS | Terminée
Cintrage des tubes (2 jours) | RCS | Terminée
Récupérer des arceaux | RCS | En cours
Préparer les fichiers pour Noel Metal | RCS | Terminée
Amener les tubes chez Noel Metal | RCS | Terminée
Découpe des tubes | RCS | Terminée
Récupérer les tubes chez Noel Metal | RCS | Terminée
Réaliser un devis chez A2M (test pièces) | RCS | Terminée
Amener les échantillons chez A2M | RCS | Terminée
Récupérer les échantillons chez A2M | RCS | A faire
Préparer fichiers pour Vernay | RCS | Terminée
Soudure du chassis | RCS | En cours
Soudure de l'avant de la structure tubulaire | RCS | Terminée
Soudure de l'arriere de la structure tubulaire | RCS | En cours
Réalisation des gabarits | EDP | En cours
Soudure des chapes | RCS | A faire
Soudure des premières chapes sans gabarits | RCS | A faire
Reprise des chapes à la meuleuse | ABR | A faire
Récupérer le châssis pour échappement | RCS | A faire
Gabarits
Réalisation des gabarits de triangles | ABR | A faire
Réalisation des gabarits de direction | EDP | A faire
Chape basculeur avant | PCT | En cours
Equerres BAR Av | PCT | A faire
Equerres BAR Ar | PCT | A faire
Chape en U olhins Ar | PCT | En cours
Gabarit pour mise en postion des couteaux | PCT | A faire
Faire les mises en plan des gabarits
ECL
Contacter B.Houx pour usinage Porte Couronne | MPY | Terminée
Usinage Porte couronne | MPY | A faire
PSEP
Reprendre contact avec PSEP | RCS | En cours
Fixer la couleur et la date pour amener le châssis | RCS | A faire
Amener le châssis | RCS | A faire
Peinture sur châssis | RCS | A faire
Récupérer le châssis peint | RCS | A faire
Bery Inox
Contacter Bery Inox | CEE | Terminée
Demander la commande des brutes | CEE | Terminée
Fixer une date pour amener le moteur | CEE | Terminée
Préparer les documents nécessaires | CEE | Terminée
Amener le moteur | CEE | Terminée
Soudure de l'échappement hors châssis | CEE | A faire
Amener le châssis | CEE | A faire
Soudure de l'échappement sur châssis | CEE | A faire
Direction Projet
Plannifier présentation Brice chez Boisard | NGO | Terminée
Affection des responsable fournisseurs | NGO, YRI | En cours
Plannifier TOP Organe et moteur | NGO | Terminée
Envoyer le mail TOP Organe | NGO | Terminée
 | Liste des etats possible | A faire
 |  | En cours
 |  | Bloquée
 |  | Terminée
 |  | En retard
 | Terminée | 32
 | En cours | 10
 | A faire | 29
 | Bloquée | 0
 | En retard | 0

Sheet: Planning_Fab
Planning Prévisionnel
Projet : Intégration STUF'2019
Date de début : 01 Décembre 2018
Jour J :
Date de fin : 17 Mars 2019
Version : 1.0 du 10/12/18
Tâche à accomplir | Respo | Etat | Décembre |  |  |  |  |  |  |  |  |  |  |  |  |  |  |  |  |  |  |  |  |  |  |  |  |  |  |  |  |  |  | Janvier
 |  |  | 1 | 2 | 3 | 4 | 5 | 6 | 7 | 8 | 9 | 10 | 11 | 12 | 13 | 14 | 15 | 16 | 17 | 18 | 19 | 20 | 21 | 22 | 23 | 24 | 25 | 26 | 27 | 28 | 29 | 30 | 31 | 1 | 2 | 3 | 4 | 5 | 6 | 7 | 8 | 9 | 10 | 11 | 12 | 13 | 14 | 15 | 16 | 17 | 18 | 19 | 20 | 21 | 22 | 23 | 24 | 25 | 26
Roue équipée |  |  |  |  |  |  |  |  |  |  |  |  |  |  |  |  |  |  |  |  |  |  |  | VACANCES DE NOEL
Préparer les igs et MEP de la 1er vague (Chapes LAS) | CEE | Terminée
Production de la 1er vague | CEE | A faire
Préparer les igs et MEP de la 2er vague | CEE | A faire
Production de la 2er vague | CEE | A faire
Motorisation
Commander les brutes alu 7075 T6 | MPL | Terminée
Envoyer les premieres pièces | MPL | Terminée
Production pièces soudés sur le châssis | MPL | En cours
Reception des brutes | MPL | Terminée
Envoyer des pièces aluminium 7075 T6 | MPL | A faire
Production des pièces de la roue équipée et PE | MPL | A faire
La Mache Productique
Préparer les igs et MEP de la 1er vague (Chapes LAS) | CEE | Terminée
Production de la 1er vague | CEE | A faire
Préparer les igs et MEP de la 2er vague | CEE | A faire
Production de la 2er vague | CEE | A faire
Alpentech
Faire les mises en plan | ABR | Terminée
Contacter AlpenTech | ABR | En cours
Commander les brutes | ABR | A faire
Production | ABR | A faire
Bery Inox
Contacter Bery Inox | CEE | Terminée
Demander la commande des brutes | CEE | Terminée
Préparer les documents nécessaires | CEE | Terminée
Amener le moteur | CEE | A faire
 | Liste des etats possible | A faire
 |  | En cours
 |  | Bloquée
 |  | Terminée
 |  | En retard
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
