EOSCogniton/STUF2019/DS_Design Report/03_Ressources/2015_Design_Dynamix/Documents disponibles/cbr600rr wiring diagram.gif

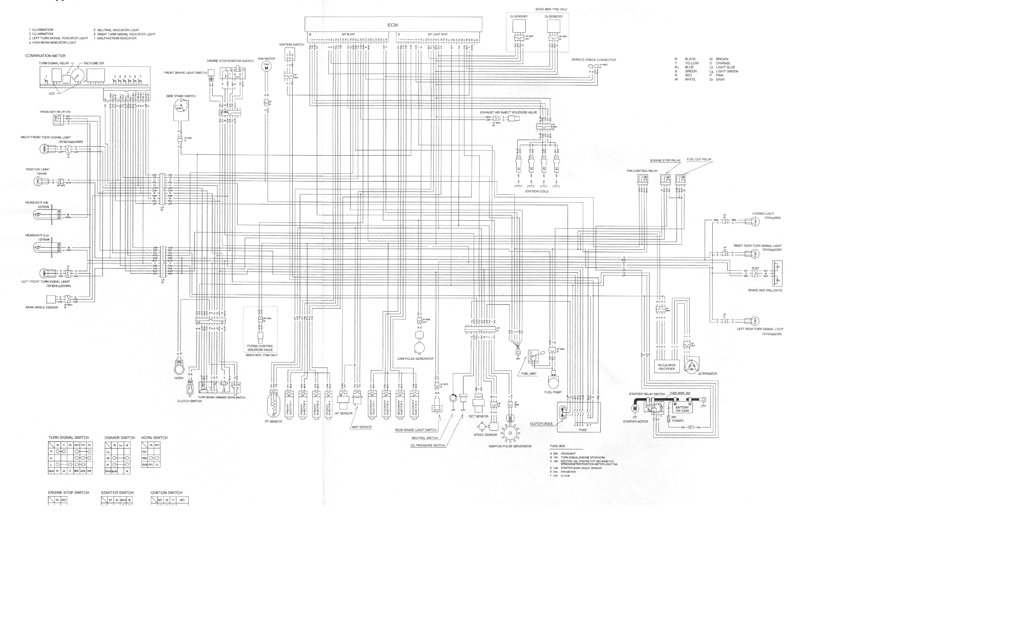
DS_Design Report/03_Ressources/2015_Design_Dynamix/Documents disponibles/cbr600rr wiring diagram.gif
