EOSCogniton/STUF2019/BR - Brake System/Test etriers et disques/disques de freins.docx

# Disques de frein de diamètre plus petit

# Disques d’épaisseur 4,5 mm :

- FE.A499 http://www.franceequipement.com/catalogue/produit/33655?pagecatalogue=1: Diamètre extérieur = 184 mm

# Disques d’épaisseur 4 mm :

- FE.B401 http://www.franceequipement.com/catalogue/produit/33690?pagecatalogue=2 :

Diamètre extérieur = 156 mm

- FE.B402V http://www.franceequipement.com/catalogue/produit/33691?pagecatalogue=2

Diamètre extérieur = 180 mm

- FE.B444 http://www.franceequipement.com/catalogue/produit/33694?pagecatalogue=2 :

Diamètre extérieur = 185 mm

- FE.B453 http://www.franceequipement.com/catalogue/produit/33695?pagecatalogue=2

Diamètre extérieur = 185 mm
