EOSCogniton/STUF2019/FR - Frame & Body/FR_A0100 (Frame)/SES/A envoyer FSN complement/SES_Correction_EPSA/Welding tests by A2M industries.docx

Welding tests by A2M industries, professional and certified professional testers.

In « certificats matière » find traction tests for no welding tube.
