EOSCogniton/STUF2019/EN - Engine & Powertrain/Reglage moteur/Calibration_TMAP.xlsx

Air Temperature |  | Pressure manifold
V (mV) | T (°C) | V (mV) | P (kPa)
0.393 | 130 | 400 | 20
0.494 | 120 | 612.5 | 34
0.697 | 105 | 825 | 48
0.986 | 90 | 1037.5 | 62
1.236 | 80 | 1250 | 76 | Pas P | 14
1.538 | 70 | 1462.5 | 90 | Pas V | 212.5
1.892 | 60 | 1675 | 104
2.085 | 55 | 1887.5 | 118
2.288 | 50 | 2100 | 132
2.498 | 45 | 2312.5 | 146
2.712 | 40 | 2525 | 160
2.927 | 35 | 2737.5 | 174
3.139 | 30 | 2950 | 188
3.345 | 25 | 3162.5 | 202
3.550 | 20 | 3375 | 216
3.745 | 15 | 3587.5 | 230
3.925 | 10 | 3800 | 244
4.090 | 5 | 4012.5 | 258
4.238 | 0 | 4225 | 272
4.480 | -10 | 4437.5 | 286
4.655 | -20 | 4650 | 300
