EOSCogniton/STUF2019/SU - Suspension/05 - Essais/Excels essais Optimus/Temoins et tests triangles/Temoin alu alu/collage alu alu.is_tens_Results.csv

Tableau des résultats 1
 | Matériau | Vitesse 1 | Charge à Rupture (Standard) | Maximum Charge | A%
 |  | (mm/min) | (N) | (N) | (%)
1 | alu | 5 | 15791,33421 | 15791,33421 | 36,5
