EOSCogniton/STUF2019/EL - Electrical/Autre/Doc des éléments/Capteurs/alib/Calibration_rotation_volant.xlsx

Sheet: Calib_rotation_volant
Valeur RaceCaptur | Angle (degré) | Comments
1.5 | -103 | Butée à gauche
1.6 | -89.8
1.69 | -81
1.75 | -72.4
1.85 | -63.8
1.94 | -52.1
1.98 | -47.1
2.04 | -37.5
2.08 | -31.3
2.13 | -21.9
2.19 | -11.3
2.23 | -2.3
2.31 | 10.8
2.35 | 17.1
2.39 | 23.2
2.45 | 32
2.53 | 43.9
2.6 | 54.1
2.68 | 63.2
2.76 | 72.7
2.84 | 81 |  | Remarques :
2.92 | 89.9 |  | Utiliser le camber rite et le scotcher au volant
2.96 | 92.9 | à partir de la il y a un pb avec le capteur et on doit adapter la valeur renvoyée par le capteur avec un offset
3.01 | 99 | Butée à droite

Sheet: Calib_suspensions
Déplacement (mm) | Tension (mV)
 | 1 | 2 | 3 | 4
0 | 0 | 0 | 0 | 0
1 | 466 | 555 | 527 | 552
2 | 1125 | 1217 | 1180 | 1219
3 | 1802 | 1879 | 1834 | 1866
4 | 2463 | 2546 | 2546 | 2543
5 | 3132 | 3206 | 3144 | 3194
6 | 3748 | 3868 | 3824 | 3837
7 | 4450 | 4511 | 4477 | 4507
8 | 5019 | 5019 | 5020 | 5019
