EOSCogniton/STUF2019/EL - Electrical/Autre/Carte avant/Arduino/Prgm Carte Avant/Arthur/New/Test CAN Vulcanix.PNG

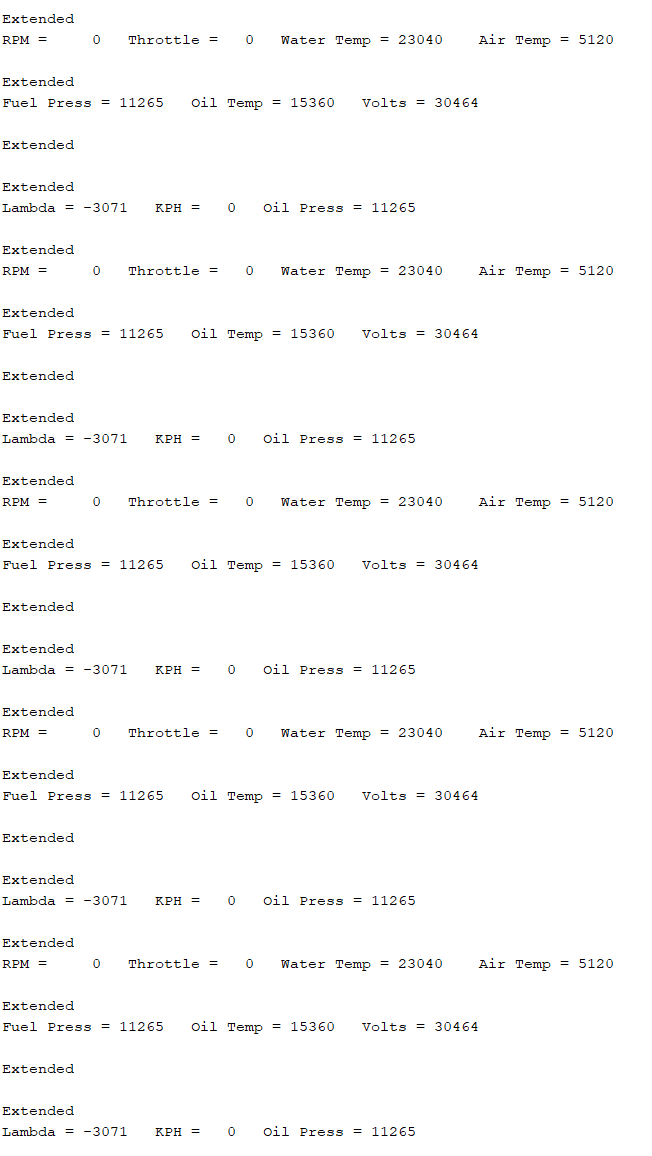
EL - Electrical/Autre/Carte avant/Arduino/Prgm Carte Avant/Arthur/New/Test CAN Vulcanix.PNG
