EOSCogniton/STUF2019/FR - Frame & Body/FR_A0100 (Frame)/Design report/Design Support/Simulations/Braking 2G/Von Mises (test avec avant et arriere encastrée).PNG

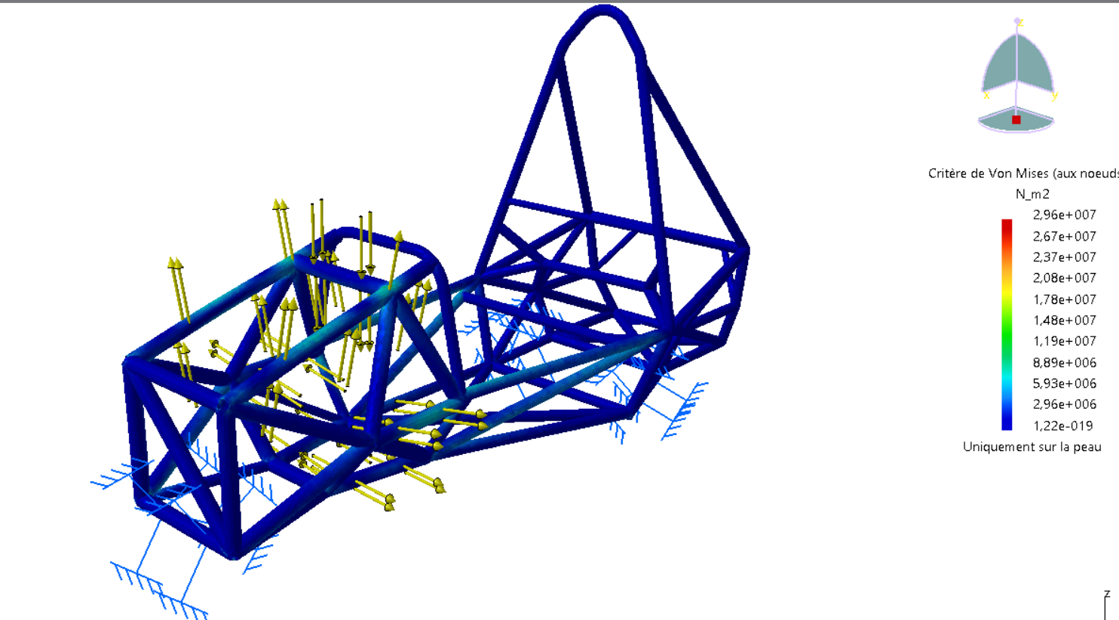
FR - Frame & Body/FR_A0100 (Frame)/Design report/Design Support/Simulations/Braking 2G/Von Mises (test avec avant et arriere encastrée).PNG
