EOSCogniton/STUF2019/FR - Frame & Body/FR_A0100 (Frame)/SES/Vickers test.png

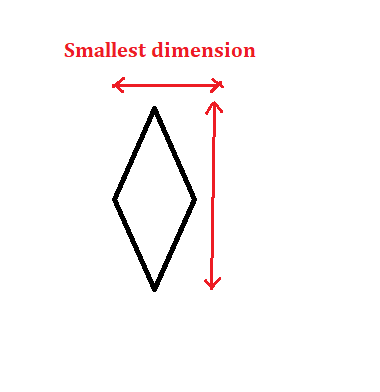
FR - Frame & Body/FR_A0100 (Frame)/SES/Vickers test.png
