EOSCogniton/STUF2019/SU - Suspension/05 - Essais/Excels essais Optimus/Temoins et tests triangles/Photos/54394748_400814020746890_1046127202921349120_n.jpg

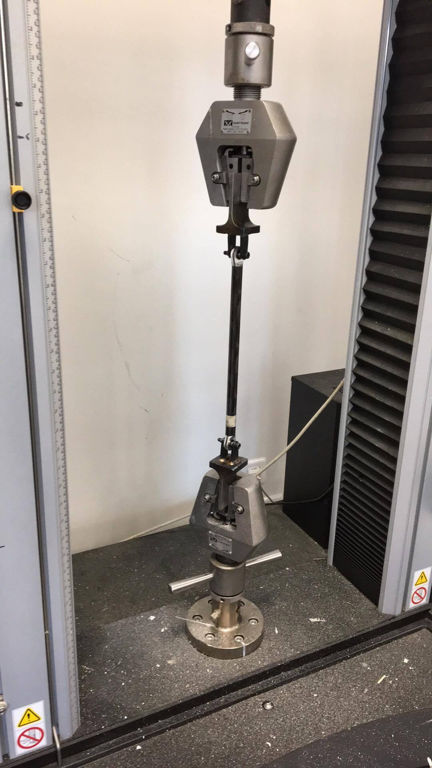
SU - Suspension/05 - Essais/Excels essais Optimus/Temoins et tests triangles/Photos/54394748_400814020746890_1046127202921349120_n.jpg
