EOSCogniton/STUF2019/SU - Suspension/05 - Essais/Excels essais Optimus/Temoins et tests triangles/Photos/54419152_419702152118750_159370134522167296_n.jpg

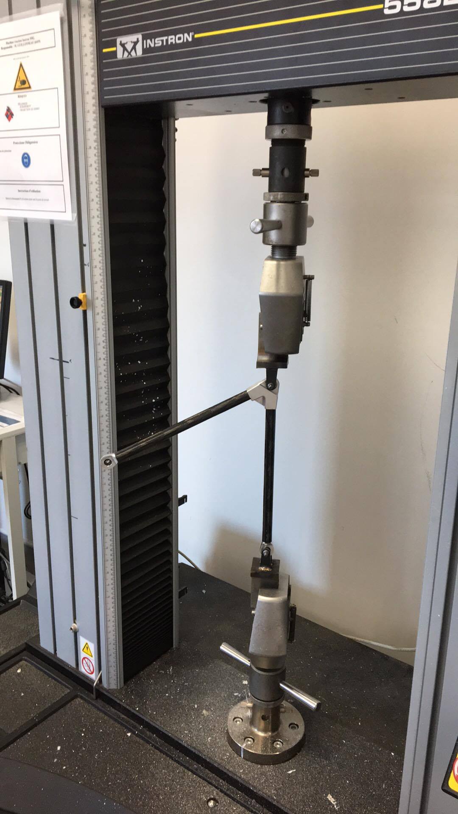
SU - Suspension/05 - Essais/Excels essais Optimus/Temoins et tests triangles/Photos/54419152_419702152118750_159370134522167296_n.jpg
