EOSCogniton/STUF2019/SU - Suspension/05 - Essais/Excels essais Optimus/Temoins et tests triangles/Photos/54432568_2110097029281592_8408698456851349504_n.jpg

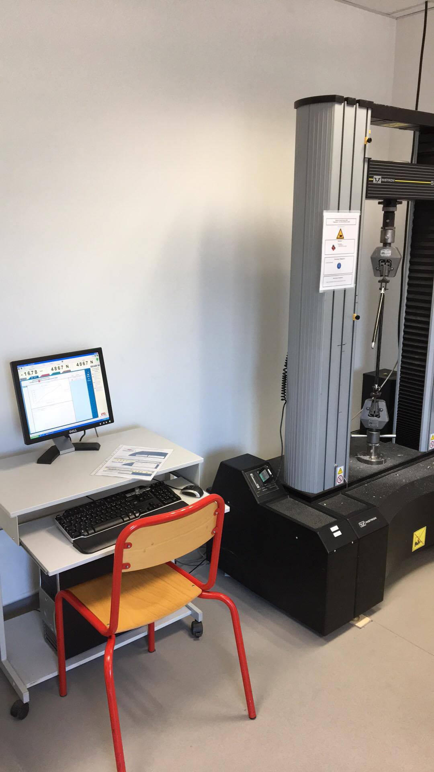
SU - Suspension/05 - Essais/Excels essais Optimus/Temoins et tests triangles/Photos/54432568_2110097029281592_8408698456851349504_n.jpg
