EOSCogniton/STUF2019/SU - Suspension/05 - Essais/Excels essais Optimus/Temoins et tests triangles/Photos/received_2023852401252671.jpeg

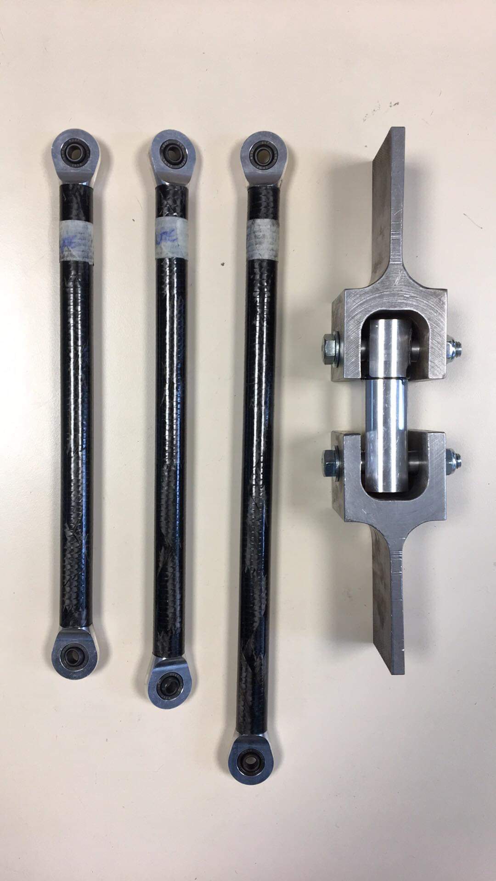
SU - Suspension/05 - Essais/Excels essais Optimus/Temoins et tests triangles/Photos/received_2023852401252671.jpeg
