EOSCogniton/STUF2019/CR - Cost Report/Oral/3_Financial and production risk management/margin vs volume.xlsx

Volume | Company A | Company B
5000 | -5 | -2
10000 | 15 | 12
