EOSCogniton/STUF2019/SU - Suspension/14 - Gabarits/Gabarits Chape Olhins Ar/maintient_pdf.pdf

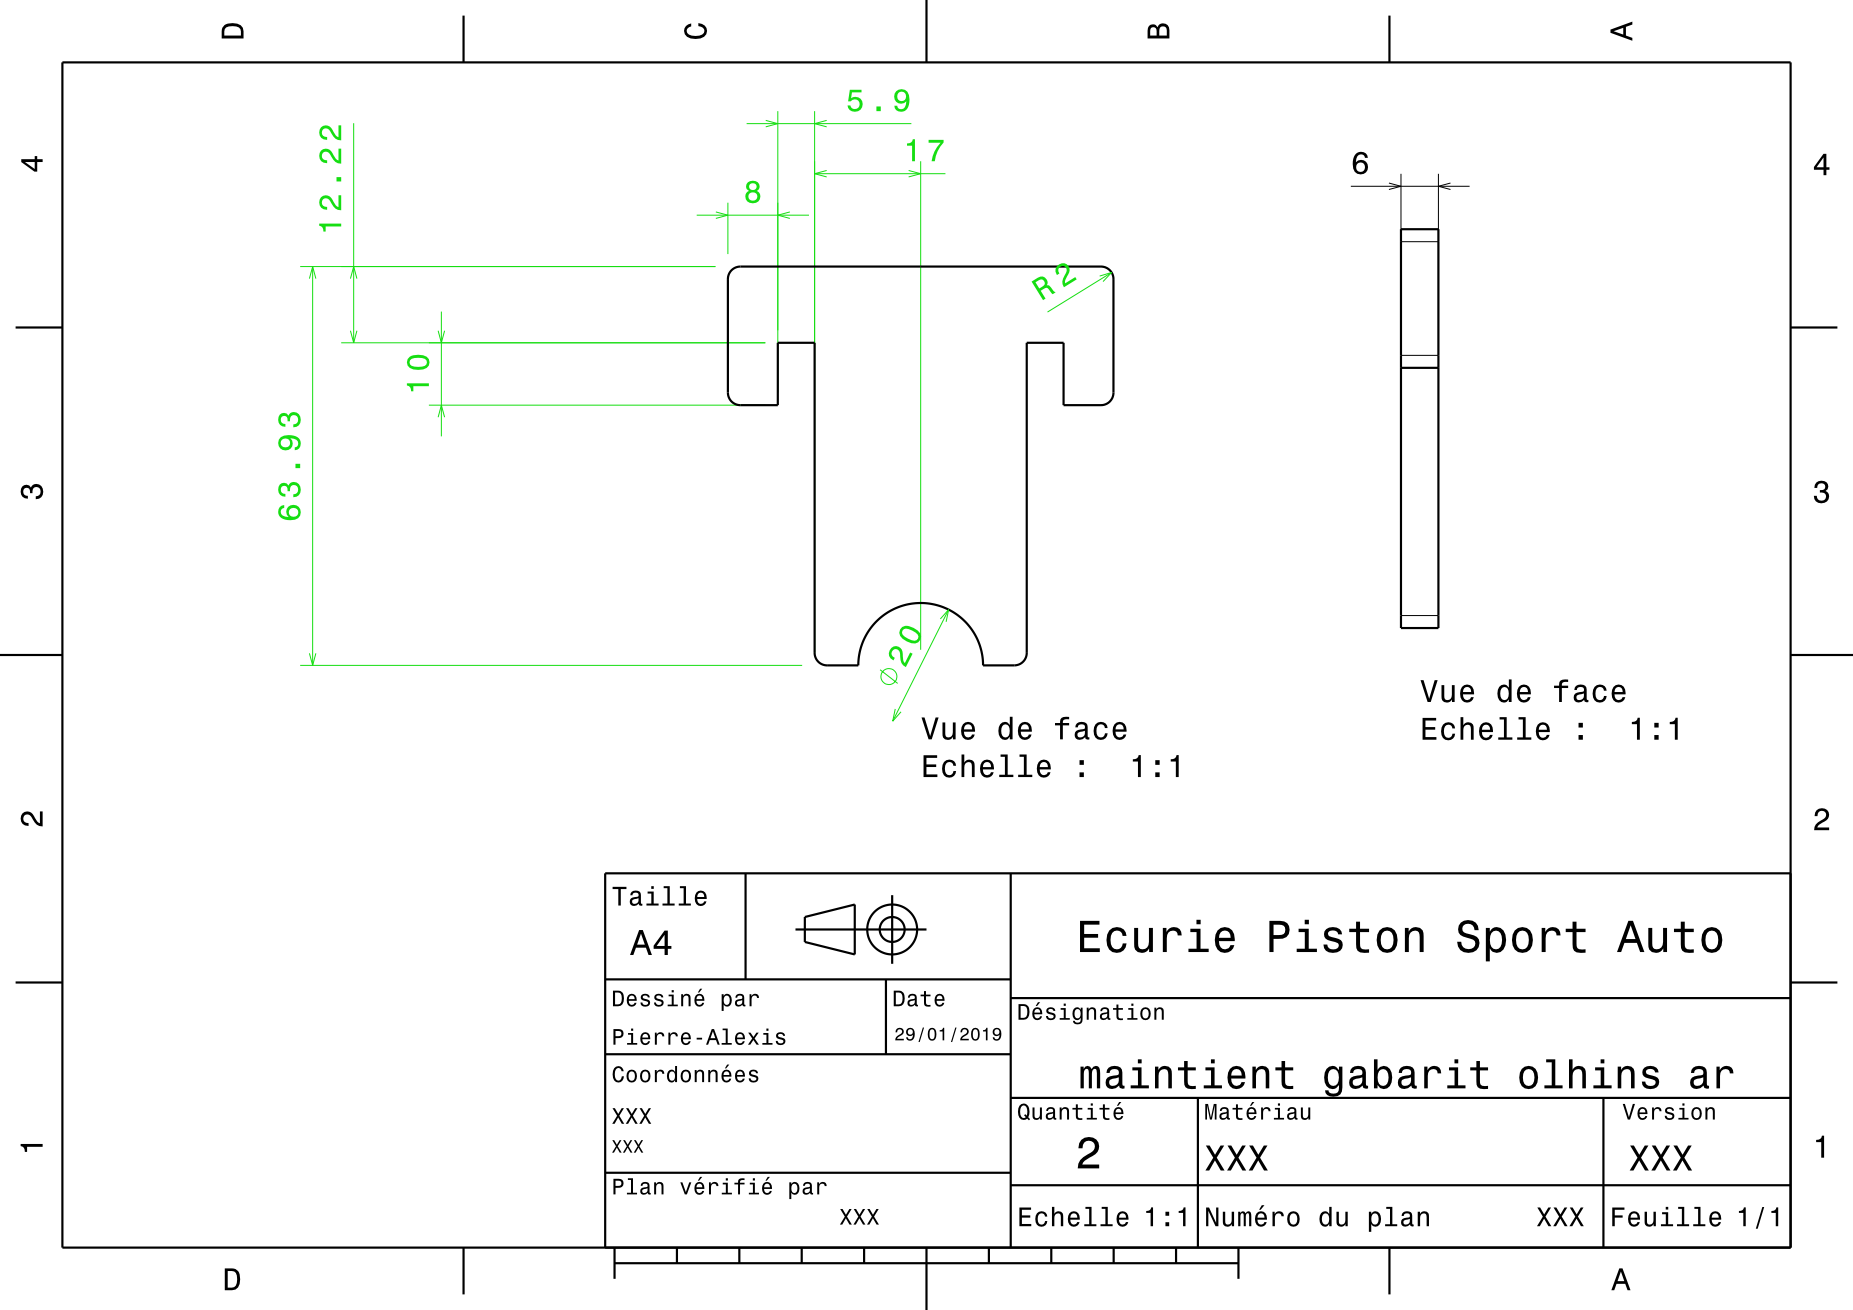
[picture p763: page 1]
