EOSCogniton/STUF2019/AA - Mise en plan/Boisard/Plans essais Boisard/MEP essais collage rotules/PieceBlocMaintienPlaque.pdf

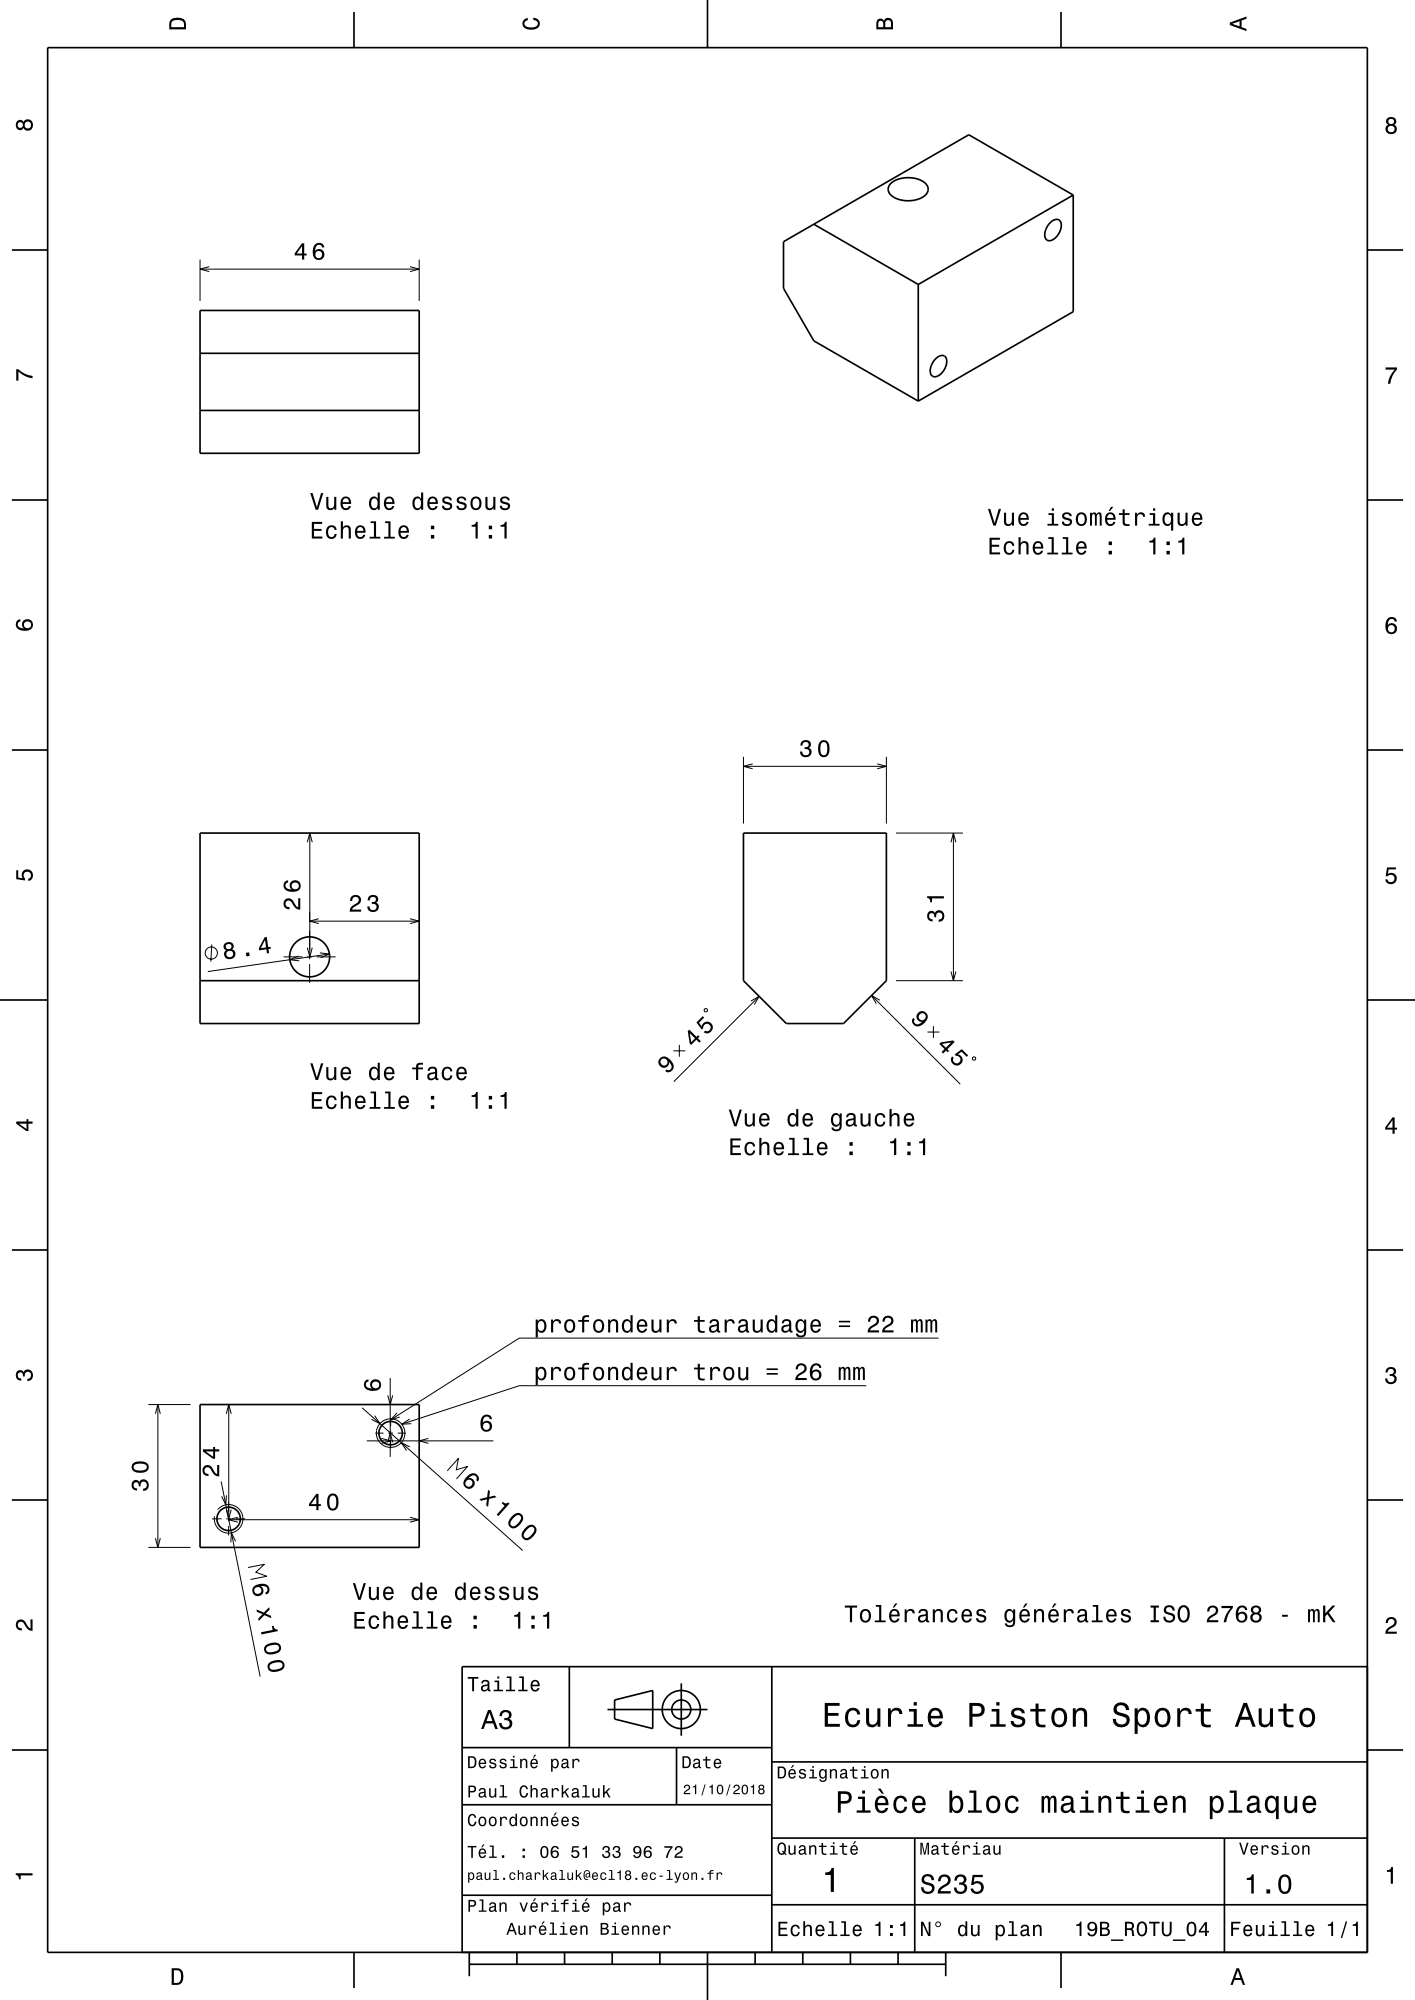
[picture p764: page 1]
