EOSCogniton/STUF2019/AA - Mise en plan/Boisard/Plans essais Boisard/MEP essais collage rotules/PieceBlocMaintienVisRotule.pdf

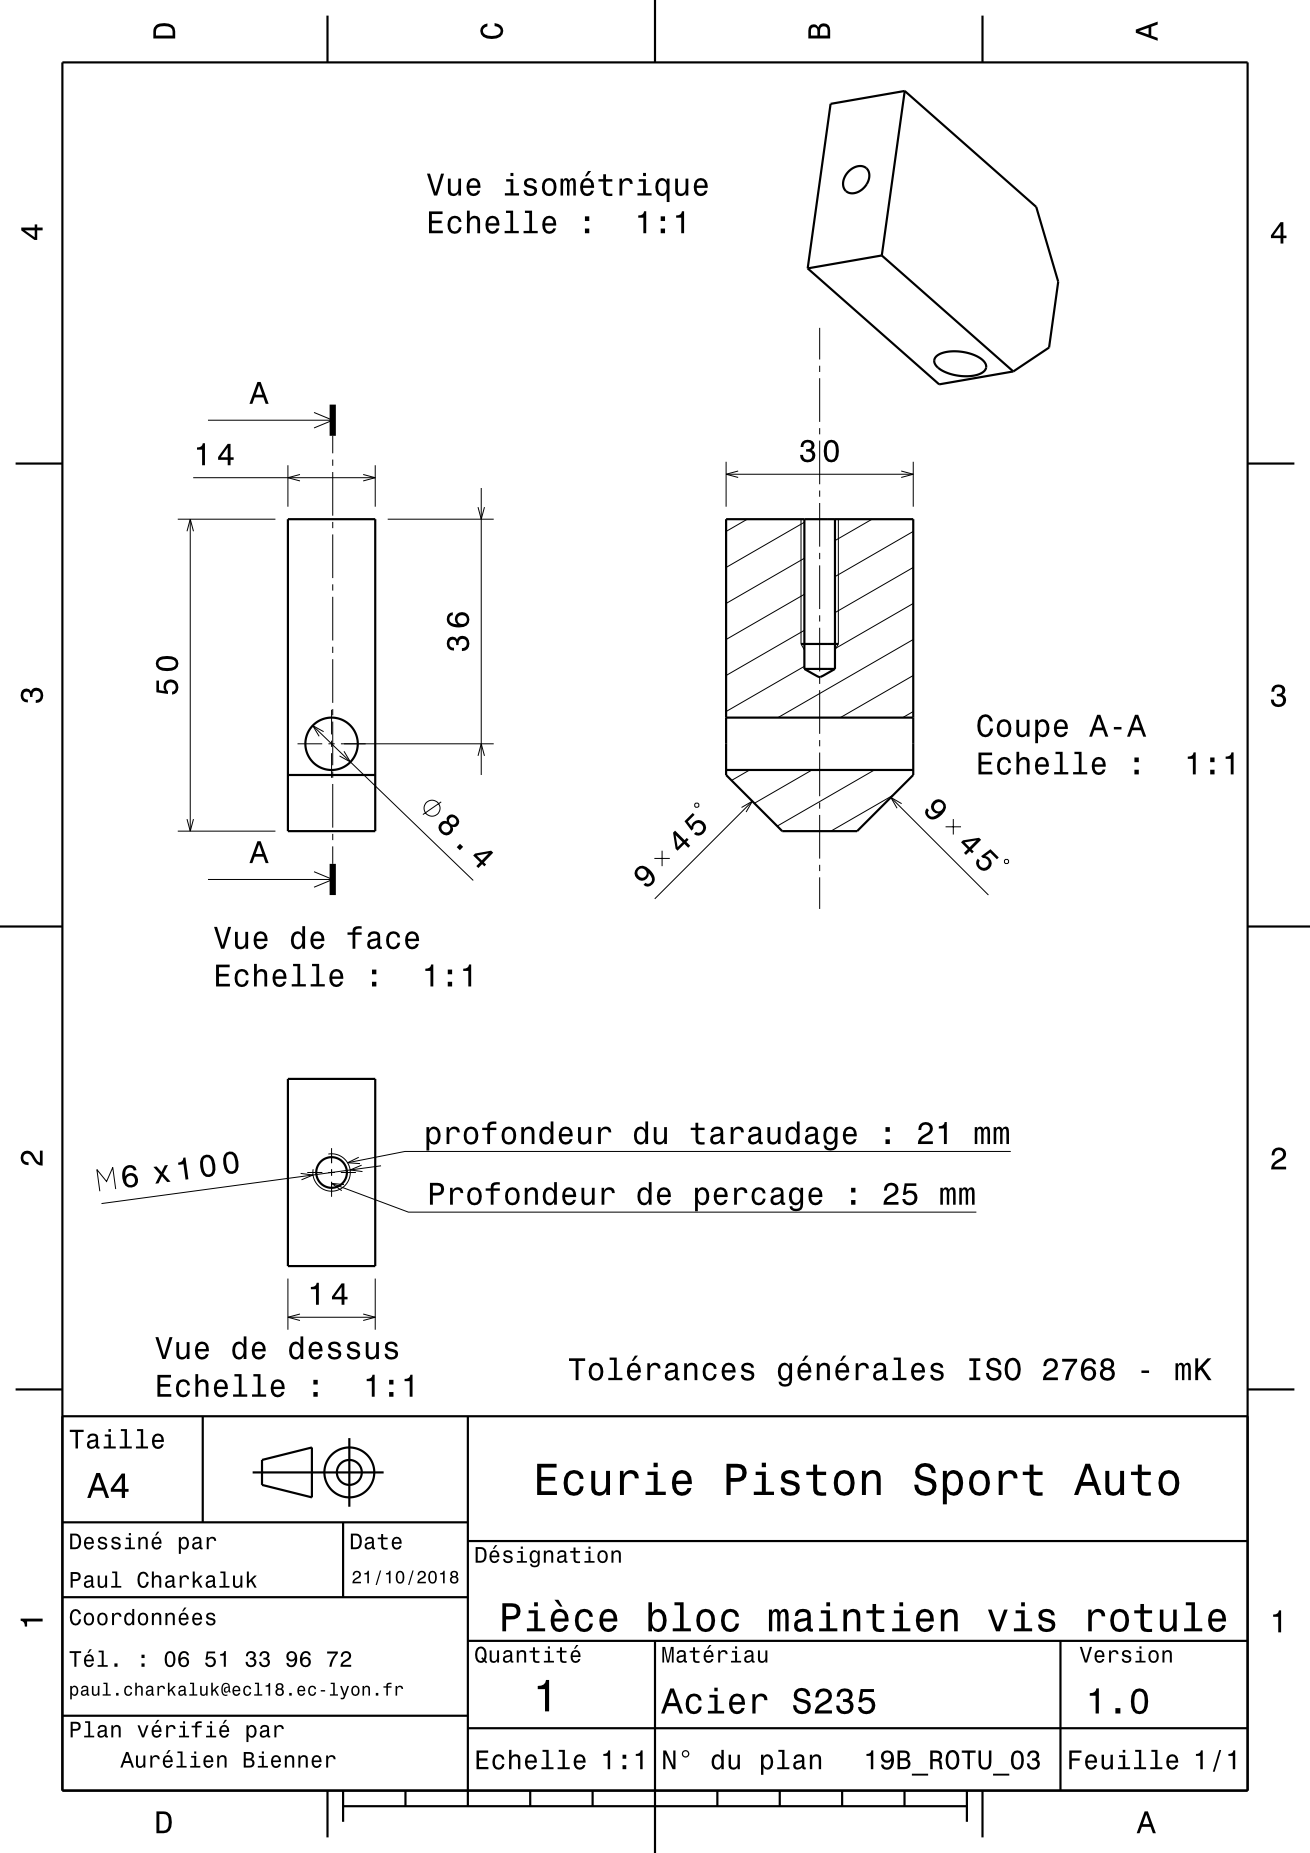
[picture p765: page 1]
