EOSCogniton/STUF2019/MS - Miscelleanous, Finish and Assembly/MS-A0300 (Head restraint)/Appuie_tete_v2_ABR.pdf

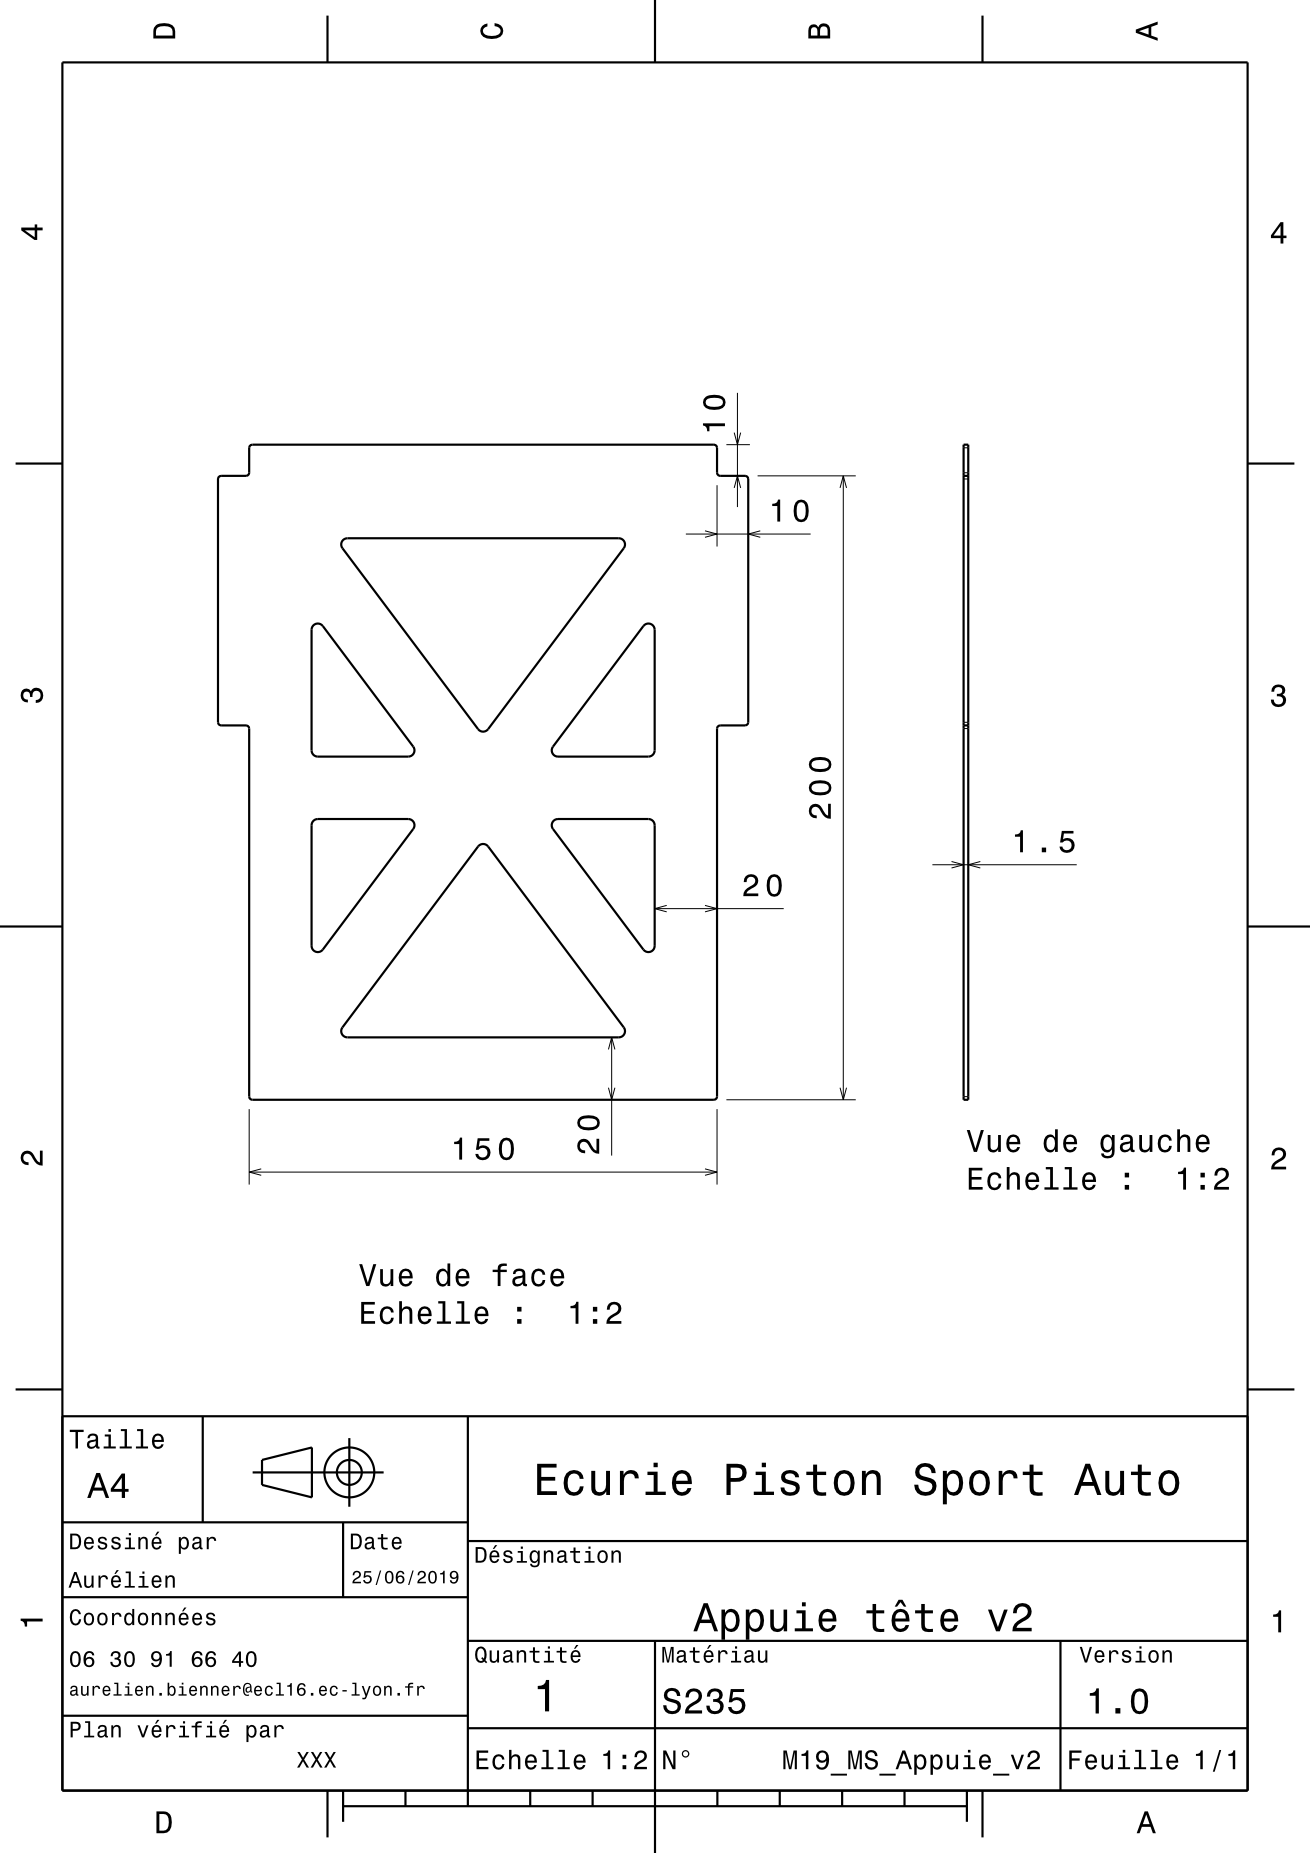
[picture p766: page 1]
