EOSCogniton/STUF2019/AA - Mise en plan/Centrale/Entretoise_montage_roulement.pdf

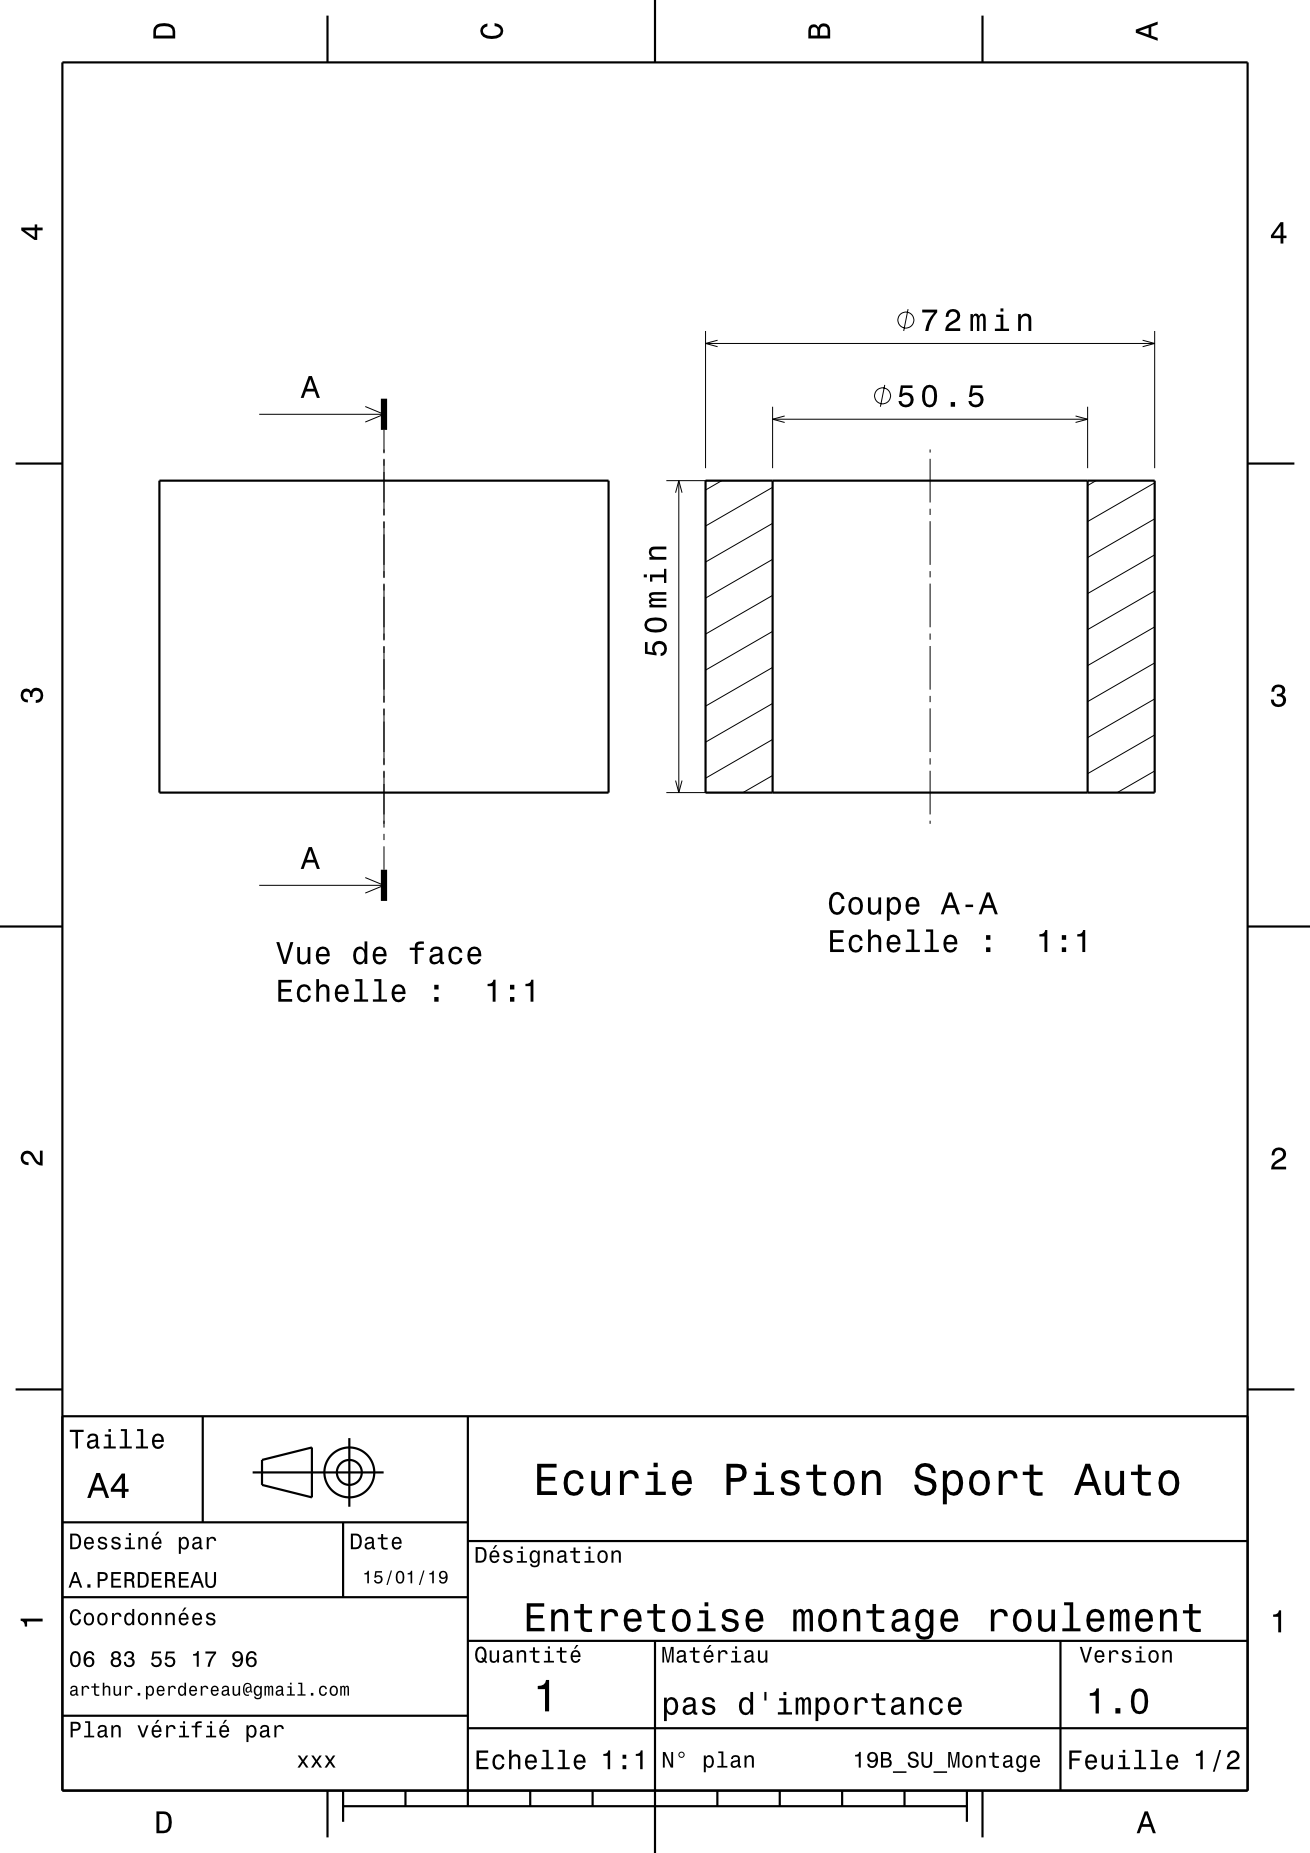
[picture p767: page 1]
