EOSCogniton/STUF2019/ST - Steering/ST_A0200 (Steering column assembly)/Colonne_direction_acier.pdf

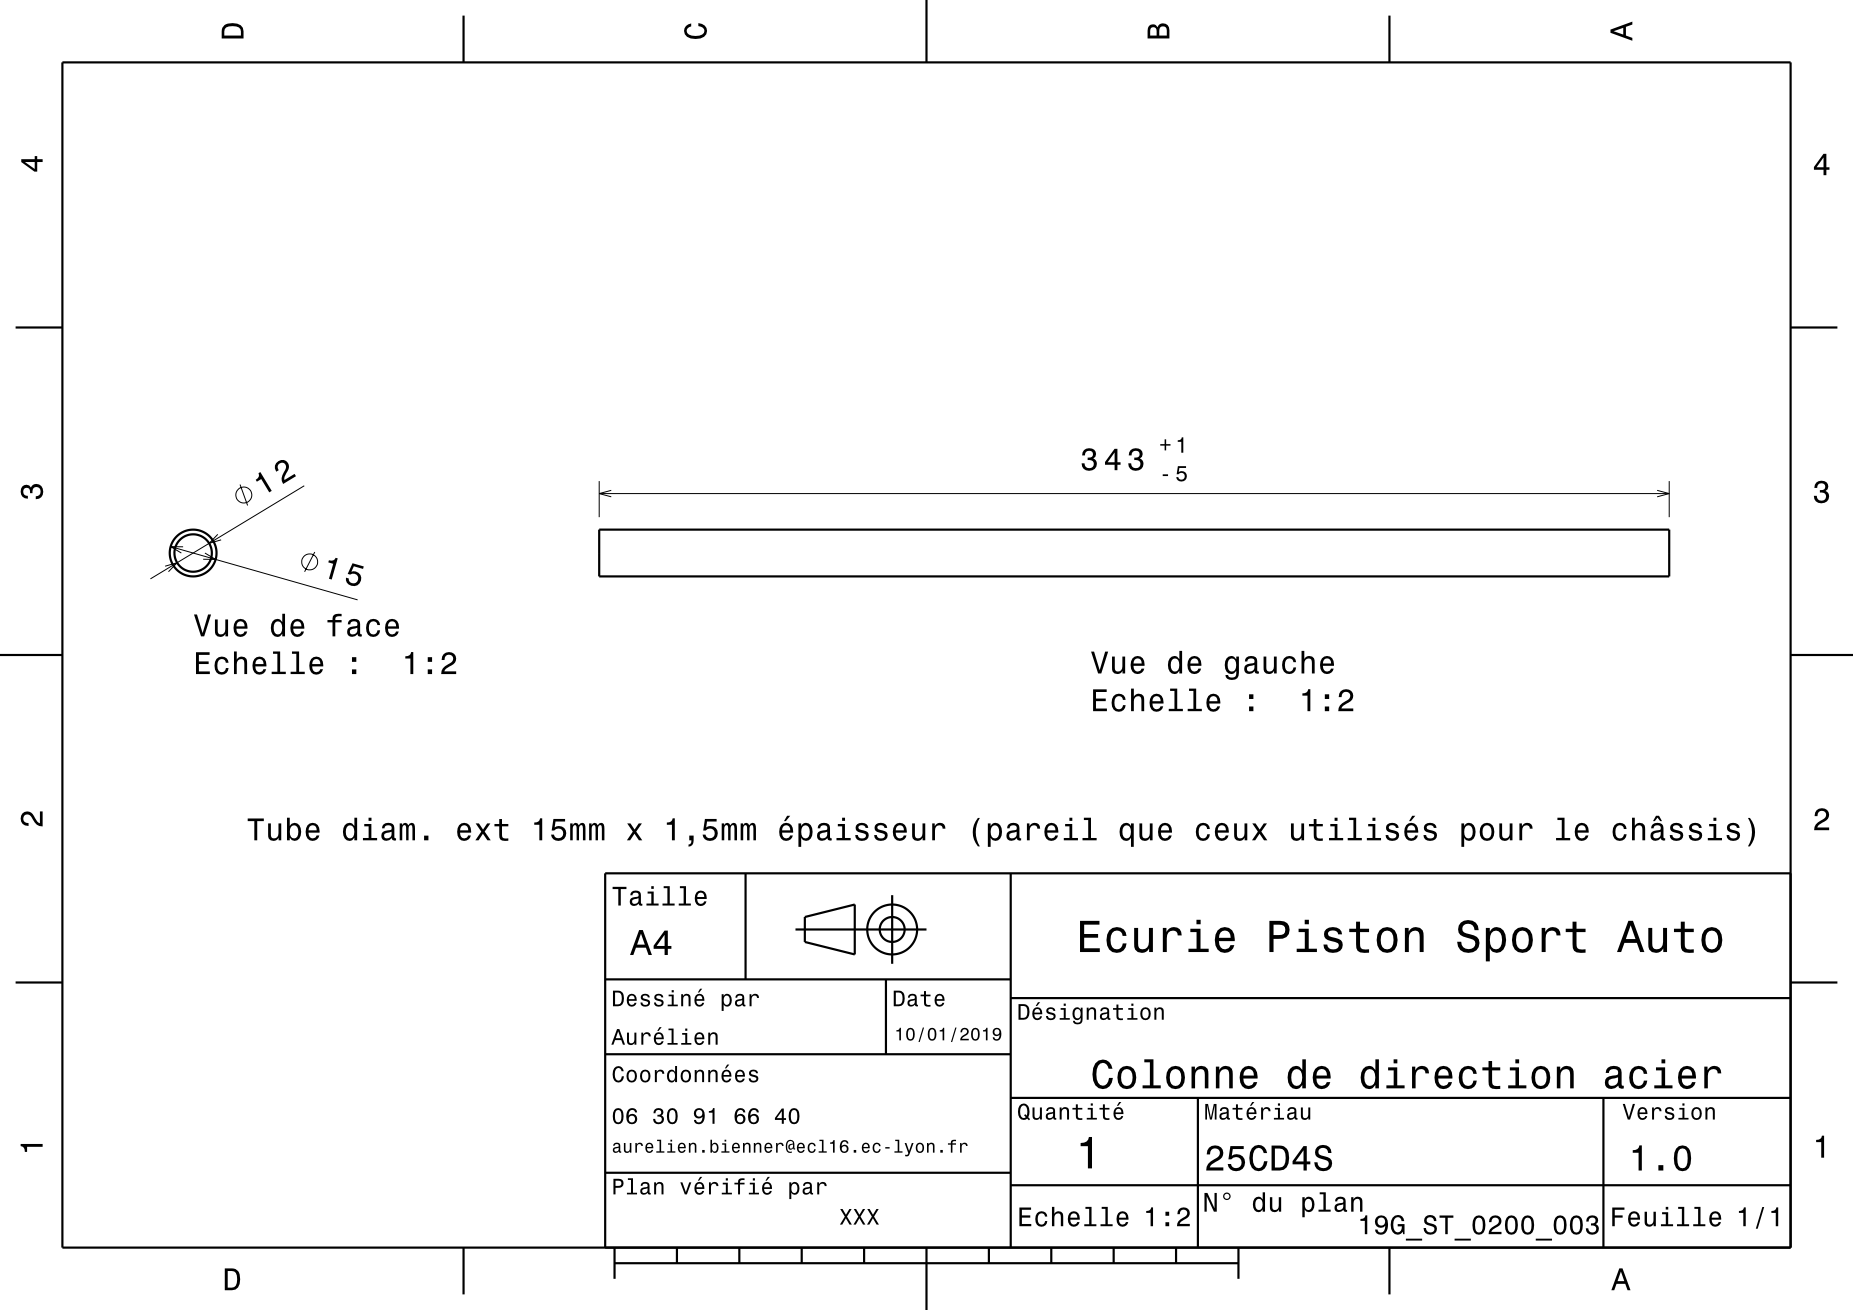
[picture p768: page 1]
