EOSCogniton/STUF2019/AA - Mise en plan/AlpenTech/Insert_chassis.pdf

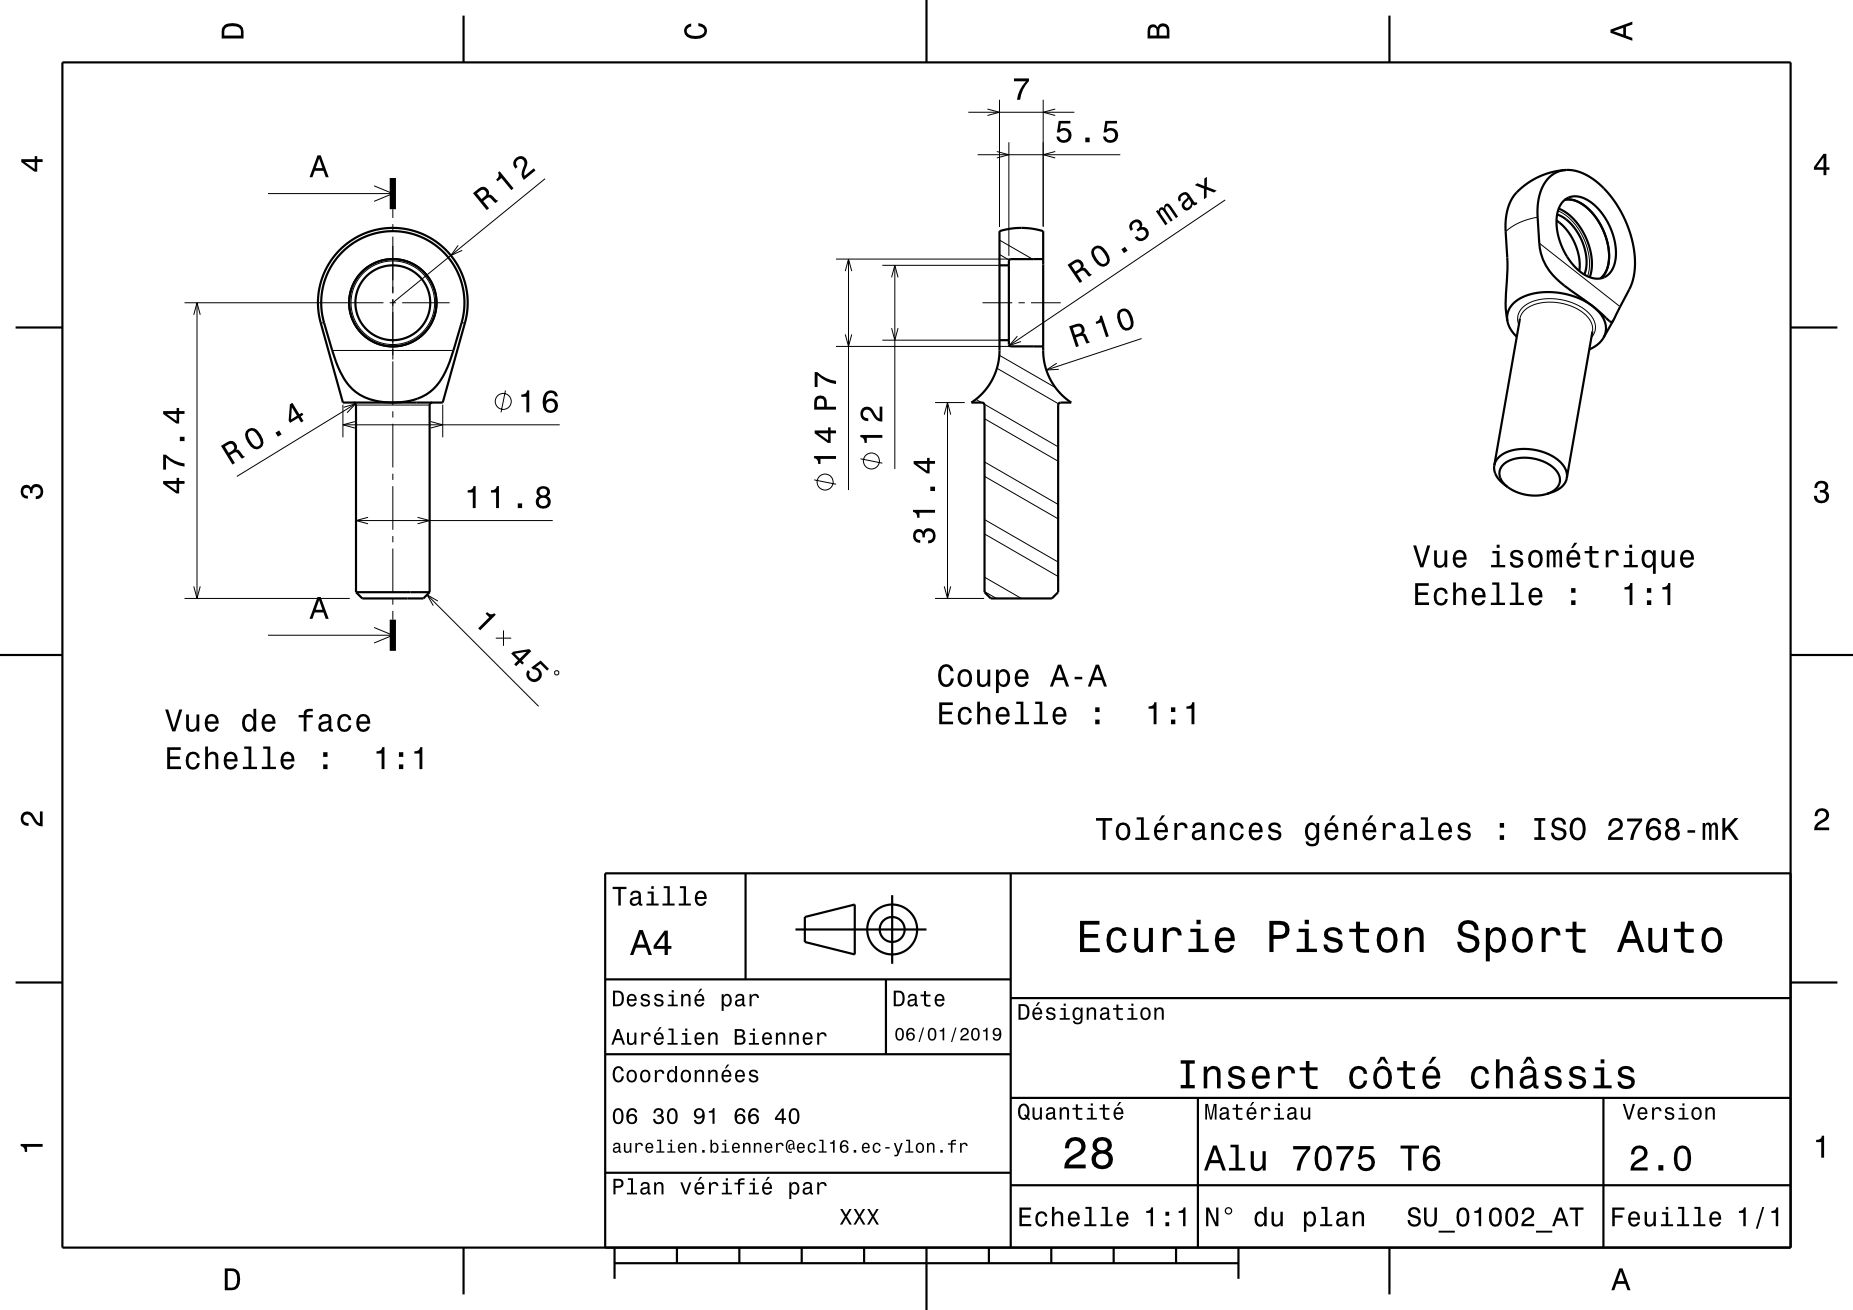
[picture p769: page 1]
