EOSCogniton/STUF2019/FR - Frame & Body/FR_A0100 (Frame)/Crise chassis 2/cellule arriere.pdf

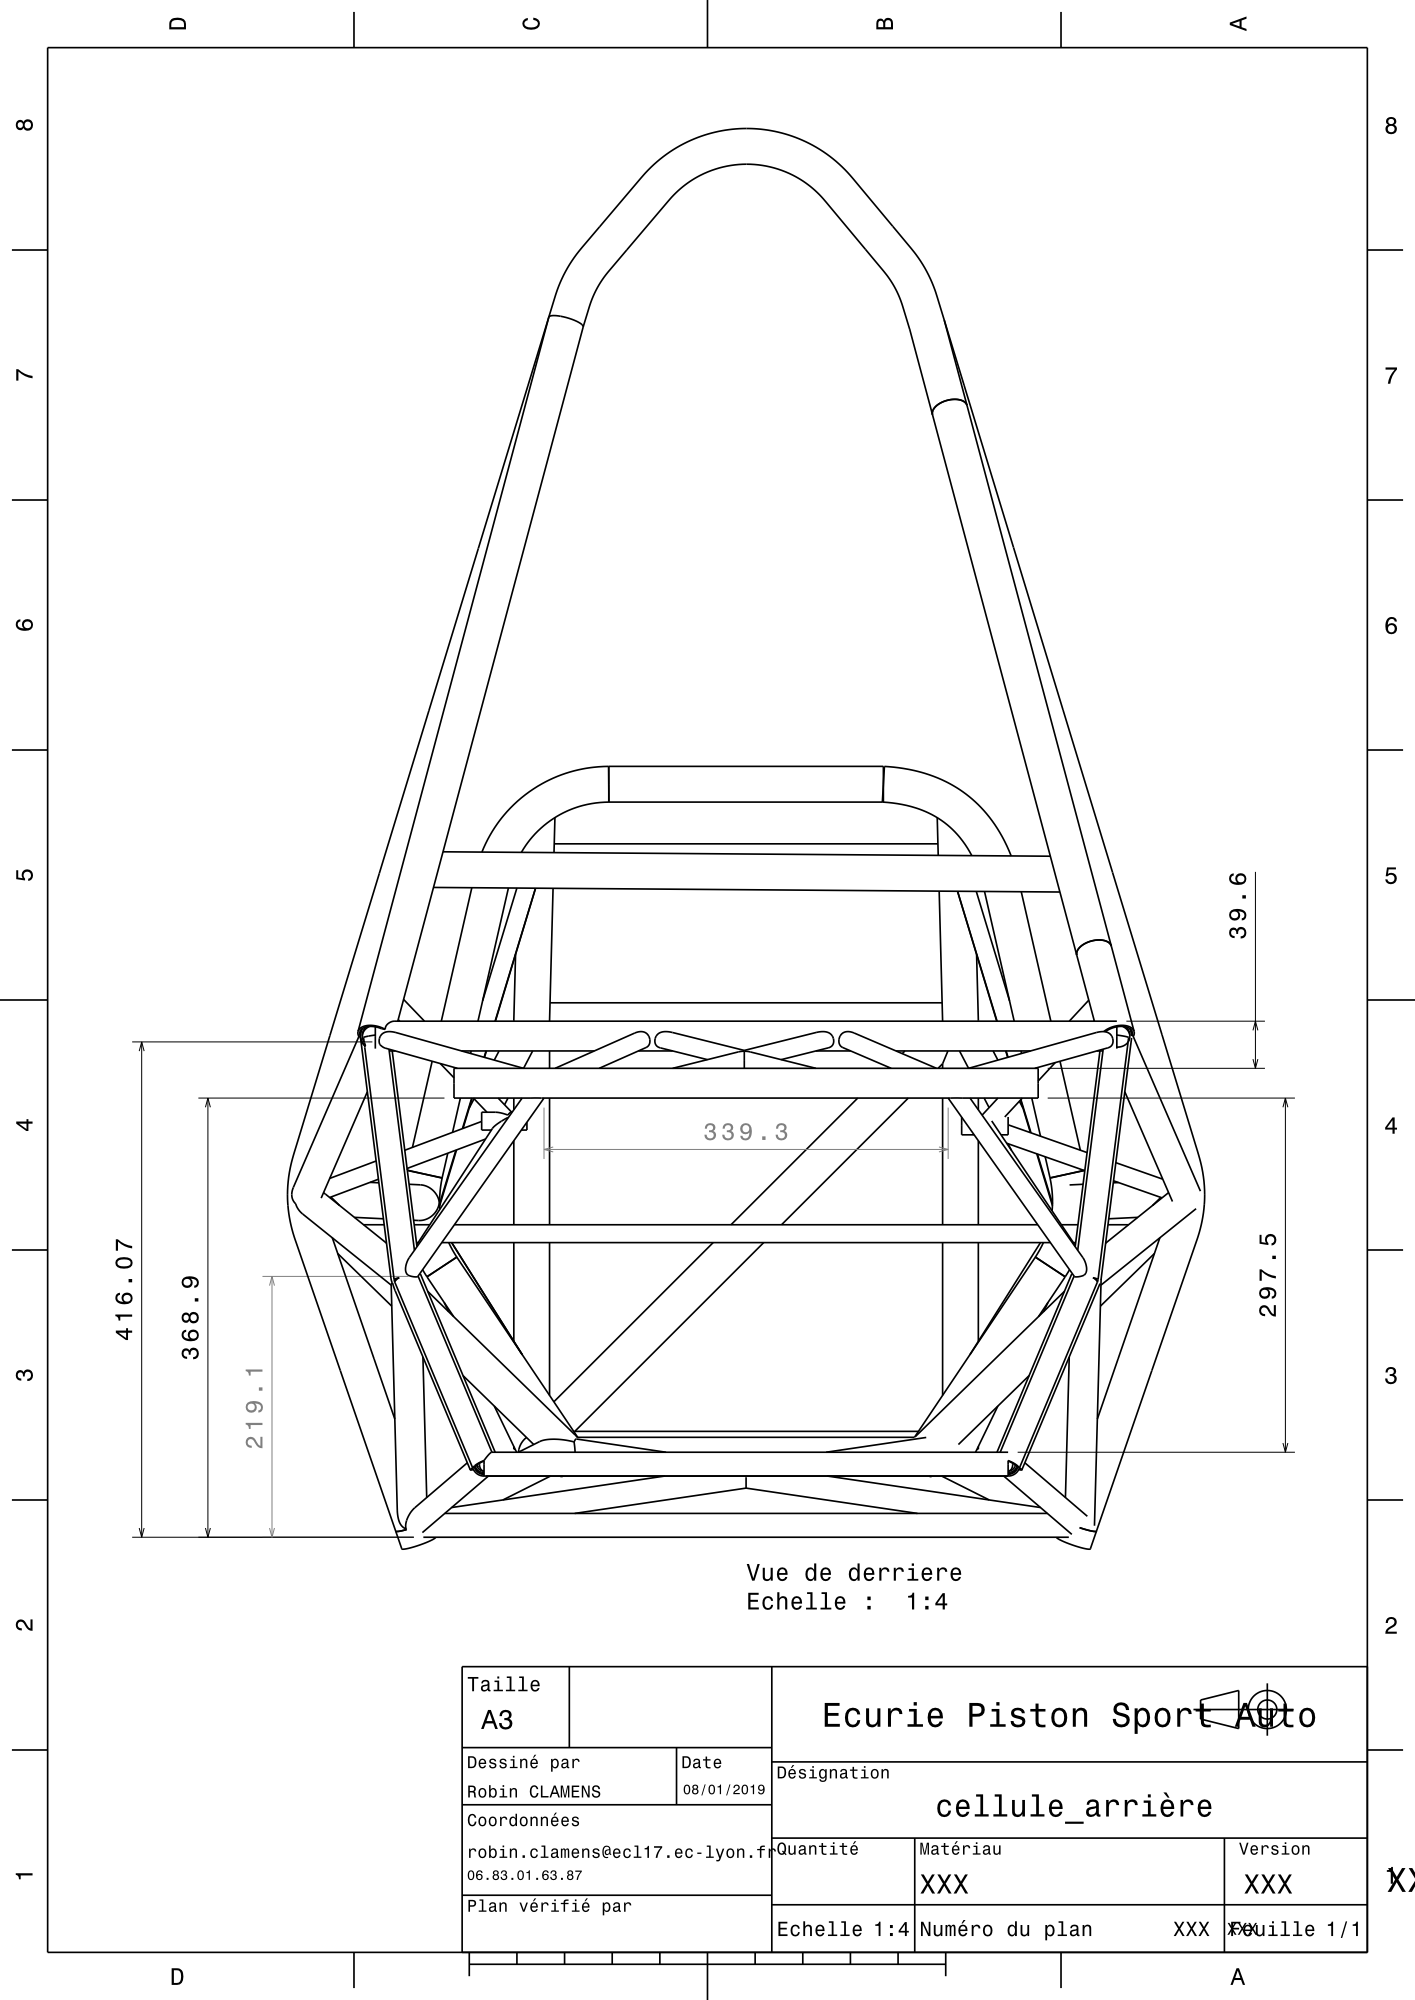
[picture p770: page 1]
