EOSCogniton/STUF2019/FR - Frame & Body/FR_A0100 (Frame)/Crise chassis 2/renforts inferieurs.pdf

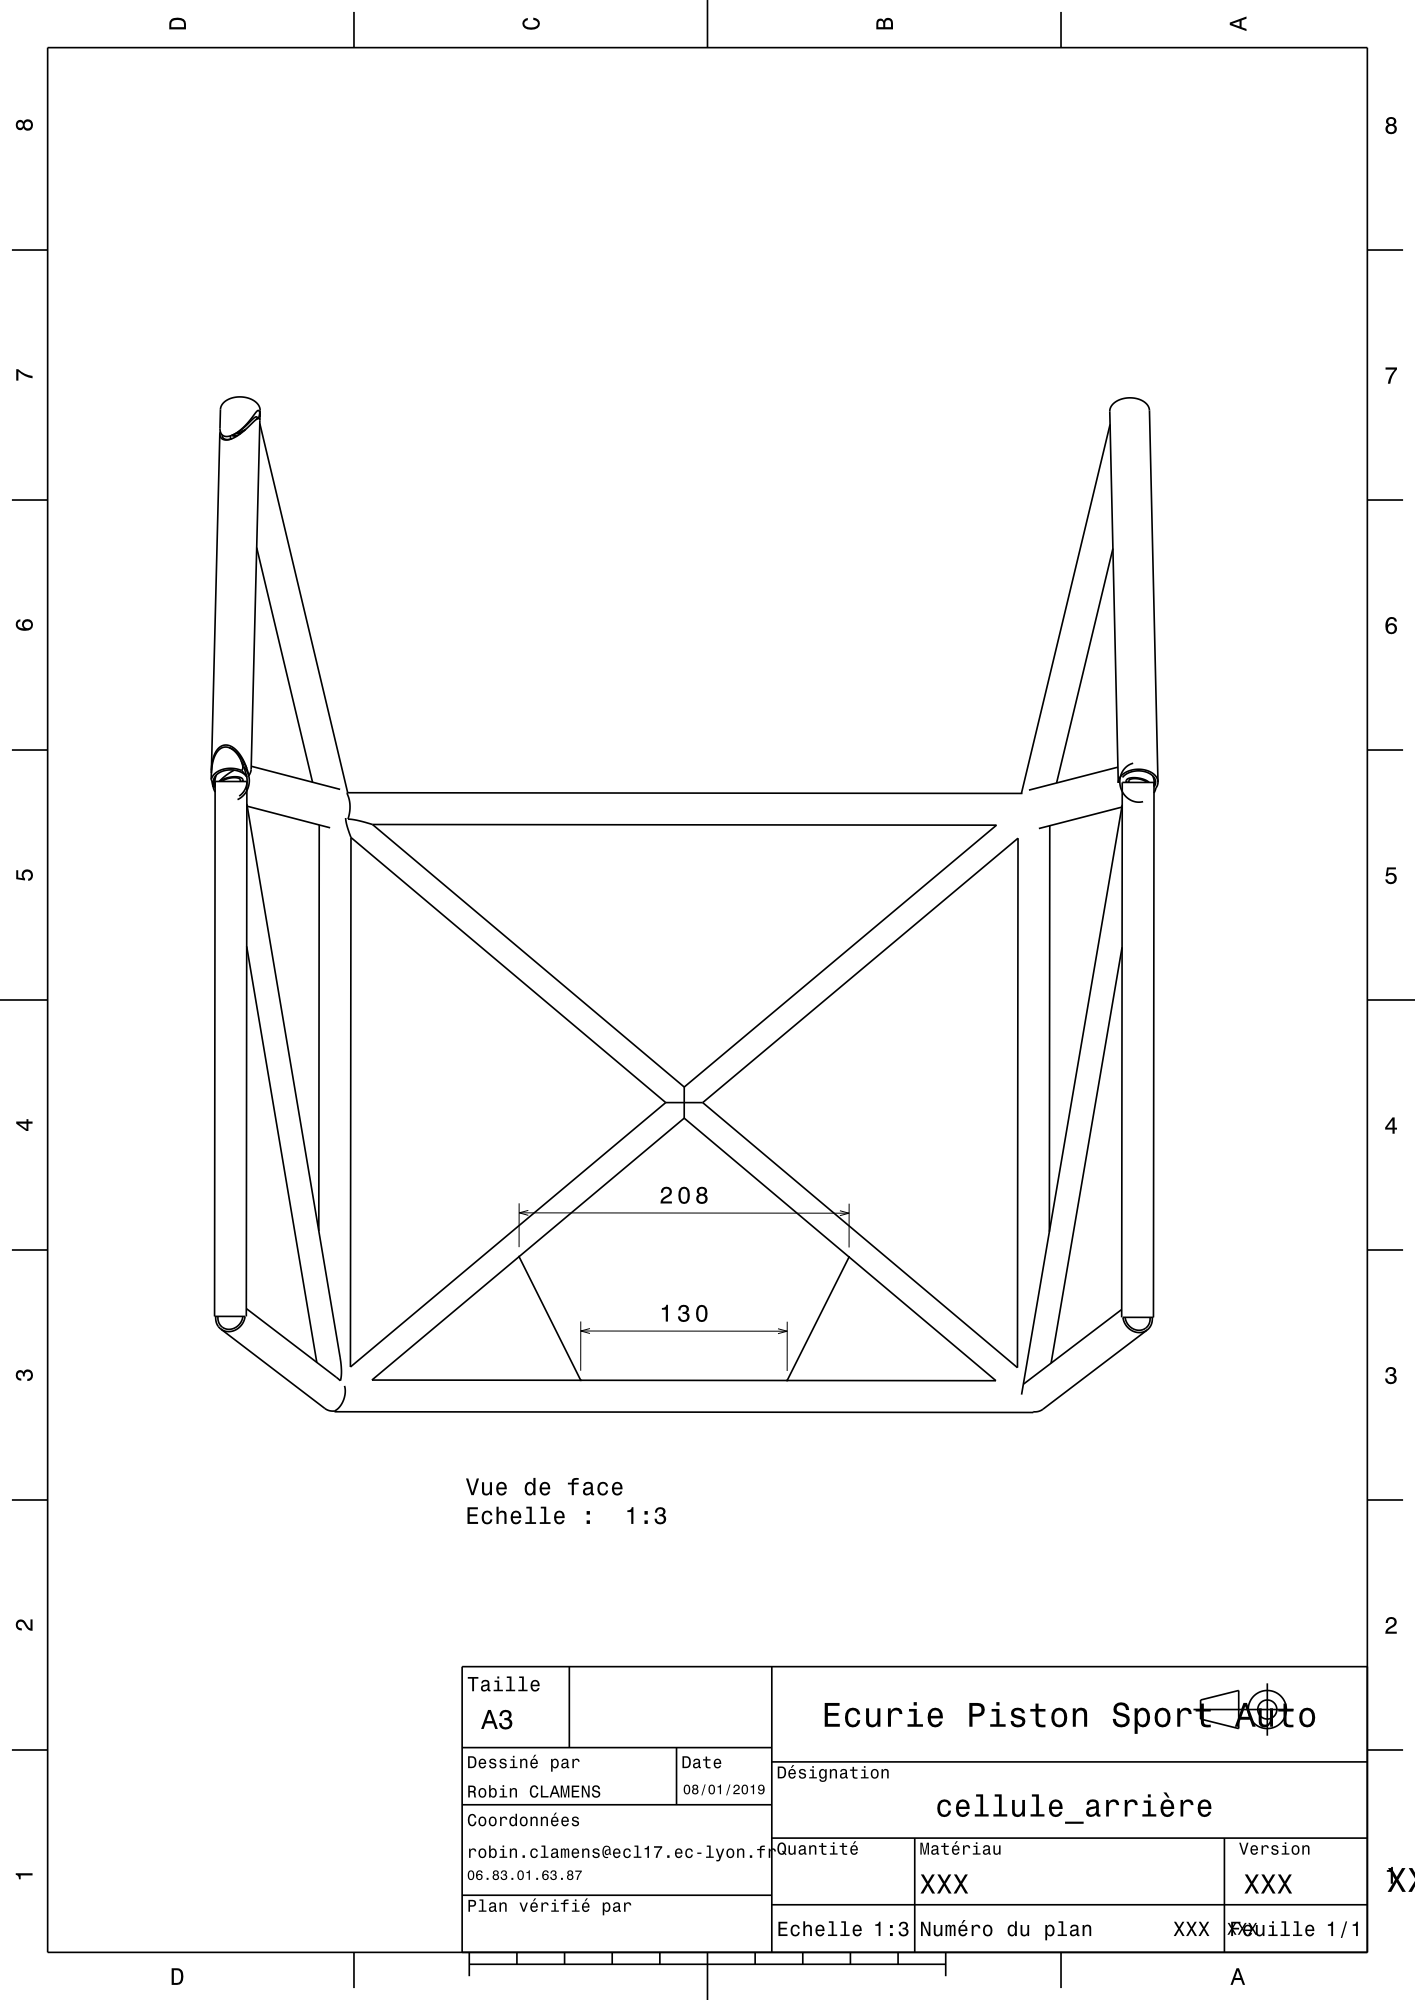
[picture p771: page 1]
