EOSCogniton/STUF2019/FR - Frame & Body/FR_A0100 (Frame)/Crise chassis 2/tubes renforts.pdf

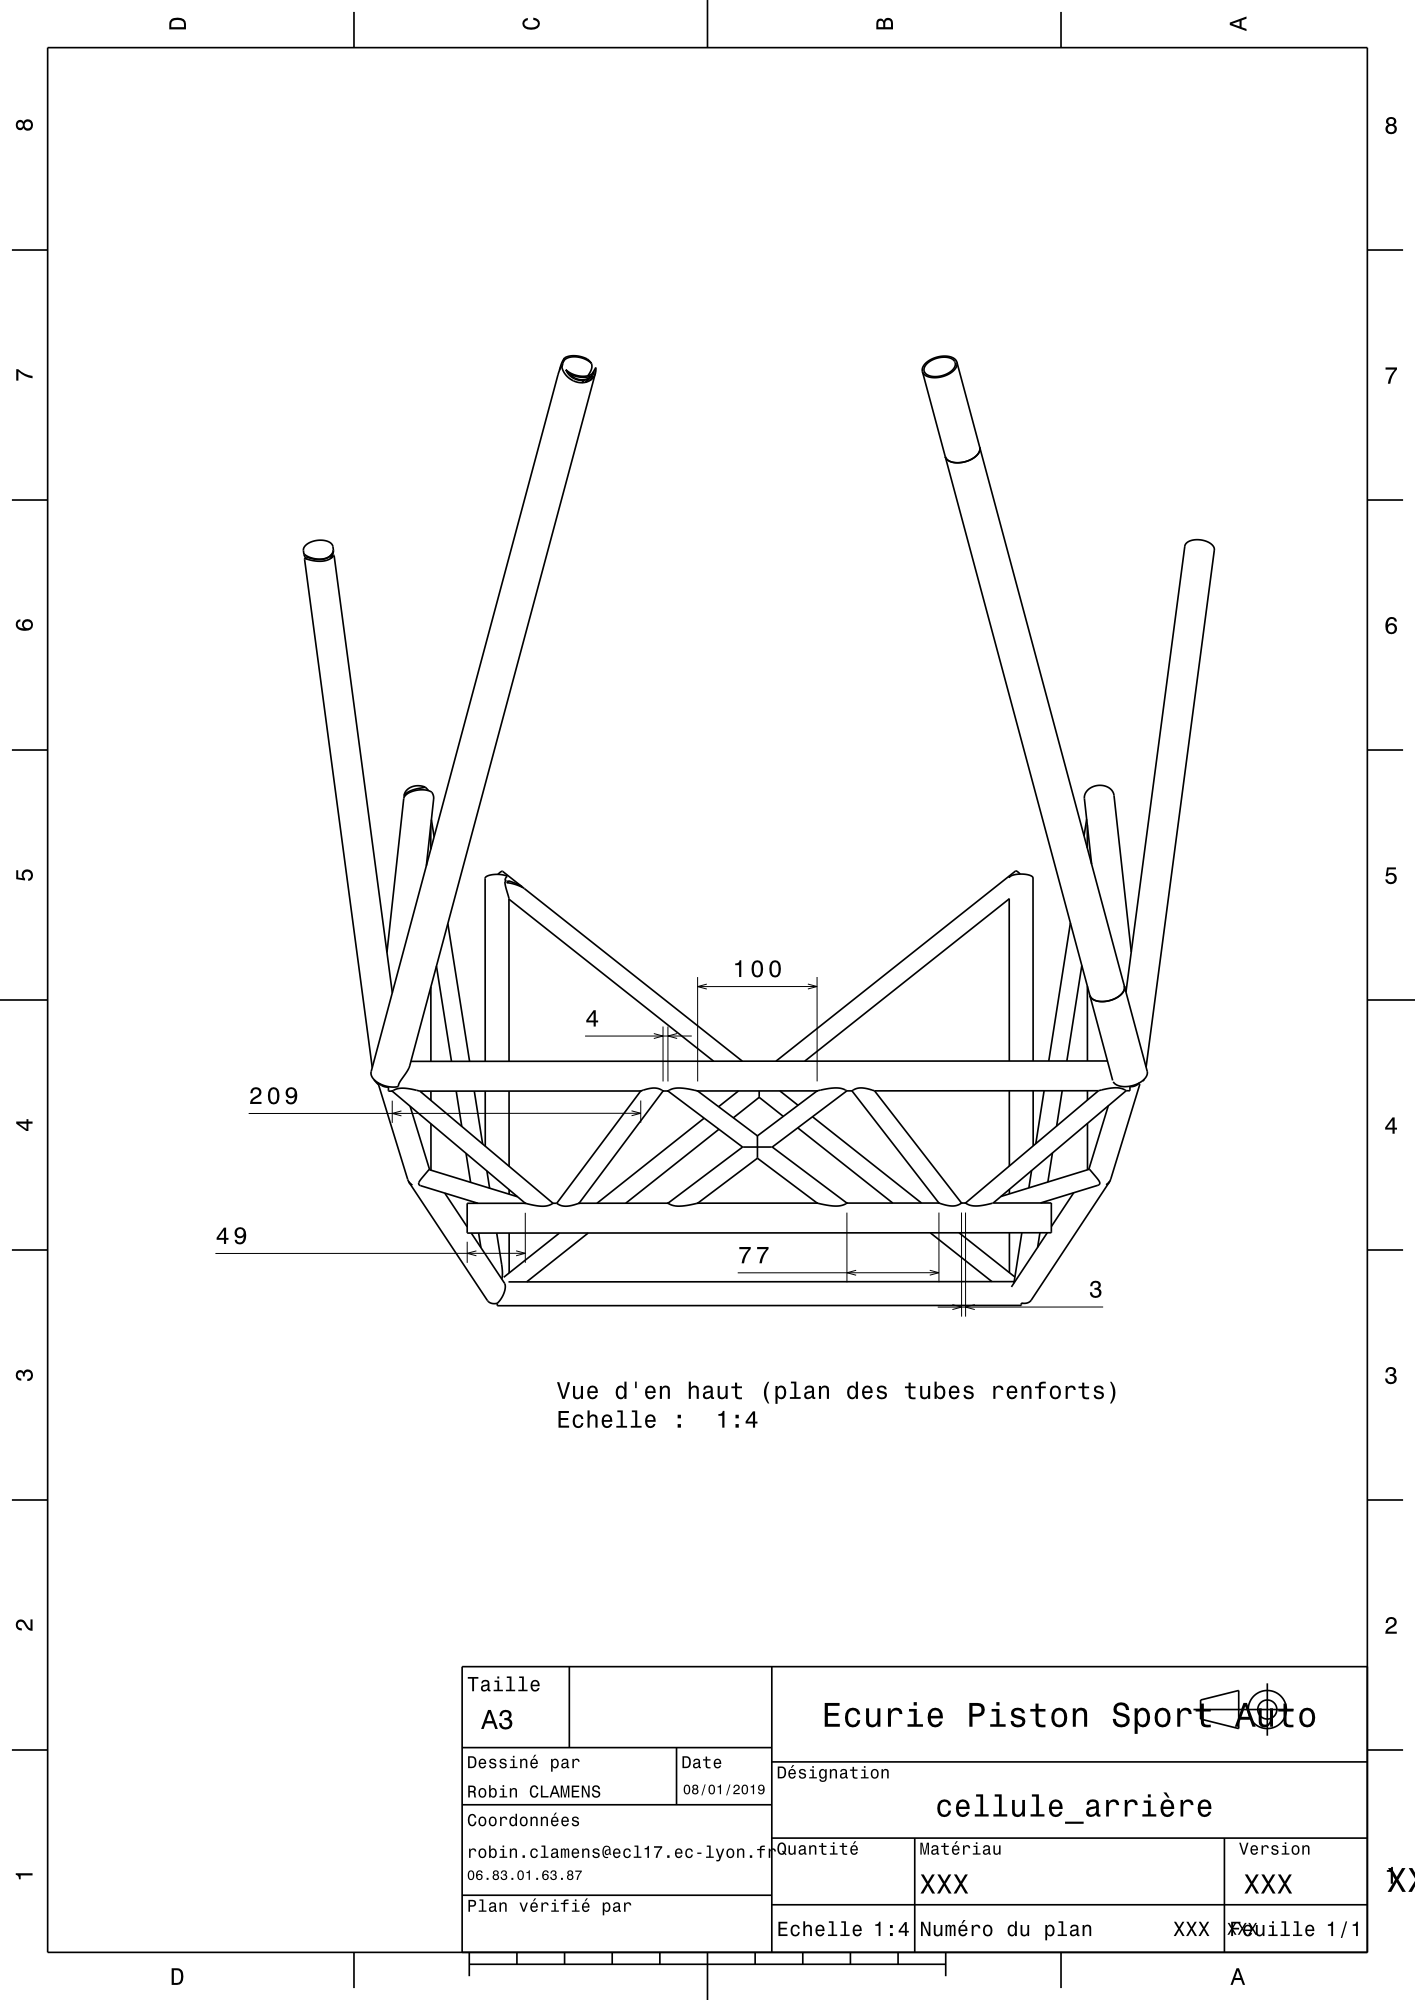
[picture p772: page 1]
