EOSCogniton/STUF2019/FR - Frame & Body/FR_A0100 (Frame)/Crise chassis 2/plan renforts.pdf

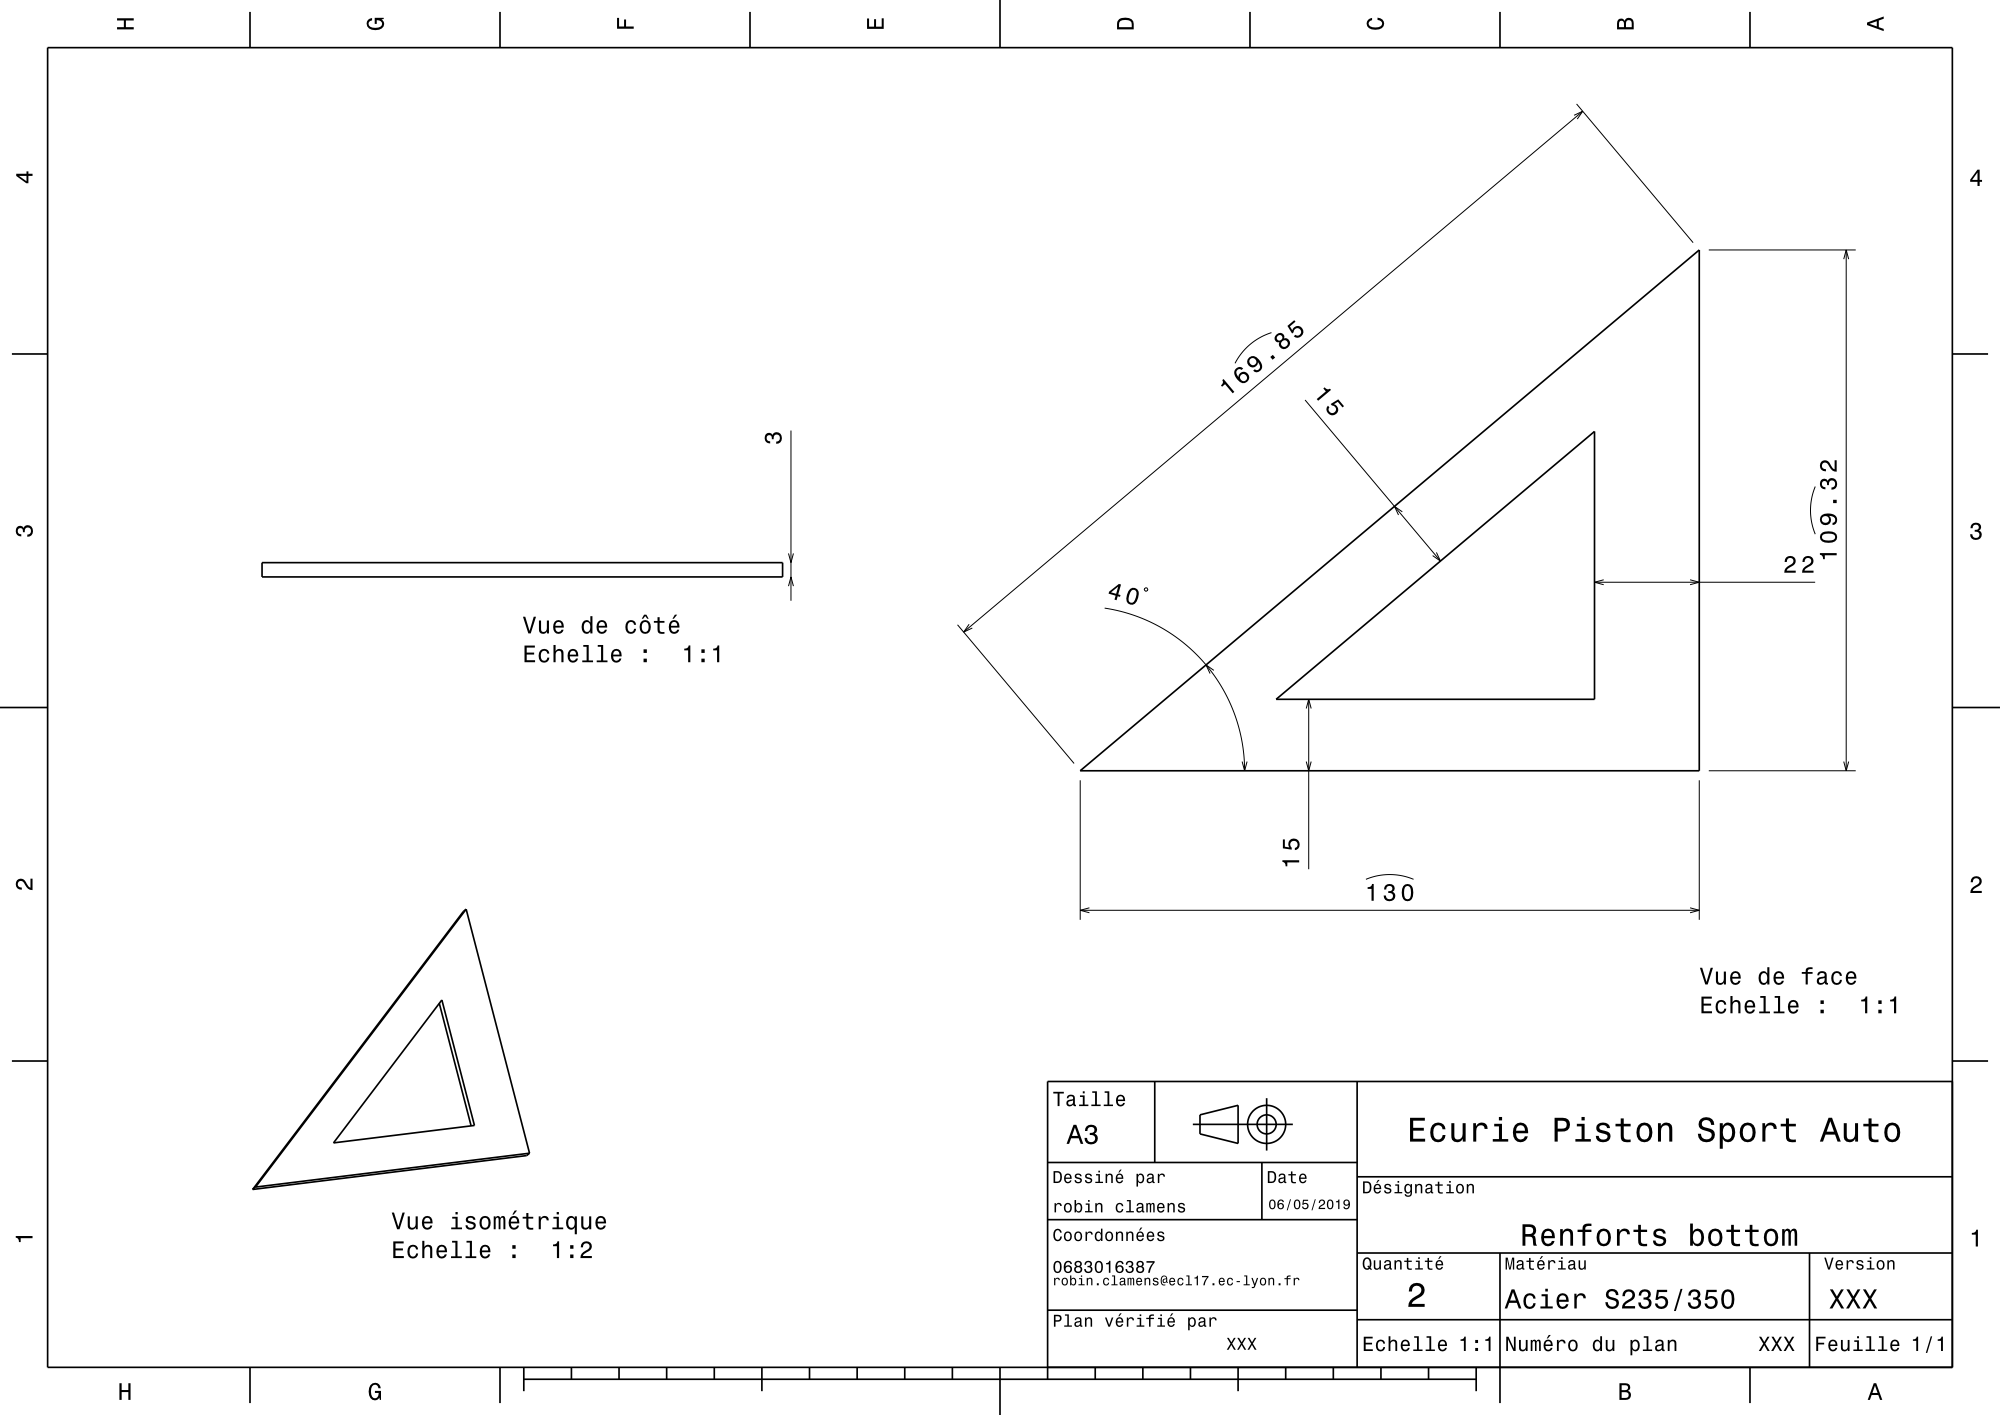
[picture p773: page 1]
