EOSCogniton/STUF2019/SU - Suspension/05 - Essais/Essais traction temoin collage triangles/Entretroise_montage_rotule_M6_presse.pdf

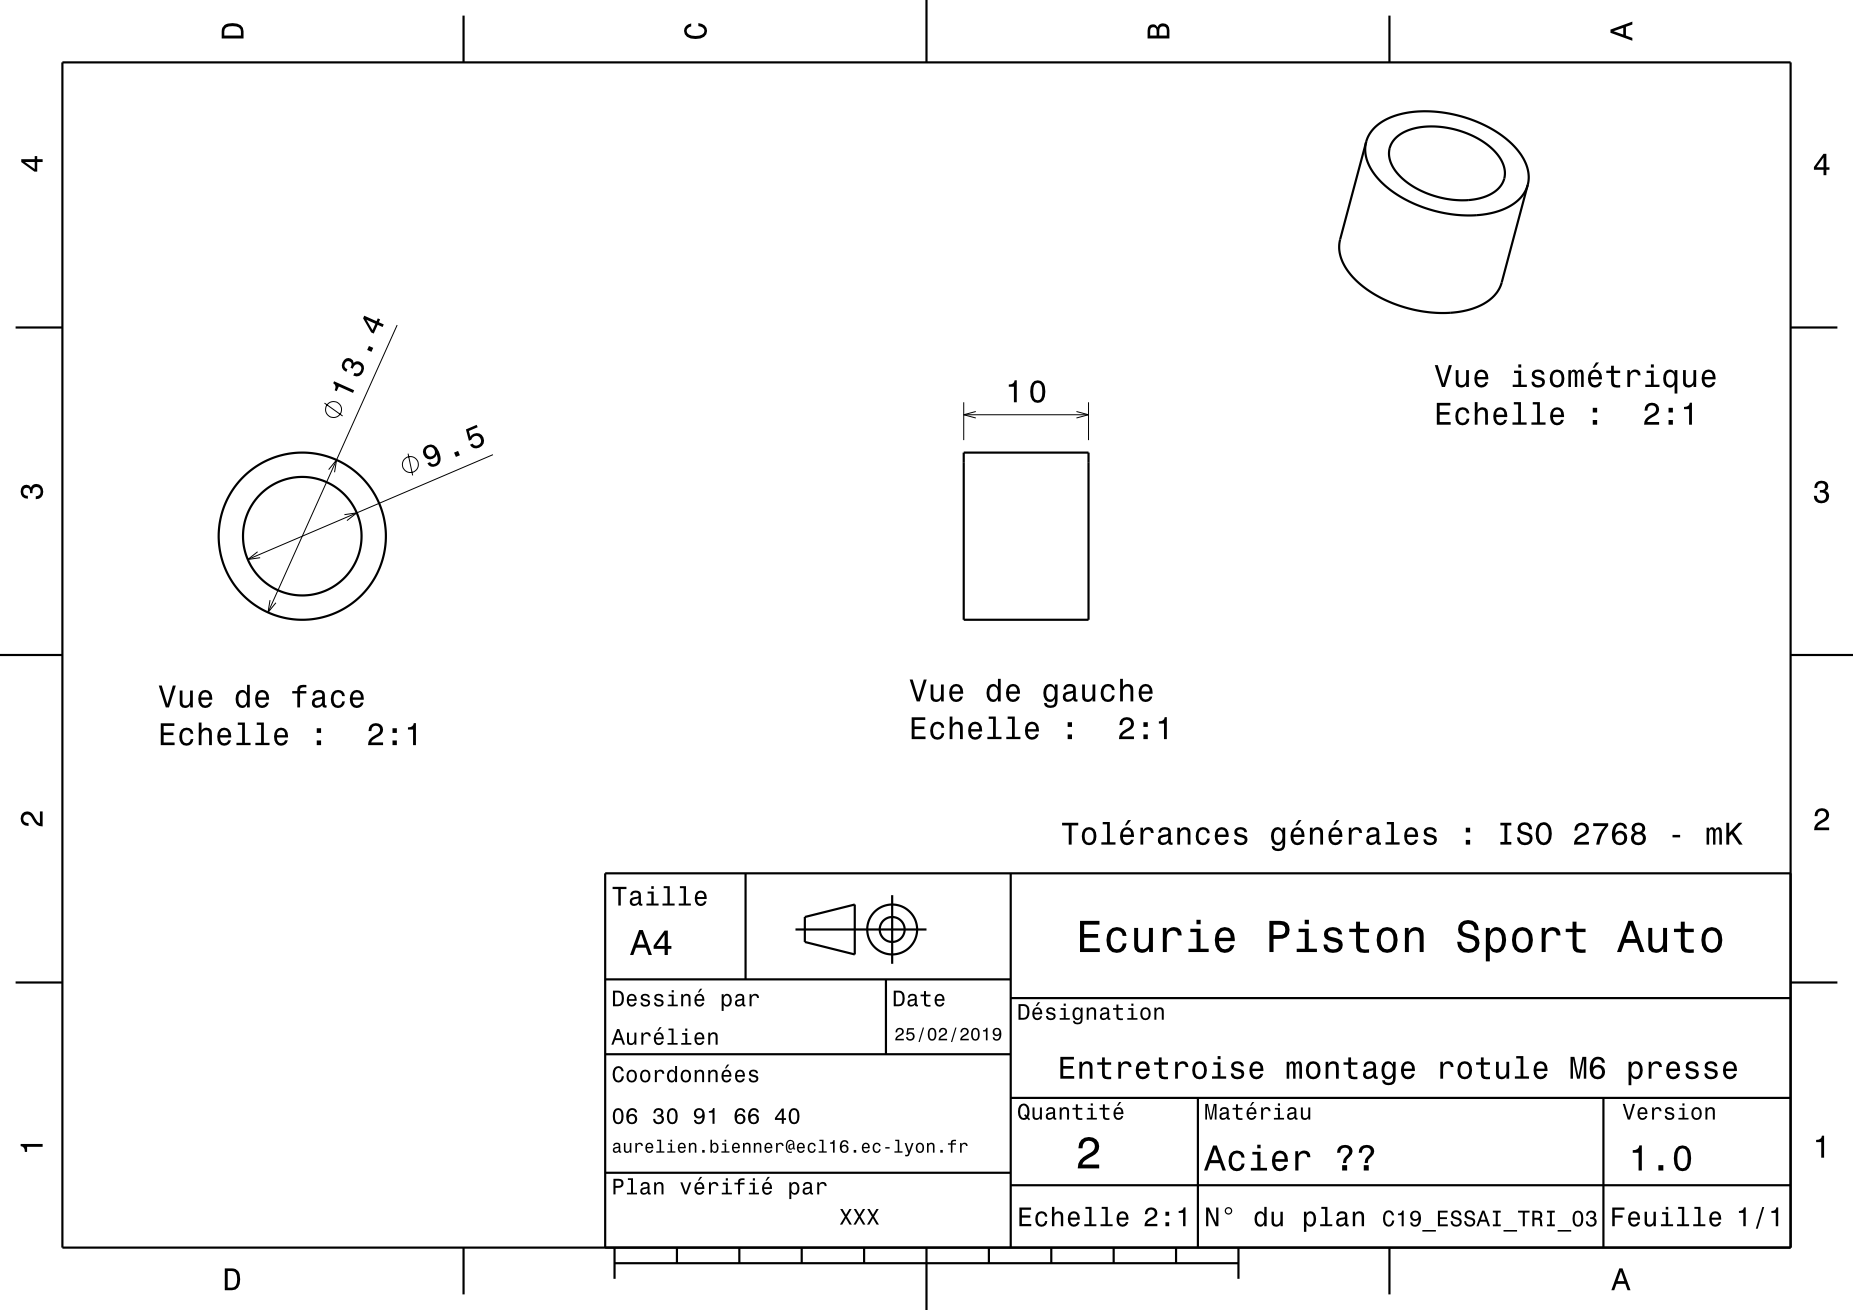
[picture p774: page 1]
