EOSCogniton/STUF2019/SU - Suspension/SU_A1100 (Rear Upright Assy)/gamme_montage/gamme_de_montage.pdf

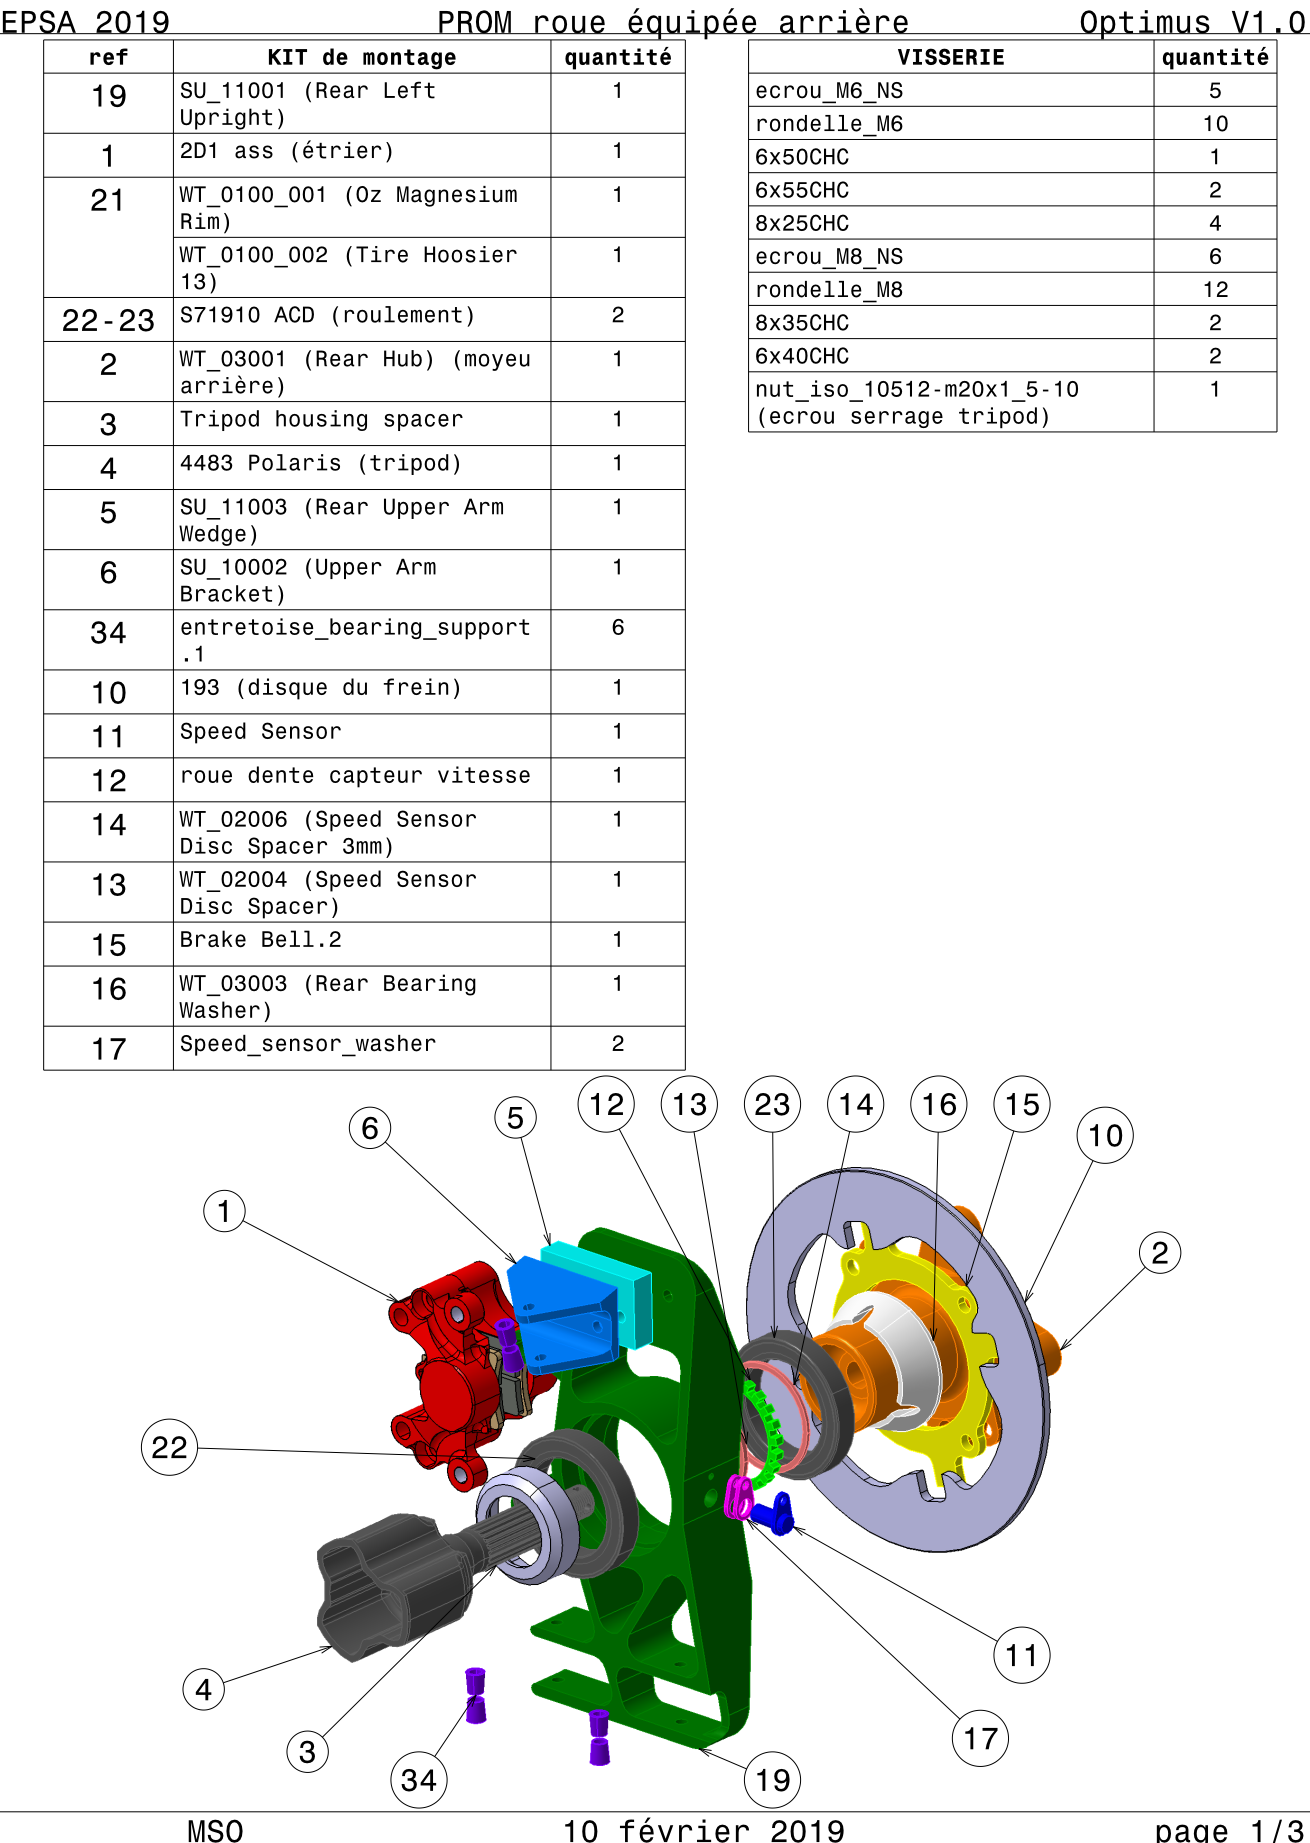
[picture p775: page 1]

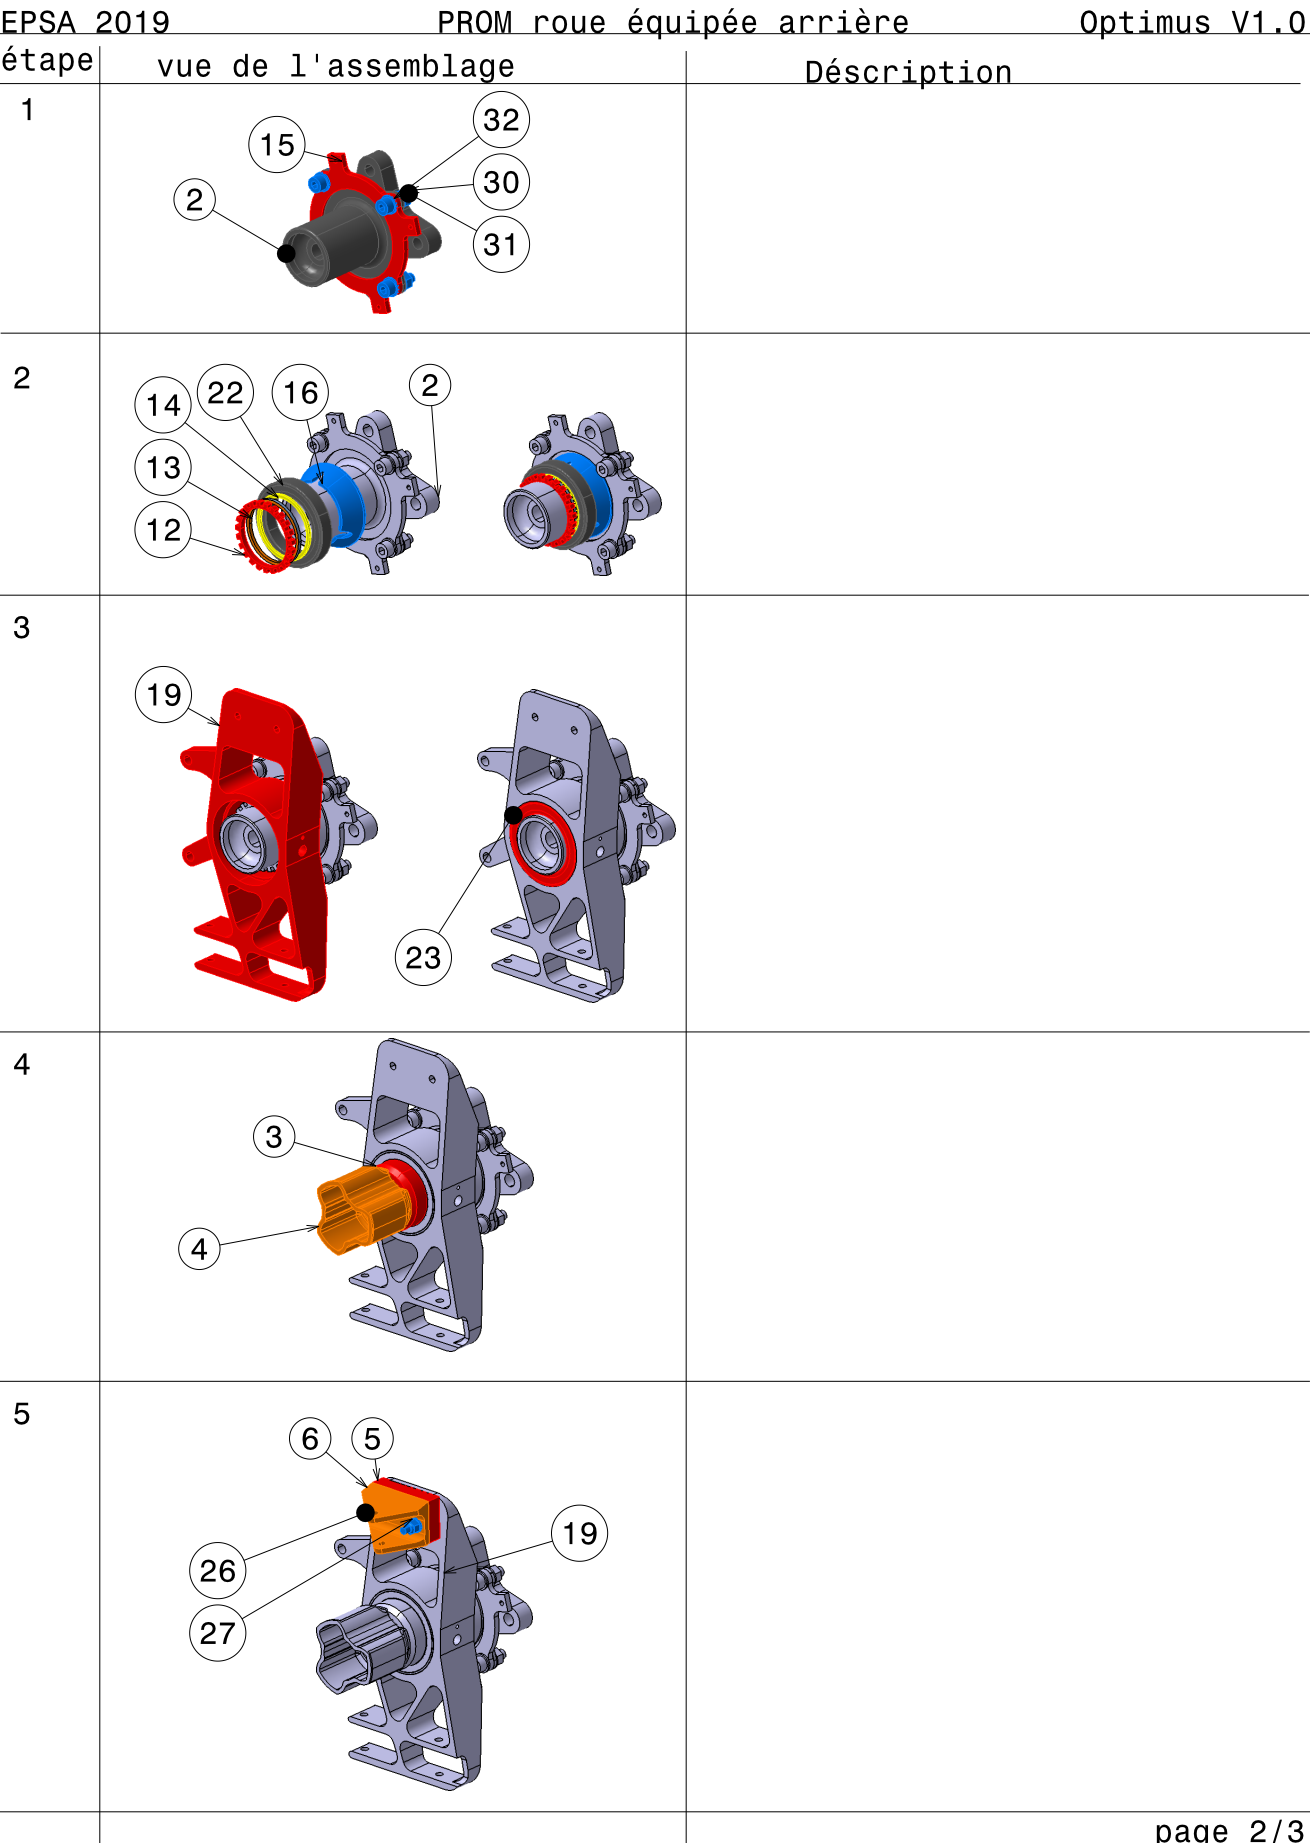
[picture p776: page 2]

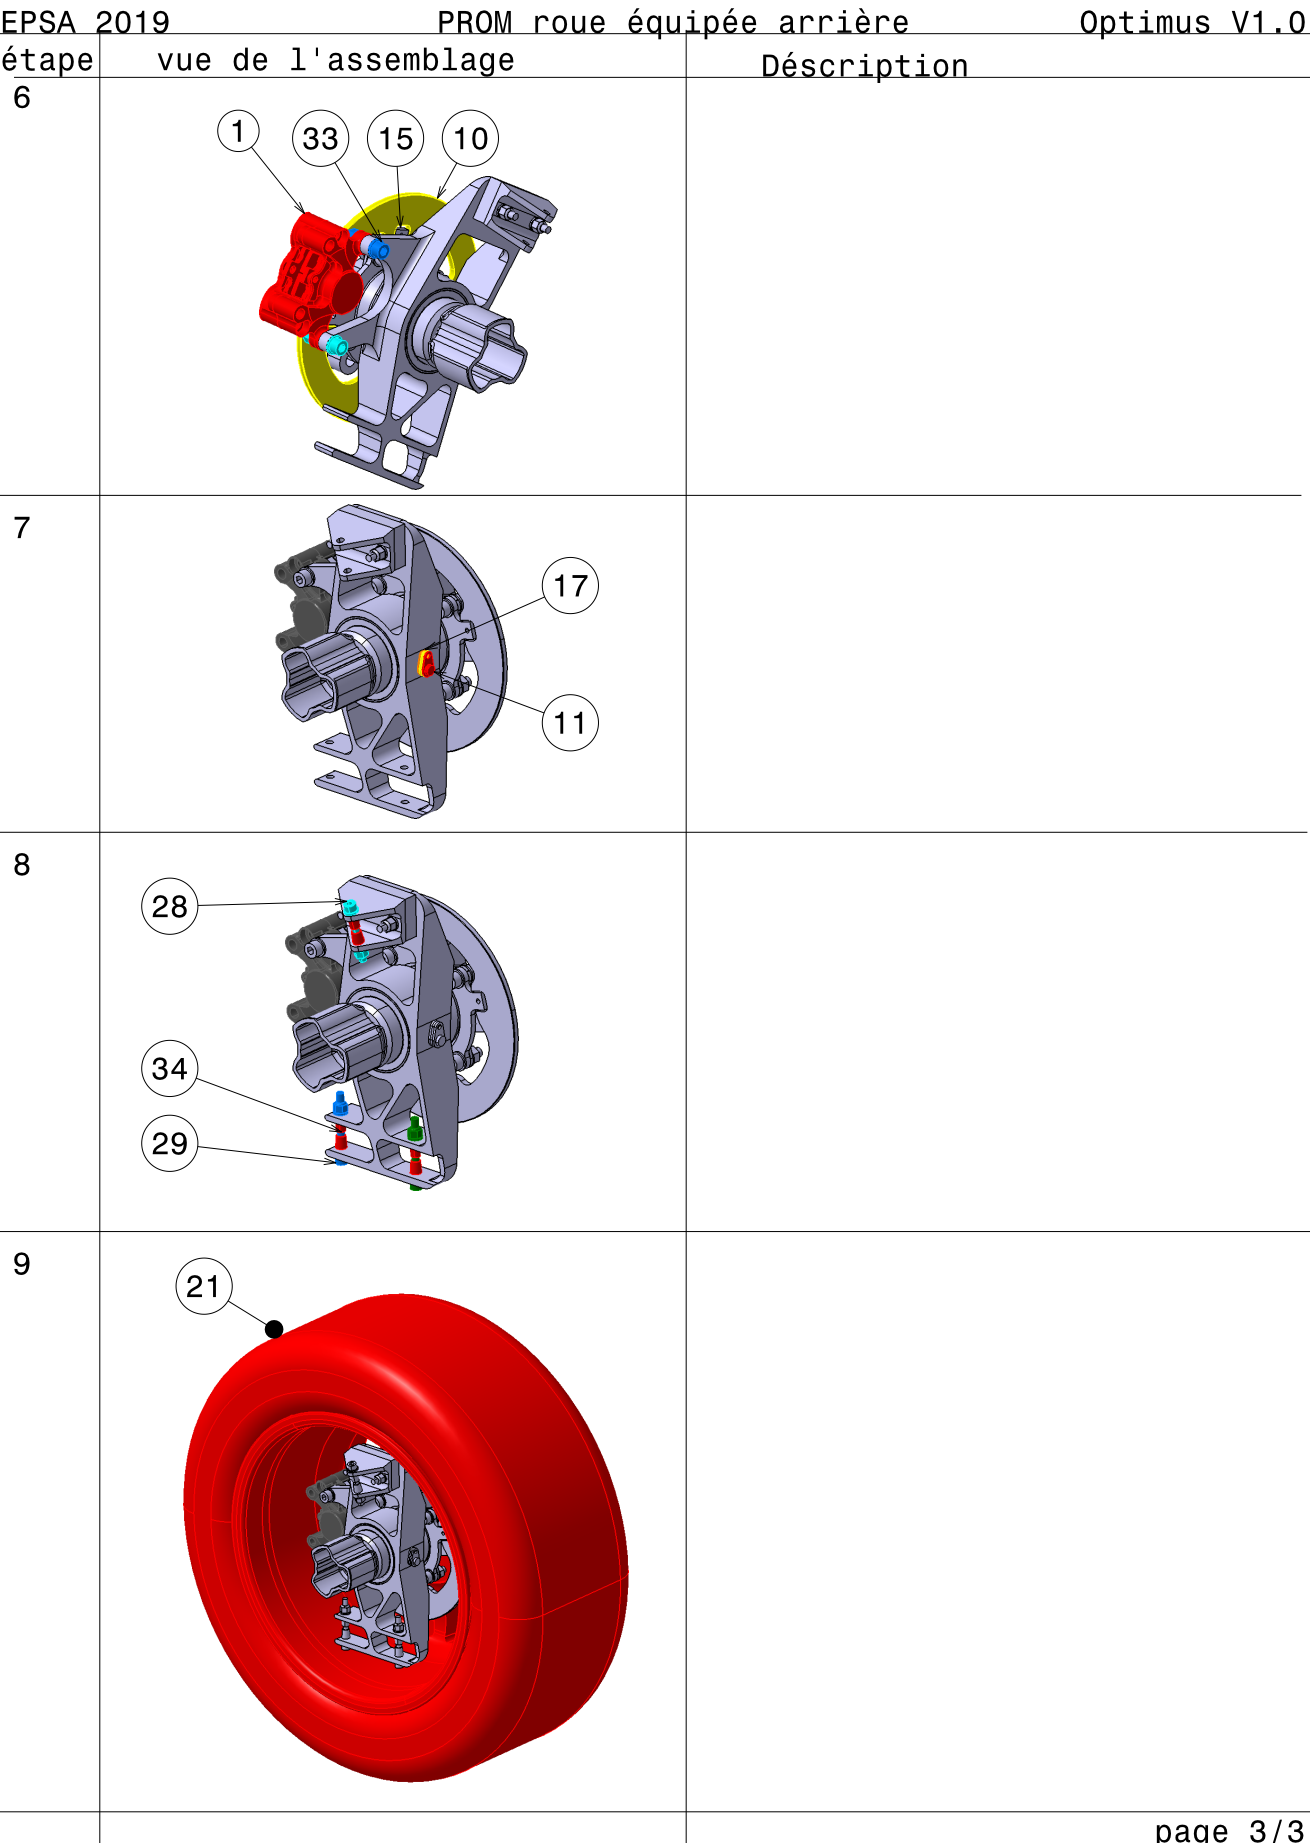
[picture p777: page 3]
