EOSCogniton/STUF2019/SU - Suspension/SU_A1100 (Rear Upright Assy)/MEP/montage-avant.pdf

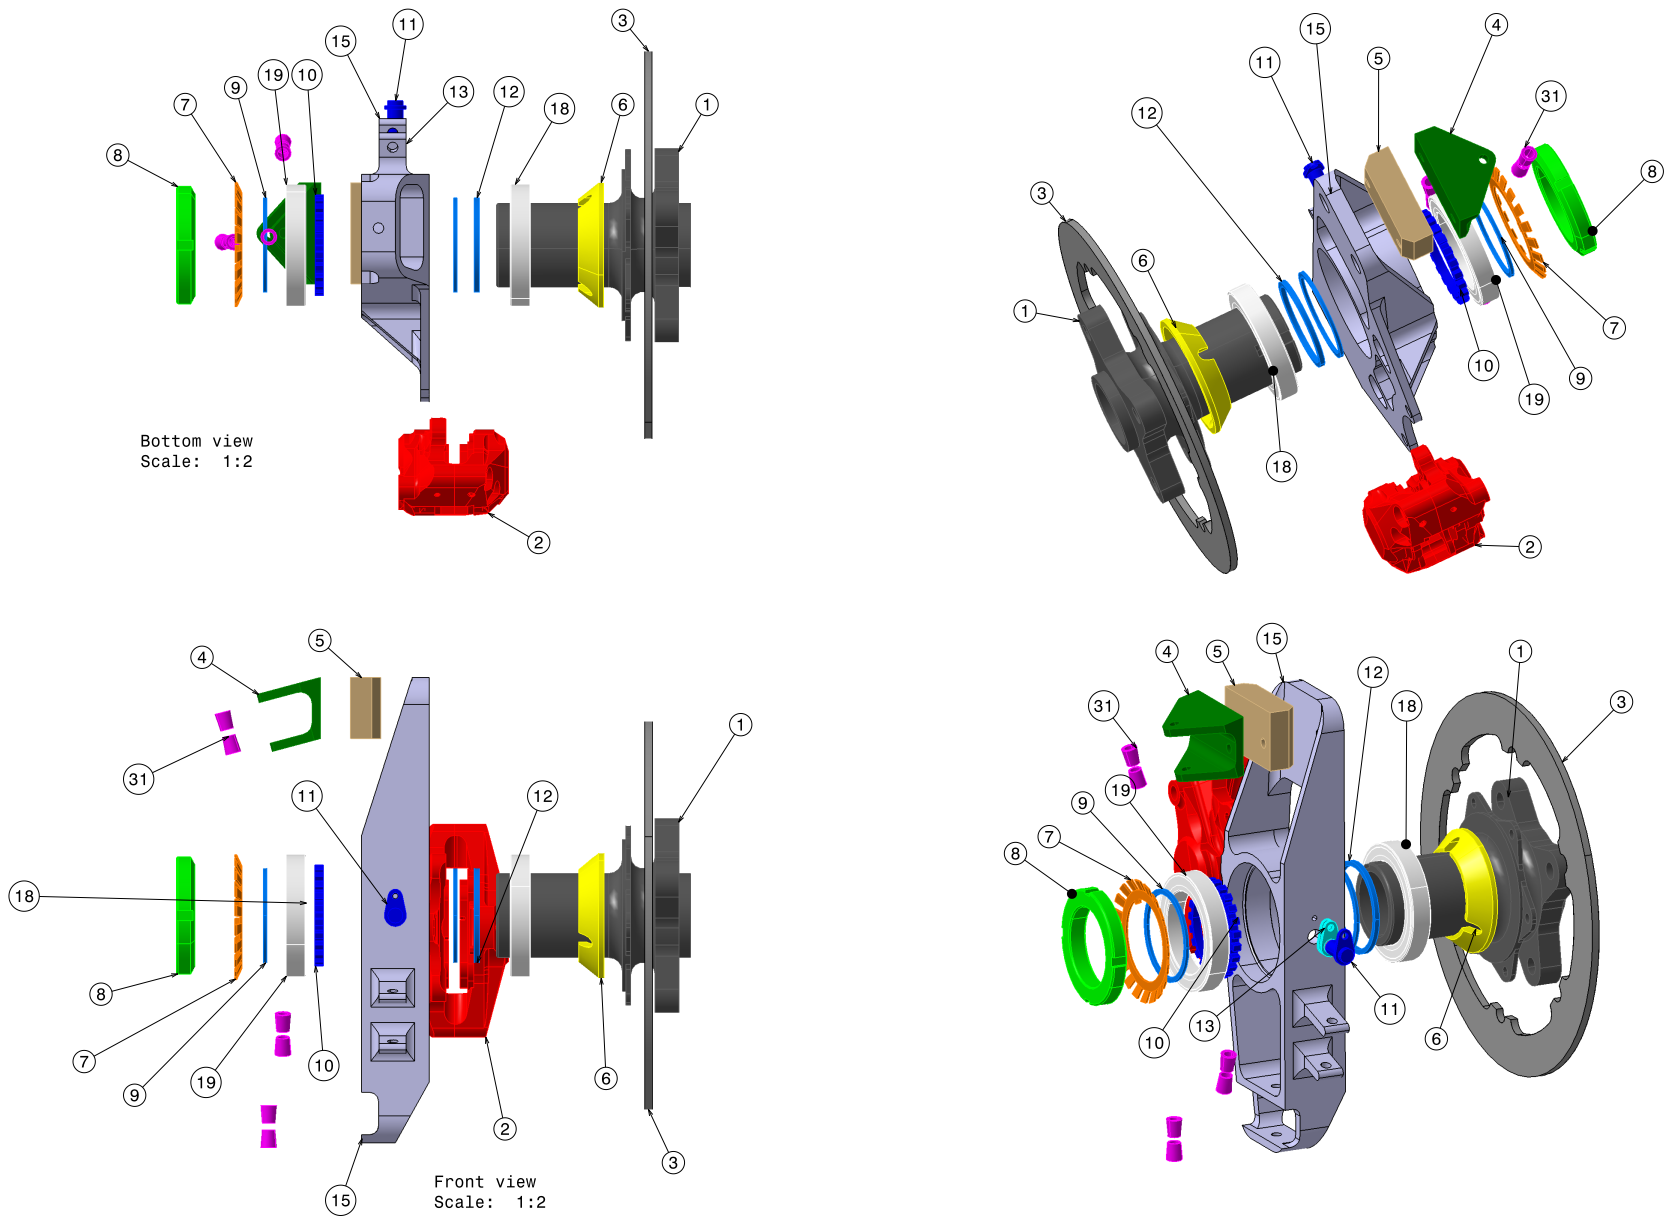
[picture p778: page 1]
