EOSCogniton/STUF2019/SU - Suspension/12 - Chapes/Rectif chapes ap modif chassis/19M_4MM_STD_2.pdf

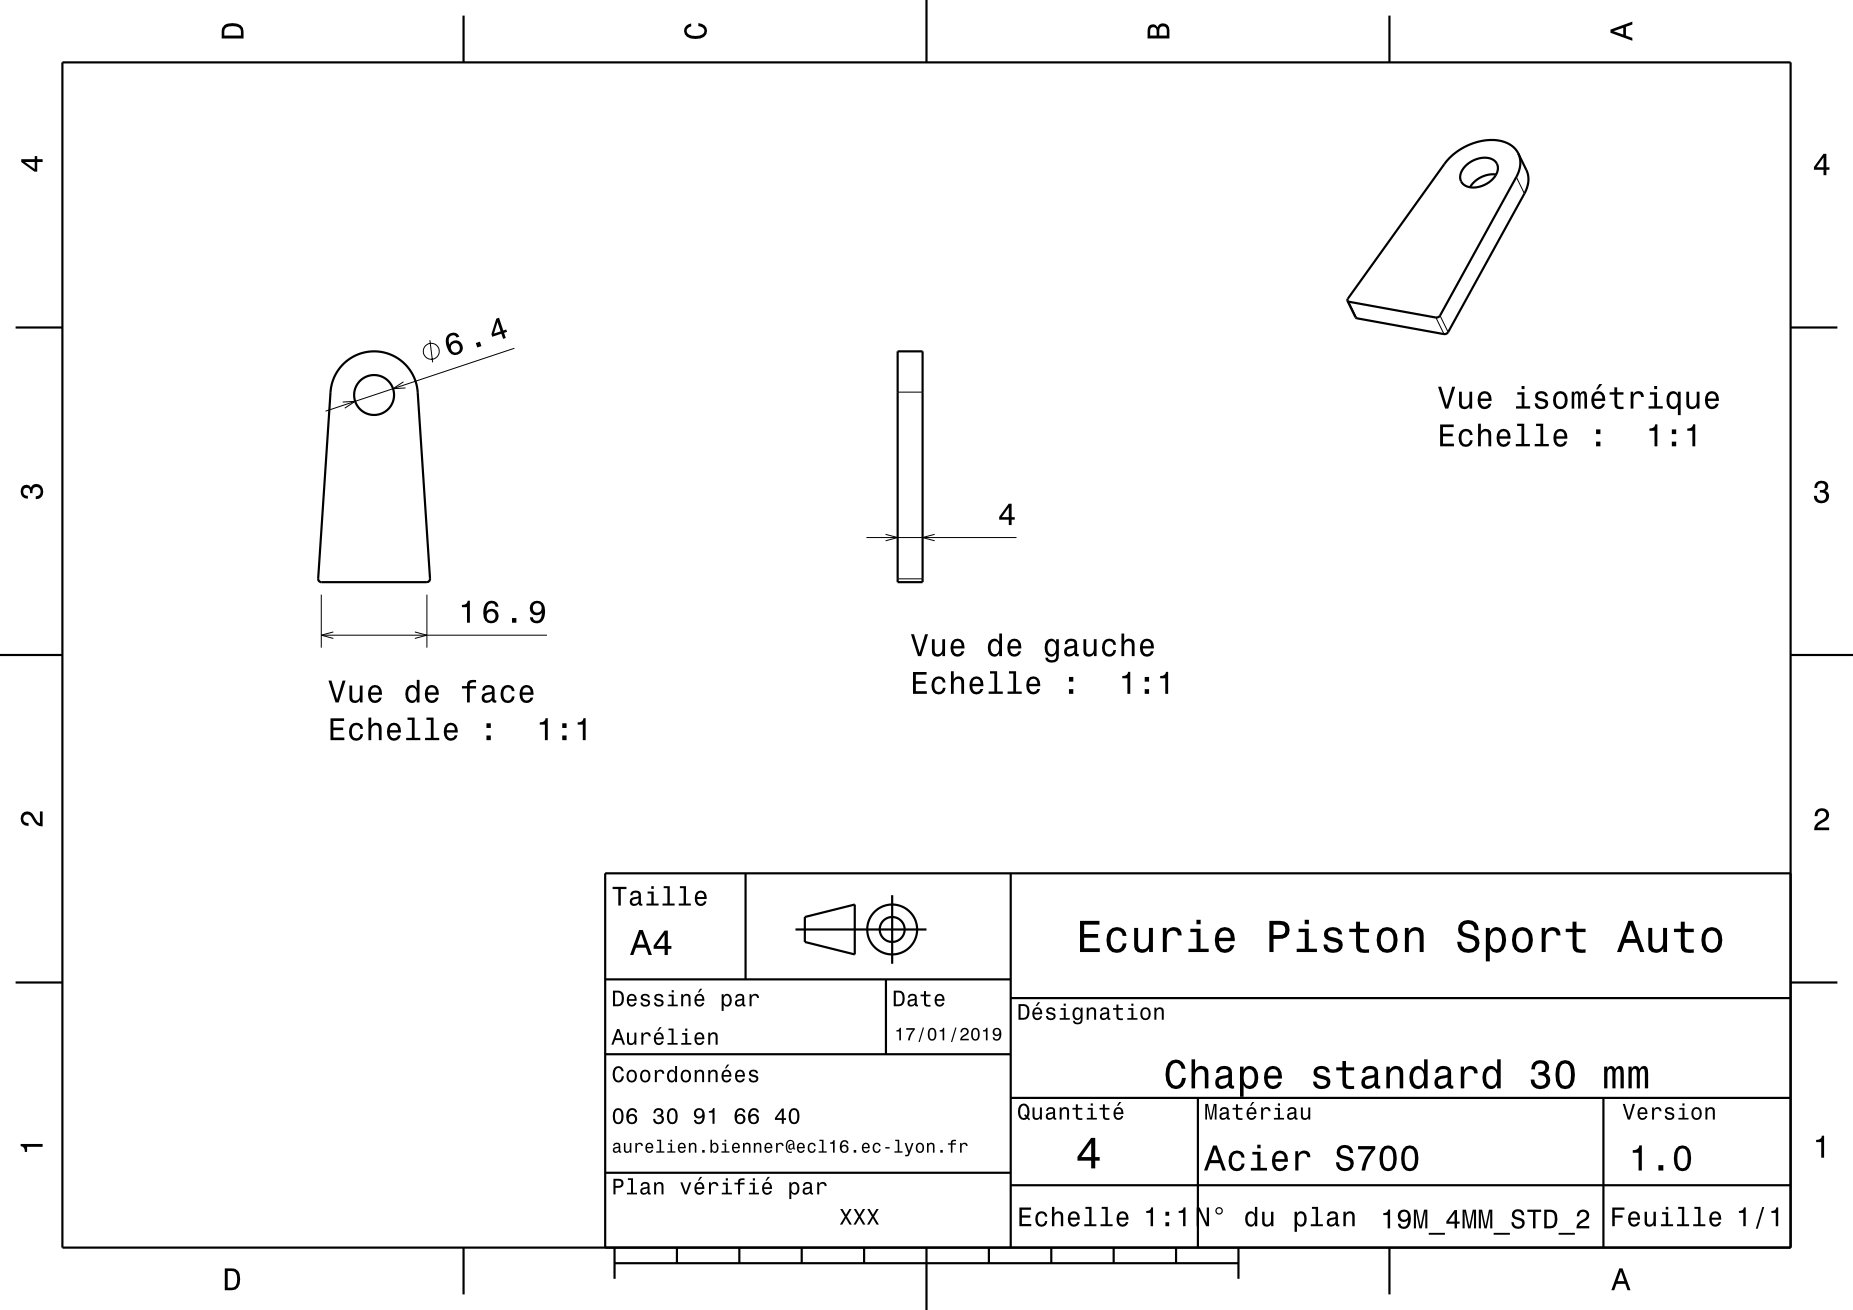
[picture p780: page 1]
