EOSCogniton/STUF2019/SU - Suspension/12 - Chapes/Rectif chapes ap modif chassis/19M_4MM_STD_3.pdf

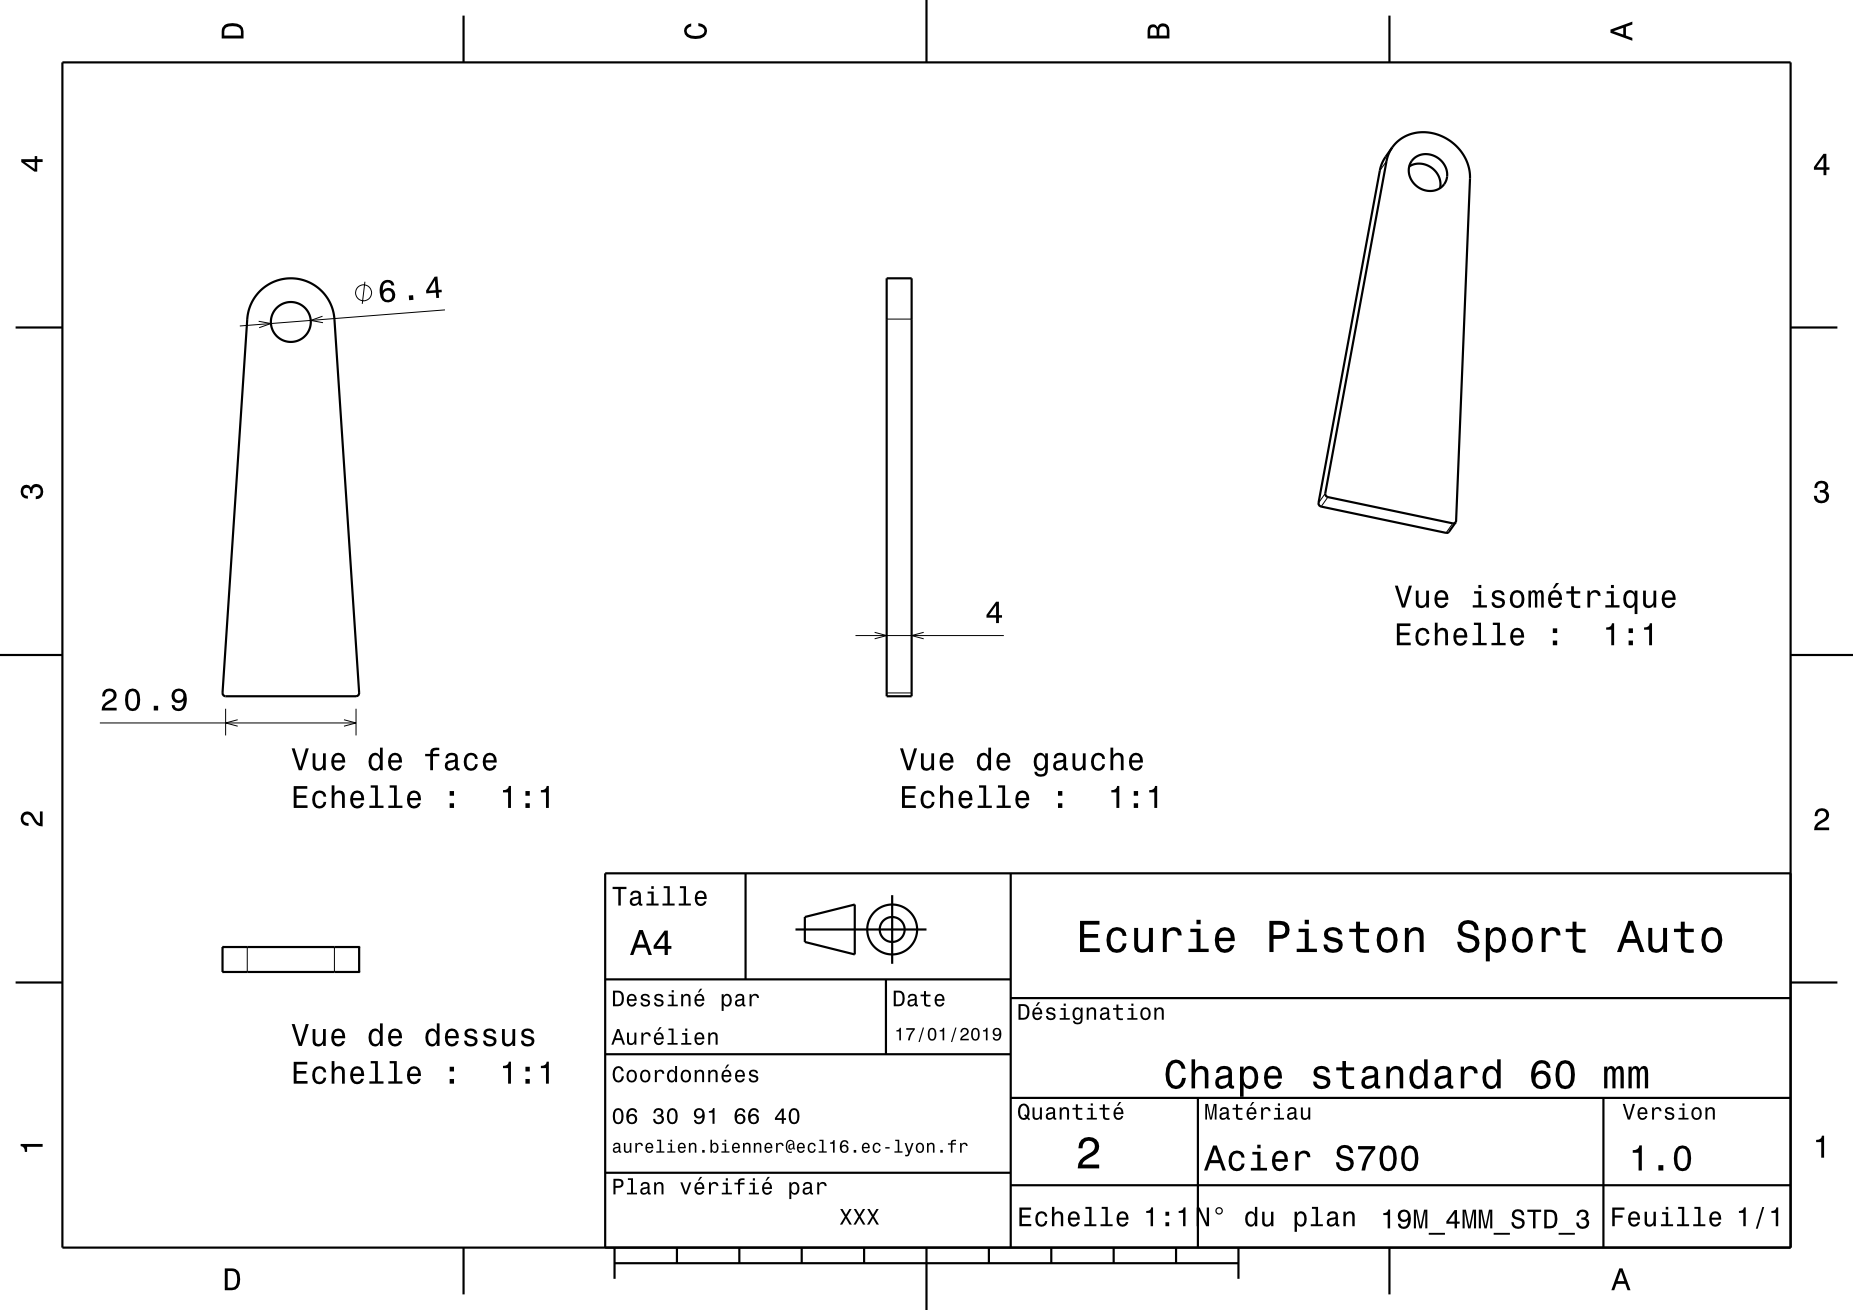
[picture p781: page 1]
