EOSCogniton/STUF2019/SU - Suspension/12 - Chapes/Rectif chapes ap modif chassis/19M_SU_0100_009_v2.pdf

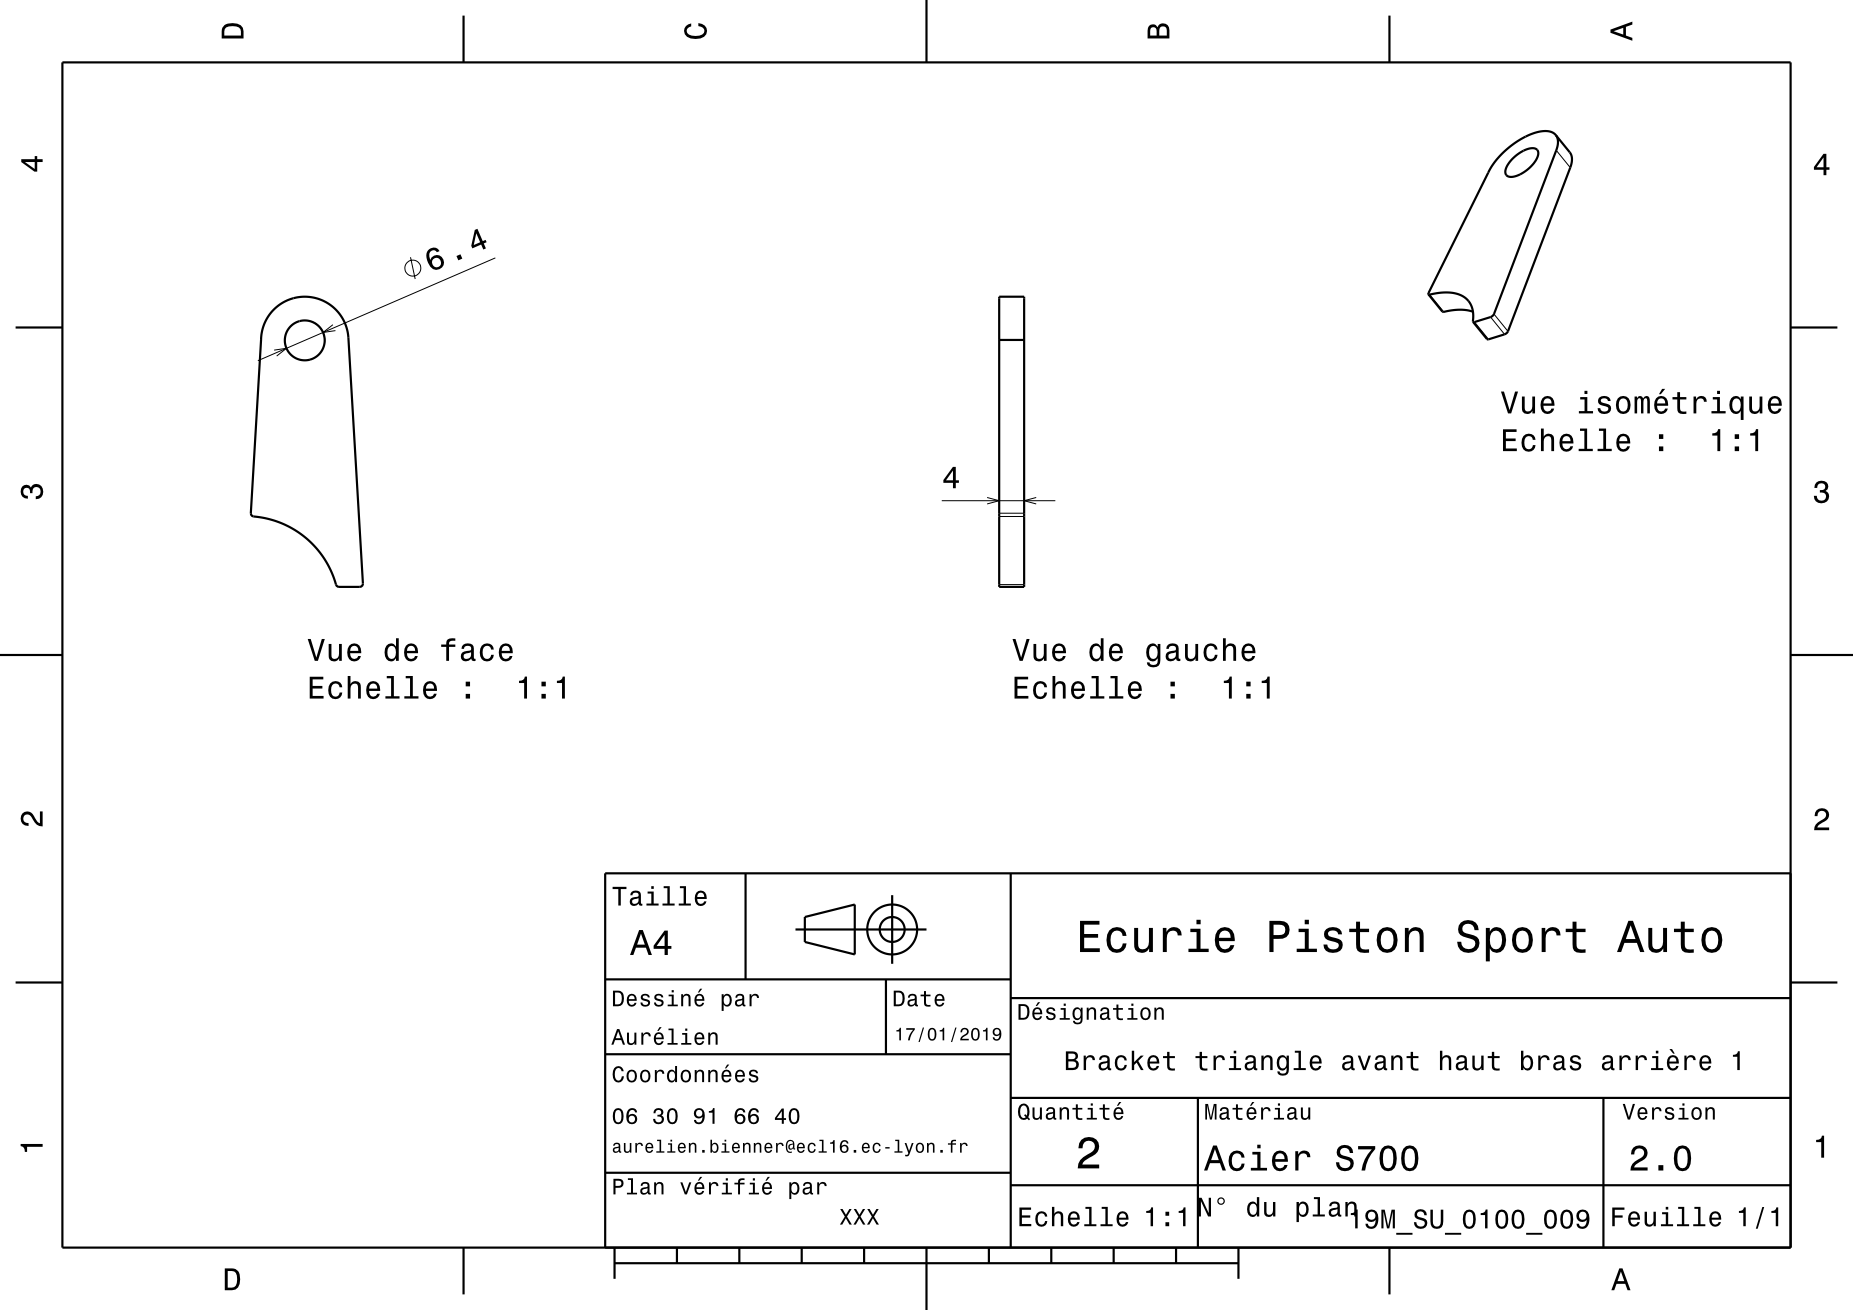
[picture p782: page 1]
