EOSCogniton/STUF2019/EL - Electrical/Autre/Carte avant/Shield carte avant/shield carte avant.brd

## EAGLE design EL - Electrical/Autre/Carte avant/Shield carte avant/shield carte avant.brd (2018-12-06)

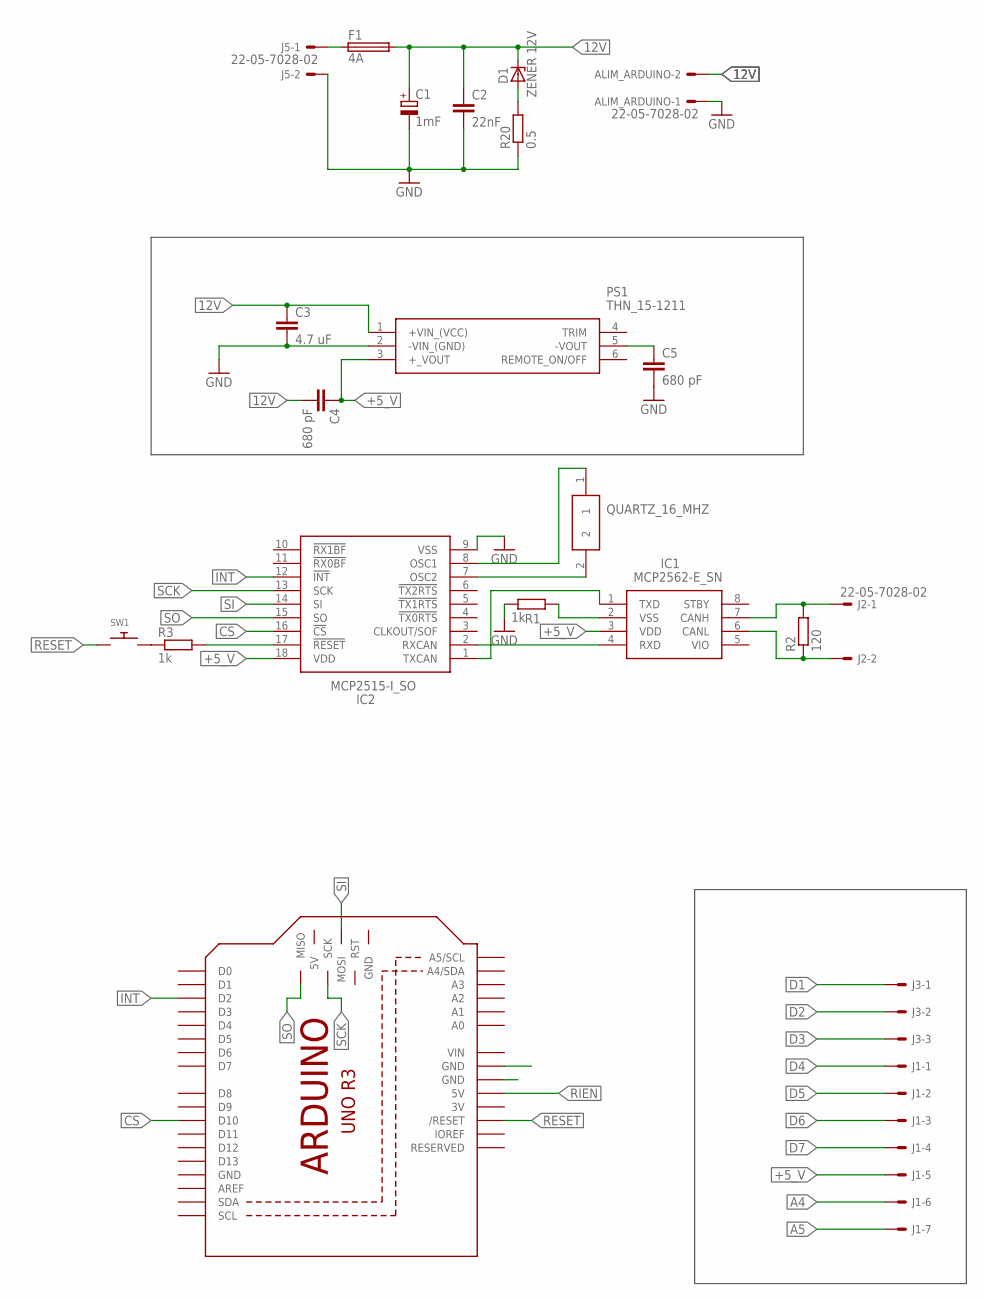
[picture p783: schematic shield carte avant.sch]

Parts:
ALIM_ARDUINO: 22-05-7028-02; 7395-02
C1: 1mF; E7,5-16
C2: 22nF; C025-025X050
C3: 4.7 uF; C025-024X044
C4, C5: 680 pF; C025-024X044
D1: ZENER 12V; DO41Z10
F1: 4A; SH25
IC1: MCP2562-E_SN; SOIC127P600X175-8N
IC2: MCP2515-I_SO; SOIC127P1030X265-18N
J1: 22-05-7078-07; 7395-07
J2, J5: 22-05-7028-02; 7395-02
J3: 22-05-7038-03; 7395-03
M1: ARDUINO_R3_ICSP; ARDUINOR3_ICSP
PS1: THN_15-1211; THN-15-SERIES
QUARTZ_16_MHZ: FOXSLF_160-20; HC49SLF_1
R1, R3: 1k; 0204/7
R2: 120; 0204/7
R20: 0.5; 0309/12
SW1: SWITCH_PUSHBUTTONEVQ-PE; TACT_PANA-EVQ

Connections:
3V: M1.3V
12V: ALIM_ARDUINO.2, C1.+, C2.1, C3.1, C4.2, D1.C, F1.2, PS1.1 (+VIN_(VCC))
+5_V: C4.1, IC1.3 (VDD), IC2.18 (VDD), J1.5, PS1.3 (+_VOUT)
A4: J1.6
A5: J1.7
CS: IC2.16 (!CS), M1.D10
D1: J3.1
D2: J3.2
D3: J3.3
D4: J1.1
D5: J1.2
D6: J1.3
D7: J1.4
GND: ALIM_ARDUINO.1, C1.-, C2.2, C3.2, C5.2, IC2.9 (VSS), J5.2, M1.GND, PS1.2 (-VIN_(GND)), R1.1, R20.1
INT: IC2.12 (!INT), M1.D2
unnamed: F1.1, J5.1
unnamed: C5.1, PS1.5 (-VOUT)
unnamed: D1.A, R20.2
unnamed: IC1.1 (TXD), IC2.1 (TXCAN)
unnamed: IC1.4 (RXD), IC2.2 (RXCAN)
unnamed: IC1.2 (VSS), R1.2
unnamed: IC1.7 (CANH), J2.1, R2.2
unnamed: IC1.6 (CANL), J2.2, R2.1
unnamed: IC2.7 (OSC2), QUARTZ_16_MHZ.2
unnamed: IC2.8 (OSC1), QUARTZ_16_MHZ.1
unnamed: R3.1, SW1.P$2
unnamed: IC2.17 (!RESET), R3.2
RESET: M1.RESET (/RESET), SW1.P$1
RIEN: M1.5V
SCK: IC2.13 (SCK), M1.SCK
SI: IC2.14 (SI), M1.MOSI
SO: IC2.15 (SO), M1.MISO
VIN: M1.VIN

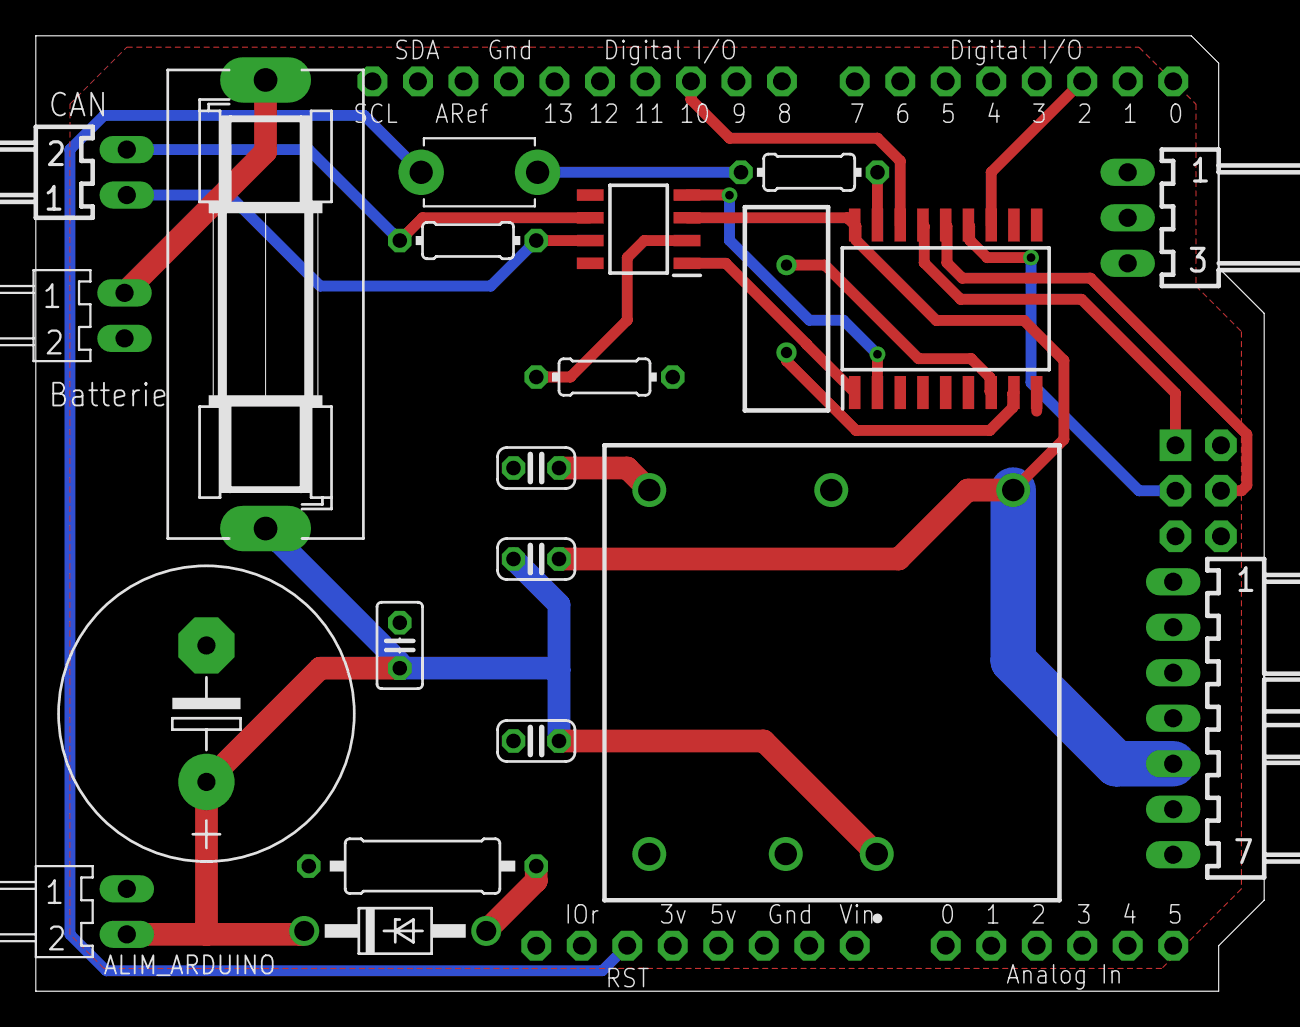
[picture p784: board shield carte avant.brd from above]

Board: 2 copper layers, 68.6 x 53.3 mm, 22 parts (0 on the bottom side), 21 nets.
