EOSCogniton/STUF2019/EL - Electrical/Autre/Tableau de bord/Carte élecs/Afficheur temp/TEMP.BRD

## EAGLE design EL - Electrical/Autre/Tableau de bord/Carte élecs/Afficheur temp/TEMP.BRD (2018-12-06)

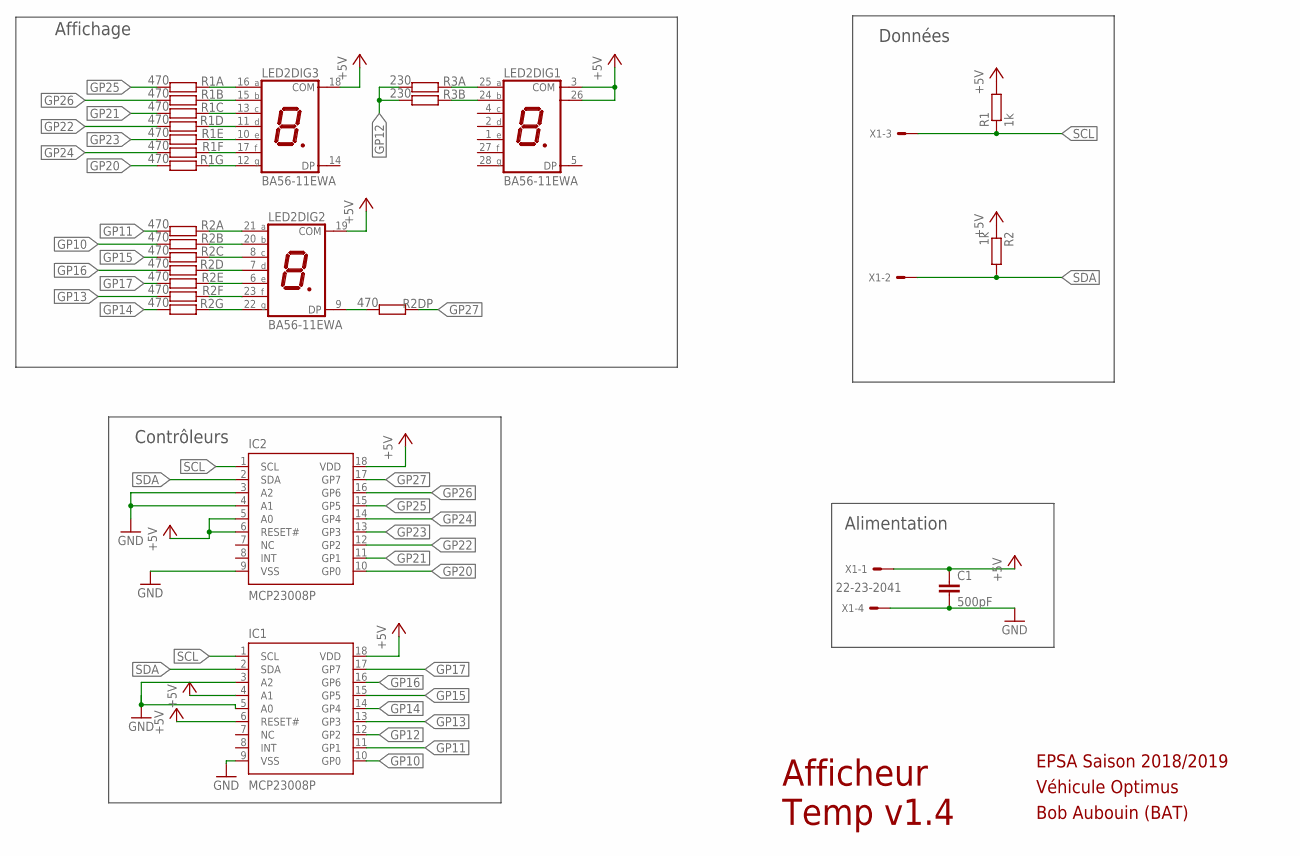
[picture p785: schematic Temp.sch]

Parts:
C1: 500pF; C025-025X050
IC1, IC2: MCP23008P; DIL18
LED2: BA56-11EWA; BA/BC56
R1, R2: 1k; 0204/7
R1A, R1B, R1C, R1D, R1E, R1F, R1G, R2A, R2B, R2C, R2D, R2DP, R2E, R2F, R2G: 470; 0204/7
R3A, R3B: 230; 0204/7
X1: 22-23-2041

Connections:
+5V: C1.1, IC1.4 (A1), IC1.6 (RESET#), IC1.18 (VDD), IC2.5 (A0), IC2.6 (RESET#), IC2.18 (VDD), LED2.3 (COM), LED2.18 (COM), LED2.19 (COM), LED2.26 (COM), R1.2, R2.1, X1.1
GND: C1.2, IC1.3 (A2), IC1.5 (A0), IC1.9 (VSS), IC2.3 (A2), IC2.4 (A1), IC2.9 (VSS), X1.4
GP10: IC1.10 (GP0), R2B.2
GP11: IC1.11 (GP1), R2A.2
GP12: IC1.12 (GP2), R3A.2, R3B.2
GP13: IC1.13 (GP3), R2F.2
GP14: IC1.14 (GP4), R2G.2
GP15: IC1.15 (GP5), R2C.2
GP16: IC1.16 (GP6), R2D.2
GP17: IC1.17 (GP7), R2E.2
GP20: IC2.10 (GP0), R1G.2
GP21: IC2.11 (GP1), R1C.2
GP22: IC2.12 (GP2), R1D.2
GP23: IC2.13 (GP3), R1E.2
GP24: IC2.14 (GP4), R1F.2
GP25: IC2.15 (GP5), R1A.2
GP26: IC2.16 (GP6), R1B.2
GP27: IC2.17 (GP7), R2DP.1
unnamed: LED2.16 (A), R1A.1
unnamed: LED2.15 (B), R1B.1
unnamed: LED2.13 (C), R1C.1
unnamed: LED2.11 (D), R1D.1
unnamed: LED2.10 (E), R1E.1
unnamed: LED2.17 (F), R1F.1
unnamed: LED2.12 (G), R1G.1
unnamed: LED2.21 (A), R2A.1
unnamed: LED2.20 (B), R2B.1
unnamed: LED2.8 (C), R2C.1
unnamed: LED2.7 (D), R2D.1
unnamed: LED2.6 (E), R2E.1
unnamed: LED2.23 (F), R2F.1
unnamed: LED2.22 (G), R2G.1
unnamed: LED2.9 (DP), R2DP.2
unnamed: LED2.24 (B), R3B.1
unnamed: LED2.25 (A), R3A.1
SCL: IC1.1 (SCL), IC2.1 (SCL), R1.1, X1.3
SDA: IC1.2 (SDA), IC2.2 (SDA), R2.2, X1.2

Notes on the sheet:
Afficheur Temp v1.4
EPSA Saison 2018/2019
Alimentation
Contrôleurs
Données
Affichage
Véhicule Optimus
Bob Aubouin (BAT)

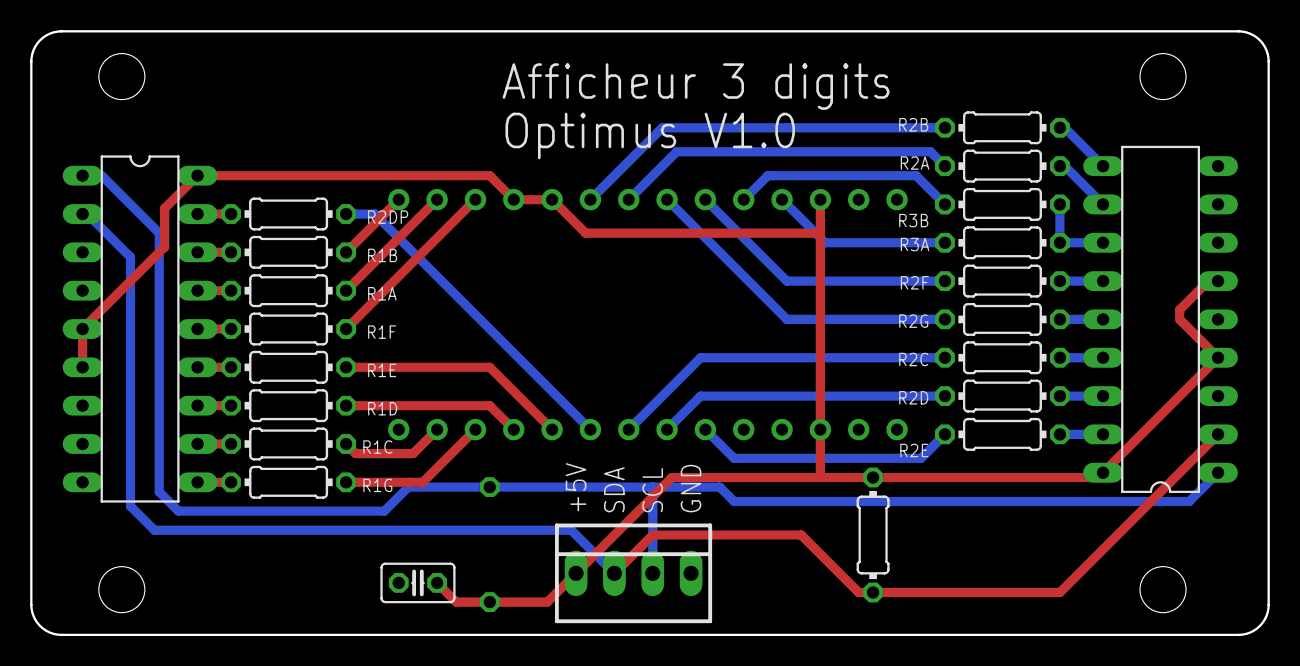
[picture p786: board TEMP.BRD from above]

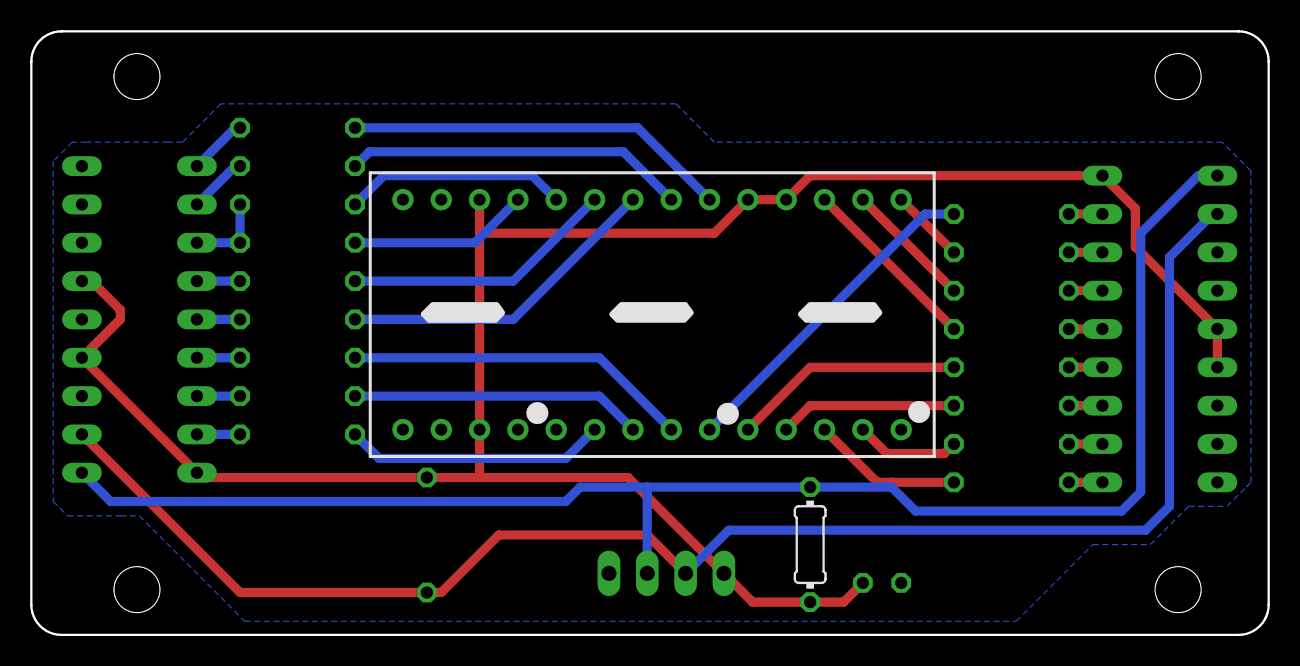
[picture p787: board TEMP.BRD from below]

Board: 2 copper layers, 82.0 x 40.0 mm, 24 parts (2 on the bottom side), 37 nets.
