EOSCogniton/STUF2019/EL - Electrical/Autre/Tableau de bord/Carte élecs/Afficheur rapport/rapport.brd

## EAGLE design EL - Electrical/Autre/Tableau de bord/Carte élecs/Afficheur rapport/rapport.brd (2018-12-06)

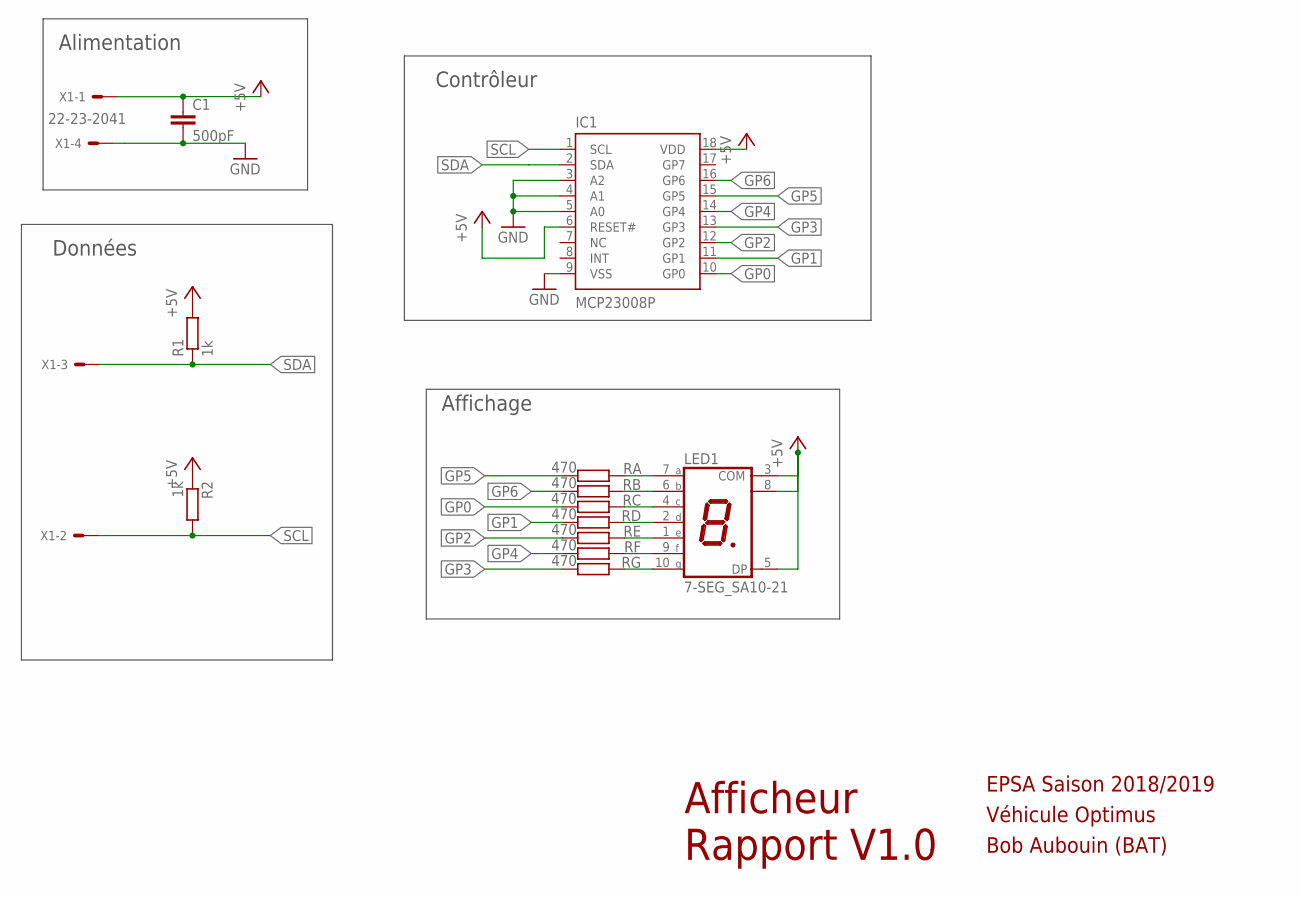
[picture p788: schematic rapport.sch]

Parts:
C1: 500pF; C025-025X050
IC1: MCP23008P; DIL18
LED1: 7-SEG_SA10-21; SA10-21
R1, R2: 1k; 0204/7
RA: 470; 0204/7
RB: 470; 0204/7
RC: 470; 0204/7
RD: 470; 0204/7
RE: 470; 0204/7
RF: 470; 0204/7
RG: 470; 0204/7
X1: 22-23-2041

Connections:
+5V: C1.1, IC1.6 (RESET#), IC1.18 (VDD), LED1.3 (COM), LED1.5 (DP), LED1.8 (COM), R1.2, R2.1, X1.1
GND: C1.2, IC1.3 (A2), IC1.4 (A1), IC1.5 (A0), IC1.9 (VSS), X1.4
GP0: IC1.10 (GP0), RC.2
GP1: IC1.11 (GP1), RD.2
GP2: IC1.12 (GP2), RE.2
GP3: IC1.13 (GP3), RG.2
GP4: IC1.14 (GP4), RF.2
GP5: IC1.15 (GP5), RA.2
GP6: IC1.16 (GP6), RB.2
unnamed: LED1.10 (G), RG.1
unnamed: LED1.9 (F), RF.1
unnamed: LED1.1 (E), RE.1
unnamed: LED1.2 (D), RD.1
unnamed: LED1.4 (C), RC.1
unnamed: LED1.6 (B), RB.1
unnamed: LED1.7 (A), RA.1
SCL: IC1.1 (SCL), R2.2, X1.2
SDA: IC1.2 (SDA), R1.1, X1.3

Notes on the sheet:
Afficheur Rapport V1.0
EPSA Saison 2018/2019
Alimentation
Contrôleur
Données
Affichage
Véhicule Optimus
Bob Aubouin (BAT)

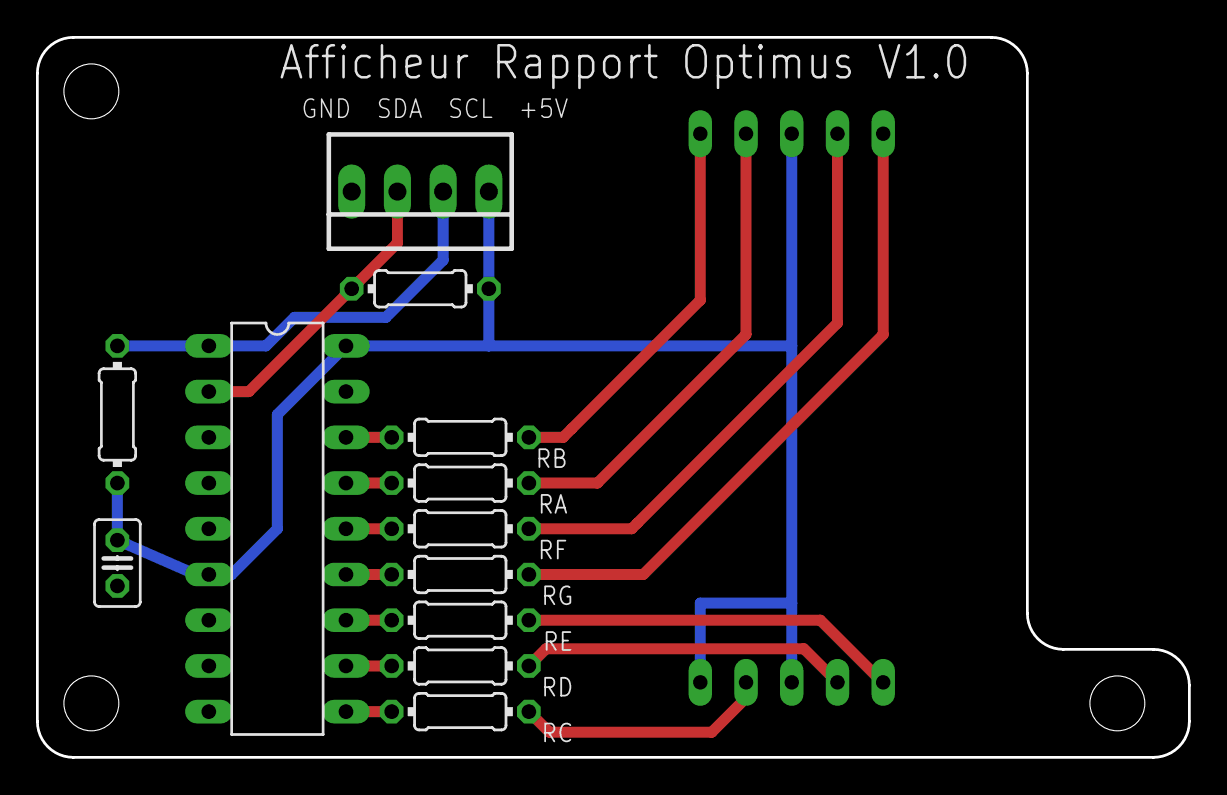
[picture p789: board EL - Electrical/Autre/Tableau de bord/Carte élecs/Afficheur rapport/r… from above]

Board: 2 copper layers, 64.0 x 40.0 mm, 13 parts (1 on the bottom side), 18 nets.
