EOSCogniton/STUF2019/EL - Electrical/Autre/BSPD/Version Bob/BSPD.brd

## EAGLE design EL - Electrical/Autre/BSPD/Version Bob/BSPD.brd (2018-11-23)

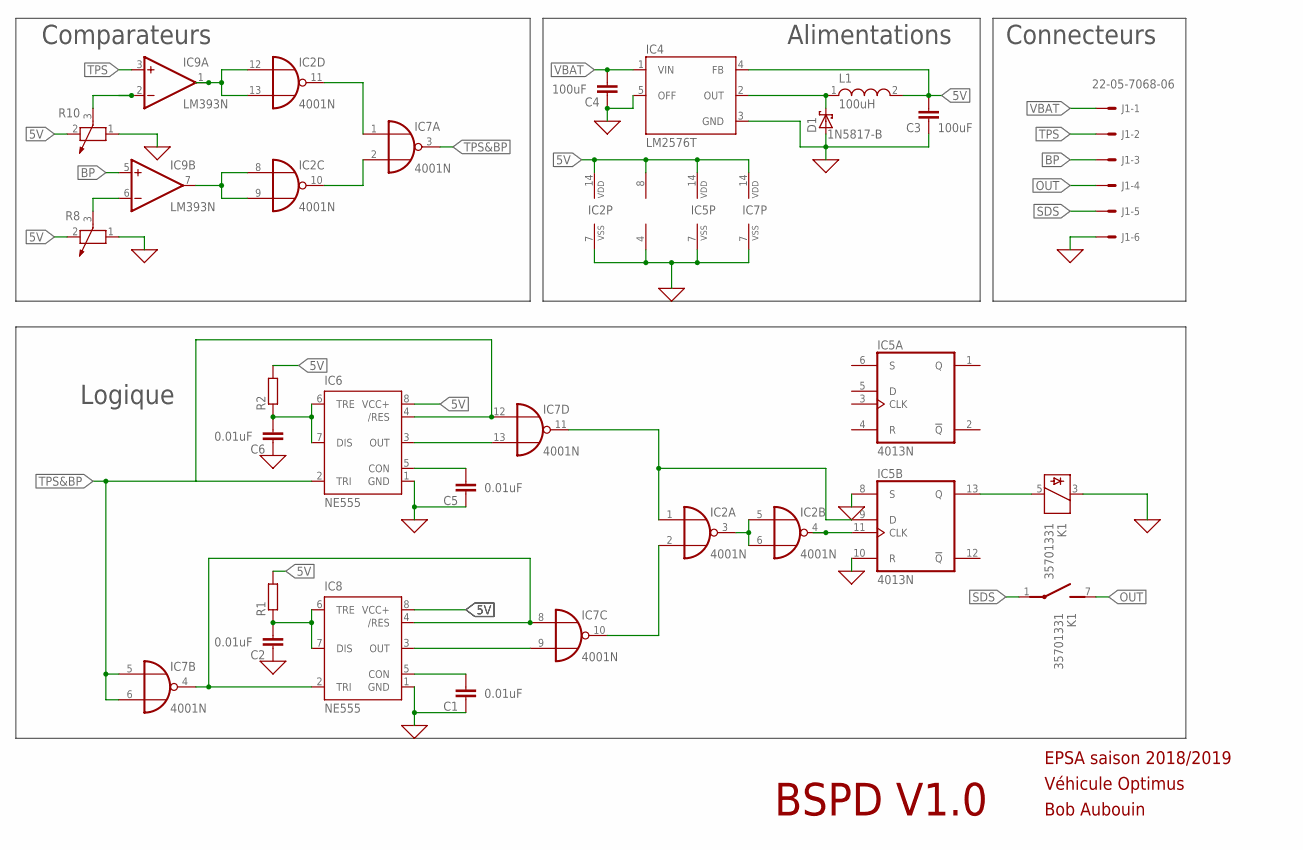
[picture p790: schematic BSPD.sch]

Parts:
C1, C2, C5, C6: 0.01uF; C025-025X050
C3, C4: 100uF; C025-025X050
D1: 1N5817-B; DO41-7.6
IC2, IC7: 4001N; DIL14
IC4: LM2576T; TO220-5
IC5: 4013N; DIL14
IC6, IC8: NE555; DIL-08
IC9: LM393N; DIL08
J1: 22-05-7068-06; 7395-06
K1: 35701331; REED
L1: 100uH; WE-TI_8012
R1, R2: R-EU_0207/10; 0207/10
R8, R10: POTENTIOMETER_PT_SPIN; PT-SPIN

Connections:
0: C1.1, C2.1, C3.1, C4.1, C5.1, C6.1, D1.A, IC2.7 (VSS), IC4.3 (GND), IC4.5 (OFF), IC5.7 (VSS), IC5.8 (S), IC5.10 (R), IC6.1 (GND), IC7.7 (VSS), IC8.1 (GND), IC9.4 (V-), J1.6, K1.3, R8.1, R10.1
5V: C3.2, IC2.14 (VDD), IC4.4 (FB), IC5.14 (VDD), IC6.8 (VCC+), IC7.14 (VDD), IC8.8 (VCC+), IC9.8 (V+), L1.2, R1.2, R2.2, R8.2, R10.2
BP: IC9.5 (+IN), J1.3
unnamed: C1.2, IC8.5 (CON)
unnamed: IC7.4 (O), IC7.8 (I0), IC8.2 (TRI), IC8.4 (/RES)
unnamed: C2.2, IC8.6 (TRE), IC8.7 (DIS), R1.1
unnamed: IC7.9 (I1), IC8.3 (OUT)
unnamed: C6.2, IC6.6 (TRE), IC6.7 (DIS), R2.1
unnamed: C5.2, IC6.5 (CON)
unnamed: IC2.12 (I0), IC2.13 (I1), IC9.1 (OUT)
unnamed: IC2.2 (I1), IC7.10 (O)
unnamed: IC2.1 (I0), IC5.9 (D), IC7.11 (O)
unnamed: IC2.4 (O), IC5.11 (CLK)
unnamed: IC6.3 (OUT), IC7.13 (I1)
unnamed: IC5.13 (Q), K1.5
unnamed: IC9.2 (-IN), R10.3
unnamed: IC9.6 (-IN), R8.3
unnamed: IC2.8 (I0), IC2.9 (I1), IC9.7 (OUT)
unnamed: D1.C, IC4.2 (OUT), L1.1
unnamed: IC2.11 (O), IC7.1 (I0)
unnamed: IC2.10 (O), IC7.2 (I1)
unnamed: IC2.3 (O), IC2.5 (I0), IC2.6 (I1)
OUT: J1.4, K1.7 (S)
SDS: J1.5, K1.1
TPS: IC9.3 (+IN), J1.2
TPS&BP: IC6.2 (TRI), IC6.4 (/RES), IC7.3 (O), IC7.5 (I0), IC7.6 (I1), IC7.12 (I0)
VBAT: C4.2, IC4.1 (VIN), J1.1

Notes on the sheet:
BSPD V1.0
EPSA saison 2018/2019
Véhicule Optimus
Bob Aubouin
Logique
Comparateurs
Alimentations
Connecteurs

Board: 2 copper layers, 21 parts (0 on the bottom side), 27 nets, no tracks yet.
