EOSCogniton/STUF2019/EL - Electrical/Autre/Tableau de bord/Tableau vulcanix/Carte avant/electronique_vulcanix-master/Tableau/T eau/t_eau.brd

## EAGLE design EL - Electrical/Autre/Tableau de bord/Tableau vulcanix/Carte avant/electronique_vulcanix-master/Tableau/T eau/t_eau.brd (2018-09-20)

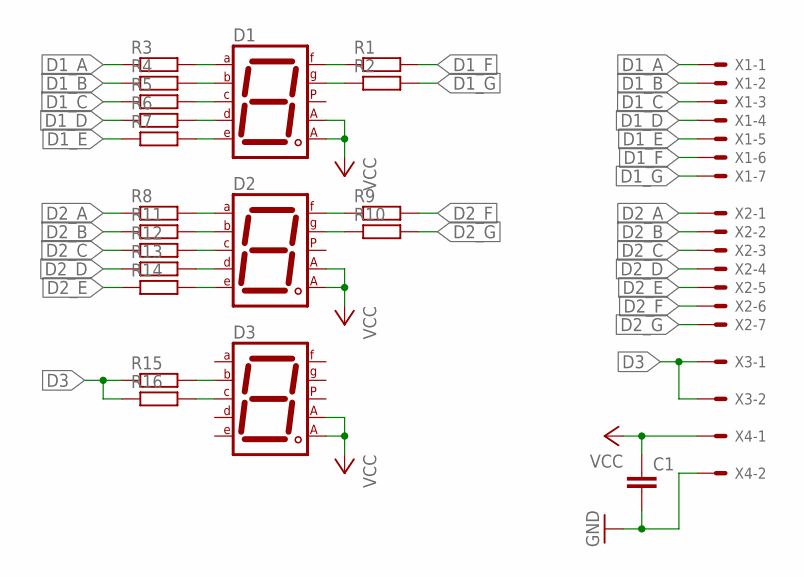
[picture p791: schematic t_eau.sch]

Parts:
C1: C-EU025-025X050; C025-025X050
D1, D2, D3: 7SEG-CA; 7SEG-13
R1, R2, R3, R4, R5, R6, R7, R8, R9, R10, R11, R12, R13, R14, R15, R16: R-EU_0204/7; 0204/7
X1, X2: KK-156-7
X3, X4: KK-156-2

Connections:
D1_A: R3.1, X1.1
D1_B: R4.1, X1.2
D1_C: R5.1, X1.3
D1_D: R6.1, X1.4
D1_E: R7.1, X1.5
D1_F: R1.2, X1.6
D1_G: R2.2, X1.7
D2_A: R8.1, X2.1
D2_B: R11.1, X2.2
D2_C: R12.1, X2.3
D2_D: R13.1, X2.4
D2_E: R14.1, X2.5
D2_F: R9.2, X2.6
D2_G: R10.2, X2.7
D3: R15.1, R16.1, X3.1, X3.2
GND: C1.2, X4.2
unnamed: D1.7 (A), R3.2
unnamed: D1.6 (B), R4.2
unnamed: D1.4 (C), R5.2
unnamed: D1.2 (D), R6.2
unnamed: D1.1 (E), R7.2
unnamed: D1.9 (F), R1.1
unnamed: D1.10 (G), R2.1
unnamed: D2.7 (A), R8.2
unnamed: D2.6 (B), R11.2
unnamed: D2.4 (C), R12.2
unnamed: D2.2 (D), R13.2
unnamed: D2.1 (E), R14.2
unnamed: D2.9 (F), R9.1
unnamed: D2.10 (G), R10.1
unnamed: D3.4 (C), R16.2
unnamed: D3.6 (B), R15.2
VCC: C1.1, D1.3 (CA1), D1.8 (CA2), D2.3 (CA1), D2.8 (CA2), D3.3 (CA1), D3.8 (CA2), X4.1

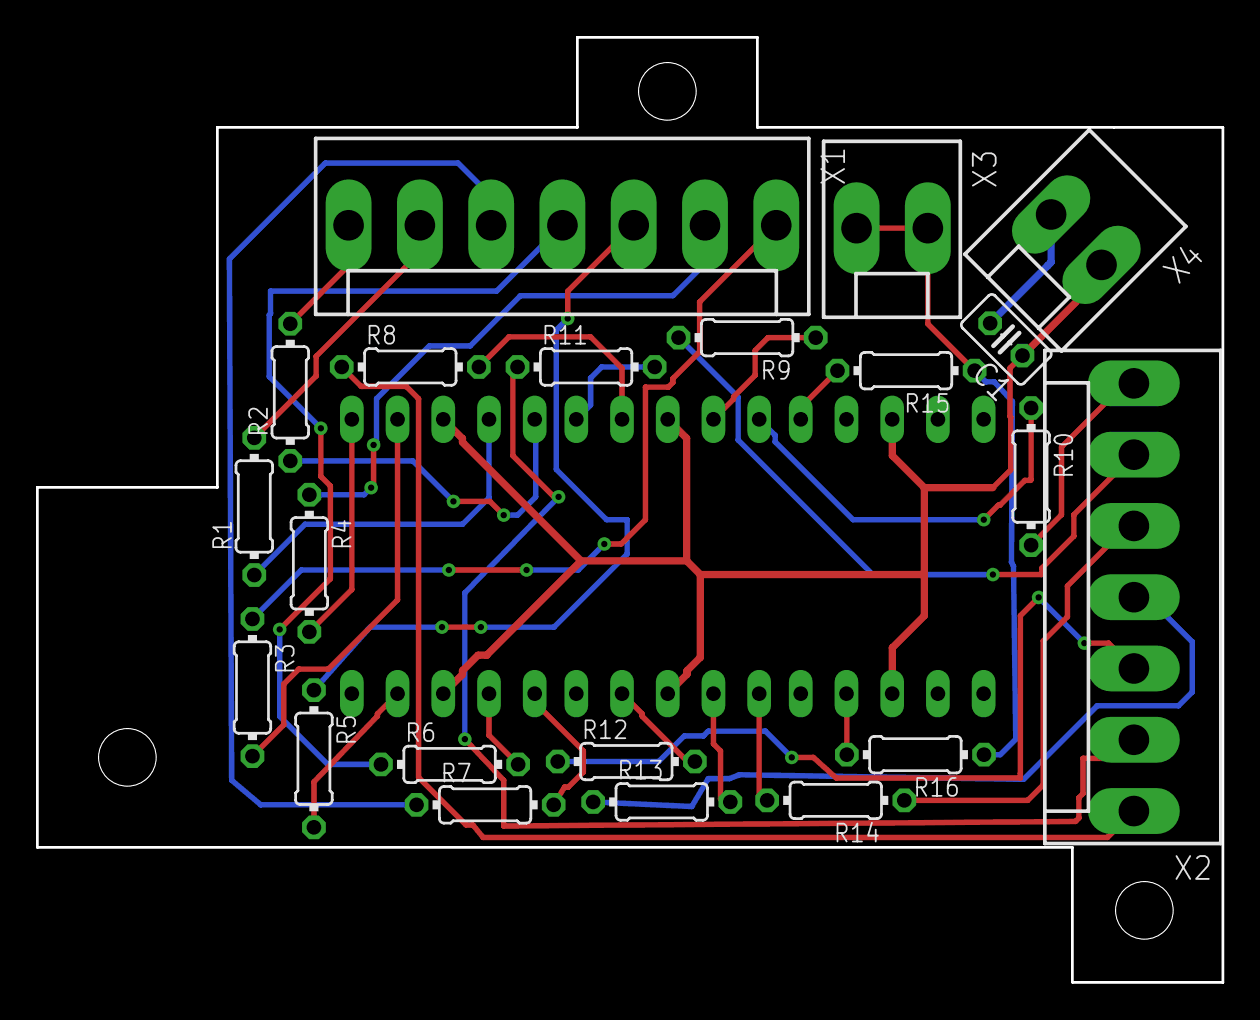
[picture p792: board t_eau.brd from above]

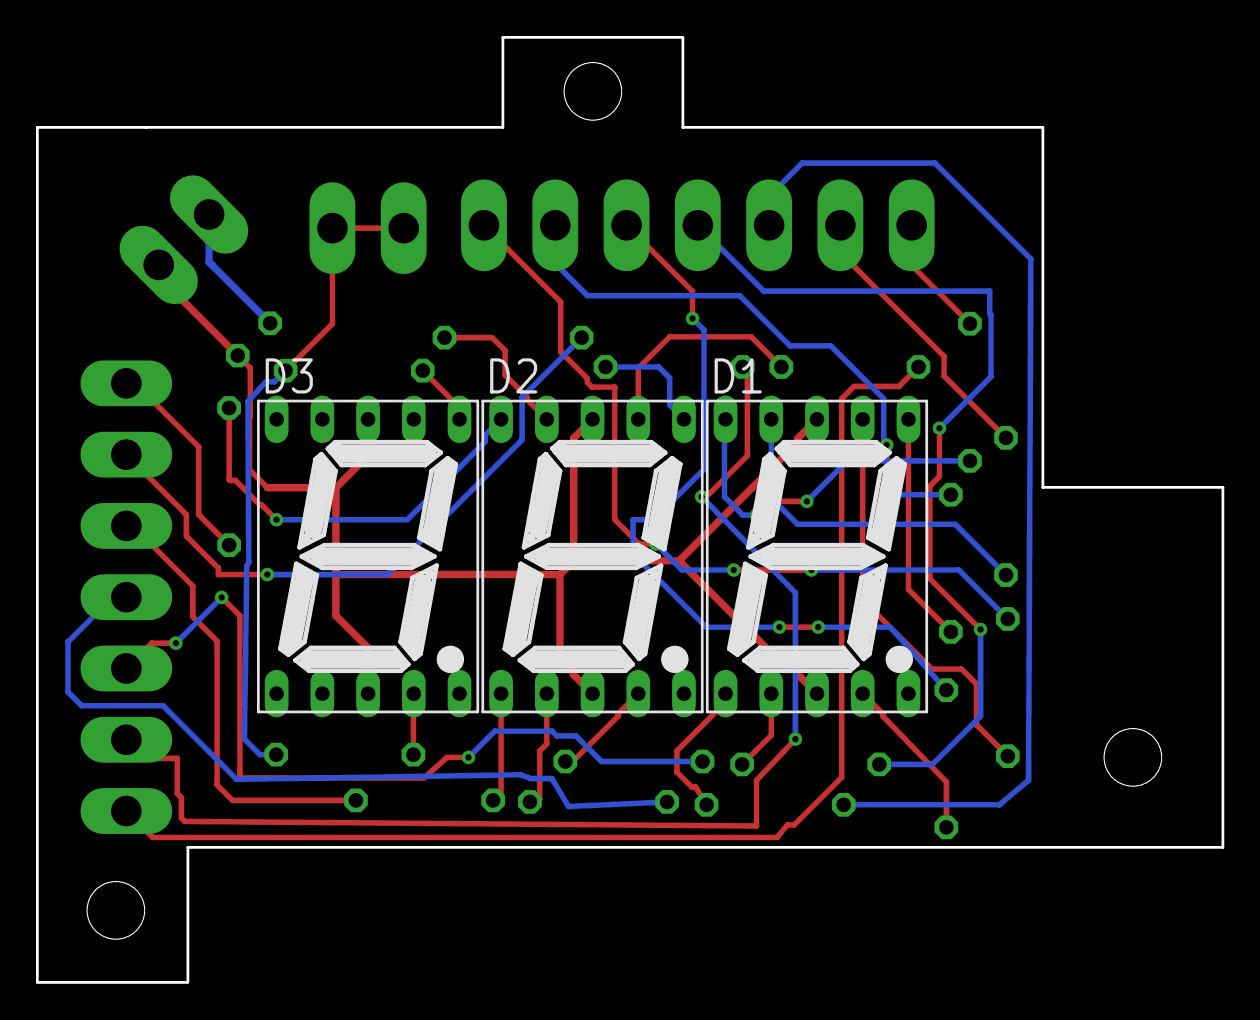
[picture p793: board t_eau.brd from below]

Board: 2 copper layers, 65.9 x 52.5 mm, 24 parts (3 on the bottom side), 33 nets.
