EOSCogniton/STUF2019/EL - Electrical/Autre/Tableau de bord/Tableau vulcanix/Carte avant/electronique_vulcanix-master/Tableau/Rapport/rapport.brd

## EAGLE design EL - Electrical/Autre/Tableau de bord/Tableau vulcanix/Carte avant/electronique_vulcanix-master/Tableau/Rapport/rapport.brd (2018-09-20)

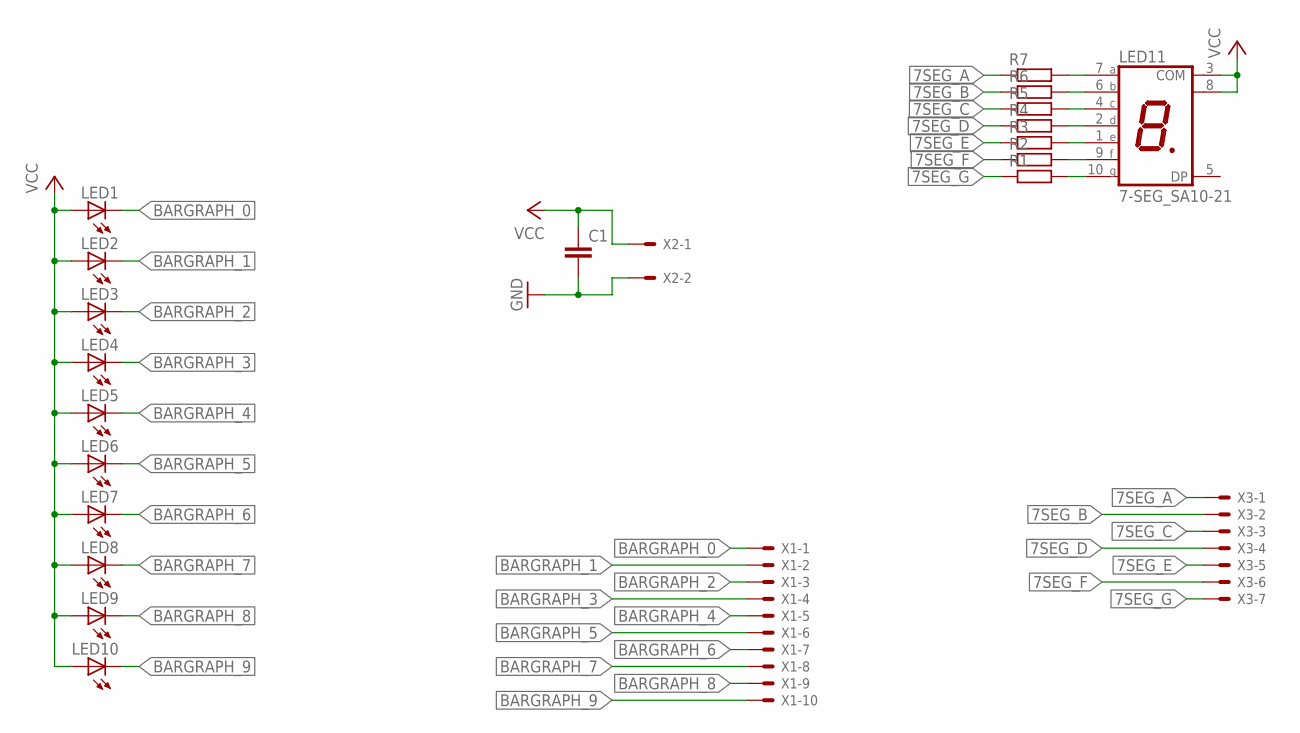
[picture p794: schematic rapport.sch]

Parts:
C1: C-EU025-030X050; C025-030X050
LED1, LED2, LED3, LED4, LED5, LED6, LED7, LED8, LED9, LED10: LED5MM
LED11: 7-SEG_SA10-21; SA10-21
R1, R2, R3, R4, R5, R6, R7: R-EU_0204/7; 0204/7
X1: KK-156-10
X2: KK-156-2
X3: KK-156-7

Connections:
7SEG_A: R7.1, X3.1
7SEG_B: R6.1, X3.2
7SEG_C: R5.1, X3.3
7SEG_D: R4.1, X3.4
7SEG_E: R3.1, X3.5
7SEG_F: R2.1, X3.6
7SEG_G: R1.1, X3.7
BARGRAPH_0: LED1.K (C), X1.1
BARGRAPH_1: LED2.K (C), X1.2
BARGRAPH_2: LED3.K (C), X1.3
BARGRAPH_3: LED4.K (C), X1.4
BARGRAPH_4: LED5.K (C), X1.5
BARGRAPH_5: LED6.K (C), X1.6
BARGRAPH_6: LED7.K (C), X1.7
BARGRAPH_7: LED8.K (C), X1.8
BARGRAPH_8: LED9.K (C), X1.9
BARGRAPH_9: LED10.K (C), X1.10
GND: C1.2, X2.2
unnamed: LED11.7 (A), R7.2
unnamed: LED11.6 (B), R6.2
unnamed: LED11.4 (C), R5.2
unnamed: LED11.2 (D), R4.2
unnamed: LED11.1 (E), R3.2
unnamed: LED11.9 (F), R2.2
unnamed: LED11.10 (G), R1.2
VCC: C1.1, LED1.A, LED2.A, LED3.A, LED4.A, LED5.A, LED6.A, LED7.A, LED8.A, LED9.A, LED10.A, LED11.3 (COM), LED11.8 (COM), X2.1

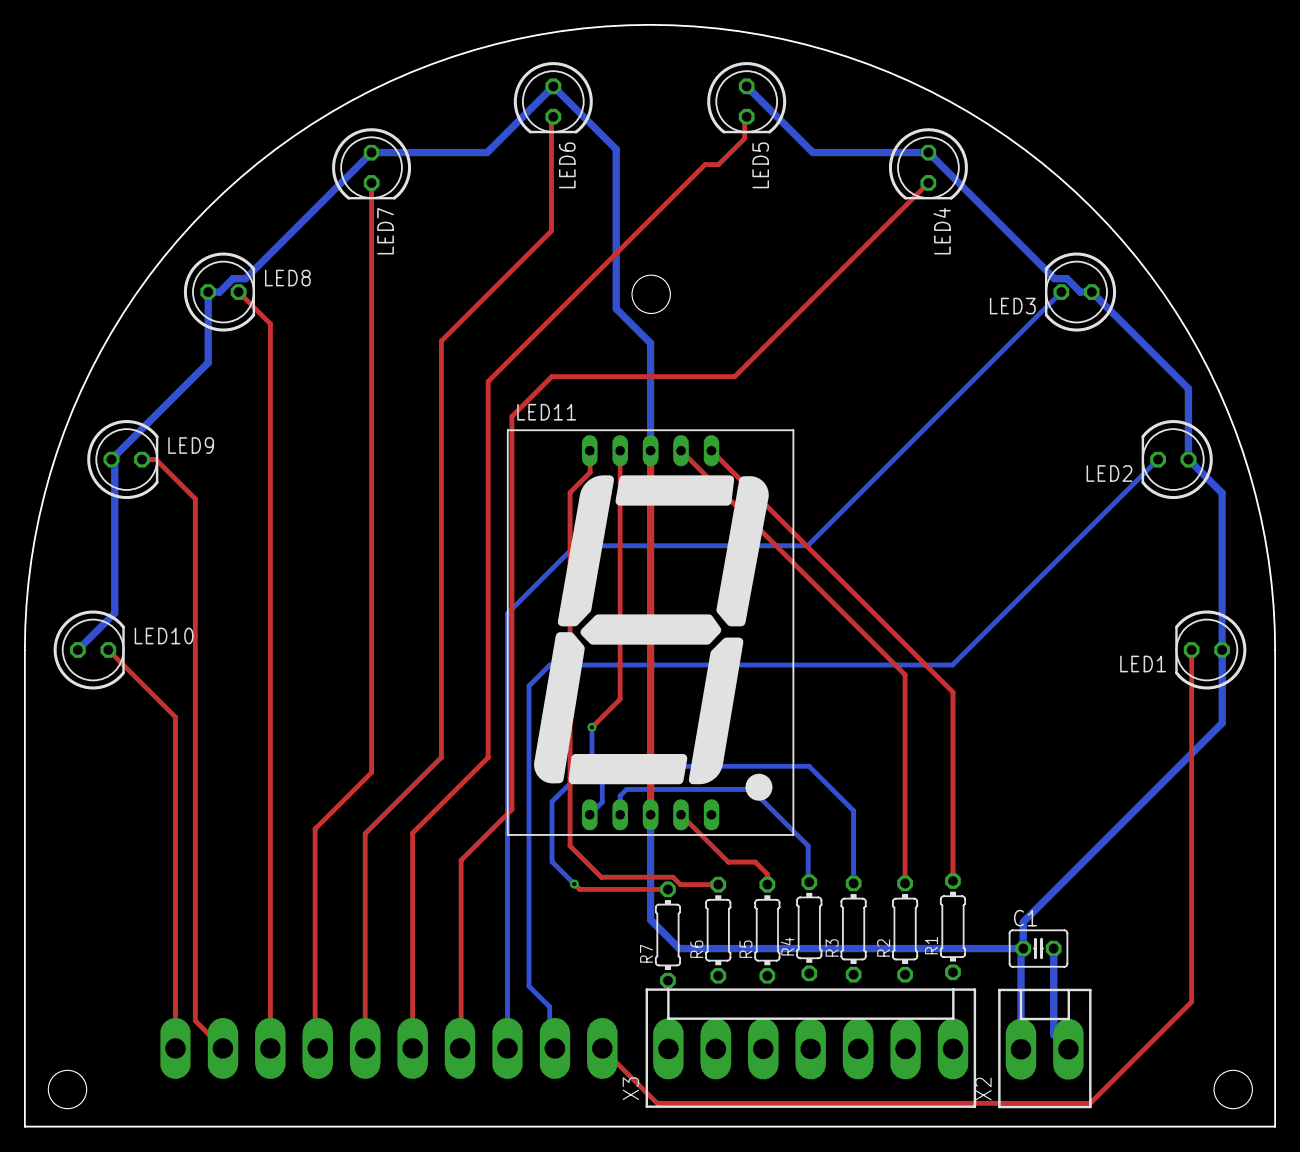
[picture p795: board EL - Electrical/Autre/Tableau de bord/Tableau vulcanix/Carte avant/el… from above]

Board: 2 copper layers, 104.4 x 92.0 mm, 22 parts (1 on the bottom side), 26 nets.
