EOSCogniton/STUF2019/EL - Electrical/Autre/Tableau de bord/Tableau vulcanix/Carte avant/electronique_vulcanix-master/Tableau/Carte commande/tableau.brd

## EAGLE design EL - Electrical/Autre/Tableau de bord/Tableau vulcanix/Carte avant/electronique_vulcanix-master/Tableau/Carte commande/tableau.brd (2018-09-20)

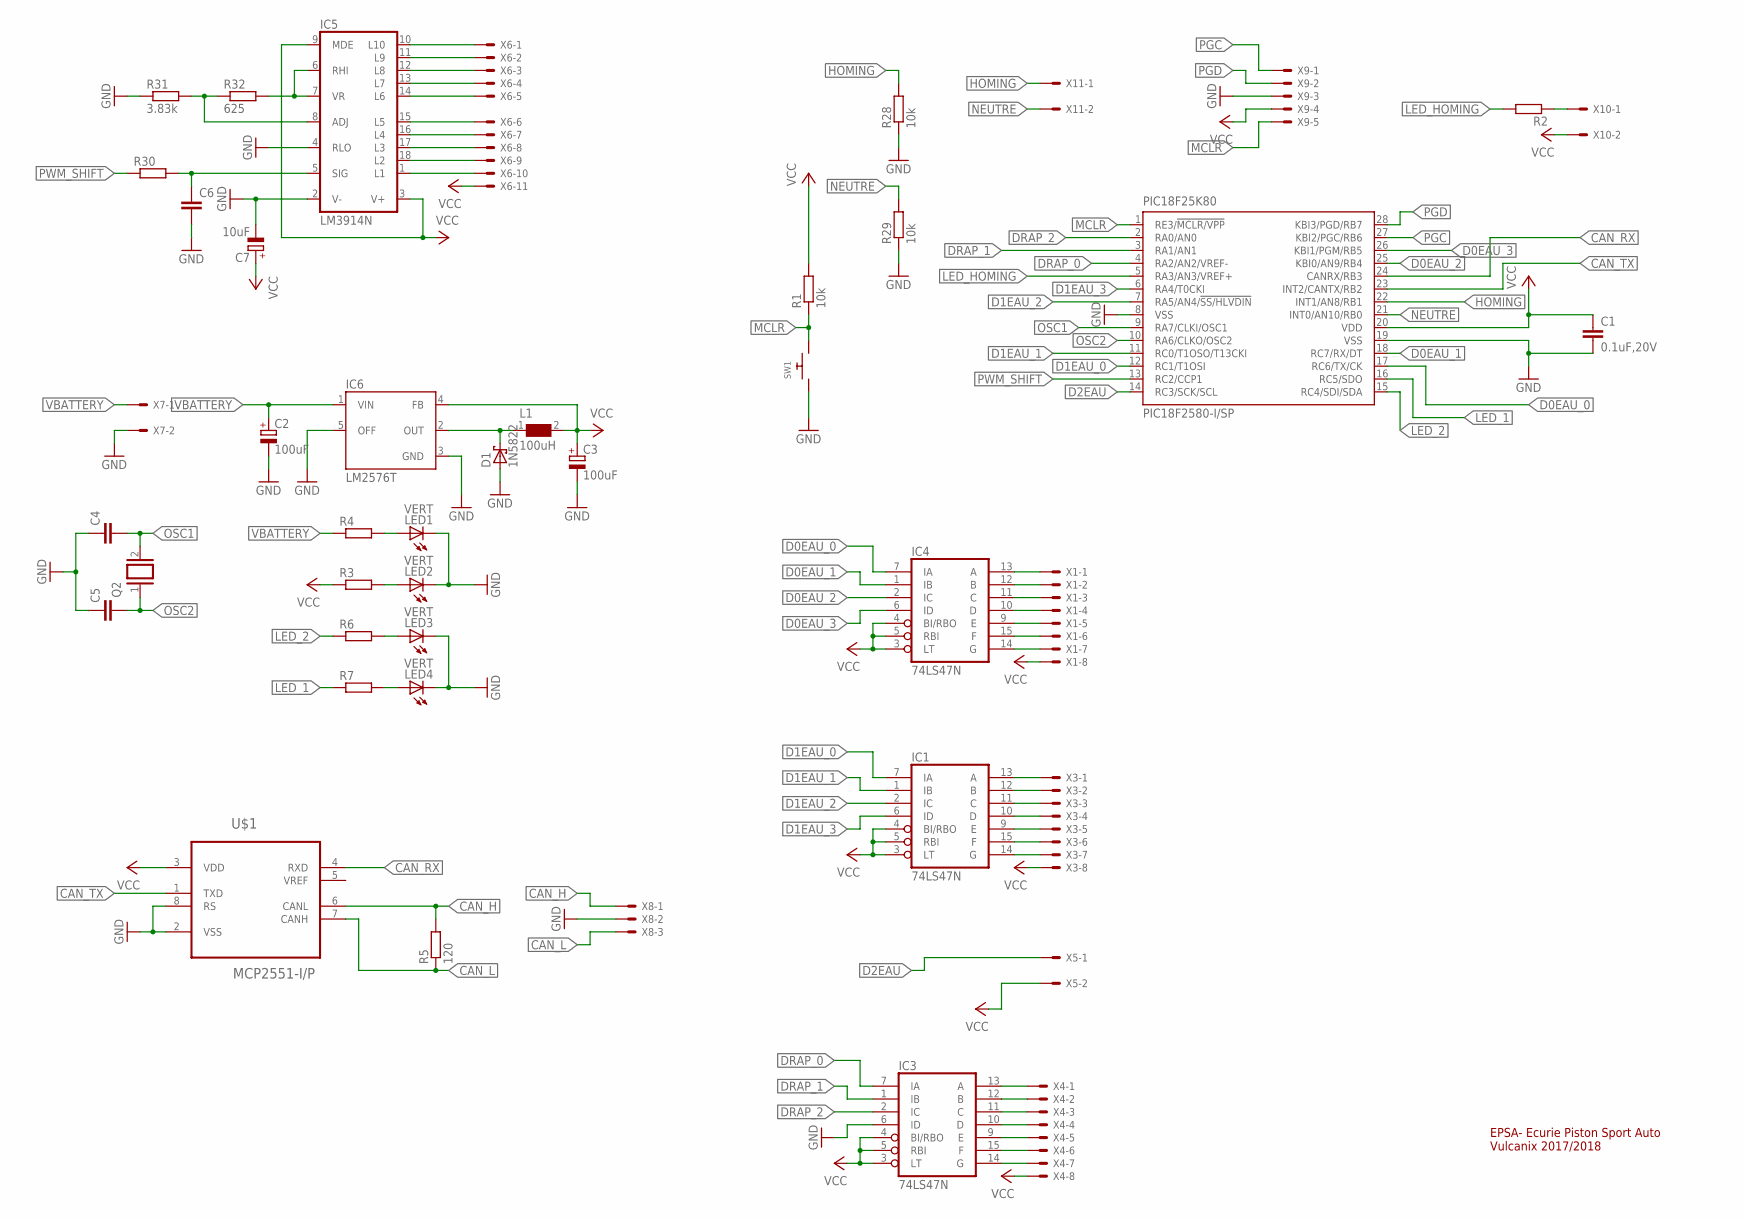
[picture p796: schematic tableau.sch]

Parts:
C1: 0.1uF,20V; C025-025X050
C2, C3: 100uF; E2-5
C4, C5: C-EU025-030X050; C025-030X050
C6: C-EU025-025X050; C025-025X050
C7: 10uF; E2-5
D1: 1N5822; DO201T15
IC1, IC3, IC4: 74LS47N; DIL16
IC5: LM3914N; DIL18
IC6: LM2576T; TO220-5
L1: 100uH; WE-TI_8012B
LED1, LED2, LED3, LED4: VERT; LED3MM
PIC18F25K80: PIC18F2580-I/SP; DIL28-3
Q2: XTAL/S; QS
R1, R28, R29: 10k; 0204/7
R2, R3, R4, R6, R7, R30: R-EU_0204/7; 0204/7
R5: 120; 0204/7
R31: 3.83k; 0204/7
R32: 625; 0204/7
SW1: SWITCH_PUSHBUTTONSOFTTOUCHSMD_SJ; PUSHBUTTON_SMD_SJ
U$1: MCP2551-I/P; DIP254P762X432-8
X1, X3, X4: KK-156-8
X5, X7, X10, X11: KK-156-2
X6: KK-156-11
X8: KK-156-3
X9: KK-156-5

Connections:
CAN_H: R5.2, U$1.6 (CANL), X8.1
CAN_L: R5.1, U$1.7 (CANH), X8.3
CAN_RX: PIC18F25K80.24 (CANRX/RB3), U$1.4 (RXD)
CAN_TX: PIC18F25K80.23 (INT2/CANTX/RB2), U$1.1 (TXD)
D0EAU_0: IC4.7 (IA), PIC18F25K80.17 (RC6/TX/CK)
D0EAU_1: IC4.1 (IB), PIC18F25K80.18 (RC7/RX/DT)
D0EAU_2: IC4.2 (IC), PIC18F25K80.25 (KBI0/AN9/RB4)
D0EAU_3: IC4.6 (ID), PIC18F25K80.26 (KBI1/PGM/RB5)
D1EAU_0: IC1.7 (IA), PIC18F25K80.12 (RC1/T1OSI)
D1EAU_1: IC1.1 (IB), PIC18F25K80.11 (RC0/T1OSO/T13CKI)
D1EAU_2: IC1.2 (IC), PIC18F25K80.7 (RA5/AN4/!SS/HLVDIN)
D1EAU_3: IC1.6 (ID), PIC18F25K80.6 (RA4/T0CKI)
D2EAU: PIC18F25K80.14 (RC3/SCK/SCL), X5.1
DRAP_0: IC3.7 (IA), PIC18F25K80.4 (RA2/AN2/VREF-)
DRAP_1: IC3.1 (IB), PIC18F25K80.3 (RA1/AN1)
DRAP_2: IC3.2 (IC), PIC18F25K80.2 (RA0/AN0)
GND: C1.2, C2.-, C3.-, C4.1, C5.1, C6.2, C7.-, D1.A, IC1.8 (GND), IC3.6 (ID), IC3.8 (GND), IC4.8 (GND), IC5.2 (V-), IC5.4 (RLO), IC6.3 (GND), IC6.5 (OFF), LED1.K (C), LED2.K (C), LED3.K (C), LED4.K (C), PIC18F25K80.8 (VSS), PIC18F25K80.19 (VSS), R28.1, R29.1, R31.1, SW1.P$1, U$1.2 (VSS), U$1.8 (RS), X7.2, X8.2, X9.3
HOMING: PIC18F25K80.22 (INT1/AN8/RB1), R28.2, X11.1
LED_1: PIC18F25K80.16 (RC5/SDO), R7.1
LED_2: PIC18F25K80.15 (RC4/SDI/SDA), R6.1
LED_HOMING: PIC18F25K80.5 (RA3/AN3/VREF+), R2.2
MCLR: PIC18F25K80.1 (RE3/!MCLR/VPP), R1.1, SW1.P$2, X9.5
unnamed: LED1.A, R4.2
unnamed: IC4.13 (A), X1.1
unnamed: LED2.A, R3.2
unnamed: R2.1, X10.1
unnamed: IC4.12 (B), X1.2
unnamed: IC4.11 (C), X1.3
unnamed: IC4.10 (D), X1.4
unnamed: IC4.9 (E), X1.5
unnamed: IC4.15 (F), X1.6
unnamed: IC4.14 (G), X1.7
unnamed: IC1.13 (A), X3.1
unnamed: IC1.12 (B), X3.2
unnamed: IC1.11 (C), X3.3
unnamed: IC1.10 (D), X3.4
unnamed: IC1.9 (E), X3.5
unnamed: IC1.15 (F), X3.6
unnamed: IC1.14 (G), X3.7
unnamed: IC3.13 (A), X4.1
unnamed: IC3.12 (B), X4.2
unnamed: IC3.11 (C), X4.3
unnamed: IC3.10 (D), X4.4
unnamed: IC3.9 (E), X4.5
unnamed: IC3.15 (F), X4.6
unnamed: IC3.14 (G), X4.7
unnamed: IC5.10 (L10), X6.1
unnamed: IC5.11 (L9), X6.2
unnamed: IC5.12 (L8), X6.3
unnamed: IC5.13 (L7), X6.4
unnamed: IC5.14 (L6), X6.5
unnamed: IC5.15 (L5), X6.6
unnamed: IC5.16 (L4), X6.7
unnamed: IC5.17 (L3), X6.8
unnamed: IC5.18 (L2), X6.9
unnamed: IC5.1 (L1), X6.10
unnamed: LED3.A, R6.2
unnamed: LED4.A, R7.2
unnamed: C6.1, IC5.5 (SIG), R30.2
unnamed: IC5.6 (RHI), IC5.7 (VR), R32.2
unnamed: IC5.8 (ADJ), R31.2, R32.1
unnamed: D1.C, IC6.2 (OUT), L1.1
NEUTRE: PIC18F25K80.21 (INT0/AN10/RB0), R29.2, X11.2
OSC1: C4.2, PIC18F25K80.9 (RA7/CLKI/OSC1), Q2.2
OSC2: C5.2, PIC18F25K80.10 (RA6/CLKO/OSC2), Q2.1
PGC: PIC18F25K80.27 (KBI2/PGC/RB6), X9.1
PGD: PIC18F25K80.28 (KBI3/PGD/RB7), X9.2
PWM_SHIFT: PIC18F25K80.13 (RC2/CCP1), R30.1
VBATTERY: C2.+, IC6.1 (VIN), R4.1, X7.1
VCC: C1.1, C3.+, C7.+, IC1.3 (LT), IC1.4 (BI/RBO), IC1.5 (RBI), IC1.16 (VCC), IC3.3 (LT), IC3.4 (BI/RBO), IC3.5 (RBI), IC3.16 (VCC), IC4.3 (LT), IC4.4 (BI/RBO), IC4.5 (RBI), IC4.16 (VCC), IC5.3 (V+), IC5.9 (MDE), IC6.4 (FB), L1.2, PIC18F25K80.20 (VDD), R1.2, R3.1, U$1.3 (VDD), X1.8, X3.8, X4.8, X5.2, X6.11, X9.4, X10.2

Notes on the sheet:
EPSA- Ecurie Piston Sport Auto Vulcanix 2017/2018

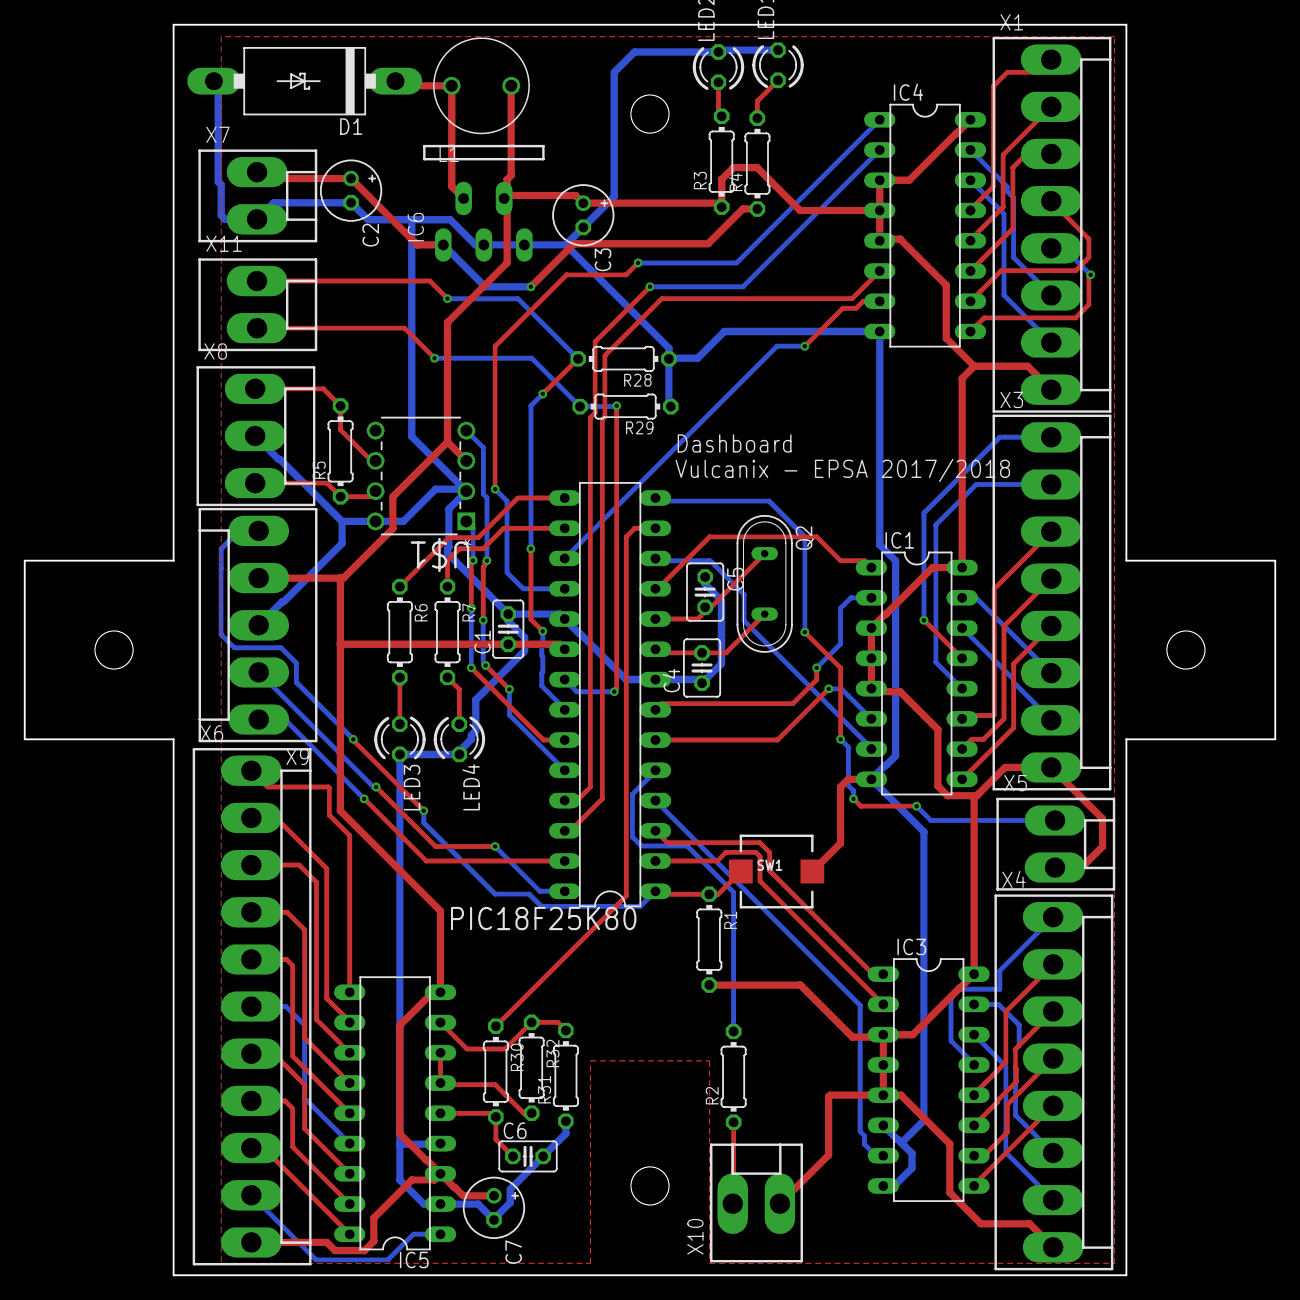
[picture p797: board tableau.brd from above]

Board: 2 copper layers, 105.0 x 105.0 mm, 44 parts (0 on the bottom side), 70 nets.
