EOSCogniton/STUF2019/EL - Electrical/Autre/Tableau de bord/Tableau vulcanix/Carte avant/electronique_vulcanix-master/Carte programdebug/program.brd

## EAGLE design EL - Electrical/Autre/Tableau de bord/Tableau vulcanix/Carte avant/electronique_vulcanix-master/Carte programdebug/program.brd (2018-09-20)

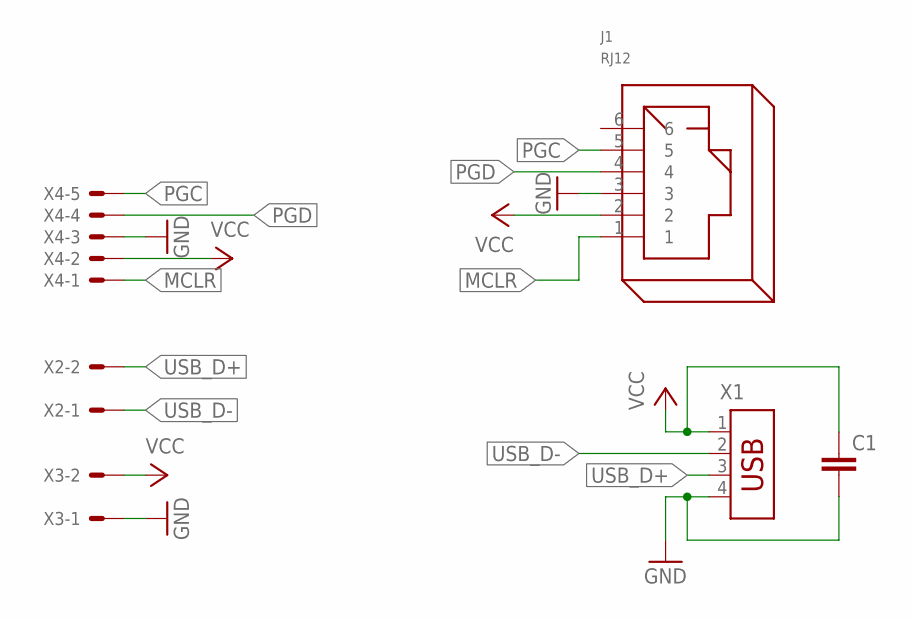
[picture p798: schematic program.sch]

Parts:
C1: C-EU025-030X050; C025-030X050
J1: RJ12
X1: USB-787616; USB
X2, X3: KK-156-2
X4: KK-156-5

Connections:
GND: C1.2, J1.3, X1.4, X3.1, X4.3
MCLR: J1.1, X4.1
PGC: J1.5, X4.5
PGD: J1.4, X4.4
USB_D+: X1.3, X2.2
USB_D-: X1.2, X2.1
VCC: C1.1, J1.2, X1.1, X3.2, X4.2

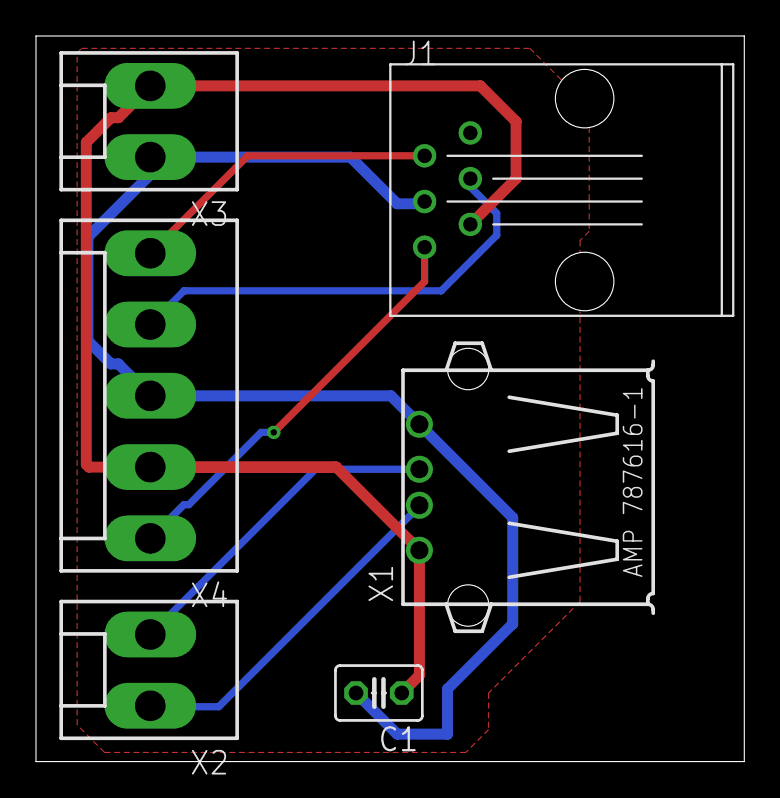
[picture p799: board program.brd from above]

Board: 2 copper layers, 39.3 x 40.3 mm, 6 parts (0 on the bottom side), 7 nets.
