EOSCogniton/STUF2019/(commit log)

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2018-05-02 organisation FRAME et ERGONOMICS
    [FR_0300_000_BA.CATPart, baquet_taille_6.CATPart, filaire.CATPart, tubulaire.CATProduct]
2018-05-24 essais ansys + début filaire châssis
    [FRAME.CATPart, pushbar tubulaire.igs]
2018-05-29 Début conception CATIA châssis
    [filaire.CATPart]
2018-05-29 Organisation des fichiers et Ajout LAS Auto
    [31-520-6-40.stp, 91290A193_BLACK-OXIDE CLASS 12.9 SOCKET HEAD CAP SCREW.CATPart, 91292A268_TYPE 18-8 SS SOCKET HEAD CAP SCREW.CATPart, 94645A101_ZINC-PLATED CLASS 10 STL NYLON-INSERT LOCKNUT.CATPart, CIR.CATPart, CIR_roue.CATPart, Emile_Maurin_23201B_V_CHC_4x10___ZN_cl_8_8___EN_ISO_4762_DIN_912.catpart, Emile_Maurin_23201B_V_CHC_4x16___ZN_cl_8_8___EN_ISO_4762_DIN_912.catpart]
2018-05-30 MIC-3D Optimus
    [Admission.CATPart, Bras sus.CATPart, Chassis 2.CATPart, Chassis.CATPart, Circuit d'essence.CATPart, Fond-plat.CATPart, Jante + pneu.CATPart, LAS.CATPart]
2018-05-30 Avancement châssis
    [FRAME.CATPart, filaire.CATPart]
2018-07-17 avacement filaire
    [chassis filaire.CATPart]
2018-07-20 nouveaux points de LAS
    [Suspension_Frame_points.CATPart]
2018-07-23 avancée filaire
    [filaire.CATPart]
2018-07-23 point las à jour
    [LAS_auto.xls, Suspension_Frame_points.CATPart]
2018-07-24 avancée filaire : hoops
    [filaire.CATPart]
2018-07-26 Ajout pilote aux ergonomics
    [pilote.CATProduct]
2018-08-31 Filaire remanié en polydroites pour tests éléments finis
    [pour tests.CATPart]
2018-09-11 Ajout Ergo
    [Gabarit Homme 95.CATPart, filaire-ergonomics.CATProduct]
2018-09-11 Men 95 baquet et volant
    [Proshift.CATPart, ST_0400_001_AA.CATPart, ST_0400_AA.CATProduct, filaire.CATPart]
2018-09-11 Correction ergo
    [filaire-ergonomics.CATProduct]
2018-09-11 avancée châssis + début tubulaire
    [filaire.CATPart, tubulaire.CATProduct]
2018-09-13 test BAR 2
    [Ohlins_variable.CATProduct, test architecture 2.CATProduct]
2018-09-17 Modif insert chassis
    [Insert_Frame_Side.CATPart]
2018-09-18 las auto
    [LAS_auto.xls.xlsx]
2018-09-18 Création d'un dossier freinage avec ressources
    [BR_0200_001 (Brake Disc).CATPart, BR_0200_001 (Brake Disc).igs, Brake_disc_test.CATPart, Brake_disc_test.igs, LAS_auto.xls]
2018-09-18 Nouveau châssis (vulcanix aavec new LAS points
    [FRAME.CATPart]
2018-09-18 avancée châssis
    [FRAME.CATPart]
2018-09-18 test BAR architecture 1
    [ARB_rod.CATPart, ST_0200_001_MM.CATPart, SU_13005_FRONT ARB.CATPart, SU_13009_ARB END PLATE.CATPart, proto_bascu.CATPart, test architecture 2.CATProduct]
2018-09-18 LAS auto à jour, pas de fucked up svp
    [Front_Lower_A_Arm_Front_Rod.CATPart, Front_Lower_A_Arm_Rear_Rod.CATPart, Front_Push_Rod.CATPart, Front_Rocker.CATPart, Front_Upper_A_Arm_Front_Rod.CATPart, Front_Upper_A_Arm_Rear_Rod.CATPart, LAS_auto.xls, Left_Wireframe_Front_Lower_Arm.CATPart]
2018-09-18 Préparation travail roues équipées
    [Front Upright Working Assy.CATProduct, Left_Wireframe_Front_Upright.CATPart, Left_Wireframe_Rear_Upright.CATPart, SU_1000_001 (Front Left Upright).CATPart, SU_A1000 (Front Left Wheel Assy).CATProduct, WT_0100_001 (Oz Magnesium Rim).CATPart, WT_0100_002 (Tire Hoosier 13).CATPart, WT_A0100 (Wheel Assy).CATProduct]
2018-09-19 MIA-3D TOP Appro début
    [Admission.CATPart, Bras sus.CATPart, Chassis 2.CATPart, Chassis.CATPart, Circuit d'essence.CATPart, FRAME.CATPart, FR_0300_000_BA.CATPart, Fond-plat.CATPart]
2018-09-20 Ajout pédalier
    [210203-6x16.CATPart, 210203-6x40.CATPart, 3871-482.CATPart, Assemblage tubes chassis et pedalier.CATProduct, CP3823-114.CATPart, CP5511-140.CATPart, CP5854-104_fitted.CATPart, CP5854-4M_CP5854-125.CATPart]
2018-09-20 maj pedalier
    [Cale.CATPart, FR_A0300.CATProduct, JIS_B_1180_M8x40_STEEL_GRADE_A_HEXAGON_HEAD_BOLT.CATPart, JIS_B_1181_M8_STEEL_GRADE_C_HEXAGON_NUT.CATPart]
2018-09-20 aide de PA
    [Ohlins_variable.CATProduct, test architecture 2.CATProduct]
2018-09-20 Ajout partie elec
    [Book1.xlsx, Bouton poussoir Raz motored.CATPart, Bouton poussoir demarrage.CATPart, Bouton poussoir.CATPart, Cablage Optimus.xlsx, Cahier des charges S0.xlsx, Cahier des charges SEISM.xlsx, Cahier des charges.xlsx]
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2018-09-20 MAJ command elec
    [Commandes.xlsx]
2018-09-20 Support batterie
    Premier essai support batterie
    [EL_A0200.CATProduct, EL_A0200_001_AA (battery support).CATPart]
2018-09-20 Reorganisation Brake system dossier
    [BR_0200_001 (Brake Disc).CATPart, BR_0200_001 (Brake Disc).igs, Brake_disc_test.CATPart, Brake_disc_test.igs]
2018-09-20 position moteur et suspensions arrières
    [FRAME.CATPart, filaire.CATPart, pour tests.CATPart]
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2018-09-20 Reorganisation dossier Frame
    [FRAME.CATPart, FR_0300_000_BA.CATPart, filaire.CATPart, pour tests.CATPart, pushbar tubulaire.igs, tubulaire.CATProduct]
2018-09-20 Suppresion ergo + creation miscelleanous à la place
    [Gabarit Homme 95.CATPart, Proshift.CATPart, ST_0400_001_AA.CATPart, ST_0400_AA.CATProduct, baquet_taille_6.CATPart, filaire-ergonomics.CATProduct, filaire.CATPart, pilote.CATProduct]
2018-09-20 Electrical dossier
    [EL_A0300.CATProduct, EL_A0300_001_AA (battery support).CATPart]
2018-09-20 Dossier wheels and tyres
    [WT_0100_001 (Oz Magnesium Rim).CATPart, WT_0100_002 (Tire Hoosier 13).CATPart, WT_0200_001 (Front Hub).CATPart, WT_0300_001 (Rear Hub).CATPart, WT_A0100 (Wheel Assy).CATProduct]
2018-09-20 Cremaillere + quick release
    [ST_0200_001_MM.CATPart, ST_0300_01_MM.CATPart]
2018-09-20 Roue roue roux
    [BR_0200_001 (Break Disc).CATPart, Brake Bell.CATPart, SU_1000_001 (Front Left Upright).CATPart, SU_A1000 (Front Left Wheel Assy).CATProduct, WT_0200_001 (Front Hub).CATPart]
2018-09-21 tubulaire + organisation
    [FRAME opt.CATPart, FRAME.CATPart, STRMember_534984207253000.CATPart, STRMember_534984208581000.CATPart, STRMember_534984209680000.CATPart, STRMember_534984211993000.CATPart, STRMember_534984214242000.CATPart, STRMember_534984218104000.CATPart]
2018-09-21 Tubulaire + filaire cellule avant
    [FRAME opt.CATPart, STRMember_534984207253000.CATPart, STRMember_534984208581000.CATPart, STRMember_534984209680000.CATPart, STRMember_534984211993000.CATPart, STRMember_534984214242000.CATPart, STRMember_534984218104000.CATPart, STRMember_53498422683000.CATPart]
2018-09-21 test architecture BAR up
    [ARB_rod.CATPart, FRAME opt 2.CATPart, FRAME opt.CATPart, Ohlins_variable.CATProduct, ST_0200_001_MM.CATPart, SU_13005_FRONT ARB.CATPart, SU_13009_ARB END PLATE.CATPart, filaire lower arm.CATPart]
2018-09-22 architecture up
    [basucleur_up.CATPart, test_assy_up.CATProduct]
2018-09-22 Anciennes maquettes aéro pour italiens et tests forces centrifuges disques de frein
    [Aero (Copie en conflit de niels Pichon 2015-11-20).CATProduct, Aero.CATProduct, Aero_Matthieu_carrosserie_plaque laterale_1.CATPart, Aero_Matthieu_carrosserie_plaque laterale_2.CATPart, Aero_Matthieu_carrosserie_plaque laterale_3.CATPart, Aero_Matthieu_carrosserie_plaque laterale_4.CATPart, Aero_Matthieu_carrosserie_plaque laterale_5.CATPart, Aero_Matthieu_carrosserie_plaque laterale_6.CATPart]
2018-09-22 Roue avant équipée basique
    [Brake Bell.CATPart, Front Upright Working Assy.CATProduct, SU_10001 (Front Left Upright).CATPart, SU_10002 (Front Upper Arm Bracket).CATPart, SU_1000_001 (Front Left Upright).CATPart, SU_A1000 (Front Left Wheel Assy).CATProduct, WT_02001 (Front Hub).CATPart, WT_0200_001 (Front Hub).CATPart]
2018-09-22 architecture up compléments
    [ARB_rod 2.CATPart, FRAME opt 2.CATPart, basucleur_up.CATPart, test_assy_up.CATProduct]
2018-09-23 modif points LAS
    [LAS_auto.xlsx]
2018-09-23 Las Auto à jour
    [Front Upright Working Assy.CATProduct, Front_Lower_A_Arm_Front_Rod.CATPart, Front_Lower_A_Arm_Rear_Rod.CATPart, Front_Push_Rod.CATPart, Front_Rocker.CATPart, Front_Upper_A_Arm_Front_Rod.CATPart, Front_Upper_A_Arm_Rear_Rod.CATPart, Insert_frame_side.CATProduct]
2018-09-23 Roues avant
    [Front Upright Working Assy.CATProduct, SU_10001 (Front Left Upright).CATPart, SU_10002 (Front Upper Arm Bracket).CATPart, SU_10003 (Front Upper Arm Wedge).CATPart, SU_A1000 (Front Left Wheel Assy).CATProduct]
2018-09-23 modif nom
    [shifter.brd, shifter.sch]
2018-09-26 code arduino BSPD (si jamais)
2018-09-27 debut architecture 3
    [FRAME opt 3.CATPart, Left_Wireframe_Front_Upper_Arm.CATPart, Ohlins_variable.CATProduct, architecture 3.CATProduct, filaire lower arm.CATPart, piston.CATPart, test_assy_up.CATProduct]
2018-09-29 Préparation roue arrière
    [Left_Wireframe_Rear_Upright.CATPart, Rear Upright Working Assy.CATProduct, SU_11001 (Rear Left Upright).CATPart, SU_A1100 (Rear Left Wheel Assy).CATProduct, WT_0300_001 (Rear Hub).CATPart]
2018-09-29 modifs jante + positionnement frette
    [Brake Bell.CATPart, Front Upright Working Assy.CATProduct, SU_10001 (Front Left Upright).CATPart, SU_10002 (Front Upper Arm Bracket).CATPart, SU_10003 (Front Upper Arm Wedge).CATPart, SU_A1000 (Front Left Wheel Assy).CATProduct, WT_0100_001 (Oz Magnesium Rim).CATPart, WT_02001 (Front Hub).CATPart]
2018-09-30 Modifs épaisseurs moyeux avant pour avoir eq an dernier en flexion
    [WT_02001 (Front Hub).CATPart]
2018-10-01 Ajout règlement, + modif châssis, cellule arrière : bièle LAS, supports moteur, tentative facilitation suspension LAS et optimisation
    [FRAME opt.CATPart]
2018-10-01 Auto stash before merge of "master" and "origin/master"
    [test1.sch, test1.stl]
2018-10-01 ajout contacteur aux commandes
    [Commandes.xlsx]
2018-10-01 Ajout cahier des charges TdB
    [Cahier des charges TdB.xlsx]
2018-10-01 ca avance calmement
    [ARB rod 3.CATPart, FRAME opt 3.CATPart, Ohlins_variable.CATProduct, SU_13005_FRONT ARB.CATPart, SU_13009_ARB END PLATE.CATPart, architecture 3.CATProduct, basculeur 3.CATPart, push rod 3.CATPart]
2018-10-01 Dossier essais
    [support.CATPart]
2018-10-01 architecture susp avant
    [ARB rod 3.CATPart, arb rod.CATPart, architecture 3.2.CATProduct, architecture 3.CATProduct, push rod 3.CATPart, push rod.CATPart]
2018-10-01 Ajout début liste composants tableau de bord Optimus
    [Liste des composants du tableau de bords [romain].ods]
2018-10-02 susp av
    [architecture 3.2.CATProduct]
2018-10-02 chassis avancée
    [Cockpit opening template (1).CATPart, FRAME opt.CATPart, Shape_184.CATPart, Shape_185.CATPart, Shape_186.CATPart, Shape_187.CATPart, Shape_188.CATPart, Shape_189.CATPart]
2018-10-02 archi 3.1
    [architecture 3.1.CATProduct]
2018-10-02 nez encore
    [Nez_v_0.3.CATPart]
2018-10-02 support moteur châssis
    [FRAME opt.CATPart]
2018-10-02 Essai traction alu-alu début
    [GE_8_C.CATProduct, GE_8_Cblr_001_101_spb_ge1.CATPart, GE_8_Cblr_001_101_spb_ge2.CATPart, assemblage_traction.CATProduct, inserts.CATPart]
2018-10-02 Test traction
    [assemblage_traction.CATProduct, entretoise.CATPart, insert_manchon.CATPart, inserts.CATPart]
2018-10-03 modif susp av
    [architecture 3.1 - sans contraintes.CATProduct, chape_ARB_front hoop.CATPart, end plate sans flexion.CATPart]
2018-10-03 Ajout chappe parametrique
    [chappe V2.CATPart, parametrage chappe V2.xls]
2018-10-03 Ajout batterie
    [EL_A0300_002_AA (battery).CATPart]
2018-10-03 Liste des composants, et compte rendus
    [Liste des composants du tableau de bords [romain].ods]
2018-10-03 réorganisation et inclusion de documents (EL - Electrical)
    [EL_A0300.CATProduct, EL_A0300_001_AA (battery support).CATPart, EL_A0300_002_AA (battery).CATPart]
2018-10-03 rear upright
    first try
    [SU_11001 (Rear Left Upright).CATPart]
2018-10-03 Test traction alu alu
    [assemblage_traction.CATProduct, insert_manchon.CATPart]
2018-10-04 Ajout ZF Damper
    [Damper_ZF.CATProduct, ZF_Damper_Part1.CATPart, ZF_Damper_Part2.CATPart]
2018-10-04 création fichiers tests (filaire polydroites, tubulaire associé)
    [15x1.5.CATProduct, 20x1.5.CATProduct, 25x1.5.CATProduct, 30x1.5.CATProduct, 30x2.CATProduct, FRAME opt.CATPart, Shape_271.CATPart, Shape_272.CATPart]
2018-10-04 update filaire offset points LAS + rajout tube oublié tubulaire
    [25x1.5.CATProduct, FRAME opt.CATPart, Shape_401.CATPart, Tubes.CATProduct, tubulaire test.CATProduct]
2018-10-04 Début maquette
    [Optimus.CATProduct]
2018-10-04 ajout pièce essai rotule
    [Piece_taraude_essaitraction_chanfreins.CATPart]
2018-10-04 MAJ assembage Optimus
    [Engine & Powertrain.CATProduct, Optimus.CATProduct]
2018-10-04 MAJ maquette Optimus v2
    [Aero.CATProduct, Engine & Powertrain.CATProduct, Frame & Body.CATProduct, Optimus.CATProduct, Steering.CATProduct, Suspension.CATProduct, filaire tests.CATPart]
2018-10-04 Tous les chassis sont dans vos départements <3
    [Electrical.CATProduct, Optimus.CATProduct]
2018-10-04 rectification point support moteur
    [FRAME opt.CATPart]
2018-10-04 Montage carter + assemblage moteur
    [EN_0101_001 (Rear carter wall).CATPart, EN_0101_002 (Side carter wall).CATPart, EN_0101_003 (Front carter wall).CATPart, EN_0101_004 (Bottom rear carter wall).CATPart, EN_0101_005 (Bottom front carter wall).CATPart, EN_0101_006 (Screw emptying plate).CATPart, EN_0101_007 (Etanchity plate).CATPart, EN_0101_008 (Small longi plate).CATPart]
2018-10-04 jsuis con
    [15x1.5.CATProduct, Shape_340.CATPart, Shape_341.CATPart, Tubes.CATProduct, filaire tests.CATPart, filaire.CATPart, pour tests.CATPart, pushbar tubulaire.igs]
2018-10-04 MAJ maquette
    [EN_A0100 (Engine Assy).CATProduct, EN_A0101 (Carter Assy).CATProduct, Engine & Powertrain.CATProduct]
2018-10-04 jante plus propre et vis de 6
    [Front Upright Working Assy.CATProduct, SU_10001 (Front Left Upright).CATPart, SU_10002 (Front Upper Arm Bracket).CATPart, SU_10003 (Front Upper Arm Wedge).CATPart, SU_A1000 (Front Left Wheel Assy).CATProduct, WT_0100_001 (Oz Magnesium Rim).CATPart, WT_0100_002 (Tire Hoosier 13).CATPart, WT_A0100 (Wheel Assy).CATProduct]
2018-10-04 Ajout points de direction
    [LAS_auto.xls, LAS_auto_save_GTE.xls, Steering_system_Assy.CATProduct]
2018-10-04 Création steering assy
    [Steering_system_Assy.CATProduct]
2018-10-04 Update roue
    [Front Upright Working Assy.CATProduct, SU_10001 (Front Left Upright).CATPart, SU_10002 (Front Upper Arm Bracket).CATPart, SU_10003 (Front Upper Arm Wedge).CATPart, SU_A1000 (Front Left Wheel Assy).CATProduct]
2018-10-05 Intégration pédalier sur Frame
    [FR_A0300.CATProduct, Frame & Body.CATProduct]
2018-10-05 Push Optimus sa mere
    [Aero.CATProduct, Electrical.CATProduct, Optimus.CATProduct, Steering.CATProduct, Suspension.CATProduct]
2018-10-05 pb vis
    [FR_A0300.CATProduct]
2018-10-06 modif susp avant / basculeur
    [ARB.CATProduct, architecture 3.3.CATProduct, basculeur 3.CATPart]
2018-10-06 Faisceau V1.1
    je vais casser le git alors que je pourrai bosser en local
    [Commandes.xlsx]
2018-10-06 Ajout LAS auto + roue avant susp assy
    [LAS_auto.xls, SU_10001 (Front Left Upright).CATPart, SU_10002 (Front Upper Arm Bracket).CATPart, SU_10003 (Front Upper Arm Wedge).CATPart, SU_A1000 (Front Left Wheel Assy).CATProduct, Suspension.CATProduct, Suspension_Frame_points.CATPart, Suspension_Wireframe.CATProduct]
2018-10-06 susp av (encore)
    [ARB.CATProduct, FRAME opt.CATPart, Left_Wireframe_Front_Upper_Arm copy.CATPart, Left_Wireframe_Front_Upper_Arm.CATPart, architecture 3.3.CATProduct, basculeur 3.CATPart, push rod.CATPart]
2018-10-06 compléments pièces roues avants
    [Comparaison gain de poids Vulcanix.xlsx, Front Upright Working Assy.CATProduct, KM_10.CATPart, MB_10.CATPart, S71910_ACD_P4A.CATProduct, S71910_ACD_P4A_PART1.CATPart, S71910_ACD_P4A_PART2.CATPart, S71910_ACD_P4A_PART3.CATPart]
2018-10-06 pb de versions réglés
    [15x1.5.CATProduct, 20x1.5.CATProduct, 25x1.5.CATProduct, 30x1.5.CATProduct, 30x2.CATProduct, Filaire Optimus.CATPart, Shape_271.CATPart, Shape_272.CATPart]
2018-10-06 Rectification erreurs engendrées sur le tubulaire
    [20x1.5.CATProduct, 25x1.5.CATProduct, 30x1.5.CATProduct, Filaire Optimus.CATPart, Shape_403.CATPart, Shape_404.CATPart, Shape_405.CATPart, Shape_406.CATPart]
2018-10-06 Modif test traction alu alu
    [insert_manchon.CATPart, inserts.CATPart]
2018-10-06 bon filaire
    [Filaire Optimus.CATPart, architecture 3.3.CATProduct]
2018-10-07 rear upright modifications
    [Rear Upright Working Assy.CATProduct, SU_11001 (Rear Left Upright).CATPart]
2018-10-07 Etrier olympix arr
    [Etrier_beringer_arr_Olympix.CATPart]
2018-10-07 test étrier arrière olympute
    [Etrier_beringer_arr_Olympix.CATPart]
2018-10-07 ajouts rotules + ...
    [GE_6_E.CATProduct, GE_6_E_dummy.CATPart, GE_6_E_ir.CATPart, GE_6_E_or.CATPart, GE_8_E.CATProduct, GE_8_E_dummy.CATPart, GE_8_E_ir.CATPart, GE_8_E_or.CATPart]
2018-10-07 Ajout doc du crash sensor
2018-10-07 Disque frein atomix + debut triangles
    [Inner Bearing support.CATPart, SU_A01001.CATProduct, disque_frein_atomix_arr.CATPart, disque_frein_atomix_av.CATPart]
2018-10-07 Triangle sup avant
    [GE_6_E.CATProduct, GE_6_E_dummy.CATPart, GE_6_E_ir.CATPart, GE_6_E_or.CATPart, Inner Bearing support.CATPart, SU_A01001.CATProduct]
2018-10-07 faisceau, Pspice et capteurs variohm
    [Encore_un_test.sch, test1.sch, test1.stl]
2018-10-07 j'ai oublié ça
    [Commandes.xlsx]
2018-10-07 Modif insert las auto
    [GE_8_C.CATProduct, GE_8_Cblr_001_101_spb_ge1.CATPart, GE_8_Cblr_001_101_spb_ge2.CATPart, Insert_Frame_Side.CATPart, Insert_frame_side.CATProduct, Suspension_Wireframe.CATProduct, insert_frame_side.CATProduct]
2018-10-07 modifs pour aurélien
    [Front_Lower_A_Arm_Front_Rod.CATPart, Front_Lower_A_Arm_Rear_Rod.CATPart, Front_Push_Rod.CATPart, Front_Upper_A_Arm_Front_Rod.CATPart, Front_Upper_A_Arm_Rear_Rod.CATPart, LAS_auto.xls, Left_Wireframe_Front_Lower_Arm.CATPart, Left_Wireframe_Front_Upper_Arm.CATPart]
2018-10-07 Remise en place du châssis
    [Suspension.CATProduct]
2018-10-07 Pièces essais collage rotules
    ajout de pièces
    [Piece_bloc_blocage_rotule.CATPart, plaque_blocage_rotule.CATPart]
2018-10-08 Debut modelisation TdB Catia
    [Liste des composants du tableau de bords [romain].ods, Support_tdb.CATPart, Tableau de Bords Optimus.CATPart, Tableau de Bords Optimus2.CATPart, afficheur Temp.CATPart, bouton d'arret d'urgence.CATPart]
2018-10-08 Préparation paramétrage offset LAS
    [Filaire Optimus.CATPart]
2018-10-08 Prise en compte de l'offset des points LAS en paramétrique selon l'axe des triangles
    [Filaire Optimus.CATPart]
2018-10-08 reprise tubulaire post pb versions
    [15x1.5.CATProduct, 20x1.5.CATProduct, 25x1.5.CATProduct, 30x1.5.CATProduct, 30x2.CATProduct, Shape_271.CATPart, Shape_272.CATPart, Shape_273.CATPart]
2018-10-08 Tubulaire à jour (problème tubes sur hoops réglé)
    [15x1.5.CATProduct, 20x1.5.CATProduct, 25x1.5.CATProduct, 30x2.CATProduct, Filaire Optimus.CATPart, Shape_438.CATPart, Shape_440.CATPart, Shape_482.CATPart]
2018-10-08 support tableau de bords
    [Liste des composants du tableau de bords [romain].ods, Tableau de Bords Optimus3.CATPart]
2018-10-08 Assemblage collage rotules
    [Piece_bloc_blocage_rotule.CATPart, Piece_taraude_essaitraction_chanfreins.CATPart, assemblage_collage_rotules.CATProduct, trou_rotule.CATPart]
2018-10-08 avancement tableau de bords
    [Tableau de Bords Optimus3.CATPart]
2018-10-08 ajout elmp sensor et commande variohm
    [Commandes.xlsx]
2018-10-08 Pue du cul
    [Bearing support adjustable.CATPart]
2018-10-09 Correction du problème chassis sur l'assemblage les gaziers
    [3871-482.CATPart, Aero.CATProduct, BR_0200_001 (Break Disc).CATPart, CP3823-114.CATPart, CP5511-140.CATPart, CP5854-104_fitted.CATPart, CP5854-4M_CP5854-125.CATPart, CP5854-5M_CP5854-136.CATPart]
2018-10-09 Aero kinetix à la poubelle
    [Aero (Copie en conflit de niels Pichon 2015-11-20).CATProduct, Aero.CATProduct, Aero_Matthieu_carrosserie_plaque laterale_1.CATPart, Aero_Matthieu_carrosserie_plaque laterale_2.CATPart, Aero_Matthieu_carrosserie_plaque laterale_3.CATPart, Aero_Matthieu_carrosserie_plaque laterale_4.CATPart, Aero_Matthieu_carrosserie_plaque laterale_5.CATPart, Aero_Matthieu_carrosserie_plaque laterale_6.CATPart]
2018-10-09 Le collecteur est dans le chassis mes guenilles
    [18M_EN_0200_009.igs, EN_0101_001 (Rear carter wall).CATPart, EN_0101_002 (Side carter wall).CATPart, EN_0101_003 (Front carter wall).CATPart, EN_0101_004 (Bottom rear carter wall).CATPart, EN_0101_005 (Bottom front carter wall).CATPart, EN_0101_007 (Etanchity plate).CATPart, EN_0101_008 (Small longi plate).CATPart]
2018-10-09 Réglage pb aero
    [Aero.CATProduct]
2018-10-09 MAJ AE
    [Aero.CATProduct, Engine & Powertrain.CATProduct, Filaire Optimus.CATPart, Optimus.CATProduct]
2018-10-09 Ancien design des disques de frein
    [22-048-OC.CATProduct, 230-164-L av.igs, 230-164-L.CATPart, 2A1A ind.05.CATPart, 2D1 arr.igs, 2P1A ind_1.CATPart, 48_axial.CATPart, Assamblaje disque Avant Definitive sans etrier.CATProduct]
2018-10-09 Rectification bêtises du directeur technique (oui encore...)
    [25x1.5.CATProduct, 30x2.CATProduct, Filaire Optimus.CATPart, Shape_545.CATPart, Shape_546.CATPart, Shape_547.CATPart, Tubes.CATProduct, Tubulaire Optimus.CATProduct]
2018-10-09 Ajout tubes carrés tubulaire
    [20x1.5.CATProduct, 25x1.5.CATProduct, 30x1.5.CATProduct, Shape_444.CATPart, Shape_507.CATPart, Shape_539.CATPart, Shape_548.CATPart, Shape_549.CATPart]
2018-10-09 MAJ Echappement
    [EN_0200_006_AA (1).CATPart, EN_0200_007_AA (1).CATProduct, EN_0200_007_AA.1 (1).CATPart, EN_0200_007_AA.2 (1).CATPart, EN_0200_007_AA.3 (1).CATPart, EN_0200_007_AA.4 (1).CATPart, EN_0200_031_AA (1).CATProduct, EN_0200_032_AA (1).CATProduct]
2018-10-09 Assemblage essais rotule
    Assemblage presque fini
    [Assemblage final.CATProduct]
2018-10-09 Avancesupport moteur et MAJ sur powertrain
    [15x1.5.CATProduct, EN_A0100 (Engine Assy).CATProduct, EN_A0200.CATProduct, Engine & Powertrain.CATProduct, Filaire Optimus.CATPart, Shape_452.CATPart, Shape_453.CATPart, Shape_454.CATPart]
2018-10-09 modif LAS auto
    [LAS_auto.xls]
2018-10-09 nez quali
    [FR_07001.CATPart]
2018-10-09 Ajout catia elec
    [8STA-10.CATPart, 8STA-12.CATPart, 8STA-14.CATPart, 8STA-16.CATPart, 8STA-18.CATPart, EL_0100_001_AA.CATPart, EL_0100_002_AA.CATPart, EL_0100_003__AA.CATPart]
2018-10-09 Suspension arrière
    [15x1.5.CATProduct, 20x1.5.CATProduct, Filaire Optimus.CATPart, Shape_551.CATPart, Shape_552.CATPart, Shape_553.CATPart, Shape_554.CATPart, Shape_555.CATPart]
2018-10-09 modif Las auto 3
    [LAS_auto.xls]
2018-10-09 Travail sur tubulaire
    [20x1.5.CATProduct, 25x1.5.CATProduct, Shape_476.CATPart, Shape_481.CATPart, Shape_489.CATPart, Shape_491.CATPart, Shape_500.CATPart, Shape_502.CATPart]
2018-10-09 Importation portes excentriques
    [EN-09002 (Left).CATPart, EN_09003 (Right).CATPart]
2018-10-09 Update roue avant remarque brice + direction
    [Front Upright Working Assy.CATProduct, SU_10001 (Front Left Upright).CATPart, SU_10002 (Front Upper Arm Bracket).CATPart, SU_10003 (Front Upper Arm Wedge).CATPart, SU_A1000 (Front Left Wheel Assy).CATProduct]
2018-10-09 fichier igs test Ansys
    [tubulaireOptimusTest.igs]
2018-10-09 front susp
    [architecture 3.3.CATProduct]
2018-10-10 modif las auto : biellette de pince
    [LAS_auto.xls]
2018-10-10 Afficheur rapport maj
    [rapport.brd, rapport.sch]
2018-10-10 modif basculeur & las auto
    [LAS_auto.xls, architecture 3.3.CATProduct, basculeur 3.CATPart]
2018-10-10 Commande embrayage
    [FR_0500_1_AB.CATPart, FR_0500_2_AB.CATPart, FR_0500_3_AA.CATPart, FR_0500_4_AA.CATProduct, FR_0500_5_AA.CATPart, FR_A0500.CATProduct, Shape_023.CATPart]
2018-10-10 Assemblage final essai rotule?
    assemblage complet
    [Assemblage final 2.0.CATProduct]
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2018-10-10 Avancé support batterie
    [EL_A0300_001_AA (battery support).CATPart, EL_A0300_002_AA (battery).CATPart]
2018-10-10 Travail guillotine/bride
    [EN_0400_001_AA_bas_guillotine.CATPart, EN_0400_002_AB_milieu_guillotine.CATPart, EN_0400_003_AA_arret_guillotine.CATPart, EN_0400_004_AB_guillotine.CATPart, EN_0400_005_AA_haut_guillotine.CATPart, EN_0400_006_AA_gaine.CATPart, EN_0400_007_AA_convergeant.CATPart, EN_0400_008_AA_filtre_a_air.CATPart]
2018-10-10 MAJ maquette (pb baquet / chassis electrical...)
    [Aero.CATProduct, Engine & Powertrain.CATProduct, Frame & Body.CATProduct, Optimus.CATProduct, Steering.CATProduct, Suspension.CATProduct, ZZ.CATProduct]
2018-10-10 Shield passage de vitesse
    [shield passage vitesse.brd, shield passage vitesse.sch]
2018-10-10 rear upright assy
    brake caliper, rear left upright, differential link, rear wedge, rear speed sensor (vulcanix). positioning into assembly
    [D4483.CATPart, Front Upright Working Assy.CATProduct, Rear Upright Working Assy.CATProduct, SU_10001 (Front Left Upright).CATPart, SU_10002 (Front Upper Arm Bracket).CATPart, SU_11001 (Rear Left Upright).CATPart, SU_11002 (Rear Upper Arm Wedge).CATPart, SU_A1000 (Front Left Wheel Assy).CATProduct]
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2018-10-10 Nomenclature et liste des composants
    [EL_0400_001_AA.CATPart, EL_0400_001_AA_save1.CATPart, EL_0400_001_AA_save2.CATPart]
2018-10-10 ajout d'autres architectures de commande embrayage
    [FR_0500_1_BB.CATPart, FR_0500_1_CA.CATPart, FR_0500_2_BB.CATPart, FR_0500_2_CA.CATPart, FR_0500_3_BA.CATPart, FR_0500_3_CA.CATPart, FR_0500_4_AB.CATProduct, FR_0500_4_BB.CATProduct]
2018-10-10 modifs embrayage
    [FR_0500_1_AB.CATPart, FR_0500_2_AB.CATPart, FR_0500_3_AA.CATPart, FR_0500_4_AA.CATProduct, FR_A0500.CATProduct, Shape_023.CATPart]
2018-10-10 Update suspension assy
    [Front Upright Working Assy.CATProduct, Front_Lower_A_Arm_Front_Rod.CATPart, Front_Lower_A_Arm_Rear_Rod.CATPart, Front_Push_Rod.CATPart, Front_Rocker.CATPart, Front_Upper_A_Arm_Front_Rod.CATPart, Front_Upper_A_Arm_Rear_Rod.CATPart, Left_Wireframe_Front_Lower_Arm.CATPart]
2018-10-10 plein de choses
    [Cablage Optimus.xlsx, rapport.brd, rapport.sch]
2018-10-11 Pilote trop serré !
    [ISO_4762_M8x20_STEEL_HEXAGON_SOCKET_HEAD_CAP_SCREW.CATPart, Optimus.CATProduct, ZZ.CATProduct, pilote.CATProduct]
2018-10-11 problème electrical
    [Electrical.CATProduct, Optimus.CATProduct]
2018-10-11 Modif guillotine
    [Bride_guillotine_FLUENT.CATPart, EN_0400_002_AB_milieu_guillotine.CATPart, EN_0400_004_AB_guillotine.CATPart, EN_0400_005_AA_haut_guillotine.CATPart, EN_0400_007_AA_convergeant.CATPart, EN_0400_013_AA_entretoise3mm.CATPart, EN_A0400_Throttle_mecanism.CATProduct]
2018-10-11 Montage diff assembly
    [400-040-0096-00 Quadring3,68.CATPart, 6010.CATProduct, DRX00001546.CATPart, DRX00002066.CATPart, DRX00002229.CATPart, DRX00002277.CATPart, DRX00002471.CATPart, DRX00002474.CATPart]
2018-10-11 Mise en place de Diff assembly dans Powertrain
    [EN_A0100 (Engine Assy).CATProduct, EN_A0200.CATProduct, EN_A0900.CATProduct, Engine & Powertrain.CATProduct]
2018-10-11 petit soucis
    [Cablage Optimus.xlsx, rapport.brd, rapport.sch]
2018-10-11 recentrage push rod et susp
    [Front Upright Working Assy.CATProduct, Front_Lower_A_Arm_Front_Rod.CATPart, Front_Lower_A_Arm_Rear_Rod.CATPart, Front_Push_Rod.CATPart, Front_Rocker.CATPart, Front_Upper_A_Arm_Front_Rod.CATPart, Front_Upper_A_Arm_Rear_Rod.CATPart, LAS_auto.xls]
2018-10-12 Pièces assemblage essai rotule
    [Assemblage final 2.0.CATProduct, Assemblage_blocage_rotule.CATProduct, Piece_bloc_blocage_rotule.CATPart, Piece_taraude_essaitraction_chanfreins.CATPart, entretoise_rotule.CATPart, entretoise_vis.CATPart, plaque_blocage_rotule.CATPart, support (2).CATPart]
2018-10-12 Assemblage Rotules collage
    [Assemblage final 2.0.CATProduct, Assemblage final.CATProduct, Assemblage_blocage_rotule.CATProduct, GE_6_E_ir.CATPart, Piece_bloc_blocage_rotule.CATPart, Piece_taraude_essaitraction_chanfreins.CATPart, assemblage_collage_rotules.CATProduct, entretoise_rotule.CATPart]
2018-10-12 carte afficheur rapport et commandes
    [Commandes.xlsx, rapport.brd, rapport.sch]
2018-10-12 test sublime merge
    [rapport.brd, rapport.sch]
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2018-10-13 connecteurs Vulcanix et préparation shield carte avant
    [Schiel_CA.sch, rapport.brd]
2018-10-13 rear upright
    [Rear Upright Working Assy.CATProduct, SU_11001 (Rear Left Upright).CATPart, SU_A1100 (Rear Left Wheel Assy).CATProduct]
2018-10-13 Insert triangles PM avant bas
    [GE_8_E.CATProduct, GE_8_E_dummy.CATPart, SU_02001.CATPart, SU_A0200.CATProduct]
2018-10-13 Yolo ?
    [BR_0200_001 (Break Disc).CATPart, D4483.CATPart, Etrier_beringer_arr_Olympix.CATPart, Left_Wireframe_Rear_Upright.CATPart, Rear Upright Working Assy.CATProduct, SU_10002 (Front Upper Arm Bracket).CATPart, SU_11001 (Rear Left Upright).CATPart, SU_11002 (Rear Upper Arm Wedge).CATPart]
2018-10-13 MEP insert essai
    [GE_8_C.CATProduct, GE_8_Cblr_001_101_spb_ge1.CATPart, GE_8_Cblr_001_101_spb_ge2.CATPart, assemblage_traction.CATProduct, entretoise.CATPart, insert_manchon.CATPart, inserts.CATPart, support.CATPart]
2018-10-13 Lourdes MEP
    [assemblage_traction.CATProduct, insert_manchon.CATPart]
2018-10-13 Insert PM maj
    [SU_02001.CATPart, SU_A0200.CATProduct]
2018-10-13 Avancée roue arrière
    [Comparaison gain de poids Vulcanix.xlsx, Rear Upright Working Assy.CATProduct, SU_11001 (Rear Left Upright).CATPart, SU_A1100 (Rear Left Wheel Assy).CATProduct, WT_0100_001 (Oz Magnesium Rim).CATPart, WT_A0100 (Wheel Assy).CATProduct]
2018-10-13 MEP finish
    [inserts_25mm.CATPart]
2018-10-13 Update position frein retour Brice
    [SU_11001 (Rear Left Upright).CATPart, SU_A1100 (Rear Left Wheel Assy).CATProduct]
2018-10-13 Rods avec publis
    [Front_Lower_A_Arm_Front_Rod.CATPart, Front_Lower_A_Arm_Rear_Rod.CATPart, Front_Push_Rod.CATPart, Front_Upper_A_Arm_Front_Rod.CATPart, Front_Upper_A_Arm_Rear_Rod.CATPart, Rear_Lower_A_Arm_Front_Rod.CATPart, Rear_Lower_A_Arm_Rear_Rod.CATPart, Rear_Push_Rod.CATPart]
2018-10-13 Règlages biellettes
    [Assemblage_partie_cales.CATProduct, Bearing support adjustable.CATPart, GE_8_E.CATProduct, GE_8_E_ir.CATPart, Rod insert adjustable.CATPart, cales.CATPart, emile_maurin_231004X20.catpart]
2018-10-14 Ajout Volant et Chapes Crémaillère
    [Bracket_Assy.CATProduct, CIRCLIP M30.CATPart, Filaire Optimus.CATPart, M6x60.CATPart, Proshift.CATPart, QR Shaft.CATPart, ST_0100_001 (Rack).CATPart, ST_0100_002 (Brackets).CATPart]
2018-10-14 essais BSPD
    [BSPD.sch, Encore_un_test.sch, exemple.sch]
2018-10-15 Modif pièces essai rotule
    [entretoise_rotule.CATPart, trou_rotule.CATPart]
2018-10-15 Tie rod
    [Assemblage_partie_cales.CATProduct, Bearing support adjustable.CATPart, Carbon tube.CATPart, SU_A0900.CATProduct, Toe_Link.CATPart]
2018-10-15 Modif assemblage essai rotule
    [Assemblage final 2.0.CATProduct, entretoise_rotule.CATPart, trou_rotule.CATPart]
2018-10-15 modif placement chape / nouvelle config triangle lotus / comparaison config excel
    [ARB.CATProduct, COMPARAISON Config 1.1 et 1.2.xlsx, Ohlins_variable.CATProduct, architecture 3.3.CATProduct]
2018-10-15 mise à jour support TbD
    changement des boutons utilisées
    [Bouton poussoir Raz motored.CATPart, Bouton poussoir demarrage.CATPart, Bouton poussoir.CATPart, EL_0400_001_AA.CATPart, EL_0400_001_AA_save3.CATPart, Liste des composants du tableau de bords [romain] v2.ods, afficheur Temp.CATPart, afficheur rapport.CATPart]
2018-10-15 Maj susp assy
    [LAS_auto.xls, SU_A0200.CATProduct, Suspension.CATProduct, Suspension_Frame_points.CATPart, Suspension_Wireframe.CATProduct, gain_masse_top_synthese_steering.xlsx]
2018-10-15 maj LAS auto
    [Front Upright Working Assy.CATProduct, Front_Lower_A_Arm_Front_Rod.CATPart, Front_Lower_A_Arm_Rear_Rod.CATPart, Front_Push_Rod.CATPart, Front_Rocker.CATPart, Front_Upper_A_Arm_Front_Rod.CATPart, Front_Upper_A_Arm_Rear_Rod.CATPart, LAS_auto.xls]
2018-10-15 Gain masse triangles
    [gain_masse_Triangles.xlsx]
2018-10-15 maj LAS auto sans collision
    [Front_Lower_A_Arm_Front_Rod.CATPart, Front_Lower_A_Arm_Rear_Rod.CATPart, Front_Push_Rod.CATPart, Front_Rocker.CATPart, Front_Upper_A_Arm_Front_Rod.CATPart, Front_Upper_A_Arm_Rear_Rod.CATPart, LAS_auto.xls, Left_Wireframe_Front_Lower_Arm.CATPart]
2018-10-15 Ajout colonne de direction et 1er placement volant
    [Cardan A.CATPart, Cardan noeud.CATPart, Cardan.CATProduct, Spline_coupler.CATPart, Steering.CATProduct, Steering_Colum_Assy.CATProduct, Steering_Column.CATPart]
2018-10-15 Modif placement volant
    [Cardan.CATProduct, Steering.CATProduct]
2018-10-16 mise en place radiateurs
    [EN_0800_01_Radiator.CATPart, EN_A0800_Cooling_System.CATProduct]
2018-10-16 Réduction espace arrière moteur et MAJ sur tubulaire
    [15x1.5.CATProduct, 20x1.5.CATProduct, 25x1.5.CATProduct, 30x1.5.CATProduct, EN_A0100 (Engine Assy).CATProduct, EN_A0200.CATProduct, Engine & Powertrain.CATProduct, Filaire Optimus.CATPart]
2018-10-16 Ajustement position Differential Assembly
    [Engine & Powertrain.CATProduct]
2018-10-16 0A maros
    [EN_A0800_Cooling_System.CATProduct]
2018-10-16 adapt suspension
    [FR_07001.CATPart]
2018-10-16 Modification Guillotine
    [EN_0400_001_AA_bas_guillotine.CATPart, EN_0400_002_AB_milieu_guillotine.CATPart, EN_0400_003_AA_arret_guillotine.CATPart, EN_0400_004_AB_guillotine.CATPart, EN_0400_005_AA_haut_guillotine.CATPart, EN_0400_010_AA_bride.CATPart, EN_A0400_Throttle_mecanism.CATProduct, EN_A0401_Guillotine.CATProduct]
2018-10-16 Optimisation tube bas hoops
    [15x1.5.CATProduct, 20x1.5.CATProduct, 25x1.5.CATProduct, 30x1.5.CATProduct, 30x2.CATProduct, Filaire Optimus.CATPart, Shape_434.CATPart, Shape_435.CATPart]
2018-10-16 Optimisation tube cellule arrière et suspension
    [15x1.5.CATProduct, 20x1.5.CATProduct, 25x1.5.CATProduct, Shape_470.CATPart, Shape_474.CATPart, Shape_493.CATPart, Shape_497.CATPart, Shape_498.CATPart]
2018-10-16 Chai pa
    [CIRCLIP M30.CATPart, QR Shaft.CATPart, ST_A0700_STEERING SHAFT PIVOT.CATProduct, SU_07002_STEERING BORE.CATPart, W_61806.CATProduct]
2018-10-16 Maj LAS / basculeur décalé
    [Front Upright Working Assy.CATProduct, Front_Lower_A_Arm_Front_Rod.CATPart, Front_Lower_A_Arm_Rear_Rod.CATPart, Front_Push_Rod.CATPart, Front_Rocker.CATPart, Front_Upper_A_Arm_Front_Rod.CATPart, Front_Upper_A_Arm_Rear_Rod.CATPart, LAS_auto.xls]
2018-10-16 Biellette chgt
    [Assemblage_partie_cales.CATProduct, Bearing support adjustable.CATPart, SU_A0900.CATProduct]
2018-10-16 couleur pour la chiasse
    [Front_Lower_A_Arm_Front_Rod.CATPart, Front_Lower_A_Arm_Rear_Rod.CATPart, Suspension.CATProduct]
2018-10-16 Importation porte couronne
    [EN_11001.CATPart]
2018-10-16 Ajout arb rocker las auto
    [LAS_auto.xls, Rocker_Gen.CATPart]
2018-10-16 modif basculeur pour test
    [architecture 3.3.CATProduct, basculeur 3.CATPart]
2018-10-16 cooling system dans powertrain
    [EN_A0800_Cooling_System.CATProduct, Engine & Powertrain.CATProduct]
2018-10-17 Modif excel LAS auto/ ajout de config pour motion ratio
    [LAS_auto.xls]
2018-10-17 Maj LAS avec basculeur
    [Front Upright Working Assy.CATProduct, Front_Lower_A_Arm_Front_Rod.CATPart, Front_Lower_A_Arm_Rear_Rod.CATPart, Front_Push_Rod.CATPart, Front_Rocker.CATPart, Front_Upper_A_Arm_Front_Rod.CATPart, Front_Upper_A_Arm_Rear_Rod.CATPart, LAS_auto.xls]
2018-10-17 las auto maj
    [Front Upright Working Assy.CATProduct, Front_Lower_A_Arm_Front_Rod.CATPart, Front_Lower_A_Arm_Rear_Rod.CATPart, Front_Push_Rod.CATPart, Front_Rocker.CATPart, Front_Upper_A_Arm_Front_Rod.CATPart, Front_Upper_A_Arm_Rear_Rod.CATPart, LAS_auto.xls]
2018-10-17 liste de composants tableau de bords
    [Liste des composants du tableau de bords (romain) v2.ods]
2018-10-17 tests architectures disques de frein
    [Disque_architecture2.CATPart, Disque_architecture2_parametres.xls, Disque_architecture3.CATPart, Disque_architecture3_parametres.xls, Disque_architecture4.CATPart, Disque_architecture5.CATPart, Disque_architecture6.CATPart, disqueD.CATPart]
2018-10-17 ebauche echappement
    [Assemblage_tube.CATProduct, coude_1.CATPart, coude_2.CATPart, coude_3.CATPart, tube_fin.CATPart]
2018-10-17 Modifs assemblage essai rotule
    modif de la plupart des pièces
    [Assemblage final 2.0.CATProduct, Piece_bloc_blocage_rotule.CATPart, Piece_taraude_essaitraction_chanfreins.CATPart, entretoise_rotule.CATPart, entretoise_vis.CATPart, plaque_blocage_rotule.CATPart, support (2).CATPart, trou_rotule.CATPart]
2018-10-17 Oublis modifs essai rotule
    [Assemblage final 2.0.CATProduct, plaque_rotule_2.CATPart]
2018-10-17 création fichier pour chapes
    [SU_13009_ARB END PLATE.CATPart]
2018-10-17 Maquette catia Tbd
    [EL_0400_001_AA.CATPart, EL_0400_003_AA.CATPart, EL_0400_004_AA.CATPart, EL_0400_005_AA.CATPart, EL_0400_006_AA.CATPart, EL_A0400_AA.CATProduct, bouton d'arret d'urgence.CATPart]
2018-10-17 Réglage problème Differential assembly
    [EN_0900_005_AA (Excentrique Droit).CATPart, EN_0901_001_AA (Drexler v2).CATProduct, EN_A0900.CATProduct]
2018-10-17 Push bar
    [SQU30x2.CATPart, Shape_01.CATPart, Shape_02.CATPart, Shape_03.CATPart, Shape_04.CATPart, Shape_05.CATPart, Shape_06.CATPart, Shape_07.CATPart]
2018-10-17 Carte Passage vitesse
    [shield passage vitesse.brd]
2018-10-17 symétrie échappement
    [EN_0200_009_AA.CATPart, EN_A0201 (symetrie).CATProduct]
2018-10-18 Début gueules de loup
    [30x1.5.CATProduct, Shape_429.CATPart, Shape_430.CATPart, Shape_431.CATPart, Shape_432.CATPart, Shape_433.CATPart, Tubes.CATProduct, Tubulaire Optimus.CATProduct]
2018-10-18 Suppression tubes carrés arrière + amélioration paramétrage filaire
    [25x1.5.CATProduct, 30x1.5.CATProduct, Filaire Optimus.CATPart, Shape_550.CATPart, Shape_564.CATPart, Shape_595.CATPart, Shape_596.CATPart, Tubes.CATProduct]
2018-10-18 Insert sup avant
    [SU_A01001.CATProduct, Upper front bearing support.CATPart]
2018-10-18 Fin amélioration paramétrage, avancée points LAS arrière et MAJ tubulaire
    [15x1.5.CATProduct, 20x1.5.CATProduct, 25x1.5.CATProduct, 30x1.5.CATProduct, 30x2.CATProduct, Filaire Optimus.CATPart, Shape_436.CATPart, Shape_437.CATPart]
2018-10-18 Importation modélisation MECA Master non finie <3
    [CIR.CATPart, CIR_roue.CATPart, COMPARAISON Config 1.1 et 1.2.xlsx, Front_Lower_A_Arm_Front_Rod.CATPart, Front_Lower_A_Arm_Rear_Rod.CATPart, Front_Push_Rod.CATPart, Front_Rocker.CATPart, Front_Upper_A_Arm_Front_Rod.CATPart]
2018-10-18 problème
    [Left_Wireframe_Rear_Wheel.CATPart]
2018-10-18 Suspension à jour
    [Front Upright Working Assy.CATProduct, Front_Lower_A_Arm_Front_Rod.CATPart, Front_Lower_A_Arm_Rear_Rod.CATPart, Front_Push_Rod.CATPart, Front_Rocker.CATPart, Front_Upper_A_Arm_Front_Rod.CATPart, Front_Upper_A_Arm_Rear_Rod.CATPart, Left_Wireframe_Front_Lower_Arm.CATPart]
2018-10-18 mise a jour excel
    [Front_Lower_A_Arm_Front_Rod.CATPart, Front_Lower_A_Arm_Rear_Rod.CATPart, Front_Push_Rod.CATPart, Front_Rocker.CATPart, Front_Upper_A_Arm_Front_Rod.CATPart, Front_Upper_A_Arm_Rear_Rod.CATPart, LAS_auto.xls, Left_Wireframe_Front_Lower_Arm.CATPart]
2018-10-19 LAS à jour
    [Front Upright Working Assy.CATProduct, Front_Lower_A_Arm_Front_Rod.CATPart, Front_Lower_A_Arm_Rear_Rod.CATPart, Front_Push_Rod.CATPart, Front_Rocker.CATPart, Front_Upper_A_Arm_Front_Rod.CATPart, Front_Upper_A_Arm_Rear_Rod.CATPart, Left_Wireframe_Front_Lower_Arm.CATPart]
2018-10-19 Ajout macro visserie
    [10x100.CATPart, 10x100CHC.CATPart, 10x20.CATPart, 10x20CHC.CATPart, 10x25.CATPart, 10x25CHC.CATPart, 10x30.CATPart, 10x30CHC.CATPart]
2018-10-19 Modif insert + ajout sur susp
    [SU_A01001.CATProduct, Suspension.CATProduct, Suspension_Wireframe.CATProduct, Upper front bearing support.CATPart]
2018-10-19 Ajouts symmétrie + vérif collisions
    [SU_A1000 (Front Left Wheel Assy).CATProduct, Suspension.CATProduct, Suspension_Wireframe.CATProduct, Symmetry of BR_0100_001_MM (Brake Caliper).CATPart, Symmetry of BR_0200_001 (Break Disc).CATPart, Symmetry of Brake Bell.CATPart, Symmetry of Front Left Wheel.CATProduct, Symmetry of Front Upright Working Assy.CATProduct]
2018-10-19 Modif pièces essais + maj mep
    [entretoise.CATPart, inserts_25mm.CATPart]
2018-10-19 Insert arrière bas
    [Lower rear bearing support.CATPart, SU_02001.CATPart, SU_A0400.CATProduct, Suspension.CATProduct, Suspension_Wireframe.CATProduct, Symmetry of Front upper A-Arms.CATProduct, Symmetry of Upper front bearing support.CATPart]
2018-10-19 Avance TBD et rendu rapide
    [EL_0400_001_AA.CATPart, EL_0400_002_AA.CATPart, EL_0400_007_AA.CATPart, EL_0400_008_AA.CATPart, EL_0400_009_AA.CATPart, EL_A0400_AA.CATProduct]
2018-10-19 Adaptation macro vis
    [10x100.CATPart, 10x100CHC.CATPart, 10x20.CATPart, 10x20CHC.CATPart, 10x25.CATPart, 10x25CHC.CATPart, 10x30.CATPart, 10x30CHC.CATPart]
2018-10-19 Test secret de visserie
    [part de test.CATPart, product de test.CATProduct]
2018-10-19 Maj steering + Excel LAS auto et Brice fait encore du sale avec des vis
    [Bracket_Assy.CATProduct, Cardan.CATProduct, LAS_auto.xls, LAS_auto_save_GTE.xls, M6x50.CATPart, M6x60.CATPart, ST_0100_002 (Brackets).CATPart, ST_0100_003 (Half Moon Low).CATPart]
2018-10-20 mise a jour las auto
    [Front_Lower_A_Arm_Front_Rod.CATPart, Front_Lower_A_Arm_Rear_Rod.CATPart, Front_Push_Rod.CATPart, Front_Rocker.CATPart, Front_Upper_A_Arm_Front_Rod.CATPart, Front_Upper_A_Arm_Rear_Rod.CATPart, LAS_auto.xls, Left_Wireframe_Front_Lower_Arm.CATPart]
2018-10-20 Las auto vraiment à jour
    [Front_Lower_A_Arm_Front_Rod.CATPart, Front_Lower_A_Arm_Rear_Rod.CATPart, Front_Push_Rod.CATPart, Front_Rocker.CATPart, Front_Upper_A_Arm_Front_Rod.CATPart, Front_Upper_A_Arm_Rear_Rod.CATPart, Left_Wireframe_Front_Lower_Arm.CATPart, Left_Wireframe_Front_Upper_Arm.CATPart]
2018-10-20 MAJ Optimus
    [Aero.CATProduct, Cardan.CATProduct, EN_A0800_Cooling_System.CATProduct, Electrical.CATProduct, Engine & Powertrain.CATProduct, Frame & Body.CATProduct, Front Upright Working Assy.CATProduct, Lower rear bearing support.CATPart]
2018-10-20 Visserie magique <3
    [Front Upright Working Assy.CATProduct, SU_10001 (Front Left Upright).CATPart, SU_10002 (Front Upper Arm Bracket).CATPart, SU_10003 (Front Upper Arm Wedge).CATPart, SU_A1000 (Front Left Wheel Assy).CATProduct]
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2018-10-20 Modif essai traction suite retour APU
    [insert_manchon.CATPart, inserts.CATPart, inserts_25mm.CATPart]
2018-10-20 Maj insert PM avant sup
    [Upper front bearing support.CATPart]
2018-10-20 Visserie et chappe sup
    [Front Upright Working Assy.CATProduct, SU_10001 (Front Left Upright).CATPart, SU_10002 (Front Upper Arm Bracket).CATPart, SU_10003 (Front Upper Arm Wedge).CATPart, SU_A1000 (Front Left Wheel Assy).CATProduct]
2018-10-20 création product et modif filaire pour rear susp
    [Filaire Optimus.CATPart, architecture 0.1.CATProduct]
2018-10-20 Chambrage PM et Brice le Chef !
    [Front Upright Working Assy.CATProduct, SU_10001 (Front Left Upright).CATPart, SU_A1000 (Front Left Wheel Assy).CATProduct]
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2018-10-20 Reprise assemblage roue arrière
    [Rear Upright Working Assy.CATProduct, SU_11001 (Rear Left Upright).CATPart, SU_11002 (Rear Upper Arm Wedge).CATPart, SU_A1100 (Rear Left Wheel Assy).CATProduct, WT_03001 (Rear Hub).CATPart, WT_03004 (Tripod Housing Spacer).CATPart, WT_0300_001 (Rear Hub).CATPart, WT_0300_003 (TO_FIX Front Hub).CATPart]
2018-10-20 Ajout roue arrière sur susp assy
    [15x1.5.CATProduct, 20x1.5.CATProduct, SU_11002 (Rear Upper Arm Wedge).CATPart, SU_A1000 (Front Left Wheel Assy).CATProduct, SU_A1100 (Rear Left Wheel Assy).CATProduct, Shape_551.CATPart, Shape_554.CATPart, Shape_555.CATPart]
2018-10-20 debut architecture arrière
    [15x1.5.CATProduct, 20x1.5.CATProduct, Ohlins_variable.CATProduct, Rear_Rocker.CATPart, Shape_551.CATPart, Shape_554.CATPart, Shape_555.CATPart, Shape_573.CATPart]
2018-10-20 Toujours plus de vis
    [SU_A1000 (Front Left Wheel Assy).CATProduct, SU_A1100 (Rear Left Wheel Assy).CATProduct, Suspension.CATProduct, Suspension_Wireframe.CATProduct, WT_03001 (Rear Hub).CATPart]
2018-10-20 Je sais plus
    [Rear Upright Working Assy.CATProduct, SU_10002 (Front Upper Arm Bracket).CATPart, SU_11001 (Rear Left Upright).CATPart, SU_A1100 (Rear Left Wheel Assy).CATProduct]
2018-10-20 Maj direction et modif gorge circlip
    [Cardan A.CATPart, Cardan noeud.CATPart, Cardan.CATProduct, ST_0100_001 (Rack).CATPart, ST_07001_STEERING UPPER SHAFT.CATPart, ST_A0700 (Steering Shaft Pivot).CATProduct, ST_A0700_STEERING SHAFT PIVOT.CATProduct, SU_07004_BEARING SPACER.CATPart]
2018-10-20 Position volant
    [Ergonomics.CATProduct, Steering_Wheel.CATPart]
2018-10-20 orga dossier SU
    [CIR.CATPart, CIR_roue.CATPart, COMPARAISON Config 1.1 et 1.2.xlsx, Damper_ZF.CATProduct, Front_Lower_A_Arm_Front_Rod.CATPart, Front_Lower_A_Arm_Rear_Rod.CATPart, Front_Push_Rod.CATPart, Front_Rocker.CATPart]
2018-10-21 Mises en plan essais collage
    + modif sur une pièce
    [Piece_taraude_essaitraction_chanfreins.CATPart]
2018-10-21 Avancement TdB
    [EL_0400_001_AA.CATPart, EL_0400_001_AB.CATPart, EL_0400_009_AA.CATPart, EL_A0400_AA.CATProduct, EL_A0400_AB.CATProduct]
2018-10-21 Petite modif
    [SU_11001 (Rear Left Upright).CATPart, SU_A1100 (Rear Left Wheel Assy).CATProduct]
2018-10-21 Modif essais collage
    [Assemblage final 2.0.CATProduct]
2018-10-21 chgt insert
    [Insert_Frame_Side.CATPart, insert_frame_side.CATProduct, inserts_25mm.CATPart]
2018-10-21 Modifications commandes d'embrayage
    [FR_0500_1_AB.CATPart, FR_0500_1_BB.CATPart, FR_0500_1_CA.CATPart, FR_0500_2_AB.CATPart, FR_0500_2_BB.CATPart, FR_0500_2_CA.CATPart, FR_A0500_1 (version poignee - A_).CATProduct, FR_A0500_2 (version levier - B_).CATProduct]
2018-10-21 Travail sur l'échappement
    [EN_0200_032_AA.CATProduct, EN_0200_033_AA.CATProduct, EN_0200_034_AA.CATProduct, EN_0200_051_AA.CATProduct, EN_0200_052_AA.CATProduct, EN_A0200.CATProduct, ech23.1.CATPart, ech4.3.CATPart]
2018-10-22 Modif Alpentech
    [SU_02001.CATPart]
2018-10-22 Modif assemblage rotule
    [Assemblage final 2.0.CATProduct, Piece_bloc_blocage_rotule.CATPart, Piece_taraude_essaitraction_chanfreins.CATPart, entretoise_rotule.CATPart, entretoise_vis.CATPart]
2018-10-22 Préparation points éléments finis
    [SU_10001 (Front Left Upright).CATPart]
2018-10-22 MAJ Las auto pour FEA
    [Front Upright Working Assy.CATProduct, LAS_auto.xls, Left_Wireframe_Front_Upright.CATPart, Left_Wireframe_Rear_Upright.CATPart, SU_A1000 (Front Left Wheel Assy).CATProduct, Wireframe_Front_Upright.CATPart, Wireframe_Rear_Upright.CATPart, Wireframe_Upright.CATPart]
2018-10-22 Modèle prêt
    [Front Upright Working Assy.CATProduct, LAS_auto.xls, SU_10001 (Front Left Upright).CATPart, SU_10002 (Front Upper Arm Bracket).CATPart, SU_10003 (Front Upper Arm Wedge).CATPart, SU_A1000 (Front Left Wheel Assy).CATProduct]
2018-10-23 Modif plans + ajout entretoise presse
    [entretoise_presse_bague_ext_M6.CATPart]
2018-10-23 modif frame
    [Filaire Optimus.CATPart]
2018-10-23 modif frame et tubulaire pour susp arrière
    [15x1.5.CATProduct, 20x1.5.CATProduct, Filaire Optimus.CATPart, Shape_551.CATPart, Shape_554.CATPart, Shape_573.CATPart, Shape_574.CATPart, Shape_597.CATPart]
2018-10-23 erreur tubes
    [Shape_597.CATPart, Shape_598.CATPart]
2018-10-23 Moteur et Différentiel pour test suspension arrière PA
    [EN_A0100 (Engine Assy).CATProduct, architecture 0.1.CATProduct]
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2018-10-23 pièces brouillons pour architecture arrière
    [ARB.CATPart, chape_arriere.CATPart]
2018-10-23 Porte couronne M-Pinay
    [EN_11001.CATPart]
2018-10-23 suppression fichier
    [Rear_Rocker.CATPart]
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2018-10-23 Pour PA
    [EN_1100_001_AA.CATPart, EN_1100_002_AA.CATPart, EN_1100_005 le vrai.CATPart, EN_A0100 (Engine Assy).CATProduct, EN_A0900.CATProduct, Ohlins_variable.CATProduct, architecture 0.1.CATProduct]
2018-10-23 avancement architecture arrière avec modif chassis
    [EN_A0100 (Engine Assy).CATProduct, EN_A0900.CATProduct, architecture 0.1.CATProduct]
2018-10-23 et hop je dépasse benji
    [BSPD.brd, BSPD.sch]
2018-10-23 Envoi MEP boisard + igs
    [19B_TRACTION_01 (insert alu).igs, 19B_TRACTION_02 (insert alu manchon).igs, 19B_TRACTION_03 (entretoise).igs, 19B_TRACTION_04 (insert alu type 2).igs, EntretoiseRotule.igs, EntretoiseVis.igs, PieceBlocMaintienPlaque.igs, PieceBlocMaintienVisRotule.igs]
2018-10-23 susp arrière
    [EN_A0100 (Engine Assy).CATProduct, EN_A0900.CATProduct, architecture 0.1.CATProduct, rear rocker.CATPart]
2018-10-23 Modif brake side
    [SU_10001 (Front Left Upright).CATPart]
2018-10-23 Plans essai frette
    [ESSAI_FRETTE (Frette frein avant aluminium).igs, WT_0200_007 (Front Brake Hub).CATPart]
2018-10-23 Modifs FEA
    [SU_10001 (Front Left Upright).CATPart]
2018-10-23 Parce que
    [SU_10001 (Front Left Upright).CATPart, SU_10003 (Front Upper Arm Wedge).CATPart, assemblage test.CATProduct]
2018-10-24 shield carte avant
    [Commandes.xlsx, Schiel_CA.sch]
2018-10-24 réparation erreur
    [Rear_ARB.CATProduct]
2018-10-24 SUSP arrière modif
    [EN_A0100 (Engine Assy).CATProduct, EN_A0900.CATProduct, Rear_ARB.CATProduct, Rear_ARB_Rod.CATPart, SU_13009_ARB END PLATE FRONT.CATPart, SU_13009_ARB END PLATE REAR.CATPart, SU_13009_ARB END PLATE.CATPart, architecture 0.1.CATProduct]
2018-10-24 Ajout pompe à essence, régulateur de pression et rampe d'injection - Fuel System
    [Chape_pompe_chassis.CATPart, EN_0500_001_BA.CATPart, EN_0500_002.CATProduct, EN_0500_003.CATProduct, chape regulateur de pression2.CATPart, chape_pompe_essence.CATPart, ecrou_nilstop_M6.CATPart, ecrou_nilstop_M6_1.CATPart]
2018-10-24 Correction erreur roulement enregistré en local - DSL Bro
    [EN_A0900.CATProduct]
2018-10-24 mise a jour las pour basculeur avant
    [Front Upright Working Assy.CATProduct, Front_Lower_A_Arm_Front_Rod.CATPart, Front_Lower_A_Arm_Rear_Rod.CATPart, Front_Push_Rod.CATPart, Front_Rocker.CATPart, Front_Upper_A_Arm_Front_Rod.CATPart, Front_Upper_A_Arm_Rear_Rod.CATPart, Insert_Frame_Side.CATPart]
2018-10-25 MODIF FRAME et modif assy rear susp
    [15x1.5.CATProduct, 20x1.5.CATProduct, EN_A0100 (Engine Assy).CATProduct, EN_A0900.CATProduct, Filaire Optimus.CATPart, Rear_ARB.CATProduct, Rear_ARB_Rod.CATPart, SU_13009_ARB END PLATE REAR.CATPart]
2018-10-25 afficheur température
    [rapport.brd, rapport.sch]
2018-10-25 MODIF LAS AUTO / attention problème à régler
    [Front_Lower_A_Arm_Front_Rod.CATPart, Front_Lower_A_Arm_Rear_Rod.CATPart, Front_Push_Rod.CATPart, Front_Rocker.CATPart, Front_Upper_A_Arm_Front_Rod.CATPart, Front_Upper_A_Arm_Rear_Rod.CATPart, LAS_auto.xls, Left_Wireframe_Front_Lower_Arm.CATPart]
2018-10-25 MISE A JOUR LAS mais reste un petit problème
    [Front Upright Working Assy.CATProduct, Front_Lower_A_Arm_Front_Rod.CATPart, Front_Lower_A_Arm_Rear_Rod.CATPart, Front_Push_Rod.CATPart, Front_Rocker.CATPart, Front_Upper_A_Arm_Front_Rod.CATPart, Front_Upper_A_Arm_Rear_Rod.CATPart, LAS_auto.xls]
2018-10-26 afficheur temp
    [rapport.brd, rapport.sch]
2018-10-27 dimensionnement TdB
    [EL_0400_001_BB.CATPart, EL_A0400_AC.CATProduct]
2018-10-27 mise à jour à l'avant et à l'arrière
    [Front Upright Working Assy.CATProduct, Front_Lower_A_Arm_Front_Rod.CATPart, Front_Lower_A_Arm_Rear_Rod.CATPart, Front_Push_Rod.CATPart, Front_Rocker.CATPart, Front_Upper_A_Arm_Front_Rod.CATPart, Front_Upper_A_Arm_Rear_Rod.CATPart, LAS_auto.xls]
2018-10-27 Chape suspension avant
    [Front Upright Working Assy.CATProduct, Lower rear bearing support.CATPart, Rear Upright Working Assy.CATProduct, SU_02001.CATPart, SU_0500_001 (Front suspension Brackets).CATPart, SU_0500_002 (Front suspension tube).CATPart, SU_10001 (Front Left Upright).CATPart, SU_10002 (Front Upper Arm Bracket).CATPart]
2018-10-27 M8 sur les dampers
    [SU_0500_001 (Front suspension Brackets).CATPart, SU_A1000 (Front Left Wheel Assy).CATProduct, SU_A1100 (Rear Left Wheel Assy).CATProduct, SU_A500 (Front Shock Bracket).CATProduct, Suspension.CATProduct]
2018-10-27 Ptit modif bug
    [GE_8_E_dummy.CATPart, GE_8_E_ir.CATPart, GE_8_E_or.CATPart, Insert Triangle cote chassis v1.1.CATPart, Lower rear bearing support.CATPart, SA_6_E.CATPart, SU_A1000 (Front Left Wheel Assy).CATProduct, SU_A1100 (Rear Left Wheel Assy).CATProduct]
2018-10-27 dimension tdb
    [EL_0400_001_BC.CATPart]
2018-10-27 Tableau de bord dimensions
    [EL_0400_001_BC.CATPart, EL_0400_001_BD.CATPart, EL_0400_009_AA.CATPart, EL_A0400_AC.CATProduct]
2018-10-27 insertion BAR arrière pour voir collision et calcul MR
    [Rear_ARB.CATProduct, SU_13009_ARB END PLATE REAR.CATPart, SU_A1000 (Front Left Wheel Assy).CATProduct, SU_A1100 (Rear Left Wheel Assy).CATProduct, Suspension.CATProduct, Suspension_Wireframe.CATProduct]
2018-10-28 MECAmaster Left-Rear Suspension c pa encor fini
    [MECAmaster - [Suspension_Wireframe].CATProduct, Suspension_Wireframe.CATProduct]
2018-10-28 Modification powertrain
    [EN_0300_004_AA_Jonction_moteur.CATPart, EN_0400_001_AA_bas_guillotine.CATPart, EN_0400_003_AA_arret_guillotine.CATPart, EN_0400_004_AB_guillotine.CATPart, EN_0400_005_AA_haut_guillotine.CATPart, EN_0400_010_AA_bride.CATPart, EN_A0100 (Engine Assy).CATProduct, EN_A0200.CATProduct]
2018-10-28 MECAmaster Left Front Suspension presque finie
    [MECAmaster - [Suspension_Wireframe].CATProduct, Suspension_Wireframe.CATProduct]
2018-10-28 MAJ powertrain
    [EN_A0300_Air_intake.CATProduct, Engine & Powertrain.CATProduct]
2018-10-28 MAJ Modélisation MECAmaster
    [Left_Wireframe_Front_Wheel.CATPart, Left_Wireframe_Rear_Wheel.CATPart, MECAmaster - [Suspension_Wireframe].CATProduct, Suspension_Wireframe.CATProduct, Wireframe_Front_Wheel.CATPart, Wireframe_Rear_Wheel.CATPart]
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2018-10-28 Afficheur 3 digit + plan carte tdb
    [rapport.brd]
2018-10-28 Modifications Admission
    [EN_0300_001_AA_Plenum.CATPart, EN_0300_002_AA_Fond_plat.CATPart, EN_0300_003_AA_Tubulures.CATPart, EN_0400_007_AA_convergeant.CATPart, EN_0400_010_AA_bride.CATPart, EN_A0100 (Engine Assy).CATProduct, EN_A0200.CATProduct, EN_A0300_Air_intake.CATProduct]
2018-10-29 symétrie du collecteur
    [EN_0200_007_AA.CATProduct, EN_0200_010_AA.CATPart, EN_0200_032_AA.CATProduct, EN_0200_033_AA.CATProduct, EN_0200_034_AA.CATProduct, EN_0200_051_AA.CATProduct, EN_A0200 - Symétrie.CATProduct, Symmetry of Exhaust Tip.CATPart]
2018-10-29 mise à jour las / motion ratio arrière / problème direction a voir
    [Front Upright Working Assy.CATProduct, Front_Lower_A_Arm_Front_Rod.CATPart, Front_Lower_A_Arm_Rear_Rod.CATPart, Front_Push_Rod.CATPart, Front_Rocker.CATPart, Front_Upper_A_Arm_Front_Rod.CATPart, Front_Upper_A_Arm_Rear_Rod.CATPart, LAS_auto.xls]
2018-10-31 modifs carrosserie
    [FR_07001.CATPart]
2018-10-31 Pos Diff Assy
    [Engine & Powertrain.CATProduct]
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2018-10-31 MAJ Cas de charges
    [Wireframe_Front_Wheel.CATPart]
2018-10-31 On a un CG !
    [Suspension_Frame_points.CATPart]
2018-10-31 Modif rayon congé
    [Insert_Frame_Side.CATPart, insert_frame_side.CATProduct, insert_manchon.CATPart, inserts.CATPart, inserts_25mm.CATPart]
2018-10-31 Plaques latterales et modifs
    [FR_07001.CATPart, FR_0700_002_BA.CATPart]
2018-10-31 bouton d'arret d'urgence
    [Commandes.xlsx]
2018-10-31 MAJ MM
    [MECAmaster - [Suspension_Wireframe].CATProduct, Suspension_Wireframe.CATProduct, insert_frame_side.CATProduct]
2018-10-31 Rangement CAS DE CHARGE car bordel
    [CIR.CATPart, CIR_roue.CATPart, COMPARAISON Config 1.1 et 1.2.xlsx, Cas de charges Optimus.xlsx, Front_Lower_A_Arm_Front_Rod.CATPart, Front_Lower_A_Arm_Rear_Rod.CATPart, Front_Push_Rod.CATPart, Front_Rocker.CATPart]
2018-10-31 Modif inserts
    [Lower rear bearing support.CATPart, SU_02001.CATPart, SU_A01001.CATProduct, SU_A0200.CATProduct, SU_A0400.CATProduct, Upper front bearing support.CATPart]
2018-10-31 MAJ Meca Master terminé pour auj
    [MECAmaster - [Suspension_Wireframe].CATProduct, Rear_Rocker.CATPart, Suspension_Frame_points.CATPart, Suspension_Wireframe.CATProduct]
2018-11-01 Nouveau Collecteur
    Nouveau collecteur : symétrique de l'ancien pour faire sortir l'échappement du côté voulu
    [EN_0200_001_AA.CATPart, EN_0200_001_AB.CATPart, EN_0200_002_AA.CATPart, EN_0200_002_AB.CATPart, EN_0200_003_AA.CATPart, EN_0200_003_AB.CATPart, EN_0200_004_AA.CATPart, EN_0200_004_AB.CATPart]
2018-11-01 MAJ position liaisons roulements
    [Wireframe_Front_Wheel.CATPart, Wireframe_Rear_Wheel.CATPart]
2018-11-01 Insert arr sup début
    [SU_A0300.CATProduct, Upper rear bearing support.CATPart]
2018-11-01 Modif insert av sup
    [SU_A01001.CATProduct, Upper front bearing support.CATPart]
2018-11-02 Modélisation ARB bien propre
    [MECAmaster - [Suspension_Wireframe].CATProduct, Rear_Rocker.CATPart, Suspension_Frame_points.CATPart, Suspension_Wireframe.CATProduct]
2018-11-03 Avancée points support moteur de 20mm (LAS)
    [15x1.5.CATProduct, 25x1.5.CATProduct, 30x1.5.CATProduct, Filaire Optimus.CATPart, Shape_452.CATPart, Shape_453.CATPart, Shape_454.CATPart, Shape_455.CATPart]
2018-11-03 Admission / guillotine
    [EN_0300_001_AA_Plenum.CATPart, EN_0300_005_AA_Trompette.CATPart, EN_0400_001_AA_bas_guillotine.CATPart, EN_0400_001_AA_bas_guillotine_analysis.CATPart, EN_0400_002_AB_milieu_guillotine.CATPart, EN_0400_003_AA_arret_guillotine.CATPart, EN_0400_004_AB_guillotine.CATPart, EN_0400_004_AB_guillotine_Analysis.CATPart]
2018-11-04 Ajout Catia interrupteur 40mm
    [EL_01006_AA (40mm switch).CATPart, EL_0100_001_AA (Regulator).CATPart, EL_0100_002_AA (Crash_sensor).CATPart, EL_0100_003__AA (Break_Light).CATPart, EL_0100_004_AA (ECU) .CATPart]
2018-11-04 Verif collisions + inserts
    [SU_02001.CATPart, SU_A01001.CATProduct, entretoise_upper_front_bearing_support.CATPart]
2018-11-04 Ces cas de charges me font chier
    [Cas de charges Optimus.xlsx, Left_Wireframe_Front_Wheel.CATPart, Left_Wireframe_Rear_Wheel.CATPart, MECAmaster - [Suspension_Wireframe].CATProduct, Suspension_Wireframe.CATProduct, [Suspension_Wireframe]_HYPER1 3348.CATPart, [Suspension_Wireframe]_HYPER1 7399.CATPart, [Suspension_Wireframe]_HYPER2 5524.CATPart]
2018-11-04 rear upright
    brake caliper supports , tripod D4484, no chamfers
    [D4484.CATPart, D4484.STEP, SU_11001 (Rear Left Upright).CATPart, SU_A1100 (Rear Left Wheel Assy).CATProduct, WT_03001 (Rear Hub).CATPart]
2018-11-04 maj plan afficheur rapport
    [rapport.brd]
2018-11-04 Réorganisation de la nomenclature et avancement du tableau de Bords
    Regroupement des pièces des afficheur 1* et 3*7segment en sous assemblages
    [EL_0400_007_AA.CATPart, EL_0400_009_AA.CATPart, EL_0401_001_AA.CATPart, EL_0401_002_AA.CATPart, EL_0401_003_AA.CATPart, EL_0402_001_AA.CATPart, EL_0402_002.CATPart, EL_A0400_AD.CATProduct]
2018-11-04 Création sous assemblage 3*7 segments + update assemblage principale
    [EL_0402_002_AA.CATPart, EL_0402_003_AA.CATPart, EL_A0400_AD.CATProduct, EL_A0402_AA.CATProduct]
2018-11-04 maj shield carte avant
    [shield carte avant.brd, shield carte avant.sch]
2018-11-05 Reprise
    décalage harnais
    [Ergonomics.CATProduct, Frame & Body.CATProduct, Gabarit 95pcm.CATPart, Seat_Driver_Assy.CATProduct, pilote.CATProduct]
2018-11-05 Modif plans boisard + renvoi
    [19B_TRACTION_01 (insert alu).igs, 19B_TRACTION_02 (insert alu manchon).igs, 19B_TRACTION_04 (insert alu type 2).igs, inserts.CATPart, inserts_25mm.CATPart]
2018-11-05 Ajout chape et couteau front ARB
    [FRONT_ARB_CHAPE (essai).CATPart, FRONT_ARB_END_PLATE (essai).CATPart]
2018-11-05 mise a jour las pour porte rotule arrière
    [Front_Lower_A_Arm_Front_Rod.CATPart, Front_Lower_A_Arm_Rear_Rod.CATPart, Front_Push_Rod.CATPart, Front_Rocker.CATPart, Front_Upper_A_Arm_Front_Rod.CATPart, Front_Upper_A_Arm_Rear_Rod.CATPart, LAS_auto.xls, Left_Wireframe_Front_Lower_Arm.CATPart]
2018-11-05 echappement redimensionne
    [Assemblage_echap.CATProduct, coude_1.CATPart, coude_2.CATPart, coude_3.CATPart, tube_fin.CATPart]
2018-11-05 pivot front arb
    [FRONT_ARB_CHAPE (essai).CATPart, FRONT_ARB_END_PLATE (essai).CATPart, FRONT_ARB_PIVOT.CATPart, SU_13009_ARB END PLATE FRONT.CATPart]
2018-11-05 de l'élec
    [BSPD.brd, BSPD.sch, Cablage Optimus.xlsx, Commandes.xlsx]
2018-11-05 debut assy arb front
    [FRONT_ARB.CATProduct, FRONT_ARB_CHAPE (essai).CATPart, FRONT_ARB_PIVOT.CATPart]
2018-11-05 Placement echappement
    [Aero.CATProduct, EN_0200_101_AA.CATPart, EN_0200_102_AA.CATPart, EN_0200_103_AA.CATPart, EN_0200_104_AA.CATPart, EN_A0100 (Engine Assy).CATProduct, EN_A0200.CATProduct, EN_A0240.CATProduct]
2018-11-06 Upper Rear Bearing Support
    Avancée
    [SU_A0300.CATProduct, Upper rear bearing support.CATPart]
2018-11-06 ajout switch tristable et trous afficheur temp
    reste à changer le trous du tdb pour le tristable et changer la taille du 7 segment
    [EL_0400_001_BE.CATPart, EL_0400_008_AA.CATPart, EL_0400_008_AB.CATPart, EL_A0400_AD.CATProduct, EL_A0400_AE.CATProduct, EL_A0402_AA.CATProduct]
2018-11-06 MAJ MECAmaster
    [Left_Wireframe_Front_Wheel.CATPart, Left_Wireframe_Rear_Wheel.CATPart, MECAmaster - [Suspension_Wireframe].CATProduct, Suspension_Wireframe.CATProduct, Wireframe_Front_Wheel.CATPart, Wireframe_Rear_Wheel.CATPart]
2018-11-06 porte excentriques
    [EN-09002 (Left).CATPart, EN_09003 (Right).CATPart]
2018-11-06 Fin optimisations et modifs ergo mineures
    [15x1.5.CATProduct, 20x1.5.CATProduct, 25x1.5.CATProduct, 30x1.5.CATProduct, 30x2.CATProduct, Filaire Optimus.CATPart, Shape_434.CATPart, Shape_435.CATPart]
2018-11-06 Agrandissemtn cellule avant sécurité
    [15x1.5.CATProduct, 20x1.5.CATProduct, 25x1.5.CATProduct, 30x1.5.CATProduct, 30x2.CATProduct, Filaire Optimus.CATPart, Shape_434.CATPart, Shape_435.CATPart]
2018-11-06 Petites modifs collecteur
    [EN_0200_001_AB.CATPart, EN_0200_002_AB.CATPart, EN_0200_003_AB.CATPart, EN_0200_004_AB.CATPart, EN_0200_005_AB.CATPart, EN_0200_006_AB.CATPart, EN_0200_007_AB.CATPart, EN_0200_008_AB.CATPart]
2018-11-06 Fuel Tank
    [Raccord Dash6 Droit.CATPart, SB_plot_M4.CATPart, dessus_propre.CATPart, entretoise_reservoir.CATPart, prueba_pompe_debajo.CATPart, rondelle large M6.CATPart]
2018-11-06 Insertion drexler
    [3x16.CATPart, 400-040-0096-00 Quadring3,68.CATPart, 6010.CATProduct, DRX00001546.CATPart, DRX00002066.CATPart, DRX00002229.CATPart, DRX00002277.CATPart, DRX00002471.CATPart]
2018-11-06 modif pivot
    [FRONT_ARB_PIVOT.CATPart]
2018-11-06 élec
    [BSPD.brd, BSPD.sch, Cablage Optimus.xlsx, rapport.brd]
2018-11-07 Réorganisation MM
    [Cas de charges Optimus.xlsx, MECAmaster - [Suspension_Wireframe].CATProduct, Suspension_Wireframe.CATProduct]
2018-11-07 Ca avance MM
    [Cas de charges Optimus.xlsx, MECAmaster - [Suspension_Wireframe].CATProduct, Suspension_Wireframe.CATProduct]
2018-11-07 Bientot fini MM
    [Cas de charges Optimus.xlsx, MECAmaster - [Suspension_Wireframe].CATProduct, Suspension_Wireframe.CATProduct]
2018-11-07 Update SU - Suspension/SU_A0100 (Upper Front A-Arms)/Upper front bearing support.CATPart
    [Upper front bearing support.CATPart]
2018-11-07 Correction erreur
    [Upper front bearing support.CATPart]
2018-11-07 Creation assemblage chapes
    [Bracket_assy.CATProduct, Lower rear bearing support.CATPart, SU_02001.CATPart, SU_A01001.CATProduct, SU_A0200.CATProduct, SU_A0400.CATProduct, Upper front bearing support.CATPart]
2018-11-07 modif susp
    [Front Upright Working Assy.CATProduct, Front_Lower_A_Arm_Front_Rod.CATPart, Front_Lower_A_Arm_Rear_Rod.CATPart, Front_Push_Rod.CATPart, Front_Rocker.CATPart, Front_Upper_A_Arm_Front_Rod.CATPart, Front_Upper_A_Arm_Rear_Rod.CATPart, Left_Wireframe_Front_Lower_Arm.CATPart]
2018-11-07 Creation publi chassis
    [Bracket_assy.CATProduct, Filaire Optimus.CATPart, Tubulaire Optimus.CATProduct]
2018-11-07 Début upper rear bearing support
    [SU_A0300.CATProduct, Upper rear bearing support.CATPart]
2018-11-07 ajout du TdB sur electrical
    [EL_0400_001_BE.CATPart, EL_A0400_AE.CATProduct, Electrical.CATProduct]
2018-11-07 Modif angle chape sup
    [Front Upright Working Assy.CATProduct, SU_10001 (Front Left Upright).CATPart, SU_10002 (Front Upper Arm Bracket).CATPart, SU_10003 (Front Upper Arm Wedge).CATPart, SU_A1000 (Front Left Wheel Assy).CATProduct]
2018-11-07 remise angle chape
    [Front Upright Working Assy.CATProduct, SU_10001 (Front Left Upright).CATPart, SU_10002 (Front Upper Arm Bracket).CATPart, SU_10003 (Front Upper Arm Wedge).CATPart, SU_A1000 (Front Left Wheel Assy).CATProduct]
2018-11-07 sauvegarde correcte
    [Front Upright Working Assy.CATProduct, SU_10001 (Front Left Upright).CATPart, SU_10002 (Front Upper Arm Bracket).CATPart, SU_10003 (Front Upper Arm Wedge).CATPart, SU_A1000 (Front Left Wheel Assy).CATProduct]
2018-11-07 catch can modélisation de la pièce
    [catcan.CATPart]
2018-11-07 Modif excel mecamaster
    [Cas de charges Optimus.xlsx]
2018-11-07 plus de probl avec chassis
    [15x1.5.CATProduct, 20x1.5.CATProduct, Filaire Optimus.CATPart, Lower rear bearing support.CATPart, MECAmaster - [Suspension_Wireframe].CATProduct, SU_02001.CATPart, SU_11001 (Rear Left Upright).CATPart, SU_11002 (Rear Upper Arm Wedge).CATPart]
2018-11-07 rear upright
    brake bell, chamfers, tripod
    [D4484.CATPart, Rear Upright Working Assy.CATProduct, SU_11003 (Rear Speed Sensor Bracket).CATPart, WT_03001 (Rear Hub).CATPart, WT_0300_002 (Rear Brake Bell).CATPart]
2018-11-07 rear upright
    tripod, brake bell, chamfers, speed sensor
    [SU_11001 (Rear Left Upright).CATPart, SU_11002 (Rear Upper Arm Wedge).CATPart, SU_A1100 (Rear Left Wheel Assy).CATProduct, Speed Sensor.CATPart]
2018-11-07 MODIF CHASSIS
    [15x1.5.CATProduct, 20x1.5.CATProduct, Filaire Optimus.CATPart, SU_11001 (Rear Left Upright).CATPart, SU_A1000 (Front Left Wheel Assy).CATProduct, SU_A1100 (Rear Left Wheel Assy).CATProduct, Shape_573.CATPart, Shape_574.CATPart]
2018-11-07 contraintes tableau de bords
    [EL_A0400_AE.CATProduct, Electrical.CATProduct]
2018-11-07 Modifs nez
    [FR_07001.CATPart]
2018-11-07 Upper Rear Bearing Support modif
    [SU_A0300.CATProduct, Upper rear bearing support.CATPart]
2018-11-07 support de batterie
    [EL_A0300_001_AA (battery support).CATPart]
2018-11-07 redressage tube suspension avant, préparation tube suspesion arrière basculeur, optimisation tube inter mainhoopbraces
    [15x1.5.CATProduct, 20x1.5.CATProduct, 25x1.5.CATProduct, 30x1.5.CATProduct, Filaire Optimus.CATPart, Shape_573.CATPart, Shape_574.CATPart, Shape_590.CATPart]
2018-11-07 Ajout sensor crash et chappes sur maquette
    [EL_01006_AA (40mm switch).CATPart, EL_0100_002_AA (Crash_sensor).CATPart, EL_A0400_AE.CATProduct, Electrical.CATProduct, chappe_crash sensor.CATPart, chappes switch 40mm.CATPart, crash_sensor+chappe.CATProduct, switch 40mm+chappe.CATProduct]
2018-11-08 Inchallah ça m'a l'air bon !
    [Cas de charges Optimus.xlsx, MECAmaster - [Suspension_Wireframe].CATProduct, Suspension_Wireframe.CATProduct]
2018-11-08 mini MAj
    [Cas de charges Optimus.xlsx, MECAmaster - [Suspension_Wireframe].CATProduct, Suspension_Wireframe.CATProduct]
2018-11-08 Réservoir dans Powertrain
    [EN_A0100 (Engine Assy).CATProduct, EN_A0200.CATProduct, EN_A0300_Air_intake.CATProduct, EN_A0400_Throttle_mecanism.CATProduct, EN_A0800_Cooling_System.CATProduct, Engine & Powertrain.CATProduct, Fuel Tank.CATProduct]
2018-11-08 avancée support moteur arrière
    [15x1.5.CATProduct, 20x1.5.CATProduct, 25x1.5.CATProduct, 30x1.5.CATProduct, EN_A0100 (Engine Assy).CATProduct, EN_A0200.CATProduct, EN_A0300_Air_intake.CATProduct, EN_A0400_Throttle_mecanism.CATProduct]
2018-11-08 Placement Differential assembly sur Powertrain
    [EN_0400_011_AA_Capteur_partie_fixe.CATPart, EN_0400_012_AA_Capteur_Partie_mobile.CATPart, EN_A0900.CATProduct, Engine & Powertrain.CATProduct]
2018-11-08 Rajout publications...
    [Bracket_assy.CATProduct, Filaire Optimus.CATPart, Tubulaire Optimus.CATProduct]
2018-11-08 placement chape avant
    [FRONT_ARB.CATProduct, FRONT_ARB_CHAPE (essai).CATPart, FRONT_ARB_END_PLATE (essai).CATPart, FRONT_ARB_PIVOT.CATPart, FRONT_ARB_ROD.CATPart]
2018-11-08 Ciao bracket assy
    [Bracket_assy.CATProduct]
2018-11-08 chape arb av
    [FRONT_ARB.CATProduct, FRONT_ARB_CHAPE (essai).CATPart, FRONT_ARB_END_PLATE (essai).CATPart, SU_11001 (Rear Left Upright).CATPart, SU_A1000 (Front Left Wheel Assy).CATProduct, SU_A1100 (Rear Left Wheel Assy).CATProduct, Suspension.CATProduct, Suspension_Wireframe.CATProduct]
2018-11-08 ajout master switch
    [EL_01006_AA (40mm switch).CATPart, EL_0100_002_AA (Crash_sensor).CATPart, EL_0400_001_BE.CATPart, EL_0400_002_AA.CATPart, EL_0400_003_AA.CATPart, EL_0400_004_AA.CATPart, EL_0400_005_AA.CATPart, EL_0400_006_AA.CATPart]
2018-11-08 Rangement MecaMaster
    [MECAmaster - [Suspension_Wireframe].CATProduct, [Suspension_Wireframe]_HYPER1 1778.CATPart, [Suspension_Wireframe]_HYPER1 3348.CATPart, [Suspension_Wireframe]_HYPER1 461.CATPart, [Suspension_Wireframe]_HYPER1 7399.CATPart, [Suspension_Wireframe]_HYPER2 5524.CATPart, [Suspension_Wireframe]_HYPER2 893.CATPart, [Suspension_Wireframe]_HYPER2 9579.CATPart]
2018-11-08 maj contraintes
    [Frame & Body.CATProduct]
2018-11-08 Nomenclature Fuel System
    [EN_05001 (Main).CATPart, EN_05004 (Raccord Dash6 Droit).CATPart, EN_05005 (Entretoise).CATPart, EN_05006 (Chape).CATPart, EN_05007 (Rondelle large M6).CATPart, EN_A0500 (Fuel Tank Assy).CATProduct, En_05003 (Silent block).CATPart]
2018-11-08 MAJ Fuel tank
    [EN_A0500 (Fuel Tank Assy).CATProduct]
2018-11-08 Crash Box et Anti intrusion plate
    [FR_01002 (Anti intrusion plate).CATPart, FR_0200_001_MM.CATPart, Frame & Body.CATProduct]
2018-11-08 MAJ crash box
    [Frame & Body.CATProduct]
2018-11-08 Ajout réservoir et radiateur
    [EN_07001.CATPart, EN_A0800_Cooling_System.CATProduct, Engine & Powertrain.CATProduct]
2018-11-08 MAJ Carrosserie
    [FR_07002.CATPart]
2018-11-08 Mise en place drivetrain
    [EN_A0100 (Engine Assy).CATProduct, EN_A0200.CATProduct, EN_A0300_Air_intake.CATProduct, EN_A0400_Throttle_mecanism.CATProduct, Engine & Powertrain.CATProduct]
2018-11-08 Ajustement points LAS arrière pour chapes
    [15x1.5.CATProduct, 20x1.5.CATProduct, 25x1.5.CATProduct, Filaire Optimus.CATPart, Shape_446.CATPart, Shape_447.CATPart, Shape_448.CATPart, Shape_449.CATPart]
2018-11-08 Rangement LAS Auto
    [Suspension_Wireframe.CATProduct]
2018-11-08 Mise à jour collecteur
    [EN_0200_001_AB.CATPart, EN_0200_037_AB.CATPart, EN_0200_038_AB.CATPart, EN_A0200.CATProduct]
2018-11-08 Pb position moteur
    [15x1.5.CATProduct, 20x1.5.CATProduct, 25x1.5.CATProduct, 30x1.5.CATProduct, 30x2.CATProduct, Filaire Optimus.CATPart, Shape_434.CATPart, Shape_435.CATPart]
2018-11-08 modifs échappement
    [EN_0200_028_AB.CATPart, EN_0200_029_AB.CATPart, EN_0200_030_AB.CATPart, EN_A0200.CATProduct, EN_A0221.CATProduct]
2018-11-08 Maj roue arrière
    [SU_11001 (Rear Left Upright).CATPart, SU_A1000 (Front Left Wheel Assy).CATProduct, SU_A1100 (Rear Left Wheel Assy).CATProduct]
2018-11-08 ajustement frontbulkhead
    [15x1.5.CATProduct, 20x1.5.CATProduct, 25x1.5.CATProduct, 30x1.5.CATProduct, 30x2.CATProduct, Filaire Optimus.CATPart, Shape_429.CATPart, Shape_430.CATPart]
2018-11-08 Front BAR nomenclature
    [FRONT_ARB.CATProduct, SU_1401 (Barre).CATPart, SU_1402 (Chape).CATPart, SU_1403 (Pivot).CATPart, SU_1404 (Couteau).CATPart, SU_1405 (Biellette).CATPart, SU_A1400.CATProduct, Suspension.CATProduct]
2018-11-08 MJ Front ARB
    [SU_1400_001 (Barre).CATPart, SU_1400_002 (Chape).CATPart, SU_1400_003 (Pivot).CATPart, SU_1400_004 (Couteau).CATPart, SU_1400_005 (Biellette).CATPart]
2018-11-08 Ajout dossier rear suspension avec la chape
    [Cas de charges Optimus.xlsx, Damper_ZF.CATProduct, LAS_auto.xls.xlsx, Mecamaster-macro.xlsm, Mecamaster-macro.xlsm (2).xlsx, Mecamaster-macro.xlsm.xlsx, Mecamaster.xlsx, Mecamaster_2-macro.xlsm]
2018-11-08 Gueules de Loup cellule avant (sans retrait matière)
    [15x1.5.CATProduct, 20x1.5.CATProduct, 25x1.5.CATProduct, 30x1.5.CATProduct, 30x2.CATProduct, Shape_429.CATPart, Shape_430.CATPart, Shape_431.CATPart]
2018-11-08 Revert "no message"
    This reverts commit 46a7498d2e7f5af6f924a52a6dbcf402bd9a7a80.
    [Shape_590.CATPart, Shape_613.CATPart]
2018-11-08 F tank
    [EN_A05000.CATProduct, EN_A05001(main).CATPart]
2018-11-08 positionement f tunk
    [EN_A05000.CATProduct, EN_A05001(main).CATPart, Engine & Powertrain.CATProduct]
2018-11-08 Fin gorge de loup avant (un côté) + pb exitant
    [15x1.5.CATProduct, 25x1.5.CATProduct, 30x1.5.CATProduct, Shape_434.CATPart, Shape_471.CATPart, Shape_585.CATPart, Shape_588.CATPart, Shape_589.CATPart]
2018-11-08 Contrainte échappement + MAJ
    [EN_A0100 (Engine Assy).CATProduct, EN_A0200.CATProduct, EN_A0300_Air_intake.CATProduct, EN_A0400_Throttle_mecanism.CATProduct, EN_A05000.CATProduct, Engine & Powertrain.CATProduct]
2018-11-08 Throttle body
    [EN_0400_001_AA_bas_guillotine.CATPart, EN_0400_002_AB_milieu_guillotine.CATPart, EN_0400_003_AA_arret_guillotine.CATPart, EN_0400_004_AB_guillotine.CATPart, EN_0400_004_AB_guillotine_Analysis.CATPart, EN_0400_005_AA_haut_guillotine.CATPart, EN_0400_005_AA_haut_guillotine_analysis.CATPart, EN_0400_007_AA_convergeant.CATPart]
2018-11-08 Revert "Throttle body"
    This reverts commit e5d1d7078dabeb623bd07c82af5d65710fe8dd5d.
    [EN_0400_001_AA_bas_guillotine.CATPart, EN_0400_002_AB_milieu_guillotine.CATPart, EN_0400_003_AA_arret_guillotine.CATPart, EN_0400_004_AB_guillotine.CATPart, EN_0400_004_AB_guillotine_Analysis.CATPart, EN_0400_005_AA_haut_guillotine.CATPart, EN_0400_005_AA_haut_guillotine_analysis.CATPart, EN_0400_007_AA_convergeant.CATPart]
2018-11-08 Revert "PIMPOMPIMPOMPIMPOM"
    This reverts commit 07f0366c5b6e45ed9710352e7bf8b07074e72fe5.
    [EN_0400_001_AA_bas_guillotine.CATPart, EN_0400_002_AB_milieu_guillotine.CATPart, EN_0400_003_AA_arret_guillotine.CATPart, EN_0400_004_AB_guillotine.CATPart, EN_0400_004_AB_guillotine_Analysis.CATPart, EN_0400_005_AA_haut_guillotine.CATPart, EN_0400_005_AA_haut_guillotine_analysis.CATPart, EN_0400_007_AA_convergeant.CATPart]
2018-11-08 MAJ susp
    [Suspension.CATProduct, Wireframe_Rear_Upright.CATPart]
2018-11-08 Commande d'embrayage
    [FR_0500_001_DA.CATPart, FR_0500_002_DA.CATPart, FR_0500_003_DA.CATPart, FR_A0500.CATProduct]
2018-11-08 Pas le bon volant dans ergonomie ^^
    [Ergonomics.CATProduct]
2018-11-08 MAJ nomenclature Fuel System
    [EN_0500_001 (main).CATPart, EN_0500_002 (tube).CATPart, EN_0500_003 (SB_plot_M4).CATPart, EN_0500_004 (Raccord Dash6 Droit).CATPart, EN_0500_005(entretoise_reservoir).CATPart, EN_0500_006(chape dessous).CATPart, EN_0500_007(rondelle large M6).CATPart, EN_0500_008 (Sight Tube).CATPart]
2018-11-08 Revert "Pas le bon volant dans ergonomie ^^"
    This reverts commit e4fbd9a9f41aa6b44be56112d9e516f7f6a5874c.
    [Ergonomics.CATProduct]
2018-11-08 Revert "Menage"
    This reverts commit e97c3bf85090ca3979e2708c41cca9576a67e0a9.
    [ZZ.CATProduct]
2018-11-08 Douilles suite
    [EN_A0900.CATProduct, Engine & Powertrain.CATProduct]
2018-11-08 Air intake
    [EN_0300_001_AA_Plenum.CATPart, EN_0300_002_AA_Fond_plat.CATPart, EN_0300_003_AA_Tubulures.CATPart, EN_A0300_Air_intake.CATProduct]
2018-11-08 nouveau porte excentrique gauche
    [EN-09002 bis (Left).CATPart]
2018-11-08 MAJ Diff Assy
    [6010.CATProduct, EN_A0900.CATProduct]
2018-11-08 Alignement diff assy dans engine
    [Engine & Powertrain.CATProduct]
2018-11-08 Ajustement Rear ARB Chape
    [REAR_ARB_CHAPE.CATPart]
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2018-11-08 Gabarit pour cellule avant
    Gabarit du reglement
    [Gabarit Optimus ergo.CATPart]
2018-11-09 Trans secondaire
    [EN_0903_001.CATPart, EN_0904_001.CATPart, EN_1100_001_AA.CATPart, EN_1100_002_AA.CATPart, EN_1100_005 le vrai.CATPart, EN_A0900.CATProduct, EN_A0901.CATProduct, EN_A0901_006.CATProduct]
2018-11-09 placement elec
    [8STA-14.CATPart, EL_0600_001.CATPart, EL_0600_002.CATPart, EL_0600_003.CATPart, EL_A0400_AE.CATProduct, EL_A06001.CATProduct, Electrical.CATProduct]
2018-11-09 Importation couronne
    [EN_0902_001.CATPart, EN_0902_002.CATPart, EN_A0902.CATProduct]
2018-11-09 assy rear arb
    [REAR_ARB_CHAPE.CATPart, SU_1500_002 (Chape).CATPart, SU_1500_003 (Pivot).CATPart, SU_1500_04 (Couteau).CATPart, SU_A1400.CATProduct, SU_A1500.CATProduct]
2018-11-09 Sprocket dans engine assy
    [EN_0100_002.CATPart, EN_A0100 (Engine Assy).CATProduct, EN_A0101 (Carter Assy).CATProduct]
2018-11-09 placement boites et dta vite fait
    [Aero.CATProduct, Cardan.CATProduct, Electrical.CATProduct, Engine & Powertrain.CATProduct, Ergonomics.CATProduct, Frame & Body.CATProduct, ISO_7089_12x24_STEEL_GRADE_A_NORMAL_SERIES_PLAIN_WASHER.CATPart, ISO_7089_4x9_STEEL_GRADE_A_NORMAL_SERIES_PLAIN_WASHER.CATPart]
2018-11-09 rear arb
    [SU_1500_001 (Barre).CATPart, SU_A1500.CATProduct]
2018-11-09 Brake light
    [EL_0100_003_AA.STEP]
2018-11-09 elec + catia
    [EL_0100_003_AB (Break Light).CATPart, EL_0100_003__AA (Break_Light).CATPart, EL_A0400_AE.CATProduct, Electrical.CATProduct, Shape_433.CATPart, chappes break light.CATPart]
2018-11-09 Points Aurélien
    [LAS_auto.xls, Suspension_Frame_points.CATPart]
2018-11-09 Alignement diff
    [Engine & Powertrain.CATProduct]
2018-11-09 Modif direction
    [Bracket_Assy.CATProduct, ST_0100_001 (Rack).CATPart, ST_0100_003 (Half Moon new).CATPart, Steering_Rack_Assy.CATProduct, bracketsV2.CATProduct, test_chape_chetane.CATPart, vis_chc_M6_40.CATPart]
2018-11-09 Matériaux Plenum
    [EN_1100_001_AA.CATPart]
2018-11-09 Fixation air intake
    [EN_0300_005_AA_Trompette.CATPart, EN_0300_005_AA_fixation_moteur.CATPart, EN_A0300_Air_intake.CATProduct]
2018-11-09 Problème chassis élec
    [Optimus.CATProduct]
2018-11-09 Modif publis
    [Chapes_assy.CATProduct, Suspension_Frame_points.CATPart, Suspension_Wireframe.CATProduct]
2018-11-09 Vase expension, SIlencieux
    [EN_0200_037_AB.CATPart, EN_0800_001 (Radiator).CATPart, EN_0800_004 (Expansion Tank).CATPart, EN_A0200.CATProduct, EN_A0800_Cooling_System.CATProduct, Engine & Powertrain.CATProduct]
2018-11-09 PE gauche
    [EN-09002 bis (Left).CATPart]
2018-11-09 MAP Air intake
    [EN_0300_001_AA_Plenum.CATPart, EN_0300_002_AA_Fond_plat.CATPart, EN_0300_003_AA_Tubulures.CATPart, EN_A0300_Air_intake.CATProduct]
2018-11-09 Maj powertrain, pompe carburant etc...
    [EN_0101_001 (Rear carter wall).CATPart, EN_0101_002 (Side carter wall).CATPart, EN_0101_003 (Front carter wall).CATPart, EN_0101_004 (Bottom rear carter wall).CATPart, EN_0101_005 (Bottom front carter wall).CATPart, EN_0101_007 (Etanchity plate).CATPart, EN_0101_008 (Small longi plate).CATPart, EN_0101_009 (Middle plate).CATPart]
2018-11-09 Wtf ... ?
    [bracket_triangle_arriere_bas_bras_avant_1.CATPart, bracket_triangle_arriere_bas_bras_avant_2.CATPart, bracket_triangle_arriere_haut_bras_avant_1.CATPart, bracket_triangle_arriere_haut_bras_avant_2.CATPart, bracket_triangle_avant_bas_bras_avant_2.CATPart]
2018-11-09 Maj powertrain + pompe
    [EN_A0100 (Engine Assy).CATProduct, EN_A0200.CATProduct, EN_A0300_Air_intake.CATProduct, EN_A0400_Throttle_mecanism.CATProduct, EN_A05000.CATProduct, EN_A0600.CATProduct, EN_A0900.CATProduct, EN_A1200.CATProduct]
2018-11-09 Ca casse les couilles les 0As
    [Chapes_assy.CATProduct]
2018-11-09 MODIF rear arb
    [SU_1500_002 (Chape).CATPart, SU_1500_04 (Couteau).CATPart, SU_A1500.CATProduct, Suspension.CATProduct]
2018-11-09 Avancée offset LAS
    [15x1.5.CATProduct, 20x1.5.CATProduct, 25x1.5.CATProduct, 30x1.5.CATProduct, 30x2.CATProduct, Filaire Optimus.CATPart, Shape_434.CATPart, Shape_435.CATPart]
2018-11-09 modif chape
    [SU_1500_002 (Chape).CATPart, SU_A1500.CATProduct]
2018-11-09 Chapes rectif github
    [Chapes_assy.CATProduct, bracket_triangle_arriere_bas_bras_avant_1.CATPart, bracket_triangle_arriere_bas_bras_avant_2.CATPart, bracket_triangle_arriere_haut_bras_avant_1.CATPart, bracket_triangle_arriere_haut_bras_avant_2.CATPart, bracket_triangle_avant_bas_bras_arriere_1.CATPart, bracket_triangle_avant_bas_bras_arriere_2.CATPart, bracket_triangle_avant_bas_bras_avant_1.CATPart]
2018-11-09 Rectif github 2
    [Chapes_assy.CATProduct, bracket_triangle_avant_bas_bras_avant_1.CATPart, bracket_triangle_avant_bas_bras_avant_2.CATPart]
2018-11-09 Position drexler
    [EN_0902_002.CATPart, EN_A0300_Air_intake.CATProduct, EN_A0900.CATProduct, EN_A0902.CATProduct, Engine & Powertrain.CATProduct]
2018-11-09 Rectif github 3
    [Chapes_assy.CATProduct, SU_A1000 (Front Left Wheel Assy).CATProduct, SU_A1100 (Rear Left Wheel Assy).CATProduct, Suspension_Wireframe.CATProduct, bracket_triangle_avant_bas_bras_arriere_1.CATPart, bracket_triangle_avant_bas_bras_avant_1.CATPart, bracket_triangle_avant_bas_bras_avant_2.CATPart]
2018-11-09 modif assy susp
    [SU_A1400.CATProduct, Suspension.CATProduct, bracket_front_susp.CATPart]
2018-11-09 mise en place chapes brouillon front susp
    [SU_A1000 (Front Left Wheel Assy).CATProduct, SU_A1100 (Rear Left Wheel Assy).CATProduct, Suspension.CATProduct, Suspension_Wireframe.CATProduct, bracket_front_susp.CATPart]
2018-11-09 Revert "Chapes"
    This reverts commit ae83c27bc8bb474ebe808972ee8e7da45e35f0be.
    [Chapes_assy.CATProduct, SU_A1000 (Front Left Wheel Assy).CATProduct, SU_A1100 (Rear Left Wheel Assy).CATProduct, Suspension_Wireframe.CATProduct, bracket_triangle_arriere_haut_bras_arriere_1.CATPart, bracket_triangle_arriere_haut_bras_arriere_2.CATPart, bracket_triangle_arriere_haut_bras_avant_2.CATPart, bracket_triangle_avant_bas_bras_avant_2.CATPart]
2018-11-09 Publi biellette pince
    [Suspension_Frame_points.CATPart]
2018-11-09 pos drexler
    [Engine & Powertrain.CATProduct]
2018-11-09 Double chape
    [Chapes_assy.CATProduct, bracket_triangle_arriere_bas_bras_arriere_1.CATPart]
2018-11-09 MAJ Fuel tank, cooling, noms
    [EN_A0100 (Engine Assy).CATProduct, EN_A0200.CATProduct, EN_A0300_Air_intake.CATProduct, EN_A0400_Throttle_mecanism.CATProduct, EN_A05000.CATProduct, EN_A0600.CATProduct, EN_A0900.CATProduct, EN_A1200.CATProduct]
2018-11-09 Adaptation châssis chapes LAS
    [15x1.5.CATProduct, 20x1.5.CATProduct, 25x1.5.CATProduct, 30x2.CATProduct, Filaire Optimus.CATPart, Shape_446.CATPart, Shape_447.CATPart, Shape_448.CATPart]
2018-11-09 God < PACO < Reedom
    [Insert_Frame_Side.CATPart]
2018-11-10 Prémiére Rocker
    [Rear_Rocker 1.CATPart]
2018-11-10 Je l'enlève
    [Rear_Rocker 1.CATPart]
2018-11-10 MAJ roulement diff + excentriques
    [6010.CATProduct, 6011.CATProduct, DSD-240-500-0002-00_Kettenradadapter_Halbfertigteil_Formula_Student.CATPart, EN_0900_004_AA (Excentrique gauche).CATPart, EN_0900_004_AA(Excentrique Gauche).CATPart, EN_0900_005_AA (Excentrique Droit).CATPart, EN_0901_008.CATPart, EN_0903_001.CATPart]
2018-11-10 maj orientation diff
    [EN_A0900.CATProduct, Engine & Powertrain.CATProduct, Optimus.CATProduct]
2018-11-10 Chapes assy
    [Chapes_assy.CATProduct, bracket_triangle_arriere_bas_bras_avant_1.CATPart, bracket_triangle_arriere_bas_bras_avant_2.CATPart, bracket_triangle_arriere_haut_bras_avant_1.CATPart, bracket_triangle_arriere_haut_bras_avant_2.CATPart, bracket_triangle_avant_bas_bras_arriere_1.CATPart, bracket_triangle_avant_bas_bras_arriere_2.CATPart, bracket_triangle_avant_bas_bras_avant_1.CATPart]
2018-11-10 chapes front susp
    [bracket_front_susp.CATPart]
2018-11-10 Maj Fuel tank raccords
    [EN_0500_001 (main).CATPart, EN_0500_002 (tube).CATPart, EN_0500_010 (embase dash 6).CATPart, EN_A05000.CATProduct, EN_A1100.CATProduct]
2018-11-10 Mise à jour points de basculeurs arrière
    [LAS_auto.xls]
2018-11-10 modifs adapt
    [FR_07001.CATPart, FR_07002.CATPart]
2018-11-10 Push supprimé remis
    [Bracket_Assy.CATProduct, ST_0100_001 (Rack 400mm).CATPart, ST_0100_002 (Brackets).CATPart, Steering.CATProduct]
2018-11-10 Test chape
    [test_chape.CATPart]
2018-11-10 moule pe gauche
    [EN-009 pe gauche.CATPart, Engine & Powertrain.CATProduct]
2018-11-10 adapt susp
    [FR_07001.CATPart, FR_07002.CATPart]
2018-11-10 plus clair
    [FR_07001.CATPart, FR_07002.CATPart]
2018-11-10 Points LAS
    [15x1.5.CATProduct, 20x1.5.CATProduct, 25x1.5.CATProduct, 30x1.5.CATProduct, 30x2.CATProduct, Filaire Optimus.CATPart, Shape_434.CATPart, Shape_435.CATPart]
2018-11-10 modif frame et mise a jour susp
    [15x1.5.CATProduct, 20x1.5.CATProduct, 25x1.5.CATProduct, 30x1.5.CATProduct, 30x2.CATProduct, Filaire Optimus.CATPart, SU_A1000 (Front Left Wheel Assy).CATProduct, SU_A1100 (Rear Left Wheel Assy).CATProduct]
2018-11-10 porte excentrique gauche
    [EN-009 pe gauche.CATPart, EN_A0901.CATProduct, Engine & Powertrain.CATProduct]
2018-11-10 encore lui
    [EN-009 pe gauche.CATPart]
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2018-11-10 MàJ Front ARB chape
    [SU_1400_002 (Chape).CATPart]
2018-11-10 PE droit
    [EN-009 pe droit.CATPart, EN_A0900.CATProduct, EN_A0901.CATProduct, Engine & Powertrain.CATProduct]
2018-11-10 Carte avant
    [MCP2515Calc.xlsx]
2018-11-10 Ajout entretoises
    [Chapes_assy.CATProduct, bracket_triangle_arriere_bas_bras_arriere_1.CATPart, bracket_triangle_arriere_bas_bras_avant_1.CATPart, bracket_triangle_arriere_bas_bras_avant_2.CATPart, bracket_triangle_arriere_haut_bras_arriere_1.CATPart, bracket_triangle_arriere_haut_bras_arriere_2.CATPart, bracket_triangle_arriere_haut_bras_avant_1.CATPart, bracket_triangle_arriere_haut_bras_avant_2.CATPart]
2018-11-10 ajustement pe droit
    [EN-009 pe droit.CATPart]
2018-11-10 Finalisation embrayage
    [FR_0500_001_DA.CATPart, FR_0500_002_DA.CATPart, FR_0500_003_DA.CATPart, FR_0500_004_DA.CATPart, FR_0500_005_DA.catpart, FR_0500_006_DA.catpart, FR_0500_007_DA.CATPart, FR_0500_008_DA.CATPart]
2018-11-10 renommage fichiers TdB
    [Liste_des_composants_TdB_v2.ods, Liste_des_composants_TdB_v3.ods]
2018-11-10 Insertion commande d'embrayage dans Frame & Body
    [Frame & Body.CATProduct]
2018-11-10 ajustement poche pe droit
    [EN-009 pe droit.CATPart]
2018-11-10 liste composants
    [Liste_composants_TdB_v3.ods]
2018-11-10 adapt BAR
    [FR_07001.CATPart, FR_07002.CATPart]
2018-11-10 trous jacking bar
    [EN-009 pe droit.CATPart, EN-009 pe gauche.CATPart, Engine & Powertrain.CATProduct]
2018-11-10 Ajout trous passe fils sur le TdB
    [EL_0400_001_BF.CATPart]
2018-11-10 modif insert + entretoise + redimensionnement pour collision
    [Insert_Frame_Side.CATPart, entretoise_16mm_distance_chapes.CATPart]
2018-11-10 Maj axes chapes
    [Chapes_assy.CATProduct, bracket_triangle_avant_haut_bras_arriere_1.CATPart, bracket_triangle_avant_haut_bras_arriere_2.CATPart, bracket_triangle_avant_haut_bras_avant_2.CATPart]
2018-11-10 Chapes nez
    [FR_07001_01_BA.CATPart, FR_07001_02_BA.CATPart]
2018-11-10 MAJ points LAS chapes
    [15x1.5.CATProduct, 20x1.5.CATProduct, 25x1.5.CATProduct, 30x1.5.CATProduct, 30x2.CATProduct, Filaire Optimus.CATPart, Shape_436.CATPart, Shape_437.CATPart]
2018-11-10 pts las
    [15x1.5.CATProduct, 20x1.5.CATProduct, 25x1.5.CATProduct, Filaire Optimus.CATPart, Shape_448.CATPart, Shape_449.CATPart, Shape_455.CATPart, Shape_457.CATPart]
2018-11-10 Chapes cc
    [Chapes_assy.CATProduct, bracket_triangle_arriere_bas_bras_avant_1.CATPart, bracket_triangle_arriere_haut_bras_arriere_1.CATPart, bracket_triangle_arriere_haut_bras_arriere_2.CATPart, bracket_triangle_arriere_haut_bras_avant_1.CATPart, bracket_triangle_arriere_haut_bras_avant_2.CATPart, insert_frame_side.CATProduct]
2018-11-10 Importation chaine
    [chaine.CATPart]
2018-11-10 Recuperation travail
    [Chape_fixation_chassis.CATPart, EN_0300_001_AA_Plenum.CATPart, EN_0300_002_AA_Fond_plat.CATPart, EN_0300_003_AA_Tubulures.CATPart, EN_0300_005_AA_fixation_moteur.CATPart, EN_0300_006_AA_fixation_chassis.CATPart, EN_0400_001_AA_bas_guillotine.CATPart, EN_0400_010_AA_bride.CATPart]
2018-11-10 placement truc elec
    [EL_A0200_001 (MK3).CATPart, Electrical.CATProduct, bracket_power_distribution.CATPart]
2018-11-10 placement dta
    [Electrical.CATProduct, Optimus.CATProduct]
2018-11-10 Bump 3G MM
    [MECAmaster - [Suspension_Wireframe].CATProduct, Suspension_Wireframe.CATProduct, Wireframe_Rear_Wheel.CATPart]
2018-11-10 Ajout lien mcp segment
    [Lien mcp - 7 segements.xlsx]
2018-11-10 Assemblage chapes
    [Chapes_assy.CATProduct, ecrou_knuts.CATPart]
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2018-11-10 Ajout vis + ecrou
    [Chapes_assy.CATProduct, ecrou_knuts.CATPart]
2018-11-10 Git la chiasse
    [EN_0300_001_AA_Plenum.CATPart, EN_0300_003_AA_Tubulures.CATPart, EN_0300_006_AA_fuel_pomp.CATPart, EN_0300_007_AA_fixation_chassis.CATPart, EN_A0300_Air_intake.CATProduct, EN_A0400_Throttle_mecanism.CATProduct, EN_A05000.CATProduct, EN_A0600.CATProduct]
2018-11-10 chape avant susp tube carré
    [Suspension.CATProduct, bracket_front_susp.CATPart]
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2018-11-10 Modifs triangles
    [6x35CHC.CATPart, 6x55CHC.CATPart, Chapes_assy.CATProduct, Lower rear bearing support.CATPart, SU_0100_006.CATPart, SU_A01001.CATProduct, SU_A0200.CATProduct, ecrou_M6_NS.CATPart]
2018-11-10 Modif chapes matériau
    [Chapes_assy.CATProduct, bracket_triangle_arriere_bas_bras_arriere_1.CATPart, bracket_triangle_arriere_bas_bras_arriere_2.CATPart, bracket_triangle_arriere_haut_bras_avant_2.CATPart, bracket_triangle_avant_bas_bras_avant_1.CATPart, bracket_triangle_avant_haut_bras_arriere_1.CATPart]
2018-11-11 Siege foutu
    [Ergonomics.CATProduct, Gabarit 95pcm.CATPart, Seat_Driver_Assy.CATProduct, pilote.CATProduct]
2018-11-11 SUSP_ Importation chapes + pb fichier en local résolu
    [Chapes_assy.CATProduct, MECAmaster - [Suspension_Wireframe].CATProduct, Suspension.CATProduct, Suspension_Wireframe.CATProduct, Symmetry of bracket_triangle_arriere_bas_bras_arriere_1.CATPart, Symmetry of bracket_triangle_arriere_bas_bras_arriere_2.CATPart, Symmetry of bracket_triangle_arriere_haut_bras_avant_2.CATPart, Symmetry of bracket_triangle_avant_bas_bras_avant_1.CATPart]
2018-11-11 modif arb avant = gain d'une position
    [SU_1400_002 (Chape).CATPart, SU_1400_004 (Couteau).CATPart, SU_1400_005 (Biellette).CATPart, SU_A1400.CATProduct, Suspension.CATProduct]
2018-11-11 Maj sight tube
    [EN_0500_001 (main).CATPart, EN_0500_002 (tube).CATPart, EN_0500_008 (Sight Tube).CATPart, EN_A05000.CATProduct, EN_A0600.CATProduct, Engine & Powertrain.CATProduct]
2018-11-11 positionnement rear chapes olhins + elements finis chape
    [Chapes_assy.CATProduct, bracket_rear_susp.CATPart]
2018-11-11 ajout chapes
    [Chapes_nez_assy.CATProduct, Symmetry of Chape_nez_1.CATPart, Symmetry of Chapes_nez_2_1.CATPart]
2018-11-11 ajout chapes assy
    [Chapes_nez_assy.CATProduct, Frame & Body.CATProduct, Symmetry of Chape_nez_1.CATPart, Symmetry of Chapes_nez_2_1.CATPart]
2018-11-11 Upper Rear Bearing Support
    [SU_A0300.CATProduct]
2018-11-11 Mise en place chape moteur + correction
    [EN_0100_002_AA.CATPart, EN_0100_003_AA.CATPart, EN_1100_001_AA.CATPart, EN_A0100 (Engine Assy).CATProduct, EN_A0900.CATProduct, EN_A1200.CATProduct, Engine & Powertrain.CATProduct]
2018-11-11 Amélioration paramétrage, rectification diamètre tubes
    [15x1.5.CATProduct, 20x1.5.CATProduct, 25x1.5.CATProduct, 30x1.5.CATProduct, Filaire Optimus.CATPart, Shape_452.CATPart, Shape_453.CATPart, Shape_454.CATPart]
2018-11-11 placement boite avant et BSPD
    [BSPD.brd, EL_0100_007_AA (BSPD).CATPart, Electrical.CATProduct]
2018-11-11 FEA et capteur vitesse et arrache roulement
    [6x40CHC.CATPart, 6x50CHC.CATPart, 6x55CHC.CATPart, KM_10.CATPart, MB_10.CATPart, SU_10001 (Front Left Upright).CATPart, SU_10002 (Front Upper Arm Bracket).CATPart, SU_10004 (Front Speed Sensor Bracket).CATPart]
2018-11-11 Insert chassis
    [Insert_Frame_Side.CATPart]
2018-11-11 Insert taraude
    [Insert_tie_rod_SA-8E.CATProduct, SA_6_E.CATPart, bouchon_tube.CATPart, ecrou M8 iso 4035.catpart]
2018-11-11 Modif contraintes LAS auto
    [Suspension_Wireframe.CATProduct]
2018-11-11 Chgt ecrou
    [Insert_tie_rod_SA-8E.CATProduct, ecrous_bas_M6.catpart]
2018-11-11 Importation fond plat + pare feu à eclater en part +assembly
    [FR_0400_001.CATPart]
2018-11-11 Las auto modif offsets
    [Chapes_assy.CATProduct, LAS_auto.xls, Rod_gen.CATPart, SU_A1000 (Front Left Wheel Assy).CATProduct, SU_A1100 (Rear Left Wheel Assy).CATProduct, Suspension.CATProduct, Suspension_Wireframe.CATProduct, Symmetry of Front Left Wheel.CATProduct]
2018-11-11 Maj rod las auto
    [Front_Lower_A_Arm_Front_Rod.CATPart, Front_Lower_A_Arm_Rear_Rod.CATPart, Front_Push_Rod.CATPart, Front_Upper_A_Arm_Front_Rod.CATPart, Front_Upper_A_Arm_Rear_Rod.CATPart, Insert_Frame_Side.CATPart, Rear_Lower_A_Arm_Front_Rod.CATPart, Rear_Lower_A_Arm_Rear_Rod.CATPart]
2018-11-11 centrage manikin
    [Ergonomics.CATProduct, Seat_Driver_Assy.CATProduct, pilote.CATProduct]
2018-11-11 Frame side insert modif
    [Insert_Frame_Side.CATPart]
2018-11-11 Modif orga chape_assy et suspension
    [Chapes_assy.CATProduct, Suspension.CATProduct, Symmetry of BR_0100_001_MM (Brake Caliper).CATPart, Symmetry of BR_0200_001 (Break Disc).CATPart, Symmetry of Brake Bell.CATPart, Symmetry of Front Left Wheel.CATProduct, Symmetry of Front Upright Working Assy.CATProduct, Symmetry of Front upper A-Arms.CATProduct]
2018-11-11 tripod housing
    [D5371.CATPart, SU_A1100 (Rear Left Wheel Assy).CATProduct, WT_03004 (Tripod Housing Spacer).CATPart]
2018-11-11 porte excentrique droit
    [EN-009 pe droit.CATPart, Engine & Powertrain.CATProduct]
2018-11-11 Symmétries LAS
    [6x35CHC.CATPart, Chapes_assy.CATProduct, Front_Lower_A_Arm_Front_Rod.CATPart, Front_Lower_A_Arm_Rear_Rod.CATPart, GE_6_E_ir.CATPart, SA_6_E.CATPart, SU_0100_006.CATPart, SU_02001.CATPart]
2018-11-11 bug suspension optimus
    [Bracket_Assy.CATProduct, Cardan.CATProduct, Chapes_assy.CATProduct, SU_A1000 (Front Left Wheel Assy).CATProduct, SU_A1100 (Rear Left Wheel Assy).CATProduct, Steering.CATProduct, Suspension.CATProduct, Suspension_Wireframe.CATProduct]
2018-11-11 Insert chassis version finale
    [Insert_Frame_Side.CATPart]
2018-11-11 Bug direction
    [CIRCLIP_M30.CATPart, ST_A0700 (Steering Shaft Pivot).CATProduct, SU_07002_STEERING BORE.CATPart, Steering.CATProduct, W_61806_bearing.CATProduct]
2018-11-11 avancement sérigraphie TdB
    [Drawing4 R12.dxf, Drawing4.dxf, Graphismes.kicad_pcb, Graphismes.sch, graphisme R12.dxf, graphisme echelle corrige.dxf, graphisme.dxf]
2018-11-11 évidement PE droit
    [EN-009 pe droit.CATPart]
2018-11-11 Position volant finish
    position 18° et 140mm sous le front hoop
    [Ergonomics.CATProduct, Frame & Body.CATProduct, Gabarit 95pcm.CATPart, Seat_Driver_Assy.CATProduct, Steering Wheel carbon.CATProduct, Steering wheel.CATPart, pilote.CATProduct]
2018-11-11 Suspension AR plus basse
    [LAS_auto.xls]
2018-11-11 Version finale insert avant bas cote PM
    [SU_02001.CATPart, SU_A0200.CATProduct]
2018-11-11 Version finale insert PM arriere bas
    [Insert_Frame_Side.CATPart, Lower rear bearing support.CATPart, SU_02001.CATPart, SU_A0400.CATProduct]
2018-11-11 ajustement porte excentriques
    [EN-009 pe droit.CATPart, EN-009 pe gauche.CATPart, Engine & Powertrain.CATProduct]
2018-11-12 Maj problemes locaux
    [Frame & Body.CATProduct]
2018-11-12 ajustement épaisseur porte excentriques
    [EN-009 pe droit.CATPart, EN-009 pe gauche.CATPart, EN_A0900.CATProduct]
2018-11-12 regulateur et taille mannequin
    [Electrical.CATProduct, Ergonomics.CATProduct, pilote.CATProduct, switch 40mm+chappe.CATProduct]
2018-11-12 basculeur avant + elements finis
    [SU_A0600_001 (Rocker).CATPart]
2018-11-12 pilote fond siege
    [Ergonomics.CATProduct, Seat_Driver_Assy.CATProduct, pilote.CATProduct]
2018-11-12 décalage boutons et correction serigraphies
    [EL_0400_001_BG.CATPart, EL_A0400_AF.CATProduct, EL_A0402_AA.CATProduct]
2018-11-12 nouveau TdB dans electrical.catPart
    [EL_A0400_AF.CATProduct, Electrical.CATProduct]
2018-11-12 Insert avant sup modif collisions
    [Upper front bearing support.CATPart]
2018-11-12 Modif hauteur tube harnais
    [15x1.5.CATProduct, 20x1.5.CATProduct, 25x1.5.CATProduct, 30x1.5.CATProduct, 30x2.CATProduct, Filaire Optimus.CATPart, Shape_436.CATPart, Shape_437.CATPart]
2018-11-12 Capteur vitesse et tripod
    [8x35CHC.CATPart, D5371.CATPart, SU_11001 (Rear Left Upright).CATPart, SU_A1100 (Rear Left Wheel Assy).CATProduct, WT_03001 (Rear Hub).CATPart, WT_03002 (Rear Brake Bell).CATPart, WT_03004 (Tripod Housing Spacer).CATPart, WT_03005 (Rear Speed Sensor Disc).CATPart]
2018-11-12 placement crash sensor
    [Electrical.CATProduct, chappe_crash sensor.CATPart]
2018-11-12 replacement 95
    [Ergonomics.CATProduct, Gabarit 95pcm.CATPart, pilote.CATProduct]
2018-11-12 Update tube backet
    [15x1.5.CATProduct, Filaire Optimus.CATPart, Shape_445.CATPart, Tubes.CATProduct, Tubulaire Optimus.CATProduct]
2018-11-12 dimensionnement pivot arb avant
    [SU_1400_001 (Barre).CATPart, SU_1400_002 (Chape).CATPart, SU_1400_003 (Pivot).CATPart, SU_1400_004 (Couteau).CATPart, SU_1400_005 (Biellette).CATPart, SU_1500_001 (Barre).CATPart, SU_1500_002 (Chape).CATPart, SU_1500_003 (Pivot).CATPart]
2018-11-12 tube baquet
    [15x1.5.CATProduct, Filaire Optimus.CATPart, Shape_445.CATPart, Tubes.CATProduct, Tubulaire Optimus.CATProduct]
2018-11-12 tube baquet update
    [15x1.5.CATProduct, Filaire Optimus.CATPart, Shape_445.CATPart, Tubes.CATProduct, Tubulaire Optimus.CATProduct]
2018-11-12 mise a jour suspension
    [Chapes_assy.CATProduct, SU_1400_004 (Couteau).CATPart, Suspension.CATProduct]
2018-11-12 Insert sup
    [Upper front bearing support.CATPart]
2018-11-12 Modif chape sup avant pm
    [Front Upright Working Assy.CATProduct, SU_10001 (Front Left Upright).CATPart, SU_10002 (Front Upper Arm Bracket).CATPart, SU_10003 (Front Upper Arm Wedge).CATPart, SU_A1000 (Front Left Wheel Assy).CATProduct, WT_0100_001 (Oz Magnesium Rim).CATPart, WT_0100_002 (Tire Hoosier 13).CATPart]
2018-11-12 Maj admission
    [EN_0300_001_AA_Plenum.CATPart, EN_0300_003_AA_Tubulures.CATPart, EN_0300_006_AB_fixation_chassis_droite.CATPart, EN_0300_007_AB_fixation_chassis_droite.CATPart, EN_0300_008_AB_fixation_chassis_gauche.CATPart, EN_0300_009_AA_raccord_bride_plenum.CATPart, EN_A0300_Air_intake.CATProduct]
2018-11-12 baquet fantôme
    [Gabarit 95pcm.CATPart, Seat_Driver_Assy.CATProduct, pilote.CATProduct]
2018-11-12 Remise en place baquet
    [Seat_Driver_Assy.CATProduct]
2018-11-12 fea pe gauche
    [EN-009 pe gauche.CATPart]
2018-11-12 Mise en place catch can + Suppresion mauvais tube de remplissage
    [EN_0700_001 (Main).CATPart, EN_0700_003 (Couvercle).CATPart, EN_A0600.CATProduct, EN_A0700.CATProduct, Engine & Powertrain.CATProduct]
2018-11-12 Deplacement truc de bob
    [EL_A0400_AF.CATProduct, EL_A06001.CATProduct, Electrical.CATProduct]
2018-11-12 debut dimensionnement couteau av
    [SU_1400_004 (Couteau).CATPart]
2018-11-12 MAJ Optimus + Assemblages
    [Engine & Powertrain.CATProduct, Frame & Body.CATProduct, SU_11002 (Rear Upper Arm Wedge).CATPart, SU_A0200.CATProduct, SU_A1000 (Front Left Wheel Assy).CATProduct, SU_A1100 (Rear Left Wheel Assy).CATProduct, Steering.CATProduct, WT_0100_001 (Oz Magnesium Rim).CATPart]
2018-11-12 ajustement trous jacking bar
    [EN-009 pe droit.CATPart, EN-009 pe gauche.CATPart, Engine & Powertrain.CATProduct]
2018-11-12 Mise a jour maquette TdB, rendus, rangement
    [EL_0400_001_AA.CATPart, EL_0400_001_AA_save1.CATPart, EL_0400_001_AA_save2.CATPart, EL_0400_001_AA_save3.CATPart, EL_0400_001_AB.CATPart, EL_0400_001_AC.CATPart, EL_0400_001_ACerr.CATPart, EL_0400_001_AD.CATPart]
2018-11-12 impression fablab
    [EN_0400_001_AA_bas_guillotine.stl, EN_0400_002_AB_milieu_guillotine.CATPart, EN_0400_004_AB_guillotine.CATPart, arret_guillotine.stl, guillotine.stl, haut_guillotine.stl, milieu_guillotine.stl]
2018-11-12 Update SU - Suspension/12 - Chapes/entretoise_25mm_distance_chapes.CATPart
    [entretoise_25mm_distance_chapes.CATPart]
2018-11-12 Brome la chiasse <3
    [EN-009 pe droit.CATPart, EN-009 pe gauche.CATPart, EN_0902_001.CATPart, EN_A0900.CATProduct, EN_A0902.CATProduct, ISO_7089_10x20_STEEL_GRADE_A_NORMAL_SERIES_PLAIN_WASHER.CATPart, ISO_7089_10x20_STEEL_GRADE_A_NORMAL_SERIES_PLAIN_WASHER_New_57.CATPart]
2018-11-12 Modif assemblage insert tie rod
    [Insert_tie_rod_SA-8E.CATProduct, SA_6_E.CATPart, Suspension_Wireframe.CATProduct, insert_frame_side.CATProduct]
2018-11-12 Points de suspension avant
    [LAS_auto.xls]
2018-11-12 CHASSIS VOLAAAANT
    [Aero.CATProduct, Electrical.CATProduct]
2018-11-12 fea porte excentrique droit
    [EN-009 pe droit.CATPart, EN-009 pe gauche.CATPart]
2018-11-12 Catch can
    [EN_0700_001 (Main).CATPart, EN_0700_002.CATPart, EN_0700_003 (Couvercle).CATPart, Engine & Powertrain.CATProduct]
2018-11-12 mise a jour las
    [Front_Lower_A_Arm_Front_Rod.CATPart, Front_Lower_A_Arm_Rear_Rod.CATPart, Front_Push_Rod.CATPart, Front_Rocker.CATPart, Front_Upper_A_Arm_Front_Rod.CATPart, Front_Upper_A_Arm_Rear_Rod.CATPart, Left_Wireframe_Front_Lower_Arm.CATPart, Left_Wireframe_Front_Upper_Arm.CATPart]
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2018-11-12 correction fea porte excentrique droit
    [EN-009 pe droit.CATPart]
2018-11-12 REPLACEMENT MANIKIN
    [Ergonomics.CATProduct, Gabarit 95pcm.CATPart, Seat_Driver_Assy.CATProduct, pilote.CATProduct]
2018-11-12 Nouveau rendu TdB et ajout contrainte TdB
    [EL_A0400_AF.CATProduct, Electrical.CATProduct]
2018-11-12 Carte Passage de Vitesse et Bill of Material
    Mise a jour de la Carte Passage de Vitesse et Bill of Material (BOM) - liste de composants
    [shield passage vitesse.sch]
2018-11-12 Centrage tubes suspensions % susp
    [15x1.5.CATProduct, Filaire Optimus.CATPart, Shape_573.CATPart, Shape_574.CATPart, Shape_586.CATPart, Shape_587.CATPart, Shape_588.CATPart, Shape_589.CATPart]
2018-11-12 Insert susp avant et arrière
    [SU_A0300.CATProduct, Upper front bearing support.CATPart, Upper rear bearing support.CATPart]
2018-11-12 Susp assy
    [Chapes_assy.CATProduct, Front Upright Working Assy.CATProduct, Lower rear bearing support.CATPart, Rear Upright Working Assy.CATProduct, SU_02001.CATPart, SU_10001 (Front Left Upright).CATPart, SU_10002 (Front Upper Arm Bracket).CATPart, SU_10003 (Front Upper Arm Wedge).CATPart]
2018-11-12 modif pour motion ratio
    [Chapes_assy.CATProduct, SU_1400_005 (Biellette).CATPart, SU_A1000 (Front Left Wheel Assy).CATProduct, SU_A1100 (Rear Left Wheel Assy).CATProduct, SU_A1400.CATProduct, Suspension.CATProduct, Suspension_Wireframe.CATProduct]
2018-11-13 MAJ globale
    [Aero.CATProduct, Engine & Powertrain.CATProduct, Ergonomics.CATProduct, Frame & Body.CATProduct, SU_A1000 (Front Left Wheel Assy).CATProduct, SU_A1100 (Rear Left Wheel Assy).CATProduct, Steering.CATProduct, Suspension.CATProduct]
2018-11-13 Check Motorisation V1.0 attendez la suite
    [EN_0500_001 (main).CATPart, EN_0500_002 (tube).CATPart, EN_0500_003 (SB_plot_M4).CATPart, EN_0500_007(rondelle moyenne M6_1).CATPart, EN_0700_001 (Main).CATPart, EN_0700_002.CATPart, EN_0700_003 (Couvercle).CATPart, EN_0800_06 - Fixing Bar.CATPart]
2018-11-13 MAJ fuel system
    [EN_0500_006 (Chape avant droite final).CATPart, EN_0500_006(chape dessous).CATPart, EN_0500_007 (Chape avant gauche final).CATPart, EN_0500_007(rondelle moyenne M6_1).CATPart, EN_0500_008 (Chape left).CATPart, EN_0500_008(Chape frontal droite).CATPart, EN_0500_009 (Chape frontal gauche).CATPart, EN_0500_010 (M4 nuts).CATPart]
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2018-11-13 VIs + ecrou + rondelle reservoir c'est du propre
    [EN_0500_006 (Chape avant droite final).CATPart, EN_0500_010 (M4 nuts).CATPart, EN_0500_014 (Rondelles M4).CATPart, EN_A05000.CATProduct, Engine & Powertrain.CATProduct]
2018-11-13 Petit modif des familles
    [SU_A0300.CATProduct, bouchon_tube.CATPart]
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2018-11-13 MAJ systeme elec + reservoir + volant
    [EL_0100_001_AA (Regulator).CATPart, EL_0100_001_BA.CATPart, EL_A0300.CATProduct, EL_A0400_AF.CATProduct, EL_A06001.CATProduct, EN_0500_011(chape dessous).CATPart, EN_0500_016 (Fonds).CATPart, EN_A05000.CATProduct]
2018-11-13 Pare feu sa race
    [EL_A0400_AF.CATProduct, EL_A06001.CATProduct, EN_A05000.CATProduct, Electrical.CATProduct, Engine & Powertrain.CATProduct, Ergonomics.CATProduct, FR_A0300.CATProduct, Frame & Body.CATProduct]
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2018-11-13 Ajout chape front suspension
    [front_suspension_bracket.CATPart]
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2018-11-13 Placement vase expansion sur cooling system
    [EN_0800_004 (Expansion Tank).CATPart, EN_A0800_Cooling_System.CATProduct]
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2018-11-13 MAJ chape front suspension
    [front_suspension_bracket.CATPart]
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2018-11-13 MAjJ front suspension chape toujours
    [front_suspension_bracket (pour assemblage).CATPart]
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2018-11-13 Dimensionnement front ARB chape
    [SU_1400_002 (Chape) (pour dimensionnement).CATPart]
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2018-11-13 Ecartement point de push rod côté PM
    [LAS_auto.xls]
2018-11-13 maj powertrain et ech
    [Chape_fixation_chassis.CATPart, EN_0200_0151_AA_partie_fixe.CATPart, EN_0200_0152_AA_partie_mobile.CATPart, EN_0300_001_AA_Plenum.CATPart, EN_0300_006_AB_fixation_chassis_droite.CATPart, EN_0300_007_AA_fixation_chassis.CATPart, EN_0300_007_AB_fixation_chassis_droite.CATPart, EN_0300_008_AB_fixation_chassis_gauche.CATPart]
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2018-11-14 maj ergo chapes baquet et appui-tête (provisoire)
    [Ergonomics.CATProduct, Gabarit 95pcm.CATPart, Head_Restraint.CATPart, Seat_Bracket.CATPart, Seat_Driver_Assy.CATProduct, Steering Wheel carbon.CATProduct, Symmetry of seat bracket - under .CATPart]
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2018-11-14 mise à jour las
    [Chapes_assy.CATProduct, Front Upright Working Assy.CATProduct, Front_Lower_A_Arm_Front_Rod.CATPart, Front_Lower_A_Arm_Rear_Rod.CATPart, Front_Push_Rod.CATPart, Front_Rocker.CATPart, Front_Upper_A_Arm_Front_Rod.CATPart, Front_Upper_A_Arm_Rear_Rod.CATPart]
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2018-11-14 update position chape arrière
    [Rear Upright Working Assy.CATProduct, SU_10002 (Front Upper Arm Bracket).CATPart, SU_11001 (Rear Left Upright).CATPart, SU_11002 (Rear Upper Arm Wedge).CATPart, SU_A1100 (Rear Left Wheel Assy).CATProduct, WT_0100_001 (Oz Magnesium Rim).CATPart, WT_0100_002 (Tire Hoosier 13).CATPart]
2018-11-14 MAJ plan afficheur temp
    [Lien mcp - 7 segements.xlsx, TEMP.BRD, Temp.sch]
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2018-11-14 rod las auto à jour
    [Front_Lower_A_Arm_Front_Rod.CATPart, Front_Lower_A_Arm_Rear_Rod.CATPart, Front_Push_Rod.CATPart, Front_Upper_A_Arm_Front_Rod.CATPart, Front_Upper_A_Arm_Rear_Rod.CATPart, Rear_Lower_A_Arm_Front_Rod.CATPart, Rear_Lower_A_Arm_Rear_Rod.CATPart, Rear_Push_Rod.CATPart]
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2018-11-14 modif point triangle pour collision
    [Chapes_assy.CATProduct, Front Upright Working Assy.CATProduct, Front_Lower_A_Arm_Front_Rod.CATPart, Front_Lower_A_Arm_Rear_Rod.CATPart, Front_Push_Rod.CATPart, Front_Rocker.CATPart, Front_Upper_A_Arm_Front_Rod.CATPart, Front_Upper_A_Arm_Rear_Rod.CATPart]
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2018-11-15 Question rule, augmentation diamètre tubes carrés, ajustement mainhoop
    [15x1.5.CATProduct, 20x1.5.CATProduct, 25x1.5.CATProduct, 30x1.5.CATProduct, 30x2.CATProduct, Filaire Optimus.CATPart, Shape_436.CATPart, Shape_437.CATPart]
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2018-11-15 Revert "Geule de oup"
    This reverts commit 8015faba366efd626705d16fde57b54ee1b95c28.
    [15x1.5.CATProduct, 20x1.5.CATProduct, 25x1.5.CATProduct, 30x1.5.CATProduct, 30x2.CATProduct, Shape_438.CATPart, Shape_440.CATPart, Shape_464.CATPart]
2018-11-15 Revert "Ajout sleeve joint"
    This reverts commit c3baf70bcd6f591b7bc3f854f89639d9dfe6bac1.
    [Filaire Optimus.CATPart, Tubulaire Optimus.CATProduct, sleeve joint up.CATPart, sleeve joint.CATPart]
2018-11-15 Adapt + nouveau règlement
    [15x1.5.CATProduct, 20x1.5.CATProduct, 25x1.5.CATProduct, 30x1.5.CATProduct, 30x2.CATProduct, Filaire Optimus.CATPart, Shape_434.CATPart, Shape_435.CATPart]
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2018-11-15 gueule de loup poche
    [30x2.CATProduct, Filaire Optimus.CATPart, Shape_619.CATPart, Shape_629.CATPart, Tubes.CATProduct, Tubulaire Optimus.CATProduct]
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2018-11-15 assembalge avec sleeve joint
    [Tubulaire Optimus + sleeve joint.CATProduct, sleeve joint.CATPart]
2018-11-15 chapes avant olhins sur assemblage
    [Chapes_assy.CATProduct, Suspension_Wireframe.CATProduct, bracket_triangle_arriere_bas_bras_arriere_1.CATPart, bracket_triangle_arriere_bas_bras_arriere_2.CATPart, bracket_triangle_arriere_bas_bras_avant_1.CATPart, bracket_triangle_arriere_bas_bras_avant_2.CATPart, bracket_triangle_arriere_haut_bras_arriere_1.CATPart, bracket_triangle_arriere_haut_bras_arriere_2.CATPart]
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2018-11-16 Inventaire tubes commande découpe
    [Inventaire tubes châssis.xlsx]
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2018-11-16 Position Volant et maj des points de direction
    [Cardan A.CATPart, Cardan noeud.CATPart, Cardan.CATProduct, LAS_auto.xls, Proshift.CATPart, Steering wheel.CATPart, Steering.CATProduct, Steering_Colum_Assy.CATProduct]
2018-11-16 Ajout chape pour pivot de direction
    [Cardan.CATProduct, Steering wheel.CATPart, Steering.CATProduct, tube_lateral.CATPart, tube_lateral_gauche.CATPart, tube_longi.CATPart]
2018-11-17 maj pm avant avec direction
    [Front Upright Working Assy.CATProduct, SU_10001 (Front Left Upright).CATPart, SU_10002 (Front Upper Arm Bracket).CATPart, SU_10003 (Front Upper Arm Wedge).CATPart, SU_A1000 (Front Left Wheel Assy).CATProduct]
2018-11-17 nv support TdB et nv carte 3x7seg
    [EL_0400_001_AC.CATPart, EL_0400_001_BC.CATPart, EL_0402_002_BA.CATPart, EL_0402_003_BA.CATPart, EL_A0402_BA.CATProduct]
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2018-11-18 Mise à jour tubes collecteur
    [EN_0200_002_AB.CATPart, EN_0200_003_AB.CATPart, EN_0200_004_AB.CATPart, EN_0200_005_AB.CATPart, EN_0200_006_AB.CATPart, EN_0200_007_AB.CATPart, EN_0200_008_AB.CATPart, EN_0200_009_AB.CATPart]
2018-11-18 Maj insert susp sup
    [SU_A01001.CATProduct, SU_A0300.CATProduct, Upper front bearing support.CATPart, Upper rear bearing support.CATPart]
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2018-11-18 changement de côté de l'élec et ajout des chappes de masse
    [EL_A06001.CATProduct, Electrical.CATProduct]
2018-11-18 Correction erreur symmétrie LAS
    [Chapes_assy.CATProduct, Insert_tie_rod_SA-8E.CATProduct, Lower rear bearing support.CATPart, SU_02001.CATPart, SU_11002 (Rear Upper Arm Wedge).CATPart, SU_A01001.CATProduct, SU_A0200.CATProduct, SU_A0300.CATProduct]
2018-11-18 Correction bug
    [Chapes_assy.CATProduct, Insert_tie_rod_SA-8E.CATProduct, SU_A1000 (Front Left Wheel Assy).CATProduct, SU_A1100 (Rear Left Wheel Assy).CATProduct, Suspension.CATProduct, Suspension_Wireframe.CATProduct]
2018-11-19 Déchibrage et chibrage arrirère
    [Chapes_assy.CATProduct, Insert_tie_rod_SA-8E.CATProduct, Suspension.CATProduct, Symmetry of GE 6 E-GE 6 E_3.CATProduct, Symmetry of SU_A1100 (Rear Left Wheel Assy).CATProduct, Symmetry of upper_rear_bearing_support.CATProduct]
2018-11-19 changement d'adresse afficheur temp
    [TEMP.BRD, Temp.sch]
2018-11-19 Askip il faut des freins
    [PISTE-193-ar.CATPart, SU_11001 (Rear Left Upright).CATPart, SU_A1100 (Rear Left Wheel Assy).CATProduct, WT_0100_001 (Oz Magnesium Rim).CATPart, WT_0100_002 (Tire Hoosier 13).CATPart]
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2018-11-19 Frein positionné comme ça ?
    [SU_11001 (Rear Left Upright).CATPart, SU_A1100 (Rear Left Wheel Assy).CATProduct, WT_0100_001 (Oz Magnesium Rim).CATPart, WT_0100_002 (Tire Hoosier 13).CATPart, WT_03001 (Rear Hub).CATPart]
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2018-11-19 Affichage des connecteurs de la carte temp
    [EL_0402_003_BA.CATPart, EL_A0402_BA.CATProduct]
2018-11-19 MISE A JOUR las pour basculeur arriere
    [Chapes_assy.CATProduct, Front Upright Working Assy.CATProduct, Front_Lower_A_Arm_Front_Rod.CATPart, Front_Lower_A_Arm_Rear_Rod.CATPart, Front_Push_Rod.CATPart, Front_Rocker.CATPart, Front_Upper_A_Arm_Front_Rod.CATPart, Front_Upper_A_Arm_Rear_Rod.CATPart]
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2018-11-20 Préparation nouveau éléments finis avant
    [Front Upright Working Assy.CATProduct, SU_10001 (Front Left Upright).CATPart, SU_10002 (Front Upper Arm Bracket).CATPart, SU_10003 (Front Upper Arm Wedge).CATPart, SU_A1000 (Front Left Wheel Assy).CATProduct, assemblage test.CATProduct]
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2018-11-20 Revert "pos"
    This reverts commit ac9a4cac327d51dfe63652c8d7f577a86942f4eb.
    [Engine & Powertrain.CATProduct]
2018-11-20 deplacement affich Temp TdB
    [EL_0400_001_CC.CATPart, EL_A0400_BA.CATProduct, EL_A0402_BA.CATProduct, Electrical.CATProduct]
2018-11-20 insert dans suspension pour test collision
    [Chapes_assy.CATProduct, Insert_tie_rod_SA-8E.CATProduct, SA_6_E.CATPart, SU_11002 (Rear Upper Arm Wedge).CATPart, SU_A1000 (Front Left Wheel Assy).CATProduct, SU_A1100 (Rear Left Wheel Assy).CATProduct, Suspension.CATProduct, Suspension_Wireframe.CATProduct]
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2018-11-20 Préparation symétrie moitié tubes pour gueules de loup
    [Filaire Optimus.CATPart, Symmetry of 15x1.5.CATProduct, Symmetry of 20x1.5.CATProduct, Symmetry of 25x1.5.CATProduct, Symmetry of 30x1.5.CATProduct, Symmetry of Shape_438.CATPart, Symmetry of Shape_440.CATPart, Symmetry of Shape_441.CATPart]
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2018-11-20 mise a jour pour collision tube et push rod/arb rod
    [Chapes_assy.CATProduct, Front Upright Working Assy.CATProduct, Front_Lower_A_Arm_Front_Rod.CATPart, Front_Lower_A_Arm_Rear_Rod.CATPart, Front_Push_Rod.CATPart, Front_Rocker.CATPart, Front_Upper_A_Arm_Front_Rod.CATPart, Front_Upper_A_Arm_Rear_Rod.CATPart]
2018-11-20 modif cas de charge porte excentriques
    [EN-009 pe droit.CATPart, EN-009 pe gauche.CATPart]
2018-11-20 éléments finis commande d'embrayage
    [FR_0500_001_DA.CATPart, FR_0500_002_DA.CATPart, FR_0500_003_DA.CATPart, FR_0500_004_DA.CATPart, FR_A0500.CATProduct]
2018-11-20 modif chapes avant pour tube 20
    [Chapes_assy.CATProduct, Filaire Optimus.CATPart, Insert_tie_rod_SA-8E.CATProduct, SU_A1000 (Front Left Wheel Assy).CATProduct, SU_A1100 (Rear Left Wheel Assy).CATProduct, Suspension.CATProduct, Suspension_Wireframe.CATProduct, Symmetry of SU_A1100 (Rear Left Wheel Assy).CATProduct]
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2018-11-20 nettoyage des plans du TdB
    [EL_0400_001_CC.CATPart, EL_0400_002_AA.CATPart, EL_0400_006_AA.CATPart, EL_0401_001_AA.CATPart, EL_0401_002_AA.CATPart, EL_0401_003_AA.CATPart, EL_0402_001_AA.CATPart, EL_0402_003_BA.CATPart]
2018-11-21 replacement 95 en position
    [Ergonomics.CATProduct, Gabarit 95pcm.CATPart, Seat_Driver_Assy.CATProduct, pilote.CATProduct]
2018-11-21 position pilote dans nouveau baquet
    [Ergonomics.CATProduct, Gabarit 95pcm.CATPart, Seat_Driver_Assy.CATProduct, pilote.CATProduct]
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2018-11-21 basculeur avant / couteaux arrières
    [SU_1500_04 (Couteau).CATPart, SU_A0600_001 (Rocker).CATPart, SU_A0800_001 (Rocker).CATPart]
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2018-11-21 test ajout chappe, angle Tdb, liste composants à commander
    [EL_A0400_BA.CATProduct, Electrical.CATProduct, chappe_tdb_1_v1.CATPart]
2018-11-21 ajout trous chappes, aggrandissment des trous de 0.2mm
    [EL_0400_001_CC.CATPart, EL_0400_007_AA.CATPart, EL_A0400_BA.CATProduct]
2018-11-21 EF Upper rear bearing support
    [GE_6_E.CATProduct, GE_6_E_dummy.CATPart, GE_6_E_ir.CATPart, GE_6_E_or.CATPart, SU_0100_006.CATPart, SU_A0300.CATProduct, Upper rear bearing support.CATPart, Wireframe_Rear_Upper_Arm.CATPart]
2018-11-21 ajout steering à electrical
    [EL_A0400_BA.CATProduct, Electrical.CATProduct]
2018-11-21 Remise à l'endroit de l'échappement
    [EN_0200_001_AA.CATPart, EN_0200_002_AA.CATPart, EN_0200_003_AA.CATPart, EN_0200_004_AA.CATPart, EN_0200_005_AA.CATPart, EN_0200_006_AA.CATPart, EN_0200_007_AA.CATPart, EN_0200_008_AA.CATPart]
2018-11-21 MàJ rear suspension bracket
    [rear_braket_suspension.CATPart]
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2018-11-21 Placement + optimal gabarit
    epaules à 12,5mm (mousses)
    [Ergonomics.CATProduct, Gabarit 95pcm.CATPart, Seat_Driver_Assy.CATProduct]
2018-11-21 Génération de fichiers de production
    [15x1.5.CATProduct, 20x1.5.CATProduct, 25x1.5.CATProduct, 30x1.5.CATProduct, 30x2.CATProduct, Filaire Optimus _ prod.CATPart, Filaire Optimus.CATPart, Shape_429.CATPart]
2018-11-21 Modif moyeu arrière pour frette beringer
    [PISTE-193-ar.CATPart, SU_10004 (Front Speed Sensor Bracket).CATPart, SU_11003 (Rear Speed Sensor Bracket).CATPart, SU_A1100 (Rear Left Wheel Assy).CATProduct, Speed Sensor.CATPart, WT_03001 (Rear Hub).CATPart, WT_03004 (Tripod Housing Spacer).CATPart]
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2018-11-22 Question rules pour SES et chassis
    [SES_FSG_2018.xlsm]
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2018-11-22 modif basculeur pour pivot
    [SU_A0600_001 (Rocker).CATPart]
2018-11-22 Maj point susp arrirère
    [LAS_auto.xls]
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2018-11-22 ajout chape pivot susp
    [Chapes_assy.CATProduct, Insert_tie_rod_SA-8E.CATProduct, SU_11002 (Rear Upper Arm Wedge).CATPart, SU_A0300.CATProduct, SU_A1000 (Front Left Wheel Assy).CATProduct, SU_A1100 (Rear Left Wheel Assy).CATProduct, Suspension.CATProduct, Suspension_Wireframe.CATProduct]
2018-11-22 MàJ rear susp bracket
    [rear_suspension_bracket.CATPart]
2018-11-22 plus de problème à l'arrière / nouveau basculeur pour safadinho
    [Chapes_assy.CATProduct, Front Upright Working Assy.CATProduct, Front_Lower_A_Arm_Front_Rod.CATPart, Front_Lower_A_Arm_Rear_Rod.CATPart, Front_Push_Rod.CATPart, Front_Rocker.CATPart, Front_Upper_A_Arm_Front_Rod.CATPart, Front_Upper_A_Arm_Rear_Rod.CATPart]
2018-11-22 MAJ reservoir et engine
    [EN_A05000(sym).CATProduct, Engine & Powertrain.CATProduct]
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2018-11-22 Update filaire et tubulaire cf question rule answer_2 side impact structure
    [15x1.5.CATProduct, 25x1.5.CATProduct, 30x1.5.CATProduct, Filaire Optimus.CATPart, Shape_637.CATPart, Shape_638.CATPart, Shape_678.CATPart, Shape_679.CATPart]
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2018-11-22 Mousse ergo Yohan fait ton boulot
    [Ergonomics.CATProduct, MS_0500_002 (Mousse Epaules).CATPart, MS_0500_003 (Mousse Longue).CATPart]
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2018-11-22 dimensionnement chape arrière pour pivot
    [chape_rear_susp.CATPart]
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2018-11-22 Correction collision suspension
    [LAS_auto.xls]
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2018-11-22 mise à jour las pour la chiasse
    [Chapes_assy.CATProduct, Front Upright Working Assy.CATProduct, Front_Lower_A_Arm_Front_Rod.CATPart, Front_Lower_A_Arm_Rear_Rod.CATPart, Front_Push_Rod.CATPart, Front_Rocker.CATPart, Front_Upper_A_Arm_Front_Rod.CATPart, Front_Upper_A_Arm_Rear_Rod.CATPart]
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2018-11-23 Correction points de suspension
    [LAS_auto.xls]
2018-11-23 mise a jour numéro 532 pour chiasse
    [Front_Lower_A_Arm_Front_Rod.CATPart, Front_Lower_A_Arm_Rear_Rod.CATPart, Front_Push_Rod.CATPart, Front_Rocker.CATPart, Front_Upper_A_Arm_Front_Rod.CATPart, Front_Upper_A_Arm_Rear_Rod.CATPart, Left_Wireframe_Front_Lower_Arm.CATPart, Left_Wireframe_Front_Upper_Arm.CATPart]
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2018-11-23 Mises en forme chainshield
    [EN_0902_003.CATPart, EN_A0902.CATProduct, Engine & Powertrain.CATProduct, chaine.CATPart]
2018-11-23 tubulaire et filaire production only
    [Filaire Optimus _ hoops.CATPart, Filaire Optimus _ prod.CATPart, Mainhoop.CATPart, Produit1.CATProduct, Produit2.CATProduct, Produit3.CATProduct, Produit4.CATProduct, Produit5.CATProduct]
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2018-11-23 Gueules de loup coupes bissectrices
    [Produit1.CATProduct, Produit3.CATProduct, Produit4.CATProduct, Produit5.CATProduct, Shape_710.CATPart, Shape_711.CATPart, Shape_713.CATPart, Shape_714.CATPart]
2018-11-23 filaire avancée bas hoops cintrage
    [Filaire Optimus _ prod.CATPart]
2018-11-23 Filaire pour hoops cintrage
    [Filaire Optimus _ hoops.CATPart]
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2018-11-23 Gueule de loup bulkhead
    [Shape_712.CATPart, Tubulaire_Optimus_Prod.CATProduct]
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2018-11-23 Mise à jour point suspension
    [LAS_auto.xls]
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2018-11-23 Chape rocker frame arrière
    [chape_rear_susp.CATPart]
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2018-11-24 Once it was ***
    [Back Seat bracket.CATPart, Ergonomics.CATProduct, Gabarit 95pcm.CATPart, Harnais test.CATPart, Seat_Driver_Assy.CATProduct, Symmetry of Back Seat bracket.CATPart, pilote.CATProduct]
2018-11-24 Revert "Once it was ***"
    This reverts commit 0ffa6072c2a3d6ade760d1b88c84a6c776518268.
    [Back Seat bracket.CATPart, Ergonomics.CATProduct, Gabarit 95pcm.CATPart, Harnais test.CATPart, Seat_Driver_Assy.CATProduct, Symmetry of Back Seat bracket.CATPart, pilote.CATProduct]
2018-11-24 ça approche du packaging final à l'arrière
    [8x25CHC.CATPart, 8x35CHC.CATPart, Rear Upright Working Assy.CATProduct, SU_11001 (Rear Left Upright).CATPart, SU_A1100 (Rear Left Wheel Assy).CATProduct, WT_0100_001 (Oz Magnesium Rim).CATPart, WT_0100_002 (Tire Hoosier 13).CATPart, WT_03001 (Rear Hub).CATPart]
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2018-11-24 Gueule de Loup Shape 786 à 790
    [Shape_786.CATPart, Shape_787.CATPart, Shape_788.CATPart]
2018-11-24 vis pour basculeur / rod
    [Entretoise Basculeur Rod.CATPart, Entretoise olhins basculeur.CATPart, Vis pour basculeur_rod.CATProduct]
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2018-11-24 MàJ rear susp bracket encore
    [rear_braket_suspension - Copie.CATPart, rear_suspension_bracket.CATPart]
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2018-11-24 MAJ Optimus + PB elec résolu
    [Aero.CATProduct, EL_0100_001_BA.CATPart, EL_A0400_BA.CATProduct, EL_A06001.CATProduct, Electrical.CATProduct]
2018-11-24 Correctif ergo + elec + maj optimus
    [Electrical.CATProduct, pilote.CATProduct]
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2018-11-24 correction floor pan + intégration Frame
    [FR_0400_001.CATProduct, Frame & Body.CATProduct]
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2018-11-24 les chappes du TdB
    [EL_0400_001_BC.CATPart, EL_0400_001_BG.CATPart, EL_0400_001_CA.CATPart, EL_0400_001_CB.CATPart, EL_0400_001_CC.CATPart, EL_A0400_AF.CATProduct, EL_A0400_BA.CATProduct, EL_A0402_BA.CATProduct]
2018-11-24 Revert "Correctif ergo + elec + maj optimus"
    This reverts commit c3e74adfe97a52867882f1936a780075c208fd49.
    [Electrical.CATProduct, pilote.CATProduct]
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2018-11-25 Nouveau support TdB et soutient afficheurs
    [EL_0400_001_DA.CATPart, EL_0400_009_AA.CATPart, EL_A0400_BA.CATProduct, EL_A0402_BA.CATProduct]
2018-11-25 Modif diam ext tubes
    [LAS_auto.xls]
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2018-11-25 1mm fond plat+matériau alu
    [FR_0400_001.CATProduct, Plaque1.CATPart, Plaque2.CATPart, Plaque3.CATPart, test.CATPart, test2.CATPart]
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2018-11-25 création rod arb avant
    [SA_6_E.CATPart, SI_6 _E.CATPart, SU_1400_005 (biellette).CATProduct, Suspension.CATProduct]
2018-11-25 Premier visuel pare feu Atomix like
    [MS_0100_003_AA.CATPart]
2018-11-25 Controle pare feu et fond plat
    [Frame & Body.CATProduct, MS_A0100 (Firewall assy).CATProduct, pilote.CATProduct]
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2018-11-26 ajout BSPD et capteurs suspension
    [BSPD.brd, BSPD.sch, FSG_2019_BSPD_0.2.brd, FSG_2019_BSPD_0.2.sch, RSL 75.CATProduct, RSL 75mm.CATPart, RSl 75mm 2.CATPart, exemple.sch]
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2018-11-26 Modif point suspension avant
    [LAS_auto.xls]
2018-11-26 modif commande et connecteurs
    [Cablage Optimus.xlsx, Commandes.xlsx, FSG_2019_BSPD_0.2_SMD.brd, FSG_2019_BSPD_0.2_SMD.sch, FSG_2019_BSPD_0.2_traversant.sch]
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2018-11-26 ajout coussinet / ajustement contraintes
    [PCMF_121417_E.CATPart, SU_1400_001 (Barre).CATPart, SU_1400_003 (Pivot).CATPart, SU_1400_004 (Couteau).CATPart, SU_1500_001 (Barre).CATPart, SU_1500_003 (Pivot).CATPart, SU_1500_04 (Couteau).CATPart, SU_A1400.CATProduct]
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2018-11-26 ajout basculeur sur la maquette (manque les symétries)
    [Chapes_assy.CATProduct, Front Upright Working Assy.CATProduct, Front_Rocker.CATPart, Insert_tie_rod_SA-8E.CATProduct, Lower rear bearing support.CATPart, Rear Upright Working Assy.CATProduct, Rear_Rocker.CATPart, SU_02001.CATPart]
2018-11-26 modif arrière pour freinage
    [Rear Upright FEA Assy.CATProduct]
2018-11-26 3 Gueule de loup
    [Shape_770.CATPart, Shape_776.CATPart, Shape_781.CATPart]
2018-11-26 Cintrage hoops mise en plan
    [Filaire Optimus _ hoops.CATPart, Fronthoop.CATProduct, Hoops_tubulaire.CATProduct, Main_hoop.CATProduct, Mainhoop.CATPart, Mainhoop.CATProduct, Shape_683.CATPart, Shape_684.CATPart]
2018-11-27 ça fait du sale
    [Rear Upright FEA Assy.CATProduct]
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2018-11-27 fin gdl de toute la cellule avant ! :)
    [Produit1.CATProduct, Produit4.CATProduct, Produit6.CATProduct, Shape_721.CATPart, Shape_727.CATPart, Shape_742.CATPart, Shape_780.CATPart, Shape_781.CATPart]
2018-11-27 gdl milieu chassis done
    [Produit1.CATProduct, Produit3.CATProduct, Shape_715.CATPart, Shape_716.CATPart, Shape_719.CATPart, Shape_743.CATPart, Shape_744.CATPart, Shape_745.CATPart]
2018-11-27 Fuel tank et system Batiste
    [EN_0500_001 (main)(sym).CATPart, EN_0500_001 (main).CATPart, EN_0500_002 (tube)(sym).CATPart, EN_0500_002 (tube).CATPart, EN_0500_002(Tube).CATPart, EN_0500_005 (Fonds)(sym).CATPart, EN_0500_005 (Fonds).CATPart, EN_0500_005(entretoise_reservoir).CATPart]
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2018-11-27 mise en place basculeur
    [Chapes_assy.CATProduct, Front_Rocker.CATPart, Insert_tie_rod_SA-8E.CATProduct, Rear_Rocker.CATPart, SU_A1000 (Front Left Wheel Assy).CATProduct, SU_A1100 (Rear Left Wheel Assy).CATProduct, Suspension.CATProduct, Suspension_Wireframe.CATProduct]
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2018-11-27 FIN DES GUEULES DE LOUP SA MERE
    [Produit1.CATProduct, Produit4.CATProduct, Produit5.CATProduct, Produit6.CATProduct, Shape_705.CATPart, Shape_707.CATPart, Shape_731.CATPart, Shape_733.CATPart]
2018-11-27 position chaine et chainshield
    [EN_0902_003.CATPart, EN_A0900.CATProduct, EN_A0902.CATProduct, Engine & Powertrain.CATProduct, chaine.CATPart]
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2018-11-27 tube side impact just in case
    [Filaire Optimus _ prod.CATPart, Produit1.CATProduct, Produit3.CATProduct, Produit4.CATProduct, Shape_844.CATPart, Symmetry of Shape_844.CATPart, Tubulaire_Optimus_Prod.CATProduct]
2018-11-27 Porte Couronne usinage Centrale
    [porte_couronne.CATPart]
2018-11-27 Ajout cache crémaillère et déchibrage
    [Bracket_Assy.CATProduct, Cardan.CATProduct, Emile_Maurin_23201B_V_CHC_4x16___ZN_cl_8_8___EN_ISO_4762_DIN_912.catpart, Ergonomics.CATProduct, Frame & Body.CATProduct, Gabarit 95pcm.CATPart, LAS_auto.xls, ST0700_bracket.CATPart]
2018-11-27 Correction TdB
    [Bouton poussoir Raz motored.CATPart, Bouton poussoir demarrage.CATPart, Bouton poussoir.CATPart, EL_0400_001_AA.CATPart, EL_0400_001_AA_save1.CATPart, EL_0400_001_AA_save2.CATPart, EL_0400_001_AA_save3.CATPart, EL_0400_001_AB.CATPart]
2018-11-27 porte couronne en vrai
    [porte_couronne.CATPart]
2018-11-27 problemes en local regles
    [EN_A05000(sym).CATProduct, EN_A0800_Cooling_System.CATProduct, Engine & Powertrain.CATProduct]
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2018-11-28 biellette rear arb & visserie pour
    [6x35CHC.CATPart, 6x45CHC.CATPart, 8x45CHC.CATPart, Entretoise ARB rod.CATPart, SU_1500_006 (Tube Alu).CATPart, SU_1500_007 (Biellette).CATProduct, Vis pour couteaux ARB.CATProduct, ecrou_M8_NS.CATPart]
2018-11-28 trous jacking bar pe gauche
    [EN-009 pe gauche.CATPart, EN_A0900.CATProduct]
2018-11-28 ajout visserie sur olhins & visserie pour pivot arb
    [6x30CHC.CATPart, Chapes_assy.CATProduct, Insert_tie_rod_SA-8E.CATProduct, SU_A1000 (Front Left Wheel Assy).CATProduct, SU_A1100 (Rear Left Wheel Assy).CATProduct, Suspension.CATProduct, Suspension_Wireframe.CATProduct, Symmetry of 8x45CHC.CATPart]
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2018-11-28 trous pe jacking bar
    [EN-009 pe droit.CATPart, EN-009 pe gauche.CATPart]
2018-11-28 Chappe switch elec v2.0
    [chappes switch 40mm v2.CATPart]
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2018-11-28 Ajout chappes de la prise Anderson
    [Chappes Anderson.CATPart, EL_0100_008_AA (Anderson connector).CATPart, Electrical.CATProduct]
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2018-11-28 Tube harnais last modif
    [15x1.5.CATProduct, 20x1.5.CATProduct, 25x1.5.CATProduct, 30x1.5.CATProduct, 30x2.CATProduct, Filaire Optimus.CATPart, Shape_436.CATPart, Shape_437.CATPart]
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2018-11-29 fuck les noob du git
    [FR_0500_002_DA.CATPart, FR_0500_006_DB.CATPart, FR_A0500.CATProduct]
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2018-11-29 Mise en plan embrayage
    [FR_0500_003_DA.CATPart, FR_0500_008_DA.CATPart, FR_0500_1_AB.CATPart, FR_0500_1_BB.CATPart, FR_0500_1_CA.CATPart, FR_0500_2_AB.CATPart, FR_0500_2_BB.CATPart, FR_0500_2_CA.CATPart]
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2018-11-29 pivot pour test rotule au lieu de coussinet
    [SU_1400_003 (Pivot) pour test si collision.CATPart]
2018-12-01 nouvelle chape avant / reste à mettre sur la maquette
    [Chapes_assy.CATProduct, bracket_front_rocker_arriere.CATPart, bracket_front_rocker_avant.CATPart, bracket_front_suspension_ohlins.CATPart, bracket_triangle_arriere_bas_bras_arriere_1.CATPart, bracket_triangle_arriere_bas_bras_arriere_2.CATPart, bracket_triangle_arriere_bas_bras_avant_1.CATPart, bracket_triangle_arriere_bas_bras_avant_2.CATPart]
2018-12-01 modif entretroise pivot rocker
    [Entretoise pivot basculeur.CATPart]
2018-12-01 Tubes 30*2 et 30*1.5 en step
    [1.stp, 101.stp, 102.stp, 103.stp, 112.stp, 2.stp, 23.stp, 24.stp]
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2018-12-01 Tous les tubes en step sa mere
    [10.stp, 104.stp, 105.stp, 106.stp, 107.stp, 108.stp, 109.stp, 11.stp]
2018-12-02 Update Upper front bearing support.CATPart
    [Upper front bearing support.CATPart]
2018-12-02 légère modifs à terminer
    [TEMP.BRD, Temp.sch, rapport.brd, shield carte avant.brd, shield carte avant.sch]
2018-12-02 fin des carte tdb
    [TEMP.BRD, Temp.sch, rapport.brd, rapport.sch]
2018-12-02 Equerre arrière / remise en question de sa conception
    [Chapes_assy.CATProduct, Insert_tie_rod_SA-8E.CATProduct, SU_1500_002 (Chape).CATPart, SU_1500_002(chape).CATPart, SU_A0600.CATProduct, SU_A0800.CATProduct, SU_A1000 (Front Left Wheel Assy).CATProduct, SU_A1100 (Rear Left Wheel Assy).CATProduct]
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2018-12-03 modif pivot / ajout rotule / ca passe juste juste sur susp assy
    [Chapes_assy.CATProduct, Entretoise Basculeur Rod.CATPart, GE_12_C.CATProduct, Insert_tie_rod_SA-8E.CATProduct, SU_1400_003 (Pivot droit).CATPart, SU_1400_003 (Pivot) pour test si collision.CATPart, SU_1400_004 (Couteau).CATPart, SU_A1000 (Front Left Wheel Assy).CATProduct]
2018-12-03 modif pivot a l'arriere avec ajout rotule
    [Chapes_assy.CATProduct, Insert_tie_rod_SA-8E.CATProduct, SU_1500_002(chape).CATPart, SU_1500_04 (Couteau).CATPart, SU_A1000 (Front Left Wheel Assy).CATProduct, SU_A1100 (Rear Left Wheel Assy).CATProduct, SU_A1500.CATProduct, Suspension.CATProduct]
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2018-12-03 oubli Modif diamètre un tube cellule avant
    [15x1.5.CATProduct, 25x1.5.CATProduct, Shape_584.CATPart, Shape_585.CATPart, Tubes.CATProduct, Tubulaire Optimus.CATProduct]
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2018-12-04 EF Chape switch elec
    [chappes switch 40mm v2.CATPart]
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2018-12-04 Chape de fixation moteur
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2018-12-04 mAj du shield avant
    [Commandes.xlsx, shield carte avant.brd, shield carte avant.sch]
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2018-12-04 Ajout nouvelle front ARB chape
    [SU_1400_002 (Chape) dernère version.CATPart]
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2018-12-04 update TdB Temp et rangement
    [EL_0400_001_CC1.CATPart, EL_0400_001_DA.CATPart, EL_0402_002_AA.CATPart, EL_0402_002_BA.CATPart, EL_0402_003_AA.CATPart, EL_A0400_BA.CATProduct, EL_A0402_AA.CATProduct, EL_A0402_BA.CATProduct]
2018-12-05 Revert "Contraintes jacking bar"
    This reverts commit bb7805021ec0ecd526a2e121c612ae292e2d2368.
    [EN_0100_002_AA.CATPart, EN_0905.CATProduct, EN_A0900.CATProduct, EN_A0901 (Differential assembly).CATProduct, EN_A0902.CATProduct, Engine & Powertrain.CATProduct]
2018-12-05 premier version gantt motorisation
    [Gantt-Département-Motorisation-Optimus-v1.5.xls, Gantt-Motorisation-modélisation-v0.1.xls]
2018-12-05 Ajout BOM affficheur rapport
    [rapport_BOM.xlsx]
2018-12-05 ajout equerre BAR avant / reste des modifs a faire
    [Chapes_assy.CATProduct, Insert_tie_rod_SA-8E.CATProduct, SU_1400_002 (Chape) (pour dimensionnement).CATPart, SU_1400_002 (Chape) dernère version.CATPart, SU_1400_002 (Chape).CATPart, SU_1400_002(chape).CATPart, SU_1400_003 (Pivot).CATPart, SU_A1000 (Front Left Wheel Assy).CATProduct]
2018-12-05 MODIF manchon / a faire : allonger tube
    [chape_rear_susp.CATPart]
2018-12-05 allonge tube suspesion arriere
    [15x1.5.CATProduct, 20x1.5.CATProduct, Filaire Optimus.CATPart, Shape_573.CATPart, Shape_574.CATPart, Shape_600.CATPart, Shape_601.CATPart, Shape_640.CATPart]
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2018-12-05 Pareil sur fichiers prods et MAJ fichier step
    [121.stp, Filaire Optimus _ prod.CATPart, Produit1.CATProduct, Produit5.CATProduct, Produit6.CATProduct, Shape_765.CATPart, Shape_773.CATPart, Shape_774.CATPart]
2018-12-05 modif chape et biellette rear arb
    [Chapes_assy.CATProduct, Insert_tie_rod_SA-8E.CATProduct, SU_A1000 (Front Left Wheel Assy).CATProduct, SU_A1100 (Rear Left Wheel Assy).CATProduct, Suspension.CATProduct, Suspension_Wireframe.CATProduct, Symmetry of chape_rear_susp.CATPart, bracket_front_rocker_arriere.CATPart]
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2018-12-05 Mise à jour support batterie
    [EL_0300_001_BA.CATPart, EL_A0200.CATProduct, EL_A0200_001_AA.CATPart, EL_A0200_002_AA.CATPart, EL_A0200_003_AA.CATPart, EL_A0300.CATProduct, EL_A0300_001_AA (battery support).CATPart, EL_A0300_002_AA (battery).CATPart]
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2018-12-05 MAJ engine + MEP chape engine
    [Chape_fixation_chassis.CATPart, EN_0600.CATProduct, EN_0600_013 (chape tube remplissage).CATPart, EN_1200_018 (Chape frame).CATPart, EN_A0100 (Engine Assy).CATProduct, EN_A0250.CATProduct, EN_A0300_Air_intake.CATProduct, EN_A0400_Throttle_mecanism.CATProduct]
2018-12-05 MEP chapes avant
    nomenclature chapes
    [SU_0500_001 (bracket front rocker avant).CATPart, SU_0500_002 (bracket front rocker arriere).CATPart]
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2018-12-05 Ajout chapes standards 4mm
    [chape_standard_1.igs, chape_standard_2.igs]
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2018-12-06 Gantt elec phase remontante
    [Gantt-Département-Elec-remontant.xls]
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2018-12-06 recup taf clement 2
    [EN_0400_001_AA_bas_guillotine.CATPart, EN_0400_002_AB_milieu_guillotine.CATPart, EN_0400_003_AA_arret_guillotine.CATPart, EN_0400_004_BA_guillotine.CATPart, EN_0400_005_AA_haut_guillotine.CATPart, EN_0400_007_AA_convergeant.CATPart, EN_0400_008_AA_filtre_a_air.CATPart, EN_0400_010_AA_bride.CATPart]
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2018-12-06 maj chape fuel tank
    [EN_A05000(sym).CATProduct]
2018-12-06 maj chape fuel pump
    [EN_0600.CATProduct, EN_A0600.CATProduct, Engine & Powertrain.CATProduct]
2018-12-06 Re FEA + capteur vitesse + cale carrossage
    [Rear Upright FEA Assy.CATProduct, SU_10001 (Front Left Upright).CATPart, SU_10003 (Front Upper Arm Wedge base).CATPart, SU_10004 (Front Upper Arm Wedge Shim).CATPart, SU_10005 (Speed_sensor_washer).CATPart, SU_11001 (Rear Left Upright).CATPart, SU_11002 (Rear Upper Arm Wedge).CATPart, SU_A1000 (Front Left Wheel Assy).CATProduct]
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2018-12-06 maj mep air intake
    [Chape_fixation_chassis.igs]
2018-12-06 Rennomage et capteur vitesse v2
    [Rear Upright FEA Assy.CATProduct, Rear Upright Working Assy.CATProduct, SU_10002 (Front Upper Arm Bracket).CATPart, SU_10002 (Upper Arm Bracket).CATPart, SU_10003 (Front Upper Arm Wedge base).CATPart, SU_10003 (Front Upper Arm Wedge).CATPart, SU_10003 (Upper Arm Wedge Shim 1mm).CATPart, SU_10003 (Upper Arm Wedge Shim 2mm).CATPart]
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2018-12-06 MEP chape fixation harnais corrigé
    [Chape Harnais Submarine.CATPart]
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2018-12-06 MAJ clutch actuation system
    [FR_0500_002_DA.CATPart, FR_0500_003_DA.CATPart, FR_A0500.CATProduct, Frame & Body.CATProduct]
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2018-12-06 MEP chape motored corrigé
    [EN_1200_009 (Chape motored avant).igs, EN_1200_010 (Chape motored arriere).igs]
2018-12-06 corrections MEP EL
    [EL_0700_002(chapes powerbox).igs, EL_0700_003(chape1 tdb).igs, EL_0700_004(chape2 tdb).igs, EL_0700_005(chape3 tdb).igs, EL_0700_006(chape4 tdb).igs, EL_0700_007(chape5 tdb).igs, EL_0700_008(chape6 tdb).igs, bracket_power_distribution.CATPart]
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2018-12-07 ajustement jacking bar et chapes
    [EN_0905.CATProduct, EN_0905_04_AA.CATPart, EN_A0900.CATProduct, Engine & Powertrain.CATProduct]
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2018-12-08 Mise en forme nomenclature Optimus
    [EL_A0200.CATProduct, EL_A0300.CATProduct, EL_A0300_001_AA.CATPart, EL_A0300_002_AA.CATPart, EL_A0300_003_AA.CATPart]
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2018-12-09 MEP Manchon de direction
    [ST_0600_002 (Manchon de direction).igs]
2018-12-09 Correction manchon de direction
    [ST_0600_002 (Manchon de direction).igs]
2018-12-09 MEP Cales de carrossage 1mm et basculeurs avant correction
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2018-12-09 MEP Pivot de direction
    [ST_0600_001 (Pivot de direction).igs]
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2018-12-09 Chapes moteur et harnais en 4mm. Manque plus que Reedom
    [EN_0100_004_AA (Chapes moteur).igs, FR_0900_001 (Chapes harnais).igs]
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2018-12-09 Validation MEP chape admission
    [Chape_fixation_chassis.igs]
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2018-12-09 MEP entretoise capteur vitesse
    [SU_10004 (Speed_sensor_washer).igs]
2018-12-09 MEP EL_0100_003 EL_0100_003 chappes break light
    Mise en Plan EL_0100_003 chappes break light
    [EL_0100_003 chappes break light.CATPart]
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2018-12-10 Correction MEP crash sensor
2018-12-10 nouvelle chape arb arrière
    [Chapes_assy.CATProduct, Insert_tie_rod_SA-8E.CATProduct, SU_1400_002(chape).CATPart, SU_1500_002 (Chape).CATPart, SU_1500_002(chape).CATPart, SU_1500_04 (Couteau).CATPart, SU_A0600.CATProduct, SU_A0800.CATProduct]
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2018-12-10 Correction MEP motoréducteur
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2018-12-10 MAJ MEP chape admission
    [Chape_fixation_chassis.CATPart, Chape_fixation_chassis.igs]
2018-12-10 MAJ MEP chape fixation vase d'expansion
    [Frame_Bracket_Expansion_Tank.CATPart, Frame_Bracket_Expansion_Tank.igs]
2018-12-10 MAJ MEP chape pompe essence
    [EN_0600_013 (chape tube remplissage).CATPart, EN_0600_013 (chape tube remplissage).igs]
2018-12-10 MAJ MEP chape regulateur de pression
    [chape regulateur de pression.igs, chape regulateur de pression2.CATPart]
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2018-12-10 MEP Frette et Planning
    [Planning_Previsionnelle_Fabrication.xlsm]
2018-12-10 Modif chapes trou de passage vis
    [chape_standard_1.igs, chape_standard_2.igs, test_chape.CATPart]
2018-12-10 Correction nomenclature Entretoises
    [Entretoise_M8_20mm.igs, Entretoise_pivot_basculeur.igs]
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2018-12-10 MAJ MEP Clutch actuation system
    [EN_1200_018 (Chape frame).CATPart, EN_1200_018 (Chape frame).igs, FR_0500_001_DA.CATPart, FR_0500_001_DA.igs, FR_0500_002_DA.CATPart, FR_0500_002_DA.igs, FR_0500_003_DA.CATPart, FR_0500_003_DA.igs]
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2018-12-10 MEP chape chainshield 2
    [chape 2 chainshield.CATPart, chape 2 chainshield.igs]
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2018-12-11 MAJ MEP VERIFIE REMRQUE MONOH
    [19M_EL_0300_004 (Chapes batterie).igs, 19M_EL_0500_004 (Chapes Master Switch).igs, 19M_EL_0700_002(chapes powerbox).igs, 19M_EL_0700_003(chape1 tdb).igs, 19M_EL_0700_004(chape2 tdb).igs, 19M_EL_0700_005(chape3 tdb).igs, 19M_EL_0700_006(chape4 tdb).igs, 19M_EL_0700_007(chape5 tdb).igs]
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2018-12-11 MAJ Support batterie + MEP Support Batterie
    [EL_A0300_002_AA.CATPart, EL_A0300_003_AA.CATPart]
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2018-12-11 MaJ guillotine
    Passage des trous 3mm -> 3,2mm
    [EN_0400_001_AA_bas_guillotine.CATPart, EN_0400_002_AB_milieu_guillotine.CATPart, EN_0400_003_AA_arret_guillotine.CATPart, EN_0400_004_AB_guillotine.CATPart, EN_0400_004_BA_guillotine.CATPart, EN_0400_005_AA_haut_guillotine.CATPart, EN_0400_007_AA_convergeant.CATPart, EN_0400_010_AA_bride.CATPart]
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2018-12-11 Plan chape boutton d'arrêt d'urgence
    [EL_0700_001 (Chappes arret d'urgence).igs, EN_0700_001 (Chappes arret d'urgence).igs, chappes switch 40mm.CATPart]
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2018-12-11 modif susp / MEP chape ARB droite
    [Chapes_assy.CATProduct, Insert_tie_rod_SA-8E.CATProduct, SU_1500_002 (Chape droite).igs, SU_1500_002 (Chape).CATPart, SU_1500_04 (Couteau).CATPart, SU_A1000 (Front Left Wheel Assy).CATProduct, SU_A1100 (Rear Left Wheel Assy).CATProduct, Suspension.CATProduct]
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2018-12-11 MEP chape crash sensor
    [19M_EL_0100_002_AA (Chappe crash sensor).igs, 19M_EL_0700_011 (Chape crash sensor).igs, Electrical.CATProduct, chappe_crash sensor.CATPart]
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2018-12-11 Validation chape pivot basculeur
    [19B_SU_0800_004 (Chape pivot basculeur arrière).igs, SU_0800_004 (Chape Pivot Basculeur arrière).CATPart]
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2018-12-11 ajout d'une marge sur poches afficheurs TdB
    [EL_0400_001_DA.CATPart, EL_A0400_BA.CATProduct, EL_A0402_BA.CATProduct]
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2018-12-12 MEP chape jacking bar
    [EN_0905_01_AA.CATPart, EN_0905_01_AA.igs]
2018-12-12 MEP chape arb rear left
    [SU_1500_008 (Chape ARB gauche).igs, SU_1500_008 (Chape gauche).CATPart]
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2018-12-12 Maj Collision firewall
    [MS_0100_003_AA.CATPart]
2018-12-12 en fait y'a qu'un p à chapes
    [Bracket_Earth_ess.CATPart, Chappes Anderson.CATPart, bracket_master_switch.CATPart, bracket_power_distribution.CATPart, chappe_crash sensor.CATPart, chappe_tdb_1_v1.CATPart, chappe_tdb_2_v1.CATPart, chappe_tdb_3_v1.CATPart]
2018-12-12 MAJ pins carte avant
    [Pin Carte Avant.xlsx]
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2018-12-12 Ajout excel masse elec
    [Masse Elec.xlsx]
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2018-12-12 nouveau TdB + cacher plans visserie
    [3x16CHC.CATPart, EL_0400_001_DA.CATPart, EL_0400_007_AA.CATPart, EL_A0400_BA.CATProduct, EL_A0402_BA.CATProduct, Liste_commande_v2.xlsx, ecrou_M3.CATPart, gaineled.CATPart]
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2018-12-12 Revert "testmerge"
    This reverts commit b9f1247deb8e9e47ceec19b14622274fe8ccb770.
    [19B_ST_0600_001 (Pivot de direction).igs, 19B_ST_0600_002 (Manchon de direction).igs, 19B_SU_0800_004 (Chape pivot basculeur arrière).igs, 19B_SU_10005 (Front Upper Arm Wedge base).igs, 19M_EL_0100_003 (Chapes break light).igs, 19M_EL_0300_004 (Chapes batterie).igs, 19M_EL_0500_004 (Chapes Master Switch).igs, 19M_EL_0700_002(chapes powerbox).igs]
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2018-12-12 excel des masse rempli avec les prévisions
    [Masse Elec.xlsx]
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2018-12-13 front arb plate mep
    [SU_1400_004 (Couteau).igs]
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2018-12-13 Résultats dureté vickers soudure
    [résultats dureté Vickers soudures.xlsx]
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2018-12-15 MEP front suspension bracket
    [bracket_front_suspension_ohlins.CATPart, bracket_front_suspension_ohlins.igs]
2018-12-15 Mise en plan carter d'huile
    [19M_EN_0101_001 (Carter d'huile).CATPart, 19M_EN_0101_001 (Carter d'huile).igs, 19M_EN_0101_002_(Plaque).CATPart, 19M_EN_0101_002_(Plaque).igs, 19M_EN_0101_003 (Joint).igs, EN_0101_007 (Plan de joint carter).igs]
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2018-12-16 Pk sa march po
    [19M_EN_0400_004 (Partie mobile guillotine).igs, 19M_FR_0300_018_BA (Entretoise interieure pedale de frein).igs, 19M_FR_0300_027_BA (Entretoise exterieure pedale de frein).igs, 19M_SU_0100_005_MA (Entretoise M6 16 mm).igs, 19M_SU_0600_002 (Entretoise M8 20mm).igs, 19M_SU_0600_003 (Entretoise pivot basculeur).igs, 19M_SU_1000_006 (Entretoise M6 25 mm).igs, 19M_SU_1200_004 (Entretoise M6 20 mm).igs]
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2018-12-16 Ajout table de calcul suspension
    [Table de calcul de raideurs de suspension.xlsx]
2018-12-16 Du sale comme MEP
    [SU_10001 (Front Left Upright).CATPart]
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2018-12-17 MEP demi lune crémaillère
    [ST_0100_003 (Half Moon).igs]
2018-12-17 chape en u pour les kékés de la motorisation qui se touchent la nouille
    [Chape_rear_olhins_test.CATPart, Chapes_assy.CATProduct, Suspension_Wireframe.CATProduct, bracket_front_rocker_arriere.CATPart, bracket_front_rocker_avant.CATPart, bracket_triangle_arriere_bas_bras_arriere_1.CATPart, bracket_triangle_arriere_bas_bras_arriere_2.CATPart, bracket_triangle_arriere_bas_bras_avant_1.CATPart]
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2018-12-17 modifs chainshield + engine
    [19M_EN_0902_005 (Chape chainshield 2).igs, EN_0500_003.CATProduct, EN_0600.CATProduct, EN_0901_003 (Excentric right).CATPart, EN_0901_004 (Excentric carrier left).CATPart, EN_0901_005 (Excentric carrier right).CATPart, EN_0901_007 (Spacer left).CATPart, EN_0901_010 (Bracket top).CATPart]
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2018-12-18 Supression de l'hardware du passage de vitesse (il est sur l'autre git)
    [shield passage vitesse.brd, shield passage vitesse.sch]
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2018-12-18 mep chape porte excentrique bas
    [EN_0901_011 (chape porte excentrique bas).igs]
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2018-12-18 modif pivot avec MEP pivot droit
    [SU_1400_003 (Pivot droit).CATPart, SU_1400_003 (Pivot droit).igs, SU_1400_007 (Pivot gauche).CATPart, SU_1400_007 (Pivot gauchet).CATPart]
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2018-12-19 MEP rear upright
    MEP porte moyeu arrière
    [SU_11001 (Rear Left Upright).CATPart, SU_11001 (Rear Left Upright).igs]
2018-12-19 MEP moyeu arrière
    MEP moyeu arrière
    [SU_11001 (Rear Left Upright).CATPart, WT_03001 (Rear Hub).CATPart, WT_03001 (Rear Hub).igs]
2018-12-20 chapes top porte excentriques
    [EN_0901_012.CATPart, EN_A0901 (Differential assembly).CATProduct, ISO 7089 WASHER 8x16 mm STEEL GRADE A PLAIN NORMAL SERIES.1.CATPart, ISO 7089 WASHER 8x16 mm STEEL GRADE A PLAIN NORMAL SERIES.CATPart, ISO_4762_M8x20_STEEL_HEXAGON_SOCKET_HEAD_CAP_SCREW.CATPart, ISO_4762_M8x20_STEEL_HEXAGON_SOCKET_HEAD_CAP_SCREW_New_52.CATPart]
2018-12-20 analysis chapes top PE
    [EN_0901_012.CATPart]
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2018-12-24 FICHIER VAGUE 2 & 3
    [19B_EN_0901_004 (Porte exc L).igs, 19B_EN_0901_005 (Porte exc R).igs, 19B_ST_0600_001 (Pivot de direction).igs, 19B_ST_0600_002 (Manchon de direction).igs, 19B_SU_0800_004 (Chape pivot basculeur arrière).igs, 19B_SU_10001 (Front Left Upright).igs, 19B_SU_10002 (Upper Arm Bracket).igs, 19B_SU_10005 (Front Upper Arm Wedge base).igs]
2018-12-24 MEP chape en U
    [SU_0700_003 (Chape Ohlins).CATPart, SU_0700_003 (Chape).igs, rear_suspension_bracket.CATPart]
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2019-01-03 modif pin carte avant
    [Pin Carte Avant.xlsx]
2019-01-05 moyeu arrière
    montage PDF
    [SU_A1100 (Rear Left Wheel Assy).CATProduct]
2019-01-06 Maj inserts + MEP
    [Insert_Frame_Side.CATPart, bouchon_tube.CATPart]
2019-01-06 Modif insert avant supérieur + MEP
    [Upper front bearing support.CATPart]
2019-01-06 Mep cylindre alu + modif insert arr sup
    [SU_0100_006.CATPart, Upper rear bearing support.CATPart]
2019-01-06 Modif insert arr inf + MEP
    [Lower rear bearing support.CATPart]
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2019-01-07 Modif cylindre + LAS Auto
    [LAS_auto.xls, SU_0100_006.CATPart]
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2019-01-08 derniers tubes réparés (oubli push)
    [11.stp, 12.stp, 401.stp, 43.stp, 44.stp, 49.stp, 51.stp, 52.stp]
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2019-01-08 modif rear arb symétrie
    [Chapes_assy.CATProduct, Front Upright Working Assy.CATProduct, Front_Rocker.CATPart, Insert_tie_rod_SA-8E.CATProduct, Lower rear bearing support.CATPart, Rear Upright Working Assy.CATProduct, Rear_Rocker.CATPart, SU_02001.CATPart]
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2019-01-08 kit de montage arb
    [Kit_montage_antiroll bar_a terminer.xlsx]
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2019-01-08 kit de montage circuit carburant
    [nomenclature_kit_de_montage_circuit_essence_1.xlsx, nomenclature_kit_de_montage_circuit_essence_2.xlsx]
2019-01-08 kit de montage freinage
    [Kit_montage_antiroll bar_a terminer.xlsx, Kit_montage_freinage_a terminer.xlsx]
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2019-01-08 Update ST_07001_STEERING UPPER SHAFT.CATPart
    [ST_07001_STEERING UPPER SHAFT.CATPart]
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2019-01-09 pm arrière BOM
    bill of materials
    [BOM.xls]
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2019-01-10 Bug réparé support batterie
    [EL_A0300.CATProduct, EL_A0300_001_AA.CATPart, EL_A0300_002_AA.CATPart, EL_A0300_003_AA.CATPart, EL_A0300_004_AA.CATPart, EL_A0300_004_AB (Chape définitive 1).CATPart, EL_A0300_004_AB.CATPart, EL_A0300_004_AB_2 (Chape définitive 2).CATPart]
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2019-01-12 Centralisation des kits de montage et ajouts
    [Kit_de_montage_roue_equipée.xlsx, Kit_de_montage_suspension.xlsx, Kit_montage_Direction.xlsx, Kit_montage_antiroll bar_a terminer.xlsx, Kit_montage_carrosserie.xlsx, Kit_montage_freinage_a terminer.xlsx, nomenclature_kit_de_montage.xlsm, nomenclature_kit_de_montage.xlsx]
2019-01-12 MAJ Excel Kits montage
    [nomenclature_kit_de_montage.xlsm, nomenclature_kit_de_montage.xlsx]
2019-01-13 Réglage problème entretoise QR
    [19M_ST_0400_002 (Entretoise QR).igs, Shift_Spacer.CATPart]
2019-01-13 Réglage problème support batterie
    [19M_EL_0300_002 (Plaque principale).igs, 19M_EL_0300_003 (Plaques laterales).igs, 19M_EN_0100_003 (Plaque Pair).igs, 19M_WT_02004 (Speed Sensor Disc Spacer).igs]
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2019-01-13 Modif assemblage colonne direction + mep
    [Cardan A.CATPart, Cardan trou 20 mm.CATPart, Spline_coupler.CATPart, Steering_Colum_Assy.CATProduct, Steering_Column.CATPart]
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2019-01-13 Ajout commande palette, composant carte avant et afficheur Tdb
    [Commandes.xlsx]
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2019-01-14 MAJ du planning de fabrication
    [Planning_Previsionnelle_Fabrication.xlsm]
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2019-01-15 Pièce pour montage roulement
    [Entretoise_montage_roulement.CATPart]
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2019-01-15 kit montage transmission secondaire
    [nomenclature_kit_de_montage.xlsm]
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2019-01-16 ajout commandes elec Reverchon
    [Commandes.xlsx]
2019-01-16 mesure pour robin + fonderie
    [EN_0101_007 (Etanchity plate).stp, Main_hoop.CATProduct, Modified Oil Pan.SLDPRT, Modified Oil Pan.STEP, Modified Oil Pan.x_t, Shape_683.CATPart, Shape_684.CATPart, Shape_685.CATPart]
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2019-01-17 Revert "MAJ"
    This reverts commit 88f79dfe5e26b7cf40a6b9f0f7a83a6d0b7693fd.
    [Planning_Previsionnelle_Fabrication.xlsm]
2019-01-17 Plein de plans et MODIF TUBULAIRE
    [15x1.5.CATProduct, 20x1.5.CATProduct, 25x1.5.CATProduct, 30x1.5.CATProduct, 30x2.CATProduct, Filaire Optimus.CATPart, Shape_436.CATPart, Shape_437.CATPart]
2019-01-17 Modif chapes de LAS
    [19M_4MM_STD_1.igs, 19M_4MM_STD_2.igs, 19M_4MM_STD_3.igs, 19M_SU_0100_009_v2.igs, Chapes_assy.CATProduct, Symmetry of bracket_triangle_avant_haut_bras_arriere_1.CATPart, Symmetry of bracket_triangle_avant_haut_bras_arriere_2.CATPart, bracket_triangle_arriere_bas_bras_arriere_1.CATPart]
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2019-01-18 Création dossier gabarit LAS
    [SU_A0200.CATProduct, SU_A1100 (Rear Left Wheel Assy).CATProduct]
2019-01-18 Demarrage gabarit chape LAS
    [Chapes_assy.CATProduct, Gabarit_chapes_I_triangle_avant_inferieur_gauche.CATProduct]
2019-01-19 Ajout des connecteurs de remplacement
    [Cablage Optimus.xlsx]
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2019-01-20 Presque la fin des commandes BSPD
    [BOM_BSPD.xlsx, Commandes.xlsx]
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2019-01-20 Gabarit chapes LAS arriere sup
    [Chapes_assy.CATProduct, Gabarit_chapes_III_triangle_avant_inferieur_gauche.CATProduct, Gabarit_chapes_I_triangle_avant_inferieur_gauche.CATProduct, Gabarit_chapes_I_triangle_avant_superieur_gauche.CATProduct, Plaque_triangle_arriere_haut.CATPart, Plaque_triangle_arriere_haut_2.CATPart, Plaque_triangle_avant_haut_2.CATPart, arret_tube_longi_triangle_arriere_haut.CATPart]
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2019-01-24 Correction RSP
    [RSP.xlsx]
2019-01-24 Modif et début gab front arb
    [8x45CHC.CATPart, Chapes_assy.CATProduct, Gabarit Fr ARB .CATProduct, Gabarits_ARB.CATProduct, Insert_tie_rod_SA-8E.CATProduct, SU_A1000 (Front Left Wheel Assy).CATProduct, SU_A1100 (Rear Left Wheel Assy).CATProduct, Suspension.CATProduct]
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2019-01-29 MEP gab olhins ar
    [plaque.CATPart]
2019-01-29 MEP adaptateur pression d'huile
    [Commandes.xlsx, EN_0100_005_AA.CATPart, EN_0100_005_AA.igs]
2019-01-29 Modif Frette frein avant
    [WT_02002 (Brake Bell) V1.5.CATPart, WT_02002 (Brake Bell).CATPart]
2019-01-30 Boite BSPD et gabarits
    [Commandes.xlsx, EL_0100_007_AA (BSPD)'.CATPart, Electrical.CATProduct, Gabarit connecteur Anderson.CATPart, Gabarit master switch.CATPart, Gabarits Power box.CATPart]
2019-01-30 MAJ RSP + Rangement + modif reservoir
    [19M_EL_A0300_004 (Chape batterie 1).igs, 19M_EL_A0300_005 (Chapes batterie 2).igs, 19M_EN_0500_001 (main1).igs, 19M_EN_0501_001(main1).igs, 19M_FR_0300_029 (Bocal frein).igs, 19M_ST_0100_002 (Chapes crémaillère).igs, RSP.xlsx]
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2019-01-30 Maj gabarits reprise meuleuse chapes
    [Chapes_assy.CATProduct, Symmetry of bracket_triangle_avant_haut_bras_arriere_2.CATPart, bracket_triangle_avant_haut_bras_arriere_2.CATPart]
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2019-01-30 fin des commandes RS ?
    [BOM_BSPD.xlsx, Commandes.xlsx]
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2019-01-31 GABARIT arb et front susp
    [Gabarit Fr ARB .CATProduct, Suspension.CATProduct, cale-bar-av.CATPart, gab-basc_av.CATProduct, plaque-bar-av.CATPart, support front hoop.CATPart, sus_plaque.CATPart, tube_sup.CATPart]
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2019-01-31 Revert "Ajustement fond plat"
    This reverts commit 2a00c366fea6c939d0e7e8203ccd5c81d24ab942.
    [FR_0400_001.CATProduct]
2019-01-31 excel essai en traction
    [Essais_traction_31_01_2019.xlsx]
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2019-01-31 Fond plat (ajustement + rangement fichier)
    [FR_0400_001.CATProduct, Plaque1.CATPart, Plaque2.CATPart, Produit2.CATProduct, bulk-front.CATPart, test.CATPart, test2.CATPart]
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2019-02-01 update maquette catia TdB
    le bandeau LED et l'afficheur 7 segments est abaissé de 1cm
    [EL_0400_001_DA.CATPart, EL_0401_003_AA.CATPart, EL_A0400_BA.CATProduct, EL_A0401_AA.CATProduct, EL_A0402_BA.CATProduct]
2019-02-01 nettoyage vieux dossier temporaire du TdB
    [Bouton poussoir Raz motored.CATPart, Bouton poussoir demarrage.CATPart, Bouton poussoir.CATPart, EL_0400_001_AA.CATPart, EL_0400_001_AA_save1.CATPart, EL_0400_001_AA_save2.CATPart, EL_0400_001_AA_save3.CATPart, EL_0400_001_AB.CATPart]
2019-02-02 Auto stash before merge of "master" and "origin/master"
    support capteurs roue equipée
    [F_Part.CATPart, Part1.CATPart, Part2.CATPart, Part4_.CATPart, Part5.CATPart, Part6.CATPart, Part7.CATPart, R_Part.CATPart]
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2019-02-04 MAJ RSP & Liste des chapes pour Robin
    [RSP.xlsm, RSP.xlsx]
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2019-02-06 MAJ pour usinage frette
    [WT_02002 (Brake Bell).CATPart]
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2019-02-07 kit roue équipée
    roue AV et AR
    [nomenclature_kit_de_montage.xlsm]
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2019-02-10 MAJ RSP - Liste des chapes (dates, responsables, quantités)
    [RSP.xlsm]
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2019-02-10 gamme de montage Roues équipées
    avant et arrère. il manque les déscriptions des étapes
    [BOM.xls, D4484.CATPart, D4484.STEP, Kit_montage.csv, SU_10004 (Speed_sensor_washer).CATPart, SU_A1000 (Front Left Wheel Assy).CATProduct, SU_A1100 (Rear Left Wheel Assy).CATProduct, WT_02002 (Brake Bell).CATPart]
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2019-02-10 Ajout config MK3 Vulcanix v2
    [Commandes.xlsx]
2019-02-11 Gabarits Jacking BAR finalisé
    [EN_0901_005 (Excentric carrier right).CATPart, EN_0905.CATProduct, EN_A0900.CATProduct, Gabarit_Chapes_JackingBarre.CATProduct, Part1_Gabarit_JB.CATPart, Part2_Gabarit_JB.CATPart, Part3_gabarit_JB.CATPart]
2019-02-11 Rangement - Separation fait Boisard
    [19B_EN_0200_001 (Exhaust tip).igs, 19B_EN_0901_004 (Porte exc L).igs, 19B_EN_0901_005 (Porte exc R).igs, 19B_ST_0600_001 (Pivot de direction).igs, 19B_ST_0600_002 (Manchon de direction).igs, 19B_SU_01006 (Cylindres triangles diam 11.8).igs, 19B_SU_0700_003 (Chape arrière Ohlins).igs, 19B_SU_0800_004 (Chape pivot basculeur arrière).igs]
2019-02-11 Rangement Boisard + Tri
    [19B_EN_0200_001 (Exhaust tip).igs, 19B_EN_0901_004 (Porte exc L).igs, 19B_EN_0901_005 (Porte exc R).igs, 19B_ST_0600_001 (Pivot de direction).igs, 19B_ST_0600_002 (Manchon de direction).igs, 19B_SU_01006 (Cylindres triangles diam 11.8).igs, 19B_SU_0700_003 (Chape arrière Ohlins).igs, 19B_SU_0800_004 (Chape pivot basculeur arrière).igs]
2019-02-11 Mise en plan gabarits
    [Plaque_triangle_arriere_haut_2.CATPart, Plaque_triangle_avant_bas.CATPart]
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2019-02-14 MAJ gabarit clutch actuation
    [assemblage gabarit.CATProduct, gabarit 2.CATPart, gabarit 3.CATPart, gabarit 4.CATPart, gabarit 5.CATPart, gabarit 6.CATPart, gabarit 7.CATPart]
2019-02-15 MAJ RSP (AlpenTech, Centrale, Boisard pièces)
    [ZZ_Référentiel_Standard_De_Production.xlsm]
2019-02-20 SES à donf fra
    [2019-FSAE-Impact-Attenuator-Document_V1.3.xlsx, 2019-FSAE-Structural-Equivalency-Spreadsheet_Steel-Tube_V1.4.xlsx, Tubulaire Optimus.CATProduct]
2019-02-21 MAJ Kit Montage Général
    [ZZ_Nomenclature_kit_de_montage.xlsm]
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2019-02-23 MAJ CAS de Charges OPT
    [Cas de charges Optimus.xlsx, MECAmaster - [Suspension_Wireframe].CATProduct, Suspension_Frame_points.CATPart, Suspension_Wireframe.CATProduct, [Suspension_Wireframe]_HYPER1 1882.CATPart, [Suspension_Wireframe]_HYPER1 2265.CATPart, [Suspension_Wireframe]_HYPER1 7880.CATPart, [Suspension_Wireframe]_HYPER1 7940.CATPart]
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2019-02-25 Rangement et MAJ RSP
    [19M_EN_0101_003 (Joint).CATPart, 19M_EN_0101_003 (Joint).dxf, 19M_EN_0101_003 (Joint).igs, Calibre_bride.CATPart, ZZ_Référentiel_Standard_De_Production.xlsm]
2019-02-25 Entretoises pour essai traction temoin collage triangles
    [Assemblage_test.CATProduct, entretoise_M6_30mm_distance.CATPart, entretoise_alesage_M6_M8.CATPart, entretroise_rotule_presse_M6.CATPart, support.CATPart]
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2019-02-27 Ajout Aero Italiens 3A dans Frame
    [3elem.CATPart, Aile_anterieure.CATProduct, Ala_completa6.CATProduct, Alette.CATPart, Ali3d(inc_16.711_long_700).CATPart, Diffusore1.CATPart, Diffusore2.CATPart, Elemento_principale.CATPart]
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2019-03-02 nomenclature de montage
    roues equipees
    [BOM.xls, BR_0200_001 (Break Disc).CATPart, D4483.CATPart, Etrier_beringer_arr_Olympix.CATPart, Front Upright Working Assy.CATProduct, PISTE-193-ar.CATPart, Rear Upright Working Assy.CATProduct, S71910_ACD_P4A.CATProduct]
2019-03-02 début gab couteaux ar
    [Chapes_assy.CATProduct, Gabarit Rear Couteaux.CATProduct, Insert_tie_rod_SA-8E.CATProduct, SU_1400_003 (Pivot droit).CATPart, SU_1500_001 (Barre).CATPart, SU_1500_04 (Couteau).CATPart, SU_A1000 (Front Left Wheel Assy).CATProduct, SU_A1100 (Rear Left Wheel Assy).CATProduct]
2019-03-03 Update frame taille tube suite crise :'(
    [15x1.5.CATProduct, 20x1.5.CATProduct, Shape_448.CATPart, Shape_456.CATPart, Shape_457.CATPart, Shape_465.CATPart, Shape_467.CATPart, Shape_468.CATPart]
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2019-03-08 modif signaux connecteurs pare-feu
    [Cablage Optimus.xlsx]
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2019-03-08 Modif Adaptateur pression d'huile
    [EN_0100_005_AA.CATPart]
2019-03-09 MAJ mise en forme & infos Aquacut
    [ZZ_Référentiel_Standard_De_Production.xlsm]
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2019-03-11 ajout méplat + capteur débattement
    [Montage Capteur V2.CATProduct, SU_1500_006 (Tube Alu).CATPart, support.CATPart]
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2019-03-18 Ajout excel essai collage alu alu
    [Specimen_RawData_1.csv, collage alu alu.is_tens_Results.csv]
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2019-03-21 Update ZZ_Nomenclature_kit_de_montage.xlsm
    masse kit transmission secondaire
    [ZZ_Nomenclature_kit_de_montage.xlsm]
2019-03-21 essais triangles + temoins alu carbone
    [FL inf fr.is_tcyclic_Results.csv, FL inf rr.is_tcyclic_Results.csv, FL sup fr.is_tcyclic_Results.csv, FL sup rr.is_tcyclic_Results.csv, FR inf fr.is_tcyclic_Results.csv, FR inf rr.is_tcyclic_Results.csv, FR sup fr.is_tcyclic_Results.csv, FR sup rr.is_tcyclic_Results.csv]
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2019-03-21 Fichiers gerber TdB v2
    [test2-B.Cu.gbr, test2-B.Mask.gbr, test2-B.Paste.gbr, test2-B.SilkS.gbr, test2-Edge.Cuts.gbr, test2-F.Cu.gbr, test2-F.Mask.gbr, test2-F.Paste.gbr]
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2019-04-01 Fichiers impression Protection cable embrayage
    [FR_0500_006_DB.stl, FR_0500_006_DB_trou agrandi.CATPart, UM2_FR_0500_006_DB.3mf]
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2019-04-13 Testing ajouts + conseils
    [Check_liste_avant_essai.xlsx, Check_liste_départ_essai.xlsx, Check_liste_voiture.xlsx]
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2019-04-25 tdb modele catia update
    [EL_0400_001_EA.CATPart, EL_0400_001_EB.CATPart, EL_A0400_BA.CATProduct, EL_A0402_BA.CATProduct]
2019-04-29 Changement Tube plié PE
    [Shape_640.CATPart]
2019-04-29 Changement Tube plié PE v2
    [Shape_640.CATPart]
2019-04-30 modif crise chassis chape basculeur
    [chape_rear_susp.CATPart]
2019-04-30 problème de collisions crise chassis
    [Chape_rear_olhins.CATPart, Chapes_assy.CATProduct, Insert_tie_rod_SA-8E.CATProduct, SU_A0600.CATProduct, SU_A0800.CATProduct, SU_A1000 (Front Left Wheel Assy).CATProduct, SU_A1100 (Rear Left Wheel Assy).CATProduct, Suspension.CATProduct]
2019-04-30 plus de collisions crise chassis
    [Chape_rear_olhins.CATPart, Chapes_assy.CATProduct, Front Upright Working Assy.CATProduct, Front_Lower_A_Arm_Front_Rod.CATPart, Front_Lower_A_Arm_Rear_Rod.CATPart, Front_Push_Rod.CATPart, Front_Rocker.CATPart, Front_Upper_A_Arm_Front_Rod.CATPart]
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2019-05-01 Mise en page templates
    [BRA0100_to_BRA0200.xlsx, BRA0300_to_BRA0400.xlsx, ENA0100_ENA0800.xlsx, ENA0200_to_ENA0400.xlsx, ENA0500.xlsx, ENA0600.xlsx, ENA0700.xlsx, Suivi_avancement.xlsx]
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2019-05-01 BOM pédalier + petit coucou de guyane
    [FRA0400.xlsx]
2019-05-02 Crise chassis tous les tubes
    [15x1.5.CATProduct, 20x1.5.CATProduct, Filaire Optimus.CATPart, Shape_573.CATPart, Shape_573.stp, Shape_574.CATPart, Shape_574.stp, Shape_600.CATPart]
2019-05-04 BOM v1 MS, à faire verif par MPL
    [MSA0100_to_MSA0400.xlsx]
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2019-05-05 Cost mise en place fasteners,...
    [SUA0100_to_SUA0400.xlsx, Suivi_avancement.xlsx, fasteners_processes_materials.xlsx, fsg_choices_fasteners_processes_materials.xlsx]
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2019-05-05 WT assy BOM for cost report
    not completed, asked PA for info
    [WTA0100_to_WTA0300.xlsx]
2019-05-05 Un peu de tout
    [Commandes.xlsx, Masse Elec.xlsx, calibs.xlsx, shifter.brd, shifter.sch]
2019-05-05 pôle elec à 9kg qui dit mieux ?
    [Masse Elec.xlsx]
2019-05-06 Renforts chassis fichiers simu DESIGN
    [filaire poutre.CATPart, renforts bottom.CATPart]
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2019-05-06 WT BOM cost design report
    pics and meps finalization, BOM update for speed sensor position parts
    [WTA0100_to_WTA0300.xlsx]
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2019-05-07 Fin maillage chassis design <3
    [filaire poutre.CATPart]
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2019-05-07 WT BOM data
    frette de frein, roulements data
    [WTA0100_to_WTA0300.xlsx]
2019-05-07 WT BOM cost design
    ecrous, goujons, ecrous de serrage, tripod, ecrou tripod, rondelles encoche
    [D4483.CATPart, WTA0100_to_WTA0300.xlsx]
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2019-05-08 COst clutch actuation system
    [FRA0600.xlsx]
2019-05-08 Modif Cost MS+ Finalisation Pare Feu
    [MSA0100_to_MSA0400.xlsx, MS_0100_006 (Partie Floor Middle).CATPart, MS_0100_007 (Partie Floor Middle).CATPart]
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2019-05-09 Ajout image assemblage + conversion
    [STA0100,STA0400_to_STA0500.xlsx]
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2019-05-11 Cost MS, ergo mal rangé/pas fini ptin
    [Head_Restraint_Plaque.CATPart, MSA0100_to_MSA0400.xlsx, MS_0100_007 (Partie Floor Side).CATPart]
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2019-05-11 cost body et fond plat
    [FRA0500_FRA0700.xlsx]
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2019-05-11 EL BOM cost report
    [ELA0100_to_ELA0700.xlsx]
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2019-05-12 Modif oublié de push cost
    [STA0100_to_STA0400.xlsx, SUA1400_SUA1500.xlsx, fasteners_processes_materials.xlsx]
2019-05-12 EL BOM cost report update
    [ELA0100_to_ELA0700.xlsx, Suivi_avancement.xlsx]
2019-05-12 Ajout photo brackets steering + cache-crémaillère
    [STA0100_to_STA0400.xlsx]
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2019-05-13 WT BOM excel update
    [WTA0100_to_WTA0300.xlsx]
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2019-05-14 cost BOM frame chapes
    [FRA0100_to_FRA0300.xlsx, FR_0200_Drawing_axe levier pour embrayage.CATPart, FR_0200_Drawing_chape tenue du cable.CATPart]
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2019-05-15 CR EL : excel et premieres images
    [ELA0100_to_ELA0700.xlsx]
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2019-05-15 EL BOM rename pictures
    [ELA0100_to_ELA0700.xlsx]
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2019-05-15 Correction BOM WT
    [ENA0700.xlsx, WTA0100_to_WTA0300.xlsx]
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2019-05-15 Correction SU PAT
    [SUA0500_to_SUA0800.xlsx, SUA1400_SUA1500.xlsx, Suivi_avancement.xlsx]
2019-05-15 Correction MS
    [MSA0100_to_MSA0400.xlsx, Suivi_avancement.xlsx]
2019-05-15 Correction BR erwan
    [BRA0100_to_BRA0200.xlsx, Suivi_avancement.xlsx]
2019-05-15 Correction engine motor + overflow bottles
    [ENA0100_ENA0800.xlsx, Suivi_avancement.xlsx]
2019-05-15 Correction EN CEE
    [ENA0200_to_ENA0400.xlsx]
2019-05-15 Voila mon ami Reedom
    [BRA0300_to_BRA0400.xlsx]
2019-05-15 Update EL BOM plus d'image
    [ELA0100_to_ELA0700.xlsx]
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2019-05-17 Corrections cost
    [ENA0700.xlsx, ENA0900.xlsx, Suivi_avancement.xlsx]
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2019-05-18 BOM SU_1000 et SU_11000
    pas des spacer car --> triangles
    [SUA1000_SUA1100.xlsx]
2019-05-18 BOM SU_1000 et SU_11000
    il manque le nombre de cales de carrossage
    [SUA1000_SUA1100.xlsx]
2019-05-18 Update BOM EL, ajout images
    [ELA0100_to_ELA0700.xlsx]
2019-05-19 BOM SU and bearing preload
    to find out
    [SUA1000_SUA1100.xlsx]
2019-05-19 BOM EL dernières img, verif nom+taille img
    [ELA0100_to_ELA0700.xlsx]
2019-05-19 update BOM brake system
    [BRA0100_to_BRA0200.xlsx]
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2019-05-20 Simulations design résolution bordel
    [Test chassis surfacique.CATPart, filaire poutre.CATPart]
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2019-05-21 Correction BR 1 / 2
    [BRA0100_to_BRA0200.xlsx, Suivi_avancement.xlsx]
2019-05-21 Correction EN + oublie soufflets steering
    [ENA0100_ENA0800.xlsx, ENA0200_to_ENA0400.xlsx, ENA0700.xlsx, STA0100_to_STA0400.xlsx, Suivi_avancement.xlsx]
2019-05-21 Correction EN
    [ENA0500.xlsx, ENA0900.xlsx, Suivi_avancement.xlsx]
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2019-05-21 Correction EN cooling
    [ENA0600.xlsx, SUA1000_SUA1100.xlsx, Suivi_avancement.xlsx]
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2019-05-21 Correction SU
    [SUA1000_SUA1100.xlsx, Suivi_avancement.xlsx]
2019-05-21 Correction Frame cost
    [FRA0400.xlsx, FRA0500_FRA0700.xlsx, FRA0600.xlsx, Suivi_avancement.xlsx]
2019-05-22 un max de truc
    [Commandes.xlsx, ELA0100_to_ELA0700.xlsx, Panier EPSA.csv, calibs.xlsx]
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2019-05-22 Correction EN intake system
    [ENA0200_to_ENA0400.xlsx]
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2019-05-23 Cost mise en forme DBOM
    [Exemple_DBOM.xlsx, Exemple_remplissage.xlsx, fasteners_processes_materials.xlsx, fsg_choices_fasteners_processes_materials.xlsx]
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2019-05-23 Le cost c'est fun
    [ELA0100_to_ELA0700.xlsx, ENA0100_ENA0800.xlsx, ENA0200_to_ENA0400.xlsx, ENA0500.xlsx, ENA0600.xlsx, ENA0700.xlsx, ENA0900.xlsx, FRA0100_to_FRA0300.xlsx]
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2019-05-24 BOM WT SU assembly
    images des assemblages
    [D4483.CATPart, SU_A1000 (Front Left Wheel Assy).CATProduct, SU_A1100 (Rear Left Wheel Assy).CATProduct, WTA0100_to_WTA0300.xlsx, WT_02004 (Speed Sensor Disc Spacer).CATPart, WT_02006 (Speed Sensor Disc Spacer 3mm).CATPart]
2019-05-24 BOM WT brake discs
    [WTA0100_to_WTA0300.xlsx]
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2019-05-26 Premiers prix pour CNC mill
    [Cost.xlsx]
2019-05-26 Une Ref erronée sur BOM MS
    [MSA0100_to_MSA0400.xlsx]
2019-05-27 Ca va être long
    [Fastener_cost.xlsx, fasteners_processes_materials.xlsx]
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2019-05-31 Maj excel fasteners, processes, ...
    [Fastener_cost.xlsx, fasteners_processes_materials.xlsx]
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2019-06-04 DESO MAJ DBOM ENGINE
    [ENA0100_ENA0800.xlsx]
2019-06-04 COst correction
    [Suivi_avancement.xlsx, WTA0100_to_WTA0300.xlsx]
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2019-06-09 cost moteur + carte avant
    [ENA0200_to_ENA0400.xlsx, EN_0200_200_AA_Muffler_clamp.CATPart, Exhaust_flange.CATPart]
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2019-06-11 MAJ BOM EN 2
    [ENA0100_ENA0800.xlsx]
2019-06-11 Modif MEP et ajout CNC lathe
    [Cost.xlsx]
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2019-06-12 MAJ BOM EN 3
    [ENA0100_ENA0800.xlsx]
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2019-06-16 Corrections DBOM
    [ENA0700.xlsx, Fastener_cost.xlsx, Materials_cost.xlsx, Suivi_avancement.xlsx, fasteners_processes_materials.xlsx]
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2019-06-16 Correction DBOM
    [ENA0200_to_ENA0400.xlsx, ENA0600.xlsx, Fastener_cost.xlsx, fasteners_processes_materials.xlsx]
2019-06-16 correction cooling
    [ENA0600.xlsx]
2019-06-16 correction ftank
    [ENA0500.xlsx, ENA0900.xlsx]
2019-06-17 Mise en place cout assemblages
    [Materials_cost.xlsx, Processes_cost.xlsx, fasteners_processes_materials.xlsx]
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2019-06-17 correction cost br
    [BRA0100_to_BRA0200.xlsx]
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2019-06-26 Maj code carte avant
    [Calibration_rotation_volant.xlsx]
2019-06-27 Mise en forme cost
    [Cost_v1.5.xlsx]
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2019-07-03 Challah les simulations qui vont marcher bientot
    [Filaire simulations ENFIN.CATPart, Part1.CATPart]
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2019-07-14 Préparation oral FS ATA
    [previsionnel_reel_tops.xlsx]
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2019-07-22 Create margin vs volume.xlsx
    [margin vs volume.xlsx]
2019-07-22 Create Plenum partie haute v4.CATPart
    [Plenum partie haute v4.CATPart]
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2019-08-03 Remise en forme dossier cost
    [Changelogs.xlsx, Commandes - Optimus 2019.xlsx, Manufacturing_Gantt.xlsm, Manufacturing_framework.xlsm, Oil pan.CATPart, Plenum partie haute v4.CATPart, Suivi_avancement.xlsx, données rapport financier.xlsx]
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
